fe1iscurc0r/PSDR/docs/README.md

# 文档索引

先读根目录的 `README.fork.md`（这个 fork 是什么、加了什么、不声称什么），再按需要往下查。
标 **fork-only** 的文档只在我们这棵树里，作者没有向上游提议过。

| 文件 | 是什么 | 建议读者 |
|---|---|---|
| `WO-psdr-takeover.md` | **施工总账**：A–K 章，逐条记录做了什么、命令与输出、结论与未完成项（3.5k 行且在长；**按章/§号查，别按行号引用**——追加记录会让行号漂移） | 想知道"这件事到底怎么验的" |
| `PSDR-firmware-survey.md` | **固件只读审阅**（fork-only）：两棵树的项目代码只占约 1 万行，按模块给中文注释、缺陷清单（**现基线 `PSDR_F7` 上 P0 只剩一处**，另一处属 `PSDR_Rebuild` 血统；新增"现基线复测"表给出 P0/P1/P2 的新行号与两条更正）、架构判断与改进路线 | 要改固件的人，先读这个 |
| `PSDR-author-measurement-log.md` | **作者自述的装配与实测记录**（fork-only）：commit sha/日期/血统/原话逐条编目——2016 实测 2.5–175 MHz、-90 dBm@7MHz、-80~-85 dBm@146.4MHz、"2m 很弱可能要前放"、2.5 原型已装配、原理图 notes 区这条没挖的线索、以及库里那棵 **2019 CubeMX+FreeRTOS 重建**（`TestingMakeFile*/`，带 F746 的 Makefile） | 想知道"这板子到底跑到过什么程度"的人 |
| `PSDR-HMC1023-netlist.md` | **U287（HMC1023LP5E 可编程低通）引脚—网络—SPI 表**（fork-only）：SPI 四线接 PB12–15、校准时钟来自 Si5338、`VDDBG` 无供电是硬件缺口 | 做 #16（前放/低通）的人 |
| `PSDR-HMC1023-pinmap-check.md` | **U287 的 32 脚逐脚对手册**（v01.0113 Table 6 × 网表）：N/C 脚全部接地符合手册注；`CALCK` 已由 Si5338 CLK1A 经 `C283` 接入；**pin 28 `VDDBG` 只挂去耦、无供电**；pin 29 `VBG` 悬空符合"testing only"；**Q 通道输出经两只电容自环回输入**（双通道只用一半） | 要补 HMC1023 驱动或改供电的人 |
| `PSDR-hmc1023-driver-plan.md` | **F-5 在无板条件下的做法**：校准序列构建器 + 主机测试已过（26/60 MHz 两条路径）；发现 `Reg 05h` 15 位装不下 20–40 MHz 周期、必须写倍频后周期；还差 SPI 帧位序（须看 Figure 38）、Table 11 粗调码、板上验证；给了 A/B/C 三条路 | 想推进 HMC1023 驱动的人 |
| `PSDR-hmc1023-driver-feasibility.md` | **HMC1023 驱动"能不能补"的判定**：SPI 已通、供电除 `VDDBG` 外齐、`CALCK` 已由 Si5338 CLK1A 接进；三个缺口（VDDBG 无供电 / CLK1 不由固件配 / 固件零引用）+ rev-B 代价 + 不改固件的台架实验路径 | 想复活低通滤波的人 |
| `PSDR-assembly-sourcing.md` | **贴装与选材**：391 件按封装分 290 手贴 / 25 热风 / 18 必须机贴 / 58 机械件；`U304` 与 `U16/U24/U30` 买不到 ⇒ 全贴完不可能，最小可验板只能验电源与 MCU | 要下单/备料的人 |
| `PSDR-vna-path.md` | **VNA 通路拓扑**（只读，fork-only）：`U314` 的 INPA/INPB 经 `C322`/`C309` 分别接 `RF_REF`/`RF_ANT`，桥路由 `U24` 切、`REF`/`DUT` 是 1 mm 焊盘，`VMAG`/`VPHS` 进 MCU；**硬件完整、`vna_reflected/vna_through` 两个 case 是空的** | 想搞 VNA 或 #20 的人 |
| `PSDR-signalpath-pinmap.md` | **`signalPath()` 引脚状态表**（只读）：12 根控制线的"固件符号→GPIO→MCU 脚→网名→板上落点"全链，7 个枚举态的实际电平；三条观察（态 1 落进发射分支、态 3 加电仍旁路、态 4/5/6 不写任何脚） | 要动射频路径或做 rev-B 的人 |
| `PSDR-scope-and-cost.md` | **最初需求、成本结构与降本边界**（fork-only）：README 原文需求、BOM 构成（$276.78）、**VNA 判为保留项**、保留版地板 ≈$225–235、GPS 三条降本路线、LC 带通组"先验证再谈上游"与免改版的验证路径、CMOS/继电器按节点的结论、"为什么是短波而不是 UV" | 决定改版范围/预算的人 |
| `PSDR-alternates-proposal.md` | **替代件与局部改版提案**（fork-only）：U304 实测封装/偏置拓扑、国产无源件候选表（36 行/184 件）、两颗停产 IC 的三条路线（**路线 C 已按 Ron 更正**：通用 CMOS 不能顶替天线侧 GaAs）、局部改版范围 | 打算换料/改板的人 |
| `PSDR-open-data-gaps.md` | **资料缺口 + PCB 改版/移植问题**（fork-only）：要查的数据手册、2.6→2.6.1 的**三处**电阻改动**加 2.6.1 表内自相矛盾**（§2.1，"只差 R164"那句已作废）、断供器件封装不可替换 | 打算改板或换料的人 |
| `PSDR-chronicle.md` | **编年史**（fork-only）：**第〇纪**我们从 2026-08-19 起的手（不是 10-30 的工单）、上游 2014→2025 原史 + **2014–2017 十条帖子逐条捞出的原话**（众筹支持者、热成像指到 `U241`=Si5338、"deaf as a brick −70 dBm / 差 50 dB" 的真实出处）、接手七天按天编年、对外件全表带评论 id 与字节数、**我们自己撤过的 11 条断言**（旧说法→推翻证据→现口径）、#16 点名的外部项目与 UHSDR 调研现状 | 想知道"这件事从头是怎么走过来的" |
| `PSDR-switch-maps.md` | **开关映射分析（F-3/F-4 前置）**：三片 DPDT 的 RF 脚→远端（网表读得）、DPDT 真值表（镜像级）、滤波 mux 的 B1–B4 通道图与"编码顺序待实测"；列出 4 条 10 分钟级测量（M1–M4）与"为什么没把猜值写进固件" | 要动射频路径/继电器的人 |
| `PSDR-firmware-fixes-F1-F2.md` | **F-1/F-2 的实际改动**（fork-only，不上游）：Si5338 就绪等待改 2 s 有界；`signalPath()` 表化并修状态 1 的 fall-through；主机测试 7×12 全过、目标构建 0 error（text 113,916，较改前小 152 B）；含 blob 对照与回滚命令 | 要审这两处改动的固件人 |
| `PSDR-revB-edit-sheet.md` | **改板作业单（可直接照做）**：只改 `_pcb_spike_full`；A 段 `VDDBG` 把 `$$$15137` 并入 `LPF_5V` 并在 (34.29,-10.541)→(37.084,-13.843) 拉 0.2032 mm 线（含绕行/换层两种走法）；B 段 4 处 <0.127 mm 线距的 5 条线段逐条给出端点与改法；附改后四步验收 | 自己动手改板的人 |
| `PSDR-revB-local-plan.md` | **局部改动规划（rev-B lite）**：把"缺料以外"的缺陷逐条变成可执行的硬件/固件改动——H-1 `VDDBG` 拉铜（`C292`→`C291`，4.3 mm）、H-2 52 条线距按簇改到 ≥0.2 mm、H-3 板厚/工艺、H-4 丝印让位、H-5 `U30.6` 引出；F-1 I2C 超时、F-2 `signalPath` 表化+case1 break、F-3 滤波档位、F-4 VNA 两态、F-5 HMC1023 驱动（先与 Michael 协调）、F-6 CLK1/VCO；含验收总表与**"不算解决"清单**（换 L/C 值不计） | 真正要动手改板/改码的人 |
| `PSDR-revB-workorder.md` | **rev-B 局部改版工作单**（fork-only）：三道门（器件身份 / 数值口径 / 免改版子板 A/B）不过就不许开刀；影响圈实测（三区并集 124 件、**圈外 267 件必须逐件不变**、只有 U304 区是真局部，DPDT 与 HMC1023 二跳铺满全板）；波段↔控制线表（8 根线实测 + 固件从不切外接档）；改版后要重出的三件套与旧 `SHA256SUMS` 作废；`pending` 一律标注等哪个门、**不许填典型值** | 真要去改板的那天 |
| `PSDR-upstream-threads.md` | **上游 21 条 issue/PR 的原文存档**（引用底稿，不是我们的判断）：2026-11-04 用 REST 全量抓回的正文与 61 条评论，按 issue 照录（只压空白），编年史里每句英文原话都能在这份回查 | 要核对"某人到底说过什么" |
| `PSDR-si5338-lo-plan.md` | **正交 LO 与 Fvco÷8 约束的核算**（fork-only）：三路输出各自的落点（CLK0→触发器÷2、CLK1→HMC1023 CALCK、CLK2→MCU 测频）；固件 VCO=2.84 GHz ⇒ Fvco/8=355 MHz > CLK0 上限 350 ⇒ **"最多两路高于 Fvco/8"的限制从未触发**；附两个新发现（VCO 超 Rev1.6 上限、CLK1/2 不由固件设定） | 改时钟方案或做 rev-B 的人 |
| `PSDR-fab-spec.md` | **工艺与打样口径**（fork-only）：板框 99.9998×64.9986 mm、4 层铜、最小钻 0.356 mm；**板厚/基材/表面处理原始资料里没有**（fabnotes 是纯图形）；打样前要过的三条规则（52 条 clearance 最小 0.1174 mm、38 条孔间距、39 条板边器件）+ 沉金建议与"先拿原始 Gerber 做 DFM 预检"的路径 | 想下单打样的人 |
| `PSDR-documentation-archive.md` | **`Documentation/` 那 6 份作者材料的档案**（fork-only）：2014 半成品 VNA 说明页（作者自己的 TODO、"30mV/db 10mV/Degree" 说法，且**位号属 PSDR2 一代**：`U23`=AD8302、`U24-27`=DPDT）、2016 装配说明（图纸框还留着 `<INSERT COMPANY NAME HERE>`）、两份视频文稿（"open source""kits""我没把它设计成应急设备"原话）、2014 滤波系数表（512 点 == 固件 `FFT_BUFFER_SIZE 512`，表里是浮点系数而代码只填 1/0） | 想知道"作者留下过什么、我们此前漏了什么" |
| `PSDR-external-findings-2026-11-03.md` | **外部执行方回传资料核实**（fork-only）：6 份答案的验收过程（49/55 行对账、错位实锤、4 个 sha256 复算一致）、8 条被推翻/修正的说法（SXB 是 5–2500 MHz、U279/280 是 D 触发器不是 ÷2、实购 CB3Q 非 CBTLV、ST 勘误 §2.2.1 ADC 触发丢失…）、HMC1023/AD8302/Si5338/总线开关的手册级补口、"信息不足"大头其实是我们包缺 `Value`、以及按谁能推动分四组的待办队列 | 要用这批外部结论之前，先读它的证据分级 |
| `SOP-eda-import-2.6.1.md` | **EDA 导入 SOP**：7 步，含"直接导入只得 10/12，不是回归"与两处必须人工的步骤 | 下次往嘉立创EDA导板的人 |
| `SOP-kicad-to-eprj3.md` | **KiCad→eprj3 原生转换 SOP**（fork-only）：转换器两个 bug（圆弧板框、铺铜丢网络）的离线修法、文件夹工程与 `.epcb2` 两条导入路径、加载判活监视器与现场读数、交付件哈希与排障速查；上游 bug 已报 `easyeda/kicad-to-easyeda-eprj3#2` | 走免费打样原生通道、卡在转换/加载的人 |
| `PSDR-defect-register.md` | **缺陷登记册**（fork-only）：除缺料外的 22 条已知问题，按 P0/功能/电气/制造/流程分组，每条给证据、卡在谁、现在能做什么；含 `VDDBG` 飞线与"一量判死"的四点 | 想知道"还差什么才能开机/打样" |
| `PSDR-bringup-checklist.md` | **上电前检查表**（M3）：42 个测点带坐标与网络、射频只写观测方法、无实物逐条 SKIP | 板子到手那天 |
| `psdr-build-notes.md` | 构建笔记（F4 线的工具链与坑） | 要复现编译的人 |
| `PSDR-TAKEOVER-WORKORDER-2026-10-30.md`<br>`PSDR-TAKEOVER-PROMPT-2026-10-30.md`<br>`PSDR-TAKEOVER-EVALUATION-2026-10-30.md` | **上游给的工单/提示词与当时的评估**（历史输入，不是我们的产出；评估里个别结论已被后续实测更正，正文有标注） | 想知道起点是什么 |
| `psdr-handoff/` | 交接材料里的脚本（`anchor_check.py`、`Makefile.linux`、`PATCH-NOTES.md`），F4 锚点自证用 | 核对 F4 构建 |
| `../evidence/` | **不可重跑的现场读数**（EDA 12/12 与 DRC 513 的构成等）与其 README | 想核对"当时到底读到什么" |

## 相关但不在 `docs/`

- `dist/kicad/SHA256SUMS` + `tools/reproduce_kicad.py`：一条命令重建参考板、DRC 与制造包并自检。
- **`dist/kicad/` 里哪块板才算参考板**（2026-11-04 标注，别拿错文件）：
  **参考板 = `PSDR_2.6.1_pcb_spike_full.kicad_pcb`**（1.8 MB，2026-11-01，铺铜/板框/丝印齐全，
  名字里的 `spike` 是早期"探针"阶段的遗留）；**DRC 权威报告 = `drc_PSDR_2.6.1_pcb_spike_full.txt`**
  （**795 条**，已在总账 §C-16 逐类定性：没有一条是转换几何错误）。
  同目录的 `PSDR_2.6.1.kicad_pcb`（721 KB，10-31）、`PSDR_2.6.1_spike_TX-Q_DRIVER_P.kicad_pcb`
  与 **`PSDR_2.6.1-drc.json`（10-30，364 条，其 `source` 字段自己写着 `PSDR_2.6.1.kicad_pcb`）**
  都是被取代的早期产物，**不要引用它们的数字**；要引用 DRC 一律引那份 `.txt` 与 §C-16。
- `dist/reference/`：**F7 构建的锚点参考 hex**（两份基线各一，带 sha256/blob/出处）与复算命令；
  放这里是因为 `Source_F7/.gitignore` 的 `/Debug` 会把它们挡在版本控制外（2026-11-03 改基时差点丢）。
- `Hardware/BOMs/PSDR_2.6.1/PSDR2.6_BOM_flat.csv` / `PSDR2.6.1_BOM_flat.csv` /
  `BOM_refdes_crosscheck.csv`：**派生件，不是源**。`.xls` 仍然是 BOM 的权威版本；两份扁平 CSV
  由 office-excel 展平（文件头写源 BIFF 版本哈希），交叉表由
  `python tools/bom_refdes_crosscheck.py` 重算。注意展平用的是**带 PR #18 修正后**的 .xls，
  要看上游未修版得从 `45acd0f5` 取。
- `dist/fab/PSDR_2.6.1_placement.csv`：SMT 贴装表（391 件），与 BOM 和 KiCad 锚点双向对账过。
- `tools/`：解析器、KiCad 生成器、Gerber 对拍、层覆盖率、固件统计（`fw_stats.py` / `fw_funcindex.py`）。
- `delegation/` + `tools/make_delegation_pack.py`：**派给外部执行方的自包含输入包**
  （36 只 IC 的引脚/网络上下文、23 个封装的原始 `*PARTDECAL*` 块、件数普查、带 DigiKey 号的 BOM 行），
  含答案 schema 与"无出处不作答"的硬规则；重跑一条命令，位号错配由 `EXPECT` 守卫挡住。
  `delegation/answers/` 是**对方交回的原件收档**（6 份，只加了 PROVENANCE 头，正文一字未改）：
  属外部断言，未逐条复核的数字不得直接进对外文本；`MANIFEST.csv` 只覆盖输入包。
  同目录还有下一轮的**可粘贴提示词**：`PROMPT-recheck-taskC.md`（TASK_C 剩余 32 行，带附件哈希与
  "CONTESTED 两值都算"的硬规则）、`PROMPT-uhsdr-frontend.md`（UHSDR/OVI40 前端，
  只收 文件+commit+行号 级出处，并禁止替 PSDR 下结论）、`PROMPT-full-history.md`（只查站外的全史普查）、
  `PROMPT-chronicle-site.md`（**把编年史做成静态网页**：附件清单带 sha256、内容硬规则、
  "诚实清单"必须存在、禁放替代件/降本内容、交付要附自检脚本并按事实级报告）。
