fe1iscurc0r/PSDR/docs/PSDR-fab-spec.md

# 这块板到底是什么工艺、能不能拿去打样（2026-11-04）

问题来自"10×10 cm 以内可以免费打板"这件事。先给能读到的，再给**读不到但打样必须自己定**的，
最后给"免费档能不能过"的判断。所有数字都标口径。

## 1. 读得到的（源：CAM 包 + 我们的复现对账）

| 项 | 值 | 出处 |
|---|---|---|
| 板框 | **99.9998 × 64.9986 mm**（≈100 × 65 mm；右侧 y≈16–26 mm 处有内凹缺口，退到 x=88.3 mm） | `kicad_gerber_compare` 输出，总账 §C-13/§C-14 |
| 铜层 | **4 层**：`GTL`(L1) / `L2.p.G1`(L2) / `L3.G2`(L3) / `GBL`(L4) | `Hardware/Gerbers/PSDR261 Main Board/` 15 文件包 |
| 其它层 | 2 阻焊（GTS/GBS）+ 2 丝印（GTO/GBO）+ 2 锡膏（GTP/GBP）+ 1 钻孔 + fabnotes | 同上 |
| 钻孔 | 10 把钻头，**最小 0.014" = 0.356 mm**（过孔），最大 0.126" = 3.2 mm（安装孔） | `0 - drillfile.TXT`（MOIN）逐档读出 |
| 过孔尺寸 | 0.8128 / 0.3556 mm（盘/孔） | 总账 §C-13 的 `*ROUTE*` 抽样 |
| 焊盘 | 1,194 个（Top 595 / Bottom 599）、461 孔 | 总账 §C-13 |
| 源设计规则 | 通用 **8 mil**、铺铜 12 mil、铜到板框 20 mil；EDA 工程侧另记 6/4/10 mil | `docs/PSDR-open-data-gaps.md` §2.3、§C-22 |

⇒ **尺寸落在 10×10 cm 以内，层数是 4 层** —— 这两条满足"常见 4 层免费/低价档"的门槛条件。

## 2. 叠层：`PSDR.asc` 里有！（2026-11-04 补）

`Hardware/PSDR.asc` 的 `LAYER DATA` 段带完整叠层参数，逐层读出来是：

| 层 | 名称 | 介质厚度 | 铜厚 | 介电常数 |
|---|---|---|---|---|
| L1 | Top | 0.2540 mm（10 mil） | 0.0343 mm（≈1 oz） | **4.3** |
| L2 | Power | 0.2540 mm | 0.0343 mm | 4.3 |
| L3 | Ground | 0.2540 mm | 0.0343 mm | 4.3 |
| L4 | Bottom | — | 0.0343 mm | —（面层，掩膜 εr 记 3.3） |

* **基材：FR4（εr≈4.3）**——这是**读得**，不是猜；
* 铜厚：每层 0.0343 mm ⇒ **1 oz**；
* 介质：三张 **10 mil（0.254 mm）**；
* **成品板厚算得 = 3×0.254 + 4×0.0343 = 0.899 mm（≈0.9 mm）**，不含阻焊。
  ⚠️ 这个 0.9 mm 是**按源叠层算的**，而 PADS 的叠层参数不一定等于厂里的最终压合（外层的 prepreg 与阻焊另算），
  所以下单体重要么按 0.9 mm 写、要么问作者当时下的什么——**别再写"1.6 mm"**，那是常见值不是这块板的。

## 3. 表面处理：仍然读不到（OSP vs 沉金）

`fabnotes.GBR` 是纯图形，`.asc` 无 finish 字段。**建议沉金（ENIG）**，理由是本板的具体工艺需求：

* U121（LQFP100，0.5 mm pitch）、U287（32 端子 5×5 mm，底部散热盘）、底面大量 0402；
* **双面回流**：OSP 在第一次回流后膜厚会消耗，二次回流与保存期都要额外评估；沉金无此问题；
* 沉金平整度对 QFN 散热盘与细间距更友好，代价是贵一点。

## 4. 读不到的其余项（必须自己定或问作者）

* **板厚**：PADS ASCII 与 CAM 包都没有 stackup 字段；**没有依据**。
  （常见 1.6 mm，但本板有 3.2 mm 安装孔、6 处 USB 屏蔽片开口和机身铝壳配合，
  壳体文件不在仓里 ⇒ 板厚要跟结构件一起定。）
* **基材**：同上，无依据。按年代与成本几乎必然是 **FR4**，但这是推断，不是读得。
* **表面处理**：`fabnotes.GBR` 是纯 Gerber 图形（PADS 9.5 生成），**没有任何工艺文字**；
  `.asc` 也没有 finish 字段 ⇒ **沉金 / 喷锡 / OSP 都没有原始依据**。
* **铜厚、阻抗控制、过孔盖油**：同样无依据。

**若让我给建议（标注为"建议"，不是规格）**：0.5 mm pitch 的 LQFP100（U121）与 32 端子
`VARIABLE_FILTER_HMC1023`、底面大量 0402 + 底部锡膏 ⇒ **沉金（ENIG）** 最稳；
喷锡在 0.5 mm pitch 上共面性风险更高；OSP 便宜但保存期与多次回流后共面性要自己评估。

## 5. 免费档能不能过：尺寸够，但**这份参考板按常见标准档会卡在规则上**

795 条 DRC 里已经逐类定性过（§C-16），其中会影响下单的是这三类：

| 类别 | 条数 | 关键数字 | 对打样的影响 |
|---|---|---|---|
| `clearance`（线—焊盘） | 52 | 实测 **0.1174–0.1986 mm**（4.6–7.8 mil），全部小于源规则 0.2032 mm | 常见四层标准档多在 **5 mil / 0.127 mm** 一档；**最小 0.1174 mm 低于它**，要么走高级工艺（付费），要么改线 |
| `hole_clearance` | 38 | 最小 0.2098 mm；14 条 0.0001 mm 是 J170×9 / J153×5 的 1.2 mm NPTH 与信号焊盘**相切** | 相切孔属于"源设计本身如此"，厂方 DFM 会提示 |
| `copper_edge_clearance` | 39 | 全是板边连接器：`PADDLE_*` 舌口 16 + `ANT/VNA-IN` 5 + `EARPHONE` 7 + `VNA-OUT` 5 + USB 2 + `SPEAKER` | 下单需选"板边器件/外形铣/半孔"类工艺，**不在最简免费档里** |

另有 4 个 Morse 桨焊盘是"多层铜 + 无钻孔"（源设计如此），6 处 USB 屏蔽片开口——
这些都不是标准免费档的默认工艺。

**结论（可执行）**：
1. **先拿 2016 的原始 Gerber 包去厂方做 DFM 预检**（`Hardware/Gerbers/PSDR261 Main Board/`，
   不要先传我们重建的 KiCad 版）——原始包才是当年真下过单的那份；
2. 预检如果只报 0.1174 mm 那几条，再决定：接受"高级工艺"付费打样，或者**改线**（把 B.Cu 上那几段
   GND 走线挪开 ≥5 mil）——**改线属于 rev-B 范畴，要单独批准**，不是"导个文件"；
3. 若要做 SMT 贴装还要再注意：我们重建的 KiCad 板**没有建锡膏层**（§C-20），
   贴装要么用母片锡膏，要么从新设计导出后与母片对账；
4. 板厚/材质/表面处理三项**在问作者或跟结构件一起定之前，不要下单**——
   仓里没有依据，谁填都是猜。

## 6. 打样配额纪律（2026-11-04 定）

* 委托方是**中国在校大学生**，嘉立创学生账号**每月两次**免费打样（≤10×10 cm；表面处理可选 **OSP 或沉金**，喷锡券已停）。
  这块板 100×65 mm、4 层，**尺寸与层数都在额度内**。
* **但配额不是用来试错的**：这块板现在还有"VNA 路径没实现、两只关键件买不到、11 个值没实测"三座山，
  打出来的 5 片板大概率**只能当焊接练习**。⇒ **在下面这张清单清零前，不打样。**
* 打样前的"清零清单"（全部是**不需要板子**就能做的）：
  1. 值口径：11 个冲突位号按 §2.1b/§2.1c 的多数票写文档（已完成），实测项进检查表；
  2. 时钟：Si5338 的 VCO 2.84 GHz 超规格与 CLK1/CLK2 未配置两条，先与作者/手册对齐（见 `PSDR-si5338-lo-plan.md`）；
  3. 制造：DFM 预检用**原始 Gerber 包**跑，把 52 条 clearance 与 39 条板边项先过一遍；
  4. 料：U304、MASWSS0129 的可得性有结论（目前：原厂无档、渠道断）——没有结论就不投板；
  5. 板厚：0.9 mm（算得）与厂档位对齐，或问作者原单。
* 真要打，第一片板的用途应当写死：**验证电源轨与控制电平**（检查表 A/B 两表），不是验证射频。

## 7. 过孔、丝印与铺铜：为什么"看起来这么多"

### 7.1 过孔数（钻带实测，2026-11-04）

| 项 | 数 | 说明 |
|---|---|---|
| 过孔（0.356 mm 钻 / 0.813 mm 盘） | **419** | 钻带 `T1` 实测 |
| 元件孔与安装孔 | 46 | 0.85/0.9/0.94/0.95/1.2/2.03/3.0/3.2 mm 各档 |
| **钻带总孔数** | **465** | 旧文档写 461（J170 第 4 孔补上之前的数），引用时用 **465** |

按网络分（从复现板 KiCad 的 via 列表统计）：**GND 124**（≈30%）、`+3V3_CPU` 23、`+3V3` 21、
`HALF_VCC` 13、`LPF_5V` 4……**电源/地类合计约 185**，其余 ~234 在信号网（射频与数字）。
密度：板面积 100×65 = 6,500 mm² ⇒ **平均每 15.5 mm² 一个过孔**。

**为什么这么多**（都是这一类 4 层射频板的正常做法，不是画坏了）：
1. **地平面缝合**：4 层板有完整地平面，顶层/底层铺铜要靠过孔与内层地"缝"在一起，否则射频回流没有通路；
2. **级间屏蔽栅栏**：RF 级（混频、滤波、放大）之间用一排地过孔做隔离，防止级间串扰；
3. **扇出**：LQFP100（0.5 mm pitch）与 QFN 的引脚必须打孔换层；
4. **铺铜热焊盘**：PADS 的 `THERMAL` 过孔（`.asc` 的 VIA 记录里带 `THERMAL` 标记）用于散热与接地。

### 7.2 丝印把过孔/走线盖住了

这不是我们转坏的：DRC 里 `silk_over_copper` **199 条**、`silk_overlap` **199 条**、`silk_edge_clearance` **55 条**
全部来自**源设计**（PADS 丝印与源 GTO/GBO 双向对账 100%，§C-16）。表现就是位号（如 `R293`）压在焊盘/过孔上。
两点结论：
* 生产时**厂方会自动裁掉压焊盘的丝印**，不影响焊接；但**看板时**请把丝印层关掉或只看 Pad 层；
* 真要"看得清"，那是**改丝印**（rev-B 里可以把位号挪开），不是导出设置问题。

### 7.3 铺铜"感觉很稀"

源设计铺铜规则是 **12 mil（0.3048 mm）** 净间距 + 大量岛分割（12 个 POUR，7 个独立 HATOUT），
所以看起来比"整片铺满"稀。**注意**：在 EDA 里重新铺会按 EDA 自己的规则（默认 0.6 mm 一档）算，
结果与源**不一样**——这也是 §C-22 记的"源 12 mil vs EDA 10 mil"那条。
如果在 EDA 里手动重铺过并保存了，那份工程就已经偏离"源优先级"口径；
**参考口径仍以 `tools/reproduce_kicad.py` 生成的 12/12 为准**，重铺过的工程请另存，别覆盖原导入件。
