fe1iscurc0r/PSDR/docs/PSDR-alternates-proposal.md

# 替代件与局部改版提案（fork-only，不是选型决定）

日期：2026-11-02。**本文是提案，不是设计结论**：具体型号、频段余量、隔离度指标都是射频决定，
必须由有仪器的人拍板。本文没有改动任何设计文件或源码，只把"能不能换、换了要动哪里"摆清楚。

数据来源：`Hardware/PSDR.asc`（`468dc41`）的网表/封装（391 件 / 278 网 / 1132 脚）、
`PSDR2.6.1_BOM.xls`、以及公开网页资料（每个结论都标了依据强度）。

## 1. U304（RF 放大器）的封装与引脚参数

**实测（来自我们自己的板子数据，不是猜）**：

| 项 | 值 |
|---|---|
| 封装形式 | 3 焊盘、单面贴装（本板在 **B.Cu 背面**） |
| 每个焊盘 | **1.6 mm × 0.7 mm** |
| 焊盘间距 | **1.57 mm**（相邻焊盘中心） |
| 器件原点 | 板坐标 (10.160, −45.974) mm；旋转 0° |
| 网表引脚 | 1 = `RFIN`（网 `RF_AMP_IN`）、2 = `GND`、3 = `RFOUT`（网 `RF_AMP_OUT`） |
| 测试点 | TP `BIAS` 直接挂在 `RF_AMP_IN` 节点上 |

**偏置拓扑（这一条决定能不能直接换料）**：

```
RFOUT ──L19(220µH)── +5V_AMP          ← 输出侧供电（与 SBB5089Z 的"脚3=RFOUT/VCC"一致）
RFIN  ──L11(220µH)── R6(180Ω) ── +5V_AMP   ← 输入侧还有一路经 180Ω 的直流馈入
        （同网络里还有 R14=68Ω、R268=100Ω、R12=10Ω 等偏置/限流件）
```

⚠️ **未决的关键问题**：主流 SOT-89 增益块（SBB 家族、以及下面列的国产 FW2106）通常**只从输出脚供电**，
输入脚是纯 RF 输入。本板却给输入脚也馈了直流（L11+R6）。这要么说明原件的输入脚内部就是偏置节点，
要么说明这一路是为别的型号准备的。**换料前必须用原件/新件手册把这一条核清楚**——
如果新件不允许输入脚外加直流，就必须同时改偏置网络（局部改版的一部分）。

## 2. 放大器候选（全部标"待核"）

| 候选 | 关键参数（公开资料） | 与我们的约束 |
|---|---|---|
| Qorvo **SBB2089Z** | 50–850 MHz、增益 20 dB、NF 2.7 dB、SOT-89、5 V | **最低 50 MHz**——PSDR 工作在 HF，低频下限是硬门槛，需核原件在该频段的增益 |
| Qorvo **SBB5089Z** | 50 MHz–6 GHz、20 dB、NF 4.2 dB、SOT-89 | **已宣布停产**（最后购买期 2025-12-21），Qorvo 给的后续型号是 **QPA9126** |
| 国产 **通量科技 FW2106** | 50 MHz–6 GHz、21.5 dB@100 MHz、SOT-89、**与 SBB5089 pin-to-pin** | 国产化里最接近的一个；同样受"低频下限 50 MHz"与"输入侧直流"两条约束 |
| Qorvo **QPA9126** | Qorvo 对 SBB5089 的官方后续 | 封装/引脚需核 |

**结论**：有候选，但**没有一个能凭公开资料直接判"可换"**。关键未知按优先级：
①新件在 0.5–30 MHz 的增益/噪声；②输入脚能否承受本板的直流馈入；③SOT-89 焊盘（1.57 mm 间距）与新件丝印是否吻合。

### 2.1 2026-11-03 补充：**方向错了**——这三只候选全是 50 MHz 起步

查到 BOM 实订的 `SXB-2089Z`（同族 SBB2089Z）手册级带宽是 **50–850 MHz**，
也就是说**这台 HF 机器唯一的射频增益件在 HF 本来就没有增益**；上表三只候选（SBB2089Z /
SBB5089Z / FW2106）**同样是 50 MHz 起步**，换它们等于把问题复制一遍。
如果目标真是"HF 前放"，选型方向要改成 **DC-starting（0 MHz 起）的 5 V、3 脚 SOT-89 增益块**：

| 候选（待核） | 手册级带宽 | 供电 | 与本板约束 |
|---|---|---|---|
| Mini-Circuits **GAL-3+ / GAL-4+ / GAL-5+** | **0–4 GHz**（族表"0MHz Min"） | **+5 V**，3 脚 SOT-89 | 电压与脚数都对得上 `+5V_AMP`；仍要核输入侧直流馈入与焊盘 |
| Hittite/ADI **HMC475ST89** | **DC–4.5 GHz**，P1dB +22 dBm | **+8～+12 V** | 电压与本板 `+5V_AMP` 不符 ⇒ 要连偏置一起改（局部改版） |
| Hittite/ADI **HMC482ST89**（封装名的原主） | **DC–5 GHz**，20 dB | **+6～+12 V** | 同上：名字是化石，电气按 5 V 件重设计过 |

⇒ 这一条把"替代件提案"从"找停产件的 pin-to-pin"升级成"**这台机器需要一个频段正确的增益件**"，
也是上游 #16（Enable Pre-Amp in Firmware）里我们唯一不需要仪器就能说的新信息。
固件侧的配套事实（三个已实现分支都把 `AMP_SWITCH_A` 写成 bypass、`:905` 注释与写值矛盾、
`transmit_with_amp_no_filter` 的调用行被注释掉）见 `docs/PSDR-scope-and-cost.md` §8.2。

## 3. 非射频无源件的国产化（36 个 BOM 行 / 184 件）

筛选口径：只取**两端、且不接任何射频相关网络**的无源件（射频网络判定见 `docs/WO-psdr-takeover.md` §G-4）。
同一"封装 + 值"合并成一行。国产候选只给**厂牌与系列**，具体料号必须按精度/温漂/耐压逐项选定。

| 类型 | 值 | 件数 | 国产候选（系列级，需核参数） |
|---|---|---|---|
| CAP_0603 | 100N | 41 | 风华高科 0603 X7R、宇阳、三环 |
| RES_0603 | 1K | 21 | 厚声 RC0603 系列、风华 0603 厚膜 |
| RES_0603 | 100k | 19 | 同上 |
| CAP_0805 | 10u | 12 | 风华/宇阳 0805 X5R（注意耐压与直流偏压特性） |
| RES_0603 | 10K | 12 | 厚声/风华 |
| 1210 X5R 22µF 10V | 220u（标称 22µF/颗） | 7 | 风华/宇阳 1210 X5R 25V 档（**容量-电压特性必须核**） |
| RES_0603 | 0R | 6 | 厚声/风华 0Ω 跳线 |
| CAP_0603 | 10N | 5 | 风华/宇阳/三环 |
| CAP_0603 | 1N | 5 | 同上（注意 C0G 与 X7R 的选择） |
| CAP_0603 | 1U | 5 | 同上（0603 1µF 需 X5R/X7R 高耐压档） |
| CAP_0603 | 2U2 | 5 | 同上 |
| CAP_0603 | 6U8 | 5 | 同上（0603 大容量，需核偏压衰减） |
| CAP_0603 | 22U | 4 | 同上（0603 22µF 属高容，国产可选但必须核直流偏压） |
| CAP_0603 | 4U7 | 4 | 同上 |
| CAP_0603 | 100p | 3 | 风华/宇阳（C0G 优先） |
| CAP_0603 | 470N | 3 | 同上 |
| RES_0603 | 255R | 3 | 厚声/风华 1% |
| CAP_0603 | 8P | 2 | 同上（C0G） |
| 0805 10µH | 10u | 2 | 顺络 SWPA/MWSA 系列、麦捷 |
| RES_0603 | 12K1 / 22R1 / 24R9 | 各 2 | 厚声/风华 1% |
| 0603 其它值（2p2/33nF/3300pF/2U2H 电感/4.7µH 电感/100R/10R/180R/30K/402K/6.8K/68R/50R 等） | — | 各 1 | 按同类系列选 |

**三条硬约束**（比"国产/进口"重要得多）：
1. **封装逐字相同**——改了 footprint 就不再是"能按上游 CAM 下单"的那块板；
2. 电容要核**介质类型与耐压**（X5R/X7R/C0G 的高容值项尤其要看直流偏压后的实际容量）；
3. 电阻要核**精度与温漂**（本表里 1% 与 0.1% 不能混用）。

## 4. 两颗停产 IC：现状与路线

### 4.1 `MASWSS0129`（U16/U24/U30，13 焊盘 DPDT）

- 公开资料：**GaAs 宽带 DPDT，DC–6 GHz**（同系列另有 `MASWSS0129SMB` 评估板型号）。
- 同族 `MASWSS0130TR`：**0.5–3 GHz、12-PQFN 3×3** ⇒ **频段与封装都不兼容**，不能直接换。
- 检索没有找到可核实的 pin-to-pin 替代（中英文检索都只返回同族或无关结果）。

三条路线：

| 路线 | 做法 | 代价 | 风险 |
|---|---|---|---|
| A. 原货 | 作者存量 / Rochester / 贸易商 | 无改板 | 长期不可持续；来路不明的件有假货风险 |
| B. 同族换型（局部改版） | 找 **DC–6 GHz 的 DPDT**（不同封装也行），改该区域封装与控制走线 | 改 3 处布局 + 改控制真值表 | 需重测插损/隔离/切换时间 |
| C. CMOS 模拟开关替代 | **必须是 RF 级低阻开关**（1–2 Ω 档）；通用逻辑 CMOS 不行 | 可能要加驱动/改电平 | 导通电阻、寄生电容、隔离度需重算；与射频设计强相关 |

> **2026-11-03 更正（针对上一版路线 C 的"板上已有 CMOS 证明 CMOS 可用"这句）**：
> 查了 BOM 与网表后这句话站不住。板上 I/Q 用的 `MAX4525CUB+`（U4/U18/U86）**V+ 接的是 +3V3**
> （`OctopartBOM.csv:70` + 网表 U4.10/U18.10=+3V3、U86.10=+3V3_CPU），手册级 Ron 在 +3 V 时是
> **500 Ω 量级**（+5 V 时 200 Ω）。串进 50 Ω 链路就是 ≈15.6 dB 插损，而且摆幅被轨压钳住——
> **它能用在 I/Q 那些高阻电压节点，不能顶替天线侧的 GaAs**。
> `74CBTLV3253`（U211/U298）是 5 Ω 级，只用在滤波选择这种"本来就带损耗"的位置。
> 作者的分工（I/Q=CMOS、天线侧=GaAs）是按阻抗选的，不是随手。
> 结论修订与逐维度对照见 `docs/PSDR-scope-and-cost.md` §7。

### 4.2 `U304`（见 §1/§2）

结论相同：有候选（SBB2089Z / SBB5089Z→QPA9126 / 国产 FW2106），但**都得先解决低频下限与输入侧直流两条**。

## 4.3 先说清楚：这颗 GaAs DPDT 是**远超所需**，不是"短波必需"

用板上自己的器件参数对照，整条链的上限根本不是 6 GHz：

| 环节 | 器件 | 公开频率范围 |
|---|---|---|
| 混频器 | **ADE-2ASK**（L41/L81） | **1–1000 MHz**（Level 7，LO +7 dBm，变频损耗 5.4 dB 典型，L‑R 隔离 45 dB 典型） |
| 放大器 | SBB/SXB-2089 级 | 约 50 MHz–6 GHz（同样远超短波） |
| 开关 | **MASWSS0129** | **DC–6 GHz** |

⇒ **链路的真实带宽由混频器决定（≈1 GHz）**，而短波只需要 0.1–30 MHz、加 6 m 也才 54 MHz。
6 GHz 的开关在这里买不到"必要性"，所以没有 pin-to-pin 替代并不构成死路——
只需要一个**在 HF 段够用**的开关（CMOS 或继电器），而不是 6 GHz 的 GaAs。

## 4.4 IC-705 式"分波段前端"：值得做，但要算清代价

现状：本板**没有任何射频带通滤波器组**。唯一的"滤波"是基带低通 HMC1023（在混频之后），
射频入口只经过开关就进混频器。这正是短波机常见问题的来源：强台/AM 广播串扰、互调、
动态范围差。IC-705 那类机器的做法是**按波段切换的前端带通滤波器组**（外加 VHF/UHF 独立通路）。

在本板上落地（属于"局部改版"的一部分，正好和 U16 区域一起动）：

| 项 | 做法 | 代价 |
|---|---|---|
| 滤波器组 | 6 段 LC 带通，例如 0.1–1.8 / 1.8–4 / 4–8 / 8–15 / 15–30 / 30–60 MHz | 6 组 LC + 布局面积（约 25 × 15 mm） |
| 切换 | 信号继电器（插损最低）或 CMOS 多路开关（体积小、成本低） | 继电器要驱动与空间；CMOS 要核隔离度 |
| 控制 | 波段译码（3–4 根控制线） | **固件冻结** ⇒ 只能先出"波段↔控制线"表，不改代码 |
| 对 I/Q 的影响 | 带通改善阻塞与互调；镜像抑制仍取决于 I/Q 幅度/相位匹配（AD8302 已在测） | 需要实测确认真实收益 |

**不建议**在这块板上做"直接采样"（IC-705 的 HF 直采路线）：STM32F746 的片内 ADC 是
12 位、约 2.4 MSPS 量级，采样 30 MHz 射频远远不够；要走直采就得换 MCU/外置高速 ADC，
那是整机重做，不是局部改版。

⇒ 结论：**分波段前端是"局部改版里最值得加的一项"**，它同时改善动态范围与抗阻塞，
而且和"换掉那颗 GaAs 开关"是同一块区域、同一批控制线，工程量可以合并。

## 4.5 直采（direct sampling）为什么不做：成本决策（2026-11-02，用户拍板）

结论：**这块板继续走"混频 + 基带"架构，不做射频直接采样。** 理由是成本，不是技术偏好：

| 项 | 现状/直采需求 | 量级（估算，非报价） |
|---|---|---|
| 现在的 MCU | STM32F746，片内 12 位 ADC（约 2.4 MSPS 级） | 开发板百元级 |
| 直采需要 | 覆盖 0–30 MHz 至少要 >60 MSPS 的 ADC（Nyquist），外加抗混叠滤波与高速数据通路（FPGA 或带并行捕获的 MCU） | 单 ADC + 数据通路就是几百到上千元 |

而且**现有架构对目标用途是够的**：2.4 MSPS 的 I/Q 采样，瞬时带宽上限约 1.2 MHz，
而 SSB/CW 只要 2–3 kHz、瀑布图常用 192 kHz 档——也就是说瓶颈不在采样率，
而在**前端选择性（没有射频带通）与 I/Q 匹配**。

按"每花一块钱能换多少 dB"排序，本板的改进优先级是：

1. **分波段带通滤波器组**（§4.4）：几十元的 LC + 切换，直接改善阻塞/互调/广播串扰；
2. **I/Q 幅度相位匹配**（AD8302 已经在测 MAGNITUDE/PHASE，可以用固件校正——但固件冻结，先出方案）；
3. **前放与偏置修正**（§1/§2）：把"灵敏度差 50 dB"那条先解决；
4. 直采：性能上限最高，但成本跳到另一个量级，**本板不做**。

⇒ 这条作为后续改版的**架构约束**记下来：任何"换 MCU/加 ADC"的提议都要先过这道成本门槛。

## 5. 局部改版的范围建议（"唯一解法"落到图纸上）

只动这两块区域，**不碰其余布局**（其余部分的制造数据已与上游 CAM 对账过）：

1. **U304 周边**（约 10 × 8 mm）：换封装库（若焊盘间距不同）、按新件手册决定是否保留 L11+R6 输入侧偏置、
   必要时改 C13/C305 的隔直位置；`TP BIAS` 保留以免丢失测试点。
2. **U16/U24/U30 区域**（三处，各约 8 × 8 mm）：换开关封装、按新件真值表改 6 根控制线极性，
   并在 `signalPath()` 的引脚表里同步（**固件目前冻结 → 先出表，不改代码**）。
3. 改完必须重出三件套：**Gerber / 贴装坐标 / BOM**，并用 `tools/reproduce_kicad.py` 重新生成板/DRC/制造包与 `SHA256SUMS`、
   用 `tools/pads_asc_placement.py` 重出贴装表；本板现有的这些基线全部作废，需要新基线。

## 6. 我不能替你决定的

- 具体选哪个型号、频段留多少余量、隔离度/插损指标定多少——**射频设计决定**；
- 改版后的性能是否达标——**需要实物 + 仪器**，本机无法验证；
- 是否接受"改用 CMOS 开关"这种结构性变化——这已经从"换料"变成"改电路"，必须由你拍板。

本文到此为止，不写进上游任何 PR/issue（§G-5 口径不变）。
