fe1iscurc0r/PSDR/docs/PSDR-dossier-U304-gain.md

# Zone dossier：U304 增益级（rev-B 工单 §3/§7.4）

日期：2026-11-07。口径：填表不留空，拿不准写 `pending` 并标注等哪个门（G1/G2/G3 定义见
`docs/PSDR-revB-workorder.md` §1）。数据来源：`dist/revB/zone_U304_gain.csv`（重跑
`python tools/revB_zone_closure.py`）、`dist/netlist/PSDR_2.6.1_netlist.json`、
`docs/PSDR-external-findings-2026-11-03.md`、上游 issue #13/#16 纸面核查。

## 1. 模板六字段

| 字段 | 内容 | 状态/等哪个门 |
|---|---|---|
| 器件身份 | `SXB-2089Z`：两条独立来源（2.6.1 BOM 行内 DigiKey 超链接指向 RFMD SXB-2089Z；Jeff 2021-02-19 在 #13 给出 win-source 的 SXB-2089Z）。板上封装名却是 `MMIC-AMP_HMC482ST`（DC–5 GHz、要 +6…+12 V，与 +5V_AMP 供电不符）⇒ 封装名是残留还是实装 HMC482 未定 | **pending（等 G1）**：Qorvo 原件取不到（站点检索不到、出口 429），实装标记只能靠实物或作者记忆 |
| 封装能否替换 | **不能原样换**：3 焊盘 `RFIN/GND/RFOUT`，偏置从输入侧注入（`L11 220uH` → `RF_AMP_IN`，`R6` 把 `+5V_AMP`  tie 进同一节点）。任何替代件必须兼容"输入侧偏置注入 + 5 V"这两条，否则偏置网络要一起改 | 结论已定；替代件具体选型 **pending（等 G1 身份确认 + G3 增益/噪声数字）** |
| 现供电 | `+5V_AMP`（网表实测：`L19.1`、`R6.2` 挂 `+5V_AMP`；`R6` 板文件 100R / 2.6.1 BOM 180R 冲突未决）。轨压本身 **pending（等 G2 实测）** | 网表部分已读实；数值口径等 G2 |
| 隔直要求 | 需要：SXB-2089 镜像级资料写 "requires … external DC blocking capacitor"；板上 `C13`（输入侧）/`C305`（输出侧）已在位 | 镜像级证据，原件 **pending（等 G1）**；电容在位是网表实测 |
| 改动清单 | **pending（等 G1 + G3）**：身份未定、免改版 A/B 数字未出，不开列具体改动。已知的候选方向只有"换 DC 起始、5 V、SOT-89 兼容偏置的增益块"，属假设不是决定 | pending（G1+G3） |
| 参考实现 | —（无现成同板参考；外部断言级资料在 `delegation/answers/`，不能当设计值） | 已填 |

## 2. 区数据（实测，重跑可复现）

- 种子 `U304`；区内 9 件；一跳 6 件：`U304 BIAS C13 C305 L11 L19`；二跳 3 件（`R6 R14 U16`）。
- 一跳包围盒 x 7.9–16.0 mm、y 42.2–50.5 mm（约 8×8 mm，贴装表原点＝板框左下角）。
- **四区里唯一的真·局部**：rev-B 若"只做局部"，本区是范围定义 (a)。
- 被挡参考网：`GND`(261 脚)、`+5V_AMP`(6)。
- `U304` 在 Bottom 面，(10.160, 45.974) mm。

## 3. 硬约束

区外 262 件逐件不变（工单 §2 验收：坐标差=0、面别/角度差=0、位号集合差=空）。
本区任何改动若牵动 `U16`（二跳）的贴装/网络，须按 §2(b) 重新开范围，不算"只动 U304 区"。
