fe1iscurc0r/PSDR/docs/PSDR-HMC1023-netlist.md

# HMC1023LP5E（U287）引脚—网络—SPI 连接表

只读整理，未改任何源码或设计。数据来源：`Hardware/PSDR.asc`（`468dc41`）经
`tools/pads_asc_netlist.py` 提取的 2.6.1 网表（391 件 / 278 网 / 1132 脚）。
**引脚名是 PADS 封装里的端子名（设计者的意图标签），不是数据手册的官方定义**——
凡需手册确认的地方都标了「待手册」。

## 1. 一句话结论

`U287` 是底面 32 脚 + 散热焊盘（共 33 个端子）的可编程低通滤波器。
**SPI 四线全部接到 MCU（SPI2），校准时钟来自 Si5338，供电经一只 P-MOSFET 开关，
而这条供电开关的 GPIO（PE11 / `LPF_POWER`）在固件里没有任何一处被驱动**——
换句话说 issue #16 的滤波路径目前同时缺"上电"和"配置"两件事。

## 2. 电源、地与偏置

| 引脚 | 端子名 | 网络 | 同网主要元件 | 判读 |
|---|---|---|---|---|
| 2 | VDDQ1 | `LPF_5V` | C284/C290/C291/C295, Q208.3 | 模拟 5 V（被 Q208 开关） |
| 4 | VDDQ2 | `LPF_5V` | 同上 | 同上 |
| 16 | DVDD | `LPF_5V` | 同上 | 数字 5 V |
| 21 | VDDI1 | `LPF_5V` | 同上 | 输入级 5 V |
| 22 | VDDCAL | `LPF_5V` | 同上 | 校准 5 V |
| 23 | VDDI2 | `LPF_5V` | 同上 | 输入级 5 V |
| 28 | VDDBG | `$$$15137` | 仅 C292.1（另一端 GND） | **手册已确认：Bias 5 V 供电脚，要求本地去耦。板上没有供电** ⇒ 硬件缺口（见 §2.1） |
| 29 | VBG | *未连接* | — | **手册已确认：1.2 V 带隙输出，仅供测试** ⇒ 悬空正常 |
| 1/3/8/9/10/17/24/25/32 | NC1–NC8 | `GND` | 全板地 | 设计者把 NC 全部接地（手册允许与否待查） |
| 33 | GND | `GND` | 全板地 | 散热焊盘 |

### 2.1 手册确认后的一个硬结论

官方数据手册（`https://www.analog.com/media/en/technical-documentation/data-sheets/hmc1023.pdf`，
经本地 `pdftotext` 抽取核对）对三个存疑脚的定义是：

| 脚 | 手册定义 | 板上接法 | 判定 |
|---|---|---|---|
| 28 `VDDBG` | **Bias 5 V Supply，必须本地去耦** | 只接 C292 到 GND，**没有任何 5 V 供电** | **硬件缺口**：这颗 IC 拿不到偏置电源，即便固件配好也不会工作 |
| 29 `VBG` | 1.2 V 带隙输出，**仅供测试** | 悬空 | 正确 |
| 11 `CALCK` | 校准时钟输入，手册表格给 20 / 40 / 80 MHz 三档 | 经 C283 接 Si5338（U241.18） | 接法合理；但要求 Si5338 输出落在这个范围，且**校准需要 MCU 发起**（手册流程含"写 Reg 04h=0 初始化校准"） |

⇒ 这条把 #16 的"低通不工作"钉死成**三个独立原因**：`VDDBG` 无供电（改板）、
`LPF_POWER`(PE11) 无人驱动（固件）、寄存器零配置（固件）。
前一条**只能改设计图**——正好是"换料/改版"时躲不开的那类改动。

**供电链**：`+5V_BOOST` → **Q208**（`MOSFET_P_SOT23_IRLML6401`）→ `LPF_5V`；
Q208 栅极经 **R206** 接到 **`LPF_POWER` = U121.41（PE11）**，并有 **R207** 上拉到 `+5V_BOOST`。
⇒ 上拉意味着**默认关断**，必须由 MCU 把 PE11 拉低才给 LPF 上电。

**固件现状（grep 实证）**：`Source/` 与 `Source_F7/` 里都没有 `LPF_POWER` 或 `PE11` 的驱动代码；
固件里另有 `FIVE_VOLT_REGULATOR_ENABLE`，但它映射的是 **PE2 → 网络 `5V_REG_ENABLE`**（另一条电源），
名字和网名不同，**不能用网名 grep 反推固件**。

> 顺带纠正一个容易误判的对照关系（我差点写错）：固件符号名与网表网络名并不一致——
> `FIVE_VOLT_REGULATOR_ENABLE`↔`5V_REG_ENABLE`（PE2）、`PREAMP_POWER`↔`PREAMP_SHTDWN`（PD14）、
> `AMP_POWER`↔`AMP_POWER`（PE3）。核对引脚必须以 MCU 引脚号为锚，不以名字为锚。

## 3. SPI 连接（三线共享 + 两条片选）

| 信号 | U287 引脚 | 网络 | MCU 引脚 | 同总线其他器件 |
|---|---|---|---|---|
| SCK | 12 (`SCK`) | `FILTER/GAIN_POT_CLK` | U121.52 = **PB13（SPI2_SCK）** | U15.7 `SCLK`（`DIGITAL_POT_MAX5388` 数字电位器） |
| SDI | 14 (`SDI`) | `FILTER/GAIN_POT_MOSI` | U121.54 = **PB15（SPI2_MOSI）** | U15.6 `DIN` |
| SDO | 13 (`SDO`) | `FILTER_MISO` | U121.53 = **PB14（SPI2_MISO）** | 仅 U287 |
| SEN（片选） | 15 (`SEN`) | `FILTER_CS` | U121.51 = **PB12（SPI2_NSS）** | 仅 U287 |
| —（电位器片选） | — | `GAIN_POT_NSS` | U121.4 = **PE4** | U15.5 |

要点：
1. **时钟与数据线与增益电位器共用**，靠两条独立片选（`FILTER_CS` 与 `GAIN_POT_NSS`）区分——
   写滤波器时必须保证电位器片选为高（不选中），否则会同时改增益。
2. **U287 的 SDO 独占 MISO**，所以读回寄存器是可行的（固件目前没有任何读回）。
3. 全部走 **SPI2**；固件现有的 SPI 初始化在 `spi.c`（`spi_init`），但没有针对 U287 的片选/时序代码。

## 4. 射频与校准侧

| 引脚 | 端子名 | 网络 | 对端 | 判读 |
|---|---|---|---|---|
| 26 | IIP | `FILTER_IN_P` | U211.13(2B4)、U298.4(1B3) | 差动输入 P（来自前端开关阵列） |
| 27 | IIN | `FILTER_IN_N` | U211.3(1B4)、U298.12(2B3) | 差动输入 N |
| 6 | OQP | `FILTER_OUT_P` | U211.12(2B3)、U298.3(1B4) | 差动输出 P |
| 7 | OQN | `FILTER_OUT_N` | U211.4(1B3)、U298.13(2B4) | 差动输出 N |
| 18/19 | OIN/OIP | `$$$31740` / `$$$31750` | 经 C293 / C294 到 `$$$31745` / `$$$31748`（接 30/31 IQN/IQP） | **I 通道**输出隔直后跨接到 Q 通道输入（手册 Table 6；见 pinmap-check §2） |
| 30/31 | IQN/IQP | `$$$31745` / `$$$31748` | 同上 | **Q 通道**差分输入，无外部馈入，仅来自 I 输出的交流耦合 |
| 5 | CMQ | `$$$27752` | R296.1、R297.2 | 输出共模偏置网络 |
| 20 | CMI | `$$$27784` | R285.2、R286.1 | 输入共模偏置网络 |
| 11 | CALCK | `$$$15644` | 经 **C283** 接 **`FILTER_CAL` = U241.18（Si5338）** | **校准时钟来自 Si5338 输出**，依赖频率合成器已配置 |
| 29 | VBG | 悬空 | — | 见 §2，待手册 |

滤波路径在拓扑上是：**前端 → 74CBTLV3253 双 4:1（U211/U298）→ 直通 或 HMC1023 → 再回开关**，
选择由固件的 `FILTER_S0/S1` 决定（`Source_F7/src/hal.c:186/188`）。所以"滤波不工作"至少有四个独立原因：
开关档位、LPF 未上电、LPF 未配置、校准时钟缺失——每一层都能单独验证。

## 5. 要把这颗 IC 跑起来，缺什么（不含代码）

| # | 事项 | 现状 | 依据 |
|---|---|---|---|
| 1 | **HMC1023LP5E 数据手册** | 已取得官方 PDF 并本地抽文核对（引脚定义、CALCK 频率档、SPI 读写节拍、预编程/未编程订购差异）；**寄存器表内容仍需逐条整理** | §2.1 |
| 2 | LPF 供电控制 | 板上有（PE11→R206→Q208），**固件零驱动** | grep `LPF_POWER` 为空 |
| 3 | SPI 配置序列 | 硬件全通（PB12–15），**固件零代码** | grep `hmc1023/lpf` 仅命中菜单 TODO |
| 4 | 校准时钟 | 由 Si5338 提供（U241.18 → C283 → CALCK）；Si5338 本身配置状态未知 | §4 |
| 5 | 读回验证 | SDO 独占 MISO，可行；固件未实现 | §3 |

## 6. 复现

```bash
python tools/pads_asc_netlist.py Hardware/PSDR.asc --json /tmp/netlist.json
# 然后按 (refdes,pin) 查 nets；本文所有表都来自这一份 JSON，
# 引脚名取自 *PARTDECAL 的 TERMINAL 名，不是数据手册
```

## 7. 与 issue #16 的关系

#16 的核心是"前放/低通没调通"。本表把低通这一半拆成了四个可独立验证的条件（§4 末）。
其中 **"LPF 未上电"** 与 **"固件零配置"** 两条已经用仓库数据确证；
剩下两条（开关档位极性、Si5338 输出是否正确）需要实物与仪器，属 M3 范围。
