fe1iscurc0r/PSDR/docs/PSDR-revB-workorder.md

# rev-B 局部改版工作单（fork-only，不提交上游）

日期：2026-11-04。方向早已拍定：**"必须改版、但只做局部"**（见 `docs/WO-psdr-takeover.md` §K-6.1 的规格）。
本工作单只做一件事：把"改哪里、改到能验收、什么条件下才允许动刀"写成可执行的表。

**本工作单不含任何射频参数的承诺。** 全文没有一次实测（本机没有板子、没有仪器）；
所有数值分三类标注：**读得**（网表/贴装/表格逐格取出）、**算得**（公式推的）、**待测**（必须上板）。

---

## 0. 边界（违反即作废）

1. **不改固件源码**，注释也只写进 `docs/`。固件冻结 ⇒ 本工作单只**出表**（"模式→引脚状态"），
   不改 `Source*/`，也不以固件改动为前提排期。
2. **不修射频性能以图"更好"**：#6/#16 类问题在本仓一律只观测、只记录判据（`docs/PSDR-bringup-checklist.md`）。
3. **不替作者定值**：11 个"板文件 vs BOM"冲突位号（§7.3 那张表）在实测前**两个值都写**，不许挑一个。
4. **国产化/替代件方案只留 fork**，不进上游；本工作单里凡涉及替代件的地方一律写 `pending`。
5. 任何"典型值/常见做法"不能填进 `pending` 的位置（这是 §K-6.1 明写的硬规矩）。

---

## 1. 三道门（gate）：不满足就不要开 rev-B 的刀

| 门 | 判据 | 现在什么状态 | 不开门的后果 |
|---|---|---|---|
| **G1 器件身份** | U304 板上到底是 `SXB-2089Z` 还是别的；`U211/U298` 实购是 CBTLV 还是 CB3Q | **未过**：U304 有两条独立来源（BOM 行内 DigiKey 超链接 + Jeff 2021-02-19 在 #13 找到 win-source 的 SXB-2089Z），但**原件取不到**（Qorvo 站点检索不到、我方出口 429）；CB3Q/CBTLV 两条网表与 BOM 打架（`docs/PSDR-external-findings-2026-11-03.md` §1.3） | 封装/偏置/真值表全部悬空，改了也不知道对不对 |
| **G2 数值口径** | 11 个位号 + 两条轨（`+3V3_CPU` 2.898/3.012 V、`+5V_BOOST` 4.94 V）**量得** | **未过**：`docs/PSDR-bringup-checklist.md` 优先 annex 全是待测；轨压目前是**算得** | 任何"控制电平余量"的判断都是纸面 |
| **G3 免改版实验先跑** | 插在 `E_FILT_RF_P/N` + `E_FILT_IF_P/N` 上的 6 段 LC 子板，与 HMC1023 **在同一台机器上 A/B** 出数字 | **未过**（需要板子 + 仪器，`docs/PSDR-scope-and-cost.md` 那张最小测量集表） | 没证明"带通更好"就改版 = 花钱买未验证的假设 |

⇒ **本工作单的正确执行顺序是：G3 的子板可以完全不改主板地先做**（插槽已在 mux 档位里）；
真正的 rev-B 主板改版排在 G1+G2+G3 都过之后。**当前唯一可立即推进的是 §4 的表与 §3 的闭包数据。**

---

## 2. 影响圈：数据说"局部"在射频路径上基本不成立

`tools/revB_zone_closure.py`（本轮新增，重跑：`python tools/revB_zone_closure.py`）
按网络传播，**参考网不传播**（`GND` 261 脚、`+3V3` 58、`+3V3_CPU` 50、`HALF_VCC` 23 等一律挡掉并列在
`dist/revB/zones_summary.md`，排除是可查的不是假设）。结果：

| 区 | 种子 | 区内件数 | 一跳邻居（含种子） | 二跳 | 一跳包围盒（mm，贴装表原点＝板框左下角） |
|---|---|---|---|---|---|
| U304 增益级 | `U304` | 9 | **6**：`U304 BIAS C13 C305 L11 L19` | 3 | x 7.9–16.0, y 42.2–50.5（约 8×8 mm） |
| 三片 DPDT | `U16/U24/U30` | 102 | **13**：三片 + `C13 C20 C21 C26 C27 C303 C305 C306 C35 U121` | 89 | 铺满全板（x 0–96.2, y 2.5–61.0） |
| HMC1023 | `U287` | 99 | **14**：`U287 C283 C292 C293 C294 R285 R286 R296 R297 U121 U15 U211 U298` | 86 | 同上 |
| 天线口（2026-11-04 加） | `ANT/VNA-IN`、`REF`、`DUT`、`VNA-OUT` | 19 | **12**：四个端子 + `C303 C306 C309 C322 R28 R29 R308 R321` | 7 | x 4.2–16.0, y 25.1–55.0 |

（天线口那一行由 `python tools/revB_zone_closure.py --zone "antenna_ports:ANT/VNA-IN,REF,DUT,VNA-OUT"` 生成；
不加 `--zone` 时只跑内置三区。）

**读得**：**四区并集 129** 件，板上一共 **391** 件 ⇒ **影响圈外必须逐件不变的是 262 件**。
（K-17 当时只算三区是 124 / 267；加上天线口后 129 / 262，判据用**新的这对数**。）

**算得/结论（这条是本工作单最重要的一句）**：**只有 U304 区是真·局部（一跳 6 件、8×8 mm）**；
DPDT 与 HMC1023 二跳就铺满全板——因为射频路径每一跳都是下一级的输入，
"局部改 RF"在网表意义上不存在。⇒ rev-B 若要"只做局部"，**范围只能定义成**：

* (a) **U304 子图**（含 `BIAS`/`L11`/`L19`/`C13`/`C305`）——真局部；
* (b) **三片 DPDT 各自的 1 跳邻居**（共 13 件）——只在换封装/改掷位时动；
* (c) **HMC1023 的 1 跳邻居**（14 件，含 `U211/U298` 与 `U15`）——只在决定是否保留这颗时动；
* (d) **天线口子图**（12 件，含 `R28/R29/R308/R321` 与四个端子）——只在动 VNA/天线插座时动；
* 其余 **262 件 = 硬约束**：任何改动导致这 262 件的贴装/网络变化，就不叫 rev-B，叫重设计。

验收命令（**签名按各工具现有 argparse 写实**，可判定，不许用综合分代替）：

```bash
# 1) 重出影响圈（本轮新增，不需要 EDA）
python tools/revB_zone_closure.py

# 2) 改版后重出贴装表（输入是新版 .asc 或新版 KiCad 导出的等价坐标表）
python tools/pads_asc_placement.py <新板 ASCII> --out dist/fab/revB_placement.csv

# 3) 网络对拍：三赛区外的网络必须逐集合一致
python tools/kicad_netlist_compare.py --pads Hardware/PSDR.asc --kicad dist/kicad/<revB>.kicad_pcb

# 4) 几何对拍（需要 kicad-cli 先画出 Edge.Cuts 与钻孔）
python tools/kicad_roundtrip_check.py --edge-export <Edge_Cuts.gbr> --drill-export <drill> --tol-mm 0.01

# 5) 一条命令重建参考板 + DRC + 制造包，并自检
python tools/reproduce_kicad.py --check
```

第 2/4 步在 267 件"逐件不变"上的判据：**坐标差＝0、面别与角度差＝0、位号集合差＝空**；
任一不为零即说明改到了局部之外，本工作单 §2(a)(b)(c) 的范围定义失效，须停下重开范围。

---

## 3. 每区要产出什么（zone dossier 模板）

三个区各出一份，**填表不许留空**，拿不准写 `pending`：
（2026-11-07 已按此模板各出一份：`PSDR-dossier-U304-gain.md` / `PSDR-dossier-DPDT-switches.md` /
`PSDR-dossier-HMC1023-lpf.md`，pending 均标注等哪个门；下表保留为模板底稿。）

| 字段 | U304 增益级 | 三片 DPDT | U287 HMC1023 |
|---|---|---|---|
| 器件身份 | `SXB-2089Z`（两条独立来源，**G1 未过**） | `MASWSS0129TR`（原厂 PDF 取不到；真值表停在 `镜像` 级） | `HMC1023LP5E`（**原件已到手**，v01.0113） |
| 封装能否替换 | **不能**（3 焊盘 `RFIN/GND/RFOUT`，偏置从输入侧注入） | **不能**（13 焊盘；控制脚数与真值表必须一致，否则 `signalPath()` 全错） | 待评估（32 端子 + 散热盘，decal `T` 记 33、网表只有 32，pin 29 无网络） |
| 现供电 | `+5V_AMP` | `+3V3_CPU`（**算得** 2.898/3.012 V，高电平要求 ≥ +2.9 V ⇒ 余量约 0.1 V，**待测 G2**） | `LPF_5V`（13 脚网）与 `LPF_POWER`；**`VDDBG` 无供电是已记录的硬件缺口** |
| 隔直要求 | 需要（`requires … external DC blocking capacitor`，镜像级） | — | — |
| 改动清单 | 待定（G1/G3） | **`U30` pin 6 = 空掷位**（网表实测 `present? False`）⇒ 多一路可自由接的掷位 | 保留 or 换成 6 段 LC：G3 决定 |
| 参考实现 | — | 真值表与互补驱动：`docs/PSDR-open-data-gaps.md` #4 | **UHSDR 已实现**：`mchf-eclipse/hardware/uhsdr_hmc1023.c`，commit `c447c2e4`（2018-10-21，含手动细校准） |

---

## 4. 波段 ↔ 控制线表（固件冻结，这张表只描述硬件能到达的状态）

**读得**（`dist/netlist/PSDR_2.6.1_netlist.json`，脚号＝封装脚，括号内是器件类型）：

| 控制网 | MCU 脚 | 受控器件脚 | 网表里还挂着 |
|---|---|---|---|
| `AMP_SWITCH_A` | U121.22 | `U16.3` | — |
| `AMP_SWITCH_B` | U121.5 | `U16.7` | — |
| `IMP_BRIDGE_SWITCH_A` | U121.16 | `U24.3` | — |
| `IMP_BRIDGE_SWITCH_B` | U121.30 | `U24.7` | — |
| `TX_RF_SWITCH_A` | U121.36 | `U30.3` | — |
| `TX_RF_SWITCH_B` | U121.31 | `U30.7` | — |
| `FILTER_S0` | U121.40 | `U211.14`、`U298.14` | 两支 mux 同驱 |
| `FILTER_S1` | U121.55 | `U211.2`、`U298.2` | 两支 mux 同驱 |

固件侧现状（**只引用不修改**；行号在现基线 `PSDR_F7`，符号名↔MCU 脚以脚号为锚，见 §0.1 纪律）：
`FILTER_S0/S1` 三处写操作全是 `(1,0)`、作者注释 "Filter Muxes set to bypass"，
`case recieve_with_filter:` 是空的 ⇒ **软件永远不会切到外接滤波档**。
**逐 case 的完整引脚矩阵已单独成表**：`docs/PSDR-signalpath-pinmap.md`
（12 根控制线 + 7 个枚举态，含"态 1 落进发射分支""态 3 加电仍旁路""态 4/5/6 不写任何脚"三条只读观察）。
所以：

* 台架若要验证子板，只能**先实测确认哪一档导电**（CBTLV/CB3Q 真值表是 G1 的一部分），
  必要时用跳线/断开驱动，**不许拿信号顶 MCU 的推挽输出**；
* 这张表就是 rev-B 的"控制面预算"：**8 根线、6 段带通最多用 3 位选择**，
  若选 6 段分立带通，`FILTER_S0/S1` 两位不够 ⇒ 要么用 `U30` 的空掷位换路、要么接受只用 4 段。
  **具体几段、哪几个波段：`pending`（等 G3 的数字）。**

## 5. 真到改版那天，交付物与作废声明

1. **重出三件套**：Gerber（`tools/reproduce_kicad.py` 那条链）、贴装表（`tools/pads_asc_placement.py`）、
   BOM（`Hardware/BOMs/` 新目录，不动 2.6/2.6.1 的历史件）。
2. **旧 `dist/kicad/SHA256SUMS` 就地作废**：新版本单独目录 + 单独清单，
   并在 `docs/README.md` 写明"旧清单只描述 2.6.1 复现板，不覆盖 rev-B"。
3. **制造口径三条必须重新对账，不能沿用本板数值**（`docs/PSDR-open-data-gaps.md` §2.3）：
   锡膏层（CAM 母片是 gerbv 2.6A 二次导出、母片内 0 个 G36/G37 区域，我们的 KiCad 不建模锡膏）、
   丝印字体（CAM→我方 97.7%/97.4%，残差全是字符级）、设计规则（源 8/12/20 mil vs EDA 工程 6/4/10 mil）。
4. **EDA 导入 SOP 重跑**：`docs/SOP-eda-import-2.6.1.md` 那 7 步在新板上会得 10/12 起步，
   那不是回归，别按旧板的 12/12 判失败。
5. 每步都要留**回读证据**：JSON/CSV 落 `evidence/` 或 `dist/`，命令与输出进总账新章。

## 6. 明确不排期

* 6 段带通的元件值：只有等 G3 的实测；可抄的实测表已在 `delegation/answers/`
  （(tr)uSDX 逐波段 C/L 匝数、QCX+ 逐波段 BOM、mcHF 7 阶 LC×4 继电器、Hermes-Lite 2 的 N2ADR 滤波板），
  但那些是**外部断言级**，不能当我们的设计值。
* HMC1023 的去留：G3 之前不动它（它的原件已到，寄存器表已可读）。
* 任何"向上游提 rev-B 提案"：上游 issue 逐次批准，且本仓一律不附 PR。

## 7. 现在就能推进的（不需要板子、不需要上游、不需要新授权）

1. ~~§2 的闭包扩到天线口~~ —— **2026-11-04 已完成**：四区 129 / 圈外 262（`--zone antenna_ports:…`）。
2. ~~§4 补全部 case 的引脚状态~~ —— **已完成**：`docs/PSDR-signalpath-pinmap.md`（12 根线 × 7 个态）。
3. ~~`U287` 的 32 端子逐脚与原件表对齐~~ —— **2026-11-07 已完成**：`docs/PSDR-HMC1023-pinmap-check.md` 独立复核（网表 JSON × 手册 Table 6 逐脚一致），并更正 I/Q 通道归属笔误。
4. ~~把 §3 的三份 dossier 填到只剩 `pending`，`pending` 全部标注"等哪个门"~~ —— **2026-11-07 已完成**：`docs/PSDR-dossier-U304-gain.md`、`docs/PSDR-dossier-DPDT-switches.md`、`docs/PSDR-dossier-HMC1023-lpf.md`（每格已填，pending 均标 G1/G2/G3 或"等用户画线"）。
