fe1iscurc0r/PSDR/docs/PSDR-revB-local-plan.md

# 局部改动规划（rev-B lite）：解决"缺料以外"的全部问题（2026-11-04）

前提与口径（按用户 2026-11-04 的指示）：
* **范围**：只做局部改动，不动"缺料"（U304、U16/U24/U30 的替代）——那属于路线 B/重设计。
* **"不算解决"**：① 仅换 L/C/电阻值的凑数（除非标注为"最小必要"并单列）；② 只改文档不改实物；③ 把问题推给"以后再说"。
* 本文只出**改动清单与验收判据**；`Source_F7/` 的代码改动仍待用户明确解禁，本文不写码。
* 影响圈沿用 `docs/PSDR-revB-workorder.md` §2：四区并集 129 件，圈外 **262 件必须逐件不变**。

---

## 1. 硬件改动（都落在"铜/丝印/制造参数"上，不是换值）

### H-1 `VDDBG` 供电（对应缺陷 D-02，最高优先）

* 现状：`VDDBG`(U287.28) 只连 `C292.1`，没有电源（网表 `$$$15137`）。
* **rev-B 改法**：从 `LPF_5V` 最近的节点拉一段铜到 `C292.1`。
  实测坐标（贴装表，mm）：`C292` (34.29, 9.91)；`LPF_5V` 上最近的电容是 **`C291` (37.08, 13.21)，距离 4.3 mm**；
  其余 `C290` 5.4 mm、`C295` 6.4 mm。
* **台架等价做法**（不改板）：30 AWG 飞线 `C292.1` ↔ `C291` 的 `LPF_5V` 端；飞完量 pin 28 对地 ≈5 V。
* 验收：pin 28 = 4.9–5.1 V；HMC1023 的 `VDDBG` 电流正常（手册未给上限，量电压即可）。

### H-2 线距成簇修复（对应 D-14）

52 条 `clearance` 实测 **0.1174–0.1986 mm**（源规则 0.2032 mm）。按 `dist/revB/clearance_clusters.csv` 成簇处理：

| 簇 | 条数 | 处理 |
|---|---|---|
| U86 周围（MAX4525） | 6 | 挪 B.Cu 的 GND 走线，让出 ≥0.2 mm |
| U241 周围（Si5338） | 5 | 同上（GND 走线贴焊盘） |
| C118 / C119 / GPSR 周围 | 各 3 | 局部改线 |
| U253 / U287 / C256 / C257 / C179 / R117 / REF | 各 2 | 局部改线 |

* **目标值**：源规则 **≥0.2032 mm**（8 mil）；若只为过厂规，最低 **≥0.15 mm**（约 6 mil），但**建议按源规则改**，避免下次再被 DRC 抓。
* 验收：改后 `clearance` 违规 = 0（KiCad DRC 同为规则 0.2 mm 时）；圈外 262 件坐标/网络不变。

### H-3 板厚与叠层口径（对应 D-16）

* 源叠层算得 **0.899 mm**；下单按 **1.0 mm**（常见档）或向厂确认 0.9 mm。
* 叠层：4 层 / FR4 εr 4.3 / 1 oz / 介质 3×0.254 mm；表面处理**沉金**。
* 验收：下单页参数与 §6 的表格逐项一致；DFM 预检用**原始 Gerber 包**。

### H-4 丝印让位（对应 D-17）

把压在焊盘/过孔上的位号（199 条 `silk_over_copper` 的典型位置）挪开 ≥0.2 mm；**只动丝印层**，不动铜。
验收：丝印 DRC 的 `silk_over_copper` 从 199 降到 ≤ 个位数（允许保留连接器处无法避免的少数）。

### H-5 `U30` pin 6 引出（可选，服务于滤波扩展）

`U30.6`（ANT2）无网络。rev-B 可把它引到一个测试点/焊盘，供将来外接滤波器切换用。
验收：新增一个网络与一个测试点；不影响其它网络。

---

## 2. 固件改动（规格级，代码待解禁；与 Michael 的 HMC1023 工作协调）

| ID | 改动 | 对应缺陷 | 判据 | 依赖 |
|---|---|---|---|---|
| F-1 | Si5338 就绪等待改为**有界重试 + 屏幕报错后继续** | D-01 | 拔掉 Si5338 时 5 s 内进入主循环并显示错误 | 无 |
| F-2 | `signalPath()` **表化**（12 根线 × 7 态一张表），并给 `recieve_with_filter` 加**独立 body + break** | D-04/D-05/D-07/D-08 | 主机测试断言 7 态 × 12 线矩阵；态 1 不再落进发射分支 | F-3 的档位定义 |
| F-3 | `FILTER_S0/S1` 档位映射（需 CB3Q 真值表 + `E_FILT` 子板定义） | D-05 | 每个档位对应到确定的 mux 通道；跳线选档可用 | H-2/子板；CB3Q 手册 |
| F-4 | VNA 两态：`IMP_BRIDGE`/`TX_RF` 组合 + `VMAG/VPHS` 采样 | D-06 | 进入 VNA 态后继电器到预期组合；ADC 能读到随负载变化的电压 | 硬件链已完整 |
| F-5 | HMC1023 驱动（寄存器表、截止码、`04h` 校准、`05h` 读回） | D-03 | 扫频响应随档位变化；校准完成可读 | **H-1 + CALCK（F-6）**；**先问 Michael** |
| F-6 | Si5338：`CLK1` 配置（若 NVM 未配）+ `vcoFreq` 常量核对 | D-09/D-10 | 量 `FILTER_CAL` 有 20–80 MHz；CLK0 与请求频率误差 <0.1% | 需先读 NVM/实测 |

> **不撞车原则**：Michael 在 #19 已说他在 `PSDR_F7` 上做 HMC1023 bring-up。F-5 动手前先在 #19 问一句，
> 优先做 F-1/F-2/F-3/F-4（这些他没说在做）。

---

## 3. 顺序与依赖

```
H-1 (VDDBG) ──┐
F-6 (CLK1) ───┼─> F-5 (HMC1023 驱动)
H-2 (线距) ───┘
F-1 (I2C 超时) ─> F-2 (signalPath 表) ─> F-3 (滤波档位) ─> F-4 (VNA)
H-3/H-4/H-5 ── 与上面并行（制造/丝印层面，不影响逻辑）
```

**先做**：F-1、F-2 的主机测试（无板），H-1 飞线方案（有板即做）。
**后做**：F-5（等 Michael 回话 + H-1）。
**制造**：H-2/H-3/H-4 在投板前一起做完。

## 4. 验收总表（每项都必须可判）

| 项 | 判据 | 手段 |
|---|---|---|
| H-1 | pin 28 = 4.9–5.1 V | 万用表 |
| H-2 | `clearance` 0 条（≥0.2 mm） | KiCad DRC |
| H-3 | 下单参数与 §1 H-3 一致 | 下单页截图 + 订单号 |
| H-4 | `silk_over_copper` ≤ 个位数 | KiCad DRC |
| F-1 | 无 Si5338 时 5 s 内进主循环 | 台架/逻辑分析 |
| F-2 | 7×12 矩阵与表一致 | 主机测试（`tools/`，不碰固件树） |
| F-3 | 跳线选档可复现 | 台架 |
| F-4 | VNA 态继电器组合正确 | 万用表量控制脚 |
| F-5 | 扫频曲线随档位变化 | VNA/信号源 |
| F-6 | `FILTER_CAL` 有 20–80 MHz | 示波器 |

## 5. 工作量（估算，非承诺）

| 项 | 估时 | 说明 |
|---|---|---|
| H-1 | 0.5 人日（改铜）/ 10 分钟（飞线） | |
| H-2 | 1–2 人日 | 改 52 条，按簇处理 |
| H-3/H-4 | 0.5 人日 | 制造参数 + 丝印 |
| F-1 | 0.5 人日 | 小改 |
| F-2 | 1–2 人日 | 表化 + 主机测试 |
| F-3/F-4 | 2–4 人日 | 依赖真值表与硬件 |
| F-5 | 3–5 人日 | 手册寄存器 + 校准 + 台架 |

## 6. "不算解决"的清单（按你的口径，单列不计入）

* **换 R113 得到 3.3 V**（D-11）：只是换值，按你的口径不算"解决"；但它可能是唯一手段——若实测轨 <2.9 V，
  这是必须做的"最小必要换值"，我会单独标注，不混进本表。
* **11 个值冲突**（D-12）：多数票已定，最终仍以实测为准；换值本身不算解决。
* **CB3Q/CBTLV**（D-13）：若实物是 CB3Q，网表改名即可（不改硬件），算文档级修正，不算"改动"。
* **缺料替代**（U304/DPDT）：明确不在本规划内。

## 7. 首次打样前的板级改动清单与难度（2026-11-04 实测坐标）

### 7.1 `VDDBG` 拉铜：难度**低**

* 两端都在**底层（B.Cu）**：`C292` (34.29, 9.91) 与最近的 `LPF_5V` 节点 `C291` (37.08, 13.21)，**直线 4.3 mm**。
* 这条走廊里**没有任何底层元件**（1.2 mm 范围内只有两个端点电容）。
* 但有 **3 段既有 B.Cu 走线**在 0.167–0.177 mm 处靠近、另有 1 段 F.Cu 在 0.037 mm 处
  ⇒ 直连会碰间距，**绕一下或加 2 个过孔换层**即可。
* 估计：**布局 30–60 分钟 + DRC/Gerber 重出**；不动任何器件位置。

### 7.2 线距：要改的其实只有 **4 处**（不是 52 处）

52 条 `clearance` 的实测分布：

| 阈值 | 条数 |
|---|---|
| **< 0.127 mm（5 mil）** | **4** |
| < 0.150 mm（6 mil） | 16 |
| < 0.180 mm | 42 |
| < 0.200 mm（源规则） | 52 |

最紧的 4 条（都在 0.117–0.125 mm）：`U253` 旁 2 条（0.1174 / 0.1272 边缘）、
`U314` 的 `R28`/`REF` 侧 2 条（各 0.1231）、`U260`/`C259` 1 条（0.1247）。
⇒ **只改这 4 条就能过 5 mil 档**；把 16 条改到 ≥0.15 mm 是更稳的版本。
（改法：挪对应 B.Cu 的 GND 走线，全部在局部，不动器件。）

### 7.3 其余"要改板"的其实不用改

| 项 | 结论 |
|---|---|
| 板厚 0.9→1.0 mm | **下单参数**，不改版图 |
| 丝印压焊盘 199 条 | 只影响可读性，厂方会裁；想改是"挪文字"，可选 |
| `U30.6` 空掷位引出 | 可选，与首次打样无关 |
| VNA / 滤波 mux / HMC1023 / Si5338 | **全是固件或飞线**，不需要改板 |
| 缺料件（U304/DPDT） | 本次打样**不贴**，不影响板子能不能做出来 |

### 7.4 首次打样的最小改动集（建议）

1. `VDDBG` 拉一段铜（4.3 mm，2 个过孔）；
2. 4 条 <0.127 mm 的线距改到 ≥0.15 mm（顺手把 16 条都改了更好）；
3. 下单选 **4 层 / FR4 / 1 oz / 1.0 mm / 沉金**；
4. 其余保持原样，Gerber 从原始包或改后重出，做一次 DFM 预检。

这 4 条改完，板子就"能下单、能焊、能测轨"，不需要等缺料件。
