fe1iscurc0r/PSDR/docs/PSDR-defect-register.md

# PSDR 缺陷登记册（除"元器件缺失"之外的全部已知问题）

日期：2026-11-04。**只登记有出处的**：每条给 现象 / 证据 / 卡在谁身上 / 现在能做什么。
"元器件缺失"（U304、U16/U24/U30）与"资料缺失"（SPS 原厂 PDF）不在本表重复。

## A. 会挡住"开机可用"的（P0 级）

| ID | 缺陷 | 证据 | 卡在谁 | 现在能做的 |
|---|---|---|---|---|
| **D-01** | 固件在 `main.c:1031-1032` **无超时**等待 Si5338 的 I2C 就绪：`while(result != HAL_OK) HAL_I2C_IsDeviceReady(...)`。Si5338 不应答（没焊/坏/NVM 未配）就**卡在显示初始化之前** | 现基线 `Source_F7/src/main.c` 只读；上游 #19 已报 | 固件冻结（本仓不改码） | 文档化 + 上电检查表里"先确认 Si5338 有应答"；真要修要上游点头 |
| **D-02** | **`VDDBG`(U287.28) 无供电**：只挂去耦 `C292`，没有电源馈入 | 网表 `$$$15137` = `U287.28`+`C292.1`；手册要求 5 V | 硬件（rev-B 或飞线） | **可立即做**：飞线 `LPF_5V`（U287.22 同网）→ `C292` 热端；见 §"可立即执行的修法" |
| **D-03** | HMC1023 **无驱动**，且 `CALCK` 的来源 Si5338 `CLK1A` **不由固件配置**（全树只写 `MULTISYNTH0`） | `grep -rn HMC1023 Source*` = 0；`i2c.c` 只有 MULTISYNTH0 | 固件冻结 + NVM 未知 | 只读分析已完成（`PSDR-hmc1023-driver-feasibility.md`）；台架实验可绕过 |
| **D-04** | `recieve_with_filter`（枚举 1）是**空 case**，落进 `transmit_no_amp_no_filter`：会把 `TRX_SWITCH=1`（"set to TX"）、`DAC_MUX=1`（RF） | `main.c:855` 与 `:858-889` | 固件冻结 | 文档化（`PSDR-signalpath-pinmap.md`）；rev-B 若要"带滤波接收"必须连固件一起改，属上游级改动 |
| **D-05** | `FILTER_S0/S1` 三处写点全是 `(1,0)` ⇒ 外接滤波档**永远选不到** | `main.c:851-852/886-887/919-920` | 同上 | 台架只能硬件跳线选档 |

## B. 功能缺失（不是 bug，但"不能用"）

| ID | 缺陷 | 证据 | 现在能做的 |
|---|---|---|---|
| **D-06** | **VNA 固件空**：`vna_reflected`/`vna_through` 两个 case 什么都不写 | `main.c:926-931`；硬件链完整（`PSDR-vna-path.md`） | 文档化；#20 已问上游 |
| **D-07** | 态 4/5/6 全空 + `default:` 被注释 ⇒ 进入这些态时控制脚保持上一次状态 | `main.c:923-935` | 同上 |
| **D-08** | `transmit_with_amp` 加电（`AMP_POWER=0`、`5V_REG=1`）但 `AMP_SWITCH_A/B` 仍写旁路值，注释却写 "set to on" | `main.c:900-902` | #16 的代码级证据；不改码 |

## C. 电气/时钟（可能"能开机但不对"）

| ID | 缺陷 | 证据 | 需要怎么判 |
|---|---|---|---|
| **D-09** | 固件 `vcoFreq = 2.84 GHz` **超出 Si5338 Rev1.6 的 2.2–2.8 GHz 上限**；若芯片实际 VCO 更低，所有输出按比例偏低（2.8 GHz 时约 −1.4%） | `i2c.c:727`；手册 Rev1.6 | M3：量 CLK0 或用已知频率比对 |
| **D-10** | `CLK1`/`CLK2` **不由固件设定** ⇒ HMC1023 的 `CALCK` 与 `F_SYNTH_CAL` 取决于 **NVM 默认配置** | `i2c.c` 只写 MULTISYNTH0；网表 `FILTER_CAL`/`F_SYNTH_CAL` | M3：量 `FILTER_CAL` 有无时钟 |
| **D-11** | `+3V3_CPU` 轨按分压算得 **2.898 V（R113=383K）或 3.012 V（R113=402K）**，不是 3.3 V；而三片 DPDT 控制高电平要求 **≥+2.9 V** ⇒ 余量可能只有 ~0.1 V 甚至为负 | `PSDR-bringup-checklist.md` B 表；AP3417C 手册 600 mV 反馈 | M3：量轨 + 量 R113 阻值 |
| **D-12** | **11 个位号的值三方冲突**（板文件 vs BOM vs 原理图）；10 个多数票在 BOM，R164 只在 BOM 说 240K | `BOM_refdes_crosscheck.csv` 与 `value_threeway_*.csv` | M3：逐个量（0603 可测） |
| **D-13** | 板文件写 `74CBTLV3253`，BOM 实购 **SN74CB3Q3253DBQR**（系列不同，Ron/电平不同） | BOM 行 vs 网表 type | M3：看丝印/料号，或量 Ron |

## D. 制造/机械（不影响功能，影响能不能下单）

| ID | 缺陷 | 证据 | 现在能做的 |
|---|---|---|---|
| **D-14** | 52 条 `clearance` 实测 0.1174–0.1986 mm，**小于源规则 0.2032 mm**；最集中在 U86/U241 周围 | `dist/revB/clearance_clusters.csv` | rev-B 成簇改线；或按高级工艺打样 |
| **D-15** | 39 条板边器件（PADDLE 舌口、SMA、EARPHONE、USB…）+ 4 个 Morse 桨"多层铜无钻孔" | `drc_*.txt` §C-16 | 下单时选板边/铣槽工艺；KiCad 侧无法表达"无钻孔焊盘" |
| **D-16** | 板厚按源叠层算得 **0.899 mm**，不是常见档位；PADS 叠层不等于厂里最终压合 | `PSDR.asc` `LAYER DATA` | 下单选 1.0 mm 或问作者；写进订单备注 |
| **D-17** | 丝印压焊盘/过孔：`silk_over_copper` 199 + `silk_overlap` 199 + `silk_edge_clearance` 55，**全部来自源设计** | §C-16 | 生产厂自动裁；看板关丝印层 |
| **D-18** | `U30` pin 6（ANT2）**空掷位**——不是缺陷，是可用资源；`U16/U24` 的同脚都有网 | 网表 | rev-B 可用 |

## E. 资料/流程（已解决或可控）

| ID | 问题 | 状态 |
|---|---|---|
| D-19 | `Documentation/` 6 份作者材料从未被读过 | **已解决**（`PSDR-documentation-archive.md`） |
| D-20 | 原理图 PDF 的位号属 **PSDR2 一代**（`U23`=AD8302、`U24-27`=DPDT），与 2.6.1 不同 | 已记（跨版本位号会漂） |
| D-21 | 上游 PR #18 待审、#19/#20 待回 | 外部 |
| D-22 | 网页交付物三份未进仓 | 等对方交回 |

---

## 可立即执行的修法（不需要板子、不需要改设计文件）

### 1. `VDDBG` 飞线（D-02）

* 目标：给 `U287.28` 供 **5 V**（与 `LPF_5V` 同电位）。
* 落点（网表实测）：`LPF_5V` 在 `U287.22`/`U287.16`/`U287.2`/`U287.4`/`U287.21`/`U287.23` 都有；
  最方便的是 **`U287.22`（VDDCAL）到 `U287.28`（VDDBG）**——两脚相邻（22 与 28 不同边，实际仍要飞线），
  或从 **`C292` 的热端**接 `LPF_5V`（`C292` 另一端是 GND）。
* 线径/长度：5 V 偏置电流小，普通细线即可；飞线后**用万用表确认 pin 28 对 GND 是 5 V 而不是 0 V**。
* 这条飞线**不改任何设计文件**，只在台架上做；rev-B 才把它变成铜。

### 2. 上电先量的四件（已写进检查表）

1. `+3V3_CPU` 是 **2.898 还是 3.012 V**（对应 R113 实测值，D-11/D-12）；
2. `+5V_BOOST` 是否 ≈ **4.94 V**（ADP1613 分压）；
3. `VDDBG` 脚（飞线后）是否 **≈5 V**（D-02）；
4. `FILTER_CAL`（`C283` 靠 Si5338 那一侧）**有没有 20–80 MHz 时钟**（D-10）。

### 3. 板厚/工艺（D-16）

下单时：**4 层 / FR4 / 1 oz / 板厚 1.0 mm（或按 0.9 mm 询问）/ 沉金**；
DFM 预检用**原始 Gerber 包**（`Hardware/Gerbers/PSDR261 Main Board/`），不要先传重建的 KiCad 版。
