fe1iscurc0r/PSDR/docs/PSDR-open-data-gaps.md

# 资料缺口与 PCB 改版/移植问题清单（fork 本地记录，不提交上游）

日期：2026-11-02。本文只记"还需要查什么"和"改板/移植会踩什么"，不包含任何源码或设计改动。
上游 PR #17/#18 只涉及原理图与 BOM 位号，**本文件不进上游**。

## 1. 必须查的资料（按"卡住了什么功能"排序）

| # | 对象 | 板上的证据 | 为什么必须查 |
|---|---|---|---|
| 1 | **HMC1023LP5E**（可编程低通滤波器） | `U287`，封装 `VARIABLE_FILTER_HMC1023`，**32 端子 + 散热盘（decal `T` 记录共 33 个；pin 29 = 手册 VBG，标注 "testing only"，悬空**不算缺陷**，与"VBG 悬空"互证）**；BOM 第 82 行 `1127-1662-ND` | **2026-11-03 资料侧结案**（v01.0113 全寄存器映射到手，见 findings §2.1）：`02h[9:6]` 粗调 9 档 = 5/7/10/14/20/28/40/50/72 MHz、`03h` 细调 12 档、`04h` 写任意位启动校准、`05h` 时钟周期以 **ps** 计、校准后 3 dB 带宽精度 ±2.5%；CALCK 要求 doubler 关 40–80 MHz / 开 20–40 MHz 且占空比 50%±10%。⇒ **未知项只剩三个，且都不在资料里**：① `VDDBG` 无供电（硬件缺口，改板才能解）；② `LPF_POWER`(PE11) 固件无人驱动；③ 校准/参考时钟频点要固件配合。**开源参考实现已找到：UHSDR 的 HMC1023 驱动（commit `c447c2e4`，ovi40h7）** |
| 2 | **Si5338**（四路时钟合成） | 驱动与寄存器写在现基线 `Source_F7/src/i2c.c`（825 行，`setFreq()` 在 `:729`，×2 与 5–350 MHz 硬限在 `:762-763`）；I2C Timing 常量在现基线的 `main.c:1018`（`0x40912732`，作者自注"Not sure how this is calculated, taken from EVAL example"）。**2026-11-03 更正两处**：本行原来写旧镜像的 `si5338.c`(695) + `frequency_control.c:41`——那两只文件是 `PSDR_Rebuild` 才拆出来的，`PSDR_F7` 里不存在（§survey §1 差异表）；常量本身**没消失**，只是位置在 `main.c:1018`，而且行号也标错了一位（Rebuild 里是 `:40` 不是 `:41`，实测） | 频率合成的正确性完全依赖这张表；另外 I2C 初始化无超时（§survey P0-2，现基线 `main.c:1031-1032`，就在同一个函数里 `:1018` 之后 13 行），需要手册确认"器件就绪"的判据与超时时间 |
| 3 | **SXB-2089Z vs HMC482ST** | `U304`，封装名 `MMIC-AMP_HMC482ST`，实际买的是 RFMD `SXB-2089Z`（BOM 行内超链接证据，见 §G-3）；板上 3 个焊盘：`RFIN/GND/RFOUT`，偏置从输入侧注入（`RF_AMP_IN = BIAS.1 + C13.2 + L11.1 + U304.1`，**C13 现值 100n**） | **2026-11-03 更正：我们此前把两颗件看成一颗。** 50–850 MHz 是 **SBB2089Z**（可级联 5 V 增益块）的规格；板上实购 **SXB2089Z 是 5–2500 MHz 中功率放大**（DS110610，测试条件 `Vs=8V / RBIAS=20Ω / VDEVICE=5.2V / 120-135-150 mA`，SOT-89），官方 EOL PCN 19-0122（2019-07-18）、LTB 2020-01-29、推荐替代 TQP7M9101。⚠️ 该证据目前只到 `镜像` 级（Qorvo 产品页已 404，原厂 PDF 未取得；见 findings §5），**在拿到 PDF 前不进 #16 对外更正**。两条已经能定的：① 输入脚**必须**外接隔直（SXB/SBB 同文，板上 C13=100n 正是它）；② **偏置电阻取值是 #16 的候选变量**——手册用 `RBIAS=20Ω`，而板上 R6 是 `板文件 100R / 2.6.1 BOM 180R`（冲突位号之一）。封装名对应的 HMC482ST89 = DC–5 GHz 但要 **+6～+12 V**，本板供 `+5V_AMP` ⇒ 若真按封装名买件则电气不成立。再叠加固件"三个已实现分支都把 `AMP_SWITCH_A` 写成 bypass"——**#16 的差额不是"偏置没加"这么简单**，详见 `docs/PSDR-scope-and-cost.md` §8.2 与 findings §1.1 |
| 4 | **MASWSS0129**（DPDT） | `U16/U24/U30`，13 焊盘；控制脚 `V1/V2`，G1/G2 与 5 个脚接地；固件注释写"I think!"、"always reverse of above" | 真值表已由镜像文本给出：**只有 `VC1/VC2 = 10/01` 两态导通，必须互补驱动**（`1 = +2.9…+5 V`、压差 ≥2.7 V），"11/00 全断"——这解释了固件为什么成对写反相脚，也意味着**若 3.3 V 轨实际只有 2.90-3.01 V（见 findings §7.2），高电平余量只剩约 0.1 V**。⚠️ 原件已确认撤档（`cdn.macom.com` 同路径的 MASWSS0143/0202 仍 200，唯 0129 是 404）⇒ 这条仍是 `镜像` 级，M3 上量开关脚电压即可判死。另：`U30` 的 pin 6（ANT2）**在板文件里没有任何网络**（U16/U24 的 pin 6 都有）⇒ 改版可用的一路空余掷位 |
| 5 | **AD8302**（增益/相位检波） | `U314`；`C307/C320` 是它的两个脚到地的旁路（DNP，见 §G-1） | **2026-11-03 基本结案**（原厂 Rev. B 我方已复算 sha256）：式 8a/9 与 ±30 dB / 10 mV/° 成立，**绝对最大输入 `−3 dBV ≈ +10 dBm`** 是 VNA 注入功率的硬上限；`R310-R313 = 0R` ⇒ 斜率与中心点**未做任何修正**；`C307/C320 = OPEN` 且 BOM 注明 "DNP by design" ⇒ **MFLT/PFLT 没有外接电容**，手册"建议 ≥1 pF"不满足、滤波时间只由内部 1.5 pF 定（≈5 ns）。仍缺的是**误差随频率的量化值**（手册只给 TPC 7–9 曲线，无单一 ±x dB 行）⇒ 归 M3 实测 |
| 6 | ~~74CBTLV3253~~ → **实购 SN74CB3Q3253** | `U211/U298`，各 16 脚；固件 `FILTER_S0/S1`（PE10）与 `FILTER_S1`（PD8）控制 | **前提更正**：netlist 的 `part_type` 是 CBTLV3253，**2.6.1 BOM 实购 `SN74CB3Q3253DBQR`（CB3Q 三供电系列）**，两份手册都取了（CB3Q `96d6c387…`、CBTLV `d6fb46fe…`，我方复算一致）。真值表/ Ron / Cio(OFF) 两族不同 ⇒ 控制线表与延迟预算必须按 **CB3Q** 走；已知的 CBTLV 侧数字：Ron 5/7 Ω @3 V、`Cio(OFF)` A 口 20.5 pF / B 口 5.5 pF、**手册不给隔离度随频率的规格** ⇒ HF 下的隔离只能实测（分波段前端要用的就是这个数） |
| 7 | **STM32F746 勘误手册** | 作者在 2019 年的提交里长期与"DMA 显示花屏"、I2C 卡死搏斗；`i2c.c` 里专门有 `clearStuckBusyFlag` | 判断哪些问题已被勘误/新版 HAL 解决，避免把硬件缺陷当软件 bug 修 |
| 8 | **2.6 版的原理图/装配图** | 仓库只有 `PSDR_2.6.1_Schematic_2016-07-31.pdf`（2.6.1）；2.6 的 `PSDR26` Gerber 在库，但没有对应的可读原理图 | 做版本对比或给工厂出装配图时需要；目前只能从 2.6.1 反推 |
| 9 | ~~SY100EP52V 的最低输入频率~~ **已结案：这是个假问题** | `U279/U280`（2 只，`CLKA/CLKB` 由 Si5338 CLK0 经 C265/C267 交流耦合进来，输出 `LO1P/LO1N/LO2P/LO2N`，供电 `+3V3_FLIP_FLOP`）；固件把调谐频率 ×2 后硬性限定 5–350 MHz（现基线 `Source_F7/src/i2c.c:762-763`） | **2026-11-03 结案，两处前提都错**：① 没有"SY100EP52"这只 ÷2 器件——`SY10EP52V`（netlist 名）与 BOM 实购 `MC10EP52DTG` **都是"Differential Data and Clock D Flip-Flop"**，÷2 是 EP32V；② 我方自取 onsemi 原厂 PDF（409,316 B，sha256 `c5e8a5cf…`）`pdftotext` 核对：AC 表只有 `Maximum Frequency = 4 GHz Typical`，**没有任何最低输入频率行**——ECL DFF 是 DC 耦合锁存器件，"fmin"这个问法不成立。⇒ 2.5 MHz 地板的准确表述仍是"固件不许 2.5 MHz 以下"，而"硬件被代码挡住"这句依然**不能写**，只是理由变了：分频器不是瓶颈，但也没有手册背书它能到 DC。⚠️ 连带：我们架构图里"2× EP52 交叉耦合成正交 ÷2"是**按接线推断**，官方手册无此应用电路（见 findings §1.2） |
| 10 | **WBC2-1TL 巴伦的低频下限** | `L39/L82`（2 只，`BALUN_1-2_WBC2-1TL`，1:2 阻抗比，接在混频器 L41/L81 与滤波选择器 U211/U298 之间） | **本轮查到族级答案**：这是 **Coilcraft WBC 系列**SMT 迷你宽带变压器（不是 Mini-Circuits），族表里 WBC1-1L 明确 **0.400–600 MHz**，同族隔离 300 Vrms、1/4 W、250 mA ⇒ **1.8 MHz 在范围内**，中波 0.5–1.7 MHz 处于下限附近。**WBC2-1TL 逐档（1:2 是否同带宽）仍需按手册那一行核对** |

## 2. PCB 改版 / 移植问题（全部有数字）

### 2.1 2.6 → 2.6.1 实际改了什么

逐行比对两份 BOM（2026-11-03 展平成 `Hardware/BOMs/PSDR_2.6.1/PSDR2.6_BOM_flat.csv` 与
`PSDR2.6.1_BOM_flat.csv` 后实测：**2.6 有 89 个件号行、2.6.1 有 86 个**；原文写的 86/88 是
没展平、把表头与空行算进去数的）：

- **电阻值差异至少三处，不是"只有一处"**（2026-11-03 用 `tools/bom_refdes_crosscheck.py` 逐位号展开后实测）：
  `R164` 270K→240K（`541-270KHCT-ND`→`1276-4870-1-ND`）、**`R6` 100R→180R**（→`RHM180DCT-ND`）、
  **`R14` 100R→68R**；后两条本轮才看到，之前写"实质差异只有一处 R164"是**只比了合并格写法没展开位号**造成的漏看。
- 其余差异是位号写法：2.6 用合并格 `R6,14,268` / `R97,-99`，2.6.1 拆成 `R6`/`R14`/`R268` 与 `R97-99`
  （这正是 PR #18 修正的那两处）。
- **而且未修的 2.6.1 表自己就矛盾**（不是版本 delta 那么简单。行号口径：下面"项 N"= `item_no.` 列的 N，
  实测 `item_no. 41` 落在这张表的电子表格第 45 行；只在这几行对过，别当全表公式用）：
  项 41（表格第 45 行）仍是 `R6,14,268`（Qty **1**、`P100GCT-ND`、100R），
  而项 42/43（第 46/47 行）又单列 `R14`=`68R`(`RHM68DCT-ND`)、`R6`=`180R`(`RHM180DCT-ND`) ⇒ **同一份表里 R6 既是 100R 又是 180R、
  R14 既是 100R 又是 68R**。PR #18 把该行改成只列 `R268`，消除的是这个文件内矛盾，不只是位号写法。
- **拆分是作者本意，证据在 qty 列**（2026-11-04 把两份**未修**文件逐格重读）：2.6 的同一行（同样第 45 行 / 项 41）
  Qty = **3**、`K45` = `100R`，且 2.6 里**没有**单列的 R6/R14 ⇒ 2.6.1 已把 Qty 从 3 改成 1（只有把 R6/R14 挪出去才讲得通），
  却漏了从位号文本里删掉它们——**一次只做了一半的编辑**，比"版本 delta"准确。
- **一条机械依据**（同上，2026-11-04）：按"列出的位号数量 == `qty_per_unit`"遍历，两份未修文件各有 **43 行** `ref_des` 含逗号；
  违约的只有——2.6：第 5 行与第 54 行；2.6.1：第 5 行、第 45 行、第 56 行。第 5 行是 `-,+,CLK,IO,NRST`，
  那是排针的网络名不是位号，不算组；剩下的 **正好就是 PR #18 改的那两处**（`R6,14,268` 与 `R97,-99`，
  后者 Qty 3 只点名 R97/R99，而 R97/R98/R99 三只都在网表里 ⇒ R98 无归属）。
- 取证方式：office-excel 导入 `45acd0f5` 的原始 .xls 后逐格读（2.6.1 BIFF `020f17df…` / 39,424 B；2.6 BIFF `076a7098…` / 41,472 B）。

⇒ **版本迁移的风险仍很低，但"改一个电阻即可"这句作废**——按 BOM 生产是 3 个电阻值的事，
而"以哪份数据为准"是必须先定的口径（M3 可直接量，见 `docs/PSDR-bringup-checklist.md`）。
真正拉开差距的是**可机读资料**：2.6.1 有 `Hardware/PSDR.asc`（唯一可机读的完整设计源）
与完整 CAM 包，2.6 只有 Gerber 与二进制 PADS 文件（`.pcb/.sch` 不可机读）。

### 2.2 改板时绕不开的封装问题

- 全板 **1,194 个焊盘**（Top 595 / Bottom 599）、**461 个钻孔**；按层统计 Top 574 / Bottom 575 个 SMD 焊盘、45 个通孔焊盘。
- **两颗断供器件的封装不可替换**：
  - `U304` 3 焊盘（RFIN/GND/RFOUT），替代运放若引脚拓扑不同（例如需要单独的 Vd 去耦脚）就必须改板；
  - `U16/U24/U30` 13 焊盘 DPDT，替代件的控制脚数量与真值表必须一致，否则 `signalPath()` 全错。
  ⇒ 这两处**属于重新设计，不是换料**（与 §G-2 的结论一致）。
- 其余无源件换封装同样不可接受：改了 footprint 就不再是"能按上游 `468dc41` 的 CAM 下单"的那块板。

### 2.3 制造侧已知的不对称

| 项 | 现状 | 改板时要做什么 |
|---|---|---|
| 锡膏层 | CAM 包里两层是 **gerbv 2.6A 二次导出**，母片里 **0 个 G36/G37 区域**；我们的 KiCad 板不建模锡膏（默认能生成每面 574 个实心开口，是母片孔数的约 3 倍） | 钢网只能用 CAM 母片；若重新出板，需从新设计导出锡膏层并与母片对账 |
| 丝印 | CAM→我们 97.7%/97.4%，残差全是字符级（最大 1.05×1.18 mm），来自笔画字体 vs 描边字 | 改版若换字体，这个差异会放大；建议沿用同一字体族 |
| 设计规则 | 源：通用 8 mil、铺铜 12 mil、铜到板框 20 mil；EDA 工程：信号 6、线对线 4、铺铜 10 mil | 送厂前必须统一，否则厂检口径与设计口径不同（见 §C-22） |
| EDA 导入 | KiCad→EDA 与 `.epro2` 再导入无 typed 接口（`unsupported`），只能人工两步 | 见 `docs/SOP-eda-import-2.6.1.md`；改版后这套 SOP 要重跑一遍 |

### 2.4 固件移植到新板的问题

- 两棵树的引脚定义都散落在 `main.c`/`hal.c`（`signalPath()` 里 10 个引脚写死），**换板就要改业务代码**；
  建议改版时先把"模式→引脚状态"抽成表（§survey 2.7）。
- 引脚与网表的对应关系已经整理成表（§survey 2.7），可以直接拿去做新板的 pinmux 核对。
- `HMC1023`（U287）在固件里没有任何驱动——新板若保留这颗，必须先把 SPI 配置补上，否则滤波路径永远是空的。

## 3. 结论

1. **资料侧的大头已经清掉**（2026-11-03，见 `docs/PSDR-external-findings-2026-11-03.md`）：
   HMC1023 寄存器表、AD8302 公式与 +10 dBm 绝对上限、Si5338 Rev 1.6 的版本差与 MultiSynth 约束、
   CB3Q/CBTLV 真值表与 Ron、EP52 无 fmin 规格、STM32 勘误 ES0290 §2.2.1（ADC 触发丢失）都已到手或已结案。
   **还缺的只有四只件的原厂 PDF，其中 MASWSS0129 一条可硬、SXB 一条只能弱**：
   MASWSS0129（同路径两件兄弟件 `MASWSS0143`/`MASWSS0202` 均 200，本件 404——2026-11-04 我方出口用 curl
   带浏览器 UA 各连测两次复现，先前的浏览器会话也是 404；但这只证明"原厂已不托管这份文档"，
   生命周期状态本身没有官方页面可证）、
   SXB-2089Z（Qorvo 站点检索不到该件；**我方出口直连拿到的是 429 限流，不是 404**（同日连测两次皆 429），
   加上新旧两条路径都断、本机够不到 Wayback ⇒ 5-2500 MHz 与 PCN 19-0122 停在 `镜像` 级，
   未写进任何对外结论）、SPU0410HR5H-PB（Knowles 官方库搜无结果）、W3062A（Pulse→YAGEO 迁移断链）。
   2026-11-03 我方另自取到 **FAN4174 现行合册 Rev 4**（旧单只路径已被撤；首页给 3.7 MHz 带宽 @5 V）
   与 **RXM-GPS 的 TE 原件**（DDEController 只认浏览器会话）⇒ GPS 与基带运放两条已可升到原件级。
2. **PCB 改版本身不难，但"2.6→2.6.1 只差 R164"这句已作废**：至少 R6、R14 也是同批改动（§2.1），
   另有 **11 个位号板文件与 BOM 直接冲突**（findings §7.3），必须先用 M3 实测定口径。
   真正的硬约束仍是**两颗断供器件的封装不可替换**；任何替代方案都按"重新设计"评估。
3. 制造侧三个口径（锡膏母片、丝印字体、设计规则）在改版时必须重新对账，不能沿用本板的数值。

### 2.1b 第三来源：2016-07-25 的原理图 PDF（2026-11-04 补，11 个冲突位号里有 10 个被它判了）

`Hardware/PSDR Schematic.pdf`（10 页，PDF 创建 **2016-07-25**，PADS 打印）**有文本层**，用 `pypdf` 能逐字读。
把 11 个"板文件 vs BOM"冲突位号逐个查出来对照：

| 位号 | `PSDR.asc`（布局） | 2.6.1 BOM | **原理图 PDF** | 谁跟谁一致 |
|---|---|---|---|---|
| R6 | 100R | 180R | **180R** | 原理图 = BOM |
| R14 | 100R | 68R | **68R** | 原理图 = BOM |
| R68 / R69 / R75 / R76 | 1k0 | 0R | **0R** | 原理图 = BOM |
| R72 / R79 | 1k0 | DNS | **DNS** | 原理图 = BOM |
| R113 | 383K | 402K | **402K** | 原理图 = BOM |
| R268 | 1k0 | 100R | **100R** | 原理图 = BOM |
| **R164** | **270K** | 240K | **270K** | **原理图 = 布局（BOM 是孤票）** |

⇒ **10 个位号是"原理图 + BOM 两票对布局一票"——布局文件（`.asc` 的 `PART Value`）是少数派**；
只有 **R164** 反过来：布局 + 原理图都是 270K，只有 BOM 写 240K。
而时间序是：**原理图 07-25 → BOM 07-31（2.6.1 下单前改的）**，所以 R164 的 240K 是"最后改的"，
两份设计文件都没跟着改——它仍然只能靠实测定（`+5V_BOOST` 那边若有分压，量一下就知道）。

**口径不变**：这三票都不是测量。`docs/PSDR-bringup-checklist.md` 的实测项一条不减；
但**引用时优先引用多数票**，R164 要两个值都写并注明"BOM 最新、两份设计文件未跟上"。

### 2.1c 全量三方扫描：**除那 11 个，没有新的值冲突**（2026-11-04）

上面 §2.1b 只看了 11 个怀疑位号。这轮把**全部 339 行**都过了一遍（原理图 PDF 文本层 × `.asc` × 2.6.1 BOM），
产物落 `Hardware/BOMs/PSDR_2.6.1/value_threeway_sch_asc_bom.csv`（每行带 `status`）：

| status | 行数 | 含义 |
|---|---|---|
| `agree` | 253 | 三票一致（`1k0`/`1K`、`10u0`/`10u` 这类记法差异已归一，不算冲突） |
| `no-sch-value` | 58 | 机械/连接器之类本来就没有值 |
| `sch-is-part-type` | 11 | 原理图那一行显示的是**型号**（如 U241→`SI5338`），不是值 |
| **`layout-alone`** | **10** | BOM + 原理图一致、**布局文件是少数派**：R6/R14/R68/R69/R72/R75/R76/R79/R113/R268 |
| **`bom-alone`** | **1** | **只有 R164**：布局 270K + 原理图 270K，只有 BOM 写 240K |
| `conflict` | 5 | **全是解析假象**：D44 取到了脚号"1"，U241/U253/U260/U314 取到的是型号 |
| `all-differ` | 1 | L34：`asc` 空、BOM `10u`、原理图显示型号——就是已知的"只在 BOM 里"那一行 |

⇒ **全板值冲突就是那 11 个，一个不多**。这条把"板子上的信息"收口了：
以后引用任何阻容值，先看这份 CSV 的 `status`；`layout-alone` 的 10 个按多数票写 BOM 值、
`bom-alone` 的 R164 两值都写。**但这仍然不是测量**——实测定值的清单不变。

### 补记（2026-11-04）：HMC1023 逐脚对手册完成

详见 `docs/PSDR-HMC1023-pinmap-check.md`。三条结论：① **pin 28 VDDBG 是唯一真正的供电缺口**——板上只挂了去耦电容 `C292`，没有任何电源馈入（手册要求 5 V 供电）；② **Q 通道被自环**：`OIN/OIP` 经 `C293`/`C294` 直接回到 `IQN/IQP`，双通道器件板上只用了一半；③ **pin 29（VBG）悬空是符合手册的**（testing only），此前把它当异常的口径已改。
