fe1iscurc0r/PSDR/delegation/PROMPT-recheck-taskC.md

# 重委派提示词 · TASK_C 剩余 32 行（2026-11-04 版，值已随包给出）

用法：把下面"提示词正文"整段贴给执行方，并**附上本仓的 `delegation/TASK_C_ic_context_all.md`**
（95,082 B，sha256 `082109173e5ff76510ddfde673f60b49439e4cbcdf98775be5cb8f16327112f0`）。
这份包与上一轮执行方拿到的**不是同一份**：上一轮的 59 个散文件已作废（重做后改成合并文件，
`delegation/MANIFEST.csv` 重哈希过），不要拿旧文件重答。

写这份提示词的原因（我方侧，不必贴给执行方）：上一轮有 32 行判"信息不足"，
根因经复核是**我们的包没给元件值**（`Hardware/PSDR.asc` 的 `PART … { Value … }` 一直在），
不是执行方偷懒。现在值已在每行以 `=VALUE` 形式给出，冲突值标 `=VALUE CONTESTED`，
未连接的脚也补进了 IC 表。剩下的确实是纯体力：按手册公式逐行算。

---

## 提示词正文（从这里开始贴）

你在替一个开源 HF SDR 项目（PortableSDR / PSDR 2.6.1）做**器件级参数核对**。
你没有仓库，所有需要的板上数据都在附件 `TASK_C_ic_context_all.md` 里。

### 输入文件是什么

* 附件是**一块真实 PCB 的网表**，从 PADS Layout ASCII 源文件 `Hardware/PSDR.asc` 机读导出，
  不是画出来的原理图。每个 section 一只器件，表头四列：
  `pin | pin name | net | other pins on the same net (refdes(part_type).pin)`。
* 坐标/单位这类信息这轮用不到；`$$$…` 开头的 net 名是 PADS 里的**未命名导线**，
  表示一个电气节点，本身没有含义，不要试图解读。
* 邻居写法如 `C13(CAP_2603=100n).1`：**括号里是这只件的类型与该位的值**。
  值有两种标注：`=VALUE` 是板文件与 BOM 一致；
  `=VALUE CONTESTED: BOM 0R, board file 1k0` 表示**两个来源不一致**，
  这种情况下**两个值都要算一遍**并把结果并排给出，不许挑一个当准。
* 有的 pin 在表里根本没有行 ⇒ 那只件的该脚在板上**未连接**（不是数据缺失），照此判断即可。

### 要答哪些行（只答这些，其余不碰）

上一轮判定"信息不足"的 32 行，按器件分组列出。每组只回答该组列出的问题：

1. **U314 AD8302**（6 行）：VMAG(13) 传递函数、VMAG 斜率修正、VPHS(9) 传递函数、
   OFSA(3)/OFSB(5) 偏置补偿、MFLT(14)/PFLT(8) 输出滤波、VPOS(4) 供电。
2. **U114 AP3417C**（2 行 + 1 行共网）：FB(5) 输出电压设定、VIN(4) 输入电容、
   以及 U314/U114 共用的 `V_SUPPLY` 轨。
3. **U189 SSM2167**（3 行）：CMPRS_RTIO(8) RCOMP、GATE_THRS(7) RGATE、OUTPUT(9) 输出隔直。
4. **U199 TPA0253**（3 行）：RIN(5)/LIN(9) 增益设定、VDD(3) 供电、输出功率 vs 供电与负载。
5. **U16/U24/U30 MASWSS0129TR**（2 行）：V1(3)/V2(7) 控制电平；**U30 的 ANT2(6) RF 口**
   （上一轮我们的表缺了这一行，这一版已补，请重答）。
6. **U37 SN74LVC1G3157**（2 行）：A–B 通路 rON、S(6) 控制极性（Function Table 需要原页核对）。
7. **U253 AD8131**（1 行）：+DIN(8)/−DIN(1) 端接电阻取值。
8. **U304 HMC482ST89 / SXB-2089Z**（1 行）：经 RFOUT/BIAS 注入的**偏置电压**是多少（用板上值算）。
9. **U287 HMC1023LP5E**（1 行）：CALCK(11) 校准时钟频率与占空比要求，结合板上时钟源实际值。
10. **U185 RXM-GPS-RM-T**（1 行）：VCC(12) 供电电压（经 Q126 MOSFET 开关，用板上值定）。
11. **U58/U131/U216/U47 FAN4174**（1 行）：电源/输出摆幅/滤波接法
    （注意：现行文档是 **FAN4174/FAN4274 合册 Rev 4**，旧的单只 PDF 路径已消失）。
12. **U255/U272 MCP6N11**、**U161 MCP73871**、**U15 MAX5388**、**U4/U18 MAX4525CUB+**、
    **U32 SPU0410HR5H-PB**、**U211/U298 SN74CBTLV3253**、**U279/U280 SY10EP52V**、
    **L41/L81 ADE-2ASK**：各 1 行，见附件对应 section 里写明的"Question (only this one)"。

### 硬性出处规则（违反即视为未答）

1. 每个结论必须带：**手册文件名 + 修订号 + 页码或表号 + 一句英文原文摘录**。
   没有这四样就写 `信息不足` 并说明缺什么，**不要用"典型值/常识/通常"补**。
2. **只接受厂商原始 PDF 或厂商官网页面**。不要引用论坛帖、第三方商城参数表、AI 汇编。
3. 计算过程要写出来：公式（带原文出处）→ 代入的板上值（注明来自附件哪一行）→ 结果与单位。
   只给结果不给代入过程的行，我们只能退回重算。
4. 遇到 `=VALUE CONTESTED` 的元件：**两个值各算一遍**，并写清结果差多少、
   这个差别会不会改变"能/不能工作"的结论。不要替我们选值。
5. 涉及电压轨（`V_SUPPLY`、`+3V3_CPU`、`+5V_BOOST` 等）时，如果附件里能由分压电阻算出轨压，
   就写"算得 X V（由 R_a/R_b 与反馈电压 Y 推得）"；**算不出来就写"板上无依据"**，
   不要引用外部项目（mcHF/UHSDR 等）的电压当本板事实。
6. 不猜测器件型号。附件 section 标题写的是板上封装名，可能与真实采购件不同
   （已知 U304 名为 `HMC482ST89`、BOM 买的是 `SXB-2089Z`）；
   标题下有 `Premise check` 行，**如果你判断器件对不上，停下并报告矛盾，不要接着算**。

### 输出格式

一张 Markdown 表，列固定为：

`器件 | 引脚/话题 | 手册公式或判据（含页/表 + 英文原文摘录） | 板上代入值（含来源行） | 结果 | 判定 | 出处强度`

* `判定` 取值：`一致` / `不一致（差 X）` / `信息不足（缺 Y）` / `前提矛盾，未答`。
* `出处强度` 取值：`原厂PDF` / `官网页面` / `镜像文本` / `无`。
* 表后再加一节"本轮新拿到的手册直链清单"（文件名 + URL + 你看到的修订号），
  以及一节"你认为我们必须上板才能定的项"，每项写要量什么、判据是什么。
* 报告用中文或英文都行，**但英文原文摘录必须保持原样不译**。

### 如果你没法上传附件

附件 95 KB，可以分段贴。按 section 标题（`## U314 — …` 这种 `---` 分隔的块）切，
每段贴 5–8 只器件，保留每段开头的口径说明行。不要只贴问题不贴网络表——
没有 pin/net 数据你就算不出轨压。

## （贴到这里结束）

---

## 我方验收方式（写给未来的我们，不给执行方）

答案回来后按 `docs/PSDR-external-findings-2026-11-03.md` §0 的验收法办：
先机器对行（行数、器件名、`Premise check` 有没有被忽略），再抽 3–5 行
用我们自己下的原厂 PDF 复算（sha256 对得上才把强度从 `镜像` 升 `原厂PDF`），
落档进 `docs/`。凡"信息不足"的行必须在文档里写明是**我们缺数据**还是**外部拿不到手册**。
