fe1iscurc0r/PSDR/docs/PSDR-external-findings-2026-11-03.md

# 外部执行方回传资料核实（2026-11-03）

派出去的两批机械活回来了：委派输入包（`delegation/`）的答案，以及竞品调研。
本文只做四件事：**来源与验收 → 推翻/修正了什么 → 补上了什么 → 还缺什么**。
证据分四级：`原厂PDF(自核)` > `原厂PDF(对方sha256，我方复算一致)` > `原厂PDF(对方单方)` > `镜像/〔线索〕`。
凡外部断言，未升级到此表第二级以上，**不进任何对外文本**。

## 0. 来源与验收

KB《落日parad的知识库》→ `psdr` 文件夹，回传 6 份（其余 59 份是我们自己上传的输入件）：

| 文件 | 字节 | 内容 | 验收结果 |
|---|---|---|---|
| `PortableSDR261_器件资料核实报告.md` | 28,929 | 12 组器件的手册原文核实 + 5 处前提矛盾 | 关键 3 条已由我方复算（见 §1.2/§1.3/§2.1） |
| `PortableSDR261_任务C_公式核对表.md` | 20,096 | 55 行"手册公式 × 板上值 → 判定" | **49/55 行与本地上下文逐位号对账通过**，6 行为工具正则误报（把公式里的 R1/R2、封装码 NR6028、`10U0` 当位号）或跨件合计行 |
| `PortableSDR261_任务E_官方数据手册直链.md` | 8,156 | 20 份官方 PDF 直链 + 双下载 sha256；7 份未闭环 | **我方独立复算 3 份：AD8302 / SY10EP52V / SN74CB3Q3253 三个 sha256 逐字节相同** |
| `bom_rows_PSDR261.csv` | 8,169 | 86 行 BOM，补 vendor/mpn/octopart_url | 未复算（下节 §3 排产） |
| `开源SDR竞品调研_13项目对比表.md` | 11,067 | 13 个开源/商用 HF SDR 对比 | 可用，含 4 个名字查无实据的如实报告 |
| `开源SDR硬件调研_PSDR261对照.md` | 13,578 | 架构/芯片/性能/原理图直链 | 可用，直接喂 rev-B |

### 0.1 上传错位实锤（他们替我们抓出来的）

KB 里那 59 份输入件的**文件名与正文整体错位 4 位**（按位号字典序）。我方直接复现：

```
KB 的 U114.md 正文位号 = L39      本地 U114.md = U114
KB 的 U121.md 正文位号 = L41      本地 U121.md = U121
KB 的 U37.md  正文位号 = U30      本地 U37.md  = U37
KB 的 U85.md  正文位号 = U24      本地 U85.md  = U85
```

他们没被带错：`<file>` 列一律取**正文头位号**，并在文末写明"消费方如按文件名取数会整表错位"。
所以答案可按位号直接消费，**但缺了 U58 / U85 / U86 三只的板上侧**（那三份当时真没传到位），
`parts_census.csv` 的真身也缺（同名件正文是 U47 上下文）。
⇒ 这正是 `3a98072` 把包改成"3 个合并文件 + MANIFEST"要消灭的失败模式；本轮验证了它确实会失败。

## 1. 推翻或修正了我们的哪些说法

| # | 我们文档里的说法 | 新证据 | 出处与级别 | 要动的文档 |
|---|---|---|---|---|
| 1.1 | "SXB-2089 是 50–850 MHz"（`alternates §2.1`、`gaps #3`） | **错配**：50–850 MHz 是 **SBB2089Z**；板上实购 **SXB2089Z = 5–2500 MHz 中功率放大**，SOT-89，测试条件 `Vs=8V, RBIAS=20Ω, VDEVICE=5.2V, ID=120/135/150 mA` | DS110610 首页标题与电气表〔对方引；Qorvo 产品页已 404，PDF 未取得 ⇒ `镜像`级〕 | `PSDR-alternates-proposal.md §2.1`、`PSDR-open-data-gaps.md #3`、记忆里的"三只候选全 50 MHz 起步" |
| 1.1b | "停产本身不能由仓库数据证明" | 现在有了 **PCN 19-0122，EOL 2019-07-18，LTB 2020-01-29，官方替代 TQP7M9101** | 同上（Qorvo 页缓存文本，`镜像`级，待原厂） | `README.fork.md` 的"不声称 obsolete"表述**可升级但先不升**，等 PDF |
| 1.1c | "换料前必须核输入脚是否允许直流" | **不允许**：`1 RF IN … requires the use of an external DC blocking capacitor`（SXB 与 SBB 两份手册同文）；板上 C13=100N 正是这只隔直电容（值见 §3） | 同上 | `PSDR-scope-and-cost.md §8.2`、rev-B 工作单 |
| 1.2 | "2× SY10EP52V 交叉耦合成正交 ÷2" | **器件身份错**：SY10EP52V 与 BOM 实购的 **MC10EP52DTG 都是"Differential Data and Clock D Flip-Flop"**，不是 ÷2；÷2 是 EP32V。**AC 表只有 `Maximum Frequency = 4 GHz Typical`，无任何最低输入频率行** | `原厂PDF(自核)`——我方自取 onsemi MC10EP52 数据手册（409,316 B，sha256 `c5e8a5cf…`），pdftotext 抽出正文确认 | `PSDR-firmware-survey.md §2.0` 架构图、`gaps #9`（这条**可结案**：问题本身是假问题） |
| 1.2b | 同上（推论层） | ÷2 只能靠 `Q̄→D` 的通用接法成立，**官方手册没有 quadrature/÷2 应用电路**（EP52V 手册仅 7 页、无应用章节）⇒ "正交由分频器保证"这句话要降级为"由接线推断，未获手册背书" | 同上 | survey §2.0、HMC1023 文档、对外措辞 |
| 1.3 | "滤波选择用 74CBTLV3253" | netlist 的 `part_type` 是 CBTLV3253，**BOM 实购是 SN74CB3Q3253DBQR（CB3Q 三供电系列）**——真值表/Ron/Cio 与 CBTLV 不同；两份手册都取了 | `原厂PDF(对方sha256，我方复算一致)`（CB3Q 1,380,608 B / `96d6c387…`；CBTLV 2,660,016 B / `d6fb46fe…` 我方复算相同） | `PSDR-HMC1023-netlist.md`、rev-B 控制线表、贴装/BOM 口径 |
| 1.4 | "三片 DPDT 开关控制脚由 MCU 直驱"（对） | 补上判据：MASWSS0129 是 **DPDT**，控制脚 **VC1/VC2**（原件脚名；板上网表记作 `V1/V2`），真值表只有 `10/01` 两态导通 ⇒ **必须互补驱动**；`1 = +2.9…+5 V`、压差 ≥2.7 V ⇒ 3.3 V GPIO 够用（余量按**计算值**收紧：AP3417C 原厂 600 mV + 板上分压 ⇒ 算得 2.90/3.01 V，尚未电测，见 §8.2 第 3 条） | Rev V6 原文〔macom 官网已不托管这份 PDF ⇒ `镜像`级，不作对外证据〕 | survey P1-4（极性注释）、#16 观测项、rev-B 控制表 |
| 1.5 | gaps #10 "WBC2-1TL 0.2–500 MHz" | 带宽/插损对；但 **"DC imbalance" 是引脚直流不平衡电流 8.5 mA**，不是幅度/相位不平衡度——术语要改，否则会被读成巴伦不平衡指标 | `原厂PDF(对方)`（Coilcraft 424-1） | `gaps #10` |
| 1.6 | scope §5 的 GPS 降本路线 | **RXM-GPS-RM-T 不是 u-blox**，是 Linx（现 TE）RM 系列，核心 MediaTek MT3337E；跟踪灵敏度 −161 dBm、冷启 −143 dBm、1PPS ±11 ns、跟踪 12 mA/待机 135 µA；**W3062A 是 Pulse 无源陶瓷贴片天线（RHCP 0 dBic / 线极化峰值 2.5 dBi）**，不是有源模块自带天线 | Linx Data Guide 2016-10-06〔当时记 `镜像`；同日稍后我方从 TE 的 DDEController 取到真 PDF（`43d49463…`，27 页，Revised 10/6/2016）⇒ 已升 `原件`，见 §8.1；**同一行的 W3062A 那半条不跟着升**——它至今取不到原件，仍是对方给的经销商级〕 | `PSDR-scope-and-cost.md §5`、M3 的"GPS 四指标比较"实测项 |
| 1.7 | survey P1-3 只写了"ISR 里跑 FFT" | ST 勘误 ES0290 Rev 7 **§2.2.1 "Missed ADC triggers from TIM1/TIM8, TIM2/TIM5/TIM4/TIM6/TRGO"**（Status A，有 workaround：EXTEN/JEXTEN=0x11 双边沿触发，或使能 DAC 时钟）。我们的采样链正是 TIM4 + ADC/DMA ⇒ 这是一条**必须评估的既有硬件缺陷**，不是代码问题 | `原厂PDF(对方)`（ES0290 Rev 7，2019-07-18） | survey 缺陷清单新增一条 P1；bringup 检查表加一条测点 |
| 1.8 | survey 里写过"I2C2 BSY 勘误" | **BSY 条目属 SPI 从机**，不属 I2C；旧版 DocID027162 Rev 3 把它编在 I2C 小节下（历史编排错误）——引用时别再说"I2C2 BSY" | `原厂PDF(对方)` | survey/相关对外措辞 |

## 2. 补上的缺口

### 2.1 HMC1023LP5E（U287）——#16 的低通半边基本可以结案为"资料够了，缺的是硬件与代码"

* 寄存器：`00h` Chip_ID/软复位、`01h` Enable（cal_enable / filter_I/Q_enable / force_cal_code / doubler_enable / LSB_Zinput_select）、`02h` Settings（opamp_bias、drvr_bias、gain_10dB、bypass_filter、coarse_bandwidth_code[3:0]）、`03h` fine_bandwidth_code、`04h` 写任意位即启动校准、`05h` Clk Period（**皮秒**计数，"1/40 MHz clock = 25000ps"）、`06h` Measure Adjust。
* 截止档（`02h[9:6]`）：`0000=5 MHz, 0001=7, 0010=10, 0011=14, 0100=20, 0101=28, 0110=40, 0111=50, 1000=72`；`03h` 再给 12 档细调（须 `force_cal_code=1`）；整机 3 dB 截止 **5–72 MHz 可编程，校准后 ±2.5%**。
* CALCK（pin 11）：doubler 关 `40<f<80 MHz`，doubler 开 `20<f<40 MHz`，**占空比 50%±10%**；特性栏写"20–80 MHz 任意参考时钟"。板上 CALCK 经 C283 接 Si5338——**C283 现值 100n（`.asc` 解出，见 §3）**，时钟频点仍须固件/实测确认。
* `VDDBG(28) = Bias 5V Supply，必须本地去耦`（板上只有 C292=100n 到地、无供电 ⇒ 我们的"硬件缺口"结论保持）；`VBG(29) = 1.2V 带隙输出，仅供测试`（悬空正确，**且网表实测 U287 缺 pin 29 的行，与"未接"一致**——这是我方独立复算的交叉验证）。

### 2.2 AD8302（U314，VNA 的核心）

* 式 8a `VMAG = RF·ISLP·log(VINA/VINB) + VCP`（30 mV/dB，中心 900 mV，0–1.8 V ↔ −30…+30 dB）；式 9 `VPHS = −RF·IΦ(|ΔΦ| − 90°) + VCP`（10 mV/°，1.8 V↔0°）；式 11/12 仅控制器模式适用。
* 斜率修正 `NEW SLOPE = 30 mV/dB × (1 + R1/(R2‖20 kΩ))` —— 板上 **R313=R312=0R**（见 §3）⇒ 系数为 1，**默认 30 mV/dB、±30 dB 未修正**。
* 输入：`AC 耦合 −60…0 dBm`，绝对最大 `INPA/INPB −3 dBV ≈ +10 dBm` ⇒ **VNA 满注入功率的硬上限有手册依据了**（此前"校准面/动态范围"只能挂硬件待测）。

### 2.3 Si5338（U241）——版本差会把我们带偏

* 输出能力按档：A/D/G/K/N ≤710 MHz，B/E/H/L/P ≤350 MHz，C/F/J/M/Q ≤200 MHz；**"Si5338DN" 作为完整订货号未证实**。
* **版本差异关键**：旧版手册写"any frequency between 5 to 350 MHz"，**Rev 1.6 改成 0.16 MHz 起**（LVPECL/LVDS 0.16–710、HCSL 0.16–250、CMOS 0.16–200、SSTL 0.16–350）。我们引用的"5–350 MHz"是**旧版口径**。
* MultiSynth 硬约束：`5 … Fvco/8 MHz`，VCO 2.2–2.8 GHz；**同一 VCO 下只能有 Fvco/4 与 Fvco/6 两个高于 Fvco/8 的频率**，R0–R3 支持 1/2/4/8/16/32 且 R≠1 时该路相位对齐失效。
  ⇒ **待核（进 §4 队列）**：我们要"LO = 2×RX 且 I/Q 正交"，若两路正交频率都落在 >Fvco/8 区，是否撞上"只有两个频率"的限制？这决定固件与改版时钟方案，不能靠猜。
* I2C：`tSU:DAT 250/150 ns`、`tHD:DAT 100/100 ns`、总线超时 25/35 ms；**"I2C 总线电压 <2.5 V 必须写 reg 27[7]=1"** —— 我们 `+3V3_CPU` 供电，此条不触发，但值得写进固件注释需求（不改码，只进文档）。
* 官方寄存器生成路径是 ClockBuilder Pro；手册**没有**"常见 PCLK 推荐值表"。

### 2.4 总线开关（U211/U298）

* CBTLV3253 真值表：`OE=L` 时 `S1:S0 = LL/LH/HL/HH → B1/B2/B3/B4`，`OE=H` 全断。
* Ron：VCC=3 V、VI=0、II=64 mA ⇒ 5/7 Ω typ/max；VI=2.4 V、II=15 mA ⇒ 10/15 Ω。**Cio(OFF)：A 口 20.5 pF、B 口 5.5 pF**。
* **手册不给隔离度/串扰随频率的规格**（"isolation" 只指断电隔离）⇒ 想做 HF 带通切换的"隔离度"必须实测，不能引手册。

## 3. 还"信息不足"的，根因在我们这个包

他们的表里大量判定落在"值未知/信息不足"，直接原因是 **`RES_0603`/`CAP_0603` 这类通用名不带值，而我们的包没把值带上**。
但值其实就在 `Hardware/PSDR.asc` 的 `PART <refdes> { Value … }` 块里——**是我们生成器没取**。
本地实测：274 个 PART 块、266 个有非空 Value；他们标"值未知"的 56 个位号里 **53 个可直接解出**。

| 关键位号（本地 `.asc` 解出） | 值 | 立刻能判的事 |
|---|---|---|
| R310 / R311 / R312 / R313 | **0R** | AD8302 斜率/相位修正电阻是跳线 ⇒ 默认 30 mV/dB、10 mV/°，量程 ±30 dB / 0–180° 未改 |
| C307 / C320 | **OPEN**（不装） | MFLT/PFLT **没有外接电容** ⇒ 手册"至少 1 pF"未满足，T 只由内部 1.5 pF 定 ⇒ 新的疑点，进 bringup 检查表 |
| R190 / R187 | 15K / 5K | SSM2167 压缩比 = 2:1（Table 4）、门限 = −55 dBV（Table 5，且 ">5 kΩ 不推荐"正好压线） |
| R112 / R113 | 100K / 383K | AP3417C 输出分压可算（须先定上/下臂归属，从上下文 FB 网络判） |
| R204 / R194 | 12K1 / 12K1 | TPA0253 增益 = 125 kΩ/RI（BTL）≈ 10.3 V/V，可核 |
| C13 / C283 / C292 / C186 / C33 | 100N / 100n / 100n / 2p2 / 100N | 隔直与校准时钟耦合、GPS 天线匹配电容都有值了 |
| L11 / L19 / L109 / L84 | 220µH（由封装名 `SRN4018-221M`）/ 2.2µH / 4.7µH | 增益块偏置馈电与两路 DC-DC 电感核对齐 |
| R6 | **100R** | ⚠️ 与我们文档里写的"R6 180Ω"不一致 ⇒ 待复核（见 §4-3） |
| R164 | **270K** | ⚠️ 与"BOM 记 2.6→2.6.1 把 R164 从 270K 改 240K"这条对不上 ⇒ 板文件与 BOM 谁为准，待核 |

另有三项**必须我方补数据再让他们跑**：`U58(FAN4174)`/`U85(ADP1613)`/`U86(MAX4525)` 的上下文（他们有手册、我们缺板上值；ADP1613 的 `VOUT = 1.235×(1+R1/R2)` 与电感 4.7–22 µH 已到手，只差板上分压）、`parts_census.csv` 真身、以及**未连接脚要显式写出来**：网表实测 **U30 只有 12 个脚有网络，pin 6（ANT2）完全悬空**（U16/U24 的 pin 6 都接在 `$$$15380`/`$$$16065`）——这条对我们反而是好消息：**改版时 U30 有一路空余掷位**，不用加开关就能多接一组带通。

## 4. 待办队列（按谁能推动分开）

**A. 我方立刻能算/能改（不需要外部）**
1. `tools/make_delegation_pack.py`：把 `PART` 块的 `Value`/`Comment` 注入每个 IC 的上下文表；给每只器件补"**未连接脚**"显式行；补 `parts_census` 与 U58/U85/U86 的合并段。
2. 用他们给的手册公式 + 上面的值，**我方自己重算判定列**（AD8302 / SSM2167 / TPA0253 / AP3417C / ADP1613 / MASWSS 控制电平），产出 `任务C v2`。
3. 复核两处 `Value` 与 BOM 的矛盾：**R6**（`.asc` 100R vs 我们文档 180Ω）、**R164**（`.asc` 270K vs BOM 240K）；读 `.xls` 要用能吃 BIFF 的方法，别再拿 strings 猜。
4. survey 缺陷清单加一条：ES0290 §2.2.1 ADC 触发丢失（TIM4 在列）；`gaps #9` 结案（D 触发器、无 fmin 规格行）。

**B. 需要别的出口取件（对方 7 项里，我方已补 2 项）**
- 我方已自取并复算一致：`MC10EP52`（onsemi，新件，409,316 B / `c5e8a5cf…`）、`SN74CB3Q3253`、`AD8302`、`SY10EP52V`、`SN74CBTLV3253`。
- 仍缺：`MASWSS0129`（原厂 CDN 上本件 404、同路径兄弟件 200，curl 与浏览器两种客户端一致）、`SXB-2089Z`（Qorvo 站点检索不到；**我方出口直连得 429 限流，不是 404**，见 §7.3-3）、`FAN4174`（onsemi 我方也被挡：`-L` 只回 HTML）、`ADE-2ASK`（Mini-Circuits 我方 403，**对方已取到 REV. H**，可请他们把 PDF 传回来）、`RXM-GPS-RM-T`（TE 只给查看器 HTML）、`SPU0410HR5H-PB`（Knowles 404）、`W3062A`（Pulse→YAGEO 断链）。
- 1.1 / 1.4 / 1.6 三条结论**在拿到原厂 PDF 前保持在 `镜像` 级**，不进 #16/#19 的对外文本。

**C. 需要你点头才做的对外动作**
1. **#16 更正**：我们已公开说过 U304 的带宽口径；若按 1.1 改（SXB 5–2500 MHz 而非 50–850），是一次自我更正——**建议等 B 组原厂 PDF 到位再动**，现在动等于用镜像改公开记录。
2. **UHSDR 已实现 HMC1023 驱动**（`df8oe/UHSDR` commit `c447c2e4`，ovi40h7 分支，含手动细校准）：#16 的"固件里零引用 HMC1023"因此有了**可引用的开源参考实现**。放进 #16/#19 是"给线索、不代做"，符合只征求意见的形态 ⇒ 需要你点头。
3. PR #17/#18 不因此轮内容改动（BOM 数值矛盾若坐实，属新单元格变更，需单独走一次批准）。

**D. 进 rev-B 工作单的输入（本轮新增）**
* 分波段前端有了**可抄的实测元件表**：(tr)uSDX `Main+RF Boards with Notes v1.0n`（逐波段 C/L 匝数表）、uSDX Sandwich 组装手册（Class-E 扼流圈 50 µH≈12T FT37-43）、WB2CBA LPF 分立值、QCX+ 手册逐波段 BOM、mcHF 的 7 阶 LC BPF × 4 继电器重叠波段 + 锁存继电器（**继电器误切风险他们已写出：震动会误切**）、Hermes-Lite 2 的 N2ADR 滤波板（KiCad+Gerber 公开、630 V NP0 1206 建议）。
* 性能基线：mcHF −126 dBm/300Hz、TRX SDR Eagle −132 dBm、TX-500 −136 dBm（BDR 129 dB）、uSDX 5.8–9.4 W / 76–93% 效率实测。
* **U30 pin 6 空余掷位**（§3）+ **CBTLV/CB3Q 实购不一致**（§1.3）两条直接改控制线表。

## 5. 两份答案之间的矛盾点（不放过）

1. `任务E` 说 MASWSS0129 / SXB-2089Z 官方 PDF **未找到**，而 `核实报告` §1/§6 把它们当"手册原文"引用并注明本地留存 `datasheets/` ⇒ 要么留存件是镜像（则降级），要么 E 的检索漏了。**必须让他们指明实际取到的是哪个 URL**，否则 1.1/1.4 不能升级。
2. 同理 SY10EP52V：E 已取到 Micrel 原厂 PDF（sha256 我方可复算✓），报告 §12 却把它列为"仅 HTML 镜像"——这条以 E 为准（我方已复算），报告 §12 的局限性陈述偏保守。
3. 答案 schema：他们用的是 **7 工作列 + 末列 `<file>:<row>`**；`3a98072` 的包规范写的是 **前导 anchor + 7 列**。两者语义等价但列序不同 ⇒ 校验脚本要**两种都接受**（按列名而非位置），并把这一条写进 README，别再让下一批执行方猜。

## 6. 落库与回滚

* 本文与 `docs/WO-psdr-takeover.md` §K-8 是本轮唯一新增/改动的仓库文件；`delegation/`、`tools/`、`Source*/`、`dist/` 均未改。
* 下载的原文与答案副本在仓外：`C:\Users\ASUS\AppData\Local\Temp\psdr_answers\`（6 份答案）、`psdr_kb_copies\`（错位复现样本）、`mc10ep52.pdf/txt`、`ad8302.pdf`、`sy10ep52v.pdf`、`cbtlv3253.pdf`、`cb3q3253.pdf`；工作脚本在 `D:\my git\_psdr_answers_local\`（`partvals.cjs` 值解码、`check_taskC.cjs` 对账）。要长期留档的只有本文与 PDF 的 sha256。
* 回滚：删本文 + 撤销 §K-8 那段即可；未改任何既有文档。

## 7. "信息不足"的消解（2026-11-03 同日第二轮，我方自算）

上一节把根因指出来了：**包里没有值**。这一节把它解决掉，并把因此落"信息不足"的行重算。

### 7.1 做法与账目

三方对账工具 `tools/bom_refdes_crosscheck.py`：`Hardware/PSDR.asc` 的 `PART <位号> { Value }` 块
× 两份 BOM 的分组位号行（展开 `C3,10,13,238-240`、`R97,-99` 这类写法）× EIA 记数归一
（`1K0`=`1k`、`12K1`=12.1 k、`2P2`=2.2 p），输出 `Hardware/BOMs/PSDR_2.6.1/BOM_refdes_crosscheck.csv`。

```
$ python tools/bom_refdes_crosscheck.py
designators joined : 339
asc == 2.6.1 BOM   : 255
asc != 2.6.1 BOM   : 11
value only in asc  : 0   only in BOM: 1   neither: 72
```

两份 BOM 的 `.xls` 用 office-excel 导入器展平成 CSV 入库（`PSDR2.6_BOM_flat.csv` /
`PSDR2.6.1_BOM_flat.csv`，文件头写了源 BIFF 版本 `2357da76…` / `1c032a2c…` 以便复算），
以后不必再依赖二进制 .xls。⚠️ 展平用的是**已修正版**的 2.6.1 表（`next` 里带 PR #18 的单元格改动，
源 BIFF `1c032a2c…`）；上游未修版（`45acd0f5`，39,424 B，BIFF `020f17df…`）另存仓外，
§7.3-1 的"表内重复行自相矛盾"就是从那份未修版读出来的。重跑对账时请认准前者、复核结论时看后者。

包本身改了三点（`tools/make_delegation_pack.py`，已重生成 `delegation/`）：

1. 每个邻位带值：`C13(CAP_0603=100n).1`，TASK_C 里 **336 处**；
2. 值冲突显式标出：`R68(RES_0603=VALUE CONTESTED: BOM 0R, board file 1k0).1`，**56 处**，
   并写明"两个都报、不许挑一个"；
3. 未连接的脚单独成行：`| 6 | - | *no net in the board file (pad exists, nothing connected)* |`，
   共 **26 行**——这正是他们报"表缺一行"的那类问题，根因在包不在板。

### 7.2 重算出来的判定（公式来自对方引的手册原文；值来自板文件/BOM）

| 位号 | 原判定 | 现在 | 依据 |
|---|---|---|---|
| U114 AP3417C | 信息不足（R112/R113 值未编码） | **输出被设为 ≈3.0 V，不是 3.3 V**：上臂 R113（`+3V3_CPU`→FB）、下臂 R112=100K（FB→GND），`VOUT=0.6×(1+R_top/R_bot)` ⇒ 板文件 383K 得 **2.898 V**，BOM 402K 得 **3.012 V**；手册 Table 1 给 3.3 V 用的是 450K/100K | 网络实测 `R113.1=+3V3_CPU`、`R112.2=GND`；VFB=0.6 V 已升为原件级：Diodes DS36516 Rev 3-3 我方自取，sha256 与对方一致，首页原文 "Feedback Voltage: 600mV"、3.3 V 档 450K/100K |
| ↳ 连带 | GPIO 3.3 V 驱动 MASWSS 的余量 | 若该轨实际是 3.0 V，则开关控制脚 `1 = +2.9…+5 V` 的**余量只有约 0.1 V**，不是 0.4 V | 上一条 + 对方引 MASWSS0129 注 7/8 |
| U85 ADP1613 | 信息不足（缺 U85 上下文） | **VOUT = 4.94 V**：上臂 R90=30K（`+5V_BOOST`→FB）、下臂 R92=10K（FB→GND），`1.235×(1+30/10)`；电感 L84=4.7 µH ∈ 手册 4.7–22 µH；`FREQ` 脚接 GND ⇒ 650 kHz；`SS`=C91=33n | 网络实测 + 对方引 ADP1612/1613 Rev. A 式 1 |
| U314 AD8302 | 信息不足（R312/R313 值未编码） | **斜率未做任何修正**：R310/R311/R312/R313 全 = 0R ⇒ `(1 + R1/(R2‖20k))` 系数为 1 ⇒ 30 mV/dB、±30 dB、中心 900 mV、相位 10 mV/°；R319=0R ⇒ VPOS 直送 +3V3 | 板文件 `PART R3xx Value 0R`；公式为对方引 AD8302 Rev. B 式 8a/9 与 p.18 |
| U314 MFLT/PFLT | 信息不足（C320/C307 值未知） | **两脚没有任何外接电容**：C320/C307 的板文件值 OPEN、2.6.1 BOM 也写 OPEN 且备注 "DNP by design - the footprints are still on the board" ⇒ 手册"建议外接 ≥1 pF"未被满足，滤波时间只由内部 1.5 pF 决定（`T(ns)=3.3×CAVE` ⇒ ≈5 ns） | 三方一致（.asc=BOM）；公式为对方引 AD8302 式 7 后 |
| U189 SSM2167 | 信息不足（R190/R187 值未编码） | **压缩比 2:1**（R190=15K，正是手册 Table 4 的 2:1 档）、**门限 −55 dBV**（R187=5K，Table 5 的 −55 dBV 档，且手册写 ">5 kΩ 不推荐"——刚好压线） | 板文件值 + 对方引 SSM2167 Rev. G Table 4/5 |
| U199 TPA0253 | 信息不足（增益算不出、负载未知） | RI 两侧都 = **12K1** ⇒ 增益 SE **5.17 V/V**、BTL **10.33 V/V**（手册原文 `62.5 kΩ/RI`、`125 kΩ/RI`）；模式不是固定的：**ST/MN 经 R144=100K 接到 `\EARPHONE_INSERTED`**（与耳机插座检测脚、U121.58 同网）⇒ 插耳机切 SE 立体声、拔出 BTL 单声，是设计里的运行时切换 | 板文件值 + 网络实测；公式与我们**自取的 TI 原厂 PDF**（SLOS280D，sha256 `668fed94…` 与对方一致，`pdftotext` 抽原文核对 pin7 描述与增益句） |
| U30 MASWSS0129 | 信息不足（pin 6 未出现在表） | 包补上事实行：**pin 6（ANT2）在板文件里没有任何网络**（U16/U24 的 pin 6 分别在 `$$$15380`/`$$$16065`）⇒ 这只开关有一掷位空着，改版可直接用 | `dist/netlist` 实测 + decal 端子表 1..13 |
| U287 HMC1023 | 一致（VBG 悬空） | 交叉验证通过：**U287 唯一无网络的端子就是 pin 29**（其余 32 个端子含散热盘都有网络） | decal `T` 记录 33 端子 − 网表 32 脚 |
| U287 CALCK / VDDBG | 信息不足（时钟频率未知） | 耦合电容有值了：C283=100n（`FILTER_CAL`↔Si5338 侧）、C292=100n（VDDBG→GND，**只有去耦、没有供电**）；**校准频率仍判"信息不足"，但原因换成"固件里没有写，且我们不改固件"** | 板文件值 + 网络实测 |
| U304 偏置 | 信息不足（偏置电压未给出） | 馈电网络补齐：L11/L19 = 220 µH（`SRN4018-221M`）、R6 = **板文件 100R / 2.6.1 BOM 180R（冲突）**；SXB/SBB 手册测试条件是 `RBIAS=20Ω`——**这颗件的偏置电阻取值本身是 #16 的候选变量** | 板文件 vs 2.6.1 BOM 冲突表 |

### 7.3 剩下真正做不了的，以及为什么

1. **11 处板文件与 BOM 冲突**（`R6, R14, R113, R164, R68, R69, R72, R75, R76, R79, R268`）。
   ⚠️ **R6/R14 的真相比"版本改动"更硬，本条第一版写轻了，现按未修改的上游原件改正**：
   把 `45acd0f5` 那份**上游原始 2.6.1 BOM**展平后实测——项 41（`item_no. 41`，电子表格第 45 行）仍是
   `R6,14,268`（Qty **1**、`P100GCT-ND`、100R），而项 42/43（第 46/47 行）又单列
   `R14`=`68R`(`RHM68DCT-ND`)、`R6`=`180R`(`RHM180DCT-ND`)。
   ⇒ **同一份 2.6.1 BOM 内部就把 R6 同时写成 100R 和 180R、R14 同时写成 100R 和 68R**：
   2.6.1 改过值，却把旧的合并行留在了表里。PR #18 把该行改成只列 `R268`，消的是这个**自相矛盾**，
   不只是"位号写法统一"。版本 delta 另外仍然成立：2.6 那份只有 `R6,14,268`=100R（Qty 3）一行、无单列 R6/R14
   ⇒ 2.6→2.6.1 实际改了三处（`R164` 270K→240K、`R6` 100R→180R、`R14` 100R→68R），而板文件三处都停在 2.6 值。
   **2026-11-04 再补一层机械检查**（两份未修文件各 43 行 `ref_des` 含逗号）：按"列出的位号数 == `qty_per_unit`"这条
   表自订约定，违约的只有 2.6 的第 5/54 行与 2.6.1 的第 5/45/56 行，其中第 5 行是排针的网络名（`-,+,CLK,IO,NRST`）不算组
   ⇒ **剩下的正是 PR #18 改的那两处**，这是 #18 的独立机械依据（先前只有人工比对）；
   已随 #16 的自我更正评论对外给出（`#issuecomment-6623233867`）。
   余下：`R113` 两份 BOM 都 402K、板文件 383K；`R68/69/75/76` BOM 0R、板文件 1k0
   （**同一合并行里的 R310-313/R319 板文件也是 0R** ⇒ 不是分组笔误）；`R72/R79` BOM DNS、板文件 1k0（不装则值无意义）。
   ⇒ 谁能定：**只有作者或实测**（都是 0603，可电测），已按可测项写进 §7.4；在此之前引用它们必须两个值都写。
2. **"2.6→2.6.1 实质差异只有 R164"这句作废**，作废理由分两层：delta 有三处；
   而 2.6.1 表内还有**重复行自相矛盾**（见上一条）。这条已回写 `PSDR-open-data-gaps.md` §2.1。
3. **还缺原件的手册**：MASWSS0129（**原厂 CDN 已不托管这份文档**：`cdn.macom.com/datasheets/MASWSS0143.pdf`、
   `MASWSS0202.pdf` 我连测两次都 200，同路径的 `MASWSS0129.pdf` 两次都 404 ⇒ 只写"文档取不到"，
   **不写成官方停产断言**）、SXB-2089Z、SPU0410HR5H-PB、W3062A。
   ⚠️ **SXB-2089Z 这条我先前写成"Qorvo 撤档"，证据其实没这么强**：今日我方直连
   `https://www.qorvo.com/products/p/SXB-2089Z` 得到的是 **429（限流）不是 404**（2026-11-04 各连测两次皆 429），
   "产品页 404 / 站内搜索 0 结果"来自另一条抓取路径的浏览器会话 ⇒ 准确说法是
   **"Qorvo 站点检索不到该件、我方出口被限流，DS110610 目前只有镜像文本"**。
   已解决：FAN4174（改取现行合册 FAN4174/FAN4274 **Rev 4**，旧单只路径确已消失）、RXM-GPS-RM-T（TE 原件到手）、
   ADE-2ASK（REV. H，1–1000 MHz 与 LO +7 dBm 见首页）。
4. **需要另一次委派**的：把 §7.2 之外仍判"信息不足"的行按新包重问一遍（值现在给了，
   公式他们已抄过，剩下是纯体力）。

### 7.4 变成 M3 实测量（一次性清掉 §7.3-1）

`docs/PSDR-bringup-checklist.md` 应补一节"板文件与 BOM 冲突的 11 个电阻"，每条写：
位号、两个候选值、封装 0603、判定方法（电阻档直接量，或在板上无供电时量）、
以及**结论落哪**（若等于 BOM ⇒ 板文件过期，一切按 BOM；若等于板文件 ⇒ BOM 过期，PR #18 的口径要重议）。
其中 **U114 的输出轨**（预期 2.90 V 或 3.01 V，不是 3.3 V）与 **U85 的 +5V_BOOST**（预期 4.94 V）
是同一批测点里最值钱的两条：前者决定三只射频开关的控制电平余量，后者决定增益块能不能到手册条件。

## 8. 原件补齐结果与对外动作（同日 22:35 之后）

### 8.1 原厂 PDF：我方独立复算累计 7 份

| 器件 | 结果 | sha256 与对方一致？ | 由此确立的事实 |
|---|---|---|---|
| AD8302 Rev. B | 取到 | **是**（`cd52c37a…`） | 式 8a/9、±30 dB、绝对最大 `+10 dBm` |
| SY10EP52V Rev F | 取到 | **是**（`3096ce68…`） | D 触发器，AC 表无 fmin |
| SN74CBTLV3253 SCDS039K | 取到 | **是**（`d6fb46fe…`） | 真值表、Ron、Cio(OFF) |
| SN74CB3Q3253 SCDS145D | 取到 | **是**（`96d6c387…`） | 实购件的替代证据（板上到底是哪只需 BOM/M3 定） |
| TPA0253 SLOS280D | 取到 | **是**（`668fed94…`） | `ST/MN` 拉低=BTL、拉高=SE；增益 `62.5k/RI`、`125k/RI` |
| AP3417C DS36516 Rev 3-3 | 取到 | **是**（`bdd08bbc…`） | `Feedback Voltage: 600mV`；3.3 V 档是 450K/100K ⇒ 板上算得 2.90/3.01 V |
| ADE-2ASK REV. H | 取到 | **是**（`44a6c860…`） | 首页 "Level 7 (LO +7 dBm) **1 to 1000 MHz**" ⇒ 混频器上限 1 GHz，6 GHz 开关无意义的判断有原件了 |
| FAN4174 | 取到（**换文档**） | n/a | 旧 `fan4174-d.pdf` 路径已消失（真浏览器也 302→HTML）；现行是合册 **FAN4174/FAN4274 Rev 4**（`9c61c664…`），首页"3.7 MHz of bandwidth at 5 V" ⇒ 基带运放的带宽上限从此有据 |
| RXM-GPS-RM-T | 取到 | n/a | TE DDEController 只对浏览器会话给真 PDF（`43d49463…`，27 页，Revised 10/6/2016）⇒ GPS 那条"不是 u-blox"可升到原件级 |
| SXB-2089Z | **取不到** | — | Qorvo 站点检索不到该件 + **我方出口直连得 429 限流（2026-11-04 连测两次皆 429，不是 404）**、`rfmd.com` 旧路径 302 回首页、PCN 门户不可达、**Wayback 本机出口不可达** ⇒ §1.1 的 5–2500 MHz / PCN 19-0122 停在 `镜像` 级 |
| MASWSS0129 | 取不到 | — | 不是网络问题：同模式的 `cdn.macom.com/datasheets/MASWSS0143.pdf`、`MASWSS0202.pdf` 都 200，只有 0129 是 404。**2026-11-04 复测**（curl 带浏览器 UA，同一出口，各连测两次）⇒ 0143/0202 = 200、0129 = 404 复现。措辞边界：这只证明"原厂 CDN 已不托管这份文档"，**不等于**官方宣布该件停产 |
| SPU0410HR5H-PB / W3062A | 取不到 | — | Knowles 官方器件库搜"无结果"（站方 Incapsula）；Pulse→YAGEO 迁移断链，YAGEO 站无可达文档库 |

### 8.2 已执行的对外动作（用户 2026-11-03 批准"C 你更正一下、建议放进开源参考"；2026-11-04 批准 #18 回帖）

* **issue #16 追加一条更正评论**（`…/issues/16#issuecomment-6606601865`，15 条评论、经 REST 复算确认**只发出去一次**，
  MCP 那次 `-32602` 是响应外壳假错误）。内容三件事：
  1. **撤回我们自己上一轮的 "50-850 MHz" 归因**——那是 SBB2089Z 的数，板上买的是 SXB-2089Z，两个不同产品；
     同时**不把 5–2500 MHz 当成新结论**，因为 Qorvo 已撤档、我方拿不到原件，只标"镜像文本，待核"；
  2. 更正 "R6 (180R)"：180R 来自 2.6.1 BOM，板文件写 100R；并给出 11 个冲突位号与 R6/R14/R164 三处版本改动；
  3. **`+3V3_CPU` 可能只有 2.90/3.01 V**（AP3417C 原厂 600 mV + 板上分压），而开关控制高电平要 ≥ +2.9 V ⇒
     余量约 0.1 V，建议在任何一台整机上先量轨与开关脚——这条可能正好解释"开发板能用、量产板不行"。
  4. **开源参考按到文件级给出**：`mchf-eclipse/hardware/uhsdr_hmc1023.c`，commit `c447c2e4`
     （"Finalized the finalized HMC1023 driver :-)"，2018-10-21，作者 db4ple）——我用 GitHub API 自己核过；
     线程里 DM2NT 2021 年只给过整棵 `hardware/` 目录的链接，没到文件与 commit。
* **PR #18 追加一条回帖**（用户 2026-11-04 批准；`…/pull/18#issuecomment-6622367887`，2,823 字符，HTTP 201，
  前后计数 1→2 且本方账号名下只有 1 条 ⇒ 只发出去一次）。回答的是 Jeff 的问题
  "Are alternatives also suggested as part of this PR? Or is it only calling out what needs to be fixed?"：
  **这条 PR 是修，不是建议，且刻意不给替代件**；同时把 §K-11 自查出的两条口径写进去了
  （2.6.1 表内 R6/R14 各有两个值 ⇒ PR 消的是文件内部矛盾；"obsolete"不是随附数据能证明的）。
  全文要点与逐格清单在 `Hardware/BOMs/PSDR_2.6.1/BOM_changes_PR18.md`——**该文件只在 PR #18 的分支上**
  （`upstream-pr/bom-2.6.1-refdes-fix`，head `cb6dda0`，工作树 `D:/my git/PSDR-build-artifacts/bom_pr`），**`next` 里没有**。
* **#16 追加一条自我更正**（用户 2026-11-04 批准；`…/issues/16#issuecomment-6623233867`，2,353 字符，HTTP 201，
  前后计数 15→16、本方新增 1 条 ⇒ 只发出去一次）。补的是先前那条第 2 点的口径偏低：
  它写 "R6 100R to 180R and R14 100R to 68R change in the same direction"，把**表内矛盾**只说成了版本 delta。
  这次发出前把两份**未修改**的 .xls 又按单元格重读了一遍（2.6：41,472 B，BIFF `076a7098…`；2.6.1：39,424 B，`020f17df…`），
  新拿到三条硬事实：
  1. 2.6 的 `R6,14,268` 在表格第 45 行（`item_no. 41`），`qty_per_unit` = **3**、K45 = `100R`，
     2.6 里 R6/R14 **没有**自己的行；2.6.1 同一行 `qty_per_unit` 已改成 **1**，另加第 46 行 `R14`=68R、
     第 47 行 `R6`=180R ⇒ 这是**一次只做了一半的编辑**（数字改了、位号文本没删），比"版本 delta"准确；
  2. 按"位号数量 == qty_per_unit"这条文件自订约定机械遍历：**两份文件各有 43 行 `ref_des` 含逗号**，
     2.6.1 只有 3 行违约——第 5 行（`-,+,CLK,IO,NRST`，那是网络名不是位号，不算组）、第 45 行、第 56 行 `R97,-99`（Qty 3 只点 R97/R99）；
     2.6 只有 2 行违约——第 5 行与第 54 行（同为 `R97,-99`）。**两处非第 5 行的违约正好就是 PR #18 改的那两处**，
     这条约定检查因此是 #18 的独立机械依据（先前只有人工比对）；
  3. ⇒ 顺带把行号口径钉死：以后写 `R6,14,268` 一律写"表格第 45 行 / `item_no. 41`"，别只写"第 41 行"。
  #18 那条回帖已经把完整口径说对了，这条只补 #16 的历史记录，没有改口任何已发出的数字。
* 未做：没附新 PR、没改固件、没在 #19/#20 追加内容、没动上游任何分支、没新开 issue。
