fe1iscurc0r/PSDR/delegation/TASK_C_ic_context_all.md

# TASK C - external parts vs the datasheet formulas

One section per designator. Answer only the question in that section.
Identify your answer by the section heading, not by any file name.

---

## L39 — `BALUN_1-2_WBC2-1TL`

Question (only this one): Coilcraft WBC2-1TL (1:2): bandwidth, loss, imbalance, ratings

Premise check: this section assumes the part is **WBC2-1TL**; if the type in the heading does not match, stop and report the contradiction.

| pin | pin name | net | other pins on the same net (refdes(part_type).pin) |
|---|---|---|---|
| 1 | - | `FILTER_RF_N` | C36(CAP_0603=100n).1 |
| 2 | - | `HALF_VCC` | 1/2VCC(PAD_1MM).1 C301(CSM-X5R-47U-20P-6V3-0805=47u).1 C302(CAP_0603=100N).1 R130(RES_0603=100K).2 R140(RES_0603=100K).2 R221(RES_0603=100K).2 R222(RES_0603=100K).2 R232(RES_0603=100K).2 R234(RES_0603=100K).2 R254(RES_0603=1K).2 R266(RES_0603=1K).2 R299(RES_0603=10K).1 R300(RES_0603=10K).2 R52(RES_0603=100K).2 ...(共 22 脚) |
| 3 | - | `FILTER_RF_P` | C40(CAP_0603=100n).1 |
| 4 | - | `GND` | -(0.1"_1PIN).1 ANT/VNA-IN(SMA_BOARD_EDGE).2 ANT/VNA-IN(SMA_BOARD_EDGE).3 ANT/VNA-IN(SMA_BOARD_EDGE).4 ANT/VNA-IN(SMA_BOARD_EDGE).5 C10(CAP_0603=100N).2 C103(CAP_0805=10u).2 C104(CAP_0805=10u).2 C106(CAP_0805=10u).2 C107(CAP_0805=10u).2 C108(CAP_0805=10u).2 C110(CAP_0603=1U).2 C111(CAP_0603=100N).2 C115(CAP_0603=4U7).2 ...(共 260 脚) |
| 6 | - | `$$$16013` | C35(CAP_0603=100N).1 |
| 5 | - | *no net in the board file (pad exists, nothing connected)* | - |

Nets named `$$$...` are unnamed wires in PADS: one electrical node, no meaning.
Neighbours shown as `C13(CAP_0603=100n).1` carry the board-file value;
`=VALUE CONTESTED: BOM 0R, board file 1k0` means the two sources disagree.

---

## L41 — `MIXER_DIODE-RING_ADE-2ASK`

Question (only this one): ADE-2ASK diode-ring mixer: RF/LO/IF ranges, LO drive, isolation, conversion loss

Premise check: this section assumes the part is **ADE-2ASK**; if the type in the heading does not match, stop and report the contradiction.

| pin | pin name | net | other pins on the same net (refdes(part_type).pin) |
|---|---|---|---|
| 1 | - | `MIXER_LO2N` | C71(CAP_0603=100n).2 R72(RES_0603=VALUE CONTESTED: BOM DNS, board file 1k0).1 |
| 2 | - | `$$$9458` | U4(DPDT_ANALOG_MAX4525).2 |
| 3 | - | `$$$8723` | L82(BALUN_1-2_WBC2-1TL).1 |
| 4 | - | `GND` | -(0.1"_1PIN).1 ANT/VNA-IN(SMA_BOARD_EDGE).2 ANT/VNA-IN(SMA_BOARD_EDGE).3 ANT/VNA-IN(SMA_BOARD_EDGE).4 ANT/VNA-IN(SMA_BOARD_EDGE).5 C10(CAP_0603=100N).2 C103(CAP_0805=10u).2 C104(CAP_0805=10u).2 C106(CAP_0805=10u).2 C107(CAP_0805=10u).2 C108(CAP_0805=10u).2 C110(CAP_0603=1U).2 C111(CAP_0603=100N).2 C115(CAP_0603=4U7).2 ...(共 260 脚) |
| 5 | - | `$$$9448` | U4(DPDT_ANALOG_MAX4525).9 |
| 6 | - | `MIXER_LO2P` | C73(CAP_0603=100n).2 R72(RES_0603=VALUE CONTESTED: BOM DNS, board file 1k0).2 |

Nets named `$$$...` are unnamed wires in PADS: one electrical node, no meaning.
Neighbours shown as `C13(CAP_0603=100n).1` carry the board-file value;
`=VALUE CONTESTED: BOM 0R, board file 1k0` means the two sources disagree.

---

## L81 — `MIXER_DIODE-RING_ADE-2ASK`

Question (only this one): ADE-2ASK diode-ring mixer: RF/LO/IF ranges, LO drive, isolation, conversion loss

Premise check: this section assumes the part is **ADE-2ASK**; if the type in the heading does not match, stop and report the contradiction.

| pin | pin name | net | other pins on the same net (refdes(part_type).pin) |
|---|---|---|---|
| 1 | - | `MIXER_LO1N` | C78(CAP_0603=100n).2 R79(RES_0603=VALUE CONTESTED: BOM DNS, board file 1k0).1 |
| 2 | - | `$$$9489` | U18(DPDT_ANALOG_MAX4525).2 |
| 3 | - | `GND` | -(0.1"_1PIN).1 ANT/VNA-IN(SMA_BOARD_EDGE).2 ANT/VNA-IN(SMA_BOARD_EDGE).3 ANT/VNA-IN(SMA_BOARD_EDGE).4 ANT/VNA-IN(SMA_BOARD_EDGE).5 C10(CAP_0603=100N).2 C103(CAP_0805=10u).2 C104(CAP_0805=10u).2 C106(CAP_0805=10u).2 C107(CAP_0805=10u).2 C108(CAP_0805=10u).2 C110(CAP_0603=1U).2 C111(CAP_0603=100N).2 C115(CAP_0603=4U7).2 ...(共 260 脚) |
| 4 | - | `$$$8785` | L82(BALUN_1-2_WBC2-1TL).3 |
| 5 | - | `$$$9485` | U18(DPDT_ANALOG_MAX4525).9 |
| 6 | - | `MIXER_LO1P` | C80(CAP_0603=100n).2 R79(RES_0603=VALUE CONTESTED: BOM DNS, board file 1k0).2 |

Nets named `$$$...` are unnamed wires in PADS: one electrical node, no meaning.
Neighbours shown as `C13(CAP_0603=100n).1` carry the board-file value;
`=VALUE CONTESTED: BOM 0R, board file 1k0` means the two sources disagree.

---

## L82 — `BALUN_1-2_WBC2-1TL`

Question (only this one): Coilcraft WBC2-1TL (1:2): bandwidth, loss, imbalance, ratings

Premise check: this section assumes the part is **WBC2-1TL**; if the type in the heading does not match, stop and report the contradiction.

| pin | pin name | net | other pins on the same net (refdes(part_type).pin) |
|---|---|---|---|
| 1 | - | `$$$8723` | L41(MIXER_DIODE-RING_ADE-2ASK).3 |
| 2 | - | `GND` | -(0.1"_1PIN).1 ANT/VNA-IN(SMA_BOARD_EDGE).2 ANT/VNA-IN(SMA_BOARD_EDGE).3 ANT/VNA-IN(SMA_BOARD_EDGE).4 ANT/VNA-IN(SMA_BOARD_EDGE).5 C10(CAP_0603=100N).2 C103(CAP_0805=10u).2 C104(CAP_0805=10u).2 C106(CAP_0805=10u).2 C107(CAP_0805=10u).2 C108(CAP_0805=10u).2 C110(CAP_0603=1U).2 C111(CAP_0603=100N).2 C115(CAP_0603=4U7).2 ...(共 260 脚) |
| 3 | - | `$$$8785` | L81(MIXER_DIODE-RING_ADE-2ASK).4 |
| 4 | - | `FILTER_IF_P` | C210(CAP_0603=100n).1 |
| 6 | - | `FILTER_IF_N` | C209(CAP_0603=100n).1 |
| 5 | - | *no net in the board file (pad exists, nothing connected)* | - |

Nets named `$$$...` are unnamed wires in PADS: one electrical node, no meaning.
Neighbours shown as `C13(CAP_0603=100n).1` carry the board-file value;
`=VALUE CONTESTED: BOM 0R, board file 1k0` means the two sources disagree.

---

## U114 — `BUCK_REGULATOR_AP3417C`

Question (only this one): AP3417C buck regulator: feedback divider equation, inductor/frequency limits

Premise check: this section assumes the part is **AP3417C**; if the type in the heading does not match, stop and report the contradiction.

| pin | pin name | net | other pins on the same net (refdes(part_type).pin) |
|---|---|---|---|
| 1 | EN | `V_SUPPLY` | C115(CAP_0603=4U7).1 C160(CAP_0603=4u7).1 C163(CSM-X5R-22U-20P-10V-1210=220u).2 C83(CSM-X5R-10U0-10P-10V-0805=10u0).1 L84(IND_4.7UH_SMT_CDRH4D28CNP-4R7PC).1 U114(BUCK_REGULATOR_AP3417C).4 U161(BAT-MANAGE_MCP73871).1 U161(BAT-MANAGE_MCP73871).20 U85(BOOST_REG_ADP1613).6 VSPLY(PAD_1MM).1 |
| 2 | GND | `GND` | -(0.1"_1PIN).1 ANT/VNA-IN(SMA_BOARD_EDGE).2 ANT/VNA-IN(SMA_BOARD_EDGE).3 ANT/VNA-IN(SMA_BOARD_EDGE).4 ANT/VNA-IN(SMA_BOARD_EDGE).5 C10(CAP_0603=100N).2 C103(CAP_0805=10u).2 C104(CAP_0805=10u).2 C106(CAP_0805=10u).2 C107(CAP_0805=10u).2 C108(CAP_0805=10u).2 C110(CAP_0603=1U).2 C111(CAP_0603=100N).2 C115(CAP_0603=4U7).2 ...(共 260 脚) |
| 3 | LX | `$$$24779` | L109(2U2H_INDUCTOR_NR6028T2R2N).2 |
| 4 | VIN | `V_SUPPLY` | C115(CAP_0603=4U7).1 C160(CAP_0603=4u7).1 C163(CSM-X5R-22U-20P-10V-1210=220u).2 C83(CSM-X5R-10U0-10P-10V-0805=10u0).1 L84(IND_4.7UH_SMT_CDRH4D28CNP-4R7PC).1 U114(BUCK_REGULATOR_AP3417C).1 U161(BAT-MANAGE_MCP73871).1 U161(BAT-MANAGE_MCP73871).20 U85(BOOST_REG_ADP1613).6 VSPLY(PAD_1MM).1 |
| 5 | FB | `$$$24763` | R112(RES_0603=100K).1 R113(RES_0603=VALUE CONTESTED: BOM 402K, board file 383K).2 |

Nets named `$$$...` are unnamed wires in PADS: one electrical node, no meaning.
Neighbours shown as `C13(CAP_0603=100n).1` carry the board-file value;
`=VALUE CONTESTED: BOM 0R, board file 1k0` means the two sources disagree.

---

## U121 — `STM32F746_LQFP100`

Question (only this one): STM32F746VGT6: errata items for SPI+DMA, I2C2 BSY, ADC+DMA, TIM

Premise check: this section assumes the part is **STM32F746**; if the type in the heading does not match, stop and report the contradiction.

| pin | pin name | net | other pins on the same net (refdes(part_type).pin) |
|---|---|---|---|
| 1 | PE2_S4-SCK_* | `5V_REG_ENABLE` | U85(BOOST_REG_ADP1613).3 |
| 2 | PE3_* | `AMP_POWER` | R2(RES_0603=1k0).1 |
| 3 | PE4_S4-NSS_L-B0_* | `DAC_MUX` | U86(DPDT_ANALOG_MAX4525).6 |
| 4 | PE5_T9-1_S4-MISO_LG0_* | `GAIN_POT_NSS` | U15(DIGITAL_POT_MAX5388).5 |
| 5 | PE6_T9-2_S4-MOSI_L-G1_* | `AMP_SWITCH_B` | U16(RF_DPDT_MASWSS0129TR).7 |
| 6 | VBAT | `VBAT_BKP` | C173(CAP_0603=1U).1 U172(3V3_LDO_MCP1802).5 U185(GPS_MODULE_RXM-GPS-RM-T).11 |
| 7 | PC13_* | `LCD_LED` | R177(RES_0603=1k0).1 |
| 8 | OSC32-IN_P14_* | `$$$23765` | C180(CAP_0603=8P).2 Y183(CRYSTAL_SMT_32.768).2 |
| 9 | OSC32-OUT_PC15_* | `$$$23764` | C181(CAP_0603=8P).2 Y183(CRYSTAL_SMT_32.768).1 |
| 10 | VSS1 | `GND` | -(0.1"_1PIN).1 ANT/VNA-IN(SMA_BOARD_EDGE).2 ANT/VNA-IN(SMA_BOARD_EDGE).3 ANT/VNA-IN(SMA_BOARD_EDGE).4 ANT/VNA-IN(SMA_BOARD_EDGE).5 C10(CAP_0603=100N).2 C103(CAP_0805=10u).2 C104(CAP_0805=10u).2 C106(CAP_0805=10u).2 C107(CAP_0805=10u).2 C108(CAP_0805=10u).2 C110(CAP_0603=1U).2 C111(CAP_0603=100N).2 C115(CAP_0603=4U7).2 ...(共 260 脚) |
| 11 | VDD1 | `+3V3_CPU` | +(0.1"_1PIN).1 3V3D(PAD_1MM).1 BOOT(BUTTON_B3U-1000P-B).2 C10(CAP_0603=100N).1 C106(CAP_0805=10u).1 C107(CAP_0805=10u).1 C108(CAP_0805=10u).1 C118(CAP_0603=100N).1 C119(CAP_0603=100N).1 C120(CAP_0603=4U7).1 C123(CAP_0603=100N).1 C156(CAP_0805=10u).1 C157(CAP_0603=100N).1 C238(CAP_0603=100n).1 ...(共 49 脚) |
| 12 | OSC-IN_PH0_* | `$$$23763` | C184(CAP_0603=6P).2 Y182(CRYSTAL3225).3 |
| 13 | OSC-OUT_PH1_* | `$$$23762` | C179(CAP_0603=6P).2 Y182(CRYSTAL3225).1 |
| 14 | NRST | `NRST` | C193(CAP_0603=100N).1 NRST(0.1"_1PIN).1 RST(BUTTON_B3U-1000P-B).1 |
| 15 | PC0_A123-10_* | `LIPO_V` | R174(RES_0603=100K).1 R175(RES_0603=100K).2 |
| 16 | PC1_A123-11_* | `IMP_BRIDGE_SWITCH_A` | U24(RF_DPDT_MASWSS0129TR).3 |
| 17 | PC2_S2-MISO_A123-12_* | `INAMP_ENABLE` | U255(MCP6N11).8 U272(MCP6N11).8 |
| 18 | PC3_S2-MOSI_A123-13_* | `TRX_SWITCH` | U18(DPDT_ANALOG_MAX4525).6 U4(DPDT_ANALOG_MAX4525).6 |
| 19 | VSSA | `GND` | -(0.1"_1PIN).1 ANT/VNA-IN(SMA_BOARD_EDGE).2 ANT/VNA-IN(SMA_BOARD_EDGE).3 ANT/VNA-IN(SMA_BOARD_EDGE).4 ANT/VNA-IN(SMA_BOARD_EDGE).5 C10(CAP_0603=100N).2 C103(CAP_0805=10u).2 C104(CAP_0805=10u).2 C106(CAP_0805=10u).2 C107(CAP_0805=10u).2 C108(CAP_0805=10u).2 C110(CAP_0603=1U).2 C111(CAP_0603=100N).2 C115(CAP_0603=4U7).2 ...(共 260 脚) |
| 20 | VREF+ | `$$$23767` | R117(RES_0603=0R0).2 |
| 21 | VDDA | `+3V3` | 3V3A(PAD_1MM).1 C103(CAP_0805=10u).1 C104(CAP_0805=10u).1 C110(CAP_0603=1U).1 C111(CAP_0603=100N).1 C135(CAP_0603=10N).1 C137(CAP_0603=6U8).1 C17(CAP_0603=100n).1 C191(CSM-X5R-10U0-10P-25V-0805=10u0).1 C212(CAP_0603=100n).1 C213(CAP_0603=1u0).1 C214(CAP_0603=6U8).1 C215(CAP_0603=10N).1 C225(CAP_0603=6U8).1 ...(共 57 脚) |
| 22 | PA0_WKUP_T2-1_T5-1_U4-TX_A123-0_* | `AMP_SWITCH_A` | U16(RF_DPDT_MASWSS0129TR).3 |
| 23 | PA1_T2-2_T5-2_U4-RX_A123-1_* | `BOOT1` | R116(RES_0603=10K).1 |
| 24 | PA2_T2-3_T5-3_T9-1_U2-TX_A123-2_* | `RX-Q_FILTERED` | C59(CAP_0603=100N).2 R63(RES_0603=100K).1 RXQ(PAD_1MM).1 |
| 25 | PA3_T2-4_T5-4_T9-2_U2-RX_L-B5_A123-3_* | `RX-I_FILTERED` | C48(CAP_0603=100N).2 R52(RES_0603=100K).1 RXI(PAD_1MM).1 |
| 26 | VSS2 | `GND` | -(0.1"_1PIN).1 ANT/VNA-IN(SMA_BOARD_EDGE).2 ANT/VNA-IN(SMA_BOARD_EDGE).3 ANT/VNA-IN(SMA_BOARD_EDGE).4 ANT/VNA-IN(SMA_BOARD_EDGE).5 C10(CAP_0603=100N).2 C103(CAP_0805=10u).2 C104(CAP_0805=10u).2 C106(CAP_0805=10u).2 C107(CAP_0805=10u).2 C108(CAP_0805=10u).2 C110(CAP_0603=1U).2 C111(CAP_0603=100N).2 C115(CAP_0603=4U7).2 ...(共 260 脚) |
| 27 | VDD3 | `+3V3_CPU` | +(0.1"_1PIN).1 3V3D(PAD_1MM).1 BOOT(BUTTON_B3U-1000P-B).2 C10(CAP_0603=100N).1 C106(CAP_0805=10u).1 C107(CAP_0805=10u).1 C108(CAP_0805=10u).1 C118(CAP_0603=100N).1 C119(CAP_0603=100N).1 C120(CAP_0603=4U7).1 C123(CAP_0603=100N).1 C156(CAP_0805=10u).1 C157(CAP_0603=100N).1 C238(CAP_0603=100n).1 ...(共 49 脚) |
| 28 | PA4_S1-NSS_S3-NSS_L-VSYNC_A12-4_D1_* | `DAC1` | U86(DPDT_ANALOG_MAX4525).2 |
| 29 | PA5_T2-1_S1-SCK_A12-5_D2_* | `DAC2` | U86(DPDT_ANALOG_MAX4525).9 |
| 30 | PA6_T3-1_S1-MISO_T13-1_L-G2_A12-6_* | `IMP_BRIDGE_SWITCH_B` | U24(RF_DPDT_MASWSS0129TR).7 |
| 31 | PA7_T3-2_S1-MOSI_A12-7_* | `TX_RF_SWITCH_B` | U30(RF_DPDT_MASWSS0129TR).7 |
| 32 | PC4_A12-14_* | `HALF_VCC` | 1/2VCC(PAD_1MM).1 C301(CSM-X5R-47U-20P-6V3-0805=47u).1 C302(CAP_0603=100N).1 L39(BALUN_1-2_WBC2-1TL).2 R130(RES_0603=100K).2 R140(RES_0603=100K).2 R221(RES_0603=100K).2 R222(RES_0603=100K).2 R232(RES_0603=100K).2 R234(RES_0603=100K).2 R254(RES_0603=1K).2 R266(RES_0603=1K).2 R299(RES_0603=10K).1 R300(RES_0603=10K).2 ...(共 22 脚) |
| 33 | PC5_A12-15_* | `PHASE` | PHSE(PAD_1MM).1 R310(RES_0603=0R).2 |
| 34 | PB0_T3-3_L-R3_A12-8_* | `MAGNITUDE` | MAG(PAD_1MM).1 R312(RES_0603=0R).2 |
| 35 | PB1_T3-4_L-R6_A12-9_* | `MIC_FILTER_OUT` | C129(CAP_0603=100N).2 MIC(PAD_1MM).1 R130(RES_0603=100K).1 |
| 36 | PB2_BOOT1_* | `TX_RF_SWITCH_A` | U30(RF_DPDT_MASWSS0129TR).3 |
| 37 | PE7_U7-RX_* | `GPS_PPS` | 1PPS(PAD_1MM).1 R202(RES_0603=1K).2 |
| 38 | PE8_U7-TX_* | `FLIP-FLOP_POWER` | R244(RES_0603=1K0).2 |
| 39 | PE9_T1-1_* | `F_SYNTH_CAL` | U241(SI5338).14 |
| 40 | PE10_* | `FILTER_S0` | U211(74CBTLV3253).14 U298(74CBTLV3253).14 |
| 41 | PE11_S4-NSS_L-G3_* | `LPF_POWER` | R206(RES_0603=1k0).2 |
| 42 | PE12_S4-SCK_L-B4_* | `LED_WHITE` | R97(RES_0603=255R).2 |
| 43 | PE13_T1-3_S4-MISO_LCD-DE_* | `LED_2` | R98(RES_0603=255R).2 |
| 44 | PE14_T1-4_S4-MOSI_LCD-CLK_* | `AUDIO_AMP_\SHDN` | U199(AUDIO_AMP_TPA0253DGQR).2 |
| 45 | PE15_L-R7_* | `LED_3` | R99(RES_0603=255R).2 |
| 46 | PB10_T2-3_I2-SCL_S2-SCK_U3-TX_L-G4_* | `I2C_SCL` | SCL(PAD_1MM).1 U241(SI5338).12 |
| 47 | PB11_T2-4_I2-SDA_U3-RX_L-G5_* | `I2C_SDA` | SDA(PAD_1MM).1 U241(SI5338).19 |
| 48 | VCAP1 | `$$$23766` | C95(CAP_0603=2U2).1 |
| 49 | VSS3 | `GND` | -(0.1"_1PIN).1 ANT/VNA-IN(SMA_BOARD_EDGE).2 ANT/VNA-IN(SMA_BOARD_EDGE).3 ANT/VNA-IN(SMA_BOARD_EDGE).4 ANT/VNA-IN(SMA_BOARD_EDGE).5 C10(CAP_0603=100N).2 C103(CAP_0805=10u).2 C104(CAP_0805=10u).2 C106(CAP_0805=10u).2 C107(CAP_0805=10u).2 C108(CAP_0805=10u).2 C110(CAP_0603=1U).2 C111(CAP_0603=100N).2 C115(CAP_0603=4U7).2 ...(共 260 脚) |
| 50 | VDD4 | `+3V3_CPU` | +(0.1"_1PIN).1 3V3D(PAD_1MM).1 BOOT(BUTTON_B3U-1000P-B).2 C10(CAP_0603=100N).1 C106(CAP_0805=10u).1 C107(CAP_0805=10u).1 C108(CAP_0805=10u).1 C118(CAP_0603=100N).1 C119(CAP_0603=100N).1 C120(CAP_0603=4U7).1 C123(CAP_0603=100N).1 C156(CAP_0805=10u).1 C157(CAP_0603=100N).1 C238(CAP_0603=100n).1 ...(共 49 脚) |
| 51 | PB12_I2-SMBA_S2-NSS_* | `FILTER_CS` | U287(VARIABLE_FILTER_HMC1023).15 |
| 52 | PB13_S2-SCK_* | `FILTER/GAIN_POT_CLK` | U15(DIGITAL_POT_MAX5388).7 U287(VARIABLE_FILTER_HMC1023).12 |
| 53 | PB14_S2-MISO_T12-1_* | `FILTER_MISO` | U287(VARIABLE_FILTER_HMC1023).13 |
| 54 | PB15_S2-MOSI_T12-2_* | `FILTER/GAIN_POT_MOSI` | U15(DIGITAL_POT_MAX5388).6 U287(VARIABLE_FILTER_HMC1023).14 |
| 55 | PD8_U3-TX_* | `FILTER_S1` | U211(74CBTLV3253).2 U298(74CBTLV3253).2 |
| 56 | PD9_U3-RX_* | `EXT_MIC_OUT` | EARPHONE(3.5MM_PHONO_4P_3SW_SJ-42617-SMT).4 U37(SPDT_ANALOG_SWITCH_SN74LVC1G3157).3 |
| 57 | PD10_L-B3_* | `MIC_SELECT` | U37(SPDT_ANALOG_SWITCH_SN74LVC1G3157).6 |
| 58 | PD11_* | `\EARPHONE_INSERTED` | EAR(PAD_1MM).1 EARPHONE(3.5MM_PHONO_4P_3SW_SJ-42617-SMT).11 R144(RES_0603=100K).1 R145(RES_0603=100K).2 |
| 59 | PD12_T4-1_* | `SIDETONE` | R198(RES_0603=12K1).1 |
| 60 | PD13_T4-2_* | `SD_CARD_DETECT` | MICROSD(MICROSD_DM3CS-SF).12 |
| 61 | PD14_T4-3_* | `PREAMP_SHTDWN` | U189(MIC_PREAMP_SSM2167).3 |
| 62 | PD15_T4-4_* | `GPS_RESET` | GPSR(PAD_1MM).1 U185(GPS_MODULE_RXM-GPS-RM-T).8 |
| 63 | PC6_T3-1_T8-1_U6-TX_L-HSYNC_* | `RX_TO_GPS` | GPSRX(PAD_1MM).1 R200(RES_0603=1K).2 |
| 64 | PC7_T3-2_T8-2_U6-RX_L-G6_* | `TX_FROM_GPS` | GPSTX(PAD_1MM).1 R201(RES_0603=1K).2 |
| 65 | PC8_T3-3_T8-3_* | `SDIO_DAT0` | MICROSD(MICROSD_DM3CS-SF).7 |
| 66 | PC9_T3-4_T8-4_I3-SDA_* | `SDIO_DAT1` | MICROSD(MICROSD_DM3CS-SF).8 |
| 67 | PA8_T1-1_I3-SCL_L-R6_* | `GPS_POWER` | R122(RES_0603=1k0).2 |
| 68 | PA9_T1-2_I3-SMBA_U1-TX_* | `USB_VBUS` | R169(RES_0603=0R0).2 |
| 69 | PA10_T1-3_U1-RX_* | `USB_ID` | USB(MICROUSB_H12192CT-ND).4 |
| 70 | PA11_T1-4_L-R4_* | `USB_D-` | R324(RES_0603=22R1).2 |
| 71 | PA12_L-R5_* | `USB_D+` | R325(RES_0603=22R1).2 |
| 72 | PA13_JTMS_SWDIO_* | `JTMS/SWDIO` | IO(0.1"_1PIN).1 |
| 73 | VCAP2 | `$$$23761` | C125(CAP_0603=2U2).1 |
| 74 | VSS4 | `GND` | -(0.1"_1PIN).1 ANT/VNA-IN(SMA_BOARD_EDGE).2 ANT/VNA-IN(SMA_BOARD_EDGE).3 ANT/VNA-IN(SMA_BOARD_EDGE).4 ANT/VNA-IN(SMA_BOARD_EDGE).5 C10(CAP_0603=100N).2 C103(CAP_0805=10u).2 C104(CAP_0805=10u).2 C106(CAP_0805=10u).2 C107(CAP_0805=10u).2 C108(CAP_0805=10u).2 C110(CAP_0603=1U).2 C111(CAP_0603=100N).2 C115(CAP_0603=4U7).2 ...(共 260 脚) |
| 75 | VDD5 | `+3V3_CPU` | +(0.1"_1PIN).1 3V3D(PAD_1MM).1 BOOT(BUTTON_B3U-1000P-B).2 C10(CAP_0603=100N).1 C106(CAP_0805=10u).1 C107(CAP_0805=10u).1 C108(CAP_0805=10u).1 C118(CAP_0603=100N).1 C119(CAP_0603=100N).1 C120(CAP_0603=4U7).1 C123(CAP_0603=100N).1 C156(CAP_0805=10u).1 C157(CAP_0603=100N).1 C238(CAP_0603=100n).1 ...(共 49 脚) |
| 76 | PA14_JTCK_SWCLK_* | `JTCK/SWCLK` | CLK(0.1"_1PIN).1 |
| 77 | PA15_JDI_T2-1_S1-NSS_S3-NSS_* | `LCD_CS` | J170(SPI_LCD_BOTTOM_ENTRY).3 |
| 78 | PC10_S3-SCK_U3-TX_U4-TX_L-R2_* | `SDIO_DAT2` | MICROSD(MICROSD_DM3CS-SF).1 |
| 79 | PC11_S3-MISO_U3-RX_U4-RX_* | `SDIO_DAT3` | MICROSD(MICROSD_DM3CS-SF).2 |
| 80 | PC12_S3-MOSI_U5-TX_* | `SDIO_CLK` | MICROSD(MICROSD_DM3CS-SF).5 |
| 81 | PD0_* | `POWER_GOOD` | U161(BAT-MANAGE_MCP73871).6 |
| 82 | PD1_* | `CHARGE_STATUS2` | U161(BAT-MANAGE_MCP73871).7 |
| 83 | PD2_U5-RX_* | `SDIO_CMD` | MICROSD(MICROSD_DM3CS-SF).3 |
| 84 | PD3_S2-SCK_LG7_* | `PADDLE_THUMB_NO` | CW1(MORSE_PADDLE_CONTACTS).2 |
| 85 | PD4_* | `LOW_BAT` | U161(BAT-MANAGE_MCP73871).8 |
| 86 | PD5_U2-TX_* | `PADDLE_THUMB_NC` | CW1(MORSE_PADDLE_CONTACTS).1 |
| 87 | PD6_S3-MOSI_U2-RX_L-B2_* | `PADDLE_INDEX_NC` | CW2(MORSE_PADDLE_CONTACTS).1 |
| 88 | PD7_* | `PADDLE_INDEX_NO` | CW2(MORSE_PADDLE_CONTACTS).2 |
| 89 | PB3_JTDO_TRACESWO_T2-2_S1-SCK_S3-SCK_* | `LCD_SCK` | J170(SPI_LCD_BOTTOM_ENTRY).7 |
| 90 | PB4_NJTRST_T3-1_S1-MISO_S3-MISO_* | `LCD_MISO` | J170(SPI_LCD_BOTTOM_ENTRY).9 |
| 91 | PB5_T3-2_I1-SMBA_S1-MOSI_S3-MOSI_* | `LCD_MOSI` | J170(SPI_LCD_BOTTOM_ENTRY).6 |
| 92 | PB6_T4-1_I1-SCL_U1-TX_* | `LCD_RESET` | J170(SPI_LCD_BOTTOM_ENTRY).4 |
| 93 | PB7_T4-2_I1-SDA_U1-RX_* | `LCD_DC/RS` | J170(SPI_LCD_BOTTOM_ENTRY).5 |
| 94 | BOOT0 | `BOOT0` | R127(RES_0603=10K).1 |
| 95 | PB8_T4-3_T10-1_I1-SCL_L-B6_* | `CHARGE_SOURCE` | U161(BAT-MANAGE_MCP73871).3 |
| 96 | PB9_T4-4_T11-1_I1-SDA_S2-NSS_L-B7_* | `ENC_SW` | J153(0.1"_6P_HEADER_DUAL_ENTRY_1241152-6).3 |
| 97 | PE0_U8-RX_* | `ENC_B` | J153(0.1"_6P_HEADER_DUAL_ENTRY_1241152-6).1 |
| 98 | PE1_U8-TX_* | `ENC_A` | J153(0.1"_6P_HEADER_DUAL_ENTRY_1241152-6).2 |
| 99 | VSS5 | `GND` | -(0.1"_1PIN).1 ANT/VNA-IN(SMA_BOARD_EDGE).2 ANT/VNA-IN(SMA_BOARD_EDGE).3 ANT/VNA-IN(SMA_BOARD_EDGE).4 ANT/VNA-IN(SMA_BOARD_EDGE).5 C10(CAP_0603=100N).2 C103(CAP_0805=10u).2 C104(CAP_0805=10u).2 C106(CAP_0805=10u).2 C107(CAP_0805=10u).2 C108(CAP_0805=10u).2 C110(CAP_0603=1U).2 C111(CAP_0603=100N).2 C115(CAP_0603=4U7).2 ...(共 260 脚) |
| 100 | VDD6 | `+3V3_CPU` | +(0.1"_1PIN).1 3V3D(PAD_1MM).1 BOOT(BUTTON_B3U-1000P-B).2 C10(CAP_0603=100N).1 C106(CAP_0805=10u).1 C107(CAP_0805=10u).1 C108(CAP_0805=10u).1 C118(CAP_0603=100N).1 C119(CAP_0603=100N).1 C120(CAP_0603=4U7).1 C123(CAP_0603=100N).1 C156(CAP_0805=10u).1 C157(CAP_0603=100N).1 C238(CAP_0603=100n).1 ...(共 49 脚) |

Nets named `$$$...` are unnamed wires in PADS: one electrical node, no meaning.
Neighbours shown as `C13(CAP_0603=100n).1` carry the board-file value;
`=VALUE CONTESTED: BOM 0R, board file 1k0` means the two sources disagree.

---

## U131 — `OP_AMP_FAN4174`

Question (only this one): FAN4174: supply range, output swing, used as filter/gain stage

Premise check: this section assumes the part is **FAN4174**; if the type in the heading does not match, stop and report the contradiction.

| pin | pin name | net | other pins on the same net (refdes(part_type).pin) |
|---|---|---|---|
| 1 | OUT | `$$$5711` | C129(CAP_0603=100N).1 C134(CAP_0603=1N).1 U131(OP_AMP_FAN4174).4 |
| 2 | -V | `GND` | -(0.1"_1PIN).1 ANT/VNA-IN(SMA_BOARD_EDGE).2 ANT/VNA-IN(SMA_BOARD_EDGE).3 ANT/VNA-IN(SMA_BOARD_EDGE).4 ANT/VNA-IN(SMA_BOARD_EDGE).5 C10(CAP_0603=100N).2 C103(CAP_0805=10u).2 C104(CAP_0805=10u).2 C106(CAP_0805=10u).2 C107(CAP_0805=10u).2 C108(CAP_0805=10u).2 C110(CAP_0603=1U).2 C111(CAP_0603=100N).2 C115(CAP_0603=4U7).2 ...(共 260 脚) |
| 3 | +IN | `$$$5502` | C132(CAP_0603=1N).1 R133(RES_0603=10K).2 |
| 4 | -IN | `$$$5711` | C129(CAP_0603=100N).1 C134(CAP_0603=1N).1 U131(OP_AMP_FAN4174).1 |
| 5 | +V | `+3V3` | 3V3A(PAD_1MM).1 C103(CAP_0805=10u).1 C104(CAP_0805=10u).1 C110(CAP_0603=1U).1 C111(CAP_0603=100N).1 C135(CAP_0603=10N).1 C137(CAP_0603=6U8).1 C17(CAP_0603=100n).1 C191(CSM-X5R-10U0-10P-25V-0805=10u0).1 C212(CAP_0603=100n).1 C213(CAP_0603=1u0).1 C214(CAP_0603=6U8).1 C215(CAP_0603=10N).1 C225(CAP_0603=6U8).1 ...(共 57 脚) |

Nets named `$$$...` are unnamed wires in PADS: one electrical node, no meaning.
Neighbours shown as `C13(CAP_0603=100n).1` carry the board-file value;
`=VALUE CONTESTED: BOM 0R, board file 1k0` means the two sources disagree.

---

## U15 — `DIGITAL_POT_MAX5388`

Question (only this one): MAX5388: gain-set connections LA/LB and the SPI address/opcode table

Premise check: this section assumes the part is **MAX5388**; if the type in the heading does not match, stop and report the contradiction.

| pin | pin name | net | other pins on the same net (refdes(part_type).pin) |
|---|---|---|---|
| 1 | GND | `GND` | -(0.1"_1PIN).1 ANT/VNA-IN(SMA_BOARD_EDGE).2 ANT/VNA-IN(SMA_BOARD_EDGE).3 ANT/VNA-IN(SMA_BOARD_EDGE).4 ANT/VNA-IN(SMA_BOARD_EDGE).5 C10(CAP_0603=100N).2 C103(CAP_0805=10u).2 C104(CAP_0805=10u).2 C106(CAP_0805=10u).2 C107(CAP_0805=10u).2 C108(CAP_0805=10u).2 C110(CAP_0603=1U).2 C111(CAP_0603=100N).2 C115(CAP_0603=4U7).2 ...(共 260 脚) |
| 2 | LB | `RX-Q_UFILTERED/OP_GAIN_B_L` | C60(CAP_0603=100N).1 U255(MCP6N11).6 |
| 4 | WB | `OP_GAIN_B_WP` | R254(RES_0603=1K).1 U255(MCP6N11).1 |
| 5 | \CS | `GAIN_POT_NSS` | U121(STM32F746_LQFP100).4 |
| 6 | DIN | `FILTER/GAIN_POT_MOSI` | U121(STM32F746_LQFP100).54 U287(VARIABLE_FILTER_HMC1023).14 |
| 7 | SCLK | `FILTER/GAIN_POT_CLK` | U121(STM32F746_LQFP100).52 U287(VARIABLE_FILTER_HMC1023).12 |
| 8 | VDD | `+3V3_CPU` | +(0.1"_1PIN).1 3V3D(PAD_1MM).1 BOOT(BUTTON_B3U-1000P-B).2 C10(CAP_0603=100N).1 C106(CAP_0805=10u).1 C107(CAP_0805=10u).1 C108(CAP_0805=10u).1 C118(CAP_0603=100N).1 C119(CAP_0603=100N).1 C120(CAP_0603=4U7).1 C123(CAP_0603=100N).1 C156(CAP_0805=10u).1 C157(CAP_0603=100N).1 C238(CAP_0603=100n).1 ...(共 49 脚) |
| 9 | WA | `OP_GAIN_A_WP` | R266(RES_0603=1K).1 U272(MCP6N11).1 |
| 10 | LA | `RX-I_UNFILTERED/OP_GAIN_A_L` | C49(CAP_0603=100N).1 U272(MCP6N11).6 |
| 3 | - | *no net in the board file (pad exists, nothing connected)* | - |

Nets named `$$$...` are unnamed wires in PADS: one electrical node, no meaning.
Neighbours shown as `C13(CAP_0603=100n).1` carry the board-file value;
`=VALUE CONTESTED: BOM 0R, board file 1k0` means the two sources disagree.

---

## U16 — `RF_DPDT_MASWSS0129TR`

Question (only this one): MASWSS0129TR: control truth table (V1/V2), IL/isolation/switching, lifecycle

Premise check: this section assumes the part is **MASWSS0129**; if the type in the heading does not match, stop and report the contradiction.

| pin | pin name | net | other pins on the same net (refdes(part_type).pin) |
|---|---|---|---|
| 1 | - | `GND` | -(0.1"_1PIN).1 ANT/VNA-IN(SMA_BOARD_EDGE).2 ANT/VNA-IN(SMA_BOARD_EDGE).3 ANT/VNA-IN(SMA_BOARD_EDGE).4 ANT/VNA-IN(SMA_BOARD_EDGE).5 C10(CAP_0603=100N).2 C103(CAP_0805=10u).2 C104(CAP_0805=10u).2 C106(CAP_0805=10u).2 C107(CAP_0805=10u).2 C108(CAP_0805=10u).2 C110(CAP_0603=1U).2 C111(CAP_0603=100N).2 C115(CAP_0603=4U7).2 ...(共 260 脚) |
| 2 | - | `GND` | -(0.1"_1PIN).1 ANT/VNA-IN(SMA_BOARD_EDGE).2 ANT/VNA-IN(SMA_BOARD_EDGE).3 ANT/VNA-IN(SMA_BOARD_EDGE).4 ANT/VNA-IN(SMA_BOARD_EDGE).5 C10(CAP_0603=100N).2 C103(CAP_0805=10u).2 C104(CAP_0805=10u).2 C106(CAP_0805=10u).2 C107(CAP_0805=10u).2 C108(CAP_0805=10u).2 C110(CAP_0603=1U).2 C111(CAP_0603=100N).2 C115(CAP_0603=4U7).2 ...(共 260 脚) |
| 3 | V1 | `AMP_SWITCH_A` | U121(STM32F746_LQFP100).22 |
| 4 | - | `$$$15378` | C305(CAP_0603=100N).1 |
| 5 | G1 | `GND` | -(0.1"_1PIN).1 ANT/VNA-IN(SMA_BOARD_EDGE).2 ANT/VNA-IN(SMA_BOARD_EDGE).3 ANT/VNA-IN(SMA_BOARD_EDGE).4 ANT/VNA-IN(SMA_BOARD_EDGE).5 C10(CAP_0603=100N).2 C103(CAP_0805=10u).2 C104(CAP_0805=10u).2 C106(CAP_0805=10u).2 C107(CAP_0805=10u).2 C108(CAP_0805=10u).2 C110(CAP_0603=1U).2 C111(CAP_0603=100N).2 C115(CAP_0603=4U7).2 ...(共 260 脚) |
| 6 | - | `$$$15380` | C21(CAP_0603=100N).1 |
| 7 | V2 | `AMP_SWITCH_B` | U121(STM32F746_LQFP100).5 |
| 8 | - | `GND` | -(0.1"_1PIN).1 ANT/VNA-IN(SMA_BOARD_EDGE).2 ANT/VNA-IN(SMA_BOARD_EDGE).3 ANT/VNA-IN(SMA_BOARD_EDGE).4 ANT/VNA-IN(SMA_BOARD_EDGE).5 C10(CAP_0603=100N).2 C103(CAP_0805=10u).2 C104(CAP_0805=10u).2 C106(CAP_0805=10u).2 C107(CAP_0805=10u).2 C108(CAP_0805=10u).2 C110(CAP_0603=1U).2 C111(CAP_0603=100N).2 C115(CAP_0603=4U7).2 ...(共 260 脚) |
| 9 | - | `GND` | -(0.1"_1PIN).1 ANT/VNA-IN(SMA_BOARD_EDGE).2 ANT/VNA-IN(SMA_BOARD_EDGE).3 ANT/VNA-IN(SMA_BOARD_EDGE).4 ANT/VNA-IN(SMA_BOARD_EDGE).5 C10(CAP_0603=100N).2 C103(CAP_0805=10u).2 C104(CAP_0805=10u).2 C106(CAP_0805=10u).2 C107(CAP_0805=10u).2 C108(CAP_0805=10u).2 C110(CAP_0603=1U).2 C111(CAP_0603=100N).2 C115(CAP_0603=4U7).2 ...(共 260 脚) |
| 10 | - | `$$$15375` | C303(CAP_0603=100N).2 |
| 11 | G2 | `GND` | -(0.1"_1PIN).1 ANT/VNA-IN(SMA_BOARD_EDGE).2 ANT/VNA-IN(SMA_BOARD_EDGE).3 ANT/VNA-IN(SMA_BOARD_EDGE).4 ANT/VNA-IN(SMA_BOARD_EDGE).5 C10(CAP_0603=100N).2 C103(CAP_0805=10u).2 C104(CAP_0805=10u).2 C106(CAP_0805=10u).2 C107(CAP_0805=10u).2 C108(CAP_0805=10u).2 C110(CAP_0603=1U).2 C111(CAP_0603=100N).2 C115(CAP_0603=4U7).2 ...(共 260 脚) |
| 12 | - | `$$$15374` | C13(CAP_0603=100N).1 |
| 13 | - | `GND` | -(0.1"_1PIN).1 ANT/VNA-IN(SMA_BOARD_EDGE).2 ANT/VNA-IN(SMA_BOARD_EDGE).3 ANT/VNA-IN(SMA_BOARD_EDGE).4 ANT/VNA-IN(SMA_BOARD_EDGE).5 C10(CAP_0603=100N).2 C103(CAP_0805=10u).2 C104(CAP_0805=10u).2 C106(CAP_0805=10u).2 C107(CAP_0805=10u).2 C108(CAP_0805=10u).2 C110(CAP_0603=1U).2 C111(CAP_0603=100N).2 C115(CAP_0603=4U7).2 ...(共 260 脚) |

Nets named `$$$...` are unnamed wires in PADS: one electrical node, no meaning.
Neighbours shown as `C13(CAP_0603=100n).1` carry the board-file value;
`=VALUE CONTESTED: BOM 0R, board file 1k0` means the two sources disagree.

---

## U161 — `BAT-MANAGE_MCP73871`

Question (only this one): MCP73871: charge current set, input/Power-Path limits, NTC requirements

Premise check: this section assumes the part is **MCP73871**; if the type in the heading does not match, stop and report the contradiction.

| pin | pin name | net | other pins on the same net (refdes(part_type).pin) |
|---|---|---|---|
| 1 | OUT1 | `V_SUPPLY` | C115(CAP_0603=4U7).1 C160(CAP_0603=4u7).1 C163(CSM-X5R-22U-20P-10V-1210=220u).2 C83(CSM-X5R-10U0-10P-10V-0805=10u0).1 L84(IND_4.7UH_SMT_CDRH4D28CNP-4R7PC).1 U114(BUCK_REGULATOR_AP3417C).1 U114(BUCK_REGULATOR_AP3417C).4 U161(BAT-MANAGE_MCP73871).20 U85(BOOST_REG_ADP1613).6 VSPLY(PAD_1MM).1 |
| 2 | VPCC | `$$$16399` | R164(RES_0603=VALUE CONTESTED: BOM 240K, board file 270K).1 R165(RES_0603=100K).2 |
| 3 | SEL | `CHARGE_SOURCE` | U121(STM32F746_LQFP100).95 |
| 4 | PROG2 | `+3V3_CPU` | +(0.1"_1PIN).1 3V3D(PAD_1MM).1 BOOT(BUTTON_B3U-1000P-B).2 C10(CAP_0603=100N).1 C106(CAP_0805=10u).1 C107(CAP_0805=10u).1 C108(CAP_0805=10u).1 C118(CAP_0603=100N).1 C119(CAP_0603=100N).1 C120(CAP_0603=4U7).1 C123(CAP_0603=100N).1 C156(CAP_0805=10u).1 C157(CAP_0603=100N).1 C238(CAP_0603=100n).1 ...(共 49 脚) |
| 5 | THERM | `$$$18814` | R168(RES_0603=10K NTC).2 |
| 6 | \PG | `POWER_GOOD` | U121(STM32F746_LQFP100).81 |
| 7 | STAT2 | `CHARGE_STATUS2` | U121(STM32F746_LQFP100).82 |
| 8 | STAT1/\LBO | `LOW_BAT` | U121(STM32F746_LQFP100).85 |
| 9 | \TE | `GND` | -(0.1"_1PIN).1 ANT/VNA-IN(SMA_BOARD_EDGE).2 ANT/VNA-IN(SMA_BOARD_EDGE).3 ANT/VNA-IN(SMA_BOARD_EDGE).4 ANT/VNA-IN(SMA_BOARD_EDGE).5 C10(CAP_0603=100N).2 C103(CAP_0805=10u).2 C104(CAP_0805=10u).2 C106(CAP_0805=10u).2 C107(CAP_0805=10u).2 C108(CAP_0805=10u).2 C110(CAP_0603=1U).2 C111(CAP_0603=100N).2 C115(CAP_0603=4U7).2 ...(共 260 脚) |
| 10 | VSS1 | `GND` | -(0.1"_1PIN).1 ANT/VNA-IN(SMA_BOARD_EDGE).2 ANT/VNA-IN(SMA_BOARD_EDGE).3 ANT/VNA-IN(SMA_BOARD_EDGE).4 ANT/VNA-IN(SMA_BOARD_EDGE).5 C10(CAP_0603=100N).2 C103(CAP_0805=10u).2 C104(CAP_0805=10u).2 C106(CAP_0805=10u).2 C107(CAP_0805=10u).2 C108(CAP_0805=10u).2 C110(CAP_0603=1U).2 C111(CAP_0603=100N).2 C115(CAP_0603=4U7).2 ...(共 260 脚) |
| 11 | VSS2 | `GND` | -(0.1"_1PIN).1 ANT/VNA-IN(SMA_BOARD_EDGE).2 ANT/VNA-IN(SMA_BOARD_EDGE).3 ANT/VNA-IN(SMA_BOARD_EDGE).4 ANT/VNA-IN(SMA_BOARD_EDGE).5 C10(CAP_0603=100N).2 C103(CAP_0805=10u).2 C104(CAP_0805=10u).2 C106(CAP_0805=10u).2 C107(CAP_0805=10u).2 C108(CAP_0805=10u).2 C110(CAP_0603=1U).2 C111(CAP_0603=100N).2 C115(CAP_0603=4U7).2 ...(共 260 脚) |
| 12 | PROG3 | `$$$19436` | R167(RES_0603=1K).2 |
| 13 | PROG1 | `$$$19175` | R162(RES_0603=1K).2 |
| 14 | VBAT1 | `LIPO` | C158(CSM-X5R-22U-20P-10V-1210=220u).1 C159(CAP_0603=4u7).1 C171(CAP_0603=1U).1 J153(0.1"_6P_HEADER_DUAL_ENTRY_1241152-6).4 LIPO(PAD_1MM).1 R174(RES_0603=100K).2 U161(BAT-MANAGE_MCP73871).15 U161(BAT-MANAGE_MCP73871).16 U172(3V3_LDO_MCP1802).1 U172(3V3_LDO_MCP1802).3 |
| 15 | VBAT2 | `LIPO` | C158(CSM-X5R-22U-20P-10V-1210=220u).1 C159(CAP_0603=4u7).1 C171(CAP_0603=1U).1 J153(0.1"_6P_HEADER_DUAL_ENTRY_1241152-6).4 LIPO(PAD_1MM).1 R174(RES_0603=100K).2 U161(BAT-MANAGE_MCP73871).14 U161(BAT-MANAGE_MCP73871).16 U172(3V3_LDO_MCP1802).1 U172(3V3_LDO_MCP1802).3 |
| 16 | BATSENSE | `LIPO` | C158(CSM-X5R-22U-20P-10V-1210=220u).1 C159(CAP_0603=4u7).1 C171(CAP_0603=1U).1 J153(0.1"_6P_HEADER_DUAL_ENTRY_1241152-6).4 LIPO(PAD_1MM).1 R174(RES_0603=100K).2 U161(BAT-MANAGE_MCP73871).14 U161(BAT-MANAGE_MCP73871).15 U172(3V3_LDO_MCP1802).1 U172(3V3_LDO_MCP1802).3 |
| 17 | CE | `+3V3_CPU` | +(0.1"_1PIN).1 3V3D(PAD_1MM).1 BOOT(BUTTON_B3U-1000P-B).2 C10(CAP_0603=100N).1 C106(CAP_0805=10u).1 C107(CAP_0805=10u).1 C108(CAP_0805=10u).1 C118(CAP_0603=100N).1 C119(CAP_0603=100N).1 C120(CAP_0603=4U7).1 C123(CAP_0603=100N).1 C156(CAP_0805=10u).1 C157(CAP_0603=100N).1 C238(CAP_0603=100n).1 ...(共 49 脚) |
| 18 | IN1 | `+5V` | C154(CSM-X5R-22U-20P-10V-1210=220u).1 C155(CSM-X5R-10U0-10P-25V-0805=10u0).2 C326(CSM-X5R-22U-20P-10V-1210=220u).2 L34(ISM-0805-10U=10u).1 R164(RES_0603=VALUE CONTESTED: BOM 240K, board file 270K).2 R169(RES_0603=0R0).1 U161(BAT-MANAGE_MCP73871).19 VUSB(PAD_1MM).1 |
| 19 | IN2 | `+5V` | C154(CSM-X5R-22U-20P-10V-1210=220u).1 C155(CSM-X5R-10U0-10P-25V-0805=10u0).2 C326(CSM-X5R-22U-20P-10V-1210=220u).2 L34(ISM-0805-10U=10u).1 R164(RES_0603=VALUE CONTESTED: BOM 240K, board file 270K).2 R169(RES_0603=0R0).1 U161(BAT-MANAGE_MCP73871).18 VUSB(PAD_1MM).1 |
| 20 | OUT2 | `V_SUPPLY` | C115(CAP_0603=4U7).1 C160(CAP_0603=4u7).1 C163(CSM-X5R-22U-20P-10V-1210=220u).2 C83(CSM-X5R-10U0-10P-10V-0805=10u0).1 L84(IND_4.7UH_SMT_CDRH4D28CNP-4R7PC).1 U114(BUCK_REGULATOR_AP3417C).1 U114(BUCK_REGULATOR_AP3417C).4 U161(BAT-MANAGE_MCP73871).1 U85(BOOST_REG_ADP1613).6 VSPLY(PAD_1MM).1 |
| 21 | - | `GND` | -(0.1"_1PIN).1 ANT/VNA-IN(SMA_BOARD_EDGE).2 ANT/VNA-IN(SMA_BOARD_EDGE).3 ANT/VNA-IN(SMA_BOARD_EDGE).4 ANT/VNA-IN(SMA_BOARD_EDGE).5 C10(CAP_0603=100N).2 C103(CAP_0805=10u).2 C104(CAP_0805=10u).2 C106(CAP_0805=10u).2 C107(CAP_0805=10u).2 C108(CAP_0805=10u).2 C110(CAP_0603=1U).2 C111(CAP_0603=100N).2 C115(CAP_0603=4U7).2 ...(共 260 脚) |

Nets named `$$$...` are unnamed wires in PADS: one electrical node, no meaning.
Neighbours shown as `C13(CAP_0603=100n).1` carry the board-file value;
`=VALUE CONTESTED: BOM 0R, board file 1k0` means the two sources disagree.

---

## U18 — `DPDT_ANALOG_MAX4525`

Question (only this one): MAX4525CUB+: supply range, Ron vs supply, off-capacitance, signal swing limits

Premise check: this section assumes the part is **MAX4525**; if the type in the heading does not match, stop and report the contradiction.

| pin | pin name | net | other pins on the same net (refdes(part_type).pin) |
|---|---|---|---|
| 1 | NOA | `TX-I_DRIVER_P` | C262(CAP_0603=22U).1 |
| 2 | COMA | `$$$9489` | L81(MIXER_DIODE-RING_ADE-2ASK).2 |
| 3 | NCA | `RX-I_INAMP_P` | U272(MCP6N11).3 |
| 4 | INH | `GND` | -(0.1"_1PIN).1 ANT/VNA-IN(SMA_BOARD_EDGE).2 ANT/VNA-IN(SMA_BOARD_EDGE).3 ANT/VNA-IN(SMA_BOARD_EDGE).4 ANT/VNA-IN(SMA_BOARD_EDGE).5 C10(CAP_0603=100N).2 C103(CAP_0805=10u).2 C104(CAP_0805=10u).2 C106(CAP_0805=10u).2 C107(CAP_0805=10u).2 C108(CAP_0805=10u).2 C110(CAP_0603=1U).2 C111(CAP_0603=100N).2 C115(CAP_0603=4U7).2 ...(共 260 脚) |
| 5 | GND | `GND` | -(0.1"_1PIN).1 ANT/VNA-IN(SMA_BOARD_EDGE).2 ANT/VNA-IN(SMA_BOARD_EDGE).3 ANT/VNA-IN(SMA_BOARD_EDGE).4 ANT/VNA-IN(SMA_BOARD_EDGE).5 C10(CAP_0603=100N).2 C103(CAP_0805=10u).2 C104(CAP_0805=10u).2 C106(CAP_0805=10u).2 C107(CAP_0805=10u).2 C108(CAP_0805=10u).2 C110(CAP_0603=1U).2 C111(CAP_0603=100N).2 C115(CAP_0603=4U7).2 ...(共 260 脚) |
| 6 | ADD | `TRX_SWITCH` | U121(STM32F746_LQFP100).18 U4(DPDT_ANALOG_MAX4525).6 |
| 7 | NCB | `RX-I_INAMP_N` | U272(MCP6N11).2 |
| 8 | NOB | `TX-I_DRIVER_N` | C263(CAP_0603=22U).1 |
| 9 | COMB | `$$$9485` | L81(MIXER_DIODE-RING_ADE-2ASK).5 |
| 10 | V+ | `+3V3` | 3V3A(PAD_1MM).1 C103(CAP_0805=10u).1 C104(CAP_0805=10u).1 C110(CAP_0603=1U).1 C111(CAP_0603=100N).1 C135(CAP_0603=10N).1 C137(CAP_0603=6U8).1 C17(CAP_0603=100n).1 C191(CSM-X5R-10U0-10P-25V-0805=10u0).1 C212(CAP_0603=100n).1 C213(CAP_0603=1u0).1 C214(CAP_0603=6U8).1 C215(CAP_0603=10N).1 C225(CAP_0603=6U8).1 ...(共 57 脚) |

Nets named `$$$...` are unnamed wires in PADS: one electrical node, no meaning.
Neighbours shown as `C13(CAP_0603=100n).1` carry the board-file value;
`=VALUE CONTESTED: BOM 0R, board file 1k0` means the two sources disagree.

---

## U185 — `GPS_MODULE_RXM-GPS-RM-T`

Question (only this one): RXM-GPS-RM-T: internal antenna? external active-antenna wiring, sensitivity/TTFF

Premise check: this section assumes the part is **RXM-GPS**; if the type in the heading does not match, stop and report the contradiction.

| pin | pin name | net | other pins on the same net (refdes(part_type).pin) |
|---|---|---|---|
| 3 | 1PPS | `$$$21746` | R202(RES_0603=1K).1 |
| 4 | TX | `$$$21776` | R201(RES_0603=1K).1 |
| 5 | RX | `$$$21752` | R200(RES_0603=1K).1 |
| 8 | \RESET | `GPS_RESET` | GPSR(PAD_1MM).1 U121(STM32F746_LQFP100).62 |
| 11 | VBACKUP | `VBAT_BKP` | C173(CAP_0603=1U).1 U121(STM32F746_LQFP100).6 U172(3V3_LDO_MCP1802).5 |
| 12 | VCC | `$$$22983` | Q126(MOSFET_P_SOT23_IRLML6401).3 |
| 18 | GND_1 | `GND` | -(0.1"_1PIN).1 ANT/VNA-IN(SMA_BOARD_EDGE).2 ANT/VNA-IN(SMA_BOARD_EDGE).3 ANT/VNA-IN(SMA_BOARD_EDGE).4 ANT/VNA-IN(SMA_BOARD_EDGE).5 C10(CAP_0603=100N).2 C103(CAP_0805=10u).2 C104(CAP_0805=10u).2 C106(CAP_0805=10u).2 C107(CAP_0805=10u).2 C108(CAP_0805=10u).2 C110(CAP_0603=1U).2 C111(CAP_0603=100N).2 C115(CAP_0603=4U7).2 ...(共 260 脚) |
| 19 | RFIN | `$$$28367` | C186(CAP_0603=2p2).1 GPS_ANTENNA(GPS_ANTENNA-W3062A).1 |
| 20 | GND_2 | `GND` | -(0.1"_1PIN).1 ANT/VNA-IN(SMA_BOARD_EDGE).2 ANT/VNA-IN(SMA_BOARD_EDGE).3 ANT/VNA-IN(SMA_BOARD_EDGE).4 ANT/VNA-IN(SMA_BOARD_EDGE).5 C10(CAP_0603=100N).2 C103(CAP_0805=10u).2 C104(CAP_0805=10u).2 C106(CAP_0805=10u).2 C107(CAP_0805=10u).2 C108(CAP_0805=10u).2 C110(CAP_0603=1U).2 C111(CAP_0603=100N).2 C115(CAP_0603=4U7).2 ...(共 260 脚) |
| 21 | GND_3 | `GND` | -(0.1"_1PIN).1 ANT/VNA-IN(SMA_BOARD_EDGE).2 ANT/VNA-IN(SMA_BOARD_EDGE).3 ANT/VNA-IN(SMA_BOARD_EDGE).4 ANT/VNA-IN(SMA_BOARD_EDGE).5 C10(CAP_0603=100N).2 C103(CAP_0805=10u).2 C104(CAP_0805=10u).2 C106(CAP_0805=10u).2 C107(CAP_0805=10u).2 C108(CAP_0805=10u).2 C110(CAP_0603=1U).2 C111(CAP_0603=100N).2 C115(CAP_0603=4U7).2 ...(共 260 脚) |
| 22 | GND | `GND` | -(0.1"_1PIN).1 ANT/VNA-IN(SMA_BOARD_EDGE).2 ANT/VNA-IN(SMA_BOARD_EDGE).3 ANT/VNA-IN(SMA_BOARD_EDGE).4 ANT/VNA-IN(SMA_BOARD_EDGE).5 C10(CAP_0603=100N).2 C103(CAP_0805=10u).2 C104(CAP_0805=10u).2 C106(CAP_0805=10u).2 C107(CAP_0805=10u).2 C108(CAP_0805=10u).2 C110(CAP_0603=1U).2 C111(CAP_0603=100N).2 C115(CAP_0603=4U7).2 ...(共 260 脚) |
| 1 | - | *no net in the board file (pad exists, nothing connected)* | - |
| 2 | - | *no net in the board file (pad exists, nothing connected)* | - |
| 6 | - | *no net in the board file (pad exists, nothing connected)* | - |
| 7 | - | *no net in the board file (pad exists, nothing connected)* | - |
| 9 | - | *no net in the board file (pad exists, nothing connected)* | - |
| 10 | - | *no net in the board file (pad exists, nothing connected)* | - |
| 13 | - | *no net in the board file (pad exists, nothing connected)* | - |
| 14 | - | *no net in the board file (pad exists, nothing connected)* | - |
| 15 | - | *no net in the board file (pad exists, nothing connected)* | - |
| 16 | - | *no net in the board file (pad exists, nothing connected)* | - |
| 17 | - | *no net in the board file (pad exists, nothing connected)* | - |

Nets named `$$$...` are unnamed wires in PADS: one electrical node, no meaning.
Neighbours shown as `C13(CAP_0603=100n).1` carry the board-file value;
`=VALUE CONTESTED: BOM 0R, board file 1k0` means the two sources disagree.

---

## U189 — `MIC_PREAMP_SSM2167`

Question (only this one): SSM2167 mic preamp: gain set, supply range, output coupling

Premise check: this section assumes the part is **SSM2167**; if the type in the heading does not match, stop and report the contradiction.

| pin | pin name | net | other pins on the same net (refdes(part_type).pin) |
|---|---|---|---|
| 1 | GND | `GND` | -(0.1"_1PIN).1 ANT/VNA-IN(SMA_BOARD_EDGE).2 ANT/VNA-IN(SMA_BOARD_EDGE).3 ANT/VNA-IN(SMA_BOARD_EDGE).4 ANT/VNA-IN(SMA_BOARD_EDGE).5 C10(CAP_0603=100N).2 C103(CAP_0805=10u).2 C104(CAP_0805=10u).2 C106(CAP_0805=10u).2 C107(CAP_0805=10u).2 C108(CAP_0805=10u).2 C110(CAP_0603=1U).2 C111(CAP_0603=100N).2 C115(CAP_0603=4U7).2 ...(共 260 脚) |
| 2 | VCAIN | `$$$1740` | C192(CSM-X5R-10U0-10P-25V-0805=10u0).1 |
| 3 | \SHTDN | `PREAMP_SHTDWN` | U121(STM32F746_LQFP100).61 |
| 4 | BUFOUT | `$$$1734` | C192(CSM-X5R-10U0-10P-25V-0805=10u0).2 |
| 5 | INPUT | `MIC_OUT` | U37(SPDT_ANALOG_SWITCH_SN74LVC1G3157).4 |
| 6 | AVG_CAP | `$$$1679` | C188(CSM-X5R-10U0-10P-25V-0805=10u0).1 |
| 7 | GATE_THRS | `$$$3258` | R187(RES_0603=5K).1 |
| 8 | CMPRS_RTIO | `$$$3254` | R190(RES_0603=15K).1 |
| 9 | OUTPUT | `MIC_AMP_OUT` | C139(CAP_0603=100N).1 |
| 10 | VDD | `+3V3` | 3V3A(PAD_1MM).1 C103(CAP_0805=10u).1 C104(CAP_0805=10u).1 C110(CAP_0603=1U).1 C111(CAP_0603=100N).1 C135(CAP_0603=10N).1 C137(CAP_0603=6U8).1 C17(CAP_0603=100n).1 C191(CSM-X5R-10U0-10P-25V-0805=10u0).1 C212(CAP_0603=100n).1 C213(CAP_0603=1u0).1 C214(CAP_0603=6U8).1 C215(CAP_0603=10N).1 C225(CAP_0603=6U8).1 ...(共 57 脚) |

Nets named `$$$...` are unnamed wires in PADS: one electrical node, no meaning.
Neighbours shown as `C13(CAP_0603=100n).1` carry the board-file value;
`=VALUE CONTESTED: BOM 0R, board file 1k0` means the two sources disagree.

---

## U199 — `AUDIO_AMP_TPA0253DGQR`

Question (only this one): TPA0253: gain-set pins, output power with the given supply and load

Premise check: this section assumes the part is **TPA0253**; if the type in the heading does not match, stop and report the contradiction.

| pin | pin name | net | other pins on the same net (refdes(part_type).pin) |
|---|---|---|---|
| 1 | FILT_CAP | `$$$8887` | C148(CAP_0603=1U).1 |
| 2 | \SHUTDOWN | `AUDIO_AMP_\SHDN` | U121(STM32F746_LQFP100).44 |
| 3 | VDD | `$$$14035` | C142(CSM-X5R-22U-20P-10V-1210=220u).2 C143(CSM-X5R-22U-20P-10V-1210=220u).2 C147(CSM-X5R-10U0-10P-25V-0805=10u0).2 C149(CAP_0603=1U).1 L141(ISM-0805-10U=10u).2 |
| 4 | BYPASS | `$$$10468` | C205(CAP_0603=470N).1 |
| 5 | RIN | `$$$9661` | R204(RES_0603=12K1).2 |
| 6 | RO/MO+ | `$$$10136` | C152(CSM-X5R-22U-20P-10V-1210=220u).1 SPEAKER(SPEAKER_SMT_WATERPROOF_2403-260-00107).1 |
| 7 | ST/\MN | `$$$10265` | R144(RES_0603=100K).2 |
| 8 | GND | `GND` | -(0.1"_1PIN).1 ANT/VNA-IN(SMA_BOARD_EDGE).2 ANT/VNA-IN(SMA_BOARD_EDGE).3 ANT/VNA-IN(SMA_BOARD_EDGE).4 ANT/VNA-IN(SMA_BOARD_EDGE).5 C10(CAP_0603=100N).2 C103(CAP_0805=10u).2 C104(CAP_0805=10u).2 C106(CAP_0805=10u).2 C107(CAP_0805=10u).2 C108(CAP_0805=10u).2 C110(CAP_0603=1U).2 C111(CAP_0603=100N).2 C115(CAP_0603=4U7).2 ...(共 260 脚) |
| 9 | LIN | `$$$9652` | R194(RES_0603=12K1).2 |
| 10 | LO/MO- | `$$$11822` | C151(CSM-X5R-22U-20P-10V-1210=220u).1 |
| 11 | - | `GND` | -(0.1"_1PIN).1 ANT/VNA-IN(SMA_BOARD_EDGE).2 ANT/VNA-IN(SMA_BOARD_EDGE).3 ANT/VNA-IN(SMA_BOARD_EDGE).4 ANT/VNA-IN(SMA_BOARD_EDGE).5 C10(CAP_0603=100N).2 C103(CAP_0805=10u).2 C104(CAP_0805=10u).2 C106(CAP_0805=10u).2 C107(CAP_0805=10u).2 C108(CAP_0805=10u).2 C110(CAP_0603=1U).2 C111(CAP_0603=100N).2 C115(CAP_0603=4U7).2 ...(共 260 脚) |

Nets named `$$$...` are unnamed wires in PADS: one electrical node, no meaning.
Neighbours shown as `C13(CAP_0603=100n).1` carry the board-file value;
`=VALUE CONTESTED: BOM 0R, board file 1k0` means the two sources disagree.

---

## U211 — `74CBTLV3253`

Question (only this one): SN74CBTLV3253: S0/S1 function table, Ron, off-capacitance, isolation

Premise check: this section assumes the part is **CBTLV3253**; if the type in the heading does not match, stop and report the contradiction.

| pin | pin name | net | other pins on the same net (refdes(part_type).pin) |
|---|---|---|---|
| 1 | 1\OE | `GND` | -(0.1"_1PIN).1 ANT/VNA-IN(SMA_BOARD_EDGE).2 ANT/VNA-IN(SMA_BOARD_EDGE).3 ANT/VNA-IN(SMA_BOARD_EDGE).4 ANT/VNA-IN(SMA_BOARD_EDGE).5 C10(CAP_0603=100N).2 C103(CAP_0805=10u).2 C104(CAP_0805=10u).2 C106(CAP_0805=10u).2 C107(CAP_0805=10u).2 C108(CAP_0805=10u).2 C110(CAP_0603=1U).2 C111(CAP_0603=100N).2 C115(CAP_0603=4U7).2 ...(共 260 脚) |
| 2 | S1 | `FILTER_S1` | U121(STM32F746_LQFP100).55 U298(74CBTLV3253).2 |
| 3 | 1B4 | `FILTER_IN_N` | U287(VARIABLE_FILTER_HMC1023).27 U298(74CBTLV3253).12 |
| 4 | 1B3 | `FILTER_OUT_N` | U287(VARIABLE_FILTER_HMC1023).7 U298(74CBTLV3253).13 |
| 5 | 1B2 | `$$$32286` | U298(74CBTLV3253).11 |
| 6 | 1B1 | `$$$5480` | E_FILT_IF_N(0.1"_1PIN).1 |
| 7 | 1A | `$$$16416` | C209(CAP_0603=100n).2 |
| 8 | GND | `GND` | -(0.1"_1PIN).1 ANT/VNA-IN(SMA_BOARD_EDGE).2 ANT/VNA-IN(SMA_BOARD_EDGE).3 ANT/VNA-IN(SMA_BOARD_EDGE).4 ANT/VNA-IN(SMA_BOARD_EDGE).5 C10(CAP_0603=100N).2 C103(CAP_0805=10u).2 C104(CAP_0805=10u).2 C106(CAP_0805=10u).2 C107(CAP_0805=10u).2 C108(CAP_0805=10u).2 C110(CAP_0603=1U).2 C111(CAP_0603=100N).2 C115(CAP_0603=4U7).2 ...(共 260 脚) |
| 9 | 2A | `$$$16411` | C210(CAP_0603=100n).2 |
| 10 | 2B1 | `$$$5477` | E_FILT_IF_P(0.1"_1PIN).1 |
| 11 | 2B2 | `$$$32279` | U298(74CBTLV3253).5 |
| 12 | 2B3 | `FILTER_OUT_P` | U287(VARIABLE_FILTER_HMC1023).6 U298(74CBTLV3253).3 |
| 13 | 2B4 | `FILTER_IN_P` | U287(VARIABLE_FILTER_HMC1023).26 U298(74CBTLV3253).4 |
| 14 | S0 | `FILTER_S0` | U121(STM32F746_LQFP100).40 U298(74CBTLV3253).14 |
| 15 | 2\OE | `GND` | -(0.1"_1PIN).1 ANT/VNA-IN(SMA_BOARD_EDGE).2 ANT/VNA-IN(SMA_BOARD_EDGE).3 ANT/VNA-IN(SMA_BOARD_EDGE).4 ANT/VNA-IN(SMA_BOARD_EDGE).5 C10(CAP_0603=100N).2 C103(CAP_0805=10u).2 C104(CAP_0805=10u).2 C106(CAP_0805=10u).2 C107(CAP_0805=10u).2 C108(CAP_0805=10u).2 C110(CAP_0603=1U).2 C111(CAP_0603=100N).2 C115(CAP_0603=4U7).2 ...(共 260 脚) |
| 16 | VCC | `+3V3` | 3V3A(PAD_1MM).1 C103(CAP_0805=10u).1 C104(CAP_0805=10u).1 C110(CAP_0603=1U).1 C111(CAP_0603=100N).1 C135(CAP_0603=10N).1 C137(CAP_0603=6U8).1 C17(CAP_0603=100n).1 C191(CSM-X5R-10U0-10P-25V-0805=10u0).1 C212(CAP_0603=100n).1 C213(CAP_0603=1u0).1 C214(CAP_0603=6U8).1 C215(CAP_0603=10N).1 C225(CAP_0603=6U8).1 ...(共 57 脚) |

Nets named `$$$...` are unnamed wires in PADS: one electrical node, no meaning.
Neighbours shown as `C13(CAP_0603=100n).1` carry the board-file value;
`=VALUE CONTESTED: BOM 0R, board file 1k0` means the two sources disagree.

---

## U216 — `OP_AMP_FAN4174`

Question (only this one): FAN4174: supply range, output swing, used as filter/gain stage

Premise check: this section assumes the part is **FAN4174**; if the type in the heading does not match, stop and report the contradiction.

| pin | pin name | net | other pins on the same net (refdes(part_type).pin) |
|---|---|---|---|
| 1 | OUT | `$$$28433` | C217(CAP_0603=100N).1 C223(CAP_0603=1N).2 U216(OP_AMP_FAN4174).4 |
| 2 | -V | `GND` | -(0.1"_1PIN).1 ANT/VNA-IN(SMA_BOARD_EDGE).2 ANT/VNA-IN(SMA_BOARD_EDGE).3 ANT/VNA-IN(SMA_BOARD_EDGE).4 ANT/VNA-IN(SMA_BOARD_EDGE).5 C10(CAP_0603=100N).2 C103(CAP_0805=10u).2 C104(CAP_0805=10u).2 C106(CAP_0805=10u).2 C107(CAP_0805=10u).2 C108(CAP_0805=10u).2 C110(CAP_0603=1U).2 C111(CAP_0603=100N).2 C115(CAP_0603=4U7).2 ...(共 260 脚) |
| 3 | +IN | `$$$28435` | C220(CAP_0603=1N).1 R224(RES_0603=10K).2 |
| 4 | -IN | `$$$28433` | C217(CAP_0603=100N).1 C223(CAP_0603=1N).2 U216(OP_AMP_FAN4174).1 |
| 5 | +V | `+3V3` | 3V3A(PAD_1MM).1 C103(CAP_0805=10u).1 C104(CAP_0805=10u).1 C110(CAP_0603=1U).1 C111(CAP_0603=100N).1 C135(CAP_0603=10N).1 C137(CAP_0603=6U8).1 C17(CAP_0603=100n).1 C191(CSM-X5R-10U0-10P-25V-0805=10u0).1 C212(CAP_0603=100n).1 C213(CAP_0603=1u0).1 C214(CAP_0603=6U8).1 C215(CAP_0603=10N).1 C225(CAP_0603=6U8).1 ...(共 57 脚) |

Nets named `$$$...` are unnamed wires in PADS: one electrical node, no meaning.
Neighbours shown as `C13(CAP_0603=100n).1` carry the board-file value;
`=VALUE CONTESTED: BOM 0R, board file 1k0` means the two sources disagree.

---

## U24 — `RF_DPDT_MASWSS0129TR`

Question (only this one): MASWSS0129TR: control truth table (V1/V2), IL/isolation/switching, lifecycle

Premise check: this section assumes the part is **MASWSS0129**; if the type in the heading does not match, stop and report the contradiction.

| pin | pin name | net | other pins on the same net (refdes(part_type).pin) |
|---|---|---|---|
| 1 | - | `GND` | -(0.1"_1PIN).1 ANT/VNA-IN(SMA_BOARD_EDGE).2 ANT/VNA-IN(SMA_BOARD_EDGE).3 ANT/VNA-IN(SMA_BOARD_EDGE).4 ANT/VNA-IN(SMA_BOARD_EDGE).5 C10(CAP_0603=100N).2 C103(CAP_0805=10u).2 C104(CAP_0805=10u).2 C106(CAP_0805=10u).2 C107(CAP_0805=10u).2 C108(CAP_0805=10u).2 C110(CAP_0603=1U).2 C111(CAP_0603=100N).2 C115(CAP_0603=4U7).2 ...(共 260 脚) |
| 2 | - | `GND` | -(0.1"_1PIN).1 ANT/VNA-IN(SMA_BOARD_EDGE).2 ANT/VNA-IN(SMA_BOARD_EDGE).3 ANT/VNA-IN(SMA_BOARD_EDGE).4 ANT/VNA-IN(SMA_BOARD_EDGE).5 C10(CAP_0603=100N).2 C103(CAP_0805=10u).2 C104(CAP_0805=10u).2 C106(CAP_0805=10u).2 C107(CAP_0805=10u).2 C108(CAP_0805=10u).2 C110(CAP_0603=1U).2 C111(CAP_0603=100N).2 C115(CAP_0603=4U7).2 ...(共 260 脚) |
| 3 | V1 | `IMP_BRIDGE_SWITCH_A` | U121(STM32F746_LQFP100).16 |
| 4 | - | `$$$16064` | C26(CAP_0603=100N).1 |
| 5 | G1 | `GND` | -(0.1"_1PIN).1 ANT/VNA-IN(SMA_BOARD_EDGE).2 ANT/VNA-IN(SMA_BOARD_EDGE).3 ANT/VNA-IN(SMA_BOARD_EDGE).4 ANT/VNA-IN(SMA_BOARD_EDGE).5 C10(CAP_0603=100N).2 C103(CAP_0805=10u).2 C104(CAP_0805=10u).2 C106(CAP_0805=10u).2 C107(CAP_0805=10u).2 C108(CAP_0805=10u).2 C110(CAP_0603=1U).2 C111(CAP_0603=100N).2 C115(CAP_0603=4U7).2 ...(共 260 脚) |
| 6 | - | `$$$16065` | C27(CAP_0603=100N).1 |
| 7 | V2 | `IMP_BRIDGE_SWITCH_B` | U121(STM32F746_LQFP100).30 |
| 8 | - | `GND` | -(0.1"_1PIN).1 ANT/VNA-IN(SMA_BOARD_EDGE).2 ANT/VNA-IN(SMA_BOARD_EDGE).3 ANT/VNA-IN(SMA_BOARD_EDGE).4 ANT/VNA-IN(SMA_BOARD_EDGE).5 C10(CAP_0603=100N).2 C103(CAP_0805=10u).2 C104(CAP_0805=10u).2 C106(CAP_0805=10u).2 C107(CAP_0805=10u).2 C108(CAP_0805=10u).2 C110(CAP_0603=1U).2 C111(CAP_0603=100N).2 C115(CAP_0603=4U7).2 ...(共 260 脚) |
| 9 | - | `GND` | -(0.1"_1PIN).1 ANT/VNA-IN(SMA_BOARD_EDGE).2 ANT/VNA-IN(SMA_BOARD_EDGE).3 ANT/VNA-IN(SMA_BOARD_EDGE).4 ANT/VNA-IN(SMA_BOARD_EDGE).5 C10(CAP_0603=100N).2 C103(CAP_0805=10u).2 C104(CAP_0805=10u).2 C106(CAP_0805=10u).2 C107(CAP_0805=10u).2 C108(CAP_0805=10u).2 C110(CAP_0603=1U).2 C111(CAP_0603=100N).2 C115(CAP_0603=4U7).2 ...(共 260 脚) |
| 10 | - | `$$$16059` | C21(CAP_0603=100N).2 |
| 11 | G2 | `GND` | -(0.1"_1PIN).1 ANT/VNA-IN(SMA_BOARD_EDGE).2 ANT/VNA-IN(SMA_BOARD_EDGE).3 ANT/VNA-IN(SMA_BOARD_EDGE).4 ANT/VNA-IN(SMA_BOARD_EDGE).5 C10(CAP_0603=100N).2 C103(CAP_0805=10u).2 C104(CAP_0805=10u).2 C106(CAP_0805=10u).2 C107(CAP_0805=10u).2 C108(CAP_0805=10u).2 C110(CAP_0603=1U).2 C111(CAP_0603=100N).2 C115(CAP_0603=4U7).2 ...(共 260 脚) |
| 12 | - | `$$$16062` | C20(CAP_0603=100N).1 |
| 13 | - | `GND` | -(0.1"_1PIN).1 ANT/VNA-IN(SMA_BOARD_EDGE).2 ANT/VNA-IN(SMA_BOARD_EDGE).3 ANT/VNA-IN(SMA_BOARD_EDGE).4 ANT/VNA-IN(SMA_BOARD_EDGE).5 C10(CAP_0603=100N).2 C103(CAP_0805=10u).2 C104(CAP_0805=10u).2 C106(CAP_0805=10u).2 C107(CAP_0805=10u).2 C108(CAP_0805=10u).2 C110(CAP_0603=1U).2 C111(CAP_0603=100N).2 C115(CAP_0603=4U7).2 ...(共 260 脚) |

Nets named `$$$...` are unnamed wires in PADS: one electrical node, no meaning.
Neighbours shown as `C13(CAP_0603=100n).1` carry the board-file value;
`=VALUE CONTESTED: BOM 0R, board file 1k0` means the two sources disagree.

---

## U241 — `SI5338`

Question (only this one): Si5338DN: output frequency ranges, VCO/divider limits, I2C timing register

Premise check: this section assumes the part is **SI5338**; if the type in the heading does not match, stop and report the contradiction.

| pin | pin name | net | other pins on the same net (refdes(part_type).pin) |
|---|---|---|---|
| 1 | IN1/XTAL | `$$$5395` | Y237(CRYSTAL3225).3 |
| 2 | IN2/XTAL | `$$$5393` | Y237(CRYSTAL3225).1 |
| 4 | IN4/FDEC | `GND` | -(0.1"_1PIN).1 ANT/VNA-IN(SMA_BOARD_EDGE).2 ANT/VNA-IN(SMA_BOARD_EDGE).3 ANT/VNA-IN(SMA_BOARD_EDGE).4 ANT/VNA-IN(SMA_BOARD_EDGE).5 C10(CAP_0603=100N).2 C103(CAP_0805=10u).2 C104(CAP_0805=10u).2 C106(CAP_0805=10u).2 C107(CAP_0805=10u).2 C108(CAP_0805=10u).2 C110(CAP_0603=1U).2 C111(CAP_0603=100N).2 C115(CAP_0603=4U7).2 ...(共 260 脚) |
| 6 | IN6 | `GND` | -(0.1"_1PIN).1 ANT/VNA-IN(SMA_BOARD_EDGE).2 ANT/VNA-IN(SMA_BOARD_EDGE).3 ANT/VNA-IN(SMA_BOARD_EDGE).4 ANT/VNA-IN(SMA_BOARD_EDGE).5 C10(CAP_0603=100N).2 C103(CAP_0805=10u).2 C104(CAP_0805=10u).2 C106(CAP_0805=10u).2 C107(CAP_0805=10u).2 C108(CAP_0805=10u).2 C110(CAP_0603=1U).2 C111(CAP_0603=100N).2 C115(CAP_0603=4U7).2 ...(共 260 脚) |
| 7 | VDD1 | `+3V3_CPU` | +(0.1"_1PIN).1 3V3D(PAD_1MM).1 BOOT(BUTTON_B3U-1000P-B).2 C10(CAP_0603=100N).1 C106(CAP_0805=10u).1 C107(CAP_0805=10u).1 C108(CAP_0805=10u).1 C118(CAP_0603=100N).1 C119(CAP_0603=100N).1 C120(CAP_0603=4U7).1 C123(CAP_0603=100N).1 C156(CAP_0805=10u).1 C157(CAP_0603=100N).1 C238(CAP_0603=100n).1 ...(共 49 脚) |
| 11 | VDDO3 | `+3V3_CPU` | +(0.1"_1PIN).1 3V3D(PAD_1MM).1 BOOT(BUTTON_B3U-1000P-B).2 C10(CAP_0603=100N).1 C106(CAP_0805=10u).1 C107(CAP_0805=10u).1 C108(CAP_0805=10u).1 C118(CAP_0603=100N).1 C119(CAP_0603=100N).1 C120(CAP_0603=4U7).1 C123(CAP_0603=100N).1 C156(CAP_0805=10u).1 C157(CAP_0603=100N).1 C238(CAP_0603=100n).1 ...(共 49 脚) |
| 12 | SCL | `I2C_SCL` | SCL(PAD_1MM).1 U121(STM32F746_LQFP100).46 |
| 14 | CLK2A | `F_SYNTH_CAL` | U121(STM32F746_LQFP100).39 |
| 15 | VDDO2 | `+3V3_CPU` | +(0.1"_1PIN).1 3V3D(PAD_1MM).1 BOOT(BUTTON_B3U-1000P-B).2 C10(CAP_0603=100N).1 C106(CAP_0805=10u).1 C107(CAP_0805=10u).1 C108(CAP_0805=10u).1 C118(CAP_0603=100N).1 C119(CAP_0603=100N).1 C120(CAP_0603=4U7).1 C123(CAP_0603=100N).1 C156(CAP_0805=10u).1 C157(CAP_0603=100N).1 C238(CAP_0603=100n).1 ...(共 49 脚) |
| 16 | VDDO1 | `+3V3_CPU` | +(0.1"_1PIN).1 3V3D(PAD_1MM).1 BOOT(BUTTON_B3U-1000P-B).2 C10(CAP_0603=100N).1 C106(CAP_0805=10u).1 C107(CAP_0805=10u).1 C108(CAP_0805=10u).1 C118(CAP_0603=100N).1 C119(CAP_0603=100N).1 C120(CAP_0603=4U7).1 C123(CAP_0603=100N).1 C156(CAP_0805=10u).1 C157(CAP_0603=100N).1 C238(CAP_0603=100n).1 ...(共 49 脚) |
| 18 | CLK1A | `FILTER_CAL` | C283(CAP_0603=100n).2 |
| 19 | SDA | `I2C_SDA` | SDA(PAD_1MM).1 U121(STM32F746_LQFP100).47 |
| 20 | VDDO0 | `+3V3_CPU` | +(0.1"_1PIN).1 3V3D(PAD_1MM).1 BOOT(BUTTON_B3U-1000P-B).2 C10(CAP_0603=100N).1 C106(CAP_0805=10u).1 C107(CAP_0805=10u).1 C108(CAP_0805=10u).1 C118(CAP_0603=100N).1 C119(CAP_0603=100N).1 C120(CAP_0603=4U7).1 C123(CAP_0603=100N).1 C156(CAP_0805=10u).1 C157(CAP_0603=100N).1 C238(CAP_0603=100n).1 ...(共 49 脚) |
| 21 | CLK0B | `$$$5513` | C267(CAP_0603=100n).1 |
| 22 | CLK0A | `$$$5510` | C265(CAP_0603=100n).1 |
| 23 | RSVD_GND | `GND` | -(0.1"_1PIN).1 ANT/VNA-IN(SMA_BOARD_EDGE).2 ANT/VNA-IN(SMA_BOARD_EDGE).3 ANT/VNA-IN(SMA_BOARD_EDGE).4 ANT/VNA-IN(SMA_BOARD_EDGE).5 C10(CAP_0603=100N).2 C103(CAP_0805=10u).2 C104(CAP_0805=10u).2 C106(CAP_0805=10u).2 C107(CAP_0805=10u).2 C108(CAP_0805=10u).2 C110(CAP_0603=1U).2 C111(CAP_0603=100N).2 C115(CAP_0603=4U7).2 ...(共 260 脚) |
| 24 | VDD2 | `+3V3_CPU` | +(0.1"_1PIN).1 3V3D(PAD_1MM).1 BOOT(BUTTON_B3U-1000P-B).2 C10(CAP_0603=100N).1 C106(CAP_0805=10u).1 C107(CAP_0805=10u).1 C108(CAP_0805=10u).1 C118(CAP_0603=100N).1 C119(CAP_0603=100N).1 C120(CAP_0603=4U7).1 C123(CAP_0603=100N).1 C156(CAP_0805=10u).1 C157(CAP_0603=100N).1 C238(CAP_0603=100n).1 ...(共 49 脚) |
| 25 | - | `GND` | -(0.1"_1PIN).1 ANT/VNA-IN(SMA_BOARD_EDGE).2 ANT/VNA-IN(SMA_BOARD_EDGE).3 ANT/VNA-IN(SMA_BOARD_EDGE).4 ANT/VNA-IN(SMA_BOARD_EDGE).5 C10(CAP_0603=100N).2 C103(CAP_0805=10u).2 C104(CAP_0805=10u).2 C106(CAP_0805=10u).2 C107(CAP_0805=10u).2 C108(CAP_0805=10u).2 C110(CAP_0603=1U).2 C111(CAP_0603=100N).2 C115(CAP_0603=4U7).2 ...(共 260 脚) |
| 3 | - | *no net in the board file (pad exists, nothing connected)* | - |
| 5 | - | *no net in the board file (pad exists, nothing connected)* | - |
| 8 | - | *no net in the board file (pad exists, nothing connected)* | - |
| 9 | - | *no net in the board file (pad exists, nothing connected)* | - |
| 10 | - | *no net in the board file (pad exists, nothing connected)* | - |
| 13 | - | *no net in the board file (pad exists, nothing connected)* | - |
| 17 | - | *no net in the board file (pad exists, nothing connected)* | - |

Nets named `$$$...` are unnamed wires in PADS: one electrical node, no meaning.
Neighbours shown as `C13(CAP_0603=100n).1` carry the board-file value;
`=VALUE CONTESTED: BOM 0R, board file 1k0` means the two sources disagree.

---

## U253 — `AD8131`

Question (only this one): AD8131: differential output, VOS/OS pin, gain and termination formulas

Premise check: this section assumes the part is **AD8131**; if the type in the heading does not match, stop and report the contradiction.

| pin | pin name | net | other pins on the same net (refdes(part_type).pin) |
|---|---|---|---|
| 1 | -DIN | `$$$11912` | R249(RES_0603=24R9).1 |
| 2 | VOCM | `HALF_VCC` | 1/2VCC(PAD_1MM).1 C301(CSM-X5R-47U-20P-6V3-0805=47u).1 C302(CAP_0603=100N).1 L39(BALUN_1-2_WBC2-1TL).2 R130(RES_0603=100K).2 R140(RES_0603=100K).2 R221(RES_0603=100K).2 R222(RES_0603=100K).2 R232(RES_0603=100K).2 R234(RES_0603=100K).2 R254(RES_0603=1K).2 R266(RES_0603=1K).2 R299(RES_0603=10K).1 R300(RES_0603=10K).2 ...(共 22 脚) |
| 3 | V+ | `+3V3` | 3V3A(PAD_1MM).1 C103(CAP_0805=10u).1 C104(CAP_0805=10u).1 C110(CAP_0603=1U).1 C111(CAP_0603=100N).1 C135(CAP_0603=10N).1 C137(CAP_0603=6U8).1 C17(CAP_0603=100n).1 C191(CSM-X5R-10U0-10P-25V-0805=10u0).1 C212(CAP_0603=100n).1 C213(CAP_0603=1u0).1 C214(CAP_0603=6U8).1 C215(CAP_0603=10N).1 C225(CAP_0603=6U8).1 ...(共 57 脚) |
| 4 | +OUT | `$$$15926` | C252(CAP_0603=22U).2 |
| 5 | -OUT | `$$$15997` | C251(CAP_0603=22U).2 |
| 6 | V- | `GND` | -(0.1"_1PIN).1 ANT/VNA-IN(SMA_BOARD_EDGE).2 ANT/VNA-IN(SMA_BOARD_EDGE).3 ANT/VNA-IN(SMA_BOARD_EDGE).4 ANT/VNA-IN(SMA_BOARD_EDGE).5 C10(CAP_0603=100N).2 C103(CAP_0805=10u).2 C104(CAP_0805=10u).2 C106(CAP_0805=10u).2 C107(CAP_0805=10u).2 C108(CAP_0805=10u).2 C110(CAP_0603=1U).2 C111(CAP_0603=100N).2 C115(CAP_0603=4U7).2 ...(共 260 脚) |
| 8 | +DIN | `TX-Q_FILTERED` | C217(CAP_0603=100N).2 R221(RES_0603=100K).1 R250(RES_0603=1K).2 TXQ(PAD_1MM).1 |
| 7 | - | *no net in the board file (pad exists, nothing connected)* | - |

Nets named `$$$...` are unnamed wires in PADS: one electrical node, no meaning.
Neighbours shown as `C13(CAP_0603=100n).1` carry the board-file value;
`=VALUE CONTESTED: BOM 0R, board file 1k0` means the two sources disagree.

---

## U255 — `MCP6N11`

Question (only this one): MCP6N11: instrumentation-amp gain set by external resistors (formula + range)

Premise check: this section assumes the part is **MCP6N11**; if the type in the heading does not match, stop and report the contradiction.

| pin | pin name | net | other pins on the same net (refdes(part_type).pin) |
|---|---|---|---|
| 1 | VFG | `OP_GAIN_B_WP` | R254(RES_0603=1K).1 U15(DIGITAL_POT_MAX5388).4 |
| 2 | VIM | `RX-Q_INAMP_N` | U4(DPDT_ANALOG_MAX4525).7 |
| 3 | VIP | `RX-Q_INAMP_P` | U4(DPDT_ANALOG_MAX4525).3 |
| 4 | VSS | `GND` | -(0.1"_1PIN).1 ANT/VNA-IN(SMA_BOARD_EDGE).2 ANT/VNA-IN(SMA_BOARD_EDGE).3 ANT/VNA-IN(SMA_BOARD_EDGE).4 ANT/VNA-IN(SMA_BOARD_EDGE).5 C10(CAP_0603=100N).2 C103(CAP_0805=10u).2 C104(CAP_0805=10u).2 C106(CAP_0805=10u).2 C107(CAP_0805=10u).2 C108(CAP_0805=10u).2 C110(CAP_0603=1U).2 C111(CAP_0603=100N).2 C115(CAP_0603=4U7).2 ...(共 260 脚) |
| 5 | VREF | `HALF_VCC` | 1/2VCC(PAD_1MM).1 C301(CSM-X5R-47U-20P-6V3-0805=47u).1 C302(CAP_0603=100N).1 L39(BALUN_1-2_WBC2-1TL).2 R130(RES_0603=100K).2 R140(RES_0603=100K).2 R221(RES_0603=100K).2 R222(RES_0603=100K).2 R232(RES_0603=100K).2 R234(RES_0603=100K).2 R254(RES_0603=1K).2 R266(RES_0603=1K).2 R299(RES_0603=10K).1 R300(RES_0603=10K).2 ...(共 22 脚) |
| 6 | VOUT | `RX-Q_UFILTERED/OP_GAIN_B_L` | C60(CAP_0603=100N).1 U15(DIGITAL_POT_MAX5388).2 |
| 7 | VDD | `+3V3` | 3V3A(PAD_1MM).1 C103(CAP_0805=10u).1 C104(CAP_0805=10u).1 C110(CAP_0603=1U).1 C111(CAP_0603=100N).1 C135(CAP_0603=10N).1 C137(CAP_0603=6U8).1 C17(CAP_0603=100n).1 C191(CSM-X5R-10U0-10P-25V-0805=10u0).1 C212(CAP_0603=100n).1 C213(CAP_0603=1u0).1 C214(CAP_0603=6U8).1 C215(CAP_0603=10N).1 C225(CAP_0603=6U8).1 ...(共 57 脚) |
| 8 | EN/\CAL | `INAMP_ENABLE` | U121(STM32F746_LQFP100).17 U272(MCP6N11).8 |

Nets named `$$$...` are unnamed wires in PADS: one electrical node, no meaning.
Neighbours shown as `C13(CAP_0603=100n).1` carry the board-file value;
`=VALUE CONTESTED: BOM 0R, board file 1k0` means the two sources disagree.

---

## U260 — `AD8131`

Question (only this one): AD8131: differential output, VOS/OS pin, gain and termination formulas

Premise check: this section assumes the part is **AD8131**; if the type in the heading does not match, stop and report the contradiction.

| pin | pin name | net | other pins on the same net (refdes(part_type).pin) |
|---|---|---|---|
| 1 | -DIN | `$$$11915` | R261(RES_0603=24R9).1 |
| 2 | VOCM | `HALF_VCC` | 1/2VCC(PAD_1MM).1 C301(CSM-X5R-47U-20P-6V3-0805=47u).1 C302(CAP_0603=100N).1 L39(BALUN_1-2_WBC2-1TL).2 R130(RES_0603=100K).2 R140(RES_0603=100K).2 R221(RES_0603=100K).2 R222(RES_0603=100K).2 R232(RES_0603=100K).2 R234(RES_0603=100K).2 R254(RES_0603=1K).2 R266(RES_0603=1K).2 R299(RES_0603=10K).1 R300(RES_0603=10K).2 ...(共 22 脚) |
| 3 | V+ | `+3V3` | 3V3A(PAD_1MM).1 C103(CAP_0805=10u).1 C104(CAP_0805=10u).1 C110(CAP_0603=1U).1 C111(CAP_0603=100N).1 C135(CAP_0603=10N).1 C137(CAP_0603=6U8).1 C17(CAP_0603=100n).1 C191(CSM-X5R-10U0-10P-25V-0805=10u0).1 C212(CAP_0603=100n).1 C213(CAP_0603=1u0).1 C214(CAP_0603=6U8).1 C215(CAP_0603=10N).1 C225(CAP_0603=6U8).1 ...(共 57 脚) |
| 4 | +OUT | `$$$15845` | C262(CAP_0603=22U).2 |
| 5 | -OUT | `$$$15873` | C263(CAP_0603=22U).2 |
| 6 | V- | `GND` | -(0.1"_1PIN).1 ANT/VNA-IN(SMA_BOARD_EDGE).2 ANT/VNA-IN(SMA_BOARD_EDGE).3 ANT/VNA-IN(SMA_BOARD_EDGE).4 ANT/VNA-IN(SMA_BOARD_EDGE).5 C10(CAP_0603=100N).2 C103(CAP_0805=10u).2 C104(CAP_0805=10u).2 C106(CAP_0805=10u).2 C107(CAP_0805=10u).2 C108(CAP_0805=10u).2 C110(CAP_0603=1U).2 C111(CAP_0603=100N).2 C115(CAP_0603=4U7).2 ...(共 260 脚) |
| 8 | +DIN | `TX-I_FILTERED` | C228(CAP_0603=100N).2 R232(RES_0603=100K).1 R264(RES_0603=1K).2 TXI(PAD_1MM).1 |
| 7 | - | *no net in the board file (pad exists, nothing connected)* | - |

Nets named `$$$...` are unnamed wires in PADS: one electrical node, no meaning.
Neighbours shown as `C13(CAP_0603=100n).1` carry the board-file value;
`=VALUE CONTESTED: BOM 0R, board file 1k0` means the two sources disagree.

---

## U272 — `MCP6N11`

Question (only this one): MCP6N11: instrumentation-amp gain set by external resistors (formula + range)

Premise check: this section assumes the part is **MCP6N11**; if the type in the heading does not match, stop and report the contradiction.

| pin | pin name | net | other pins on the same net (refdes(part_type).pin) |
|---|---|---|---|
| 1 | VFG | `OP_GAIN_A_WP` | R266(RES_0603=1K).1 U15(DIGITAL_POT_MAX5388).9 |
| 2 | VIM | `RX-I_INAMP_N` | U18(DPDT_ANALOG_MAX4525).7 |
| 3 | VIP | `RX-I_INAMP_P` | U18(DPDT_ANALOG_MAX4525).3 |
| 4 | VSS | `GND` | -(0.1"_1PIN).1 ANT/VNA-IN(SMA_BOARD_EDGE).2 ANT/VNA-IN(SMA_BOARD_EDGE).3 ANT/VNA-IN(SMA_BOARD_EDGE).4 ANT/VNA-IN(SMA_BOARD_EDGE).5 C10(CAP_0603=100N).2 C103(CAP_0805=10u).2 C104(CAP_0805=10u).2 C106(CAP_0805=10u).2 C107(CAP_0805=10u).2 C108(CAP_0805=10u).2 C110(CAP_0603=1U).2 C111(CAP_0603=100N).2 C115(CAP_0603=4U7).2 ...(共 260 脚) |
| 5 | VREF | `HALF_VCC` | 1/2VCC(PAD_1MM).1 C301(CSM-X5R-47U-20P-6V3-0805=47u).1 C302(CAP_0603=100N).1 L39(BALUN_1-2_WBC2-1TL).2 R130(RES_0603=100K).2 R140(RES_0603=100K).2 R221(RES_0603=100K).2 R222(RES_0603=100K).2 R232(RES_0603=100K).2 R234(RES_0603=100K).2 R254(RES_0603=1K).2 R266(RES_0603=1K).2 R299(RES_0603=10K).1 R300(RES_0603=10K).2 ...(共 22 脚) |
| 6 | VOUT | `RX-I_UNFILTERED/OP_GAIN_A_L` | C49(CAP_0603=100N).1 U15(DIGITAL_POT_MAX5388).10 |
| 7 | VDD | `+3V3` | 3V3A(PAD_1MM).1 C103(CAP_0805=10u).1 C104(CAP_0805=10u).1 C110(CAP_0603=1U).1 C111(CAP_0603=100N).1 C135(CAP_0603=10N).1 C137(CAP_0603=6U8).1 C17(CAP_0603=100n).1 C191(CSM-X5R-10U0-10P-25V-0805=10u0).1 C212(CAP_0603=100n).1 C213(CAP_0603=1u0).1 C214(CAP_0603=6U8).1 C215(CAP_0603=10N).1 C225(CAP_0603=6U8).1 ...(共 57 脚) |
| 8 | EN/\CAL | `INAMP_ENABLE` | U121(STM32F746_LQFP100).17 U255(MCP6N11).8 |

Nets named `$$$...` are unnamed wires in PADS: one electrical node, no meaning.
Neighbours shown as `C13(CAP_0603=100n).1` carry the board-file value;
`=VALUE CONTESTED: BOM 0R, board file 1k0` means the two sources disagree.

---

## U279 — `SY10EP52V`

Question (only this one): SY100EP52: AC table incl. any minimum input frequency; quadrature /2 use

Premise check: this section assumes the part is **SY10EP52**; if the type in the heading does not match, stop and report the contradiction.

| pin | pin name | net | other pins on the same net (refdes(part_type).pin) |
|---|---|---|---|
| 1 | D | `$$$5937` | LO2N(PAD_1MM).1 R67(RES_0603=1k0).2 R68(RES_0603=VALUE CONTESTED: BOM 0R, board file 1k0).2 U280(SY10EP52V).6 |
| 2 | \D | `$$$5936` | LO2P(PAD_1MM).1 R69(RES_0603=VALUE CONTESTED: BOM 0R, board file 1k0).2 R70(RES_0603=1k0).2 U280(SY10EP52V).7 |
| 3 | CLK | `$$$31408` | C265(CAP_0603=100n).2 CLKA(PAD_1MM).1 R268(RES_0603=VALUE CONTESTED: BOM 100R, board file 1k0).2 R271(RES_0603=1k0).1 R274(RES_0603=1k0).2 U280(SY10EP52V).4 |
| 4 | \CLK | `$$$31407` | C267(CAP_0603=100n).2 CLKB(PAD_1MM).1 R268(RES_0603=VALUE CONTESTED: BOM 100R, board file 1k0).1 R270(RES_0603=1k0).1 R273(RES_0603=1k0).2 U280(SY10EP52V).3 |
| 5 | VEE | `GND` | -(0.1"_1PIN).1 ANT/VNA-IN(SMA_BOARD_EDGE).2 ANT/VNA-IN(SMA_BOARD_EDGE).3 ANT/VNA-IN(SMA_BOARD_EDGE).4 ANT/VNA-IN(SMA_BOARD_EDGE).5 C10(CAP_0603=100N).2 C103(CAP_0805=10u).2 C104(CAP_0805=10u).2 C106(CAP_0805=10u).2 C107(CAP_0805=10u).2 C108(CAP_0805=10u).2 C110(CAP_0603=1U).2 C111(CAP_0603=100N).2 C115(CAP_0603=4U7).2 ...(共 260 脚) |
| 6 | \Q | `$$$5934` | LO1N(PAD_1MM).1 R74(RES_0603=1k0).2 R75(RES_0603=VALUE CONTESTED: BOM 0R, board file 1k0).2 U280(SY10EP52V).2 |
| 7 | Q | `$$$5939` | LO1P(PAD_1MM).1 R76(RES_0603=VALUE CONTESTED: BOM 0R, board file 1k0).2 R77(RES_0603=1k0).2 U280(SY10EP52V).1 |
| 8 | VCC | `+3V3_FLIP_FLOP` | C277(CAP_0603=100n).1 C278(CAP_0603=100p).1 C281(CAP_0603=100p).1 C282(CAP_0603=100n).1 Q246(MOSFET_P_SOT23_IRLML6401).3 U280(SY10EP52V).8 |

Nets named `$$$...` are unnamed wires in PADS: one electrical node, no meaning.
Neighbours shown as `C13(CAP_0603=100n).1` carry the board-file value;
`=VALUE CONTESTED: BOM 0R, board file 1k0` means the two sources disagree.

---

## U280 — `SY10EP52V`

Question (only this one): SY100EP52: AC table incl. any minimum input frequency; quadrature /2 use

Premise check: this section assumes the part is **SY10EP52**; if the type in the heading does not match, stop and report the contradiction.

| pin | pin name | net | other pins on the same net (refdes(part_type).pin) |
|---|---|---|---|
| 1 | D | `$$$5939` | LO1P(PAD_1MM).1 R76(RES_0603=VALUE CONTESTED: BOM 0R, board file 1k0).2 R77(RES_0603=1k0).2 U279(SY10EP52V).7 |
| 2 | \D | `$$$5934` | LO1N(PAD_1MM).1 R74(RES_0603=1k0).2 R75(RES_0603=VALUE CONTESTED: BOM 0R, board file 1k0).2 U279(SY10EP52V).6 |
| 3 | CLK | `$$$31407` | C267(CAP_0603=100n).2 CLKB(PAD_1MM).1 R268(RES_0603=VALUE CONTESTED: BOM 100R, board file 1k0).1 R270(RES_0603=1k0).1 R273(RES_0603=1k0).2 U279(SY10EP52V).4 |
| 4 | \CLK | `$$$31408` | C265(CAP_0603=100n).2 CLKA(PAD_1MM).1 R268(RES_0603=VALUE CONTESTED: BOM 100R, board file 1k0).2 R271(RES_0603=1k0).1 R274(RES_0603=1k0).2 U279(SY10EP52V).3 |
| 5 | VEE | `GND` | -(0.1"_1PIN).1 ANT/VNA-IN(SMA_BOARD_EDGE).2 ANT/VNA-IN(SMA_BOARD_EDGE).3 ANT/VNA-IN(SMA_BOARD_EDGE).4 ANT/VNA-IN(SMA_BOARD_EDGE).5 C10(CAP_0603=100N).2 C103(CAP_0805=10u).2 C104(CAP_0805=10u).2 C106(CAP_0805=10u).2 C107(CAP_0805=10u).2 C108(CAP_0805=10u).2 C110(CAP_0603=1U).2 C111(CAP_0603=100N).2 C115(CAP_0603=4U7).2 ...(共 260 脚) |
| 6 | \Q | `$$$5937` | LO2N(PAD_1MM).1 R67(RES_0603=1k0).2 R68(RES_0603=VALUE CONTESTED: BOM 0R, board file 1k0).2 U279(SY10EP52V).1 |
| 7 | Q | `$$$5936` | LO2P(PAD_1MM).1 R69(RES_0603=VALUE CONTESTED: BOM 0R, board file 1k0).2 R70(RES_0603=1k0).2 U279(SY10EP52V).2 |
| 8 | VCC | `+3V3_FLIP_FLOP` | C277(CAP_0603=100n).1 C278(CAP_0603=100p).1 C281(CAP_0603=100p).1 C282(CAP_0603=100n).1 Q246(MOSFET_P_SOT23_IRLML6401).3 U279(SY10EP52V).8 |

Nets named `$$$...` are unnamed wires in PADS: one electrical node, no meaning.
Neighbours shown as `C13(CAP_0603=100n).1` carry the board-file value;
`=VALUE CONTESTED: BOM 0R, board file 1k0` means the two sources disagree.

---

## U287 — `VARIABLE_FILTER_HMC1023`

Question (only this one): HMC1023LP5E: digital interface, register map, cutoff options, CALCK, VDDBG/VBG

Premise check: this section assumes the part is **HMC1023**; if the type in the heading does not match, stop and report the contradiction.

| pin | pin name | net | other pins on the same net (refdes(part_type).pin) |
|---|---|---|---|
| 1 | NC1 | `GND` | -(0.1"_1PIN).1 ANT/VNA-IN(SMA_BOARD_EDGE).2 ANT/VNA-IN(SMA_BOARD_EDGE).3 ANT/VNA-IN(SMA_BOARD_EDGE).4 ANT/VNA-IN(SMA_BOARD_EDGE).5 C10(CAP_0603=100N).2 C103(CAP_0805=10u).2 C104(CAP_0805=10u).2 C106(CAP_0805=10u).2 C107(CAP_0805=10u).2 C108(CAP_0805=10u).2 C110(CAP_0603=1U).2 C111(CAP_0603=100N).2 C115(CAP_0603=4U7).2 ...(共 260 脚) |
| 2 | VDDQ1 | `LPF_5V` | C284(CAP_0603=100n).1 C290(CAP_0603=100n).1 C291(CAP_0603=100n).1 C295(CAP_0603=100n).1 Q208(MOSFET_P_SOT23_IRLML6401).3 R286(RES_0603=100k).2 R296(RES_0603=100k).2 U287(VARIABLE_FILTER_HMC1023).16 U287(VARIABLE_FILTER_HMC1023).21 U287(VARIABLE_FILTER_HMC1023).22 U287(VARIABLE_FILTER_HMC1023).23 U287(VARIABLE_FILTER_HMC1023).4 |
| 3 | NC2 | `GND` | -(0.1"_1PIN).1 ANT/VNA-IN(SMA_BOARD_EDGE).2 ANT/VNA-IN(SMA_BOARD_EDGE).3 ANT/VNA-IN(SMA_BOARD_EDGE).4 ANT/VNA-IN(SMA_BOARD_EDGE).5 C10(CAP_0603=100N).2 C103(CAP_0805=10u).2 C104(CAP_0805=10u).2 C106(CAP_0805=10u).2 C107(CAP_0805=10u).2 C108(CAP_0805=10u).2 C110(CAP_0603=1U).2 C111(CAP_0603=100N).2 C115(CAP_0603=4U7).2 ...(共 260 脚) |
| 4 | VDDQ2 | `LPF_5V` | C284(CAP_0603=100n).1 C290(CAP_0603=100n).1 C291(CAP_0603=100n).1 C295(CAP_0603=100n).1 Q208(MOSFET_P_SOT23_IRLML6401).3 R286(RES_0603=100k).2 R296(RES_0603=100k).2 U287(VARIABLE_FILTER_HMC1023).16 U287(VARIABLE_FILTER_HMC1023).2 U287(VARIABLE_FILTER_HMC1023).21 U287(VARIABLE_FILTER_HMC1023).22 U287(VARIABLE_FILTER_HMC1023).23 |
| 5 | CMQ | `$$$27752` | R296(RES_0603=100k).1 R297(RES_0603=100k).2 |
| 6 | OQP | `FILTER_OUT_P` | U211(74CBTLV3253).12 U298(74CBTLV3253).3 |
| 7 | OQN | `FILTER_OUT_N` | U211(74CBTLV3253).4 U298(74CBTLV3253).13 |
| 8 | NC3 | `GND` | -(0.1"_1PIN).1 ANT/VNA-IN(SMA_BOARD_EDGE).2 ANT/VNA-IN(SMA_BOARD_EDGE).3 ANT/VNA-IN(SMA_BOARD_EDGE).4 ANT/VNA-IN(SMA_BOARD_EDGE).5 C10(CAP_0603=100N).2 C103(CAP_0805=10u).2 C104(CAP_0805=10u).2 C106(CAP_0805=10u).2 C107(CAP_0805=10u).2 C108(CAP_0805=10u).2 C110(CAP_0603=1U).2 C111(CAP_0603=100N).2 C115(CAP_0603=4U7).2 ...(共 260 脚) |
| 9 | NC4 | `GND` | -(0.1"_1PIN).1 ANT/VNA-IN(SMA_BOARD_EDGE).2 ANT/VNA-IN(SMA_BOARD_EDGE).3 ANT/VNA-IN(SMA_BOARD_EDGE).4 ANT/VNA-IN(SMA_BOARD_EDGE).5 C10(CAP_0603=100N).2 C103(CAP_0805=10u).2 C104(CAP_0805=10u).2 C106(CAP_0805=10u).2 C107(CAP_0805=10u).2 C108(CAP_0805=10u).2 C110(CAP_0603=1U).2 C111(CAP_0603=100N).2 C115(CAP_0603=4U7).2 ...(共 260 脚) |
| 10 | NC5 | `GND` | -(0.1"_1PIN).1 ANT/VNA-IN(SMA_BOARD_EDGE).2 ANT/VNA-IN(SMA_BOARD_EDGE).3 ANT/VNA-IN(SMA_BOARD_EDGE).4 ANT/VNA-IN(SMA_BOARD_EDGE).5 C10(CAP_0603=100N).2 C103(CAP_0805=10u).2 C104(CAP_0805=10u).2 C106(CAP_0805=10u).2 C107(CAP_0805=10u).2 C108(CAP_0805=10u).2 C110(CAP_0603=1U).2 C111(CAP_0603=100N).2 C115(CAP_0603=4U7).2 ...(共 260 脚) |
| 11 | CALCK | `$$$15644` | C283(CAP_0603=100n).1 |
| 12 | SCK | `FILTER/GAIN_POT_CLK` | U121(STM32F746_LQFP100).52 U15(DIGITAL_POT_MAX5388).7 |
| 13 | SDO | `FILTER_MISO` | U121(STM32F746_LQFP100).53 |
| 14 | SDI | `FILTER/GAIN_POT_MOSI` | U121(STM32F746_LQFP100).54 U15(DIGITAL_POT_MAX5388).6 |
| 15 | SEN | `FILTER_CS` | U121(STM32F746_LQFP100).51 |
| 16 | DVDD | `LPF_5V` | C284(CAP_0603=100n).1 C290(CAP_0603=100n).1 C291(CAP_0603=100n).1 C295(CAP_0603=100n).1 Q208(MOSFET_P_SOT23_IRLML6401).3 R286(RES_0603=100k).2 R296(RES_0603=100k).2 U287(VARIABLE_FILTER_HMC1023).2 U287(VARIABLE_FILTER_HMC1023).21 U287(VARIABLE_FILTER_HMC1023).22 U287(VARIABLE_FILTER_HMC1023).23 U287(VARIABLE_FILTER_HMC1023).4 |
| 17 | NC6 | `GND` | -(0.1"_1PIN).1 ANT/VNA-IN(SMA_BOARD_EDGE).2 ANT/VNA-IN(SMA_BOARD_EDGE).3 ANT/VNA-IN(SMA_BOARD_EDGE).4 ANT/VNA-IN(SMA_BOARD_EDGE).5 C10(CAP_0603=100N).2 C103(CAP_0805=10u).2 C104(CAP_0805=10u).2 C106(CAP_0805=10u).2 C107(CAP_0805=10u).2 C108(CAP_0805=10u).2 C110(CAP_0603=1U).2 C111(CAP_0603=100N).2 C115(CAP_0603=4U7).2 ...(共 260 脚) |
| 18 | OIN | `$$$31740` | C293(CAP_0603=100n).2 |
| 19 | OIP | `$$$31750` | C294(CAP_0603=100n).1 |
| 20 | CMI | `$$$27784` | R285(RES_0603=100k).2 R286(RES_0603=100k).1 |
| 21 | VDDI1 | `LPF_5V` | C284(CAP_0603=100n).1 C290(CAP_0603=100n).1 C291(CAP_0603=100n).1 C295(CAP_0603=100n).1 Q208(MOSFET_P_SOT23_IRLML6401).3 R286(RES_0603=100k).2 R296(RES_0603=100k).2 U287(VARIABLE_FILTER_HMC1023).16 U287(VARIABLE_FILTER_HMC1023).2 U287(VARIABLE_FILTER_HMC1023).22 U287(VARIABLE_FILTER_HMC1023).23 U287(VARIABLE_FILTER_HMC1023).4 |
| 22 | VDDCAL | `LPF_5V` | C284(CAP_0603=100n).1 C290(CAP_0603=100n).1 C291(CAP_0603=100n).1 C295(CAP_0603=100n).1 Q208(MOSFET_P_SOT23_IRLML6401).3 R286(RES_0603=100k).2 R296(RES_0603=100k).2 U287(VARIABLE_FILTER_HMC1023).16 U287(VARIABLE_FILTER_HMC1023).2 U287(VARIABLE_FILTER_HMC1023).21 U287(VARIABLE_FILTER_HMC1023).23 U287(VARIABLE_FILTER_HMC1023).4 |
| 23 | VDDI2 | `LPF_5V` | C284(CAP_0603=100n).1 C290(CAP_0603=100n).1 C291(CAP_0603=100n).1 C295(CAP_0603=100n).1 Q208(MOSFET_P_SOT23_IRLML6401).3 R286(RES_0603=100k).2 R296(RES_0603=100k).2 U287(VARIABLE_FILTER_HMC1023).16 U287(VARIABLE_FILTER_HMC1023).2 U287(VARIABLE_FILTER_HMC1023).21 U287(VARIABLE_FILTER_HMC1023).22 U287(VARIABLE_FILTER_HMC1023).4 |
| 24 | NC7 | `GND` | -(0.1"_1PIN).1 ANT/VNA-IN(SMA_BOARD_EDGE).2 ANT/VNA-IN(SMA_BOARD_EDGE).3 ANT/VNA-IN(SMA_BOARD_EDGE).4 ANT/VNA-IN(SMA_BOARD_EDGE).5 C10(CAP_0603=100N).2 C103(CAP_0805=10u).2 C104(CAP_0805=10u).2 C106(CAP_0805=10u).2 C107(CAP_0805=10u).2 C108(CAP_0805=10u).2 C110(CAP_0603=1U).2 C111(CAP_0603=100N).2 C115(CAP_0603=4U7).2 ...(共 260 脚) |
| 25 | NC8 | `GND` | -(0.1"_1PIN).1 ANT/VNA-IN(SMA_BOARD_EDGE).2 ANT/VNA-IN(SMA_BOARD_EDGE).3 ANT/VNA-IN(SMA_BOARD_EDGE).4 ANT/VNA-IN(SMA_BOARD_EDGE).5 C10(CAP_0603=100N).2 C103(CAP_0805=10u).2 C104(CAP_0805=10u).2 C106(CAP_0805=10u).2 C107(CAP_0805=10u).2 C108(CAP_0805=10u).2 C110(CAP_0603=1U).2 C111(CAP_0603=100N).2 C115(CAP_0603=4U7).2 ...(共 260 脚) |
| 26 | IIP | `FILTER_IN_P` | U211(74CBTLV3253).13 U298(74CBTLV3253).4 |
| 27 | IIN | `FILTER_IN_N` | U211(74CBTLV3253).3 U298(74CBTLV3253).12 |
| 28 | VDDBG | `$$$15137` | C292(CAP_0603=100n).1 |
| 30 | IQN | `$$$31745` | C293(CAP_0603=100n).1 |
| 31 | IQP | `$$$31748` | C294(CAP_0603=100n).2 |
| 32 | NC9 | `GND` | -(0.1"_1PIN).1 ANT/VNA-IN(SMA_BOARD_EDGE).2 ANT/VNA-IN(SMA_BOARD_EDGE).3 ANT/VNA-IN(SMA_BOARD_EDGE).4 ANT/VNA-IN(SMA_BOARD_EDGE).5 C10(CAP_0603=100N).2 C103(CAP_0805=10u).2 C104(CAP_0805=10u).2 C106(CAP_0805=10u).2 C107(CAP_0805=10u).2 C108(CAP_0805=10u).2 C110(CAP_0603=1U).2 C111(CAP_0603=100N).2 C115(CAP_0603=4U7).2 ...(共 260 脚) |
| 33 | GND | `GND` | -(0.1"_1PIN).1 ANT/VNA-IN(SMA_BOARD_EDGE).2 ANT/VNA-IN(SMA_BOARD_EDGE).3 ANT/VNA-IN(SMA_BOARD_EDGE).4 ANT/VNA-IN(SMA_BOARD_EDGE).5 C10(CAP_0603=100N).2 C103(CAP_0805=10u).2 C104(CAP_0805=10u).2 C106(CAP_0805=10u).2 C107(CAP_0805=10u).2 C108(CAP_0805=10u).2 C110(CAP_0603=1U).2 C111(CAP_0603=100N).2 C115(CAP_0603=4U7).2 ...(共 260 脚) |
| 29 | - | *no net in the board file (pad exists, nothing connected)* | - |

Nets named `$$$...` are unnamed wires in PADS: one electrical node, no meaning.
Neighbours shown as `C13(CAP_0603=100n).1` carry the board-file value;
`=VALUE CONTESTED: BOM 0R, board file 1k0` means the two sources disagree.

---

## U298 — `74CBTLV3253`

Question (only this one): SN74CBTLV3253: S0/S1 function table, Ron, off-capacitance, isolation

Premise check: this section assumes the part is **CBTLV3253**; if the type in the heading does not match, stop and report the contradiction.

| pin | pin name | net | other pins on the same net (refdes(part_type).pin) |
|---|---|---|---|
| 1 | 1\OE | `GND` | -(0.1"_1PIN).1 ANT/VNA-IN(SMA_BOARD_EDGE).2 ANT/VNA-IN(SMA_BOARD_EDGE).3 ANT/VNA-IN(SMA_BOARD_EDGE).4 ANT/VNA-IN(SMA_BOARD_EDGE).5 C10(CAP_0603=100N).2 C103(CAP_0805=10u).2 C104(CAP_0805=10u).2 C106(CAP_0805=10u).2 C107(CAP_0805=10u).2 C108(CAP_0805=10u).2 C110(CAP_0603=1U).2 C111(CAP_0603=100N).2 C115(CAP_0603=4U7).2 ...(共 260 脚) |
| 2 | S1 | `FILTER_S1` | U121(STM32F746_LQFP100).55 U211(74CBTLV3253).2 |
| 3 | 1B4 | `FILTER_OUT_P` | U211(74CBTLV3253).12 U287(VARIABLE_FILTER_HMC1023).6 |
| 4 | 1B3 | `FILTER_IN_P` | U211(74CBTLV3253).13 U287(VARIABLE_FILTER_HMC1023).26 |
| 5 | 1B2 | `$$$32279` | U211(74CBTLV3253).11 |
| 6 | 1B1 | `$$$5486` | E_FILT_RF_P(0.1"_1PIN).1 |
| 7 | 1A | `$$$16344` | C40(CAP_0603=100n).2 |
| 8 | GND | `GND` | -(0.1"_1PIN).1 ANT/VNA-IN(SMA_BOARD_EDGE).2 ANT/VNA-IN(SMA_BOARD_EDGE).3 ANT/VNA-IN(SMA_BOARD_EDGE).4 ANT/VNA-IN(SMA_BOARD_EDGE).5 C10(CAP_0603=100N).2 C103(CAP_0805=10u).2 C104(CAP_0805=10u).2 C106(CAP_0805=10u).2 C107(CAP_0805=10u).2 C108(CAP_0805=10u).2 C110(CAP_0603=1U).2 C111(CAP_0603=100N).2 C115(CAP_0603=4U7).2 ...(共 260 脚) |
| 9 | 2A | `$$$16346` | C36(CAP_0603=100n).2 |
| 10 | 2B1 | `$$$5490` | E_FILT_RF_N(0.1"_1PIN).1 |
| 11 | 2B2 | `$$$32286` | U211(74CBTLV3253).5 |
| 12 | 2B3 | `FILTER_IN_N` | U211(74CBTLV3253).3 U287(VARIABLE_FILTER_HMC1023).27 |
| 13 | 2B4 | `FILTER_OUT_N` | U211(74CBTLV3253).4 U287(VARIABLE_FILTER_HMC1023).7 |
| 14 | S0 | `FILTER_S0` | U121(STM32F746_LQFP100).40 U211(74CBTLV3253).14 |
| 15 | 2\OE | `GND` | -(0.1"_1PIN).1 ANT/VNA-IN(SMA_BOARD_EDGE).2 ANT/VNA-IN(SMA_BOARD_EDGE).3 ANT/VNA-IN(SMA_BOARD_EDGE).4 ANT/VNA-IN(SMA_BOARD_EDGE).5 C10(CAP_0603=100N).2 C103(CAP_0805=10u).2 C104(CAP_0805=10u).2 C106(CAP_0805=10u).2 C107(CAP_0805=10u).2 C108(CAP_0805=10u).2 C110(CAP_0603=1U).2 C111(CAP_0603=100N).2 C115(CAP_0603=4U7).2 ...(共 260 脚) |
| 16 | VCC | `+3V3` | 3V3A(PAD_1MM).1 C103(CAP_0805=10u).1 C104(CAP_0805=10u).1 C110(CAP_0603=1U).1 C111(CAP_0603=100N).1 C135(CAP_0603=10N).1 C137(CAP_0603=6U8).1 C17(CAP_0603=100n).1 C191(CSM-X5R-10U0-10P-25V-0805=10u0).1 C212(CAP_0603=100n).1 C213(CAP_0603=1u0).1 C214(CAP_0603=6U8).1 C215(CAP_0603=10N).1 C225(CAP_0603=6U8).1 ...(共 57 脚) |

Nets named `$$$...` are unnamed wires in PADS: one electrical node, no meaning.
Neighbours shown as `C13(CAP_0603=100n).1` carry the board-file value;
`=VALUE CONTESTED: BOM 0R, board file 1k0` means the two sources disagree.

---

## U30 — `RF_DPDT_MASWSS0129TR`

Question (only this one): MASWSS0129TR: control truth table (V1/V2), IL/isolation/switching, lifecycle

Premise check: this section assumes the part is **MASWSS0129**; if the type in the heading does not match, stop and report the contradiction.

| pin | pin name | net | other pins on the same net (refdes(part_type).pin) |
|---|---|---|---|
| 1 | - | `GND` | -(0.1"_1PIN).1 ANT/VNA-IN(SMA_BOARD_EDGE).2 ANT/VNA-IN(SMA_BOARD_EDGE).3 ANT/VNA-IN(SMA_BOARD_EDGE).4 ANT/VNA-IN(SMA_BOARD_EDGE).5 C10(CAP_0603=100N).2 C103(CAP_0805=10u).2 C104(CAP_0805=10u).2 C106(CAP_0805=10u).2 C107(CAP_0805=10u).2 C108(CAP_0805=10u).2 C110(CAP_0603=1U).2 C111(CAP_0603=100N).2 C115(CAP_0603=4U7).2 ...(共 260 脚) |
| 2 | - | `GND` | -(0.1"_1PIN).1 ANT/VNA-IN(SMA_BOARD_EDGE).2 ANT/VNA-IN(SMA_BOARD_EDGE).3 ANT/VNA-IN(SMA_BOARD_EDGE).4 ANT/VNA-IN(SMA_BOARD_EDGE).5 C10(CAP_0603=100N).2 C103(CAP_0805=10u).2 C104(CAP_0805=10u).2 C106(CAP_0805=10u).2 C107(CAP_0805=10u).2 C108(CAP_0805=10u).2 C110(CAP_0603=1U).2 C111(CAP_0603=100N).2 C115(CAP_0603=4U7).2 ...(共 260 脚) |
| 3 | V1 | `TX_RF_SWITCH_A` | U121(STM32F746_LQFP100).36 |
| 4 | - | `$$$16999` | C35(CAP_0603=100N).2 |
| 5 | G1 | `GND` | -(0.1"_1PIN).1 ANT/VNA-IN(SMA_BOARD_EDGE).2 ANT/VNA-IN(SMA_BOARD_EDGE).3 ANT/VNA-IN(SMA_BOARD_EDGE).4 ANT/VNA-IN(SMA_BOARD_EDGE).5 C10(CAP_0603=100N).2 C103(CAP_0805=10u).2 C104(CAP_0805=10u).2 C106(CAP_0805=10u).2 C107(CAP_0805=10u).2 C108(CAP_0805=10u).2 C110(CAP_0603=1U).2 C111(CAP_0603=100N).2 C115(CAP_0603=4U7).2 ...(共 260 脚) |
| 7 | V2 | `TX_RF_SWITCH_B` | U121(STM32F746_LQFP100).31 |
| 8 | - | `GND` | -(0.1"_1PIN).1 ANT/VNA-IN(SMA_BOARD_EDGE).2 ANT/VNA-IN(SMA_BOARD_EDGE).3 ANT/VNA-IN(SMA_BOARD_EDGE).4 ANT/VNA-IN(SMA_BOARD_EDGE).5 C10(CAP_0603=100N).2 C103(CAP_0805=10u).2 C104(CAP_0805=10u).2 C106(CAP_0805=10u).2 C107(CAP_0805=10u).2 C108(CAP_0805=10u).2 C110(CAP_0603=1U).2 C111(CAP_0603=100N).2 C115(CAP_0603=4U7).2 ...(共 260 脚) |
| 9 | - | `GND` | -(0.1"_1PIN).1 ANT/VNA-IN(SMA_BOARD_EDGE).2 ANT/VNA-IN(SMA_BOARD_EDGE).3 ANT/VNA-IN(SMA_BOARD_EDGE).4 ANT/VNA-IN(SMA_BOARD_EDGE).5 C10(CAP_0603=100N).2 C103(CAP_0805=10u).2 C104(CAP_0805=10u).2 C106(CAP_0805=10u).2 C107(CAP_0805=10u).2 C108(CAP_0805=10u).2 C110(CAP_0603=1U).2 C111(CAP_0603=100N).2 C115(CAP_0603=4U7).2 ...(共 260 脚) |
| 10 | - | `$$$17006` | C27(CAP_0603=100N).2 |
| 11 | G2 | `GND` | -(0.1"_1PIN).1 ANT/VNA-IN(SMA_BOARD_EDGE).2 ANT/VNA-IN(SMA_BOARD_EDGE).3 ANT/VNA-IN(SMA_BOARD_EDGE).4 ANT/VNA-IN(SMA_BOARD_EDGE).5 C10(CAP_0603=100N).2 C103(CAP_0805=10u).2 C104(CAP_0805=10u).2 C106(CAP_0805=10u).2 C107(CAP_0805=10u).2 C108(CAP_0805=10u).2 C110(CAP_0603=1U).2 C111(CAP_0603=100N).2 C115(CAP_0603=4U7).2 ...(共 260 脚) |
| 12 | - | `$$$17003` | C306(CAP_0603=100N).2 |
| 13 | - | `GND` | -(0.1"_1PIN).1 ANT/VNA-IN(SMA_BOARD_EDGE).2 ANT/VNA-IN(SMA_BOARD_EDGE).3 ANT/VNA-IN(SMA_BOARD_EDGE).4 ANT/VNA-IN(SMA_BOARD_EDGE).5 C10(CAP_0603=100N).2 C103(CAP_0805=10u).2 C104(CAP_0805=10u).2 C106(CAP_0805=10u).2 C107(CAP_0805=10u).2 C108(CAP_0805=10u).2 C110(CAP_0603=1U).2 C111(CAP_0603=100N).2 C115(CAP_0603=4U7).2 ...(共 260 脚) |
| 6 | - | *no net in the board file (pad exists, nothing connected)* | - |

Nets named `$$$...` are unnamed wires in PADS: one electrical node, no meaning.
Neighbours shown as `C13(CAP_0603=100n).1` carry the board-file value;
`=VALUE CONTESTED: BOM 0R, board file 1k0` means the two sources disagree.

---

## U304 — `MMIC-AMP_HMC482ST`

Question (only this one): SXB-2089Z (vs SBB-2089 / HMC482ST89): bandwidth, supply, input-side DC

Premise check: this section assumes the part is **HMC482ST**; if the type in the heading does not match, stop and report the contradiction.

| pin | pin name | net | other pins on the same net (refdes(part_type).pin) |
|---|---|---|---|
| 1 | RFIN | `RF_AMP_IN` | BIAS(PAD_1MM).1 C13(CAP_0603=100N).2 L11(IND_SMT_220UH_SRN4018-221M).1 |
| 2 | GND | `GND` | -(0.1"_1PIN).1 ANT/VNA-IN(SMA_BOARD_EDGE).2 ANT/VNA-IN(SMA_BOARD_EDGE).3 ANT/VNA-IN(SMA_BOARD_EDGE).4 ANT/VNA-IN(SMA_BOARD_EDGE).5 C10(CAP_0603=100N).2 C103(CAP_0805=10u).2 C104(CAP_0805=10u).2 C106(CAP_0805=10u).2 C107(CAP_0805=10u).2 C108(CAP_0805=10u).2 C110(CAP_0603=1U).2 C111(CAP_0603=100N).2 C115(CAP_0603=4U7).2 ...(共 260 脚) |
| 3 | RFOUT | `RF_AMP_OUT` | C305(CAP_0603=100N).2 L19(IND_SMT_220UH_SRN4018-221M).1 |

Nets named `$$$...` are unnamed wires in PADS: one electrical node, no meaning.
Neighbours shown as `C13(CAP_0603=100n).1` carry the board-file value;
`=VALUE CONTESTED: BOM 0R, board file 1k0` means the two sources disagree.

---

## U314 — `AD8302`

Question (only this one): AD8302: VMAG/VPHS transfer functions and the PSET/MSET resistor formulas

Premise check: this section assumes the part is **AD8302**; if the type in the heading does not match, stop and report the contradiction.

| pin | pin name | net | other pins on the same net (refdes(part_type).pin) |
|---|---|---|---|
| 1 | COMM1 | `GND` | -(0.1"_1PIN).1 ANT/VNA-IN(SMA_BOARD_EDGE).2 ANT/VNA-IN(SMA_BOARD_EDGE).3 ANT/VNA-IN(SMA_BOARD_EDGE).4 ANT/VNA-IN(SMA_BOARD_EDGE).5 C10(CAP_0603=100N).2 C103(CAP_0805=10u).2 C104(CAP_0805=10u).2 C106(CAP_0805=10u).2 C107(CAP_0805=10u).2 C108(CAP_0805=10u).2 C110(CAP_0603=1U).2 C111(CAP_0603=100N).2 C115(CAP_0603=4U7).2 ...(共 260 脚) |
| 2 | INPA | `$$$1603` | C322(CAP_0603=1N).2 |
| 3 | OFSA | `$$$1694` | C318(CAP_0603=1N).2 |
| 4 | VPOS | `$$$1054` | C316(CAP_0603=100P).2 R319(RES_0603=0R).1 |
| 5 | OFSB | `$$$1701` | C315(CAP_0603=1N).2 |
| 6 | INPB | `$$$1611` | C309(CAP_0603=1N).2 |
| 7 | COMM2 | `GND` | -(0.1"_1PIN).1 ANT/VNA-IN(SMA_BOARD_EDGE).2 ANT/VNA-IN(SMA_BOARD_EDGE).3 ANT/VNA-IN(SMA_BOARD_EDGE).4 ANT/VNA-IN(SMA_BOARD_EDGE).5 C10(CAP_0603=100N).2 C103(CAP_0805=10u).2 C104(CAP_0805=10u).2 C106(CAP_0805=10u).2 C107(CAP_0805=10u).2 C108(CAP_0805=10u).2 C110(CAP_0603=1U).2 C111(CAP_0603=100N).2 C115(CAP_0603=4U7).2 ...(共 260 脚) |
| 8 | PFLT | `$$$2472` | C307(CAP_0603=OPEN).1 |
| 9 | VPHS | `$$$2881` | R310(RES_0603=0R).1 R311(RES_0603=0R).2 |
| 10 | PSET | `$$$2878` | R311(RES_0603=0R).1 |
| 12 | MSET | `$$$2891` | R313(RES_0603=0R).1 |
| 13 | VMAG | `$$$596` | R312(RES_0603=0R).1 R313(RES_0603=0R).2 |
| 14 | MFLT | `$$$2458` | C320(CAP_0603=OPEN).2 |
| 11 | - | *no net in the board file (pad exists, nothing connected)* | - |

Nets named `$$$...` are unnamed wires in PADS: one electrical node, no meaning.
Neighbours shown as `C13(CAP_0603=100n).1` carry the board-file value;
`=VALUE CONTESTED: BOM 0R, board file 1k0` means the two sources disagree.

---

## U32 — `MICROPHONE_MEMS_SPU0410HR5H-PB`

Question (only this one): SPU0410HR5H-PB MEMS mic: supply, sensitivity, pinout vs the preamp hook-up

Premise check: this section assumes the part is **SPU0410**; if the type in the heading does not match, stop and report the contradiction.

| pin | pin name | net | other pins on the same net (refdes(part_type).pin) |
|---|---|---|---|
| 1 | - | `+3V3` | 3V3A(PAD_1MM).1 C103(CAP_0805=10u).1 C104(CAP_0805=10u).1 C110(CAP_0603=1U).1 C111(CAP_0603=100N).1 C135(CAP_0603=10N).1 C137(CAP_0603=6U8).1 C17(CAP_0603=100n).1 C191(CSM-X5R-10U0-10P-25V-0805=10u0).1 C212(CAP_0603=100n).1 C213(CAP_0603=1u0).1 C214(CAP_0603=6U8).1 C215(CAP_0603=10N).1 C225(CAP_0603=6U8).1 ...(共 57 脚) |
| 2 | - | `GND` | -(0.1"_1PIN).1 ANT/VNA-IN(SMA_BOARD_EDGE).2 ANT/VNA-IN(SMA_BOARD_EDGE).3 ANT/VNA-IN(SMA_BOARD_EDGE).4 ANT/VNA-IN(SMA_BOARD_EDGE).5 C10(CAP_0603=100N).2 C103(CAP_0805=10u).2 C104(CAP_0805=10u).2 C106(CAP_0805=10u).2 C107(CAP_0805=10u).2 C108(CAP_0805=10u).2 C110(CAP_0603=1U).2 C111(CAP_0603=100N).2 C115(CAP_0603=4U7).2 ...(共 260 脚) |
| 3 | - | `GND` | -(0.1"_1PIN).1 ANT/VNA-IN(SMA_BOARD_EDGE).2 ANT/VNA-IN(SMA_BOARD_EDGE).3 ANT/VNA-IN(SMA_BOARD_EDGE).4 ANT/VNA-IN(SMA_BOARD_EDGE).5 C10(CAP_0603=100N).2 C103(CAP_0805=10u).2 C104(CAP_0805=10u).2 C106(CAP_0805=10u).2 C107(CAP_0805=10u).2 C108(CAP_0805=10u).2 C110(CAP_0603=1U).2 C111(CAP_0603=100N).2 C115(CAP_0603=4U7).2 ...(共 260 脚) |
| 4 | - | `$$$13766` | C33(CAP_0603=100N).1 |

Nets named `$$$...` are unnamed wires in PADS: one electrical node, no meaning.
Neighbours shown as `C13(CAP_0603=100n).1` carry the board-file value;
`=VALUE CONTESTED: BOM 0R, board file 1k0` means the two sources disagree.

---

## U37 — `SPDT_ANALOG_SWITCH_SN74LVC1G3157`

Question (only this one): SN74LVC1G3157: Ron, signal range vs supply, control polarity

Premise check: this section assumes the part is **SN74LVC1G3157**; if the type in the heading does not match, stop and report the contradiction.

| pin | pin name | net | other pins on the same net (refdes(part_type).pin) |
|---|---|---|---|
| 1 | B2 | `BUILT-IN_MIC_OUT` | C33(CAP_0603=100N).2 |
| 2 | GND | `GND` | -(0.1"_1PIN).1 ANT/VNA-IN(SMA_BOARD_EDGE).2 ANT/VNA-IN(SMA_BOARD_EDGE).3 ANT/VNA-IN(SMA_BOARD_EDGE).4 ANT/VNA-IN(SMA_BOARD_EDGE).5 C10(CAP_0603=100N).2 C103(CAP_0805=10u).2 C104(CAP_0805=10u).2 C106(CAP_0805=10u).2 C107(CAP_0805=10u).2 C108(CAP_0805=10u).2 C110(CAP_0603=1U).2 C111(CAP_0603=100N).2 C115(CAP_0603=4U7).2 ...(共 260 脚) |
| 3 | B1 | `EXT_MIC_OUT` | EARPHONE(3.5MM_PHONO_4P_3SW_SJ-42617-SMT).4 U121(STM32F746_LQFP100).56 |
| 4 | A | `MIC_OUT` | U189(MIC_PREAMP_SSM2167).5 |
| 5 | VCC | `+3V3` | 3V3A(PAD_1MM).1 C103(CAP_0805=10u).1 C104(CAP_0805=10u).1 C110(CAP_0603=1U).1 C111(CAP_0603=100N).1 C135(CAP_0603=10N).1 C137(CAP_0603=6U8).1 C17(CAP_0603=100n).1 C191(CSM-X5R-10U0-10P-25V-0805=10u0).1 C212(CAP_0603=100n).1 C213(CAP_0603=1u0).1 C214(CAP_0603=6U8).1 C215(CAP_0603=10N).1 C225(CAP_0603=6U8).1 ...(共 57 脚) |
| 6 | S | `MIC_SELECT` | U121(STM32F746_LQFP100).57 |

Nets named `$$$...` are unnamed wires in PADS: one electrical node, no meaning.
Neighbours shown as `C13(CAP_0603=100n).1` carry the board-file value;
`=VALUE CONTESTED: BOM 0R, board file 1k0` means the two sources disagree.

---

## U4 — `DPDT_ANALOG_MAX4525`

Question (only this one): MAX4525CUB+: supply range, Ron vs supply, off-capacitance, signal swing limits

Premise check: this section assumes the part is **MAX4525**; if the type in the heading does not match, stop and report the contradiction.

| pin | pin name | net | other pins on the same net (refdes(part_type).pin) |
|---|---|---|---|
| 1 | NOA | `TX-Q_DRIVER_P` | C252(CAP_0603=22U).1 |
| 2 | COMA | `$$$9458` | L41(MIXER_DIODE-RING_ADE-2ASK).2 |
| 3 | NCA | `RX-Q_INAMP_P` | U255(MCP6N11).3 |
| 4 | INH | `GND` | -(0.1"_1PIN).1 ANT/VNA-IN(SMA_BOARD_EDGE).2 ANT/VNA-IN(SMA_BOARD_EDGE).3 ANT/VNA-IN(SMA_BOARD_EDGE).4 ANT/VNA-IN(SMA_BOARD_EDGE).5 C10(CAP_0603=100N).2 C103(CAP_0805=10u).2 C104(CAP_0805=10u).2 C106(CAP_0805=10u).2 C107(CAP_0805=10u).2 C108(CAP_0805=10u).2 C110(CAP_0603=1U).2 C111(CAP_0603=100N).2 C115(CAP_0603=4U7).2 ...(共 260 脚) |
| 5 | GND | `GND` | -(0.1"_1PIN).1 ANT/VNA-IN(SMA_BOARD_EDGE).2 ANT/VNA-IN(SMA_BOARD_EDGE).3 ANT/VNA-IN(SMA_BOARD_EDGE).4 ANT/VNA-IN(SMA_BOARD_EDGE).5 C10(CAP_0603=100N).2 C103(CAP_0805=10u).2 C104(CAP_0805=10u).2 C106(CAP_0805=10u).2 C107(CAP_0805=10u).2 C108(CAP_0805=10u).2 C110(CAP_0603=1U).2 C111(CAP_0603=100N).2 C115(CAP_0603=4U7).2 ...(共 260 脚) |
| 6 | ADD | `TRX_SWITCH` | U121(STM32F746_LQFP100).18 U18(DPDT_ANALOG_MAX4525).6 |
| 7 | NCB | `RX-Q_INAMP_N` | U255(MCP6N11).2 |
| 8 | NOB | `TX-Q_DRIVER_N` | C251(CAP_0603=22U).1 |
| 9 | COMB | `$$$9448` | L41(MIXER_DIODE-RING_ADE-2ASK).5 |
| 10 | V+ | `+3V3` | 3V3A(PAD_1MM).1 C103(CAP_0805=10u).1 C104(CAP_0805=10u).1 C110(CAP_0603=1U).1 C111(CAP_0603=100N).1 C135(CAP_0603=10N).1 C137(CAP_0603=6U8).1 C17(CAP_0603=100n).1 C191(CSM-X5R-10U0-10P-25V-0805=10u0).1 C212(CAP_0603=100n).1 C213(CAP_0603=1u0).1 C214(CAP_0603=6U8).1 C215(CAP_0603=10N).1 C225(CAP_0603=6U8).1 ...(共 57 脚) |

Nets named `$$$...` are unnamed wires in PADS: one electrical node, no meaning.
Neighbours shown as `C13(CAP_0603=100n).1` carry the board-file value;
`=VALUE CONTESTED: BOM 0R, board file 1k0` means the two sources disagree.

---

## U47 — `OP_AMP_FAN4174`

Question (only this one): FAN4174: supply range, output swing, used as filter/gain stage

Premise check: this section assumes the part is **FAN4174**; if the type in the heading does not match, stop and report the contradiction.

| pin | pin name | net | other pins on the same net (refdes(part_type).pin) |
|---|---|---|---|
| 1 | OUT | `$$$28421` | C48(CAP_0603=100N).1 C54(CAP_0603=1N).2 U47(OP_AMP_FAN4174).4 |
| 2 | -V | `GND` | -(0.1"_1PIN).1 ANT/VNA-IN(SMA_BOARD_EDGE).2 ANT/VNA-IN(SMA_BOARD_EDGE).3 ANT/VNA-IN(SMA_BOARD_EDGE).4 ANT/VNA-IN(SMA_BOARD_EDGE).5 C10(CAP_0603=100N).2 C103(CAP_0805=10u).2 C104(CAP_0805=10u).2 C106(CAP_0805=10u).2 C107(CAP_0805=10u).2 C108(CAP_0805=10u).2 C110(CAP_0603=1U).2 C111(CAP_0603=100N).2 C115(CAP_0603=4U7).2 ...(共 260 脚) |
| 3 | +IN | `$$$28423` | C51(CAP_0603=1N).1 R55(RES_0603=10K).2 |
| 4 | -IN | `$$$28421` | C48(CAP_0603=100N).1 C54(CAP_0603=1N).2 U47(OP_AMP_FAN4174).1 |
| 5 | +V | `+3V3` | 3V3A(PAD_1MM).1 C103(CAP_0805=10u).1 C104(CAP_0805=10u).1 C110(CAP_0603=1U).1 C111(CAP_0603=100N).1 C135(CAP_0603=10N).1 C137(CAP_0603=6U8).1 C17(CAP_0603=100n).1 C191(CSM-X5R-10U0-10P-25V-0805=10u0).1 C212(CAP_0603=100n).1 C213(CAP_0603=1u0).1 C214(CAP_0603=6U8).1 C215(CAP_0603=10N).1 C225(CAP_0603=6U8).1 ...(共 57 脚) |

Nets named `$$$...` are unnamed wires in PADS: one electrical node, no meaning.
Neighbours shown as `C13(CAP_0603=100n).1` carry the board-file value;
`=VALUE CONTESTED: BOM 0R, board file 1k0` means the two sources disagree.

---

## U58 — `OP_AMP_FAN4174`

Question (only this one): FAN4174: supply range, output swing, used as filter/gain stage

Premise check: this section assumes the part is **FAN4174**; if the type in the heading does not match, stop and report the contradiction.

| pin | pin name | net | other pins on the same net (refdes(part_type).pin) |
|---|---|---|---|
| 1 | OUT | `$$$28425` | C59(CAP_0603=100N).1 C65(CAP_0603=1N).2 U58(OP_AMP_FAN4174).4 |
| 2 | -V | `GND` | -(0.1"_1PIN).1 ANT/VNA-IN(SMA_BOARD_EDGE).2 ANT/VNA-IN(SMA_BOARD_EDGE).3 ANT/VNA-IN(SMA_BOARD_EDGE).4 ANT/VNA-IN(SMA_BOARD_EDGE).5 C10(CAP_0603=100N).2 C103(CAP_0805=10u).2 C104(CAP_0805=10u).2 C106(CAP_0805=10u).2 C107(CAP_0805=10u).2 C108(CAP_0805=10u).2 C110(CAP_0603=1U).2 C111(CAP_0603=100N).2 C115(CAP_0603=4U7).2 ...(共 260 脚) |
| 3 | +IN | `$$$28427` | C62(CAP_0603=1N).1 R66(RES_0603=10K).2 |
| 4 | -IN | `$$$28425` | C59(CAP_0603=100N).1 C65(CAP_0603=1N).2 U58(OP_AMP_FAN4174).1 |
| 5 | +V | `+3V3` | 3V3A(PAD_1MM).1 C103(CAP_0805=10u).1 C104(CAP_0805=10u).1 C110(CAP_0603=1U).1 C111(CAP_0603=100N).1 C135(CAP_0603=10N).1 C137(CAP_0603=6U8).1 C17(CAP_0603=100n).1 C191(CSM-X5R-10U0-10P-25V-0805=10u0).1 C212(CAP_0603=100n).1 C213(CAP_0603=1u0).1 C214(CAP_0603=6U8).1 C215(CAP_0603=10N).1 C225(CAP_0603=6U8).1 ...(共 57 脚) |

Nets named `$$$...` are unnamed wires in PADS: one electrical node, no meaning.
Neighbours shown as `C13(CAP_0603=100n).1` carry the board-file value;
`=VALUE CONTESTED: BOM 0R, board file 1k0` means the two sources disagree.

---

## U85 — `BOOST_REG_ADP1613`

Question (only this one): ADP1613: feedback-divider equation, switching frequency, inductor limits

Premise check: this section assumes the part is **ADP1613**; if the type in the heading does not match, stop and report the contradiction.

| pin | pin name | net | other pins on the same net (refdes(part_type).pin) |
|---|---|---|---|
| 1 | COMP | `$$$14690` | R94(RES_0603=6.8K).2 |
| 2 | FB | `$$$14589` | R90(RES_0603=30K).1 R92(RES_0603=10K).2 |
| 3 | EN | `5V_REG_ENABLE` | U121(STM32F746_LQFP100).1 |
| 4 | GND | `GND` | -(0.1"_1PIN).1 ANT/VNA-IN(SMA_BOARD_EDGE).2 ANT/VNA-IN(SMA_BOARD_EDGE).3 ANT/VNA-IN(SMA_BOARD_EDGE).4 ANT/VNA-IN(SMA_BOARD_EDGE).5 C10(CAP_0603=100N).2 C103(CAP_0805=10u).2 C104(CAP_0805=10u).2 C106(CAP_0805=10u).2 C107(CAP_0805=10u).2 C108(CAP_0805=10u).2 C110(CAP_0603=1U).2 C111(CAP_0603=100N).2 C115(CAP_0603=4U7).2 ...(共 260 脚) |
| 5 | SW | `BOOST_LOOP` | D44(DIODE-SMA).2 L84(IND_4.7UH_SMT_CDRH4D28CNP-4R7PC).2 |
| 6 | VIN | `V_SUPPLY` | C115(CAP_0603=4U7).1 C160(CAP_0603=4u7).1 C163(CSM-X5R-22U-20P-10V-1210=220u).2 C83(CSM-X5R-10U0-10P-10V-0805=10u0).1 L84(IND_4.7UH_SMT_CDRH4D28CNP-4R7PC).1 U114(BUCK_REGULATOR_AP3417C).1 U114(BUCK_REGULATOR_AP3417C).4 U161(BAT-MANAGE_MCP73871).1 U161(BAT-MANAGE_MCP73871).20 VSPLY(PAD_1MM).1 |
| 7 | FREQ | `GND` | -(0.1"_1PIN).1 ANT/VNA-IN(SMA_BOARD_EDGE).2 ANT/VNA-IN(SMA_BOARD_EDGE).3 ANT/VNA-IN(SMA_BOARD_EDGE).4 ANT/VNA-IN(SMA_BOARD_EDGE).5 C10(CAP_0603=100N).2 C103(CAP_0805=10u).2 C104(CAP_0805=10u).2 C106(CAP_0805=10u).2 C107(CAP_0805=10u).2 C108(CAP_0805=10u).2 C110(CAP_0603=1U).2 C111(CAP_0603=100N).2 C115(CAP_0603=4U7).2 ...(共 260 脚) |
| 8 | SS | `$$$14676` | C91(CAP_0603=33nF).1 |

Nets named `$$$...` are unnamed wires in PADS: one electrical node, no meaning.
Neighbours shown as `C13(CAP_0603=100n).1` carry the board-file value;
`=VALUE CONTESTED: BOM 0R, board file 1k0` means the two sources disagree.

---

## U86 — `DPDT_ANALOG_MAX4525`

Question (only this one): MAX4525CUB+: supply range, Ron vs supply, off-capacitance, signal swing limits

Premise check: this section assumes the part is **MAX4525**; if the type in the heading does not match, stop and report the contradiction.

| pin | pin name | net | other pins on the same net (refdes(part_type).pin) |
|---|---|---|---|
| 1 | NOA | `DAC1_TO_RF` | C229(CAP_0603=100N).1 |
| 2 | COMA | `DAC1` | U121(STM32F746_LQFP100).28 |
| 3 | NCA | `DAC1_TO_SPEAKER` | C195(CAP_0603=470N).1 DAC1(PAD_1MM).1 R196(RES_0603=12K1).2 |
| 4 | INH | `GND` | -(0.1"_1PIN).1 ANT/VNA-IN(SMA_BOARD_EDGE).2 ANT/VNA-IN(SMA_BOARD_EDGE).3 ANT/VNA-IN(SMA_BOARD_EDGE).4 ANT/VNA-IN(SMA_BOARD_EDGE).5 C10(CAP_0603=100N).2 C103(CAP_0805=10u).2 C104(CAP_0805=10u).2 C106(CAP_0805=10u).2 C107(CAP_0805=10u).2 C108(CAP_0805=10u).2 C110(CAP_0603=1U).2 C111(CAP_0603=100N).2 C115(CAP_0603=4U7).2 ...(共 260 脚) |
| 5 | GND | `GND` | -(0.1"_1PIN).1 ANT/VNA-IN(SMA_BOARD_EDGE).2 ANT/VNA-IN(SMA_BOARD_EDGE).3 ANT/VNA-IN(SMA_BOARD_EDGE).4 ANT/VNA-IN(SMA_BOARD_EDGE).5 C10(CAP_0603=100N).2 C103(CAP_0805=10u).2 C104(CAP_0805=10u).2 C106(CAP_0805=10u).2 C107(CAP_0805=10u).2 C108(CAP_0805=10u).2 C110(CAP_0603=1U).2 C111(CAP_0603=100N).2 C115(CAP_0603=4U7).2 ...(共 260 脚) |
| 6 | ADD | `DAC_MUX` | U121(STM32F746_LQFP100).3 |
| 7 | NCB | `DAC2_TO_SPEAKER` | C203(CAP_0603=470N).1 DAC2(PAD_1MM).1 |
| 8 | NOB | `DAC2_TO_RF` | C218(CAP_0603=100N).1 |
| 9 | COMB | `DAC2` | U121(STM32F746_LQFP100).29 |
| 10 | V+ | `+3V3_CPU` | +(0.1"_1PIN).1 3V3D(PAD_1MM).1 BOOT(BUTTON_B3U-1000P-B).2 C10(CAP_0603=100N).1 C106(CAP_0805=10u).1 C107(CAP_0805=10u).1 C108(CAP_0805=10u).1 C118(CAP_0603=100N).1 C119(CAP_0603=100N).1 C120(CAP_0603=4U7).1 C123(CAP_0603=100N).1 C156(CAP_0805=10u).1 C157(CAP_0603=100N).1 C238(CAP_0603=100n).1 ...(共 49 脚) |

Nets named `$$$...` are unnamed wires in PADS: one electrical node, no meaning.
Neighbours shown as `C13(CAP_0603=100n).1` carry the board-file value;
`=VALUE CONTESTED: BOM 0R, board file 1k0` means the two sources disagree.

TOTALS: sections=36 (expected 36) values_available=339
