fe1iscurc0r/PSDR/delegation/answers/ANS_开源SDR硬件调研_PSDR261对照.md

<!-- PROVENANCE / 取证口径（本 fork 添加，非原文一部分）
来源：外部执行方（另一账号）2026-11-03 交回的调研答案，经 IMA 知识库 psdr 文件夹取回。
状态：**外部断言**。已逐条核对的部分见 docs/PSDR-external-findings-2026-11-03.md
      （原厂 PDF sha256 对得上才升级）；未核对的性能/年份数字不得直接进对外文本。
-->

原始文件：ANS_开源SDR硬件调研_PSDR261对照.md（13578 字节，sha256 `cb3357ca6c7fee3ed6502438fe91b5b03b0ec4f84097d43a01ccf321eaa11a47`）

# 开源 HF/QRP SDR 硬件层调研 —— 对照 PortableSDR 2.6.1

- 调研日期：2026-11-03（全部数值/年份引自当日抓取的页面，标注来源；未证实处写"未找到"）
- 对照基线：PortableSDR 2.6.1 BOM（`bom_rows_PSDR261.csv`）+ 器件核实报告（`PortableSDR261_器件资料核实报告.md`）
- 注意：uSDX 原理图图片（https://github.com/threeme3/usdx/blob/master/usdx.png ）因网络 TLS 限制未取到原件，其内容按 README+OSHwLab+HF5L 文本复原，标注〔文本复原〕

---

## 1. 核心架构与芯片选型对比

| 项目 | 收发架构 | 混频/采样开关 | 时钟/LO | MCU/处理器 | ADC/CODEC | 滤波器 | PA |
|---|---|---|---|---|---|---|---|
| **uSDX** | 直接变频 QSD（Tayloe）+ Class-E | 74HC4053〔文本复原，OSHwLab〕+ 74ACT00×3 并联驱动 PA（HF5L） | Si5351A（I2C 800 kbit/s 相位调制，25MHz TCXO） | ATmega328P（部分 20MHz 超频） | MCU 内置 10bit ADC（音频/键控复用） | 分立 LPF：C0G 电容 + T37-2 磁环，按波段 | 3×BS170 标称；实测 IRF540N（80/40m）或 3×2N7000（20m） |
| **QCX/QCX+** | 直接变频 QSD + Class-E（纯 CW） | **FST3253**（预焊 SOIC）+ 74ACT00N（QRP Labs 手册 1.03） | Si5351A（27MHz 晶体，模块含 LM317L+2×BS170 电平移位） | ATmega328 DIP | 无 codec（MCU 内 ADC 做 CW 解码） | 7 元件 LPF：按波段 C0G（如 80m：39p/22p/180p/470p/1200p）+ T37-2；LM4562×6 有源滤波 | 6×BS170 + 1×MPS751；74ACT00 驱动 |
| **mcHF 0.6.3** | 直接变频 QSD + 线性 PA（48kHz I/Q） | **SN74CBT3253C**（LO=4×f） | Si570（10MHz–1.4GHz I2C XO） | STM32F407（168MHz M4） | **WM8731** 16bit/48k（ADC SNR 90dB） | 7 阶 LC BPF×4 继电器重叠波段 + 运放有源基带 LPF | 2×**RD16HHF1**（5W 标/10W 峰），数字偏置，锁存继电器切 LPF |
| **mcHF 新版 0.9** | 同上演进 | 未找到（Altium 工程内） | 未找到 | **STM32H747BIT6**（M7 480MHz + M4 DSP） | 未找到 | 未找到 | 25W（README） |
| **SoftRock Ensemble RXTX** | QSD/QSE + PC 声卡 | 74HC4053 类模拟 MUX（Tayloe） | Si570（÷4 得正交）或晶体（Lite） | ATtiny85（V-USB 控制） | PC 声卡 16bit | 分立 LPF（按波段） | ~1W FET 驱动级 |
| **Peaberry V2** | QSD/QSE + USB codec | Tayloe U6(RX)/U8(TX) | Si570（4×LO） | Cypress PSoC（peaberry.cydsn） | **PCM3060** 64× 过采样 ΔΣ（模拟 USB 声卡） | 分立（T1–T5 磁件按波段） | 1W |
| **Hermes-Lite 2** | **直接采样**（AD9866 MxFE，全双工） | AD9866 内部 | **Si510** 73.728MHz（$5） | **Intel MAX 10 FPGA**（25K LE，144-EQFP）+ 以太网 | AD9866 内置 12bit（$27–33） | **N2ADR 滤波板**：6×TX LPF（160–10m）+ 3MHz RX HPF + SWR 桥，I2C 7bit 继电器 | 5W 推挽 MOSFET + 40mW(+17dBm) 辅输出 |
| **OpenHPSDR Hermes/ANAN** | 直接采样（DDC） | — | 122.88MHz 采样时钟 | Cyclone 系 FPGA + PC（Thetis/PowerSDR） | **LTC2208 16bit @122.88MSPS**（eham ANAN-10） | 外部 LPF/天线口 | ANAN-10 10W+（PA/SWR 板） |
| **KiwiSDR 2** | 直接采样（仅 RX，网络共享） | — | 外部 ADC 时钟输入（2 版新增，可接 GPSDO） | **Artix-7 A35** FPGA + BeagleBone Green | **LTC 14bit @65MSPS**（设计评审；BOM 估 $24；〔注意〕具体型号官方 PDF 未点名） | 30MHz LPF/前端 + 保护电路（2 版：气体放电管+TVS+balun） | 无 TX |
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
