fe1iscurc0r/PSDR/docs/PSDR-assembly-sourcing.md

# 贴装与选材：哪些必须机贴、哪些能手贴、哪些买不到（2026-11-04）

产物：`Hardware/BOMs/PSDR_2.6.1/assembly_class.csv`（391 行，逐件带 `cls` 与 `package_note`）。
分类**只按封装**，不按价格；`reflow` = 需要回流/热风且手贴风险高，`air` = 热风/拖焊可做，
`hand` = 电烙铁可做，`mechanical` = 测试点/安装孔/排针之类不算件。

## 1. 数量

| 类 | 件数 | 说明 |
|---|---|---|
| `hand` | **290** | 绝大多数是 0603/0805/1206/1210 阻容与电感、LED、SMA、按键 |
| `mechanical` | 58 | 33 个 `PAD_1MM` 测试点 + 6 个基准点 + 安装孔 + 排针 |
| `air` | 25 | MSOP/SOIC/SOT23/uMAX 类（U15/U85/U114/U189/U253/U260/U279/U280/U304 等） |
| `reflow` | **18** | 见下 |

## 2. 必须机贴（或熟练热风）的 18 个

| 位号 | 器件 | 封装/备注 |
|---|---|---|
| `U121` | STM32F746 | LQFP-100，0.5 mm pitch |
| `U287` | HMC1023 | QFN-32 5×5 + 散热盘 |
| `U241` | Si5338 | QFN-24 4×4 |
| `U161` | MCP73871 | QFN-20 4×4 |
| `U199` | TPA0253 | QFN-24 (DGQ) |
| `U314` | AD8302 | LFCSP-14 4×4 |
| `U185` | RXM-GPS-RM-T | LCC 模块 |
| `U32` | SPU0410HR5H | MEMS 麦克风（LGA） |
| `GPS_ANTENNA` | W3062A | 陶瓷贴片天线 |
| `U16`/`U24`/`U30` | MASWSS0129 | 封装未见原厂手册（**买不到**，见 §3） |
| `MICROSD` / `USB` / `J170` | microSD / microUSB / 连接器 | 插座类 |
| `Y182`/`Y183`/`Y237` | 3225 晶振 | 两枚 26 MHz + 32.768 kHz |

## 3. 买不到 / 无原厂资料（决定"能不能全贴"的硬约束）

| 位号 | 器件 | 状态 |
|---|---|---|
| `U304` | **SXB-2089Z**（封装名是化石 `HMC482ST`） | **买不到**：原厂页检索不到 + 我方出口 429；三条独立来源指向 SXB，但无原厂 PDF |
| `U16`/`U24`/`U30` | **MASWSS0129TR** | **买不到**：原厂 CDN 本件 404（兄弟件 200），2021 年 Jeff 已在 win-source/Richardson 找到过渠道，现况未核 |
| `U32` | SPU0410HR5H-PB | 可买（DigiKey `423-1138-1-ND`），但**无原厂手册** |
| `GPS_ANTENNA` | W3062A | 可买（`553-2579-1-ND`），但**无原厂手册**（Pulse→YAGEO 断链） |

⇒ **"全部贴完"在当前料况下不可能**：两只射频件缺货。可行的最小板是"除了 U304/U16/U24/U30 之外的都贴"，
射频链留空——这块板只能验电源、时钟、MCU 与外设，不能验射频。**这正是"先别打样"的理由之一。**

## 4. 三种打法与代价

| 方案 | 做法 | 代价 | 适用 |
|---|---|---|---|
| A 混合 | 嘉立创经济型 SMT 只贴 §2 的 18 件，其余手贴 | 一次贴片费 + 自购料；0603 手贴量大（290 件）但可行 | 推荐：先验电源/MCU |
| B 全手贴 | 全部热风+烙铁 | 0.5 mm LQFP/QFN 需要练习；废板风险高 | 不推荐给第一次 |
| C 只打板不贴 | 只做裸板 + 自己贴少量关键件 | 最便宜，但 5 片里能救活几片看手艺 | 只想验证 DFM/焊接时 |

## 5. 与"配额"的关系

见 `docs/PSDR-fab-spec.md` §6：学生每月两次免费板、≤10×10 cm、OSP/沉金。**在 U304/MASWSS 的料况与
11 个值/两条轨没实测之前，打样只会得到"焊着玩"的 5 片板**——这张表就是"为什么先不打"的依据。

## 6. 成本（2026-11-04 按 2016 BOM 单价重算，**含数量**）

口径：`Hardware/BOMs/PSDR_2.6.1/PSDR2.6.1_BOM_flat.csv` 的 `qty × cost_x1`，单位美元，**2016 年 DigiKey 价**；
PCB 打样免费（学生每月两次）不计。

| 方案 | 保留 | 成本（2016 价） |
|---|---|---|
| 全板 | 全部 391 件（含 U304/三片 DPDT/HMC1023/AD8302/GPS） | **$272.54**（与 `PSDR-scope-and-cost.md` 的 $276.78 同口径，差额来自舍入） |
| **最小可验板** | 去掉 U304、U16/U24/U30、U287、U314、U185(GPS)、L41/L81、L39/L82、U253/U260、U279/U280 | **$149.32** |
| 同上 + GPS | 再加 U185 | **$169.70** |

被去掉的 9 行里，钱主要在：**HMC1023 $30.32、AD8302 $24.86、GPS $20.38**——三颗占了去掉部分的六成。
**注意**：2016 价目今已失效，单源件（HMC1023/Si5338）现在只会更贵；**SMT 费用无法在这里给准数**，
要按嘉立创下单页的"工程费 + 点数 + 种类"实际报价；手贴则只有料钱 + 运费。

### 6.1 $149 花在哪（拆给看不懂总额的人）

最小可验板 $149.32 里，**前四行就占 $64（43%）**：

| 行 | 2016 价 | 说明 |
|---|---|---|
| 11 颗 22 µF/1210（C42/43/142/143/…） | **$18.15** | 单颗约 $1.65，2016 单件价；同规格 LCSC 常见价低一个量级 |
| STM32F746（U121） | **$16.75** | 单源涨价重灾区 |
| Si5338（U241） | **$14.79** | 单源 |
| **两只板边 SMA**（ANT/VNA-IN、VNA-OUT） | **$14.30** | 单只 $7.15 ——**最典型的"DigiKey 单件价"**，JLC/LCSC 同类通常几块钱人民币 |

其余是长尾：三颗 MAX4525 $6.87、0603/0805 阻容各 $4–7、喇叭 $3.13、SSM2167 $2.77……
⇒ **$149 是"全部按 2016 DigiKey 单件价买、不换渠道"的数**；换 LCSC/JLC 常用料（尤其 SMA 与 22 µF）、
并只在 1–2 片上贴，实际料钱会明显低于这个数。**我不给替换后的具体金额**——那要按当天实时价重算。

只到"电源 + MCU + 时钟 + USB + 阻容"的**更裸一档**，同一价目口径是 **$103.14**。

### 6.2 不是"一次买 $149"：分档采购（2026-11-04）

诚实拆开：**$149 是"按 2016 DigiKey 单件价买齐一块收音机"的数**，不是最低门槛。按"什么时候真的需要"分档：

| 档 | 买什么 | 2016 价（qty 加权） | 能验什么 |
|---|---|---|---|
| **P 电源**（最小物理第一步） | `U114`(AP3417C $0.41) `U161`(MCP73871 $1.79) `U85`(ADP1613 $2.07) `U172`(MCP1802 $0.53) + 5 颗 MOSFET + L84/L105/L109/L141 + USB + 22 µF/10 µF + 阻容 | **约 $20** | 两条轨（`+3V3_CPU` 2.898/3.012 V、`+5V_BOOST` 4.94 V）与焊接 |
| **M MCU+时钟** | `U121`($16.75) + `U241`($14.79) + 晶振($1.26) + BOOT/RST 按键 + 编程排针（+ P 档全部） | **约 $55–60** | 固件能不能跑过 `main()`（`Si5338` 是开机阻塞点） |
| **A 音频/SD** | TPA0253/SSM2167/喇叭/microSD | +$10–15 | 音频与存储 |
| **R 射频**（买不到/未定） | HMC1023 $30.32、AD8302 $24.86、GPS $20.38、SMA $14.30、混频管、巴伦、DPDT | 约 $100+ | 等 G1/G3 有结论再说 |

**省钱杠杆（按效果排序）**：
1. **通用件换渠道**：22 µF/1210（$18.15）与 SMA（$14.30）是两条最冤枉的 DigiKey 单件价，LCSC/嘉立创同类通常低一个量级；
2. **阻容买套件**：234 个 0603/0805 阻容按套件买，比逐条 BOM 便宜；
3. **只买 1 套料**：免费给的是 5 片**板**，不是 5 套料；
4. **P 档先做**：$20 就能验证"板子焊得动、轨压对不对"，不碰 STM32/Si5338 这两颗贵的；
5. **射频档先不买**：等 U304 / DPDT 的替代方案定了再花那 $100。

对照：全板（含射频/音频/GPS/SMA）2016 价 **$272.54**；最小可验板 **$149.32**；"先买 P 档"**约 $20**。
