fe1iscurc0r/PSDR/docs/PSDR-scope-and-cost.md

# PSDR 的最初需求、成本结构与"该砍什么"（fork-only）

日期：2026-11-02，2026-11-03 按用户决定修订（VNA 不砍、GPS 降本、LC 带通组先验证再谈上游、
要一个 CMOS/继电器的合并结论、回答"为什么是短波"）。本文只做梳理与建议，不改设计、不改固件。

## 1. 最初的需求（作者自己在 `README.md` 里写的，不是我们猜的）

> PortableSDR —— 一台**独立（standalone）的 HF 软件定义收发信机**，面向火腿、徒步/背包客与 DIY 爱好者，
> 开源、QRP、自包含。

作者列出的功能与硬件（原文要点）：

| 类别 | 需求 |
|---|---|
| 频段 | **0–35 MHz** |
| 显示 | 瀑布图 |
| 模式 | 收 AM / USB / LSB / CW；发 USB / LSB |
| 滤波 | 可变带通滤波器 |
| 核心 | ARM 处理器、彩屏、正交采样检波与激励、数字可控仪表放大器 |
| 频率 | 双 DDS 合成器（注：实际板用 **Si5338**，README 的"双 DDS"是更早版本的说法） |
| 人机 | 摩斯键（机身右下"Giblet"）、编码器、内置麦克风与扬声器 |
| 测量 | **AD8302 增益/相位 + 阻抗桥**（VNA / 天线分析） |
| 接口 | 双 SMA、耳机麦克风、USB、microSD、**原始 I/Q 焊盘** |
| 其他 | **GPS**、内置 LiPo 与充电、高效开关电源 |
| 动机 | "市面上没有我想要的组合：好的电台闭源、更大、更贵；开源的又没有这个便携度" |

一句话：**这是一台"背包客用的、能测天线的、自带电池和屏幕的 HF QRP SDR"**，不是通用仪器。

## 2. 钱花在哪（BOM 单价合计 **$276.78**，87 行有价格）

| 项 | 成本 | 占比 | 说明 |
|---|---|---|---|
| HMC1023（U287）可编程低通 | **$30.32** | 11.0% | 单颗最贵；而且 `VDDBG` 在本板没供电（见 HMC1023 文档） |
| AD8302（U314）增益/相位 | **$24.86** | 9.0% | VNA 的核心（S 表用的不是它，是采样 RMS） |
| GPS 模块（U185 = RXM-GPS-RM-T） | $20.38 | 7.4% | **降本目标**，见 §5 |
| 1210 22µF ×11 | $18.15 | 6.6% | 电源去耦，数量与封装都可再谈（暂缓） |
| STM32F746（U121） | $16.75 | 6.1% | 核心，保留 |
| Si5338（U241） | $14.79 | 5.3% | 频率合成，保留 |
| 双 SMA（ANT/VNA-IN、VNA-OUT） | $14.30 | 5.2% | **两只都留**（VNA 是两个端口，不是选件） |
| 双混频器 ADE-2ASK | $11.10 | 4.0% | 核心 |
| 双 AD8131 | $9.66 | 3.5% | I/Q 到 ADC 的差分驱动，核心 |
| 双 SY10EP52V | $8.98 | 3.2% | LO 正交/分频，核心 |
| 双巴伦 WBC2-1TL | $6.90 | 2.5% | 混频器配套 |
| **3× MAX4525（CMOS DPDT，U4/U18/U86）** | $6.87 | 2.5% | I/Q 收发切换 + DAC 切换；**但它不是 50 Ω 射频开关**（§4.2） |
| 68× 0603 电容 | $6.80 | 2.5% | 基础 |
| U304 放大器（BOM 实订 SXB-2089Z，封装名 HMC482ST） | $6.13 | 2.2% | 核心（已停产，见替代提案） |
| 3× MASWSS0129（GaAs DPDT，U16/U24/U30） | $4.89 | 1.8% | **已停产**；便宜，问题是断供不是价格 |

## 3. 修订：VNA 是卖点，不是冗余（用户 2026-11-03 否决砍单）

上一版把 VNA 列为"可省 ≈$33（12%）"，**这条作废**。理由（都落在板子和原文上）：

- 需求表里 VNA 与"能测天线"是作者动机的组成部分；背包客用 HF 的真正痛点就是
  **带一根线天线出去，必须当场知道它谐振在哪、阻抗多少**——不然就得拖着一堆
  天线调谐器/假负载/台式仪器。这是这台机器区别于"又一个 SDR 前端"的地方。
- 网表证据：VNA 不是外挂，是**主链路本身**。`ANT/VNA-IN → C303 → U16（放大器旁路）
  → C21 → U24（阻抗桥插入/旁路）→ C27 → U30（射频口切换）→ C306 → RF_REF → VNA-OUT`，
  `RF_REF`/`RF_ANT` 两只 1 mm 焊盘就是桥的 REF/DUT 臂，AD8302 的 INPA/INPB 直接跨接
  （`C322`→INPA、`C309`→INPB）。**砍 VNA = 拆掉三级开关和两只 SMA，等于重做 RF 主链**，
  省下的 $33 会以改版代价还回去。
- 保留之后要写清它的**真实边界**（避免当成台式仪器用）：链路上限由混频器
  （ADE-2ASK，1–1000 MHz）决定，不是 6 GHz；桥是**非平衡比率式**（R22/R23/R29 +
  两只 1 mm 焊盘），测的是回波/阻抗幅度与相位，不是校准过的全四参数 S 参数；
  校准面/参考平面、动态范围、扫描步进都需要实测才能定（`docs/PSDR-bringup-checklist.md`
  里已给它留了测试点）。HMC1023 的 `VDDBG` 供电缺口**不在 VNA 路径上**，两者不互相挡住。

## 4. 剩下的冗余与降本（VNA 保留版）

### 4.1 可动项与其代价

| 项 | 现值 | 怎么动 | 净省（量级，不是报价） | 风险/前置 |
|---|---|---|---|---|
| GPS | $20.38 | 换 ¥20 级国产 GNSS 模块，或基础版不装、只留焊盘 | **≈ $17**（或 $20，选装路线） | 封装不同 ⇒ 局部改版；首冻时间/灵敏度要对照，不能凭"能定位"就算等价（§5） |
| HMC1023 可变低通 | $30.32 | **用 LC 带通组替代**（替代提案 §4.4 的分波段前端） | **≈ $18–20**（六组 LC + 切换本身约 $10–12） | **性能收益未验证**，先按 §6 的台架流程量出来再说；且这条线不上游 |
| 1210 22µF ×11 | $18.15 | 减到 6–8 颗 / 改 0805 | ≈ $6–8 | 用户已定"电容再说"，本轮不动 |
| 3× MASWSS0129（断供件） | $4.89 | 换 RF 级低阻 CMOS（≈ +$2）或信号继电器（≈ −$3） | −3 ～ +2 | **换件是为了能买到，不是为了省钱**；见 §7 |

**明确保留、不要动的**：VNA 全链（AD8302 + 桥 + 两只 SMA + U24/U30）、混频器、LO（Si5338 +
分频/正交）、I/Q 驱动（AD8131）、巴伦、MCU、屏、电池与充电、摩斯键、固件内的 DSP 链路。

### 4.2 降本后的目标区间

```
        $276.78   BOM 合计
 −16.90  GPS → ¥20 级模块（20.38 → 约 3.5）
 −19.32  HMC1023 → LC 带通组（拆 30.32，补六组 LC + 切换约 10–12）
  −7.00  1210 22µF 减量（用户说这轮不谈，仅列出）
  +2.00  天线侧开关 → RF 级低阻 CMOS（4.89 → 约 6.9）
  −3.50  天线侧开关 → 信号继电器（4.89 → 约 1.4，另加线圈驱动件）
        ─────────
        ≈ $236（CMOS 路线）／ ≈ $230（继电器路线）
        GPS 若改"不装、只留焊盘"，两条各再省 $3.5 ⇒ ≈ $232／$227
```

**VNA 保留后，成本地板就在 $225–235 一带（−15% 左右）。**上一版的"$190–200"是砍 VNA 换来的，
现在不再成立——这句话写死在这里，避免下次又拿旧数字讨论。

### 4.3 关于"可扩展性"（用户的决定，未变）

- **不做**"靠升级换频段"的内置架构：设计难度高、无仪器时不可证伪。
- **唯一值得留的扩展**：**外置变频器（transverter）IF 口** —— 板上的原始 I/Q 焊盘
  （RXI/TXI/RXQ/TXQ，1 mm 焊盘）已经在那里了，加一根 PTT 线即可（< $2）。
- 想直接提升性能时：**换板子比改这板便宜**。

## 5. GPS：怎么变便宜（fork-only，不上游）

现装 `U185 = RXM-GPS-RM-T`（u-blox），$20.38，是整台机器里**性价比最差的"非通信"件**。三条路线：

| 路线 | 做法 | 代价 | 备注 |
|---|---|---|---|
| A. 换国产 GNSS 模块 | ATGM336H / AT6558 系（¥15–25 级） | 封装/天线焊盘不同 ⇒ **该区域局部改版** | **只在本树提案，不报上游**（口径见 §G-4/G-5） |
| B. 基础版不装 | 保留焊盘与 `GPS_ANTENNA`，出厂不贴 | 零改板，直接 −$20.4 | 需要固件把"无 GPS"当正常状态（现在 `GPS` 相关代码有 `GPSTX`/`TX_FROM_GPS` 网络，行为要实测才知道） |
| C. 同厂降级 | NEO 系列模块（约 $10–13） | 也是换封装 | 这条可以上游谈（不涉及国产化），但省得比 A 少 |

不管走哪条，验收不能只看"能定位"：**首冻时间（冷/温/热）、−1 dB 灵敏度、锁定后的 PPS/时间戳精度、
以及在 LiPo 低电压下的冷启动电流**四项与现装件对照，才有资格说"等价替代"。这四项都要仪器，
在拿到硬件之前，本节只是提案。

## 6. LC 带通组：**先验证，再谈上游**（用户条件）

用户的话是"如果你验证过性能能够更好、动态范围更高的话，可以向上游 issues"。据实回答：

**没有验证过。** 这里没有硬件、没有仪器，任何"更好"的说法目前都是纸面推理。所以：
**不向上游提这条**，除非（a）按下面的流程量出数字，或（b）用户另行批准一个明确降级为
"设计意见 + 待验证问题清单"的 issue（开上游 issue 本身仍需逐次批准）。

值得先说清的一件事（这条是**板子给的**，不是推测）：**验证不需要改版**。
网表里已经有外接滤波器插槽，而且已经在 mux 的档位里：

```
U211 / U298 = 74CBTLV3253（VCC=+3V3，1OE/2OE 接地，S0/S1 = FILTER_S0/FILTER_S1）
  E_FILT_RF_P/N、E_FILT_IF_P/N  ← 封装 `0.1"_1PIN`，四个直插焊盘
  FILTER_IN_P/N、FILTER_OUT_P/N ← 进出 U287（HMC1023）
  控制线：FILTER_S0 = U121.40(PE10)，FILTER_S1 = U121.55(PD8)
```

也就是说：**做一块插在 E_FILT 插槽上的 6 段 LC 带通小板，就能和 HMC1023 在同一台机器上 A/B**，
不用动主板的射频设计。这就是"可证伪"的那条路。

但要如实标注两个缺口：

1. **固件从不切到外接档**。`Source_F7/src/main.c` 里 `FILTER_S0/S1` 只出现三处写操作
   （856/857、891/892、924/925 行），三处都是 `(S0,S1) = (1,0)`，作者注释 `//Filter Muxes set to bypass`；
   `case recieve_with_filter:` 是**空的**。固件冻结 ⇒ 我们不改代码。台架做法只能是
   先实测确认哪一档导电（CBTLV3253 的真值表是数据缺口），必要时用跳线/断开驱动，
   而不是拿信号去顶 MCU 的推挽输出。
2. **`74CBTLV3253` 是 Ron ≈ 5 Ω 级的逻辑开关**，不是 50 Ω 射频开关（同 §7）。
   插槽这条路本来就是"辅助/实验"性质，插损和隔离要以实测为准。

若要形成"性能更好"的证据，最小测量集（都需要仪器，缺一不可）：

| 量 | 怎么量 | 判据 |
|---|---|---|
| 各段通带插损、截止形状 | 信号发生器 + 功率计/频谱仪扫频，或直接用本机 VNA（桥+AD8302） | 通带 ≤ 1.5 dB、带外 ≥ 40 dB 起步 |
| 阻塞/互调 | 两音测试，读接收链路 IMD3；与 HMC1023 同一位置对照 | 谁的 IMD3/阻塞门限更高 |
| 镜像与 I/Q 不平衡 | 单音测镜像抑制 dB | 与滤波无关的那部分不要算进滤波收益 |
| 切换毛刺与建立 | 示波器看切换瞬间、静噪 | 继电器路线要看 ms 级空白 |
| 整机噪声地板/动态范围 | 50 Ω 端接与真天线两种状态下读数 | 这才是"动态范围更高"的正面证据 |

## 7. CMOS 还是继电器：合并结论

### 7.1 板上现状（网表 + BOM + 数据手册，逐条可查）

| 位号 | BOM 实订 | 供电 | 用在哪 | 手册级 Ron |
|---|---|---|---|---|
| U4 / U18 | **MAX4525CUB+** ×2（`OctopartBOM.csv:70`） | **V+ = +3V3** | I/Q 收发切换（`RX-I/Q_INAMP` ↔ `TX-I/Q_DRIVER`，`TRX_SWITCH` 控制） | **+3 V 时 500 Ω 级**（+5 V 时 200 Ω；单电源 +2～+12 V，轨到轨信号） |
| U86 | MAX4525CUB+ | V+ = +3V3_CPU | DAC 输出切扬声器/射频（`DAC_MUX`） | 同上 |
| U211 / U298 | 74CBTLV3253 | VCC = +3V3 | 滤波路径选择（HMC1023 / 外接插槽 / 旁路） | 5 Ω 级 |
| U16 / U24 / U30 | MASWSS0129TR（GaAs，停产） | — | **天线侧三级**：放大器旁路 / 阻抗桥插入 / 射频口切换 | 手册待核（GaAs 典型 <1 Ω） |
| 全板 | **无一颗信号继电器** | — | 391 件里只有 5 只 IRLML6401 P-MOSFET，且都用于**电源域开关**，不用于信号 | — |

⇒ **这里要更正我自己上一版的说法。** 我之前在替代提案 §4.1 路线 C 写"板上已有 CMOS，
证明 CMOS 可用"。这话**只对 I/Q 那些高阻电压节点成立**：MAX4525 手册只给两档 Ron
（+5 V 时 200 Ω、+3 V 时 500 Ω），本板 V+ 接 +3V3 ⇒ 落在**几百 Ω 量级**；
串进 50 Ω 线按 `20·log10(1+R/2Z0)` 就是 **≈15.6 dB 插损**（R=500 Ω 时），
而且信号摆幅被电源轨钳住 —— **它根本不能顶替天线侧的 GaAs**。
作者把 I/Q 用 CMOS、天线侧用 GaAs，是按阻抗分工的，不是随手选的。
（同一处更正已写进 `docs/PSDR-alternates-proposal.md` §4.1。）

### 7.2 各维度对照（HF 0.1–60 MHz，50 Ω 节点）

| 维度 | 信号继电器 | RF 级低阻 CMOS（1–2 Ω 档） | GaAs DPDT（现装） | 通用 CMOS（MAX4525 这类） |
|---|---|---|---|---|
| 插损 | 最低（接触电阻 mΩ 级，≈0.01 dB） | ≈0.1 dB 级 | ≈0.5–1 dB | **不可用**（Ron 决定，几十 Ω～几百 Ω） |
| HF 隔离 | 60–90 dB（真断开） | 30–40 dB（受关断电容限，随频率恶化） | 40–50 dB | 差 |
| 线性/功率 | 数瓦无障碍，无非线性 | 摆幅受轨压与 Ron 非线性，mW～百 mW 级 | 好（+20 dBm 级） | 只适合小信号高阻 |
| 速度 | ms 级（吸合+释放） | ns 级 | ns 级 | ns 级 |
| 控制 | 要线圈驱动（三极管/续流/上拉，线圈功耗） | MCU 直驱 | 需 5 V/负偏置类控制 | MCU 直驱 |
| 面积/高度 | 最大（TQ2 类 12×8×8 mm，壳内高度要核） | 最小（QFN 3×3） | 小 | 小 |
| 寿命/断电行为 | 机械 10⁶–10⁷ 次；可选磁保持（断电零功耗、可定义安全态） | 无寿命问题；断电不导通 | 无寿命问题 | 无 |
| 价格量级 | ¥2–4/只 | $0.5–1 | $1.6（**停产，断供是主风险**） | $2.3 |

### 7.3 结论（按节点分开拍，不给"一个通用答案"）

1. **波段选择（LC 带通组的 6 档）→ 继电器。** 换波段是低频、人工发起的事件，ms 级完全不痛；
   换来的是插损最低、HF 隔离最高、无 Ron·Coff 极点、不会被大信号压坏、也不怕 ESD。
   这正是 QCX / KX3 一类 HF 机的通行做法。真正要处理的是**壳内高度与线圈功耗**
   （两条都是可核对项：结构件在 `Hardware/Enclosure/`，本轮未解析）。
2. **收发切换（T/R）→ 看你要什么。** 要 CW 全插（QSK）和 VNA 快速扫频 ⇒ 必须 µs 级 ⇒
   **RF 级低阻 CMOS**（1 Ω 档，不是通用逻辑开关）或保留 GaAs；只要能半插（20–30 ms）⇒
   **继电器更干净**，还能把断电态定义在"接天线"，并对 LiPo 友好（磁保持）。
3. **I/Q 小信号节点（U4/U18/U86）→ 不动。** 现在的 500 Ω 级 CMOS 在这些高阻电压节点上是成立的，
   换低阻件会改变驱动电平与匹配，反而要重调 TX 增益——没有证据支持这个改动。
4. **天线侧三只 GaAs 的替代件**（断供驱动）：首选**继电器**（若接受 T/R 半插），
   次选**RF 级低阻 CMOS**；两者都要重新核插损/隔离/切换时序，都要改板，都不上游合并（口径同 §G-4）。

一句话合并版：**能慢的地方用继电器（波段、桥的插入），不能慢的地方才用 RF 级 CMOS；
通用逻辑 CMOS 只能待在 I/Q 那些高阻节点上。**

## 8. 短波段到底有没有人？为什么不干脆做 UV（用户的原始疑问）

先纠正一个用词：短波上的是**火腿（ham）**，不是黑客。他们不但存在，而且是这台机器的目标用户本体。

**HF 为什么值得背包客背：**
- 3.5–30 MHz 这段是**国际传播**：一根线 + 5 W 就能跨洲（CW/SSB/FT8），不依赖任何基础设施。
  离网、爬山、远征激活（POTA/SOTA/WWFF）、应急通信（Winlink 一类）都发生在这一段。
  1.8 MHz（160 m）名义上也属于 HF，但它不属于**便携**，见 §8.1。
- HF 难的是**接收机的动态范围**（广播台、业余台、强台就在带边），所以"能看瀑布图 + 能自己选带通"
  正好打在这个痛点上——这也解释了为什么"可变带通"和"VNA 测天线"会同时进需求表：
  在野外你得先知道天线谐振在哪，再决定听哪个频段。
- 6 m（50 MHz，偶发 E 传播）也在设计余量里：替代提案 §4.4 那张表就留了 30–60 MHz 一档。

**UV 为什么不适合当这台机器的本体：**
- UV 靠中继/视距，独立于电离层，本地通信和 APRS 更实用——**但那里已经有一台 $20 的对讲机**，
  开源 SDR 在这个价位打不赢，而且**固件只有 AM/USB/LSB/CW，没有 FM**（固件冻结，我们不写）。
- UV 发射要真的 PA（几瓦 @144/430 MHz 是一条独立链路），现板只有一只 SXB-2089Z 级增益块；
  天线侧开关、滤波、谐波抑制都得重做，那就不是"改板"而是"换板"。
- 讽刺的是：**接收端其实已经摸到 VHF**。现基线 `Source_F7/src/i2c.c:762-763`（旧镜像里是
  `si5338.c:638-641`，那只文件在 `PSDR_F7` 不存在）把调谐频率 ×2 送进
  Si5338（`//because the flipflops will devide it back down by 2`），并硬性限定在 5–350 MHz：

  ```c
  frequency *= 2;              // LO = 2 × RX
  if(frequency <   5000000) return;
  if(frequency > 350000000) return;
  ```

  ⇒ **固件实际允许 2.5–175 MHz**。**更正（2026-11-03 复核）**：这两个 `return` 在正常操作下
  **不可达**——UI 侧先把 VFO 夹住了（`Source_F7/src/main.c:1730-1731`，`PSDR_F7` 树是 :1766-1767）：
  作者本人的注释写着 `//Currently, the code can only corectly drive down to 5MHz/2 = 2.5MHz` 与
  `... up to 350MHz/2 = 175MHz`。所以 `setFreq()` 里那对 guard 只是第二道保险，
  **不是"静默失败让用户无从得知"**（我们早先的说法说过头了）。
  两个后果仍然成立：
  ① README 承诺的 0–35 MHz 里，**160 m（1.8–2.0 MHz）与 0.1–2.5 MHz 一段本来就调不到**；
  ② **2 m 段（144–148 MHz）已在允许范围内**（能不能真收还得看前端选择性与混频器上限 1 GHz），
  而 70 cm（430 MHz）需要 >175 MHz ⇒ 现在一定调不到。这条对"要不要做 UV"很有用：
  UV 的障碍不在 LO，而在**前端滤波、PA 和 FM 模式**。

### 8.1 那 160 m 调不到，到底损失了什么（用户 2026-11-03 判断，本文采纳）

**发射端几乎不损失。** 1.8 MHz 处 λ≈167 m：半波偶极要 **83 m**、λ/4 垂地 **42 m**；
背包里那 20 m 线只有 0.12λ，5 m 鞭按 `Rr≈40(h/λ)²` 估算不到 1 Ω（效率个位数百分比），
再叠上白天被 D 层吸收、只有夜间才是低信号 SSB/CW 的玩法，还有大气噪声与中波谐波。
**"便携 + 160 m 发射"这个组合本来就不成立**——同用户那台日版 IC-705 的取舍逻辑：
机器按主力频段配，160 m 是基地台带真天线系统干的事。真正适合背包的是
40 m 的 21 m 偶极、20 m 的 11 m，以及 15/10 m 那几根可以直接裁短的线。

**真正丢掉的是 0.1–2.5 MHz 的接收。** 接收不需要效率，一根长线就够，而那段正好是
中波广播 DX（0.5–1.7 MHz）、135 kHz WSPR、NDB/海上信标——**这是 SWL 价值，不是 QRP 价值**。

**措辞边界（别把这条说过头）**：只能写"**固件不允许 2.5 MHz 以下**"，**不能**写
"硬件本来能做到、只是被代码挡了"。`SY100EP52V` 二分频的**最低**输入频率、
巴伦 `WBC2-1TL` 的低频下限都还没查完（GaAs/SiGe 分频件普遍有最低频率约束），
硬件地板很可能本来就在几 MHz 量级 ⇒ 列入待核数据缺口（`docs/PSDR-open-data-gaps.md`）。

⇒ 所以对上游，这条的正确形态**不是**"请支持 160 m"，也不是"越界没报错"（VFO 已经夹住了），而是
"**README 写 0–35 MHz，而代码自己的注释写 2.5–175 MHz（`main.c:1730-1731`），哪个算数**"——
一个规格与实现不一致的问题。（是否真发这条 issue 见 `docs/WO-psdr-takeover.md` §I-3/§I-4：
本轮结论把它削弱成"只问文档口径"，我倾向**先不发**。）
- 所以答案不是"HF 还是 UV 二选一"，而是：**本体保持 HF（那才是这台机器有差异化的地方），
  VHF/UHF 走 §4.3 那条外置变频器 + 原始 I/Q 焊盘的路**，用一块小板换一个频段，
  而不是把主板做成全频段可编程前端。

### 8.2 各频段的**真实**极限（本轮查到的，全部标依据强度）

用户让"查一下具体极限"。逐件结论：

| 链路位置 | 件 | 手册级可用频段 | 依据强度 | 对 HF 的意义 |
|---|---|---|---|---|
| 射频增益 U304 | BOM 实订 `SXB-2089Z`（同族 **SBB2089Z**） | **50–850 MHz**（SIRENZA 手册标题即"50–850 MHz"；Qorvo 参数页 min 50 / max 850 MHz） | 厂商参数页/手册标题 | **HF 全段（0.1–35 MHz）没有增益** |
| 同上（封装名） | `MMIC-AMP_HMC482ST` → HMC482ST89 | **DC–5 GHz**，但要求 **单电源 +6～+12 V** | 厂商转载页 | 名字是化石：本板供电是 `+5V_AMP`，电气上按 5 V 件（SBB 族）设计 |
| 混频 L41/L81 | `MIXER_DIODE-RING_ADE-2ASK` | 1–1000 MHz（本文早先已记录） | 手册级 | 1.8 MHz RX + 3.6 MHz LO 在限内；0.5–1.7 MHz（中波）**LO 出界** |
| 巴伦 L39/L82 | Coilcraft `WBC2-1TL`（1:2，WBC 系列） | 族表 **0.4–600 MHz**（WBC1-1L 明确 0.400–600；WBC2-1TL 逐档待核） | 手册族表 | 1.8 MHz 没问题；中波在下限附近 |
| 正交分频 U279/U280 | `SY10EP52V` | **最低输入频率未查到** | 缺口 | 固件那个 5 MHz 地板很可能就是它的保护带，不是笔误 |
| 频率合成 U241 | `SI5338` | CLK0 输出下限约 0.16 MHz（待核） | 待核 | 不是限制项 |
| VNA 检波 U314 | `AD8302` | 0.1–500 MHz（待核） | 待核 | VNA 在 HF 可用；上限由混频器 1 GHz 说话 |

**U304 这条要连带看固件才完整**（`Source_F7/src/main.c`，全部代码级核实）：

```
enum signalPaths (:811-820)  7 个状态
  0 recieve_no_filter            有实现
  1 recieve_with_filter          空桩
  2 transmit_no_amp_no_filter    有实现
  3 transmit_with_amp_no_filter  有实现，但见下
  4 tramsmit_with_amp_with_filter 空桩（枚举本身拼错 tramsmit）
  5 vna_reflected                空桩
  6 vna_through                  空桩
default: 分支被注释掉（:937-940）⇒ 非法值静默什么都不做
唯一两个调用点：:1103 TX 用 no_amp；:1104 的 with_amp 那行是注释掉的  RX 用 :1115 no_filter
三个已实现分支里 AMP_SWITCH_A 一律写 0（bypass），包括 :905 注释写 "Amp relay set to on" 的那一支
F4 树没有 signalPath()，但 :958 `=1 //Route through amp`、:967 `=0 //Bypass amp` ⇒ F7 那处是笔误级矛盾
```

⇒ **两条独立结论**：
1. **射频端没有任何一级增益**（基带那一级另说）——唯一候选件是 50–850 MHz 的增益块，而代码也从没把
   它接进路径。这不是"配置没写全"，是**器件选型与频段不符 + 开关状态从没置成插入**两件事叠加。
   必须写清以免说过头：**混频之后是有增益的**（`U255/U272` 两只 `MCP6N11` 仪表放大器做 RX I/Q
   基带放大，增益由 `U15 = MAX5388` 数字电位器设定，网 `RX-I_UNFILTERED/OP_GAIN_A_L`、
   `RX-Q_UFILTERED/OP_GAIN_B_L` 直接证这条链），所以"整机完全没放大"是错的；
   准确说法是"**天线侧没有 RF 前放**"——影响的是噪声系数与镜像抑制，不是能不能出声。
   #16 的标题就叫"Enable Pre-Amp in Firmware"（作者本人 2021-12-07 也说"值得挂个外置前放试试"、
   "PSDR 几乎完全没有放大设计"）——**光在固件里打开它，HF 也不会有 RF 增益**。
2. **VNA 的两条路径（`vna_reflected`/`vna_through`）在固件里是空的**。VNA 既然定为保留项（§3），
   那"要让它能用"缺的就是这两段继电器状态与扫描流程，不是硬件。

顺带记一条与 §3 保留 VNA 相关的现场信息：#16 楼里 2025-10-30 已有 DM2NT 问 maintainer
"MASWSS0129 在欧洲已买不到"，作者回"缺哪些件可以告诉我，我这里还有不少存货"——
**断供件的短期来源可能就在作者手里**，这条比我们自己找 pin-to-pin 更省事（只是问，不承诺采购）。

## 9. 与"其他开源 HF SSB"的关系（待用户给文件）

用户提到群里有别的开源 HF SSB 方案文件，会另行提供。收到后再逐个核对（许可、成本、模式、
是否自带屏/自带 VNA/自带电池）。在此之前，只记录一条判据供对照：**纯 HF SSB 收发板这一类
开源方案普遍比 PSDR 的 BOM 便宜，但它们通常是"接电脑/接手机"的前端或套件，
没有"自带屏 + 瀑布 + 天线 VNA + 电池"这个组合**——而这组合正是 §1 里作者写的动机，
也是 §3 决定 VNA 不能砍的原因。若某个开源件已把这套做全，那就要重新讨论"我们改这板图什么"。

## 10. 不做的清单（写死，避免下次又讨论一遍）

- 射频直接采样（成本跳档；见替代提案 §4.5）；
- 引入 RTOS / 更换 MCU 平台（`docs/PSDR-firmware-survey.md` 架构判断）；
- 内置多波段"可升级"前端（本文 §4.3）；
- 让固件承担可编程滤波器组的复杂调度（固件冻结；只出"波段↔控制线"表）；
- **砍 VNA**（用户 2026-11-03 否决，理由见 §3）；
- 把国产化/替代件写进上游 issue、PR 或评论（口径 `docs/WO-psdr-takeover.md` §G-4/§G-5）。
