fe1iscurc0r/PSDR/Hardware/BOMs/PSDR_2.6.1/value_threeway_sch_asc_bom.csv

refdes | asc | bom_2_6_1 | schematic | status
C10 | 100N | 100N | 100N | agree
C103 | 10u | 10u | 10u | agree
C104 | 10u | 10u | 10u | agree
C106 | 10u | 10u | 10u | agree
C107 | 10u | 10u | 10u | agree
C108 | 10u | 10u | 10u | agree
C110 | 1U | 1U | 1U | agree
C111 | 100N | 100N | 100N | agree
C115 | 4U7 | 4U7 | 4U7 | agree
C118 | 100N | 100N | 100N | agree
C119 | 100N | 100N | 100N | agree
C120 | 4U7 | 4U7 | 4U7 | agree
C123 | 100N | 100N | 100N | agree
C125 | 2U2 | 2U2 | 2U2 | agree
C129 | 100N | 100N | 100N | agree
C13 | 100N | 100N | 100N | agree
C132 | 1N | 1N | 1N | agree
C134 | 1N | 1N | 1N | agree
C135 | 10N | 10N | 10N | agree
C137 | 6U8 | 6U8 | 6U8 | agree
C139 | 100N | 100N | 100N | agree
C142 | 220u | 220u | 220u | agree
C143 | 220u | 220u | 220u | agree
C147 | 10u0 | 10u | 10u0 | agree
C148 | 1U | 1U | 1U | agree
C149 | 1U | 1U | 1U | agree
C151 | 220u | 220u | 220u | agree
C152 | 220u | 220u | 220u | agree
C154 | 220u | 220u | 220u | agree
C155 | 10u0 | 10u | 10u0 | agree
C156 | 10u | 10u | 10u | agree
C157 | 100N | 100N | 100N | agree
C158 | 220u | 220u | 220u | agree
C159 | 4u7 | 4U7 | 4u7 | agree
C160 | 4u7 | 4U7 | 4u7 | agree
C163 | 220u | 220u | 220u | agree
C17 | 100n | 100N | 100n | agree
C171 | 1U | 1U | 1U | agree
C173 | 1U | 1U | 1U | agree
C179 | 6P | 6P | 6P | agree
C180 | 8P | 8P | 8P | agree
C181 | 8P | 8P | 8P | agree
C184 | 6P | 6P | 6P | agree
C186 | 2p2 | 2p2 | 2p2 | agree
C188 | 10u0 | 10u | 10u0 | agree
C191 | 10u0 | 10u | 10u0 | agree
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
L82 |  |  |  | no-sch-value
L84 |  |  |  | no-sch-value
MICROSD |  |  |  | no-sch-value
NRST |  |  |  | no-sch-value
Q126 |  |  |  | no-sch-value
Q178 |  |  |  | no-sch-value
Q208 |  |  |  | no-sch-value
Q246 |  |  |  | no-sch-value
Q5 |  |  |  | no-sch-value
RST |  |  |  | no-sch-value
SPEAKER |  |  |  | no-sch-value
U114 |  |  |  | no-sch-value
U121 |  |  |  | no-sch-value
U131 |  |  |  | no-sch-value
U15 |  |  |  | no-sch-value
U16 |  |  |  | no-sch-value
U161 |  |  |  | no-sch-value
U172 |  |  |  | no-sch-value
U18 |  |  |  | no-sch-value
U185 |  |  |  | no-sch-value
U189 |  |  |  | no-sch-value
U199 |  |  |  | no-sch-value
U216 |  |  |  | no-sch-value
U227 |  |  |  | no-sch-value
U24 |  |  |  | no-sch-value
U287 |  |  |  | no-sch-value
U30 |  |  |  | no-sch-value
U304 |  |  |  | no-sch-value
U32 |  |  |  | no-sch-value
U37 |  |  |  | no-sch-value
U4 |  |  |  | no-sch-value
U47 |  |  |  | no-sch-value
U58 |  |  |  | no-sch-value
U85 |  |  |  | no-sch-value
U86 |  |  |  | no-sch-value
USB |  |  |  | no-sch-value
VNA-OUT |  |  |  | no-sch-value
Y183 |  |  |  | no-sch-value
D102 |  |  | LCD_MOSI | sch-is-part-type
L105 | 10u | 10u | ISM-0805-10U | sch-is-part-type
L141 | 10u | 10u | ISM-0805-10U | sch-is-part-type
U211 |  |  | 74CBTLV3253 | sch-is-part-type
U255 |  |  | MCP6N11 | sch-is-part-type
U272 |  |  | MCP6N11 | sch-is-part-type
U279 |  |  | SY10EP52V | sch-is-part-type
U280 |  |  | SY10EP52V | sch-is-part-type
U298 |  |  | 74CBTLV3253 | sch-is-part-type
Y182 |  |  | CRYSTAL3225 | sch-is-part-type
Y237 |  |  | CRYSTAL3225 | sch-is-part-type
R164 | 270K | 240K | 270K | bom-alone
R113 | 383K | 402K | 402K | layout-alone
R14 | 100R | 68R | 68R | layout-alone
R268 | 1k0 | 100R | 100R | layout-alone
R6 | 100R | 180R | 180R | layout-alone
R68 | 1k0 | 0R | 0R | layout-alone
R69 | 1k0 | 0R | 0R | layout-alone
R72 | 1k0 | DNS | DNS | layout-alone
R75 | 1k0 | 0R | 0R | layout-alone
R76 | 1k0 | 0R | 0R | layout-alone
R79 | 1k0 | DNS | DNS | layout-alone
D44 |  |  | 1 | conflict
U241 |  |  | SI5338 | conflict
U253 |  |  | AD8131 | conflict
U260 |  |  | AD8131 | conflict
U314 |  |  | AD8302 | conflict
L34 |  | 10u | ISM-0805-10U | all-differ
