fe1iscurc0r/PSDR/Hardware/BOMs/PSDR_2.6.1/BOM_refdes_crosscheck.csv

refdes | bom_2_6 | bom_2_6_1 | asc_value | asc_comment | flags
+ |  |  |  |  | no-value-either
- |  |  |  |  | no-value-either
ANT/VNA-IN |  |  |  |  | no-value-either
BOOT |  |  |  |  | no-value-either
Battery connector |  |  |  |  | no-value-either
C10 | 100N | 100N | 100N
C103 | 10u | 10u | 10u
C104 | 10u | 10u | 10u
C106 | 10u | 10u | 10u
C107 | 10u | 10u | 10u
C108 | 10u | 10u | 10u
C110 | 1U | 1U | 1U
C111 | 100N | 100N | 100N
C115 | 4U7 | 4U7 | 4U7
C118 | 100N | 100N | 100N
C119 | 100N | 100N | 100N
C120 | 4U7 | 4U7 | 4U7
C123 | 100N | 100N | 100N
C125 | 2U2 | 2U2 | 2U2
C129 | 100N | 100N | 100N
C13 | 100N | 100N | 100N
C132 | 1N | 1N | 1N
C134 | 1N | 1N | 1N
C135 | 10N | 10N | 10N
C137 | 6U8 | 6U8 | 6U8
C139 | 100N | 100N | 100N
C142 | 220u | 220u | 220u
C143 | 220u | 220u | 220u
C147 | 10u | 10u | 10u0
C148 | 1U | 1U | 1U
C149 | 1U | 1U | 1U
C151 | 220u | 220u | 220u
C152 | 220u | 220u | 220u
C154 | 220u | 220u | 220u
C155 | 10u | 10u | 10u0
C156 | 10u | 10u | 10u
C157 | 100N | 100N | 100N
C158 | 220u | 220u | 220u
C159 | 4U7 | 4U7 | 4u7
C160 | 4U7 | 4U7 | 4u7
C163 | 220u | 220u | 220u
C17 | 100N | 100N | 100n | 1nF
C171 | 1U | 1U | 1U
C173 | 1U | 1U | 1U
C179 | 6P | 6P | 6P
C180 | 8P | 8P | 8P
C181 | 8P | 8P | 8P
C184 | 6P | 6P | 6P
C186 | 2p2 | 2p2 | 2p2
C188 | 10u | 10u | 10u0
C191 | 10u | 10u | 10u0
C192 | 10u | 10u | 10u0
C193 | 100N | 100N | 100N
C195 | 470N | 470N | 470N
C197 | 470N | 470N | 470N
C20 | 100N | 100N | 100N
C203 | 470N | 470N | 470N
C205 | 470N | 470N | 470N
C209 | 100N | 100N | 100n | 1nF
C21 | 100N | 100N | 100N
C210 | 100N | 100N | 100n | 1nF
C212 | 100N | 100N | 100n | 1nF
C213 | 1U | 1U | 1u0 | 1nF
C214 | 6U8 | 6U8 | 6U8
C215 | 10N | 10N | 10N
C217 | 100N | 100N | 100N
C218 | 100N | 100N | 100N
C220 | 1N | 1N | 1N
C223 | 1N | 1N | 1N
C225 | 6U8 | 6U8 | 6U8
C226 | 10N | 10N | 10N
C228 | 100N | 100N | 100N
C229 | 100N | 100N | 100N
C231 | 1N | 1N | 1N
C235 | 1N | 1N | 1N
C238 | 100N | 100N | 100n | 1nF
C239 | 100N | 100N | 100n | 1nF
C240 | 100N | 100N | 100n | 1nF
C242 | 100N | 100N | 100n | 1nF
C243 | 100N | 100N | 100n | 1nF
C247 | 10u | 10u | 10u0
C248 | 100N | 100N | 100N
C251 | 22U | 22U | 22U
C252 | 22U | 22U | 22U
C256 | 100N | 100N | 100N
C257 | 2U2 | 2U2 | 2U2
C258 | 10u | 10u | 10u0
C259 | 100N | 100N | 100N
C26 | 100N | 100N | 100N
C262 | 22U | 22U | 22U
C263 | 22U | 22U | 22U
C265 | 100N | 100N | 100n | 1nF
C267 | 100N | 100N | 100n | 1nF
C269 | 100N | 100N | 100n | 1nF
C27 | 100N | 100N | 100N
C275 | 100N | 100N | 100N
C276 | 2U2 | 2U2 | 2U2
C277 | 100N | 100N | 100n | 1nF
C278 | 100p | 100p | 100p | 1nF
C281 | 100p | 100p | 100p | 1nF
C282 | 100N | 100N | 100n | 1nF
C283 | 100N | 100N | 100n | 1nF
C284 | 100N | 100N | 100n | 1nF
C288 | 1U | 1U | 1u0 | 1nF
C289 | 100N | 100N | 100n | 1nF
C290 | 100N | 100N | 100n | 1nF
C291 | 100N | 100N | 100n | 1nF
C292 | 100N | 100N | 100n | 1nF
C293 | 100N | 100N | 100n | 1nF
C294 | 100N | 100N | 100n | 1nF
C295 | 100N | 100N | 100n | 1nF
C3 | 100N | 100N | 100n | 1nF
C301 | 47u | 47u | 47u
C302 | 100N | 100N | 100N
C303 | 100N | 100N | 100N
C305 | 100N | 100N | 100N
C306 | 100N | 100N | 100N
C307 | OPEN | OPEN | OPEN
C309 | 1N | 1N | 1N
C31 | 100N | 100N | 100N
C315 | 1N | 1N | 1N
C316 | 100p | 100p | 100P
C317 | 100N | 100N | 100N
C318 | 1N | 1N | 1N
C320 | OPEN | OPEN | OPEN
C322 | 1N | 1N | 1N
C323 | 220u | 220u | 220u
C326 | 220u | 220u | 220u
C33 | 100N | 100N | 100N
C35 | 100N | 100N | 100N
C36 | 100N | 100N | 100n | 1nF
C38 | 100N | 100N | 100N
C40 | 100N | 100N | 100n | 1nF
C42 | 220u | 220u | 220u
C43 | 220u | 220u | 220u
C45 | 6U8 | 6U8 | 6U8
C46 | 10N | 10N | 10N
C48 | 100N | 100N | 100N
C49 | 100N | 100N | 100N
C51 | 1N | 1N | 1N
C54 | 1N | 1N | 1N
C56 | 6U8 | 6U8 | 6U8
C57 | 10N | 10N | 10N
C59 | 100N | 100N | 100N
C60 | 100N | 100N | 100N
C62 | 1N | 1N | 1N
C65 | 1N | 1N | 1N
C7 | 2U2 | 2U2 | 2U2
C71 | 100N | 100N | 100n | 1nF
C73 | 100N | 100N | 100n | 1nF
C78 | 100N | 100N | 100n | 1nF
C8 | 1N | 1N | 1N
C80 | 100N | 100N | 100n | 1nF
C83 | 10u | 10u | 10u0
C87 | 100N | 100N | 100N
C88 | 100N | 100N | 100N
C89 | 10u | 10u | 10u
C9 | 100p | 100p | 100P
C91 | 33nF | 33nF | 33nF
C93 | 3300pF | 3300pF | 3300pF
C95 | 2U2 | 2U2 | 2U2
C96 | 100N | 100N | 100N
CLK |  |  |  |  | no-value-either
D100 |  |  |  | LED1 | no-value-either
D101 |  |  |  |  | no-value-either
D102 |  |  |  |  | no-value-either
D44 |  |  |  |  | no-value-either
EARPHONE |  |  |  |  | no-value-either
Encoder |  |  |  |  | no-value-either
GPS_ANTENNA |  |  |  |  | no-value-either
IO |  |  |  |  | no-value-either
J153 |  |  |  |  | no-value-either
J170 |  |  |  |  | no-value-either
L105 | 10u | 10u | 10u
L109 |  |  |  |  | no-value-either
L11 |  |  |  |  | no-value-either
L141 | 10u | 10u | 10u
L19 |  |  |  |  | no-value-either
L34 | 10u | 10u |  |  | no-asc-value
L39 |  |  |  |  | no-value-either
L41 |  |  |  |  | no-value-either
L81 |  |  |  |  | no-value-either
L82 |  |  |  |  | no-value-either
L84 |  |  |  |  | no-value-either
MICROSD |  |  |  |  | no-value-either
NRST |  |  |  |  | no-value-either
Q126 |  |  |  |  | no-value-either
Q178 |  |  |  |  | no-value-either
Q208 |  |  |  |  | no-value-either
Q246 |  |  |  |  | no-value-either
Q5 |  |  |  |  | no-value-either
R1 | 100k | 100k | 100k | 1M
R112 | 100k | 100k | 100K | 1M
R113 | 402K | 402K | 383K | 1M | ASC!=BOM2.6.1
R116 | 10K | 10K | 10K | 1M
R117 | 0R | 0R | 0R0 | 1M
R12 | 10R 1/4W | 10R 1/4W | 10R 1/4W | 1M
R122 | 1K | 1K | 1k0 | 1M
R124 | 100k | 100k | 100k | 1M
R127 | 10K | 10K | 10K | 1M
R128 | 1K | 1K | 1K | 1M
R130 | 100k | 100k | 100K | 1M
R133 | 10K | 10K | 10K | 1M
R136 | 10K | 10K | 10K | 1M
R14 | 100R | 68R | 100R |  | ASC!=BOM2.6.1|2.6->2.6.1-changed
R140 | 100k | 100k | 100K | 1M
R144 | 100k | 100k | 100K | 1M
R145 | 100k | 100k | 100K | 1M
R146 | 1K | 1K | 1K | 1M
R150 | 1K | 1K | 1K | 1M
R162 | 1K | 1K | 1K | 1M
R164 | 270K | 240K | 270K | 1M | ASC!=BOM2.6.1|2.6->2.6.1-changed
R165 | 100k | 100k | 100K | 1M
R167 | 1K | 1K | 1K | 1M
R168 | 10K NTC | 10K NTC | 10K NTC | 1M
R169 | 0R | 0R | 0R0 | 1M
R174 | 100k | 100k | 100K | 1M
R175 | 100k | 100k | 100K | 1M
R176 | 100k | 100k | 100k | 1M
R177 | 1K | 1K | 1k0 | 1M
R187 | 5K | 5K | 5K | 1M
R190 | 15K | 15K | 15K | 1M
R194 | 12K1 | 12K1 | 12K1 | 1M
R196 | 12K1 | 12K1 | 12K1 | 1M
R198 | 12K1 | 12K1 | 12K1 | 1M
R2 | 1K | 1K | 1k0 | 1M
R200 | 1K | 1K | 1K | 1M
R201 | 1K | 1K | 1K | 1M
R202 | 1K | 1K | 1K | 1M
R204 | 12K1 | 12K1 | 12K1 | 1M
R206 | 1K | 1K | 1k0 | 1M
R207 | 100k | 100k | 100k | 1M
R219 | 10K | 10K | 10K | 1M
R22 | 50R | 50R | 50R
R221 | 100k | 100k | 100K | 1M
R222 | 100k | 100k | 100K | 1M
R224 | 10K | 10K | 10K | 1M
R23 | 50R | 50R | 50R
R230 | 10K | 10K | 10K | 1M
R232 | 100k | 100k | 100K | 1M
R234 | 100k | 100k | 100K | 1M
R236 | 10K | 10K | 10K | 1M
R244 | 1K | 1K | 1K0 | 1M
R245 | 100k | 100k | 100k | 1M
R249 | 24R9 | 24R9 | 24R9 | 1M
R25 | 50R | 50R | 50R
R250 | 1K | 1K | 1K | 1M
R254 | 1K | 1K | 1K | 1M
R261 | 24R9 | 24R9 | 24R9 | 1M
R264 | 1K | 1K | 1K | 1M
R266 | 1K | 1K | 1K | 1M
R268 | 100R | 100R | 1k0 | 1M | ASC!=BOM2.6.1
R270 | 1K | 1K | 1k0 | 1M
R271 | 1K | 1K | 1k0 | 1M
R273 | 1K | 1K | 1k0 | 1M
R274 | 1K | 1K | 1k0 | 1M
R28 | 1K | 1K | 1K | 1M
R285 | 100k | 100k | 100k | 1M
R286 | 100k | 100k | 100k | 1M
R29 | 1K | 1K | 1K | 1M
R296 | 100k | 100k | 100k | 1M
R297 | 100k | 100k | 100k | 1M
R299 | 10K | 10K | 10K | 1M
R300 | 10K | 10K | 10K | 1M
R308 | 50R | 50R | 50R | 1M
R310 | 0R | 0R | 0R | 1M
R311 | 0R | 0R | 0R | 1M
R312 | 0R | 0R | 0R | 1M
R313 | 0R | 0R | 0R | 1M
R319 | 0R | 0R | 0R | 1M
R321 | 50R | 50R | 50R | 1M
R324 | 22R1 | 22R1 | 22R1 | 1M
R325 | 22R1 | 22R1 | 22R1 | 1M
R50 | 10K | 10K | 10K | 1M
R52 | 100k | 100k | 100K | 1M
R53 | 100k | 100k | 100K | 1M
R55 | 10K | 10K | 10K | 1M
R6 | 100R | 180R | 100R |  | ASC!=BOM2.6.1|2.6->2.6.1-changed
R61 | 10K | 10K | 10K | 1M
R63 | 100k | 100k | 100K | 1M
R64 | 100k | 100k | 100K | 1M
R66 | 10K | 10K | 10K | 1M
R67 | 1K | 1K | 1k0 | 1M
R68 | 0R | 0R | 1k0 | 1M | ASC!=BOM2.6.1
R69 | 0R | 0R | 1k0 | 1M | ASC!=BOM2.6.1
R70 | 1K | 1K | 1k0 | 1M
R72 | DNS | DNS | 1k0 | 1M | ASC!=BOM2.6.1
R74 | 1K | 1K | 1k0 | 1M
R75 | 0R | 0R | 1k0 | 1M | ASC!=BOM2.6.1
R76 | 0R | 0R | 1k0 | 1M | ASC!=BOM2.6.1
R77 | 1K | 1K | 1k0 | 1M
R79 | DNS | DNS | 1k0 | 1M | ASC!=BOM2.6.1
R90 | 30K | 30K | 30K
R92 | 10K | 10K | 10K
R94 | 6.8K | 6.8K | 6.8K
R97 | 255R | 255R | 255R | 1M
R98 | 255R | 255R | 255R | 1M
R99 | 255R | 255R | 255R | 1M
RST |  |  |  |  | no-value-either
SPEAKER |  |  |  |  | no-value-either
U114 |  |  |  |  | no-value-either
U121 |  |  |  |  | no-value-either
U131 |  |  |  |  | no-value-either
U15 |  |  |  |  | no-value-either
U16 |  |  |  |  | no-value-either
U161 |  |  |  |  | no-value-either
U172 |  |  |  |  | no-value-either
U18 |  |  |  |  | no-value-either
U185 |  |  |  |  | no-value-either
U189 |  |  |  |  | no-value-either
U199 |  |  |  |  | no-value-either
U211 |  |  |  |  | no-value-either
U216 |  |  |  |  | no-value-either
U227 |  |  |  |  | no-value-either
U24 |  |  |  |  | no-value-either
U241 |  |  |  |  | no-value-either
U253 |  |  |  |  | no-value-either
U255 |  |  |  |  | no-value-either
U260 |  |  |  |  | no-value-either
U272 |  |  |  |  | no-value-either
U279 |  |  |  |  | no-value-either
U280 |  |  |  |  | no-value-either
U287 |  |  |  |  | no-value-either
U298 |  |  |  |  | no-value-either
U30 |  |  |  |  | no-value-either
U304 |  |  |  |  | no-value-either
U314 |  |  |  |  | no-value-either
U32 |  |  |  |  | no-value-either
U37 |  |  |  |  | no-value-either
U4 |  |  |  |  | no-value-either
U47 |  |  |  |  | no-value-either
U58 |  |  |  |  | no-value-either
U85 |  |  |  |  | no-value-either
U86 |  |  |  |  | no-value-either
USB |  |  |  |  | no-value-either
VNA-OUT |  |  |  |  | no-value-either
Y182 |  |  |  | 26MHz | no-value-either
Y183 |  |  |  |  | no-value-either
Y237 |  |  |  | 26MHz | no-value-either
