fe1iscurc0r/PSDR/Hardware/BOMs/PSDR_2.6.1/PSDR2.6.1_BOM_flat.csv

# flattened from PSDR2.6.1_BOM.xls (BIFF version 1c032a2c7de25b2b80a692c5f857d970640147a2e02419634ef4f1a59fddfb19)
item_no. | ref_des | qty_per_unit | type | vendor | vendor_part_# | mfg | mfg_part_# | value |  | cost_x1 | cost_x10 | cost_x100 | run_tot_x1
1 | -,+,CLK,IO,NRST | 2 | 0.1"_1PIN * 5 for programming header, and encoder board | Digikey | WM50018-05-ND |  |  |  | Only One will be populated per board (give the second one to me) | 0.51 | 0.482 | 0.3693 | 1.02
2 | ANT/VNA-IN,VNA-OUT | 2 | SMA_BOARD_EDGE | Digikey | J629-ND |  |  |  |  | 7.15 | 6.37 | 4.68 | 14.3
3 | BOOT,RST | 2 | BUTTON_B3U-1000P-B | Digikey | SW1143CT-ND |  |  |  |  | 1.25 | 1.201 | 0.9064 | 2.5
4 | C3,10,13,17,20,21,26,27,31,33,35,36,38,40,48,49,59,60,71,73,78,80,87,88,96,111,118,119,123,129,139,157,193,209,210,212,217,218,228,229,238-240,242,243,248,256,259,265,267,269,275,277,282-284,289-295,302,303,305,306,317 | 68 | CAP_0603 | Digikey | 490-1532-1-ND |  |  | 100N |  | 0.1 | 0.019000000000000003 | 0.0086 | 6.800000000000001
5 | C9,278,281,316 | 4 | CAP_0603 | Digikey | 1276-1008-1-ND |  |  | 100p |  | 0.1 | 0.025 | 0.0116 | 0.4
6 | C46,57,135,215,226 | 5 | CAP_0603 | Digikey | 490-1512-1-ND |  |  | 10N |  | 0.1 | 0.019000000000000003 | 0.0085 | 0.5
7 | C83,89,103,104,106-108,147,155,156,188,191,192,247,258 | 15 | CAP_0805 | Digikey | 1276-1113-1-ND |  |  | 10u |  | 0.27 | 0.183 | 0.0932 | 4.050000000000001
8 | C8,51,54,62,65,132,134,220,223,231,235,309,315,318,322 | 15 | CAP_0603 | Digikey | 490-1494-1-ND |  |  | 1N |  | 0.1 | 0.02 | 0.0091 | 1.5
9 | C110,148,149,171,173,213,288 | 7 | CAP_0603 | Digikey | 1276-1946-1-ND |  |  | 1U |  | 0.1 | 0.041 | 0.0187 | 0.7000000000000001
10 | C42,43,142,143,151,152,154,158,163,323,326 | 11 | CSM-X5R-22U-20P-10V-1210 | Digikey | 1276-3375-1-ND |  |  | 220u | Do I really want to use these? They cost a lot! | 1.65 | 1.351 | 0.9558 | 18.15
11 | C251,252,262,263 | 4 | CAP_0603 | Digikey | 1276-1193-1-ND |  |  | 22U | REALLY?!!, if I can get 22U in an 0603 why am I bothering with 0805s for 10u? | 0.25 | 0.205 | 0.1024 | 1
12 | C186 | 0 | CAP_0603 | Digikey | 1276-1084-1-ND |  |  | 2p2 |  | 0.1 | 0.037000000000000005 | 0.017 | 0
13 | C7,95,125,257,276 | 5 | CAP_0603 | Digikey | 1276-1134-1-ND |  |  | 2U2 |  | 0.17 | 0.115 | 0.0546 | 0.8500000000000001
14 | C93 | 1 | CAP_0603 | Digikey | 1276-2030-1-ND |  |  | 3300pF |  | 0.1 | 0.036000000000000004 | 0.0165 | 0.1
15 | C91 | 1 | CAP_0603 | Digikey | 490-12541-1-ND |  |  | 33nF |  | 0.1 | 0.07100000000000001 | 0.0325 | 0.1
16 | C195,197,203,205 | 4 | CAP_0603 | Digikey | 1276-1062-1-ND |  |  | 470N |  | 0.1 | 0.066 | 0.030300000000000004 | 0.4
17 | C301 | 1 | CSM-X5R-47U-20P-6V3-0805 | Digikey | 1276-2420-1-ND |  |  | 47u |  | 0.77 | 0.7370000000000001 | 0.35750000000000004 | 0.77
18 | C115,120,159,160 | 4 | CAP_0603 | Digikey | 490-3297-1-ND |  |  | 4U7 |  | 0.11 | 0.078 | 0.035800000000000005 | 0.44000000000000006
19 | C179,184 | 2 | CAP_0603 | Digikey | 1276-2133-1-ND |  |  | 6P |  | 0.1 | 0.042 | 0.0193 | 0.2
20 | C45,56,137,214,225 | 5 | CAP_0603 | Digikey | 445-14209-1-ND |  |  | 6U8 |  | 0.48 | 0.42 | 0.21 | 2.4000000000000004
21 | C180,181 | 2 | CAP_0603 | Digikey | 1276-2140-1-ND |  |  | 8P |  | 0.1 | 0.042 | 0.0193 | 0.2
22 | C307,320 | 2 | CAP_0603 | Digikey | NA |  |  | OPEN | DNP by design - the footprints are still on the board, they were never deleted. Both are shunts: C307 = U314.8 to GND, C320 = GND to U314.14. Neither sits in series with anything, so no 0 ohm jumper is needed. |  |  |  | 0
23 | D100 | 1 | LED_0603 WHITE | Digikey | 475-2831-1-ND |  |  |  |  | 0.35 | 0.256 | 0.167 | 0.35
24 | D101 | 1 | LED_0603 RED | Digikey | 475-2512-1-ND |  |  |  |  | 0.27 | 0.198 | 0.1044 | 0.27
25 | D102 | 1 | LED_0603 ORANGE | Digikey | 511-1577-1-ND |  |  |  |  | 0.34 | 0.264 | 0.14400000000000002 | 0.34
26 | D44 | 1 | DIODE-SMA | Digikey | MBRA340T3GOSCT-ND |  |  |  |  | 0.46 | 0.394 | 0.29390000000000005 | 0.46
27 | EARPHONE | 1 | 3.5MM_PHONO_4P_3SW_SJ-42617-SMT | Digikey | CP-43617SJCT-ND |  |  |  | Buy but do not populate | 1.86 | 1.443 | 1.1011 | 1.86
28 | GPS_ANTENNA | 1 | GPS_ANTENNA-W3062A | Digikey | 553-2579-1-ND | Pulse Electronics Corporation | W3062A |  |  | 1.7000000000000002 | 1.499 | 1.1844 | 1.7000000000000002
29 | J153 | 1 | 0.1"_6P_HEADER_DUAL_ENTRY_1241152-6 | Digikey | A107015CT-ND |  |  |  |  | 2.43 | 2.19 | 1.87 | 2.43
30 | J170 | 1 | SPI_LCD_BOTTOM_ENTRY | Digikey | A107013CT-ND |  |  |  |  | 2.42 | 2.26 | 1.96 | 2.42
31 | L34,105,141 | 3 | ISM-0805-10U | Digikey | 445-173012-1-ND |  |  | 10u |  | 0.33 | 0.29300000000000004 | 0.2113 | 0.99
32 | L109 | 1 | 2U2H_INDUCTOR_NR6028T2R2N | Digikey | 587-2098-1-ND |  |  |  |  | 0.35 | 0.311 | 0.22430000000000003 | 0.35
33 | L39,82 | 2 | BALUN_1-2_WBC2-1TL | Coilcraft | WBC2-1TLB |  |  |  |  | 3.45 | 3.45 | 3.45 | 6.9
34 | L84 | 1 | IND_4.7UH_SMT_CDRH4D28CNP-4R7PC | Digikey | 308-2043-1-ND | Sumida America Components Inc. | CDRH4D28CNP-4R7PC |  |  | 0.8700000000000001 | 0.763 | 0.6582 | 0.8700000000000001
35 | L11,19 | 2 | IND_SMT_220UH_SRN4018-221M | Digikey | SRN4018-221MCT-ND | Bourns Inc. | SRN4018-221M |  |  | 0.36000000000000004 | 0.32 | 0.24 | 0.7200000000000001
36 | L41,81 | 2 | MIXER_DIODE-RING_ADE-2ASK | Mini-Circuits | ADE-2ASK |  |  |  |  | 5.55 | 5.55 | 4.15 | 11.1
37 | MICROSD | 1 | MICROSD_DM3CS-SF | Digikey | HR1972CT-ND |  |  |  |  | 1.66 | 1.509 | 1.2936 | 1.66
38 | Q5,126,178,208,246 | 5 | MOSFET_P_SOT23_IRLML6401 | Digikey | IRLML6401PBFCT-ND |  |  |  |  | 0.36000000000000004 | 0.29500000000000004 | 0.2013 | 1.8000000000000005
39 | R68,69,75,76,117,169,310-313,319 | 11 | RES_0603 | Digikey | 541-0.0GCT-ND |  |  | 0R |  | 0.1 | 0.022 | 0.0091 | 1.1
40 | R1,52,53,63,64,112,124,130,140,144,145,165,174-176,207,221,222,232,234,245,285,286,296,297 | 25 | RES_0603 | Digikey | P100KGCT-ND |  |  | 100k |  | 0.1 | 0.1 | 0.0071 | 2.5
41 | R268 | 1 | RES_0603 | Digikey | P100GCT-ND |  |  | 100R |  | 0.1 | 0.1 | 0.0071 | 0.1
42 | R14 | 1 | RES_0603 | Digikey | RHM68DCT-ND |  |  | 68R |  | 0.1 | 0.079 | 0.030300000000000004 | 0.1
43 | R6 | 1 | RES_0603 | Digikey | RHM180DCT-ND |  |  | 180R |  | 0.1 | 0.079 | 0.030300000000000004 | 0.1
44 | R50,55,61,66,92,116,127,133,136,219,224,230,236,299,300 | 15 | RES_0603 | Digikey | MCT0603-10.0K-CFCT-ND |  |  | 10K |  | 0.17 | 0.14500000000000002 | 0.0568 | 2.5500000000000003
45 | R168 | 1 | RES_0603 | Digikey | 490-2436-1-ND |  |  | 10K NTC |  | 0.2 | 0.169 | 0.1067 | 0.2
46 | R12 | 1 | RES_0603 | Digikey | RHM10DCT-ND |  |  | 10R 1/4W |  | 0.1 | 0.079 | 0.030300000000000004 | 0.1
47 | R194,196,198,204 | 4 | RES_0603 | Digikey | 1276-4751-1-ND |  |  | 12K1 |  | 0.1 | 0.014 | 0.0057 | 0.4
48 | R190 | 1 | RES_0603 | Digikey | MCT0603-15.0K-CFCT-ND |  |  | 15K |  | 0.17 | 0.14500000000000002 | 0.0568 | 0.17
49 | R2,28,29,67,70,74,77,122,128,146,150,162,167,177,200-202,206,244,250,254,264,266,270,271,273,274 | 27 | RES_0603 | Digikey | MCT0603-1.00K-CFCT-ND |  |  | 1K |  | 0.17 | 0.14500000000000002 | 0.0568 | 4.590000000000001
50 | R324,325 | 2 | RES_0603 | Digikey | 1276-3497-1-ND |  |  | 22R1 |  | 0.1 | 0.014 | 0.0057 | 0.2
51 | R249,261, | 2 | RES_0603 | Digikey | 1276-3499-1-ND |  |  | 24R9 |  | 0.1 | 0.014 | 0.0057 | 0.2
52 | R97-99 | 3 | RES_0603 | Digikey | P255HCT-ND |  |  | 255R |  | 0.1 | 0.1 | 0.008400000000000001 | 0.30000000000000004
53 | R164 | 1 | RES_0603 | Digikey | 1276-4870-1-ND |  |  | 240K |  | 0.1 | 0.03 | 0.0123 | 0.1
54 | R90 | 1 | RES_0603 | Digikey | 541-30.0KHCT-ND |  |  | 30K |  | 0.1 | 0.03 | 0.0123 | 0.1
55 | R113 | 1 | RES_0603 | Digikey | 311-402KHRCT-ND |  |  | 402K |  | 0.1 | 0.014 | 0.0057 | 0.1
56 | R308,321 | 2 | RES_0603 | Digikey | 1276-3505-1-ND |  |  | 50R |  | 0.1 | 0.014 | 0.0057 | 0.2
57 | R22,23,25 | 3 | RSM-6K98-1PCT-250MW-1206 | Digikey | 1276-5659-1-ND |  |  | 50R |  | 0.1 | 0.033 | 0.0136 | 0.30000000000000004
58 | R187 | 1 | RES_0603 | Digikey | 541-4.99KHCT-ND |  |  | 5K |  | 0.1 | 0.03 | 0.0123 | 0.1
59 | R94 | 1 | RES_0603 | Digikey | P6.81KHCT-ND |  |  | 6.8K |  | 0.1 | 0.1 | 0.008400000000000001 | 0.1
60 | R72,79 | 2 | RES_0603 | Digikey | NA |  |  | DNS | DNP by design - footprints still on the board. Bridging resistors across the mixer LO pairs: R79 = MIXER_LO1N/MIXER_LO1P (L81.1/L81.6), R72 = MIXER_LO2N/MIXER_LO2P (L41.1/L41.6). Do NOT fit 0 ohm: both nets already reach the LO winding. |  |  |  | 0
61 | SPEAKER | 0 | SPEAKER_SMT_WATERPROOF_2403-260-00107 | Digikey | AS01508AO-3-R |  |  |  |  | 3.75 | 3 | 2.475 | 0
62 | SPEAKER | 1 | SPEAKER_SMT_WATERPROOF_2403-260-00107 | Digikey | 668-1513-ND |  |  |  | Buy but do not populate | 3.13 | 2.5 | 2.0625 | 3.13
63 | U172 | 1 | 3V3_LDO_MCP1802 | Digikey | MCP1802T-3302I/OTCT-ND |  |  |  |  | 0.53 | 0.53 | 0.4 | 0.53
64 | U211,298 | 2 | 74CBTLV3253 | Digikey | 296-17283-1-ND |  |  |  | Name mismatch is okay, The Digikey part # is the correct part | 1.05 | 0.936 | 0.7300000000000001 | 2.1
65 | U253,260 | 2 | AD8131 | Digikey | AD8131ARMZ-ND |  |  |  |  | 4.83 | 4.83 | 3.5553 | 9.66
66 | U314 | 1 | AD8302 | Digikey | AD8302ARUZ-ND |  |  |  |  | 24.86 | 22.926 | 19.5772 | 24.86
67 | U199 | 1 | AUDIO_AMP_TPA0253DGQR | Digikey | 296-7006-1-ND |  |  |  |  | 1.7400000000000002 | 1.562 | 1.2527 | 1.7400000000000002
68 | U161 | 1 | BAT-MANAGE_MCP73871 | Digikey | MCP73871-2AAI/ML-ND |  |  |  |  | 1.79 | 1.79 | 1.35 | 1.79
69 | U85 | 1 | BOOST_REG_ADP1613 | Digikey | ADP1613ARMZ-R7CT-ND | Analog Devices Inc. | ADP1613ARMZ-R7 |  |  | 2.07 | 1.863 | 1.4947 | 2.07
70 | U114 | 1 | BUCK_REGULATOR_AP3417C | Digikey | AP3417CKTR-G1DICT-ND |  |  |  |  | 0.41 | 0.34800000000000003 | 0.2601 | 0.41
71 | U15 | 1 | DIGITAL_POT_MAX5388 | Digikey | MAX5388NAUB+-ND |  |  |  |  | 1.11 | 1.055 | 1.0456 | 1.11
72 | U4,18,86 | 3 | DPDT_ANALOG_MAX4525 | Digikey | MAX4525CUB+-ND |  |  |  |  | 2.29 | 2.176 | 2.0018 | 6.87
73 | U185 | 1 | GPS_MODULE_RXM-GPS-RM-T | Digikey | RXM-GPS-RM-TCT-ND |  |  |  |  | 20.38 | 20.38 | 15.262 | 20.38
74 | U255,272 | 2 | MCP6N11 | Digikey | MCP6N11-010E/SN-ND |  |  |  |  | 1.35 | 1.35 | 1.02 | 2.7
75 | U189 | 1 | MIC_PREAMP_SSM2167 | Digikey | SSM2167-1RMZ-R7CT-ND |  |  |  |  | 2.77 | 2.484 | 2.0381 | 2.77
76 | U32 | 1 | MICROPHONE_MEMS_SPU0410HR5H-PB | Digikey | 423-1138-1-ND |  |  |  |  | 0.8600000000000001 | 0.7390000000000001 | 0.462 | 0.8600000000000001
77 | U304 | 1 | MMIC-AMP_HMC482ST | Digikey | 599-1068-1-ND | RF Micro Devices (RFMD) | SXB-2089Z |  | Name mismatch is okay, The Digikey part # is the correct part | 6.13 | 5.495 | 4.4943 | 6.13
78 | U47,58,131,216,227 | 5 | OP_AMP_FAN4174 | Digikey | FAN4174IS5XCT-ND |  |  |  |  | 0.5 | 0.4260000000000001 | 0.3179 | 2.5
79 | U16,24,30 | 3 | RF_DPDT_MASWSS0129TR | Digikey | 1465-1374-1-ND |  | MASWSS0129TR |  |  | 1.63 | 1.469 | 1.1832 | 4.89
80 | U241 | 1 | SI5338 | Digikey | 336-2552-ND |  |  |  |  | 14.79 | 14.79 | 13.6902 | 14.79
81 | U37 | 1 | SPDT_ANALOG_SWITCH_SN74LVC1G3157 | Digikey | 296-14909-1-ND |  |  |  |  | 0.36000000000000004 | 0.29000000000000004 | 0.198 | 0.36000000000000004
82 | U121 | 1 | STM32F746_LQFP100 | Digikey | 497-15819-ND |  |  |  |  | 16.75 | 15.39 | 12.9976 | 16.75
83 | U279,280 | 2 | SY10EP52V | Digikey | 576-2520-ND | Microchip Technology | SY10EP52VKG |  |  | 4.49 | 4.49 | 3.4 | 8.98
84 | U287 | 1 | VARIABLE_FILTER_HMC1023 | Digikey | 1127-1662-ND |  |  |  |  | 30.32 | 27.964 | 23.8792 | 30.32
85 | USB | 1 | MICROUSB_H12192CT-ND | Digikey | H12192CT-ND |  |  |  |  | 1.37 | 1.206 | 1.0406 | 1.37
86 | Y182,237 | 2 | CRYSTAL3225 | Digikey | SER3627CT-ND |  |  |  |  | 0.63 | 0.526 | 0.42 | 1.26
