fe1iscurc0r/PSDR/dist/fab/PSDR_2.6.1_placement.csv

Designator | Footprint | MidX_mm | MidY_mm | Rotation | Side | Class | PadsOnNet | MirrorFlag | PadX_mil | PadY_mil
+ | 0.1"_1PIN | 58.166 | 3.048 | 0.0 | Top | SINGLE_PAD | 1 | N | 87249000 | 4572000
- | 0.1"_1PIN | 63.246 | 3.048 | 0.0 | Top | SINGLE_PAD | 1 | N | 94869000 | 4572000
ANT/VNA-IN | SMA_BOARD_EDGE | 4.200 | 55.000 | 180.0 | Bottom | PURCHASED | 5 | M | 6300000 | 82500000
BIAS | PAD_1MM | 12.192 | 49.784 | 0.0 | Top | SINGLE_PAD | 1 | N | 18288000 | 74676000
BOOT | BUTTON_B3U-1000P-B | 44.958 | 6.096 | 180.0 | Top | PURCHASED | 2 | N | 67437000 | 9144000
CLK | 0.1"_1PIN | 60.706 | 3.048 | 0.0 | Top | SINGLE_PAD | 1 | N | 91059000 | 4572000
CLKA | PAD_1MM | 30.607 | 28.829 | 0.0 | Top | SINGLE_PAD | 1 | N | 45910500 | 43243500
CLKB | PAD_1MM | 32.385 | 28.575 | 0.0 | Top | SINGLE_PAD | 1 | N | 48577500 | 42862500
DUT | PAD_1MM | 11.176 | 27.940 | 0.0 | Top | SINGLE_PAD | 1 | N | 16764000 | 41910000
EAR | PAD_1MM | 61.214 | 13.462 | 0.0 | Top | SINGLE_PAD | 1 | N | 91821000 | 20193000
EARPHONE | 3.5MM_PHONO_4P_3SW_SJ-42617-SMT | 0.000 | 7.000 | 180.0 | Bottom | PURCHASED | 6 | M | 0 | 10500000
E_FILT_IF_N | 0.1"_1PIN | 48.006 | 19.050 | 90.0 | Bottom | SINGLE_PAD | 1 | M | 72009000 | 28575000
E_FILT_IF_P | 0.1"_1PIN | 48.006 | 8.890 | 270.0 | Bottom | SINGLE_PAD | 1 | M | 72009000 | 13335000
E_FILT_RF_N | 0.1"_1PIN | 18.796 | 19.050 | 90.0 | Bottom | SINGLE_PAD | 1 | M | 28194000 | 28575000
E_FILT_RF_P | 0.1"_1PIN | 18.796 | 8.890 | 90.0 | Bottom | SINGLE_PAD | 1 | M | 28194000 | 13335000
GND | PAD_1MM | 84.557 | 11.963 | 0.0 | Top | SINGLE_PAD | 1 | N | 126834900 | 17945100
GPSR | PAD_1MM | 64.516 | 29.591 | 0.0 | Top | SINGLE_PAD | 1 | N | 96774000 | 44386500
GPSRX | PAD_1MM | 51.892 | 20.955 | 0.0 | Top | SINGLE_PAD | 1 | N | 77838300 | 31432500
GPSTX | PAD_1MM | 52.959 | 17.882 | 0.0 | Top | SINGLE_PAD | 1 | N | 79438500 | 26822400
GPS_ANTENNA | GPS_ANTENNA-W3062A | 83.312 | 20.066 | 90.0 | Top | PURCHASED | 2 | N | 124968000 | 30099000
IO | 0.1"_1PIN | 65.786 | 3.048 | 0.0 | Top | SINGLE_PAD | 1 | N | 98679000 | 4572000
LIPO | PAD_1MM | 77.470 | 49.784 | 0.0 | Top | SINGLE_PAD | 1 | N | 116205000 | 74676000
MAG | PAD_1MM | 20.574 | 28.067 | 0.0 | Top | SINGLE_PAD | 1 | N | 30861000 | 42100500
MIC | PAD_1MM | 63.068 | 26.162 | 0.0 | Top | SINGLE_PAD | 1 | N | 94602300 | 39243000
MICROSD | MICROSD_DM3CS-SF | 93.726 | 25.146 | 180.0 | Top | PURCHASED | 13 | N | 140589000 | 37719000
NRST | 0.1"_1PIN | 68.326 | 3.048 | 0.0 | Top | SINGLE_PAD | 1 | N | 102489000 | 4572000
PHSE | PAD_1MM | 20.574 | 30.607 | 0.0 | Top | SINGLE_PAD | 1 | N | 30861000 | 45910500
REF | PAD_1MM | 8.509 | 27.432 | 0.0 | Top | SINGLE_PAD | 1 | N | 12763500 | 41148000
RST | BUTTON_B3U-1000P-B | 44.958 | 2.540 | 180.0 | Top | PURCHASED | 2 | N | 67437000 | 3810000
RXI | PAD_1MM | 39.878 | 43.180 | 0.0 | Top | SINGLE_PAD | 1 | N | 59817000 | 64770000
RXQ | PAD_1MM | 38.354 | 53.721 | 0.0 | Top | SINGLE_PAD | 1 | N | 57531000 | 80581500
SCL | PAD_1MM | 46.965 | 38.405 | 0.0 | Top | SINGLE_PAD | 1 | N | 70446900 | 57607200
SDA | PAD_1MM | 48.971 | 42.570 | 0.0 | Top | SINGLE_PAD | 1 | N | 73456800 | 63855600
SPEAKER | SPEAKER_SMT_WATERPROOF_2403-260-00107 | 71.882 | 10.922 | 0.0 | Top | PURCHASED | 2 | N | 107823000 | 16383000
TXI | PAD_1MM | 30.302 | 49.708 | 0.0 | Top | SINGLE_PAD | 1 | N | 45453300 | 74561700
TXQ | PAD_1MM | 26.543 | 58.344 | 0.0 | Top | SINGLE_PAD | 1 | N | 39814500 | 87515700
USB | MICROUSB_H12192CT-ND | 0.700 | 19.000 | 90.0 | Bottom | PURCHASED | 9 | M | 1050000 | 28500000
VNA-OUT | SMA_BOARD_EDGE | 4.200 | 36.500 | 180.0 | Bottom | PURCHASED | 5 | M | 6300000 | 54750000
VSPLY | PAD_1MM | 51.562 | 54.610 | 0.0 | Top | SINGLE_PAD | 1 | N | 77343000 | 81915000
VUSB | PAD_1MM | 7.366 | 15.748 | 0.0 | Top | SINGLE_PAD | 1 | N | 11049000 | 23622000
1PPS | PAD_1MM | 52.578 | 29.972 | 0.0 | Top | SINGLE_PAD | 1 | N | 78867000 | 44958000
CW1 | MORSE_PADDLE_CONTACTS | 91.341 | 17.755 | 315.0 | Top | MOUNTING_HARDWARE | 2 | N | 137011791 | 26633043
DAC1 | PAD_1MM | 47.371 | 22.987 | 0.0 | Top | SINGLE_PAD | 1 | N | 71056500 | 34480500
F1 | FIDUCIAL_1MM | 70.612 | 1.524 | 0.0 | Top | FIDUCIAL | 0 | N | 105918000 | 2286000
LO1N | PAD_1MM | 37.592 | 17.145 | 0.0 | Top | SINGLE_PAD | 1 | N | 56388000 | 25717500
LO1P | PAD_1MM | 38.989 | 16.002 | 0.0 | Top | SINGLE_PAD | 1 | N | 58483500 | 24003000
M1 | MH3M_PLATED | 75.500 | 62.000 | 0.0 | Top | MOUNTING_HARDWARE | 1 | N | 113250000 | 93000000
R1 | RES_0603 | 9.144 | 58.420 | 270.0 | Top | PURCHASED | 2 | N | 13716000 | 87630000
X1 | MH_80M | 62.230 | 10.922 | 0.0 | Top | MOUNTING_HARDWARE | 0 | N | 93345000 | 16383000
CW2 | MORSE_PADDLE_CONTACTS | 96.245 | 22.659 | 135.0 | Top | MOUNTING_HARDWARE | 2 | N | 144366996 | 33988248
DAC2 | PAD_1MM | 46.609 | 32.385 | 0.0 | Top | SINGLE_PAD | 1 | N | 69913500 | 48577500
F2 | FIDUCIAL_1MM | 80.010 | 63.500 | 0.0 | Top | FIDUCIAL | 0 | N | 120015000 | 95250000
LO2N | PAD_1MM | 24.384 | 17.018 | 0.0 | Top | SINGLE_PAD | 1 | N | 36576000 | 25527000
LO2P | PAD_1MM | 25.654 | 16.002 | 0.0 | Top | SINGLE_PAD | 1 | N | 38481000 | 24003000
M2 | MH3M_PLATED | 3.000 | 45.750 | 0.0 | Top | MOUNTING_HARDWARE | 1 | N | 4500000 | 68625000
R2 | RES_0603 | 10.668 | 58.420 | 270.0 | Top | PURCHASED | 2 | N | 16002000 | 87630000
X2 | MH_80M | 81.534 | 10.922 | 0.0 | Top | MOUNTING_HARDWARE | 0 | N | 122301000 | 16383000
C3 | CAP_0603 | 22.606 | 61.722 | 180.0 | Top | PURCHASED | 2 | N | 33909000 | 92583000
F3 | FIDUCIAL_1MM | 2.032 | 11.938 | 0.0 | Top | FIDUCIAL | 0 | N | 3048000 | 17907000
M3 | MH3M_PLATED | 52.000 | 3.000 | 0.0 | Top | MOUNTING_HARDWARE | 1 | N | 78000000 | 4500000
F4 | FIDUCIAL_1MM | 97.282 | 38.862 | 0.0 | Bottom | FIDUCIAL | 0 | M | 145923000 | 58293000
M4 | MH3M | 3.086 | 61.914 | 0.0 | Top | MOUNTING_HARDWARE | 0 | N | 4628685 | 92871315
U4 | DPDT_ANALOG_MAX4525 | 21.844 | 59.436 | 0.0 | Top | PURCHASED | 10 | N | 32766000 | 89154000
5VBST | PAD_1MM | 40.767 | 54.991 | 0.0 | Top | SINGLE_PAD | 1 | N | 61150500 | 82486500
F5 | FIDUCIAL_1MM | 6.401 | 63.297 | 0.0 | Bottom | FIDUCIAL | 0 | M | 9601200 | 94945200
M5 | MH3M | 97.000 | 35.500 | 0.0 | Top | MOUNTING_HARDWARE | 0 | N | 145500000 | 53250000
Q5 | MOSFET_P_SOT23_IRLML6401 | 8.636 | 55.118 | 90.0 | Top | PURCHASED | 3 | N | 12954000 | 82677000
F6 | FIDUCIAL_1MM | 14.427 | 5.080 | 0.0 | Bottom | FIDUCIAL | 0 | M | 21640800 | 7620000
M6 | MH3M | 73.918 | 2.659 | 0.0 | Top | MOUNTING_HARDWARE | 0 | N | 110876250 | 3988485
R6 | RES_0603 | 7.874 | 46.482 | 270.0 | Top | PURCHASED | 2 | N | 11811000 | 69723000
C7 | CAP_0603 | 9.398 | 46.482 | 270.0 | Top | PURCHASED | 2 | N | 14097000 | 69723000
M7 | MH3M | 16.000 | 2.500 | 0.0 | Top | MOUNTING_HARDWARE | 0 | N | 24000000 | 3750000
C8 | CAP_0603 | 10.922 | 46.482 | 270.0 | Top | PURCHASED | 2 | N | 16383000 | 69723000
C9 | CAP_0603 | 12.446 | 46.482 | 270.0 | Top | PURCHASED | 2 | N | 18669000 | 69723000
C10 | CAP_0603 | 25.654 | 52.324 | 180.0 | Top | PURCHASED | 2 | N | 38481000 | 78486000
L11 | IND_SMT_220UH_SRN4018-221M | 9.398 | 50.546 | 270.0 | Top | PURCHASED | 2 | N | 14097000 | 75819000
1/2VCC | PAD_1MM | 14.605 | 59.690 | 0.0 | Top | SINGLE_PAD | 1 | N | 21907500 | 89535000
R12 | RES_0603 | 6.350 | 49.784 | 90.0 | Top | PURCHASED | 2 | N | 9525000 | 74676000
C13 | CAP_0603 | 13.208 | 50.546 | 135.0 | Top | PURCHASED | 2 | N | 19812000 | 75819000
R14 | RES_0603 | 12.954 | 48.514 | 180.0 | Top | PURCHASED | 2 | N | 19431000 | 72771000
U15 | DIGITAL_POT_MAX5388 | 22.860 | 49.784 | 0.0 | Top | PURCHASED | 9 | N | 34290000 | 74676000
U16 | RF_DPDT_MASWSS0129TR | 16.002 | 44.958 | 0.0 | Top | PURCHASED | 13 | N | 24003000 | 67437000
C17 | CAP_0603 | 22.606 | 46.482 | 180.0 | Top | PURCHASED | 2 | N | 33909000 | 69723000
U18 | DPDT_ANALOG_MAX4525 | 22.606 | 44.196 | 0.0 | Top | PURCHASED | 10 | N | 33909000 | 66294000
L19 | IND_SMT_220UH_SRN4018-221M | 9.398 | 42.418 | 90.0 | Top | PURCHASED | 2 | N | 14097000 | 63627000
C20 | CAP_0603 | 13.462 | 40.386 | 180.0 | Top | PURCHASED | 2 | N | 20193000 | 60579000
C21 | CAP_0603 | 16.510 | 40.894 | 270.0 | Top | PURCHASED | 2 | N | 24765000 | 61341000
R22 | RSM-6K98-1PCT-250MW-1206 | 8.128 | 36.830 | 90.0 | Top | PURCHASED | 2 | N | 12192000 | 55245000
R23 | RSM-6K98-1PCT-250MW-1206 | 10.922 | 36.830 | 90.0 | Top | PURCHASED | 2 | N | 16383000 | 55245000
U24 | RF_DPDT_MASWSS0129TR | 16.002 | 36.830 | 0.0 | Top | PURCHASED | 13 | N | 24003000 | 55245000
R25 | RSM-6K98-1PCT-250MW-1206 | 9.398 | 32.766 | 180.0 | Top | PURCHASED | 2 | N | 14097000 | 49149000
C26 | CAP_0603 | 13.462 | 33.274 | 180.0 | Top | PURCHASED | 2 | N | 20193000 | 49911000
C27 | CAP_0603 | 16.510 | 32.766 | 270.0 | Top | PURCHASED | 2 | N | 24765000 | 49149000
R28 | RES_0603 | 7.366 | 30.480 | 0.0 | Top | PURCHASED | 2 | N | 11049000 | 45720000
R29 | RES_0603 | 10.668 | 30.480 | 0.0 | Top | PURCHASED | 2 | N | 16002000 | 45720000
U30 | RF_DPDT_MASWSS0129TR | 16.002 | 28.702 | 0.0 | Top | PURCHASED | 12 | N | 24003000 | 43053000
C31 | CAP_0603 | 7.366 | 24.638 | 0.0 | Top | PURCHASED | 2 | N | 11049000 | 36957000
U32 | MICROPHONE_MEMS_SPU0410HR5H-PB | 7.366 | 21.844 | 90.0 | Top | PURCHASED | 4 | N | 11049000 | 32766000
3V3A | PAD_1MM | 53.594 | 59.944 | 0.0 | Top | SINGLE_PAD | 1 | N | 80391000 | 89916000
3V3D | PAD_1MM | 60.960 | 52.451 | 0.0 | Top | SINGLE_PAD | 1 | N | 91440000 | 78676500
C33 | CAP_0603 | 6.350 | 17.526 | 270.0 | Top | PURCHASED | 2 | N | 9525000 | 26289000
L34 | ISM-0805-10U | 8.636 | 17.780 | 90.0 | Top | PURCHASED | 2 | N | 12954000 | 26670000
C35 | CAP_0603 | 10.668 | 18.288 | 90.0 | Top | PURCHASED | 2 | N | 16002000 | 27432000
C36 | CAP_0603 | 17.526 | 16.764 | 90.0 | Top | PURCHASED | 2 | N | 26289000 | 25146000
U37 | SPDT_ANALOG_SWITCH_SN74LVC1G3157 | 7.366 | 13.716 | 270.0 | Top | PURCHASED | 6 | N | 11049000 | 20574000
C38 | CAP_0603 | 10.160 | 14.478 | 270.0 | Top | PURCHASED | 2 | N | 15240000 | 21717000
L39 | BALUN_1-2_WBC2-1TL | 14.224 | 14.478 | 270.0 | Top | PURCHASED | 5 | N | 21336000 | 21717000
C40 | CAP_0603 | 17.526 | 13.462 | 90.0 | Top | PURCHASED | 2 | N | 26289000 | 20193000
L41 | MIXER_DIODE-RING_ADE-2ASK | 24.130 | 5.080 | 270.0 | Top | PURCHASED | 6 | N | 36195000 | 7620000
C42 | CSM-X5R-22U-20P-10V-1210 | 34.798 | 61.722 | 270.0 | Top | PURCHASED | 2 | N | 52197000 | 92583000
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
C155 | CSM-X5R-10U0-10P-25V-0805 | 90.424 | 37.592 | 270.0 | Bottom | PURCHASED | 2 | M | 135636000 | 56388000
C156 | CAP_0805 | 88.392 | 38.354 | 90.0 | Bottom | PURCHASED | 2 | M | 132588000 | 57531000
C157 | CAP_0603 | 86.614 | 38.354 | 90.0 | Bottom | PURCHASED | 2 | M | 129921000 | 57531000
C158 | CSM-X5R-22U-20P-10V-1210 | 83.312 | 39.116 | 180.0 | Bottom | PURCHASED | 2 | M | 124968000 | 58674000
C159 | CAP_0603 | 82.550 | 36.576 | 180.0 | Bottom | PURCHASED | 2 | M | 123825000 | 54864000
C160 | CAP_0603 | 92.456 | 33.782 | 0.0 | Bottom | PURCHASED | 2 | M | 138684000 | 50673000
U161 | BAT-MANAGE_MCP73871 | 86.360 | 32.004 | 0.0 | Bottom | PURCHASED | 21 | M | 129540000 | 48006000
R162 | RES_0603 | 81.788 | 32.766 | 270.0 | Bottom | PURCHASED | 2 | M | 122682000 | 49149000
C163 | CSM-X5R-22U-20P-10V-1210 | 94.742 | 31.496 | 0.0 | Bottom | PURCHASED | 2 | M | 142113000 | 47244000
R164 | RES_0603 | 93.980 | 28.956 | 180.0 | Bottom | PURCHASED | 2 | M | 140970000 | 43434000
R165 | RES_0603 | 91.186 | 28.956 | 180.0 | Bottom | PURCHASED | 2 | M | 136779000 | 43434000
R167 | RES_0603 | 81.788 | 29.972 | 90.0 | Bottom | PURCHASED | 2 | M | 122682000 | 44958000
R168 | RES_0603 | 98.552 | 26.416 | 270.0 | Bottom | PURCHASED | 2 | M | 147828000 | 39624000
R169 | RES_0603 | 86.868 | 25.654 | 0.0 | Bottom | PURCHASED | 2 | M | 130302000 | 38481000
J170 | SPI_LCD_BOTTOM_ENTRY | 77.000 | 38.000 | 90.0 | Bottom | PURCHASED | 9 | M | 115500000 | 57000000
C171 | CAP_0603 | 70.358 | 60.960 | 270.0 | Bottom | PURCHASED | 2 | M | 105537000 | 91440000
U172 | 3V3_LDO_MCP1802 | 67.564 | 60.960 | 180.0 | Bottom | PURCHASED | 4 | M | 101346000 | 91440000
C173 | CAP_0603 | 64.770 | 60.960 | 90.0 | Bottom | PURCHASED | 2 | M | 97155000 | 91440000
R174 | RES_0603 | 71.120 | 58.420 | 180.0 | Bottom | PURCHASED | 2 | M | 106680000 | 87630000
R175 | RES_0603 | 71.120 | 56.642 | 0.0 | Bottom | PURCHASED | 2 | M | 106680000 | 84963000
R176 | RES_0603 | 71.628 | 53.594 | 180.0 | Bottom | PURCHASED | 2 | M | 107442000 | 80391000
R177 | RES_0603 | 69.342 | 51.816 | 90.0 | Bottom | PURCHASED | 2 | M | 104013000 | 77724000
Q178 | MOSFET_P_SOT23_IRLML6401 | 71.882 | 50.546 | 180.0 | Bottom | PURCHASED | 3 | M | 107823000 | 75819000
C179 | CAP_0603 | 59.182 | 45.720 | 180.0 | Bottom | PURCHASED | 2 | M | 88773000 | 68580000
C180 | CAP_0603 | 65.532 | 43.688 | 0.0 | Bottom | PURCHASED | 2 | M | 98298000 | 65532000
C181 | CAP_0603 | 62.484 | 43.688 | 180.0 | Bottom | PURCHASED | 2 | M | 93726000 | 65532000
Y182 | CRYSTAL3225 | 59.182 | 42.926 | 270.0 | Bottom | PURCHASED | 4 | M | 88773000 | 64389000
Y183 | CRYSTAL_SMT_32.768 | 64.008 | 41.656 | 180.0 | Bottom | PURCHASED | 2 | M | 96012000 | 62484000
C184 | CAP_0603 | 59.182 | 40.132 | 0.0 | Bottom | PURCHASED | 2 | M | 88773000 | 60198000
U185 | GPS_MODULE_RXM-GPS-RM-T | 64.262 | 21.082 | 0.0 | Bottom | PURCHASED | 11 | M | 96393000 | 31623000
C186 | CAP_0603 | 78.740 | 16.764 | 90.0 | Bottom | PURCHASED | 2 | M | 118110000 | 25146000
R187 | RES_0603 | 78.994 | 12.700 | 90.0 | Bottom | PURCHASED | 2 | M | 118491000 | 19050000
C188 | CSM-X5R-10U0-10P-25V-0805 | 76.200 | 13.716 | 0.0 | Bottom | PURCHASED | 2 | M | 114300000 | 20574000
U189 | MIC_PREAMP_SSM2167 | 74.676 | 10.668 | 180.0 | Bottom | PURCHASED | 10 | M | 112014000 | 16002000
R190 | RES_0603 | 78.994 | 9.144 | 270.0 | Bottom | PURCHASED | 2 | M | 118491000 | 13716000
C191 | CSM-X5R-10U0-10P-25V-0805 | 76.200 | 7.620 | 0.0 | Bottom | PURCHASED | 2 | M | 114300000 | 11430000
C192 | CSM-X5R-10U0-10P-25V-0805 | 69.596 | 10.668 | 90.0 | Bottom | PURCHASED | 2 | M | 104394000 | 16002000
C193 | CAP_0603 | 69.342 | 6.096 | 180.0 | Bottom | PURCHASED | 2 | M | 104013000 | 9144000
R194 | RES_0603 | 66.040 | 12.192 | 0.0 | Bottom | PURCHASED | 2 | M | 99060000 | 18288000
C195 | CAP_0603 | 66.040 | 10.668 | 180.0 | Bottom | PURCHASED | 2 | M | 99060000 | 16002000
R196 | RES_0603 | 66.040 | 9.144 | 0.0 | Bottom | PURCHASED | 2 | M | 99060000 | 13716000
C197 | CAP_0603 | 66.040 | 7.620 | 0.0 | Bottom | PURCHASED | 2 | M | 99060000 | 11430000
R198 | RES_0603 | 66.040 | 6.096 | 0.0 | Bottom | PURCHASED | 2 | M | 99060000 | 9144000
U199 | AUDIO_AMP_TPA0253DGQR | 56.642 | 11.176 | 90.0 | Bottom | PURCHASED | 11 | M | 84963000 | 16764000
R200 | RES_0603 | 54.102 | 20.066 | 0.0 | Bottom | PURCHASED | 2 | M | 81153000 | 30099000
R201 | RES_0603 | 54.102 | 18.542 | 0.0 | Bottom | PURCHASED | 2 | M | 81153000 | 27813000
R202 | RES_0603 | 54.102 | 17.018 | 0.0 | Bottom | PURCHASED | 2 | M | 81153000 | 25527000
C203 | CAP_0603 | 53.594 | 15.494 | 180.0 | Bottom | PURCHASED | 2 | M | 80391000 | 23241000
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
U314 | AD8302 | 11.176 | 28.702 | 180.0 | Bottom | PURCHASED | 13 | M | 16764000 | 43053000
C315 | CAP_0603 | 6.604 | 30.226 | 270.0 | Bottom | PURCHASED | 2 | M | 9906000 | 45339000
C316 | CAP_0603 | 5.080 | 29.464 | 270.0 | Bottom | PURCHASED | 2 | M | 7620000 | 44196000
C317 | CAP_0603 | 3.556 | 29.464 | 270.0 | Bottom | PURCHASED | 2 | M | 5334000 | 44196000
C318 | CAP_0603 | 6.604 | 27.178 | 90.0 | Bottom | PURCHASED | 2 | M | 9906000 | 40767000
R319 | RES_0603 | 4.318 | 27.178 | 0.0 | Bottom | PURCHASED | 2 | M | 6477000 | 40767000
C320 | CAP_0603 | 16.764 | 25.146 | 0.0 | Bottom | PURCHASED | 2 | M | 25146000 | 37719000
R321 | RES_0603 | 12.954 | 25.146 | 0.0 | Bottom | PURCHASED | 2 | M | 19431000 | 37719000
C322 | CAP_0603 | 9.906 | 25.146 | 0.0 | Bottom | PURCHASED | 2 | M | 14859000 | 37719000
C323 | CSM-X5R-22U-20P-10V-1210 | 7.620 | 22.098 | 270.0 | Bottom | PURCHASED | 2 | M | 11430000 | 33147000
R324 | RES_0603 | 7.620 | 19.050 | 180.0 | Bottom | PURCHASED | 2 | M | 11430000 | 28575000
R325 | RES_0603 | 7.620 | 17.526 | 180.0 | Bottom | PURCHASED | 2 | M | 11430000 | 26289000
C326 | CSM-X5R-22U-20P-10V-1210 | 8.382 | 14.732 | 180.0 | Bottom | PURCHASED | 2 | M | 12573000 | 22098000
