fe1iscurc0r/PSDR/Hardware/Enclosure/FaceCoverFixture/FaceCoverFixture.SLDASM

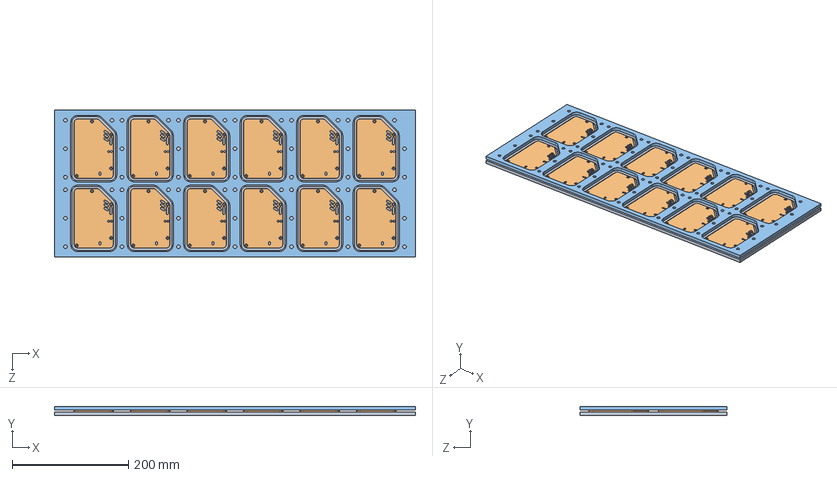
[picture p6: CAD file, 2026-11-01]
Hardware/Enclosure/FaceCoverFixture/FaceCoverFixture.SLDASM
622.3 x 15.7 x 254.0 mm
BottomFixture
Face Cover4 x 12
TopFixture
