fe1iscurc0r/PSDR/Hardware/Enclosure/PSDR Parts.SLDASM

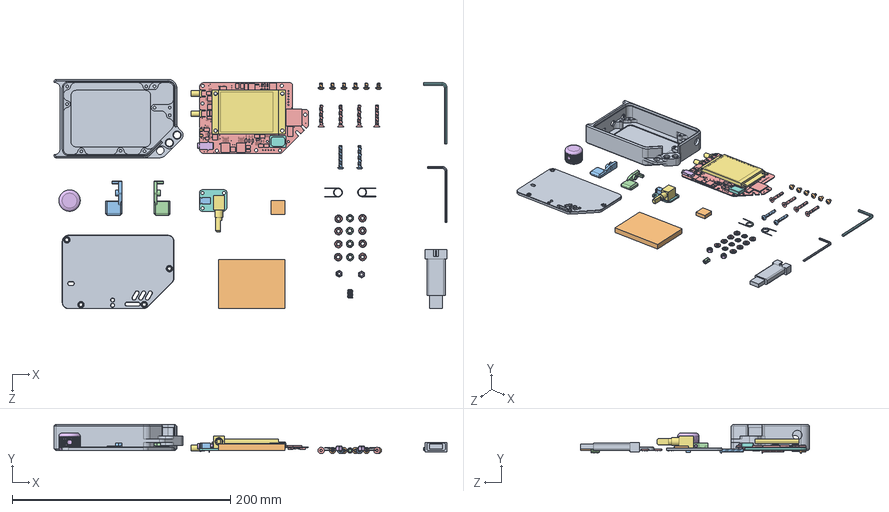
[picture p7: CAD file, 2026-11-01]
Hardware/Enclosure/PSDR Parts.SLDASM
359.9 x 27.0 x 210.1 mm
BottomHalf2
92095A471_18-8 SS BUTTON-HEAD SOCKET CAP SCREW x 6
92095A185_18-8 SS BUTTON-HEAD SOCKET CAP SCREW x 2
92029A208_TYPE 316 STAINLESS STEEL CUP POINT SET SCREW
93395A213_TYPE 316 SS FLAT-HEAD SOCKET CAP SCREW x 4
94205A220_TYPE 316 STAINLESS STEEL NYLON-INSERT LOCKNUT x 2
2.2in_LCD_Module
2.5mm_Allen_Wrench
2mm_Allen_Wrench
604561 Battery
Battery Connector
Bearing_Inside x 4
Bearing_Outside x 8
Earphone_Jack
Encoder
EncoderBoard
Face Cover4
Foam_Square
paddle
paddle_Mirrored
PSDR26PCB
Slotted_Knob2
SMA_Connector x 2
Speaker
ST-Link
USB_Connector
LeeSpring-LTML060L08S
LeeSpring-LTMR060L08S
