fe1iscurc0r/PSDR/Hardware/Enclosure/PSDR2.SLDASM

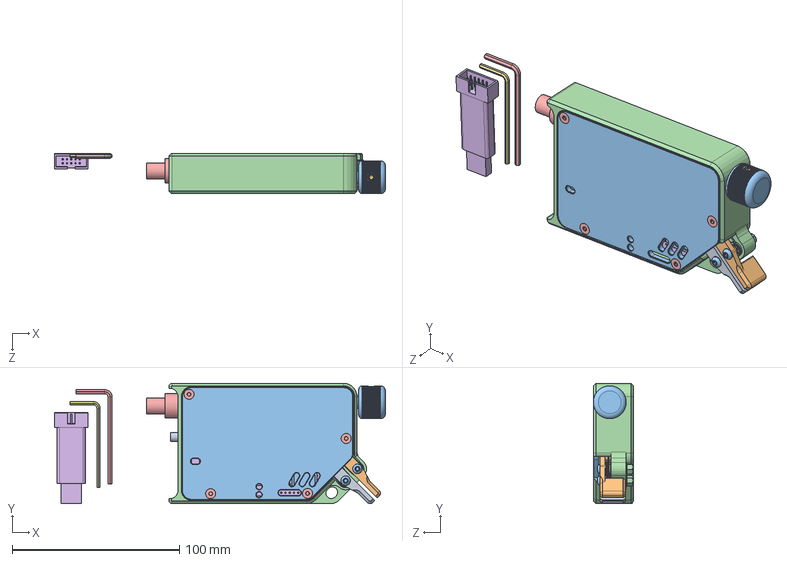
[picture p8: CAD file, 2026-11-01]
Hardware/Enclosure/PSDR2.SLDASM
197.8 x 72.0 x 24.1 mm
92095A471_18-8 SS BUTTON-HEAD SOCKET CAP SCREW x 6
92029A208_TYPE 316 STAINLESS STEEL CUP POINT SET SCREW
92095A185_18-8 SS BUTTON-HEAD SOCKET CAP SCREW x 2
94205A220_TYPE 316 STAINLESS STEEL NYLON-INSERT LOCKNUT x 2
93395A213_TYPE 316 SS FLAT-HEAD SOCKET CAP SCREW x 4
PSDR26PCB
2.2in_LCD_Module
Earphone_Jack
SMA_Connector x 2
USB_Connector
Speaker
BottomHalf2
EncoderBoard
Battery Connector
Encoder
paddle
paddle_Mirrored
Slotted_Knob2
604561 Battery
Bearing_Inside x 4
Bearing_Outside x 8
Foam_Square
Face Cover4
LeeSpring-LTML060L08S
LeeSpring-LTMR060L08S
Battery Wires
