fe1iscurc0r/PSDR/Hardware/Enclosure/FaceCoverFixture/BottomFixture.SLDPRT

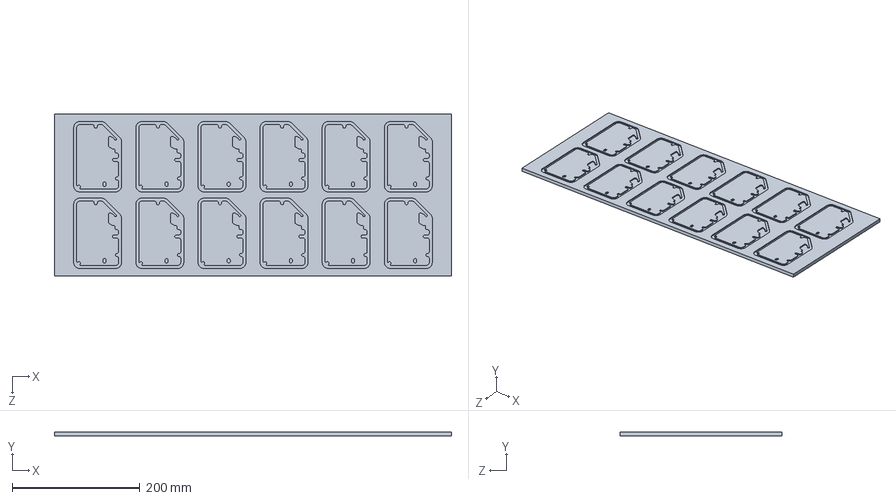
[picture p9: CAD file, 2026-11-01]
Hardware/Enclosure/FaceCoverFixture/BottomFixture.SLDPRT
622.3 x 6.35 x 254.0 mm
