fe1iscurc0r/PSDR/Hardware/Enclosure/LeeSpring-LTML060L08S.SLDPRT

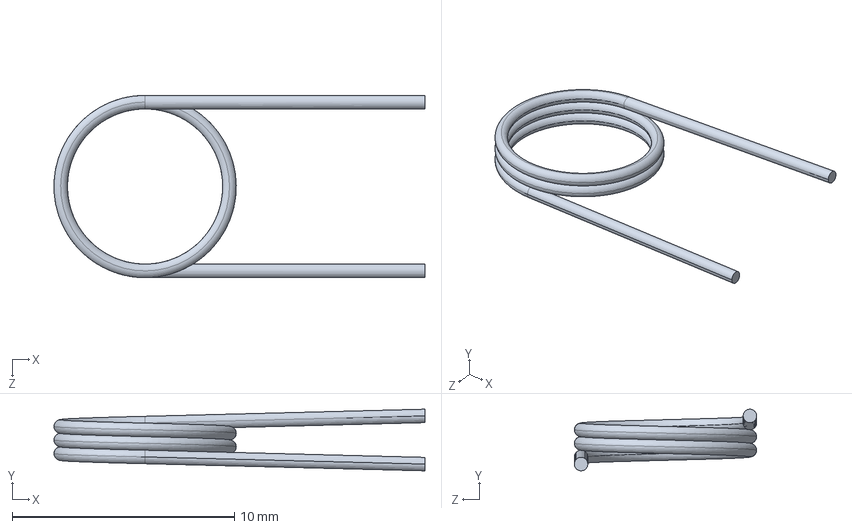
[picture p10: CAD file, 2026-11-01]
Hardware/Enclosure/LeeSpring-LTML060L08S.SLDPRT
16.7 x 2.77 x 8.20 mm
