fe1iscurc0r/PSDR/Hardware/Enclosure/2.5mm_Allen_Wrench.SLDPRT

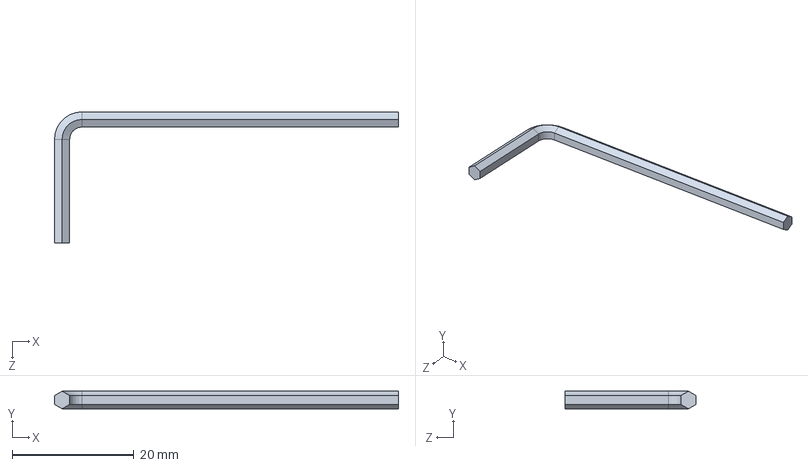
[picture p11: CAD file, 2026-11-01]
Hardware/Enclosure/2.5mm_Allen_Wrench.SLDPRT
56.5 x 2.89 x 21.5 mm
