fe1iscurc0r/PSDR/Hardware/Enclosure/FaceCoverFixture/TopFixture.SLDPRT

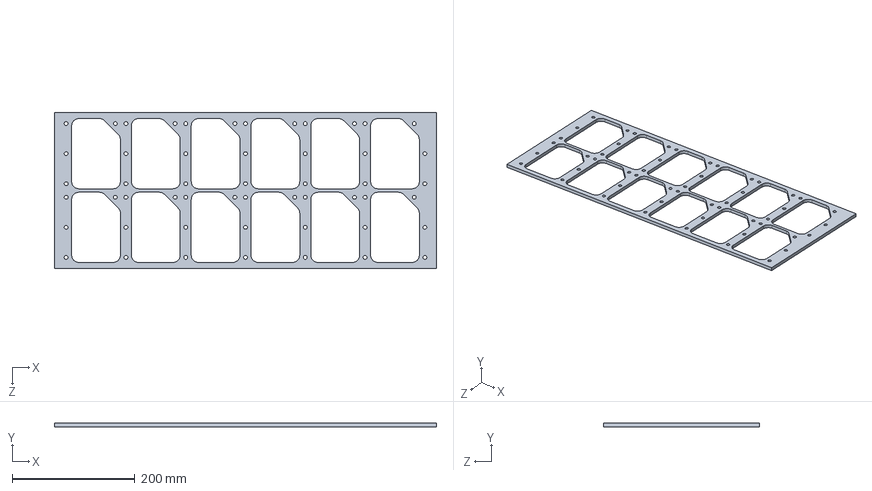
[picture p12: CAD file, 2026-11-01]
Hardware/Enclosure/FaceCoverFixture/TopFixture.SLDPRT
622.3 x 6.35 x 254.0 mm
