fe1iscurc0r/PSDR/Hardware/Enclosure/Earphone_Jack.SLDPRT

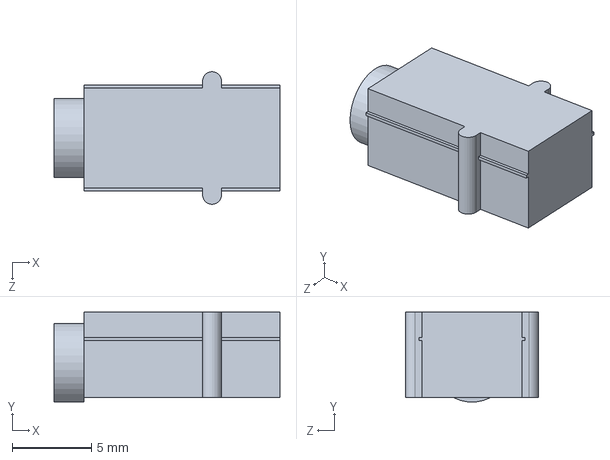
[picture p13: CAD file, 2026-11-01]
Hardware/Enclosure/Earphone_Jack.SLDPRT
14.3 x 5.69 x 8.40 mm
