fe1iscurc0r/PSDR/Hardware/Enclosure/Bearing_Inside.SLDPRT

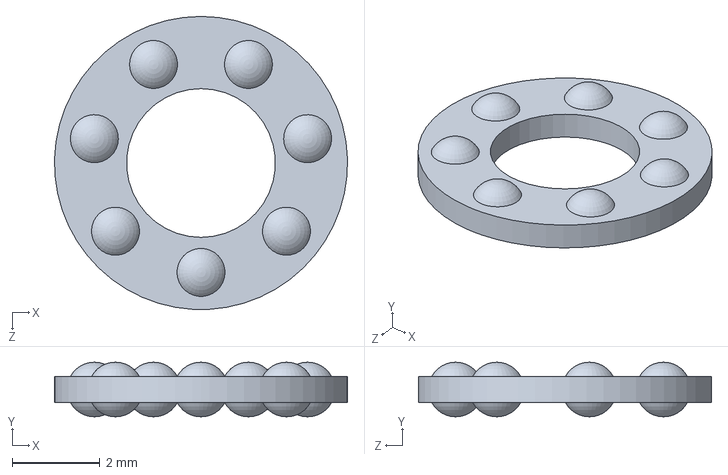
[picture p14: CAD file, 2026-11-01]
Hardware/Enclosure/Bearing_Inside.SLDPRT
6.70 x 1.25 x 6.70 mm
