fe1iscurc0r/PSDR/Hardware/Enclosure/Face Cover4.SLDPRT

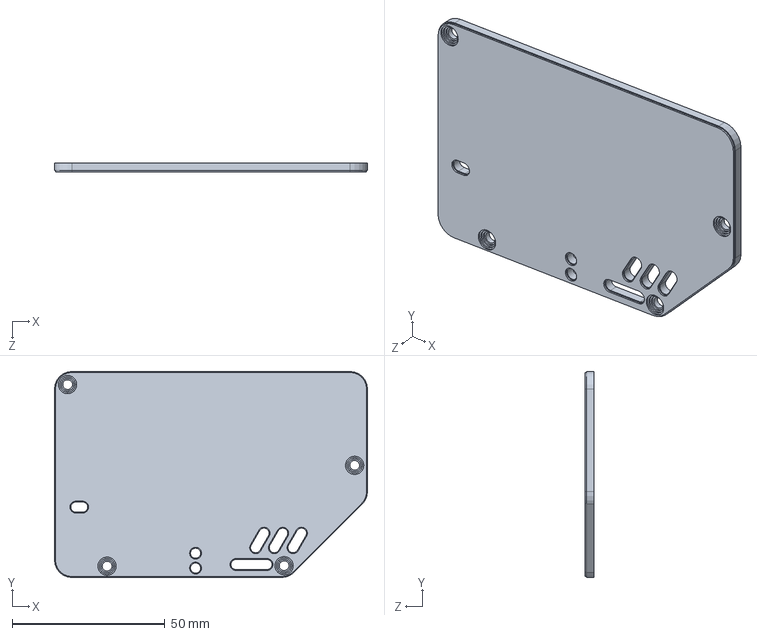
[picture p15: CAD file, 2026-11-01]
Hardware/Enclosure/Face Cover4.SLDPRT
102.4 x 67.4 x 3.00 mm
