fe1iscurc0r/PSDR/Hardware/Enclosure/PSDR26PCB.SLDPRT

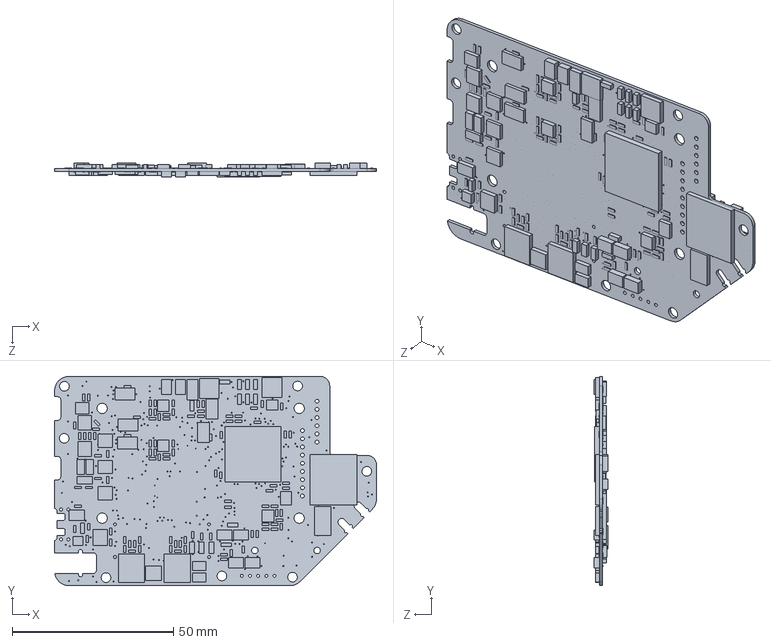
[picture p16: CAD file, 2026-11-01]
Hardware/Enclosure/PSDR26PCB.SLDPRT
100.0 x 65.0 x 4.33 mm
