fe1iscurc0r/PSDR/Hardware/Enclosure/2mm_Allen_Wrench.SLDPRT

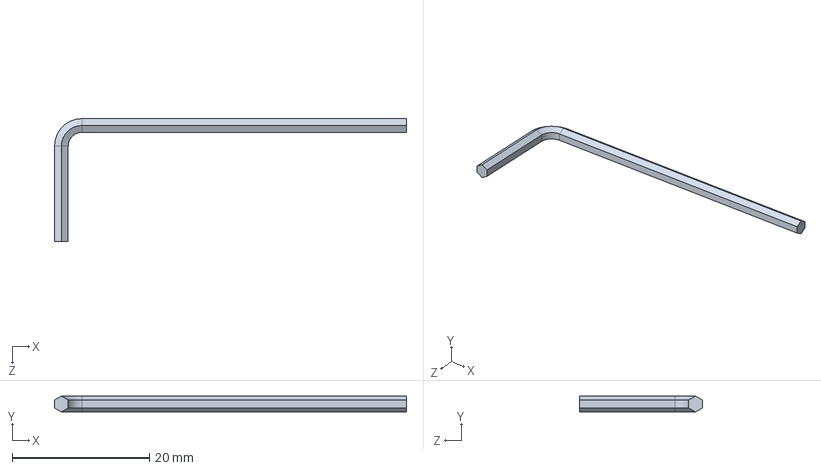
[picture p17: CAD file, 2026-11-01]
Hardware/Enclosure/2mm_Allen_Wrench.SLDPRT
51.2 x 2.31 x 17.9 mm
