fe1iscurc0r/PSDR/Hardware/Enclosure/Foam_Square.SLDPRT

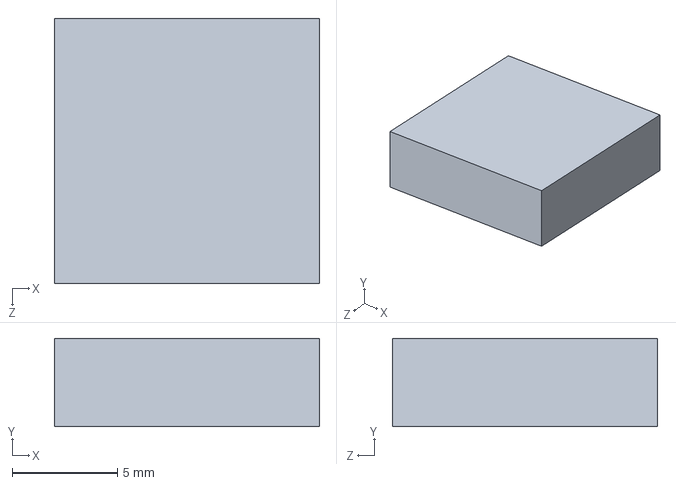
[picture p18: CAD file, 2026-11-01]
Hardware/Enclosure/Foam_Square.SLDPRT
12.6 x 4.20 x 12.6 mm
