fe1iscurc0r/PSDR/Hardware/Enclosure/EncoderBoard.SLDPRT

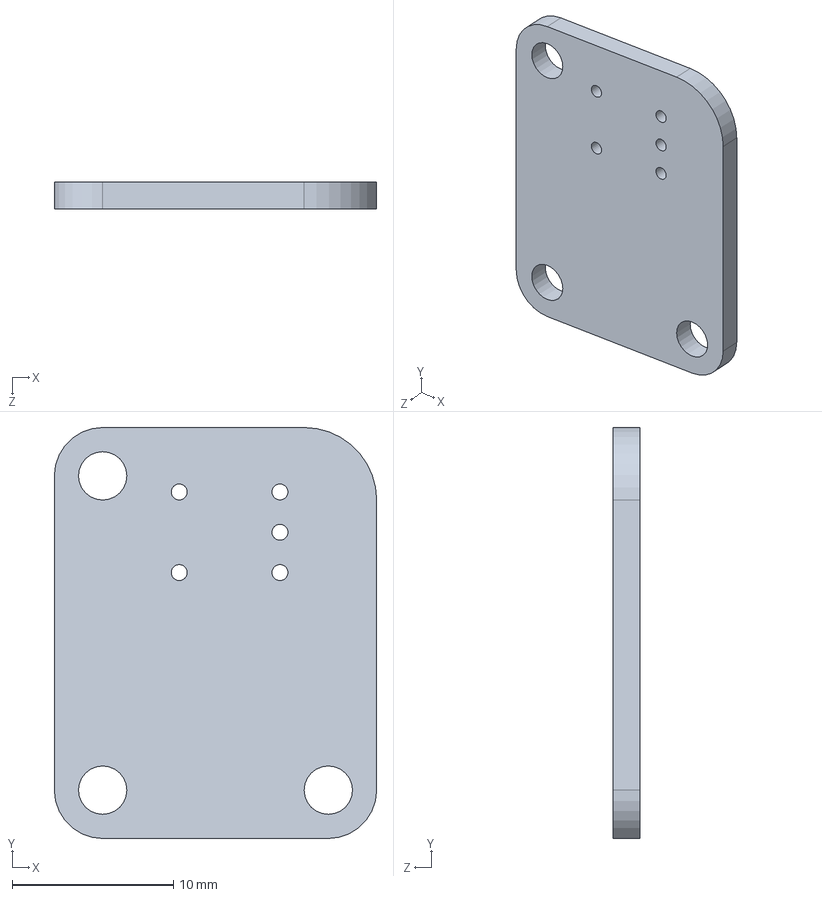
[picture p19: CAD file, 2026-11-01]
Hardware/Enclosure/EncoderBoard.SLDPRT
20.0 x 25.5 x 1.68 mm
