fe1iscurc0r/PSDR/Hardware/Enclosure/BottomHalf2.sldprt

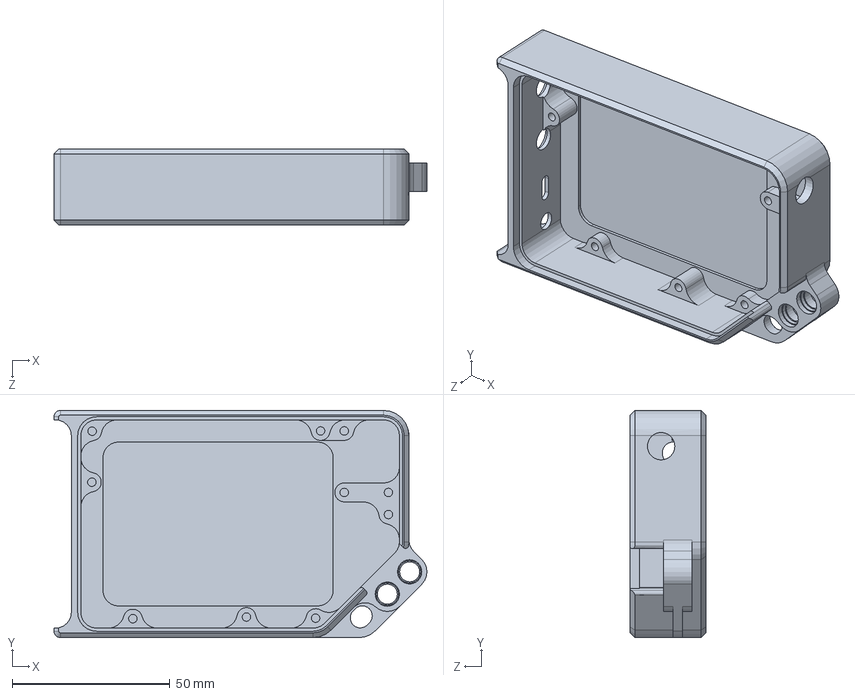
[picture p20: CAD file, 2026-11-01]
Hardware/Enclosure/BottomHalf2.sldprt
118.2 x 72.0 x 24.0 mm
