fe1iscurc0r/PSDR/Hardware/Enclosure/ST-Link.SLDPRT

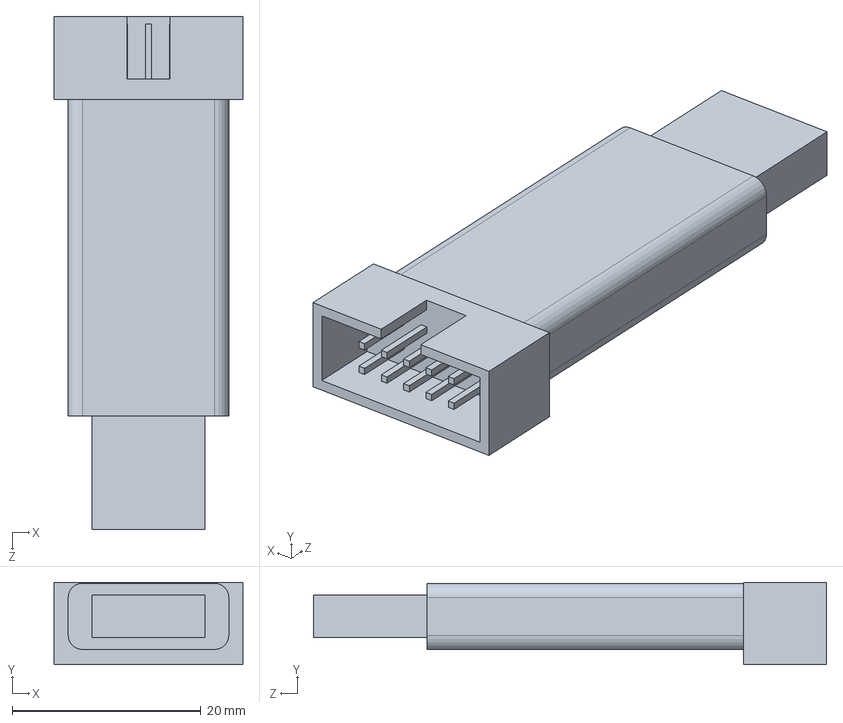
[picture p21: CAD file, 2026-11-01]
Hardware/Enclosure/ST-Link.SLDPRT
20.0 x 8.70 x 54.3 mm
