fe1iscurc0r/PSDR/Hardware/Enclosure/USB_Connector.SLDPRT

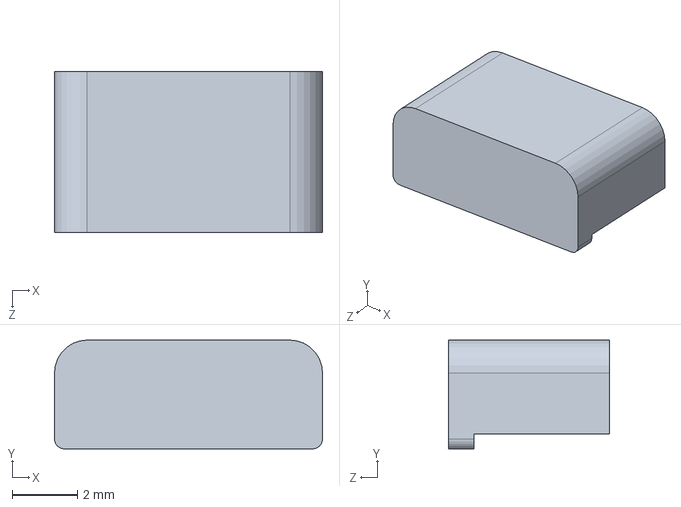
[picture p22: CAD file, 2026-11-01]
Hardware/Enclosure/USB_Connector.SLDPRT
8.20 x 3.33 x 4.93 mm
