fe1iscurc0r/PSDR/Hardware/Enclosure/Bearing_Outside.SLDPRT

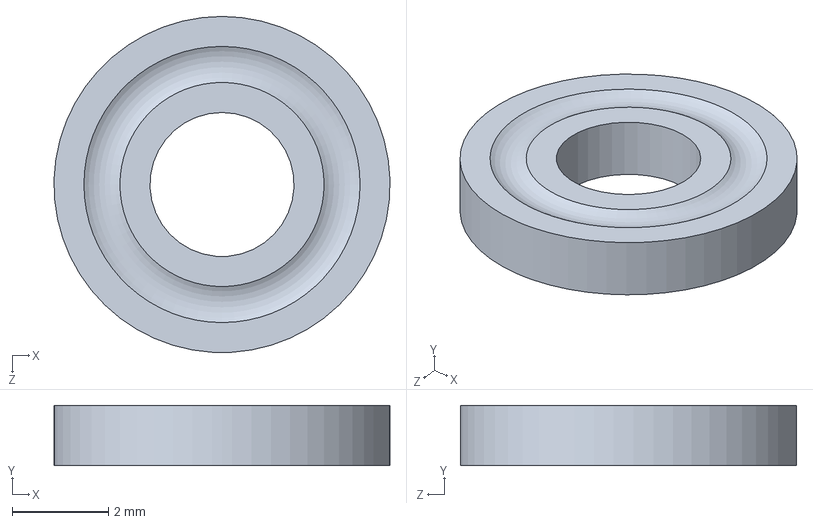
[picture p23: CAD file, 2026-11-01]
Hardware/Enclosure/Bearing_Outside.SLDPRT
7.00 x 1.25 x 7.00 mm
