fe1iscurc0r/PSDR/(list of files, cad)

Other CAD files:
Hardware/Enclosure/Battery Wires.sldprt
Hardware/Enclosure/LeeSpring-LTMR060L08S.SLDPRT
Hardware/Enclosure/604561 Battery.SLDPRT
Hardware/Enclosure/92029A208_TYPE 316 STAINLESS STEEL CUP POINT SET SCREW.SLDPRT
Hardware/Enclosure/92095A185_18-8 SS BUTTON-HEAD SOCKET CAP SCREW.SLDPRT
Hardware/Enclosure/92095A471_18-8 SS BUTTON-HEAD SOCKET CAP SCREW.SLDPRT
Hardware/Enclosure/93395A213_TYPE 316 SS FLAT-HEAD SOCKET CAP SCREW.SLDPRT
Hardware/Enclosure/94205A220_TYPE 316 STAINLESS STEEL NYLON-INSERT LOCKNUT.SLDPRT
Hardware/Enclosure/Archive/7x3x3 Bearing.SLDPRT
Hardware/Enclosure/Archive/92029A208.SLDPRT
Hardware/Enclosure/Archive/92095A183.SLDPRT
Hardware/Enclosure/Archive/93395A198.SLDPRT
Hardware/Enclosure/Archive/93395A210.SLDPRT
Hardware/Enclosure/Archive/93657A708.SLDPRT
Hardware/Enclosure/Archive/94500A222.SLDPRT
Hardware/Enclosure/Archive/95610A530.SLDPRT
Hardware/Enclosure/Archive/Balun.SLDPRT
Hardware/Enclosure/Archive/Battery.SLDPRT
Hardware/Enclosure/Archive/Bottom_Cover.SLDPRT
Hardware/Enclosure/Archive/Bottom_Enclosure.SLDPRT
Hardware/Enclosure/Archive/EncoderBoard-offset.DXF
Hardware/Enclosure/Archive/EncoderBoard.DXF
Hardware/Enclosure/Archive/Face Cover.SLDPRT
Hardware/Enclosure/Archive/Face Cover3.SLDPRT
Hardware/Enclosure/Archive/GPS_Antenna_18x18x4.SLDPRT
Hardware/Enclosure/Archive/Knob.SLDPRT
Hardware/Enclosure/Archive/Knob2.SLDPRT
Hardware/Enclosure/Archive/Knurled_Knob.SLDPRT
Hardware/Enclosure/Archive/LCD_Standoff.SLDPRT
Hardware/Enclosure/Archive/LeeSpring-LTL015B08S.SLDPRT
Hardware/Enclosure/Archive/LeeSpring-LTR028E01S.SLDPRT
Hardware/Enclosure/Archive/Main_Enclosure.SLDPRT
Hardware/Enclosure/Archive/MicroUSBMale.SLDPRT
Hardware/Enclosure/Archive/Other Spring Thing.SLDPRT
Hardware/Enclosure/Archive/PSDR2.SLDDRW
Hardware/Enclosure/Archive/PSDR2_MainBoard-Backside Housing Keepouts.DXF
Hardware/Enclosure/Archive/PSDR2_MainBoard.DXF
Hardware/Enclosure/Archive/PSDR2_MainBoard.SLDPRT
Hardware/Enclosure/Archive/PSDR2_Parts List.SLDDRW
Hardware/Enclosure/Archive/Slotted_Knob1.SLDPRT
Hardware/Enclosure/Archive/Spring Thing.SLDPRT
Hardware/Enclosure/Archive/TopHalf2.sldprt
Hardware/Enclosure/Archive/Top_Cover.SLDPRT
Hardware/Enclosure/Archive/paddle_Middored.SLDPRT
Hardware/Enclosure/PSDR Parts.SLDDRW
