fe1iscurc0r/PSDR/docs/PSDR-bringup-checklist.md

# PSDR 2.6.1 上电前检查表（M3 准备，2026-11-02）

这份表**只做两件事**：把"板子到手后按什么顺序通电、测哪里、判据是什么"先钉死；
把不需要实物就能确定的东西（测点位置、网络归属、控制脚）从设计数据里算出来。

它**不包含任何固件改动，也不包含射频前端的修改**（边界：#16/#6 的 preamp 与低通
不归本项目动；#8/#9 的固件源码冻结）。每条都留"实测值"和"结论/SKIP 原因"两栏，
跑不了就写 SKIP，不许写"应该没问题"。

数据全部来自 `Hardware/PSDR.asc`（`468dc41` 的 PADS Layout ASCII），
经 `tools/pads_asc_netlist.py`（391 件 / 278 网 / 1132 脚）与
`tools/pads_asc_placement.py`（391 个贴装项，含 42 个单焊盘点位）。

## 0. 上电前（不通电，肉眼 + 万用表）

| # | 检查 | 位置 | 判据 | 实测 | 结论 |
|---|---|---|---|---|---|
| 0.1 | 电源对地不短路 | TP `VSPLY`(`V_SUPPLY`) ↔ TP `GND`(GND) | 电阻 > 1 kΩ（未焊元件时） | | |
| 0.2 | 3V3 轨不短路 | TP `+`(=`+3V3_CPU`)、`3V3A`(=`+3V3`)、`3V3D`(=`+3V3_CPU`) ↔ TP `-`(GND) | 同上 | | |
| 0.3 | USB 5V 不短路 | TP `VUSB`(=`+5V`) ↔ TP `-` | 同上 | | |
| 0.4 | 电池口极性 | `LIPO`(=net `LIPO`) TP 与电池座 | 与 BOM 电池件一致 | | |

## 1. 供电与电流（先不带射频）

| # | 项 | 怎么测 | 判据 | 实测 | 结论 |
|---|---|---|---|---|---|
| 1.1 | `+5V` 输入 | TP `VUSB` vs `GND` | 4.7~5.3 V | | |
| 1.2 | `V_SUPPLY` | TP `VSPLY` | 与电池/输入一致，掉电不上跳 | | |
| 1.3 | `+3V3` / `+3V3_CPU` | TP `3V3A` / `3V3D` / `+` | 3.30 V ±5%，纹波不占用 ADC 参考 | | |
| 1.4 | `HALF_VCC` | TP `1/2VCC` | ≈ 模拟半电源，随 `+3V3` 不漂 | | |
| 1.5 | `+5V_BOOST` / `BOOST_LOOP` | TP `5VBST` | 升压建立，无振荡啸叫 | | |
| 1.6 | 待机电流 | 电源串表 | 记录 mA，与 §C-15 无对照——**基线由本表首次建立** | | |

## 2. 数字与调试链路（不涉射频）

| # | 项 | 位置 | 判据 | 实测 | 结论 |
|---|---|---|---|---|---|
| 2.1 | SWD 连接 | TP `NRST`/`IO`(JTMS/SWDIO)/`CLK`(JTCK/SWCLK)/`-`/`+` | 能被 ST-Link/J-Link 识别 STM32F746 | | |
| 2.2 | I²C | TP `SCL`(I2C_SCL)/`SDA`(I2C_SDA) | 上拉存在、总线空闲为高，扫描到预期地址 | | |
| 2.3 | GPS 串口 | TP `GPSRX`(RX_TO_GPS)/`GPSTX`(TX_FROM_GPS)/`1PPS`(GPS_PPS)/`GPSR`(GPS_RESET) | NMEA 有输出，1PPS 每秒一次 | | |
| 2.4 | 扬声器 DAC | TP `DAC1`(DAC1_TO_SPEAKER)/`DAC2`(DAC2_TO_SPEAKER) | 静音时无直流偏移 | | |
| 2.5 | 耳插检测 | TP `EAR`(net `/EARPHONE_INSERTED`) | 插入/拔出电平翻转 | | |
| 2.6 | MIC 链路 | TP `MIC`(MIC_FILTER_OUT) | 无信号时静默 | | |

## 3. 显示与编码器冒烟（不涉射频）

| # | 项 | 判据 | 实测 | 结论 |
|---|---|---|---|---|
| 3.1 | 显示屏上电初始化 | 无花屏、无 §D 记过的 DMA 撕裂 | | |
| 3.2 | 编码器旋转 | A/B 计数方向与 UI 响应一致（TP `CLKA`/`CLKB` 可挂逻辑分析仪） | | |
| 3.3 | 桨叶/按键 | `CW1`/`CW2` 触点与 `PADDLE_*` 网络状态一致 | | |

## 4. 射频相关的**观测**（不改逻辑，只记录）

这几条是给 #16/#6 留证据用的。判据写"记录什么"，不写"应该修什么"。

| # | 观测点 | 网络（来自设计数据） | 记录内容 | 实测 | 结论 |
|---|---|---|---|---|---|
| 4.1 | 前置放大器三只 RF 开关的控制脚 | U16：`AMP_SWITCH_A`=**PA0**(U121.22) + `AMP_SWITCH_B`=**PE6**(U121.5)；U24：`IMP_BRIDGE_SWITCH_A`=**PC1**(U121.16) + `_B`=**PA6**(U121.30)；U30：`TX_RF_SWITCH_A`=**PB2**(U121.36) + `_B`=**PA7**(U121.31) | 开机/接收/发射/待机四种状态下六根脚的实际电平与持续时间 | | |
| 4.2 | preamp 偏置是否加上 | TP `BIAS`(net `RF_AMP_IN`)、`DUT`(`RF_ANT`)、`REF`(`RF_REF`) | U304（RFMD SXB-2089Z）输入端直流路径与静态电流 | | |
| 4.3 | S 表读数与实测对照（#6） | TP `MAG`(MAGNITUDE)/`PHSE`(PHASE)、AD8302 U314 周边 `3V3A` | 同一天线输入下 UI 读数 vs 信号源实际 dBm，记录传递曲线 | | |
| 4.4 | 混频 LO 对（#6 相关） | TP `LO1N/LO1P/LO2N/LO2P`（源里对应 L81/L41 绕组，`R79/R72` 是跨接电阻且**不装**） | 差分幅度与偏置，确认没被短路 | | |
| 4.5 | 滤波切换探针 | TP `E_FILT_IF_N/P`、`E_FILT_RF_N/P`（底面 4 点） | 滤波器插损扫描 | | |

**#9 相关的现成事实**（本表可直接验证，不需要改代码）：U121 的 **PA0 既是 STM32 的
standby 唤醒脚，又是 `AMP_SWITCH_A`——也就是前置放大器 RF 开关 U16 的 V1 控制脚**。
作者说 `EnterSTANDBYMode()` 只能等 PA0 的上升沿；那么待机时 PA0 的驱动状态会同时
决定 U16 停在哪个触点。4.1 在"待机"态记录 PA0 电平，就是在验证这个假设。

## 5. 无实物时的处置

本表每一条在硬件到位前都填 `SKIP：无 2.6.1 实物`。不允许因为"设计数据看起来对"
就把某条记成通过——设计数据能证明的只有位置和网络，电气行为必须由实测得出。

## 附：先量这 13 项，再谈其他（2026-11-03 由 BOM×板文件对账产生）

`python tools/bom_refdes_crosscheck.py` 把 `Hardware/PSDR.asc` 的 `Value` 与两份 BOM 逐位号对撞，
结果是 **339 个位号里 255 个一致、11 个冲突、外加 2 条轨的电压被电阻设成了非标称值**。
这 13 项不需要射频仪器，电阻档/电压档就能定，且**每一项都会改变后续判断**，
所以排在原清单的 42 个测点之前。坐标从 `dist/fab/PSDR_2.6.1_placement.csv` 取（同一原点）。

### A. 板文件与 BOM 冲突的 11 个电阻（量出来等于哪边，口径就归哪边）

| 位号 | 2.6 BOM | 2.6.1 BOM | 板文件 `.asc` | 为什么值得量 |
|---|---|---|---|---|
| R6 | 100R | **180R** | 100R | 与 L11 一起给 U304 输入侧馈电；SXB2089Z 手册的测试条件是 `RBIAS=20Ω` ⇒ 这颗的取值是 #16 的候选变量 |
| R14 | 100R | **68R** | 100R | 同组改动，判"板文件是否过期"的第二证 |
| R164 | 270K | **240K** | 270K | MCP73871 充电电流设定；2.6→2.6.1 唯一我们已知道的变化 |
| R113 | 402K | 402K | **383K** | AP3417C 上臂 ⇒ 直接决定 CPU 轨是 3.012 V 还是 2.898 V（见 B-1） |
| R68 / R69 / R75 / R76 | 0R | 0R | **1k0** | 同组同为 0R 的 R310-313/R319 板文件也是 0R ⇒ 这四个不是分组笔误，是真不一致 |
| R268 | 100R | 100R | **1k0** | 与 R6/R14 同一 BOM 组被拆开的那只 |
| R72 / R79 | DNS | DNS | **1k0** | #14 讨论过的两只；BOM 说不装而板文件带值 ⇒ 若实际焊了，混频器 LO 对被 1k 桥住 |

**判读规则**：量得值 = BOM ⇒ 板文件过期，一切以 BOM 为准、`PR #18` 的口径不变；
量得值 = 板文件 ⇒ BOM 过期，`PR #18` 与 BOM 对账结论要重开；两者都不是 ⇒ 板上是第三只手焊件，以实物为准并回写本文件。

### B. 两条被电阻设定的轨（电压档，开机即量）

| 项 | 预期 | 判据 |
|---|---|---|
| `+3V3_CPU`（AP3417C U114 输出） | **2.898 V**（若 R113=383K）或 **3.012 V**（若 R113=402K），**不是 3.3 V** | 与 A 表 R113 联判。连带结论：三只 MASWSS0129 的控制高电平要求 `≥ +2.9 V` ⇒ 若轨是 3.0 V，**余量只有 0.1 V**。这一条直接决定 #16 里"开关档位是否真的切换了"能不能靠 GPIO 断言 |
| `+5V_BOOST`（ADP1613 U85 输出） | **4.94 V**（`1.235×(1+30K/10K)`，R90 上臂 / R92 下臂；`FREQ` 接 GND ⇒ 650 kHz；L84=4.7 µH 在手册 4.7–22 µH 下界） | 若明显偏低先看 `SS` 脚 C91=33n 与 D44；这条也是 SXB2089Z 偏置链的上游 |

## 附：四个"一量就能判死"的点（2026-11-04，来自缺陷登记册 D-02/D-10/D-11/D-12）

| # | 量哪 | 判据 | 对应缺陷 |
|---|---|---|---|
| 1 | `+3V3_CPU`（U114 输出） | 2.898 V ⇒ R113=383K（板文件）；3.012 V ⇒ 402K（BOM/原理图）；都不是 ⇒ 第三种情况 | D-11/D-12 |
| 2 | `+5V_BOOST`（U85 输出） | ≈4.94 V 才对（`1.235×(1+30K/10K)`） | — |
| 3 | `U287.28`（VDDBG） | **≈5 V**（需先按 §D-02 飞线）⇒ 偏置有电；0 V ⇒ 未供 | D-02 |
| 4 | `C283` 靠 Si5338 一侧（`FILTER_CAL`） | 有 **20–80 MHz** 时钟 ⇒ CALCK 可用；无 ⇒ D-10 的 NVM 未配 | D-10 |

**判定规则**：这四条里 3 或 4 不成立时，**不要**先怀疑 HMC1023 本身——先按 §D-02/D-10 处理。
