fe1iscurc0r/PSDR/delegation/PROMPT-full-history.md

# 委派提示词 · 把 PortableSDR 的**全部历史**扒出来（2026-11-04）

用途：交给一个**没有本仓库上下文**的人/账号执行。他要做的是"外部考古"——
我们在仓内和 GitHub 上能拉的自己都拉过了（下面"已有"那节列出边界），
他去扒我们扒不到的：Hackaday、众筹页、论坛、视频、其他 fork、作者自己的其它站点。

⚠️ 两条硬边界，必须写在最前面转达给他：
1. **只读**。不许在任何仓库/论坛/issue 下发帖、评论、开 issue、发 PR——他不替我们对外表态。
2. **不许改动我们的仓库文件**。交付物只有他写的一份报告（外加原始 JSON/HTML 存档路径）。

---

## 提示词正文（从这里开始贴）

你受托为一台开源短波收发信机 **PortableSDR（PSDR）** 做**完整历史普查**。
它是一个 2014 年开始、作者单人推进、约 100 台量产、后来停摆又于 2026 年被第三方接手的项目。
你的产出是一份**可核对的年表与人物/版本谱系**，不是评论文章。

### 已知的锚点（不要重复劳动，只做延伸与核对）

- GitHub 主仓：`https://github.com/MichaelRColton/PSDR`
  - 共 21 条 issue/PR、61 条评论，**已全部抓取过**（2026-11-04 用 REST `GET /repos/{owner}/{repo}/issues/N`
    与 `/issues/N/comments?per_page=100` 全量拉回，JSON 存档在委托方本地）。
    你**不要**重做这件事；除非你发现某条 issue 的事件流（`/issues/N/events`）与下面时间不符，才补抓。
  - 关键内部事实：`468dc41`(2016-07-31 "PSDR 2.6.1 PCB complete")、`1890b25`(2016-04-18 2.5 原型)、
    `ab2c8fd`(2018-07-31, F7 线)、`2a0a65c`(2016-11-17 装配说明进仓)、`46c832e`(2014-10-15 滤波系数表)、
    `37c3da4`(2021-01-18 Jeff 补文档)、`bec5351`(2017-01-19 空白 BOM)、上游最后合并 = #15 (2021-03-05)。
- 仓内 `Documentation/` 六份材料**已由委托方读完**：`PSDR2 Guide.pdf`(2014-09-28 创建，半成品 VNA 说明页，
  内含作者自己的 "Whre is it controlled in code?"、"THEN WHAT HAPPENS?" 等 TODO)、
  `Assembly Instructions.pdf`(2016-11-08 创建，PSDR2 机械装配)、两份宣传视频脚本文稿、
  `Stepping through filter coeficient population.xlsx`(512 点，与固件 `FFT_BUFFER_SIZE 512` 同数组)、
  `BOM with space for parts.xlsx`。⇒ **不要**再去解这些文件；你的任务是找**仓外**的东西。
- 线程里已经点名、需要延伸的站外线索（逐条给出，见下"要查什么"）。

### 要查什么（按优先级）

**P0 · Hackaday 与产品自我叙述**
1. `https://hackaday.io/project/1538-portablesdr`（#2 关帖时作者亲自指过去，说"文档在更新日志里"）：
   **把所有 update/log 逐条列出**（日期 + 标题 + 摘要 + URL），注意作者可能在 Hackaday 上写了
   GitHub 里没有的实测数字、失败原因、照片说明。
   同时抓 comments/related posts，以及该项目是否参加过 **Hackaday Prize** 及结果。
2. Hackaday 本站的新闻报道（`hackaday.com/?s=portablesdr` 或 `PortableSDR`），列日期与标题，
   摘录里若有任何**性能数字、产量、销售方式**的表述，逐条标注。

**P0 · 众筹/销售史（我们内部只知道"有 backer lists""我 paid extra 升级 non-soldering kit"）**
3. 找 PSDR1/PSDR2 的**众筹页**（Kickstarter/Indiegogo/Tindie/GroupGets 之类）、筹款额、支持档位、
   发货情况、跳票/退款记录；以及是否曾在任何商店/经销商有售（含 2017 年 #5 里"还能买到吗"的后续答复线索）。
4. 作者是否在任何渠道说过**总共做了多少块板/卖了多少台**（#16 里他只说 "about 100 units"，
   找有没有更早或更细的数字来源）。

**P1 · 社区足迹（人物与后续版本可能藏在这里）**
5. 业余无线电论坛与邮件列表：QRZ forums、QRP-Labs list、r/amateur_radio、r/RTLSDR、Groups.io/Facebook 群组
   （**只列可公开访问的页面**；登录墙内的只写"存在但需登录"，不要试图绕过）。
   检索式请一并写出，例：`"PortableSDR" site:groups.io`、`PSDR "Michael Colton" QRZ`、`"portablesdr" review`。
6. 用户实测与改装贴：**灵敏度、S 表、前放、2m 段、VNA 使用**这四类凡出现具体数字，
   单独成表（数字 + 谁的 + 日期 + URL + 原文一句），并注明它是**经验值还是测量**。
7. Paul Warren(@pwarren) 提到的**自建 Discourse 实例**：是否还活着、URL、是否留有 2017 年的讨论。
8. @sanamon(Jonas)、@fstkmaro、@johnlaur、@DM2NT、@petermccracken、**KA7OEI**（作者说住得不远、
   愿意看 PSDR 但"haven't really made it happen"）：各自是否有公开写过的 PSDR 相关内容
   （KA7OEI 自己的博客 `KA7OEI.com` 值得一查）。**只查公开页面，不联系个人。**

**P1 · 视频**
9. 仓里有两份作者写的视频文稿 ⇒ 找**成品视频是否发布过**（YouTube/Vimeo/其余），
   给出标题、发布日期、URL、简介与评论里任何硬件事实。若查不到任何成品视频，明确写"未找到"。

**P2 · 谱系与衍生**
10. GitHub 上该仓的 **fork 树**：谁 fork 过、哪些 fork 有自己的提交（尤其 `johnlaur` 曾说
    "I will create a new PR after merging PSDR2 stuff" 却从未出现——**去他账号/其它仓找 PSDR2 相关的坑**）、
    有没有别人做过 KiCad/改版/BOM 重建（与我们 2026 年做的事是否重复）。
11. 主仓分支谱系在 GitHub 上是可见的（`PSDR_Rebuild`/`PSDR_F7`/`PSDR_F7_DMA` 等），
    你只需核对**分支最后一次提交时间与作者**，不要重复我们的分析。
12. 作者 Michael Colton 的其它公开站点（个人主页/LinkedIn/GitHub 其它仓）里是否还有 PSDR 相关叙述、
    2022–2026 是否有过任何更新意向声明。
13. **断供件时间线**：MASWSS0129（MACOM）与 SXB-2089Z（RFMD→Qorvo）的 PCN/停产公告日期、
    以及 2021 年 #13 里出现的 Richardson RFPD、win-source 两个渠道页现在的状态（活/死/404），
    每条都要 URL + 抓取日期。

**P2 · 项目之前**
14. 有没有 PSDR **项目之前**的版本痕迹（PSDR1 更早的演示、作者自制的更早 SDR、2013 年的时间点），
    任何能确定"最早一次公开提及 PortableSDR 的日期与场所"的证据都算。

### 方法与出处规则（硬性）

1. **每条事实**必须：`日期 | 断言一句话 | 原文摘录（保持原语言）| URL | 我是什么时候抓的`。
   没有原文摘录的一律降级为"传闻"。
2. **三级强度**，每条自标：`原件`（页面/PDF/commit 直接读到）/ `二手`（他人转述、聚合站）/ `推测`。
   `推测`不许写成事实。
3. 抓取失败要写**具体状态码与客户端**（curl 还是浏览器、403/429/404/需登录），
   **不许**把"被限流/要登录"写成"该网页不存在/项目已撤"。
4. 不要用我们的结论去"印证"外部页面；也不要引用委托方仓库里的任何推断
   （我们自己的东西我们清楚，你的价值在于我们够不到的地方）。
5. **只读**：不发帖、不评论、不申请账号、不联系任何个人（含邮件/私信），不绕过登录墙。
6. 检索要留痕：每个 P 项把你用过的**检索式**原样列出来，方便复查覆盖度。
7. 长度控制：正文 ≤ 3,000 字，其余用表；**时间线一条一行**；每条给 URL。

### 交付格式

```
# PortableSDR 历史普查（你的版本号 + 日期）
## 1. 外部时间线（与 GitHub 时间线合并后按日期排）
## 2. 众筹与销售（档位/金额/发货/渠道现状）
## 3. 社区足迹（谁在什么时候说了什么，带数字的单列一张表）
## 4. 视频与多媒体
## 5. fork 与衍生谱系
## 6. 断供件与厂商时间线
## 7. 人物表（作者、贡献者、维护者、重要用户：各自在本项目里做过什么）
## 8. 未找到清单（搜过什么、怎么搜的、结果码）
## 9. 与委托方已知事实冲突的地方（重点！我们最想知道自己哪里说错了）
```

第 9 节如果为空，要明说"未发现冲突"，不要留空。

## （贴到这里结束）

---

## 给委托方（我们）的落地说明，不给他

- 他交回后按 `docs/PSDR-external-findings-2026-11-03.md` §0 的验收法处理：
  先核 URL 是否可达（我们自己的出口复测一遍，注意 429 与 404 的区别），再抽关键数字回原文核对，
  然后**只进 `docs/PSDR-chronicle.md` 的第一纪补**，并同步 `docs/PSDR-documentation-archive.md` 的线索段。
- 我们要特别警惕他带回的"众筹/销售"信息：那会改变"约 100 台"的口径与断供件的可得性判断。
- 若他带回任何与 `#9` 那条 `-70 dBm / 50 dB missing` 相冲突的实测，必须先修对外文本再更新内部文档
  （那条我们已经公开引用过，见 #16 的三条评论）。
