fe1iscurc0r/PSDR/Hardware/PSDR Schematic.pdf

# TODO:

## Rename pins and stuff

## Add light sensor for backlight, you know?

## Change over to new LCD

## Add temperature sensor near freq reference

## Add ability to turn off subsystems (like RF)

## Look into magnetic encoder

## antenna tuner?

# DONE:

## Clean up schematic (to resemble block diagram)

# Later?:

## multitap inductor?

# NOTES:

## Analog dies at about 2.3v Digital also dies at about 2.4v, but the display becomes very dark at 2.7~

Looks like life is pretty good at 2.9v.

## Add test points to relevent locations

## Power cuttoff circuit

## do I like using half-vcc, or just putting voltage dividers all over the place?

## detect charger type (usb type) and adjust charge current appropriately? low pass filter on the audio out?

Actually, the speaker does kinda work, if the earphone interted line is pulled high by the MCU (it leaks noise into the system though.)

So I think the interted pin isn't working as expected. Need to fix that.... don't we?

# PARTS TO FIND and include:

# LAYOUT TODO:

## 5v Regulator? Maybe a 5v linear reg too

Attenuate TX driver outputs to maximize resolution going into the filter, or I could just turn off the filter gain...

If charging with a v6 solar panel, both the boost and buck regulators will be subjected to voltages over spec!!

## +3V3 is the main analog rail +3V3_CPU is the main digital rail

## (As it's currently designed, these run around 2.9v

## +5V is the power in through the USB connector +5V_BOOST is the output of the 5V boost converter

## upgrade to better GPS module!!

## Change C93 and 94 to 0603

Maybe I should use one crystal for the MCU and have it output to the Si5338 so they are locked together.

## Looks like I need a new speaker. (Make it something that can be soldered!)

Add pin one mark to U1 (it really doesn't have one? Oh it's clipped by C1) Also soldermask dam on this part is no good

## Silkscreen between pads of 0603s didn't turn out. Options?

## Soldermask oversized? Did I do that or the board house?

## copper keepouts around some of the ICs

Lots of parts don't show up as the same type when they are, not sure why.

The earphone connector doesn't line up exactly! :0 May need to do by hand with a jig for now.

## revert mic footprint back to recomended?

## Change bom to reflect new transformers and mixers

Looks like the charge voltage divider is still not going to work. Doesn't seem to charge until 5.5v

GPS Doesn't run down to 2.8 like some of the other stuff.
so we probably need to kick the buck reg up a little. It was at about 2.9, now its just over 3. Should work.

Might want to double check the performance of the GPS antenna....

## More output capacitance on 5V Reg

## Change to Diode ring mixer and new transformers

## try neal's flip flop circuit

## Add some filtering to USB power line

## Add more capacitance around charge controller

Attempt to better length match the I/Q lines - That was a lot of work! I wonder if it was actually helpful

## Change to F7!

# Special Thanks!

## Gerald Youngblood, AC5OG / K5SDR For the SDR for the Masses articles that inspired this radio

David Brainerd, WB6DHW from whose UHFSDR the current PSDR takes its mixer design.

## Now I have a free pin again. What ever shall I do with it? -Stick an LED!

## Change BOM to use SN74CB3Q3253DBQR or similar

All analog pins, I2C, SPI, Clock lines, anything else important? PSU outputs. Anything else?

## reposition PSDR logos

## Keep away from LCD screws

## oooh, TVSs?

## The DSP Guide guy! THE BACKERS! The brave few who actually build their own examples of the PSDR Karalee Ryan, Joe

## More complete GPS antenna matching circuit

Better copper pour for RF amp and other high power parts.

## TVS?

## Even more test points?

## Pots for bias adjustment?

## Add UHFSDR style matching pad to LO input?

## Narrow paddle slots just a little

remove extra hole from encoder board connector.

## Use only one voltage divider for LPF circuit? (I just don't want to have to do the reference designators again!! :(

## U287 pin 1 mark!! AGAIN!!

## clean up silkscreens, move things around a little to avoid test points

## c251 is a little close

## remove GPS matching cap from BOM, I think

## figure out reasonable bias resistors for AMP

## Consider AD8343 to replace mixers. Looks interesting. Why didn't I find this earlier? maybe because it draws 50mA?

How about because it's lower cutoff is at 50MHz.... oh well

# GPS Interface

## Vbat is for backup battery, but since the 3v3 reg is always on

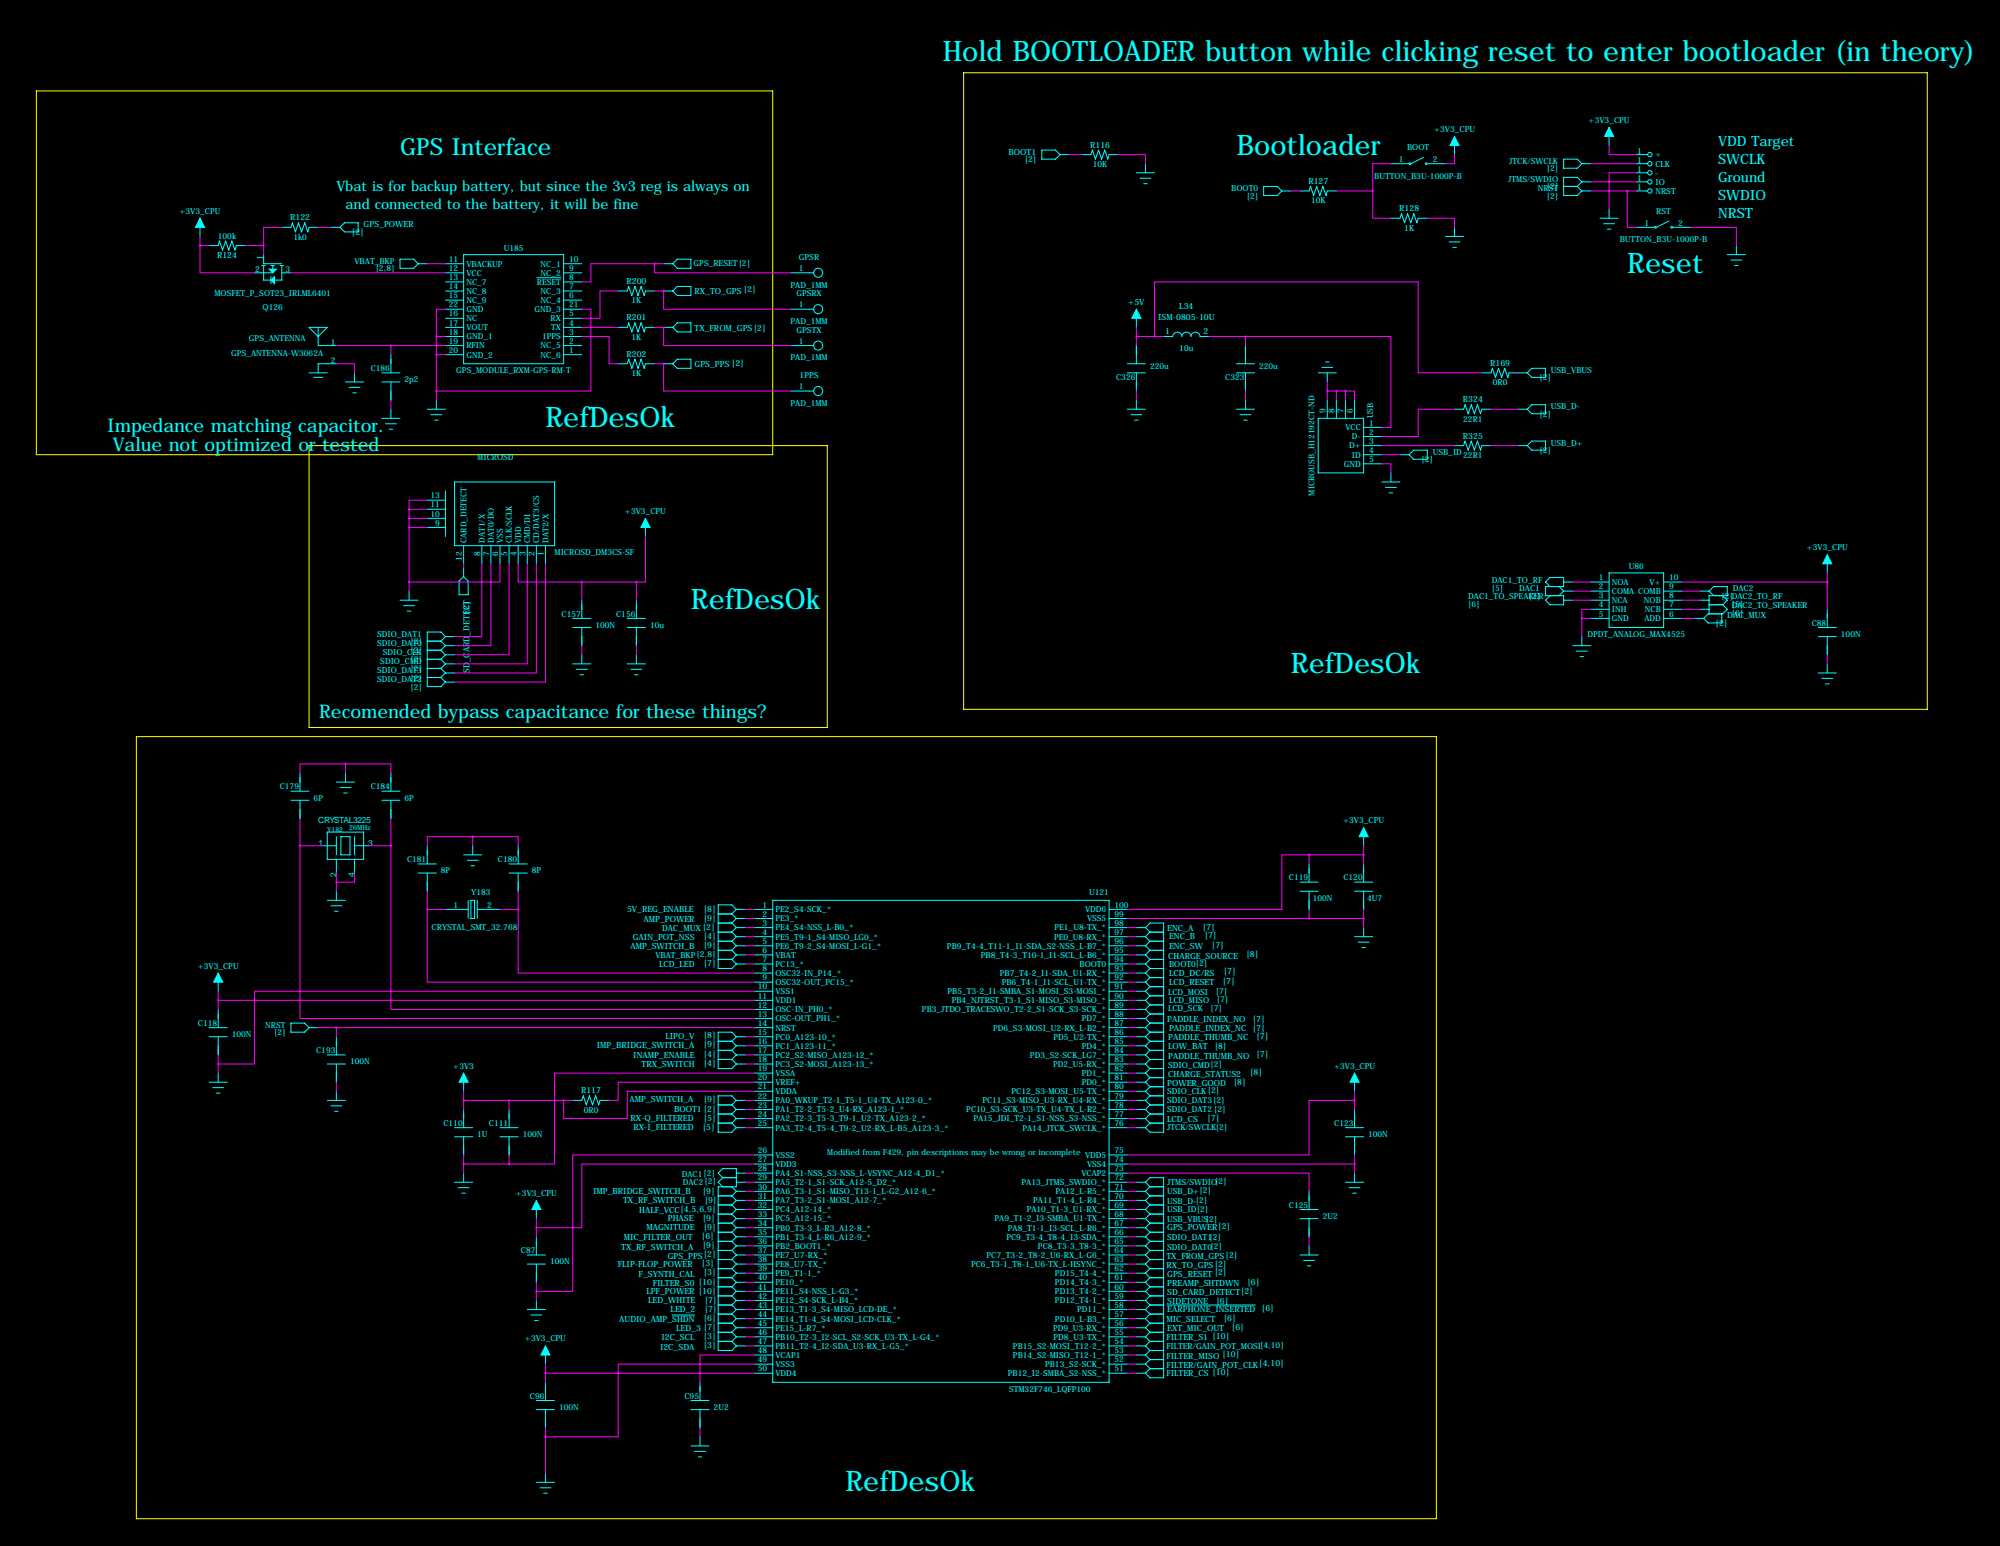
[picture p28: page 2]

Hold BOOTLOADER button while clicking reset to enter bootloader (in theory)

and connected to the battery, it will be fine

Impedance matching capacitor.
Value not optimized or tested

Recomended bypass capacitance for these things?

Modified from F429, pin descriptions may be wrong or incomplete

# Trying to reconcile values with UHF SDR2 LVDS

# Values TBD

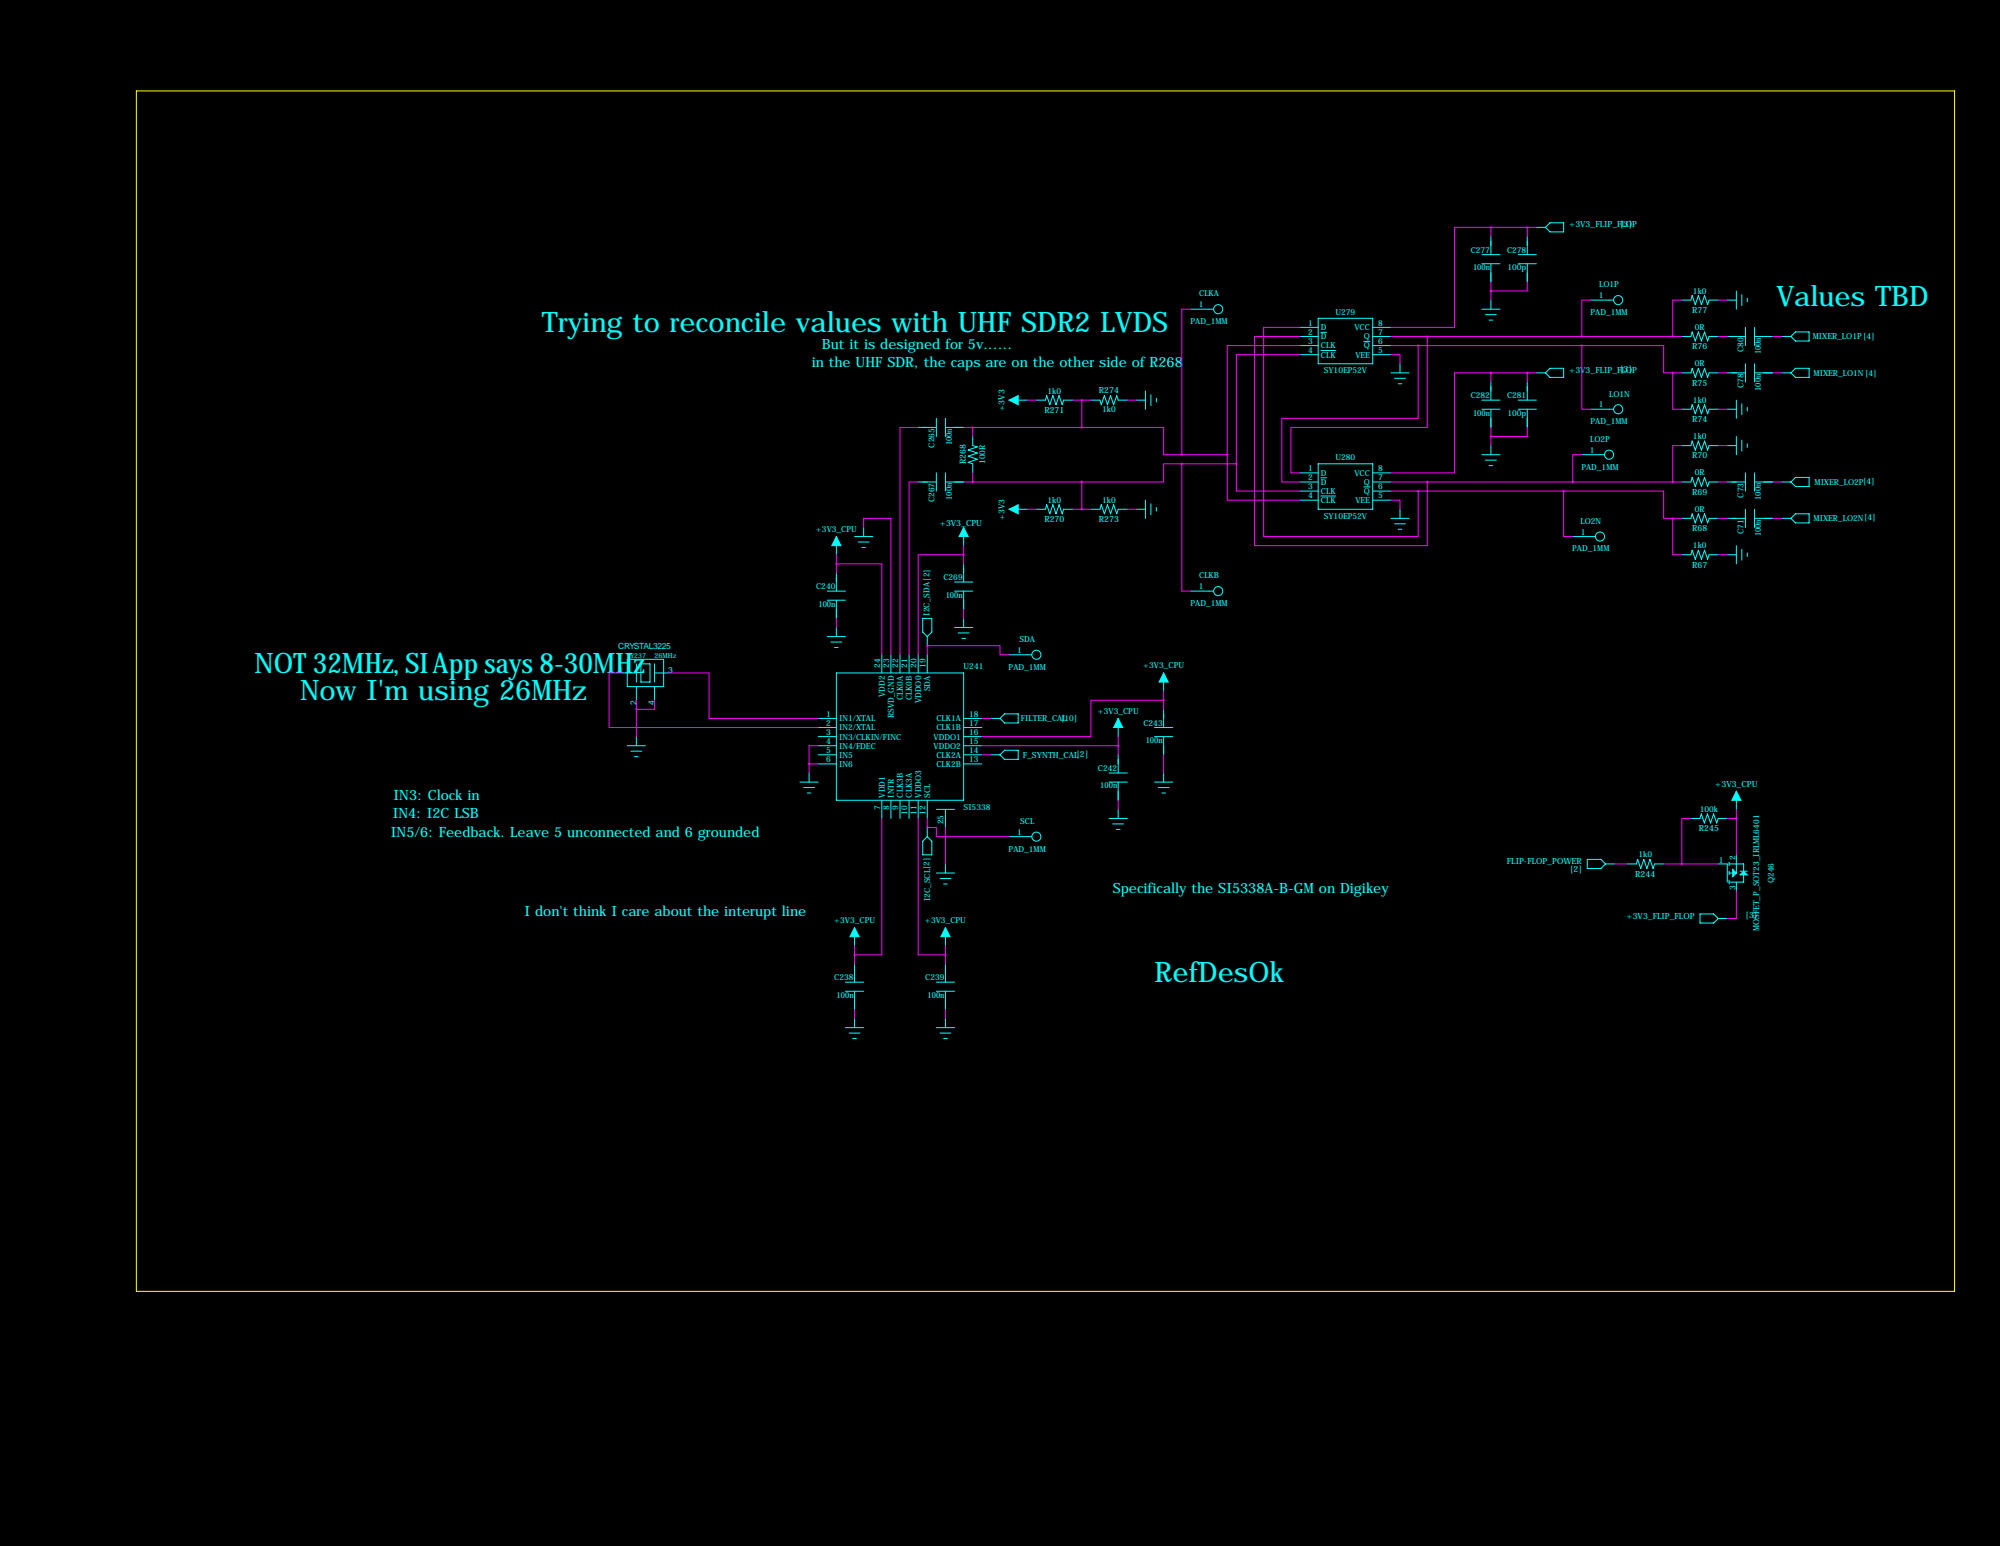
[picture p29: page 3]

But it is designed for 5v......
in the UHF SDR, the caps are on the other side of R268

NOT 32MHz, SI App says 8-30MHz
Now I'm using 26MHz

IN3: Clock in
IN4: I2C LSB
IN5/6: Feedback. Leave 5 unconnected and 6 grounded

Specifically the SI5338A-B-GM on Digikey

I don't think I care about the interupt line

These switches might not be nessesary, it might be okay to put the stuff after in parallel

# Do I want to bias these baluns? Is this design overkill?

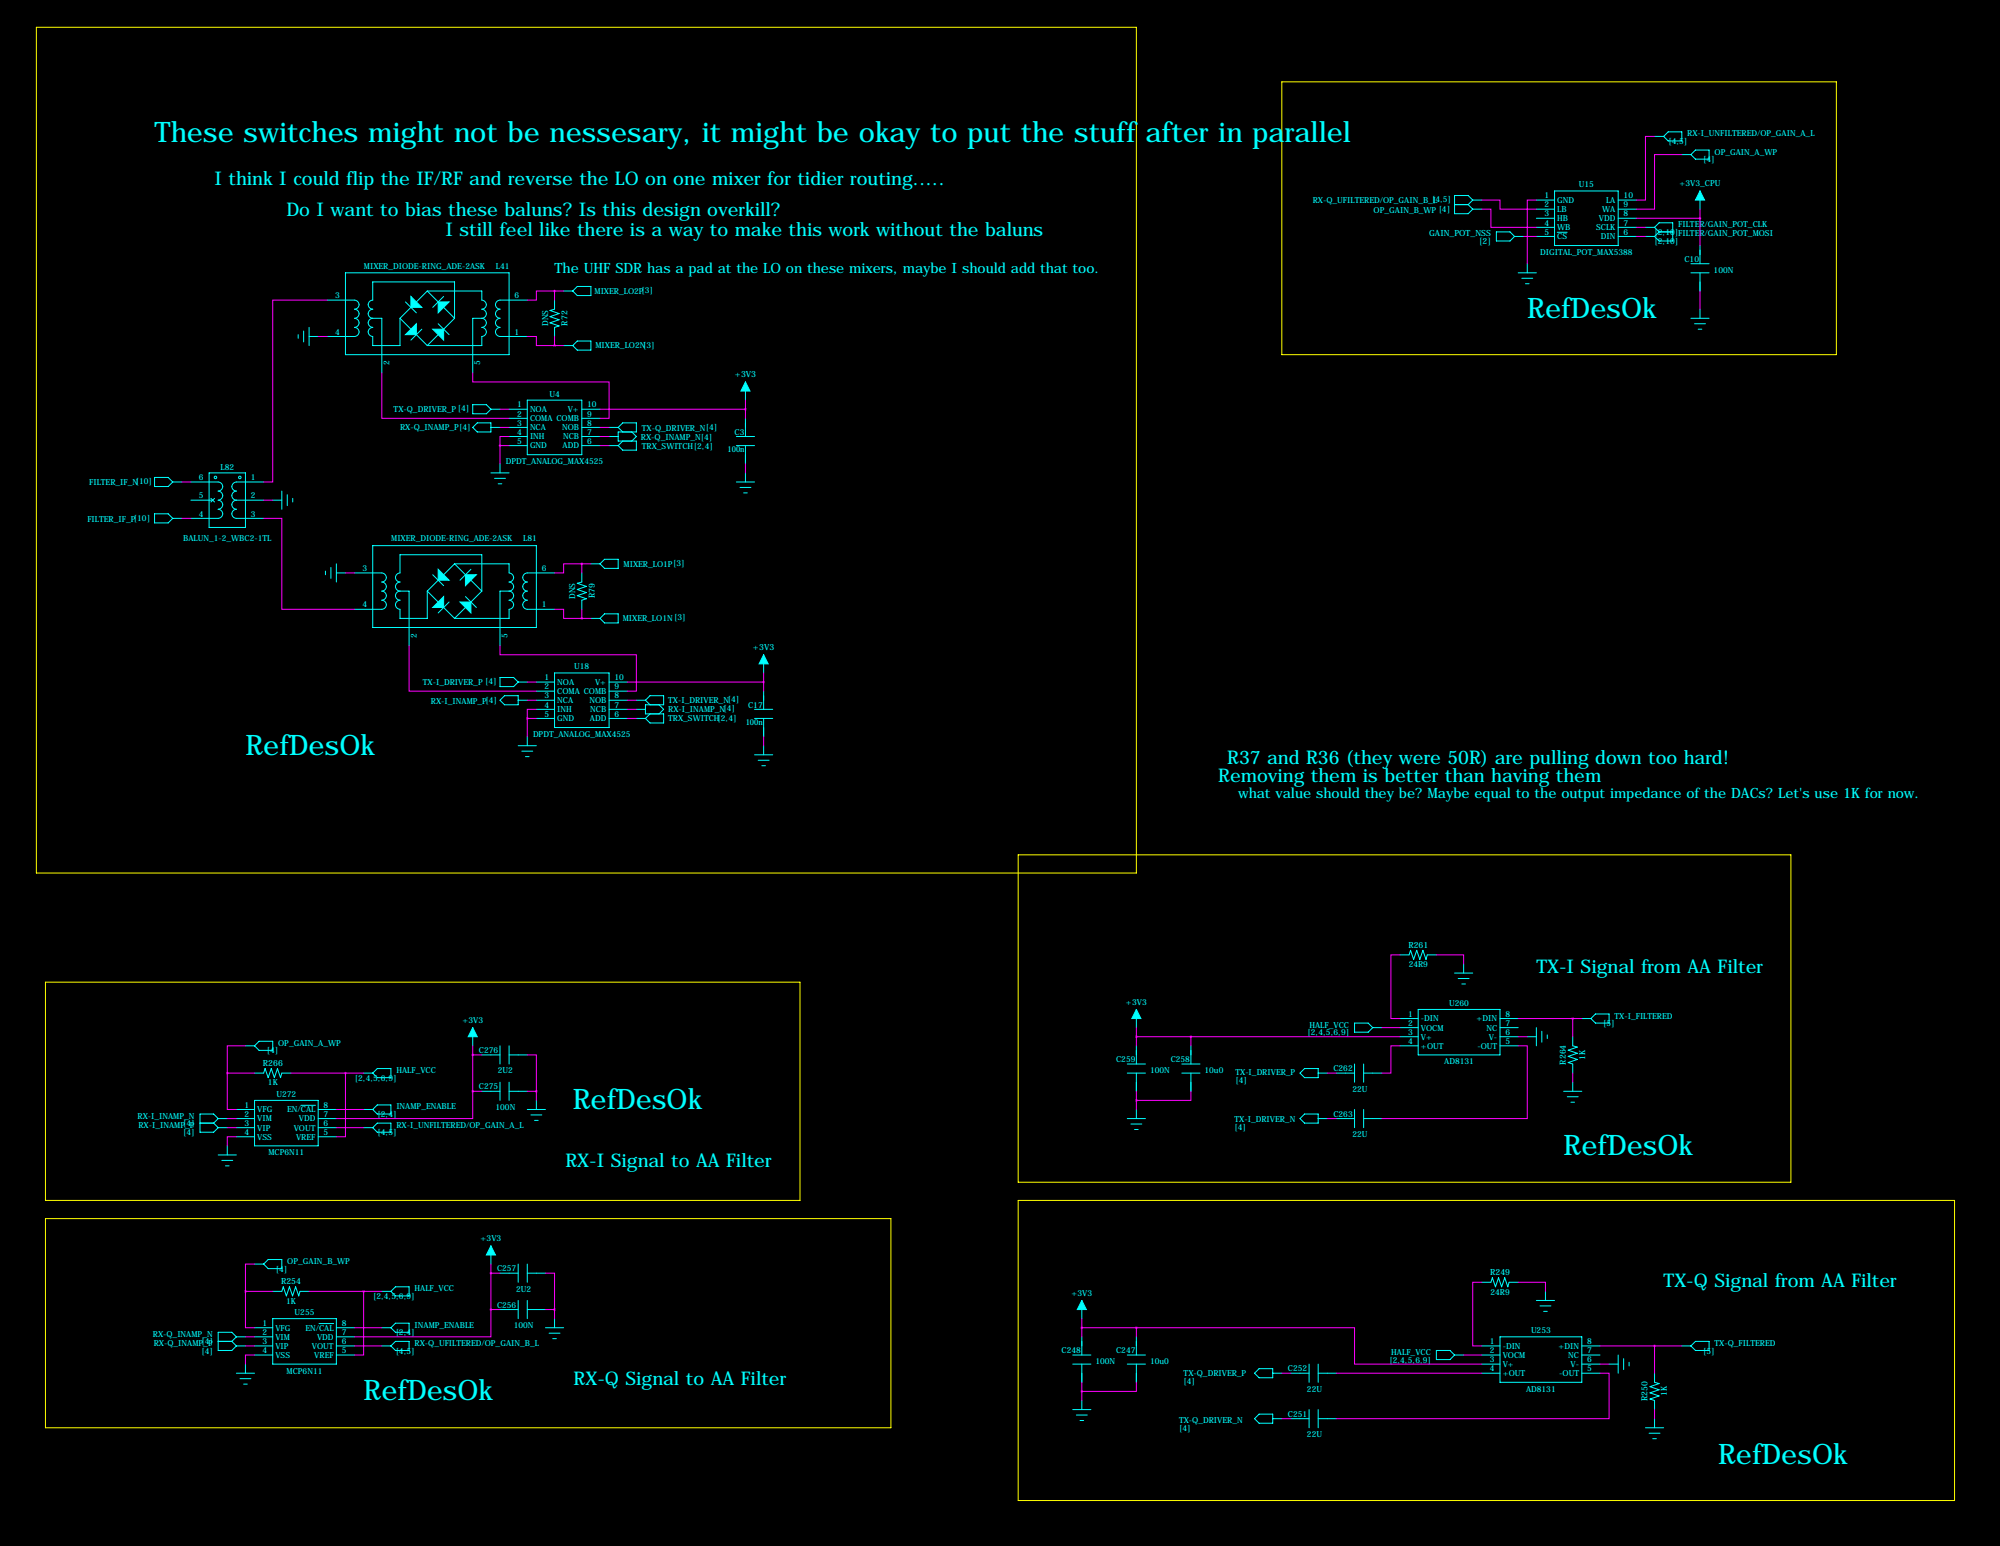
[picture p30: page 4]

I think I could flip the IF/RF and reverse the LO on one mixer for tidier routing.....

2 | 9 WA

I still feel like there is a way to make this work without the baluns

The UHF SDR has a pad at the LO on these mixers, maybe I should add that too.

R37 and R36 (they were 50R) are pulling down too hard!
Removing them is better than having them
what value should they be? Maybe equal to the output impedance of the DACs? Let's use 1K for now.

TX-I Signal from AA Filter

RX-I Signal to AA Filter

TX-Q Signal from AA Filter

RX-Q Signal to AA Filter

Antialiasing Filter | Antialiasing Filter
RX-I | RX-Q

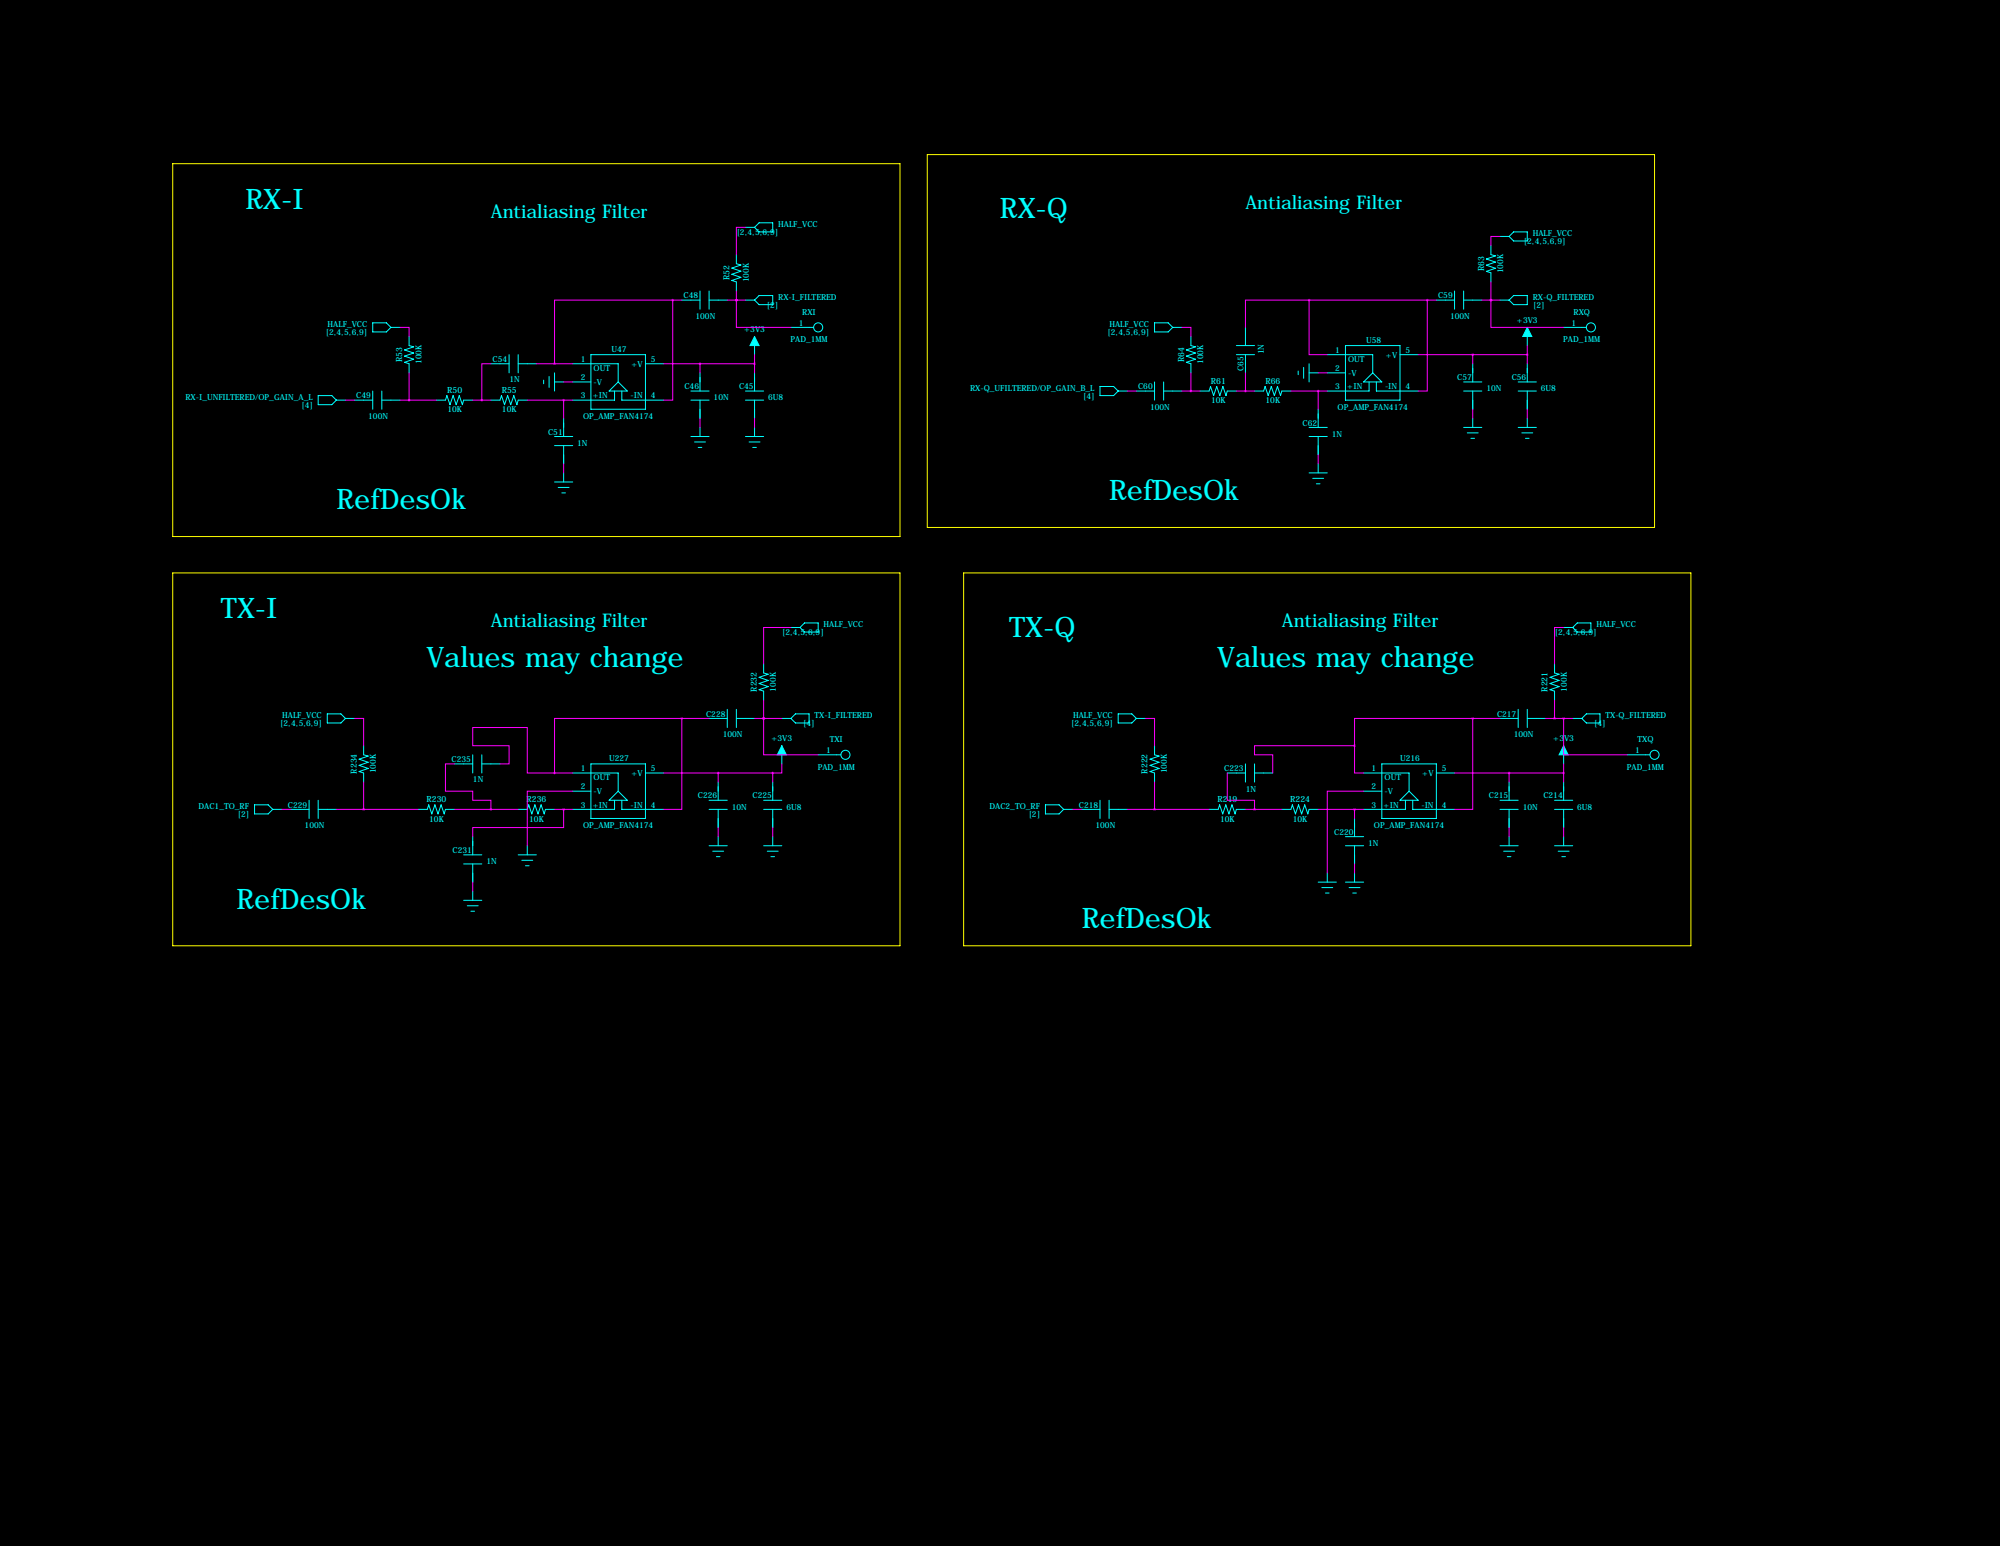
[picture p31: page 5]

Antialiasing Filter | Microphone Preamp

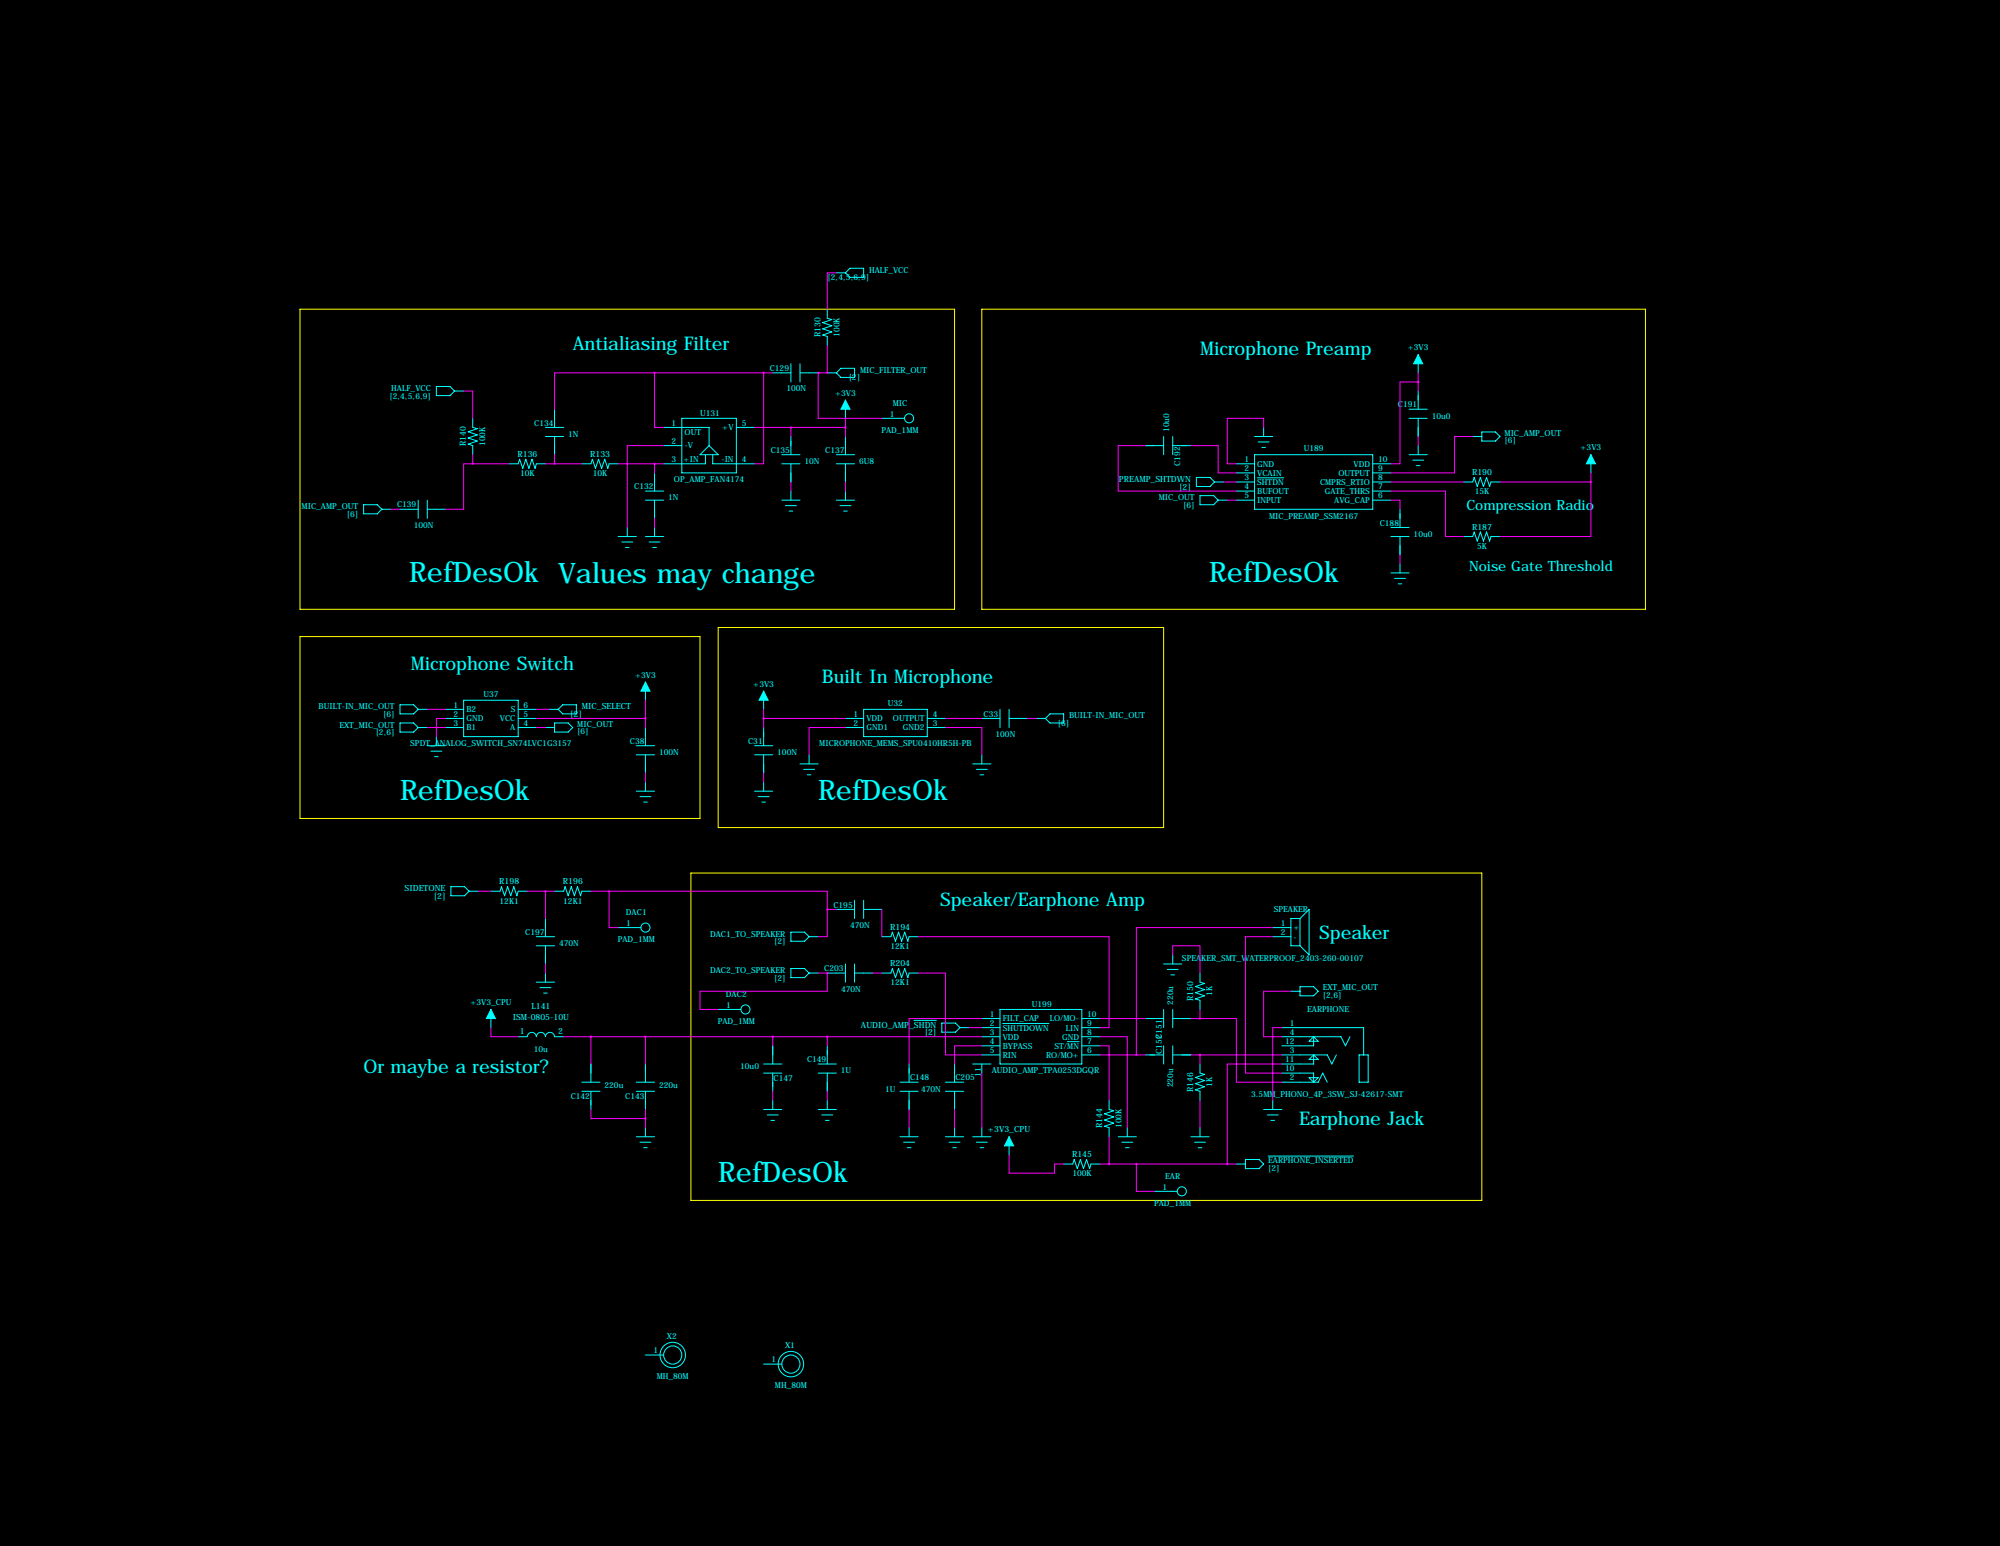
[picture p32: page 6]

Noise Gate Threshold Values may change

Built In Microphone Microphone Switch

11
10

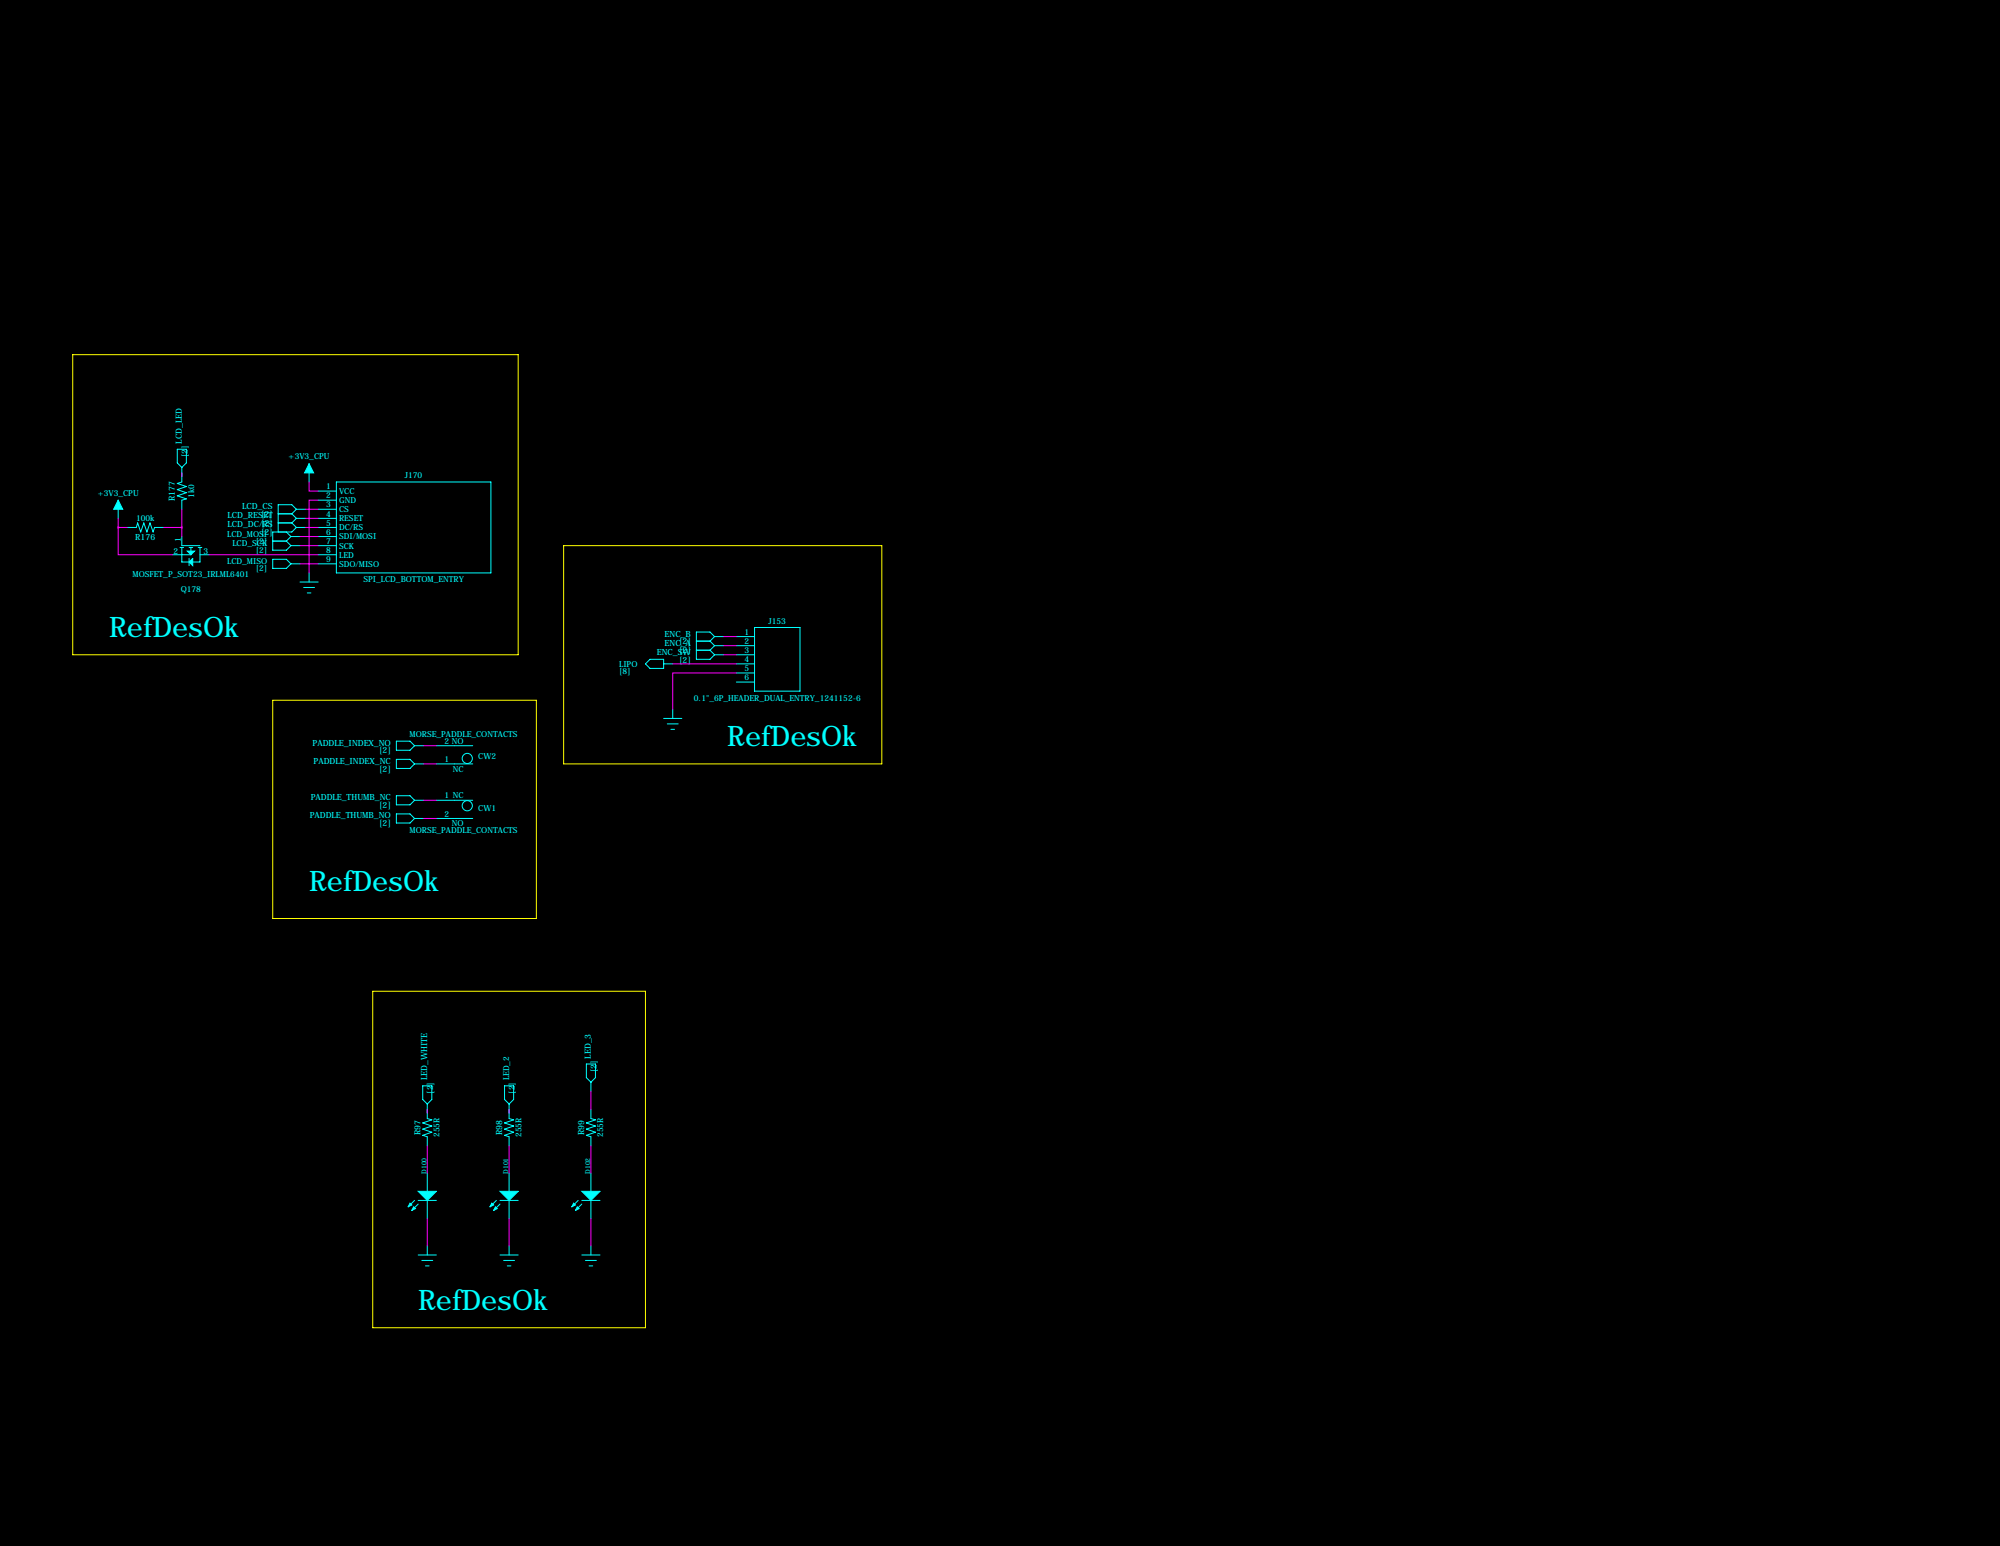
[picture p33: page 7]

# VBackup Supply

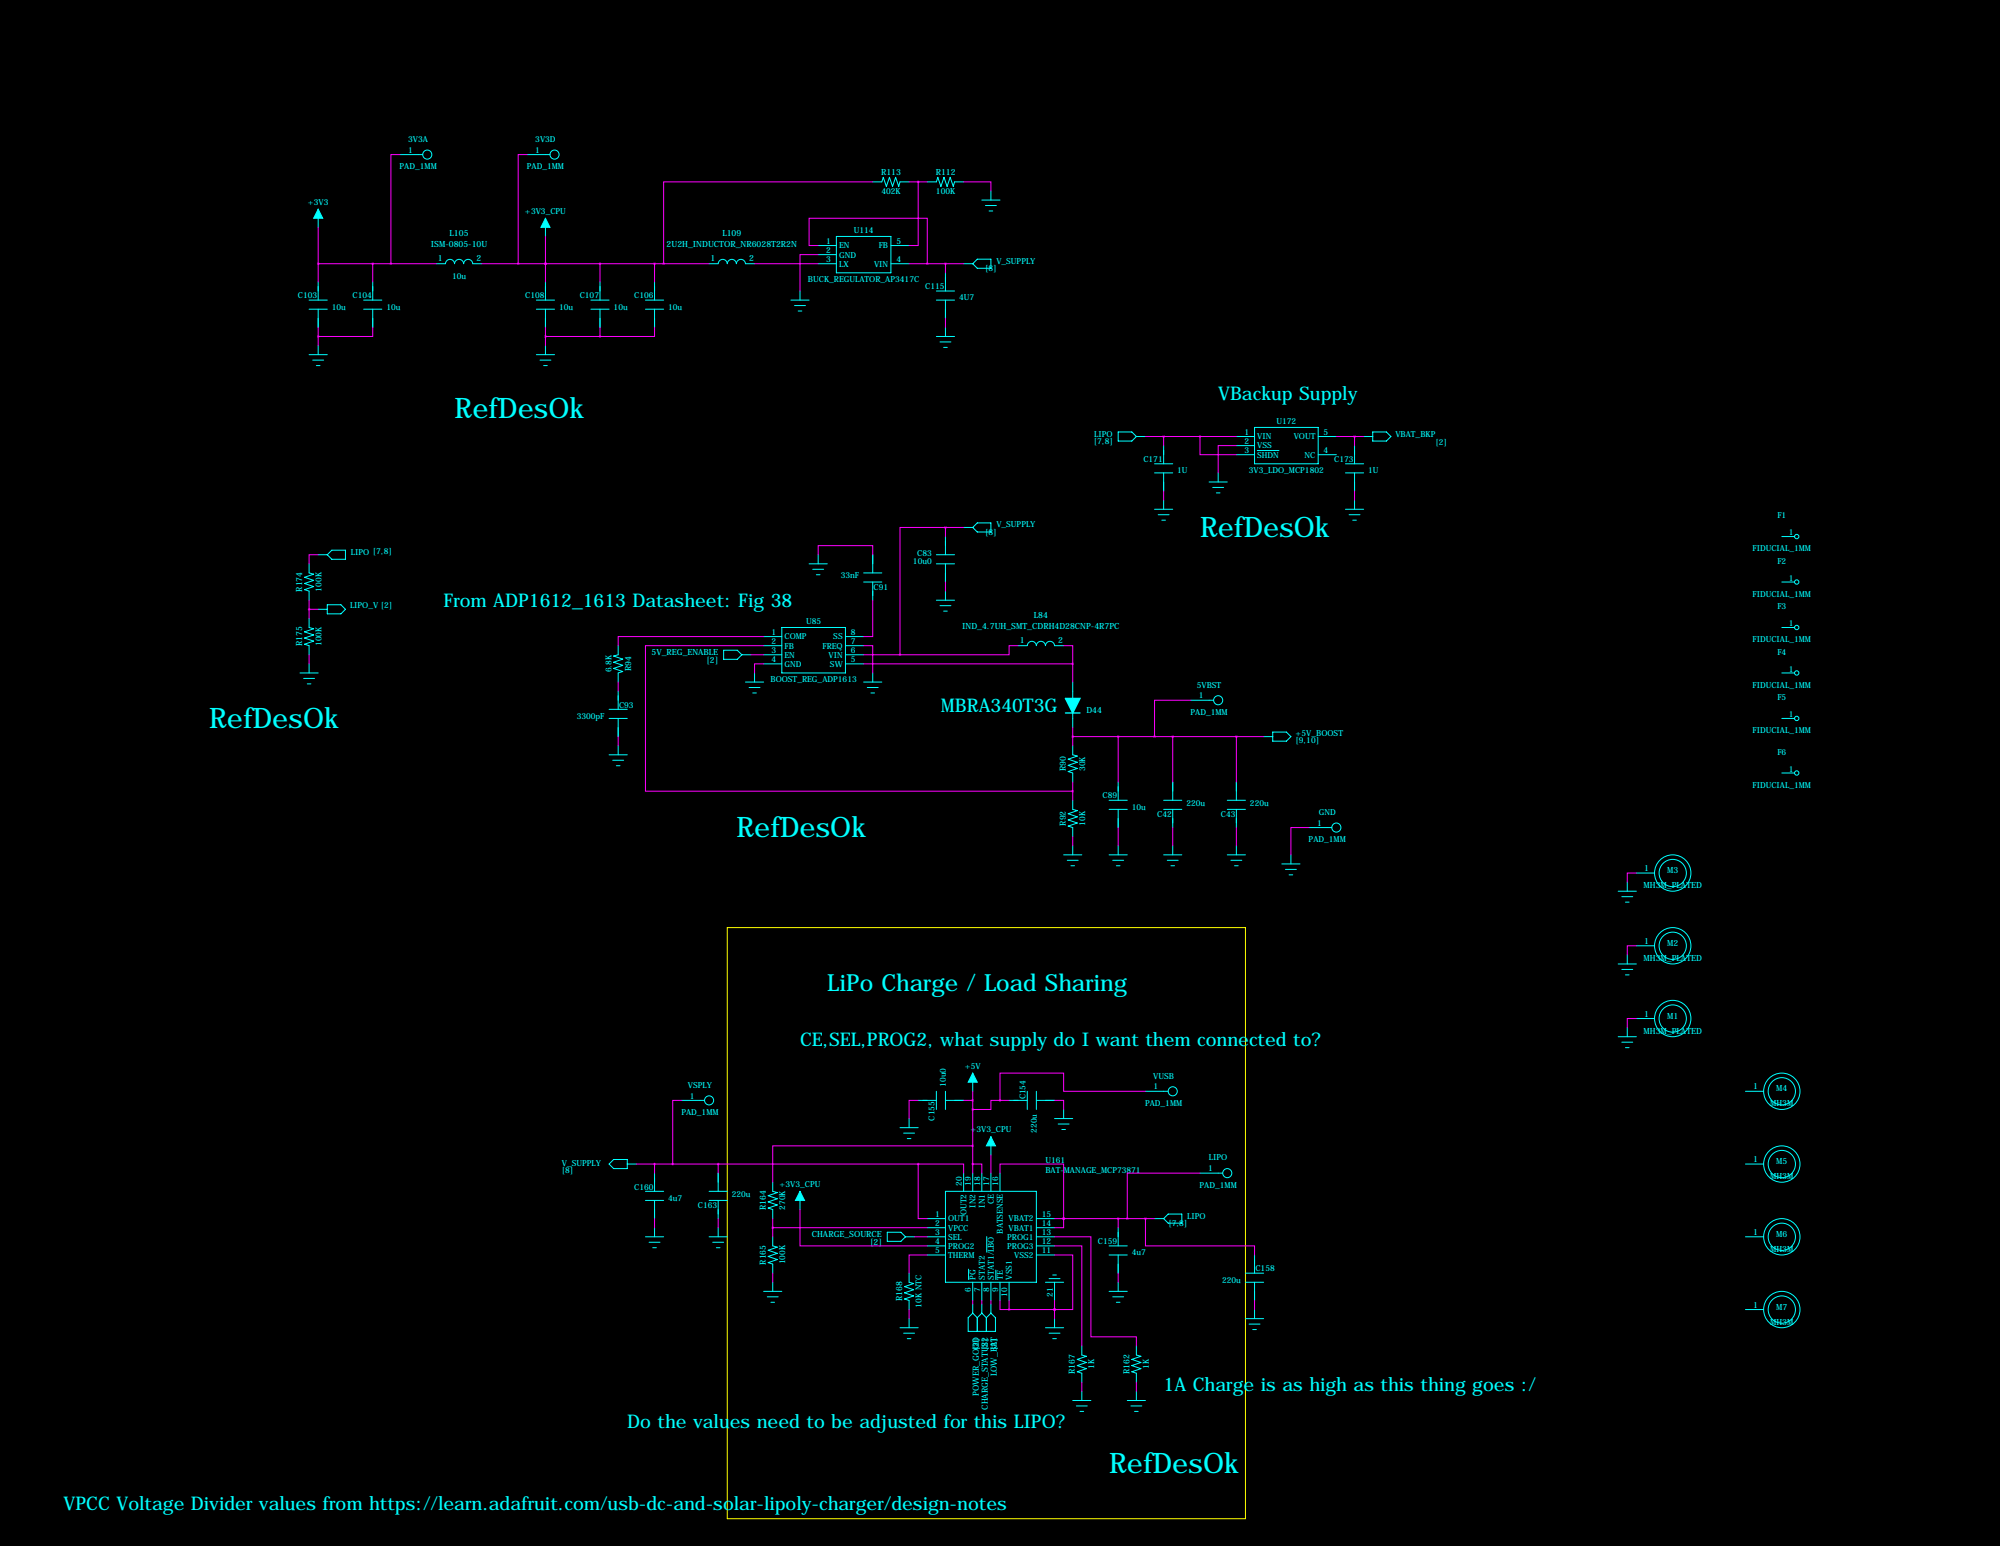
[picture p34: page 8]

LiPo Charge / Load Sharing

CE,SEL,PROG2, what supply do I want them connected to?

OUT1 2 | 15 VBAT2 14 VBAT1 13 PROG1 12 PROG3 11 VSS2

CHARGE_SOURCE [2] | VPCC 3

1A Charge is as high as this thing goes :/

Do the values need to be adjusted for this LIPO?

VPCC Voltage Divider values from https://learn.adafruit.com/usb-dc-and-solar-lipoly-charger/design-notes

# To TX power amp (warning! about 1W max for this swtich)

# 100N C35 100N

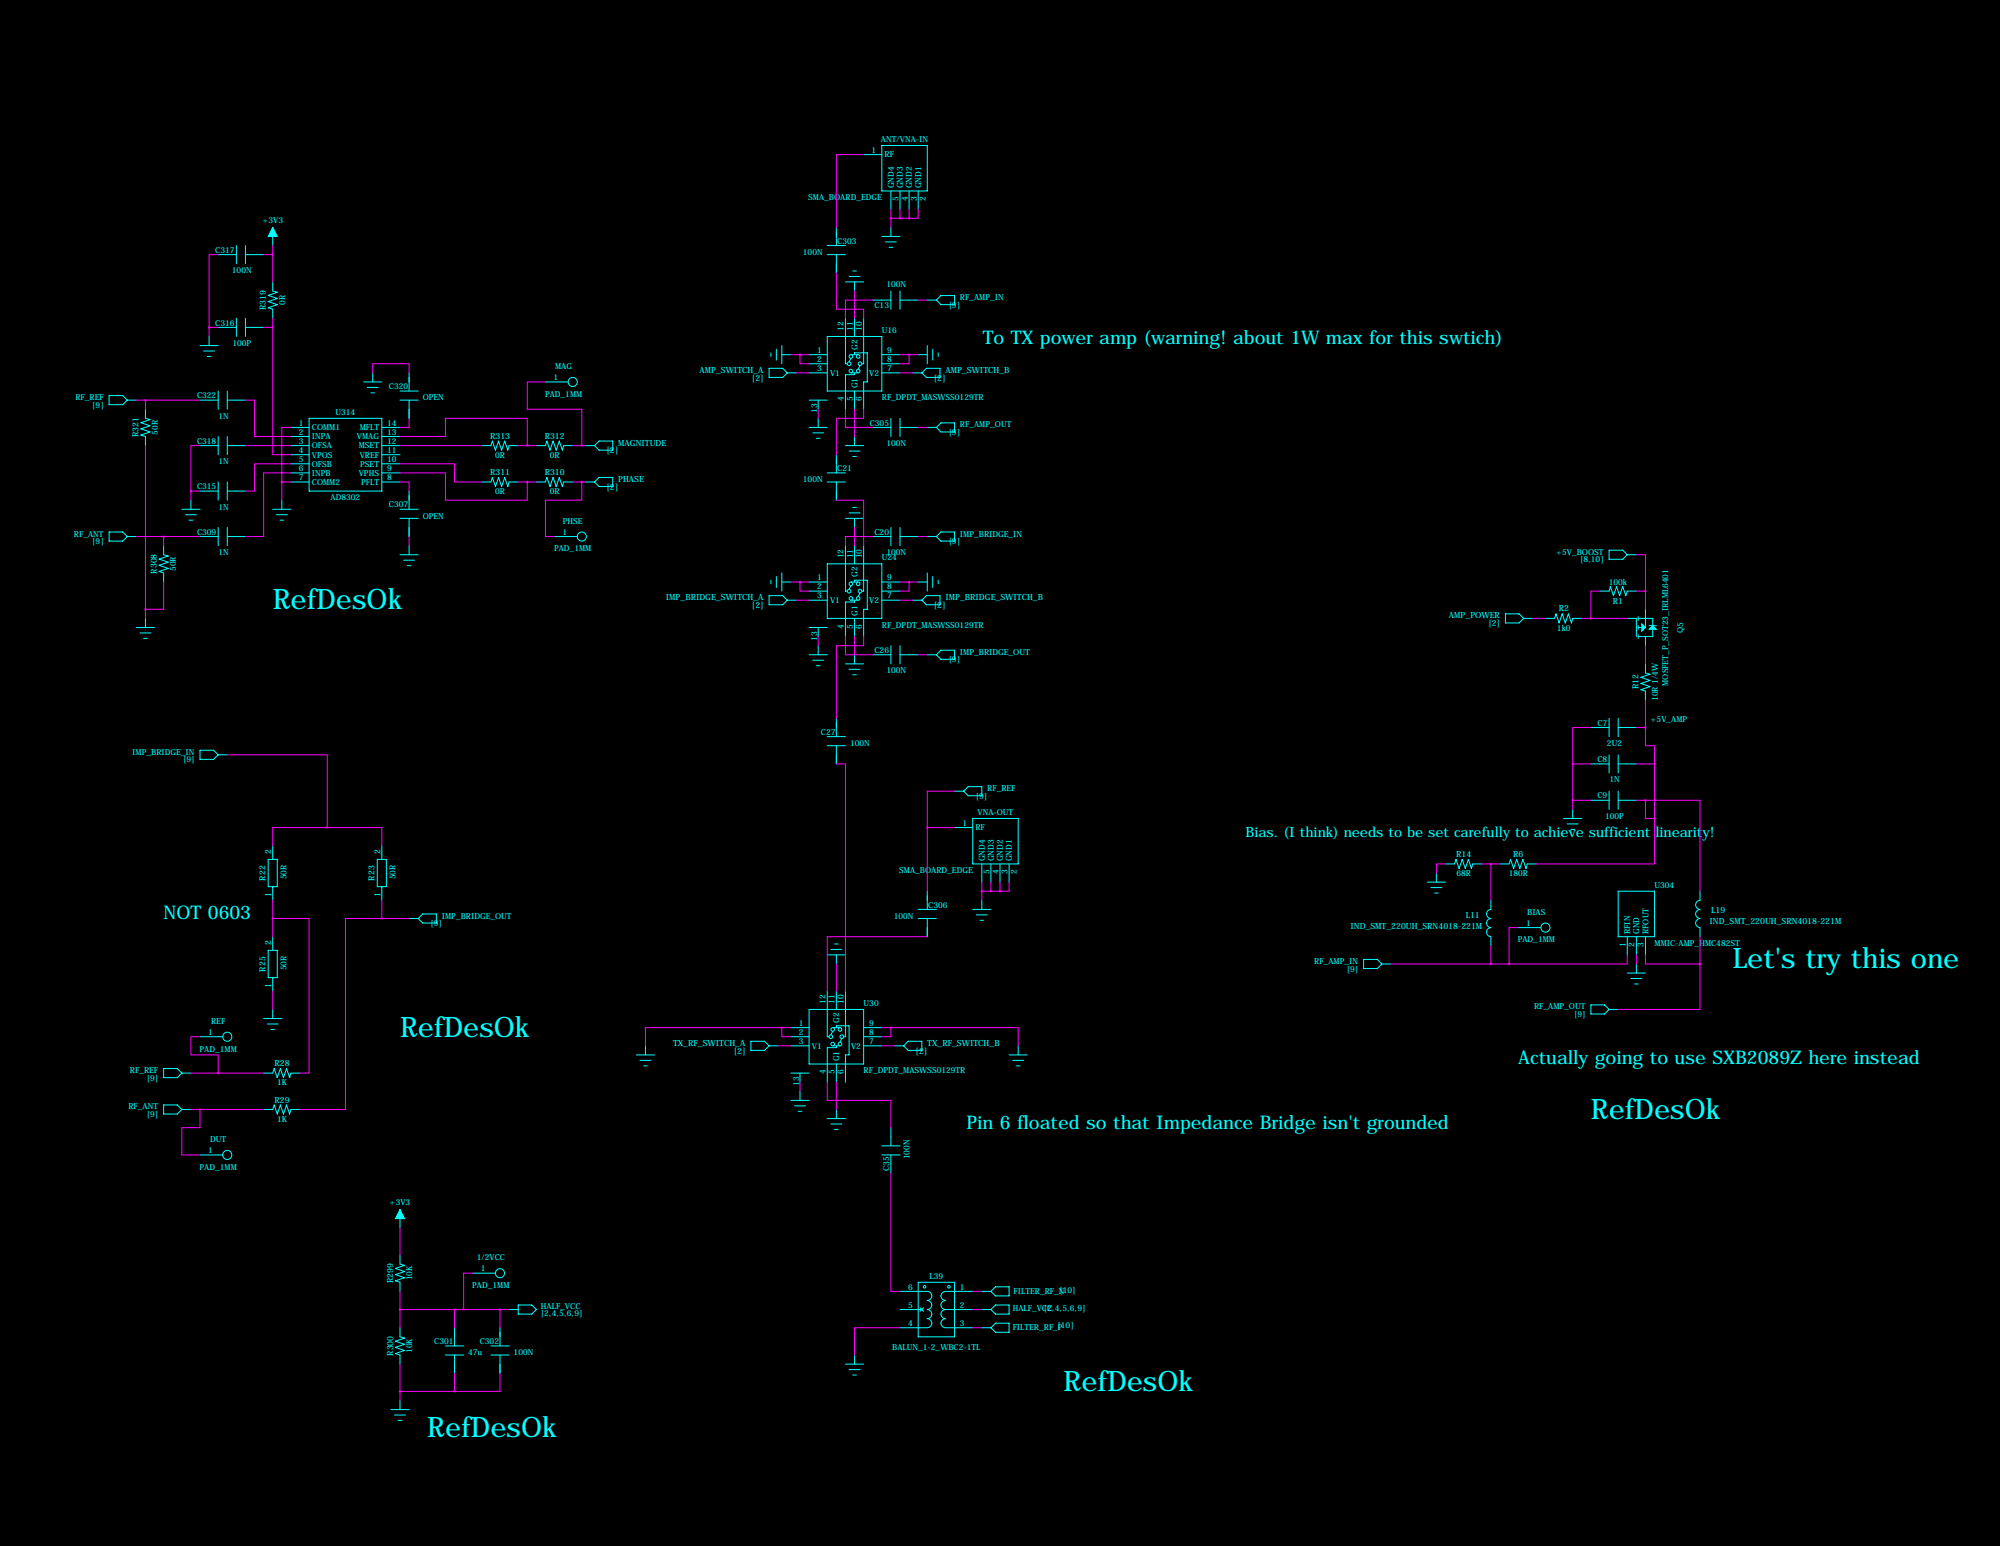
[picture p35: page 9]

INPA 3
OFSA 4

Actually going to use SXB2089Z here instead
RefDesOk

Pin 6 floated so that Impedance Bridge isn't grounded

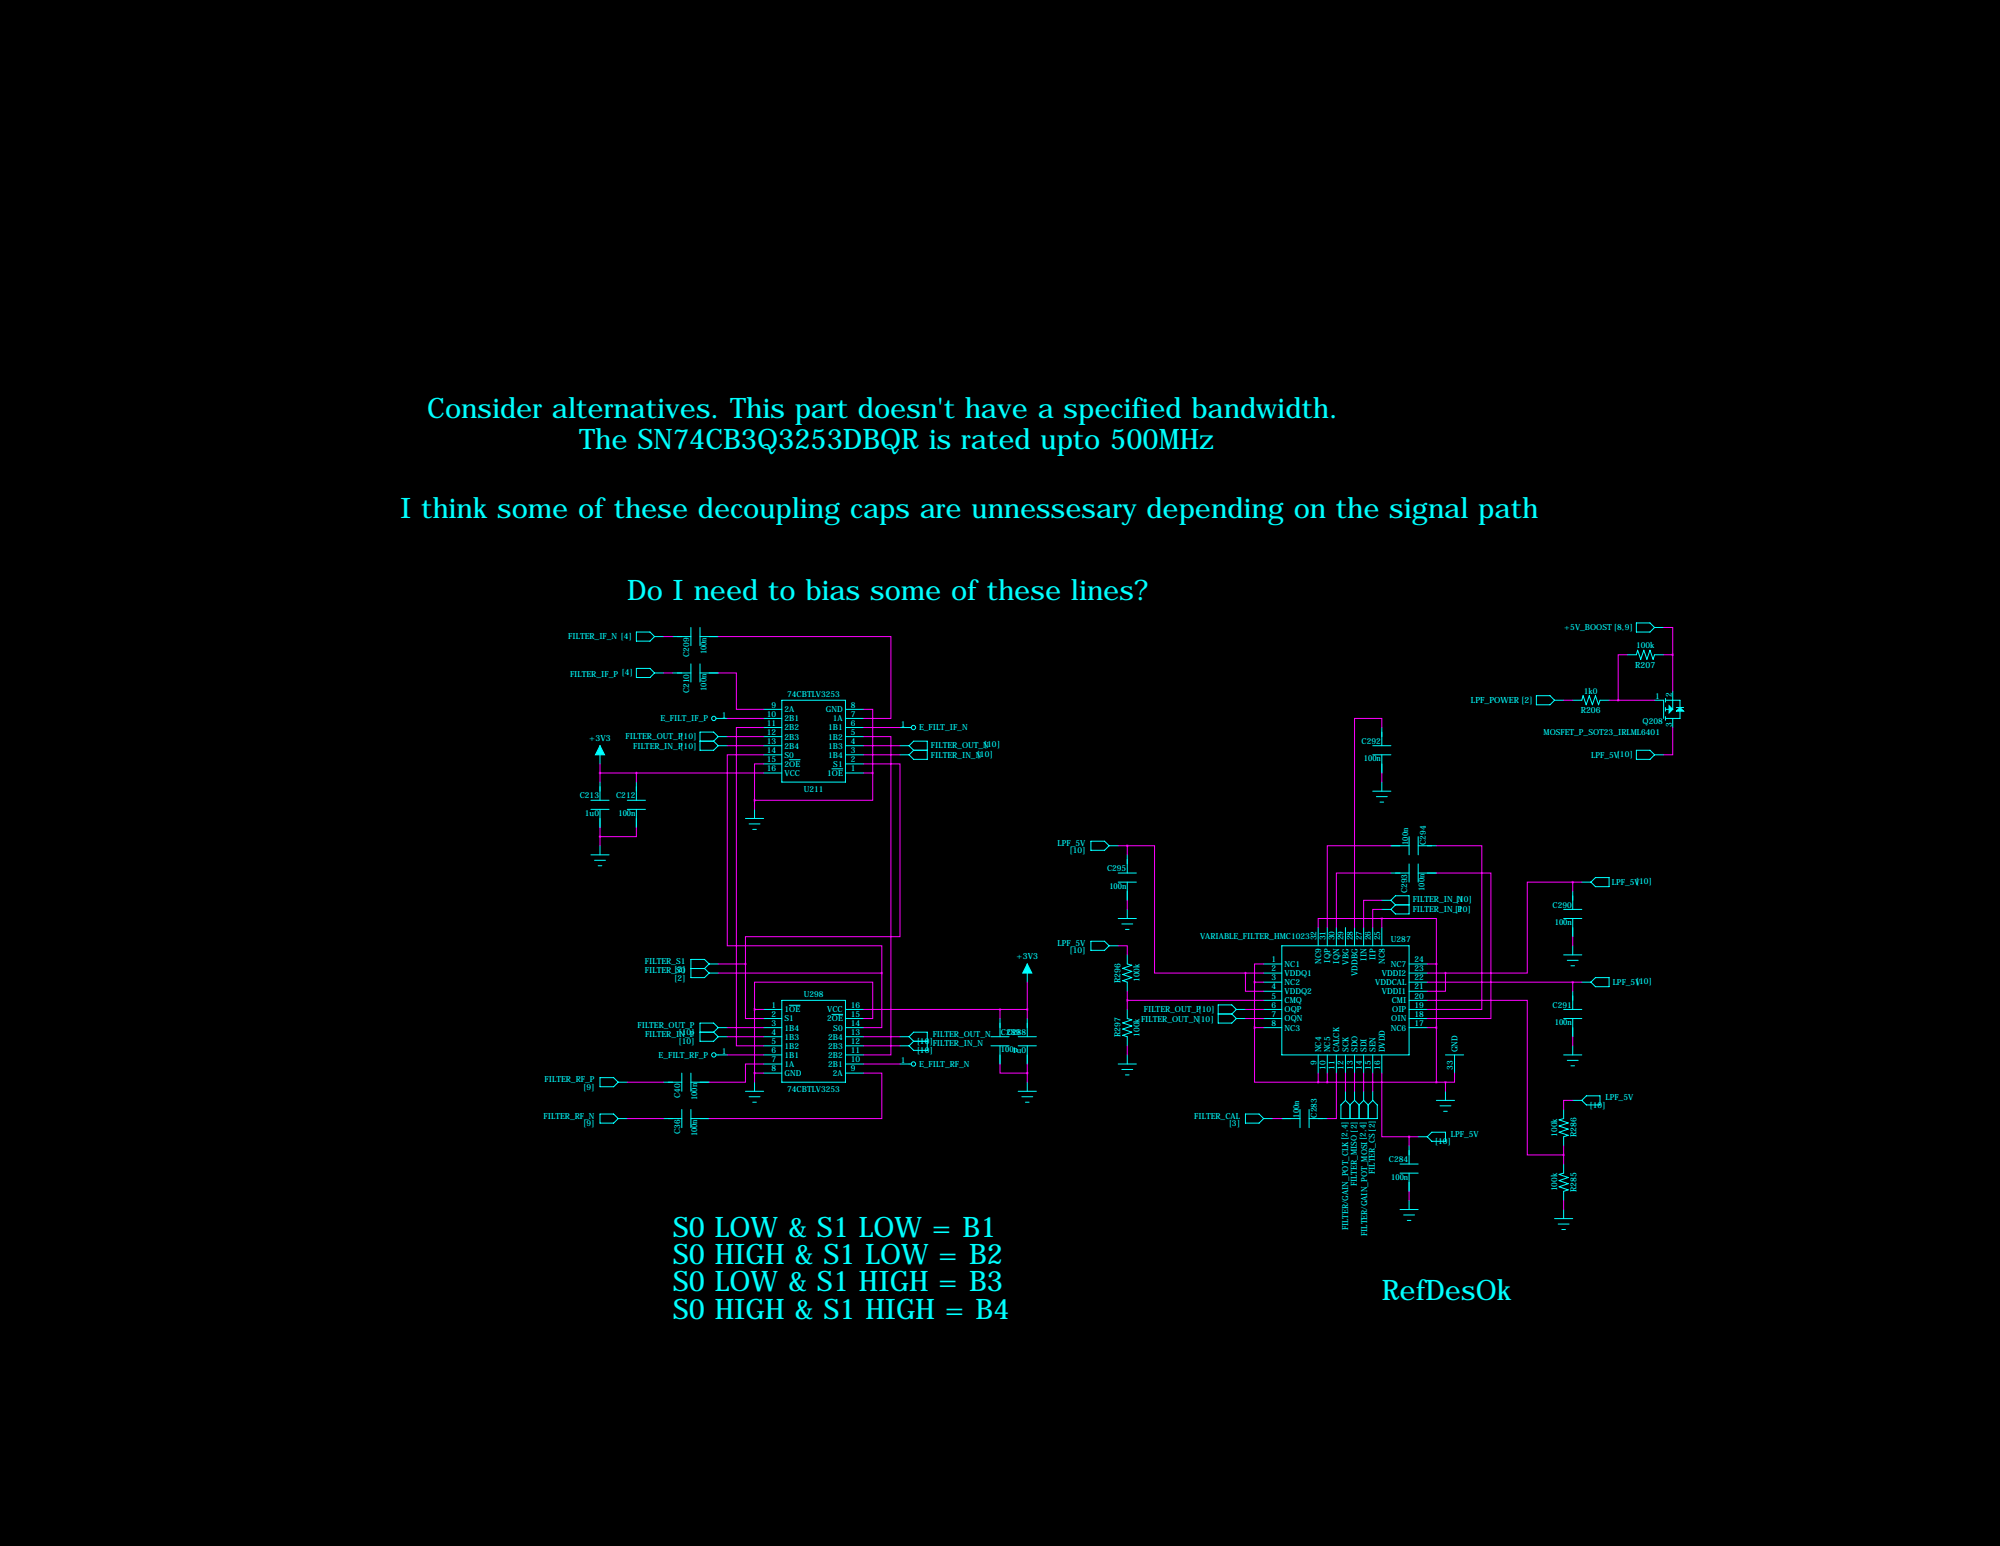
[picture p36: page 10]

Consider alternatives. This part doesn't have a specified bandwidth.

The SN74CB3Q3253DBQR is rated upto 500MHz

I think some of these decoupling caps are unnessesary depending on the signal path

Do I need to bias some of these lines?

2 | | 23
3 | | 22 21

1B4 4
1B3 5
