fe1iscurc0r/PSDR/(list of files, drawings)

Other design files:
Hardware/PSDR.pcb
Keychain/KeyChainDevBoard.pcb
Keychain/KeyChainDevBoard_Layout.pcb
