fe1iscurc0r/PSDR/dist/kicad/PSDR_2.6.1_revB.kicad_pcb

## KiCad design dist/kicad/PSDR_2.6.1_revB.kicad_pcb (2026-11-05)

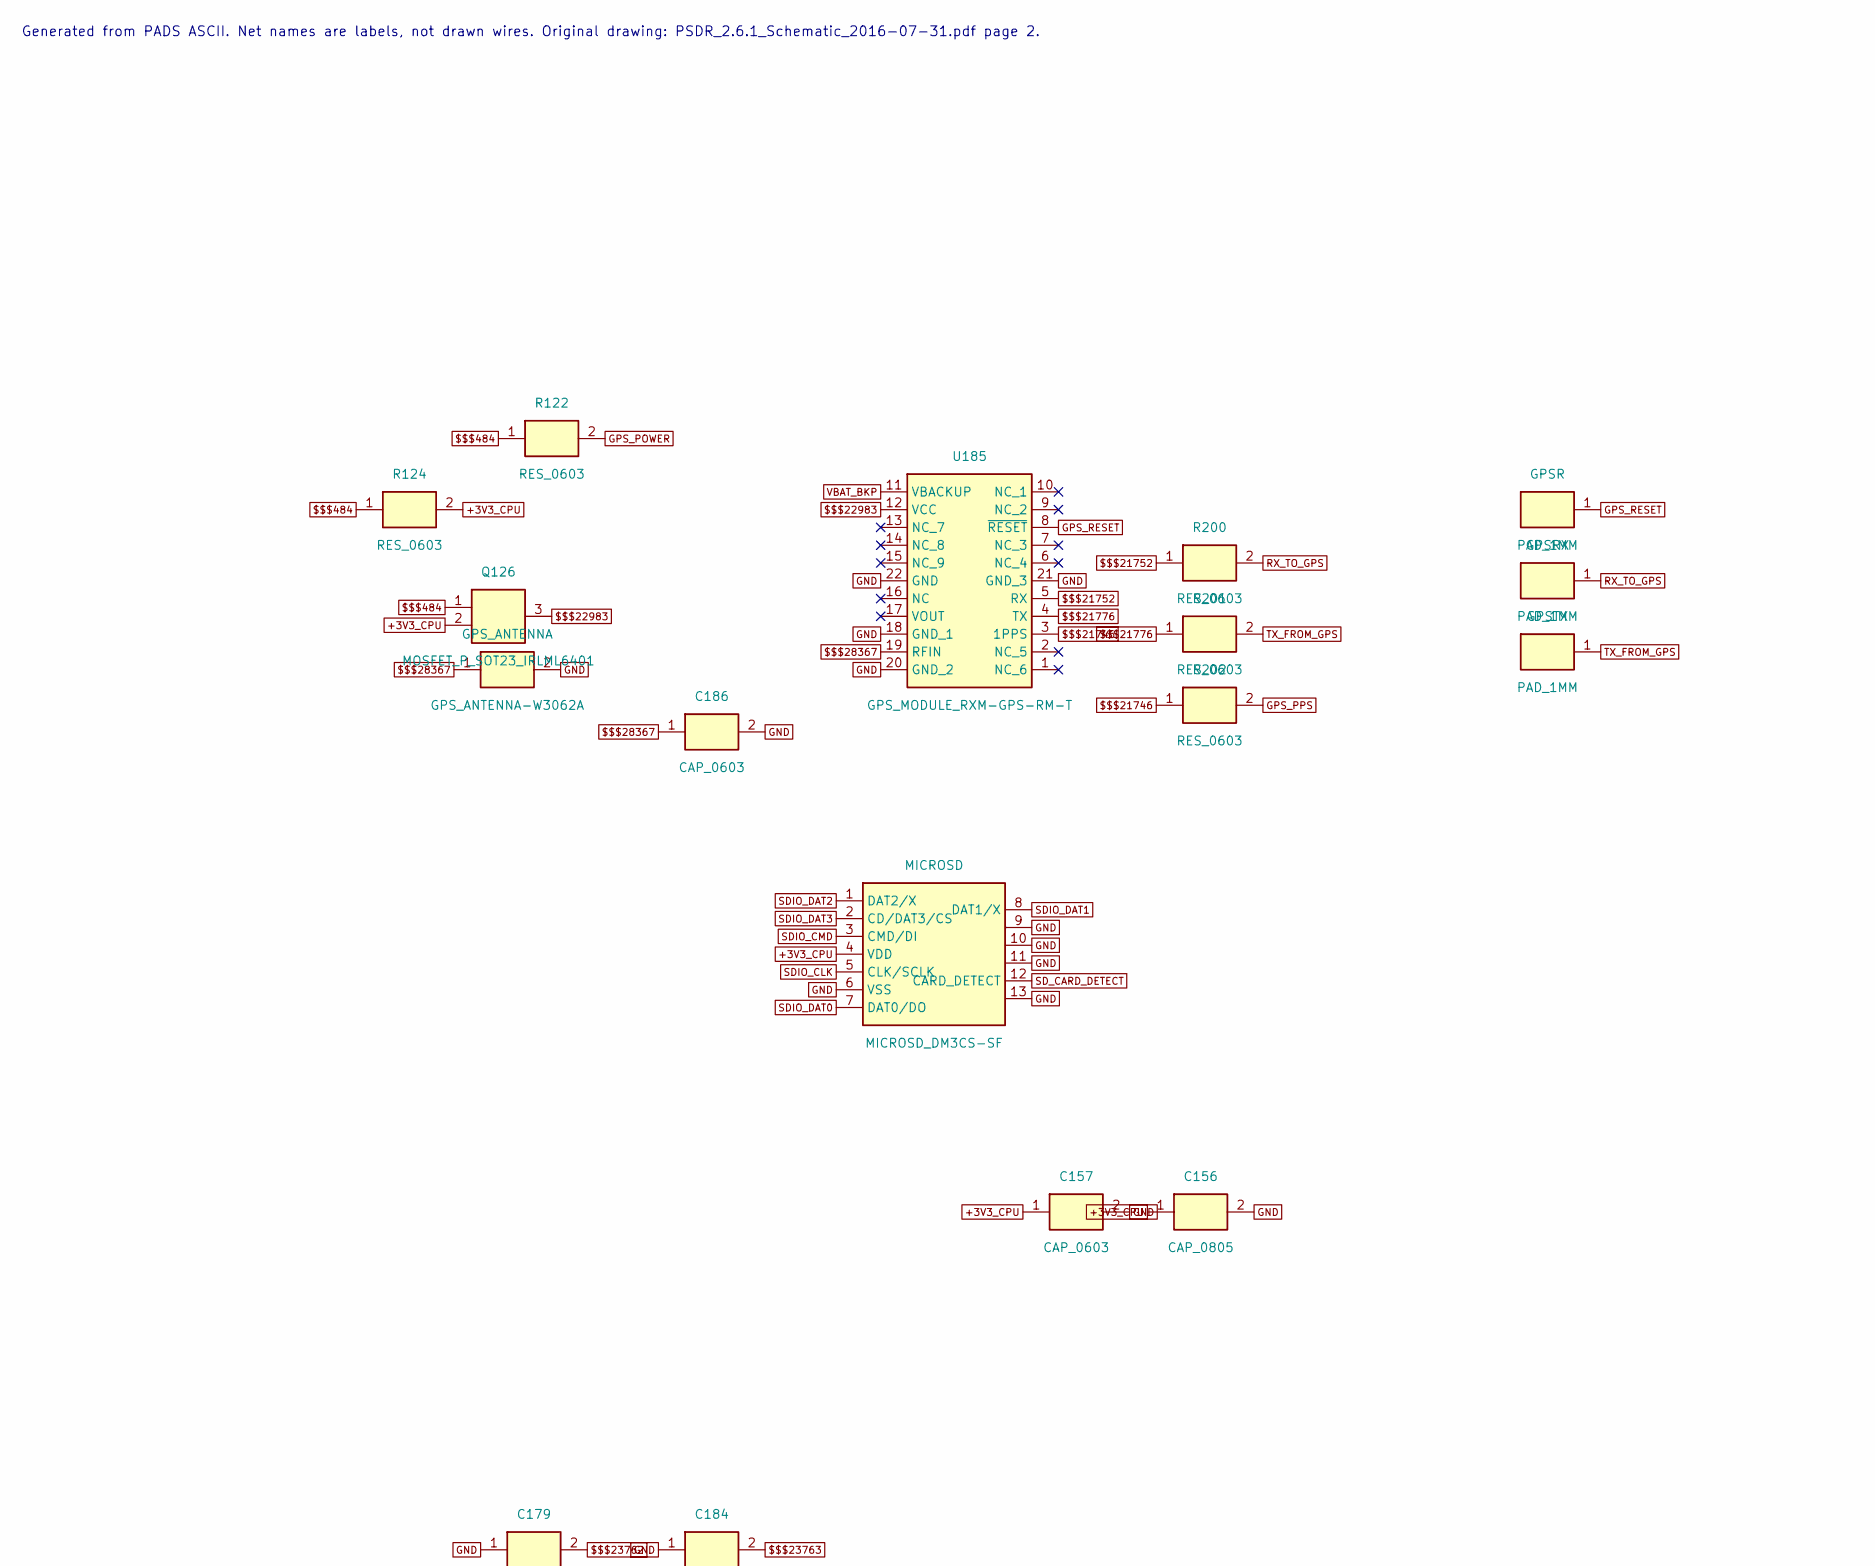
[picture p37: schematic PSDR_2.6.1-p02.kicad_sch, PSDR 2.6.1 - PDF page 2: MCU / GPS / USB, part in row 1, column 1]

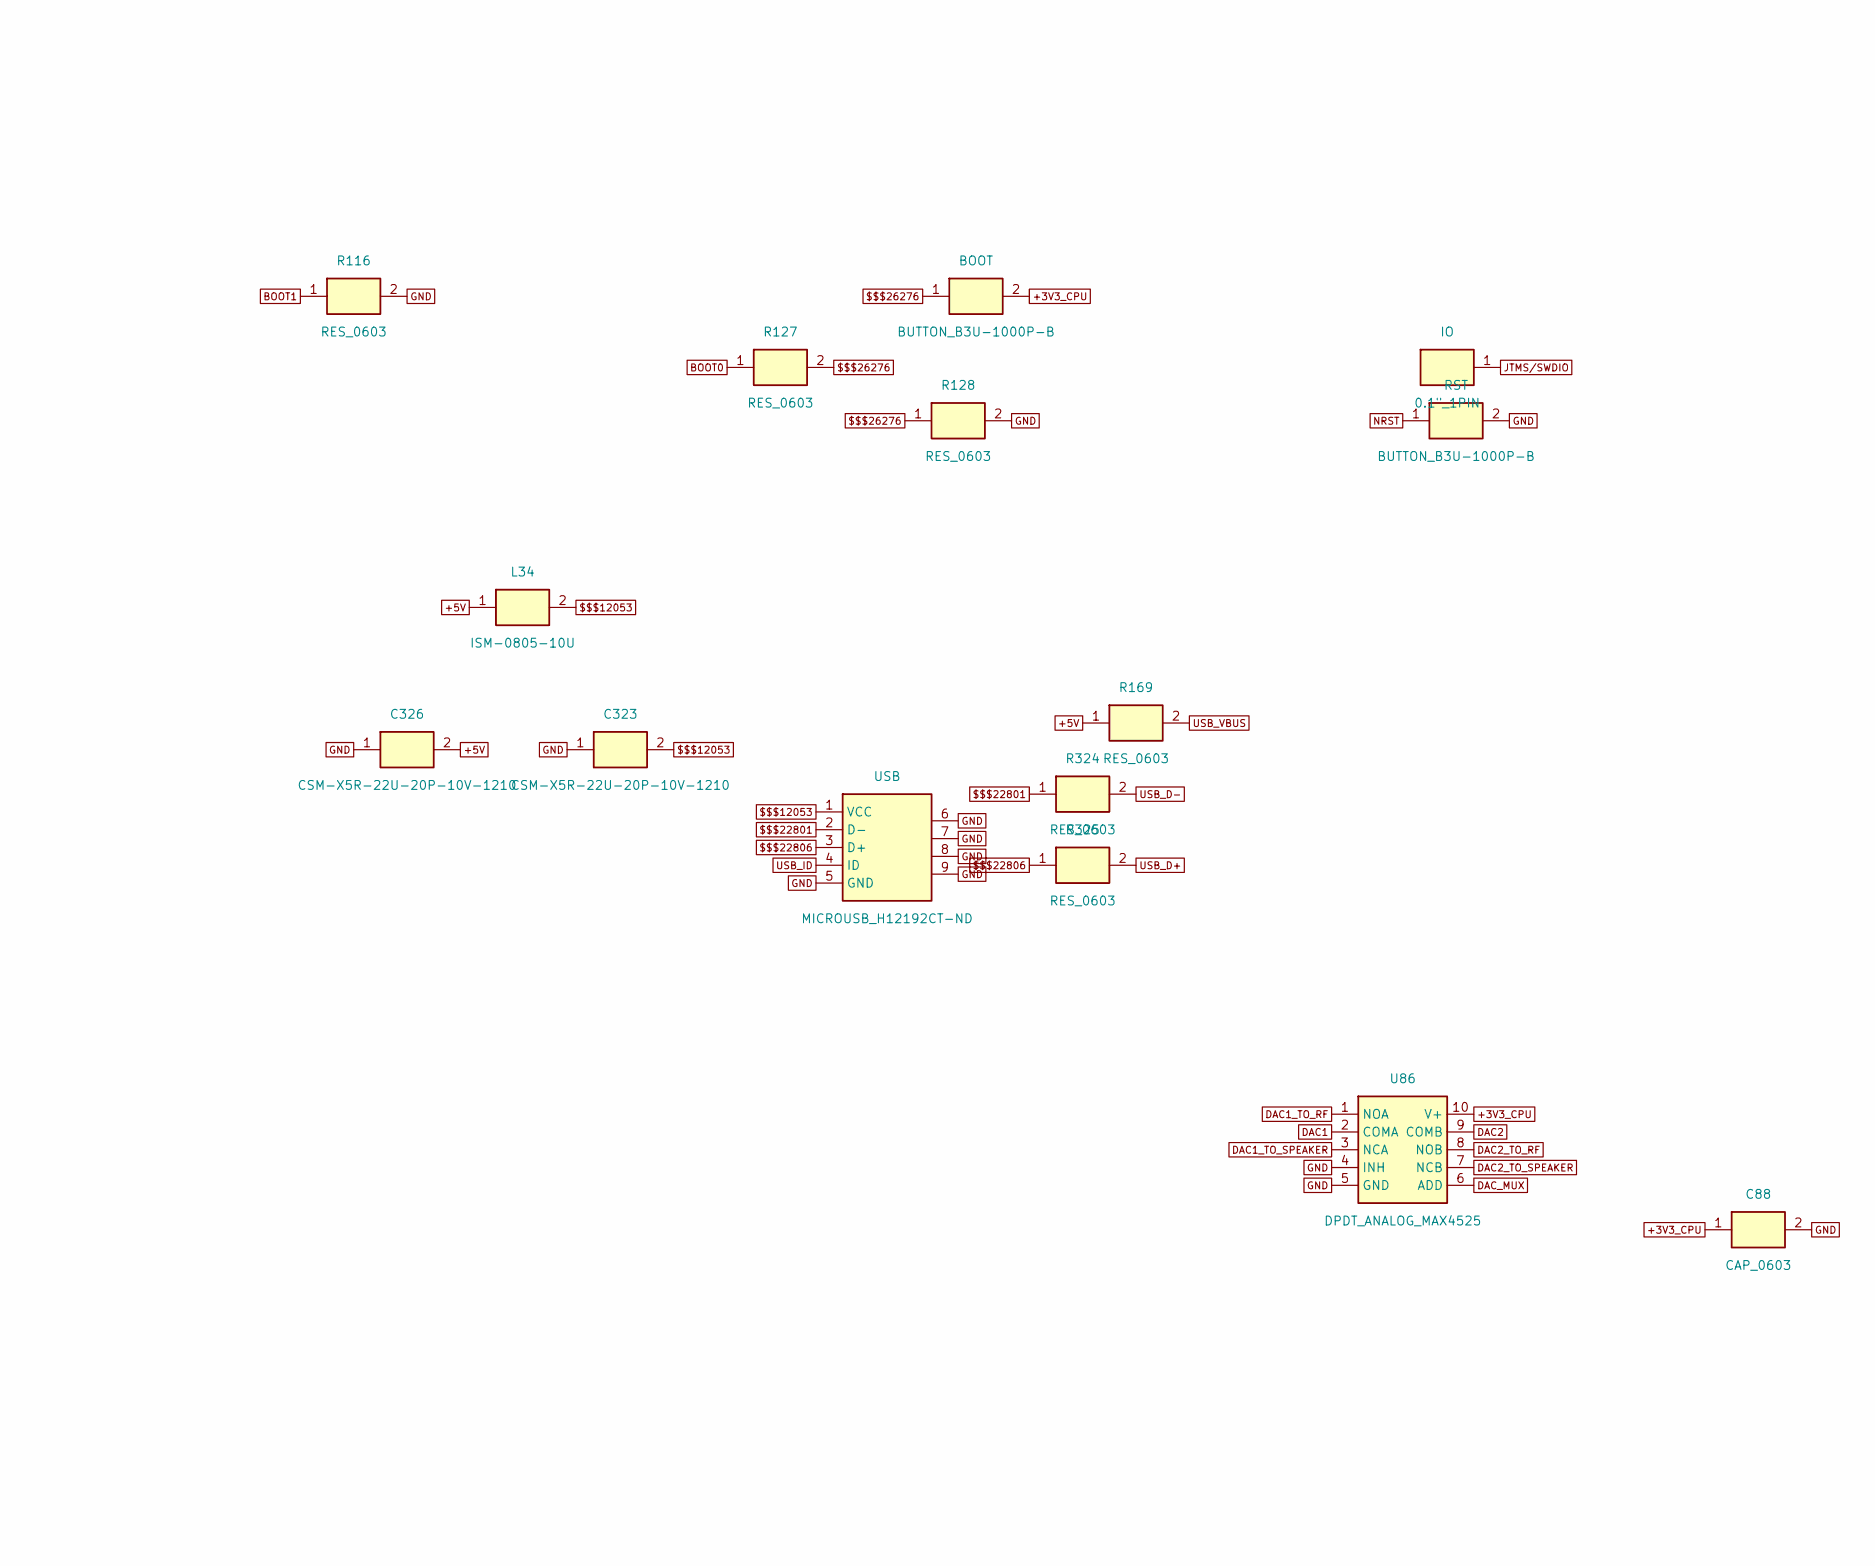
[picture p38: schematic PSDR_2.6.1-p02.kicad_sch, PSDR 2.6.1 - PDF page 2: MCU / GPS / USB, part in row 1, column 2]

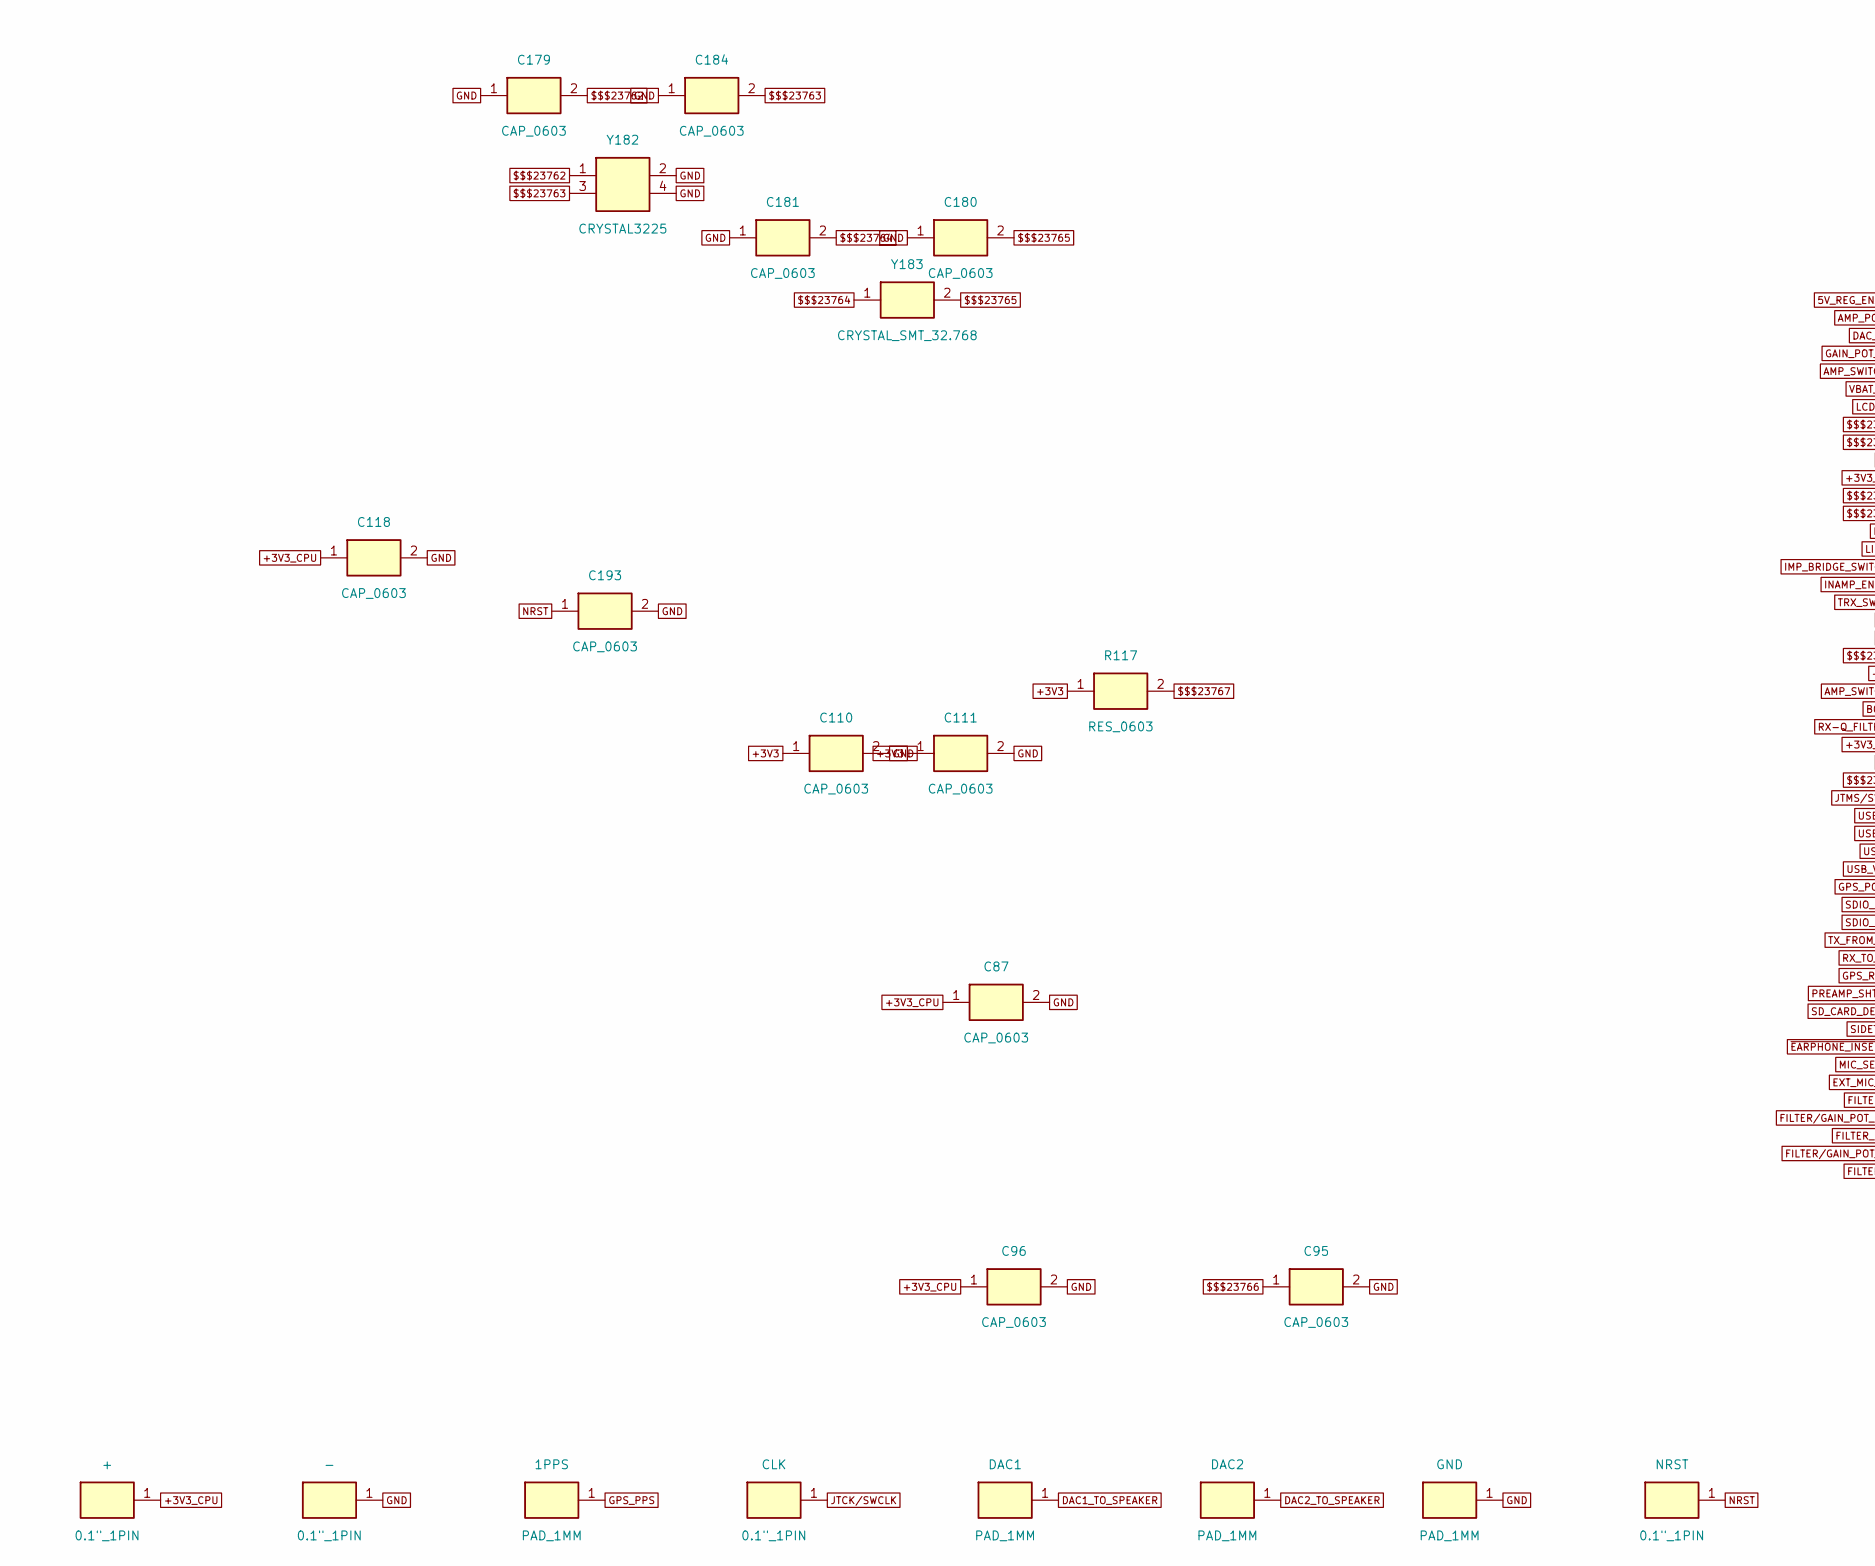
[picture p39: schematic PSDR_2.6.1-p02.kicad_sch, PSDR 2.6.1 - PDF page 2: MCU / GPS / USB, part in row 2, column 1]

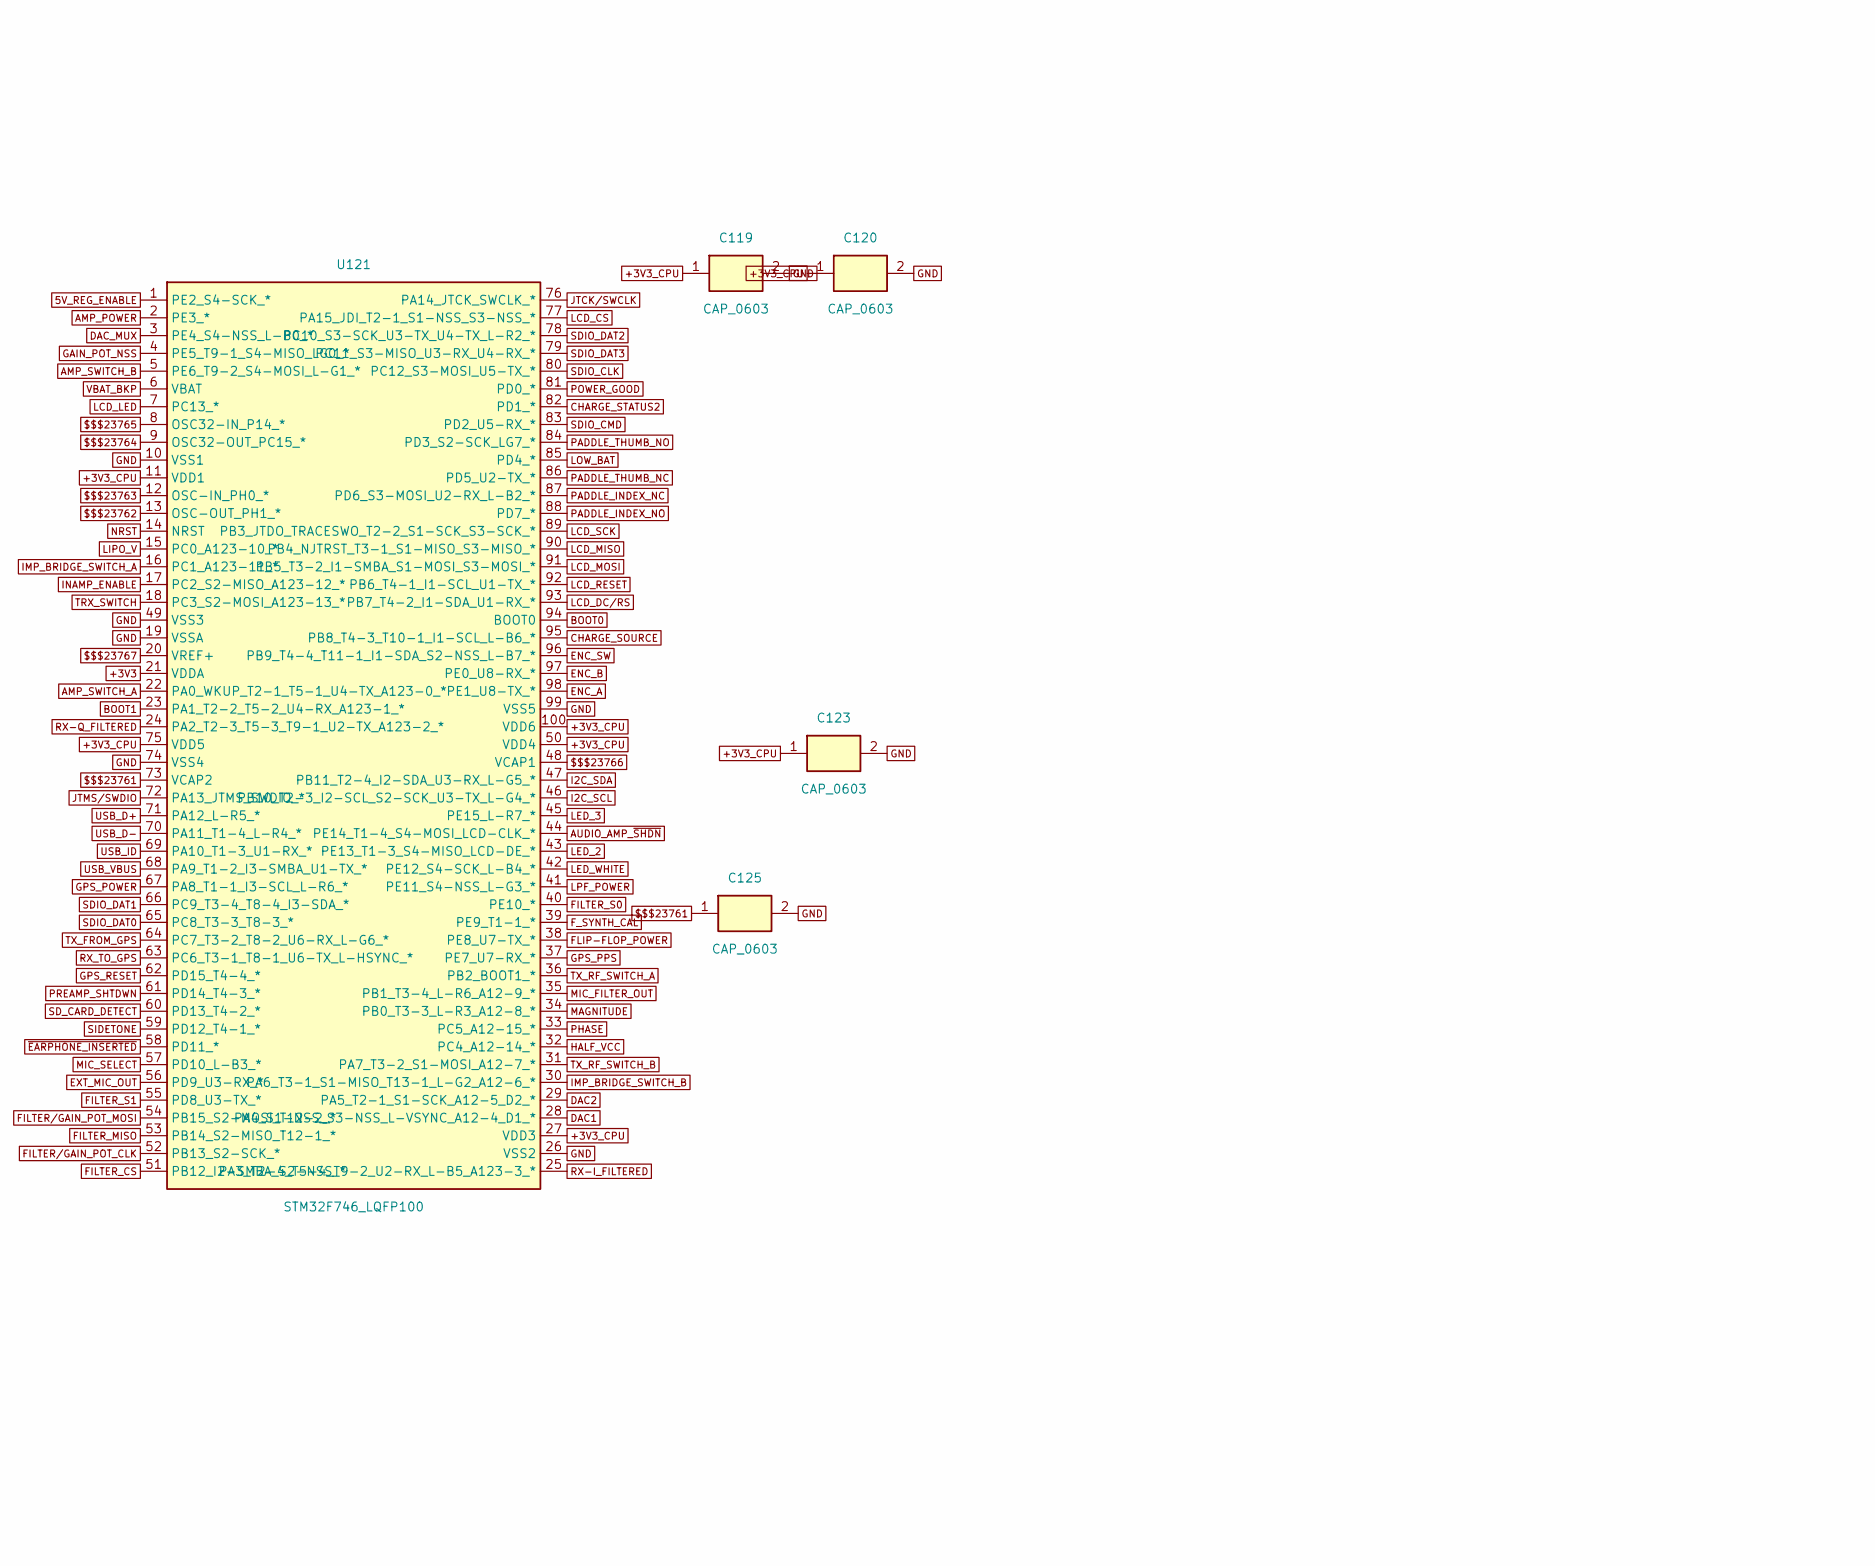
[picture p40: schematic PSDR_2.6.1-p02.kicad_sch, PSDR 2.6.1 - PDF page 2: MCU / GPS / USB, part in row 2, column 2]

Parts:
1PPS: PAD_1MM
+: 0.1"_1PIN; 0_1__1PIN
-: 0.1"_1PIN; 0_1__1PIN
BOOT: BUTTON_B3U-1000P-B
C87, C88, C95, C96, C110, C111, C118, C119, C120, C123, C125, C157, C179, C180, C181, C184, C186, C193: CAP_0603
C156: CAP_0805
C323, C326: CSM-X5R-22U-20P-10V-1210
CLK: 0.1"_1PIN; 0_1__1PIN
DAC1, DAC2: PAD_1MM
GND: PAD_1MM
GPSR: PAD_1MM
GPSRX: PAD_1MM
GPSTX: PAD_1MM
GPS_ANTENNA: GPS_ANTENNA-W3062A
IO: 0.1"_1PIN; 0_1__1PIN
L34: ISM-0805-10U
MICROSD: MICROSD_DM3CS-SF
NRST: 0.1"_1PIN; 0_1__1PIN
Q126: MOSFET_P_SOT23_IRLML6401
R116, R117, R122, R124, R127, R128, R169, R200, R201, R202, R324, R325: RES_0603
RST: BUTTON_B3U-1000P-B
U86: DPDT_ANALOG_MAX4525
U121: STM32F746_LQFP100
U185: GPS_MODULE_RXM-GPS-RM-T
USB: MICROUSB_H12192CT-ND
Y182: CRYSTAL3225
Y183: CRYSTAL_SMT_32.768; CRYSTAL_SMT_32_768

Connections:
5V_REG_ENABLE: U121.1 (PE2_S4-SCK_*); also elsewhere on the board
$$$484: Q126.1, R122.1, R124.1
$$$12053: C323.2, L34.2, USB.1 (VCC)
$$$21746: R202.1, U185.3 (1PPS)
$$$21752: R200.1, U185.5 (RX)
$$$21776: R201.1, U185.4 (TX)
$$$22801: R324.1, USB.2 (D-)
$$$22806: R325.1, USB.3 (D+)
$$$22983: Q126.3, U185.12 (VCC)
$$$23761: C125.1, U121.73 (VCAP2)
$$$23762: C179.2, U121.13 (OSC-OUT_PH1_*), Y182.1
$$$23763: C184.2, U121.12 (OSC-IN_PH0_*), Y182.3
$$$23764: C181.2, U121.9 (OSC32-OUT_PC15_*), Y183.1
$$$23765: C180.2, U121.8 (OSC32-IN_P14_*), Y183.2
$$$23766: C95.1, U121.48 (VCAP1)
$$$23767: R117.2, U121.20 (VREF+)
$$$26276: BOOT.1, R127.2, R128.1
$$$28367: C186.1, GPS_ANTENNA.1, U185.19 (RFIN)
+3V3: C110.1, C111.1, R117.1, U121.21 (VDDA); also elsewhere on the board
+3V3_CPU: +.1, BOOT.2, C87.1, C88.1, C96.1, C118.1, C119.1, C120.1, C123.1, C156.1, C157.1, MICROSD.4 (VDD), Q126.2, R124.2, U86.10 (V+), U121.11 (VDD1), U121.27 (VDD3), U121.50 (VDD4), U121.75 (VDD5), U121.100 (VDD6); also elsewhere on the board
+5V: C326.2, L34.1, R169.1; also elsewhere on the board
AMP_POWER: U121.2 (PE3_*); also elsewhere on the board
AMP_SWITCH_A: U121.22 (PA0_WKUP_T2-1_T5-1_U4-TX_A123-0_*); also elsewhere on the board
AMP_SWITCH_B: U121.5 (PE6_T9-2_S4-MOSI_L-G1_*); also elsewhere on the board
AUDIO_AMP_SHDN: U121.44 (PE14_T1-4_S4-MOSI_LCD-CLK_*); also elsewhere on the board
BOOT0: R127.1, U121.94 (BOOT0)
BOOT1: R116.1, U121.23 (PA1_T2-2_T5-2_U4-RX_A123-1_*)
CHARGE_SOURCE: U121.95 (PB8_T4-3_T10-1_I1-SCL_L-B6_*); also elsewhere on the board
CHARGE_STATUS2: U121.82 (PD1_*); also elsewhere on the board
DAC1: U86.2 (COMA), U121.28 (PA4_S1-NSS_S3-NSS_L-VSYNC_A12-4_D1_*)
DAC1_TO_RF: U86.1 (NOA); also elsewhere on the board
DAC1_TO_SPEAKER: DAC1.1, U86.3 (NCA); also elsewhere on the board
DAC2: U86.9 (COMB), U121.29 (PA5_T2-1_S1-SCK_A12-5_D2_*)
DAC2_TO_RF: U86.8 (NOB); also elsewhere on the board
DAC2_TO_SPEAKER: DAC2.1, U86.7 (NCB); also elsewhere on the board
DAC_MUX: U86.6 (ADD), U121.3 (PE4_S4-NSS_L-B0_*)
EARPHONE_INSERTED: U121.58 (PD11_*); also elsewhere on the board
ENC_A: U121.98 (PE1_U8-TX_*); also elsewhere on the board
ENC_B: U121.97 (PE0_U8-RX_*); also elsewhere on the board
ENC_SW: U121.96 (PB9_T4-4_T11-1_I1-SDA_S2-NSS_L-B7_*); also elsewhere on the board
EXT_MIC_OUT: U121.56 (PD9_U3-RX_*); also elsewhere on the board
FILTER/GAIN_POT_CLK: U121.52 (PB13_S2-SCK_*); also elsewhere on the board
FILTER/GAIN_POT_MOSI: U121.54 (PB15_S2-MOSI_T12-2_*); also elsewhere on the board
FILTER_CS: U121.51 (PB12_I2-SMBA_S2-NSS_*); also elsewhere on the board
FILTER_MISO: U121.53 (PB14_S2-MISO_T12-1_*); also elsewhere on the board
FILTER_S0: U121.40 (PE10_*); also elsewhere on the board
FILTER_S1: U121.55 (PD8_U3-TX_*); also elsewhere on the board
FLIP-FLOP_POWER: U121.38 (PE8_U7-TX_*); also elsewhere on the board
F_SYNTH_CAL: U121.39 (PE9_T1-1_*); also elsewhere on the board
GAIN_POT_NSS: U121.4 (PE5_T9-1_S4-MISO_LG0_*); also elsewhere on the board
GND: -.1, C87.2, C88.2, C95.2, C96.2, C110.2, C111.2, C118.2, C119.2, C120.2, C123.2, C125.2, C156.2, C157.2, C179.1, C180.1, C181.1, C184.1, C186.2, C193.2, C323.1, C326.1, GND.1, GPS_ANTENNA.2, MICROSD.6 (VSS), MICROSD.9, MICROSD.10, MICROSD.11, MICROSD.13, R116.2, R128.2, RST.2, U86.4 (INH), U86.5 (GND), U121.10 (VSS1), U121.19 (VSSA), U121.26 (VSS2), U121.49 (VSS3), U121.74 (VSS4), U121.99 (VSS5), U185.18 (GND_1), U185.20 (GND_2), U185.21 (GND_3), U185.22 (GND), USB.5 (GND), USB.6, USB.7, USB.8, USB.9, Y182.2, Y182.4; also elsewhere on the board
GPS_POWER: R122.2, U121.67 (PA8_T1-1_I3-SCL_L-R6_*)
GPS_PPS: 1PPS.1, R202.2, U121.37 (PE7_U7-RX_*)
GPS_RESET: GPSR.1, U121.62 (PD15_T4-4_*), U185.8 (~RESET)
HALF_VCC: U121.32 (PC4_A12-14_*); also elsewhere on the board
I2C_SCL: U121.46 (PB10_T2-3_I2-SCL_S2-SCK_U3-TX_L-G4_*); also elsewhere on the board
I2C_SDA: U121.47 (PB11_T2-4_I2-SDA_U3-RX_L-G5_*); also elsewhere on the board
IMP_BRIDGE_SWITCH_A: U121.16 (PC1_A123-11_*); also elsewhere on the board
IMP_BRIDGE_SWITCH_B: U121.30 (PA6_T3-1_S1-MISO_T13-1_L-G2_A12-6_*); also elsewhere on the board
INAMP_ENABLE: U121.17 (PC2_S2-MISO_A123-12_*); also elsewhere on the board
JTCK/SWCLK: CLK.1, U121.76 (PA14_JTCK_SWCLK_*)
JTMS/SWDIO: IO.1, U121.72 (PA13_JTMS_SWDIO_*)
LCD_CS: U121.77 (PA15_JDI_T2-1_S1-NSS_S3-NSS_*); also elsewhere on the board
LCD_DC/RS: U121.93 (PB7_T4-2_I1-SDA_U1-RX_*); also elsewhere on the board
LCD_LED: U121.7 (PC13_*); also elsewhere on the board
LCD_MISO: U121.90 (PB4_NJTRST_T3-1_S1-MISO_S3-MISO_*); also elsewhere on the board
LCD_MOSI: U121.91 (PB5_T3-2_I1-SMBA_S1-MOSI_S3-MOSI_*); also elsewhere on the board
LCD_RESET: U121.92 (PB6_T4-1_I1-SCL_U1-TX_*); also elsewhere on the board
LCD_SCK: U121.89 (PB3_JTDO_TRACESWO_T2-2_S1-SCK_S3-SCK_*); also elsewhere on the board
LED_2: U121.43 (PE13_T1-3_S4-MISO_LCD-DE_*); also elsewhere on the board
LED_3: U121.45 (PE15_L-R7_*); also elsewhere on the board
LED_WHITE: U121.42 (PE12_S4-SCK_L-B4_*); also elsewhere on the board
LIPO_V: U121.15 (PC0_A123-10_*); also elsewhere on the board
LOW_BAT: U121.85 (PD4_*); also elsewhere on the board
LPF_POWER: U121.41 (PE11_S4-NSS_L-G3_*); also elsewhere on the board
MAGNITUDE: U121.34 (PB0_T3-3_L-R3_A12-8_*); also elsewhere on the board
MIC_FILTER_OUT: U121.35 (PB1_T3-4_L-R6_A12-9_*); also elsewhere on the board
MIC_SELECT: U121.57 (PD10_L-B3_*); also elsewhere on the board
NRST: C193.1, NRST.1, RST.1, U121.14 (NRST)
PADDLE_INDEX_NC: U121.87 (PD6_S3-MOSI_U2-RX_L-B2_*); also elsewhere on the board
PADDLE_INDEX_NO: U121.88 (PD7_*); also elsewhere on the board
PADDLE_THUMB_NC: U121.86 (PD5_U2-TX_*); also elsewhere on the board
PADDLE_THUMB_NO: U121.84 (PD3_S2-SCK_LG7_*); also elsewhere on the board
PHASE: U121.33 (PC5_A12-15_*); also elsewhere on the board
POWER_GOOD: U121.81 (PD0_*); also elsewhere on the board
PREAMP_SHTDWN: U121.61 (PD14_T4-3_*); also elsewhere on the board
RX-I_FILTERED: U121.25 (PA3_T2-4_T5-4_T9-2_U2-RX_L-B5_A123-3_*); also elsewhere on the board
RX-Q_FILTERED: U121.24 (PA2_T2-3_T5-3_T9-1_U2-TX_A123-2_*); also elsewhere on the board
RX_TO_GPS: GPSRX.1, R200.2, U121.63 (PC6_T3-1_T8-1_U6-TX_L-HSYNC_*)
SDIO_CLK: MICROSD.5 (CLK/SCLK), U121.80 (PC12_S3-MOSI_U5-TX_*)
SDIO_CMD: MICROSD.3 (CMD/DI), U121.83 (PD2_U5-RX_*)
SDIO_DAT0: MICROSD.7 (DAT0/DO), U121.65 (PC8_T3-3_T8-3_*)
SDIO_DAT1: MICROSD.8 (DAT1/X), U121.66 (PC9_T3-4_T8-4_I3-SDA_*)
SDIO_DAT2: MICROSD.1 (DAT2/X), U121.78 (PC10_S3-SCK_U3-TX_U4-TX_L-R2_*)
SDIO_DAT3: MICROSD.2 (CD/DAT3/CS), U121.79 (PC11_S3-MISO_U3-RX_U4-RX_*)
SD_CARD_DETECT: MICROSD.12 (CARD_DETECT), U121.60 (PD13_T4-2_*)
SIDETONE: U121.59 (PD12_T4-1_*); also elsewhere on the board
TRX_SWITCH: U121.18 (PC3_S2-MOSI_A123-13_*); also elsewhere on the board
TX_FROM_GPS: GPSTX.1, R201.2, U121.64 (PC7_T3-2_T8-2_U6-RX_L-G6_*)
TX_RF_SWITCH_A: U121.36 (PB2_BOOT1_*); also elsewhere on the board
TX_RF_SWITCH_B: U121.31 (PA7_T3-2_S1-MOSI_A12-7_*); also elsewhere on the board
USB_D+: R325.2, U121.71 (PA12_L-R5_*)
USB_D-: R324.2, U121.70 (PA11_T1-4_L-R4_*)
USB_ID: U121.69 (PA10_T1-3_U1-RX_*), USB.4 (ID)
USB_VBUS: R169.2, U121.68 (PA9_T1-2_I3-SMBA_U1-TX_*)
VBAT_BKP: U121.6 (VBAT), U185.11 (VBACKUP); also elsewhere on the board

Notes on the sheet:
Generated from PADS ASCII. Net names are labels, not drawn wires. Original drawing: PSDR_2.6.1_Schematic_2016-07-31.pdf page 2.
