fe1iscurc0r/PSDR/dist/kicad/PSDR_2.6.1_revB.kicad_pcb

## KiCad design dist/kicad/PSDR_2.6.1_revB.kicad_pcb (continued)

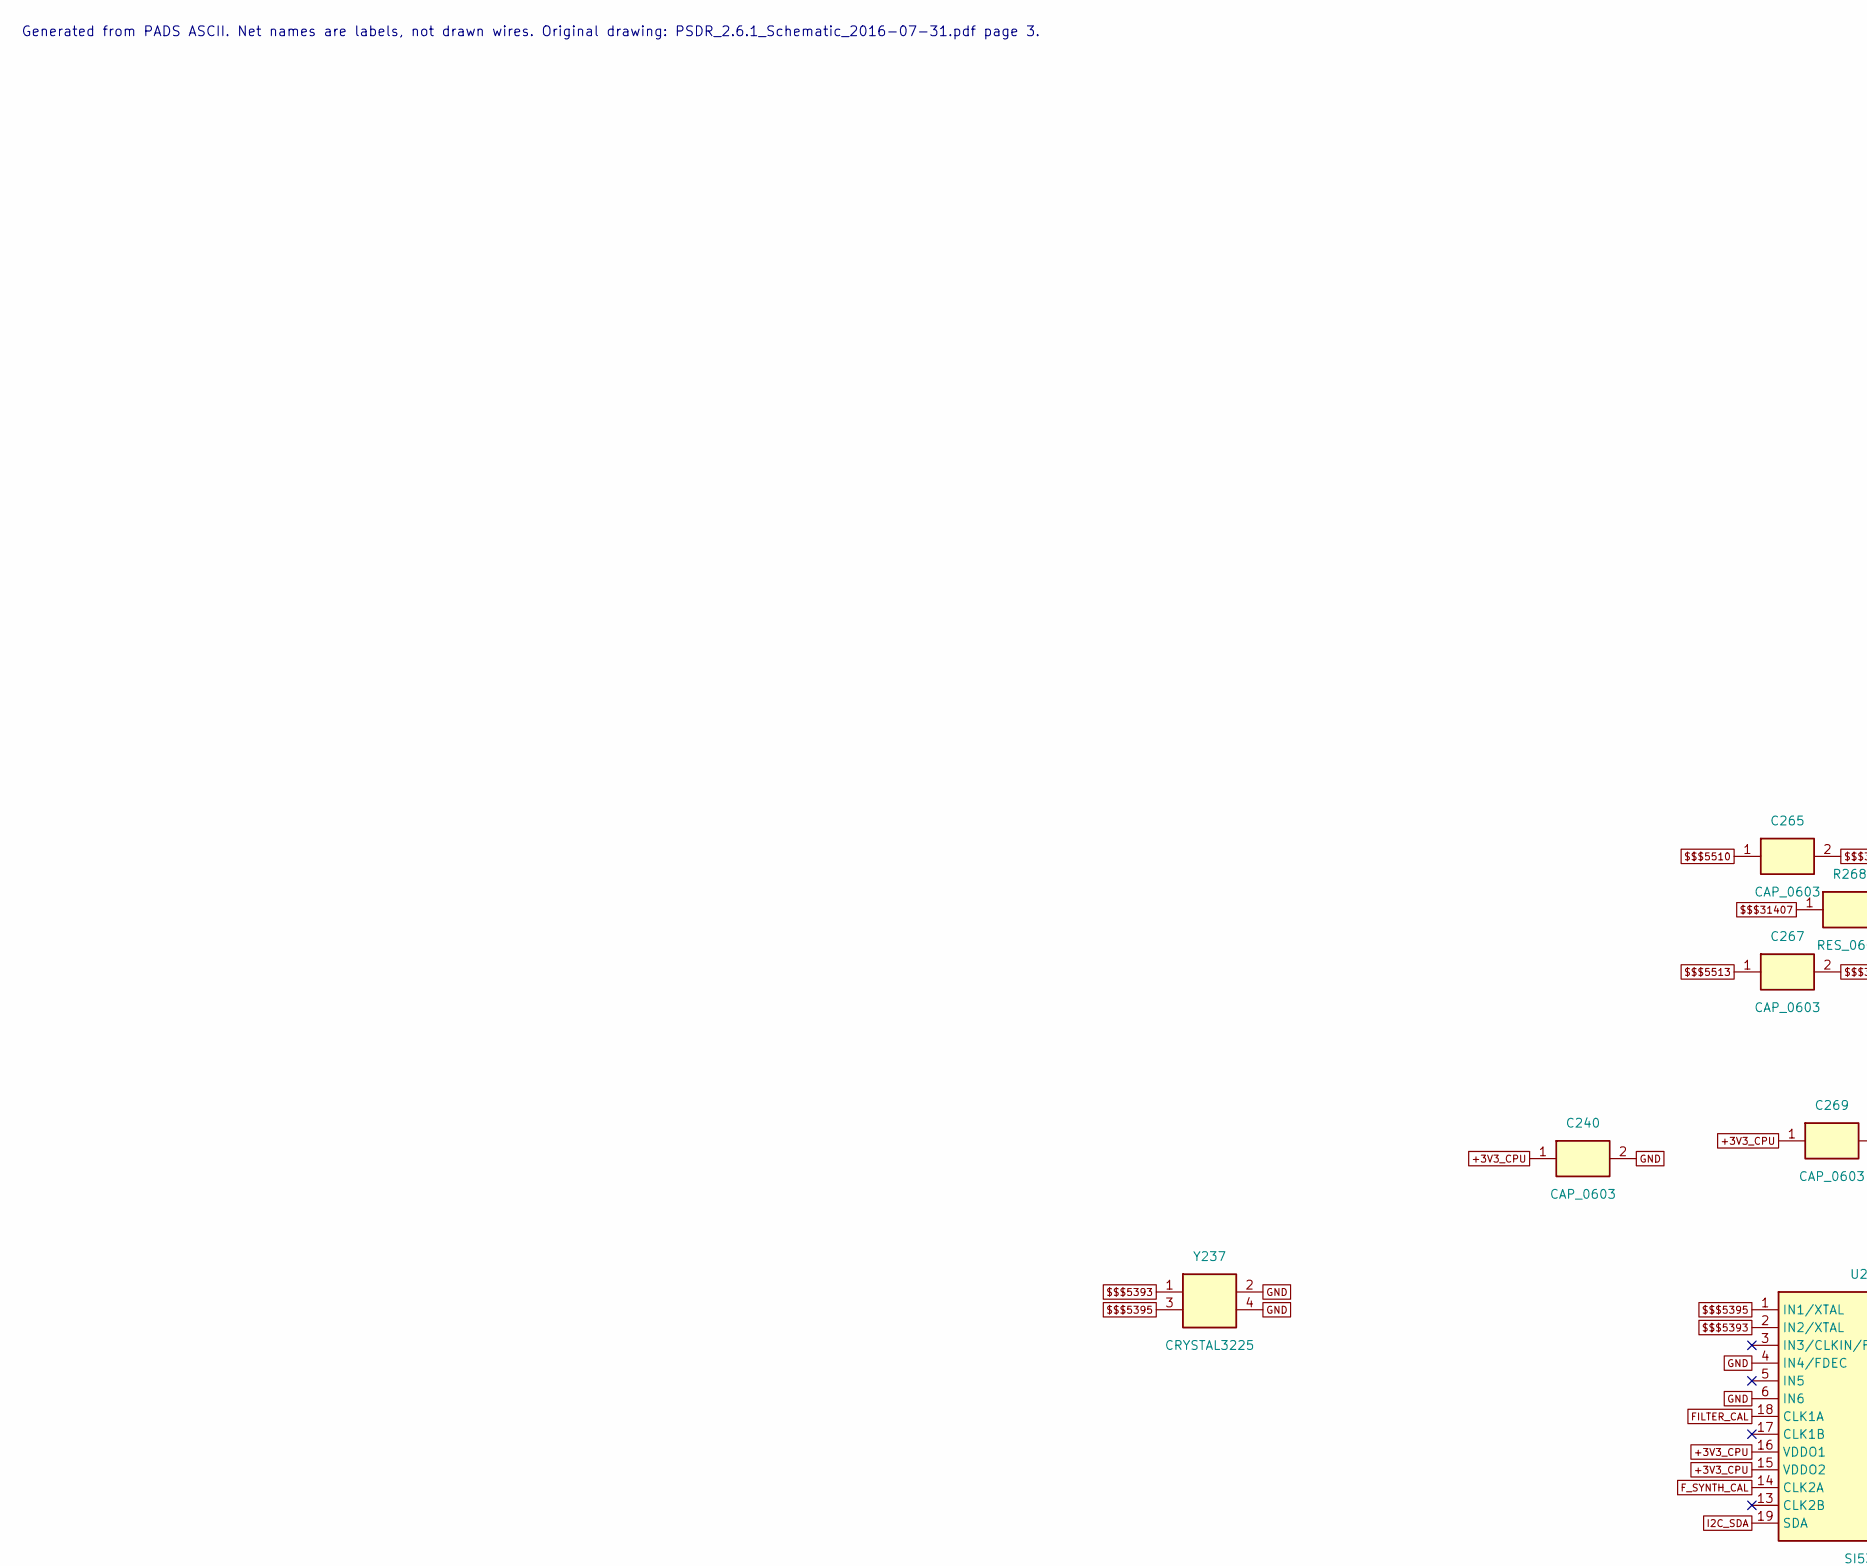
[picture p41: schematic PSDR_2.6.1-p03.kicad_sch, PSDR 2.6.1 - PDF page 3: Clock (Si5338), part in row 1, column 1]

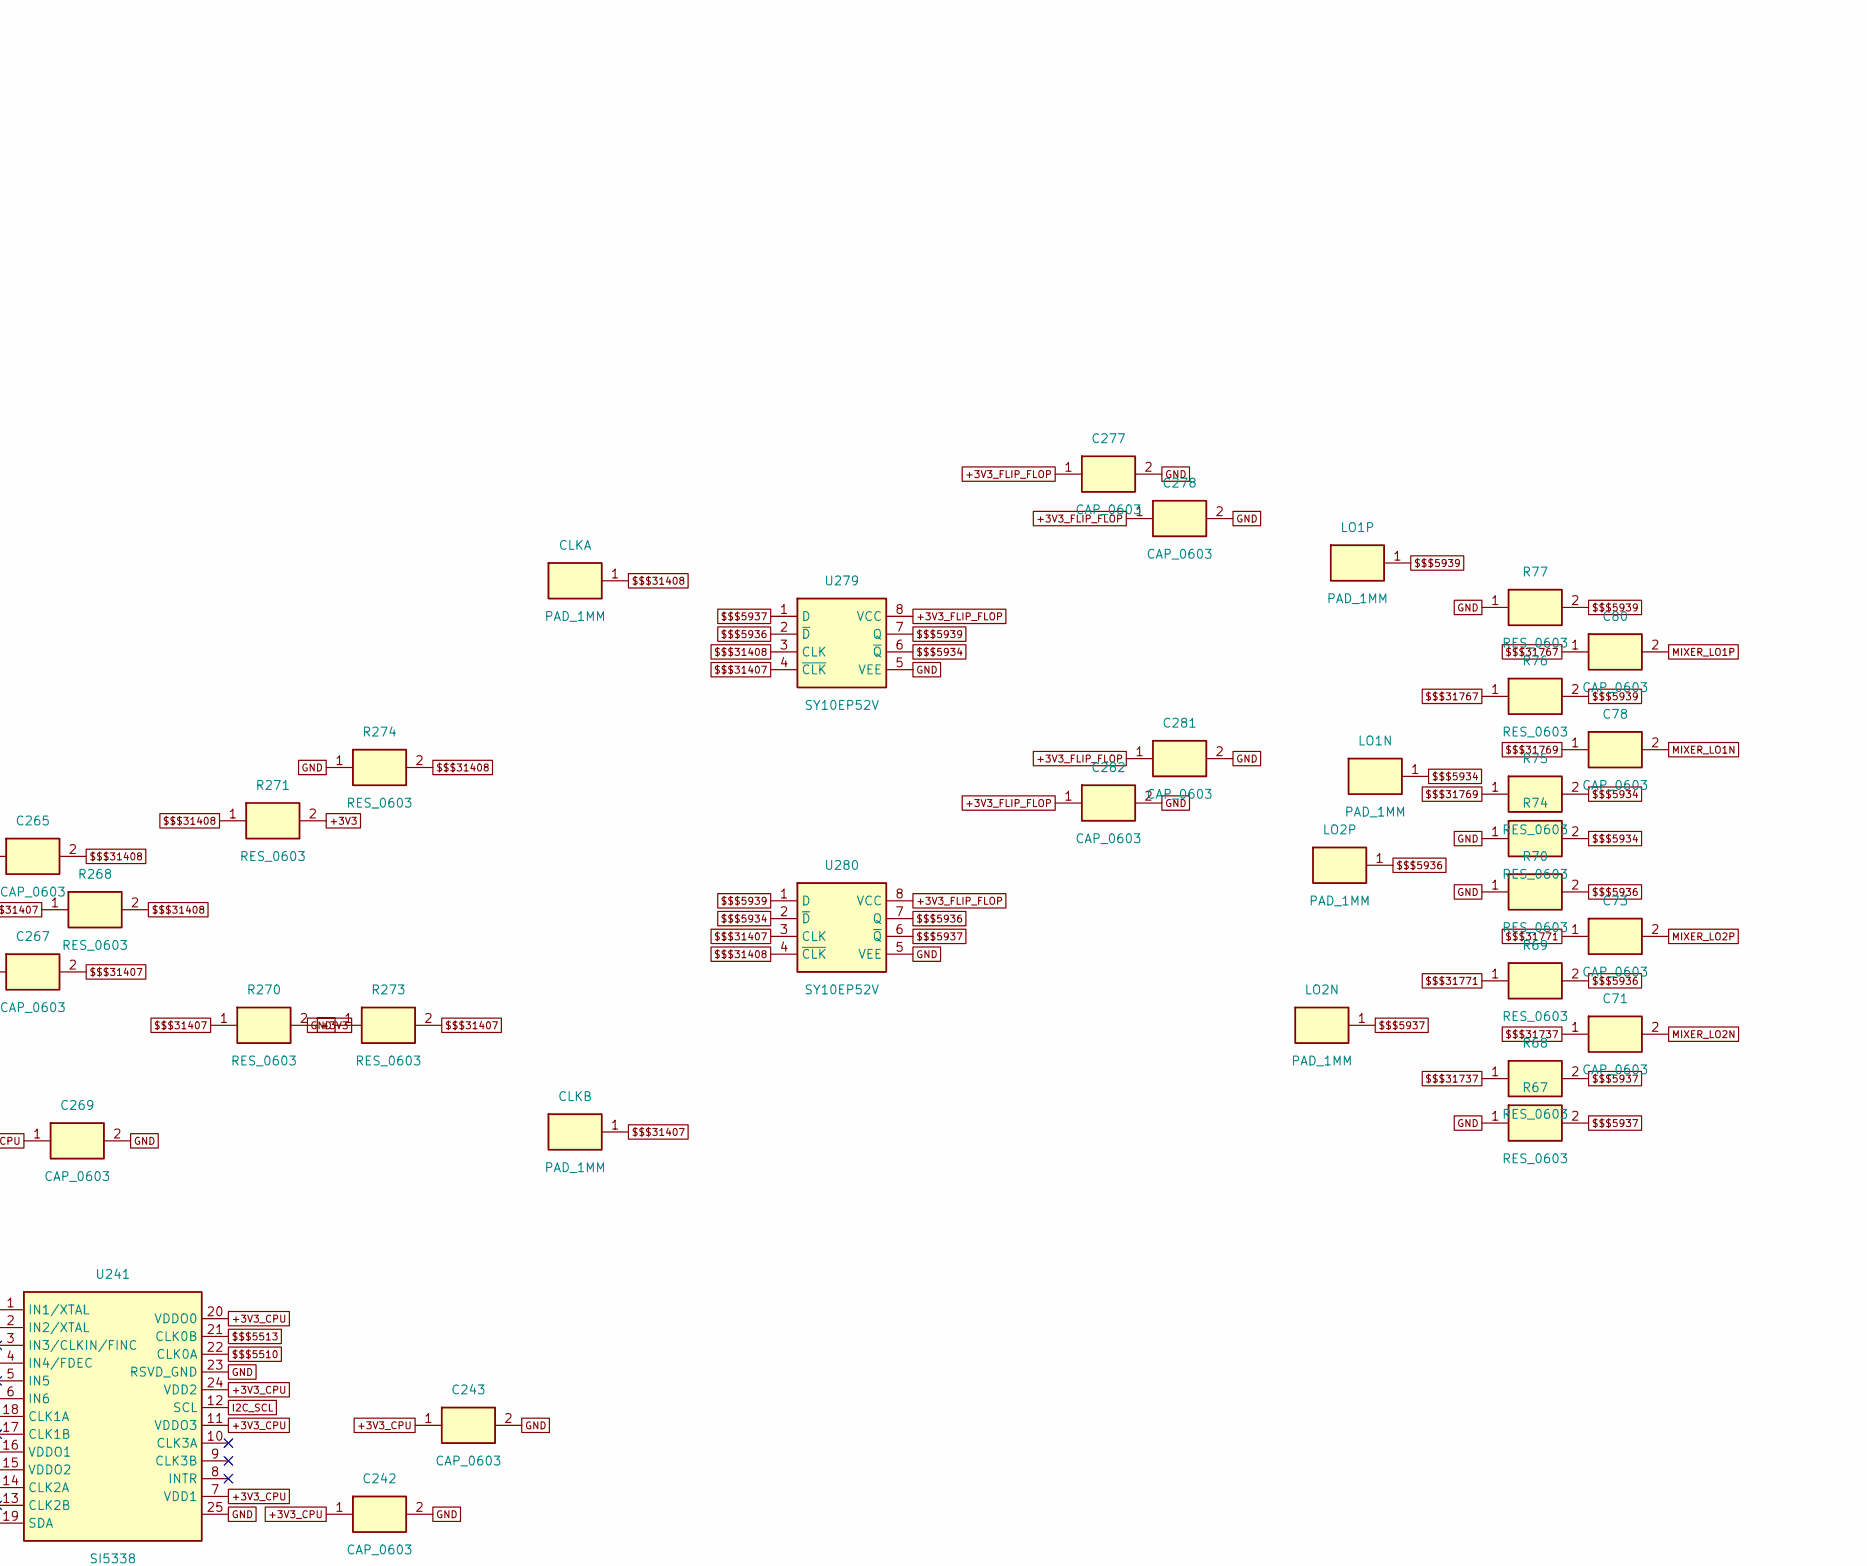
[picture p42: schematic PSDR_2.6.1-p03.kicad_sch, PSDR 2.6.1 - PDF page 3: Clock (Si5338), part in row 1, column 2]

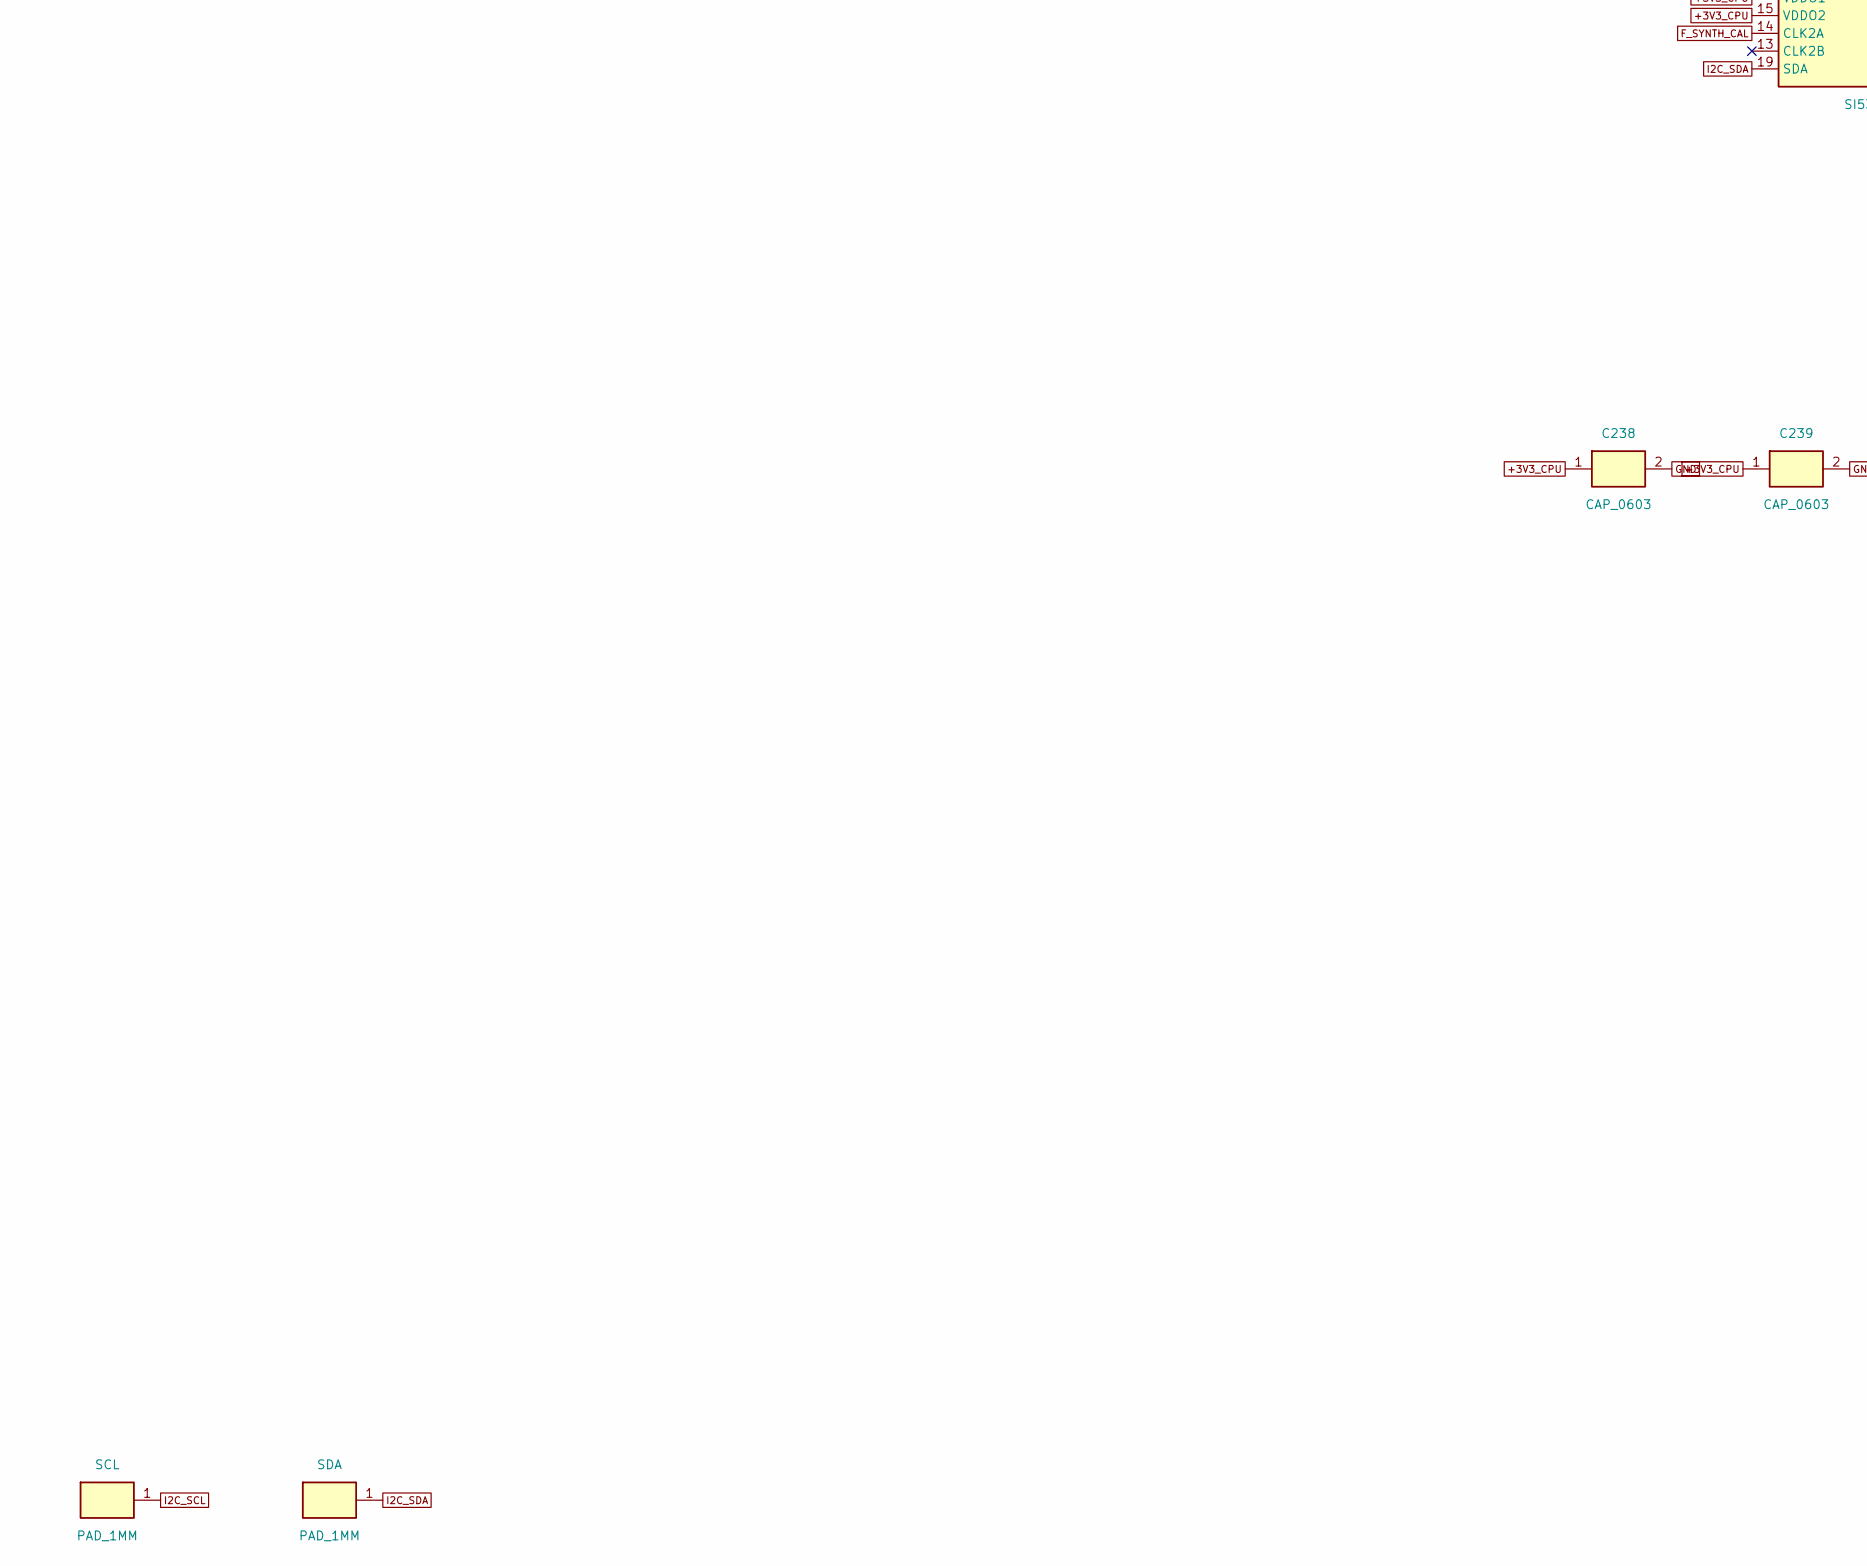
[picture p43: schematic PSDR_2.6.1-p03.kicad_sch, PSDR 2.6.1 - PDF page 3: Clock (Si5338), part in row 2, column 1]

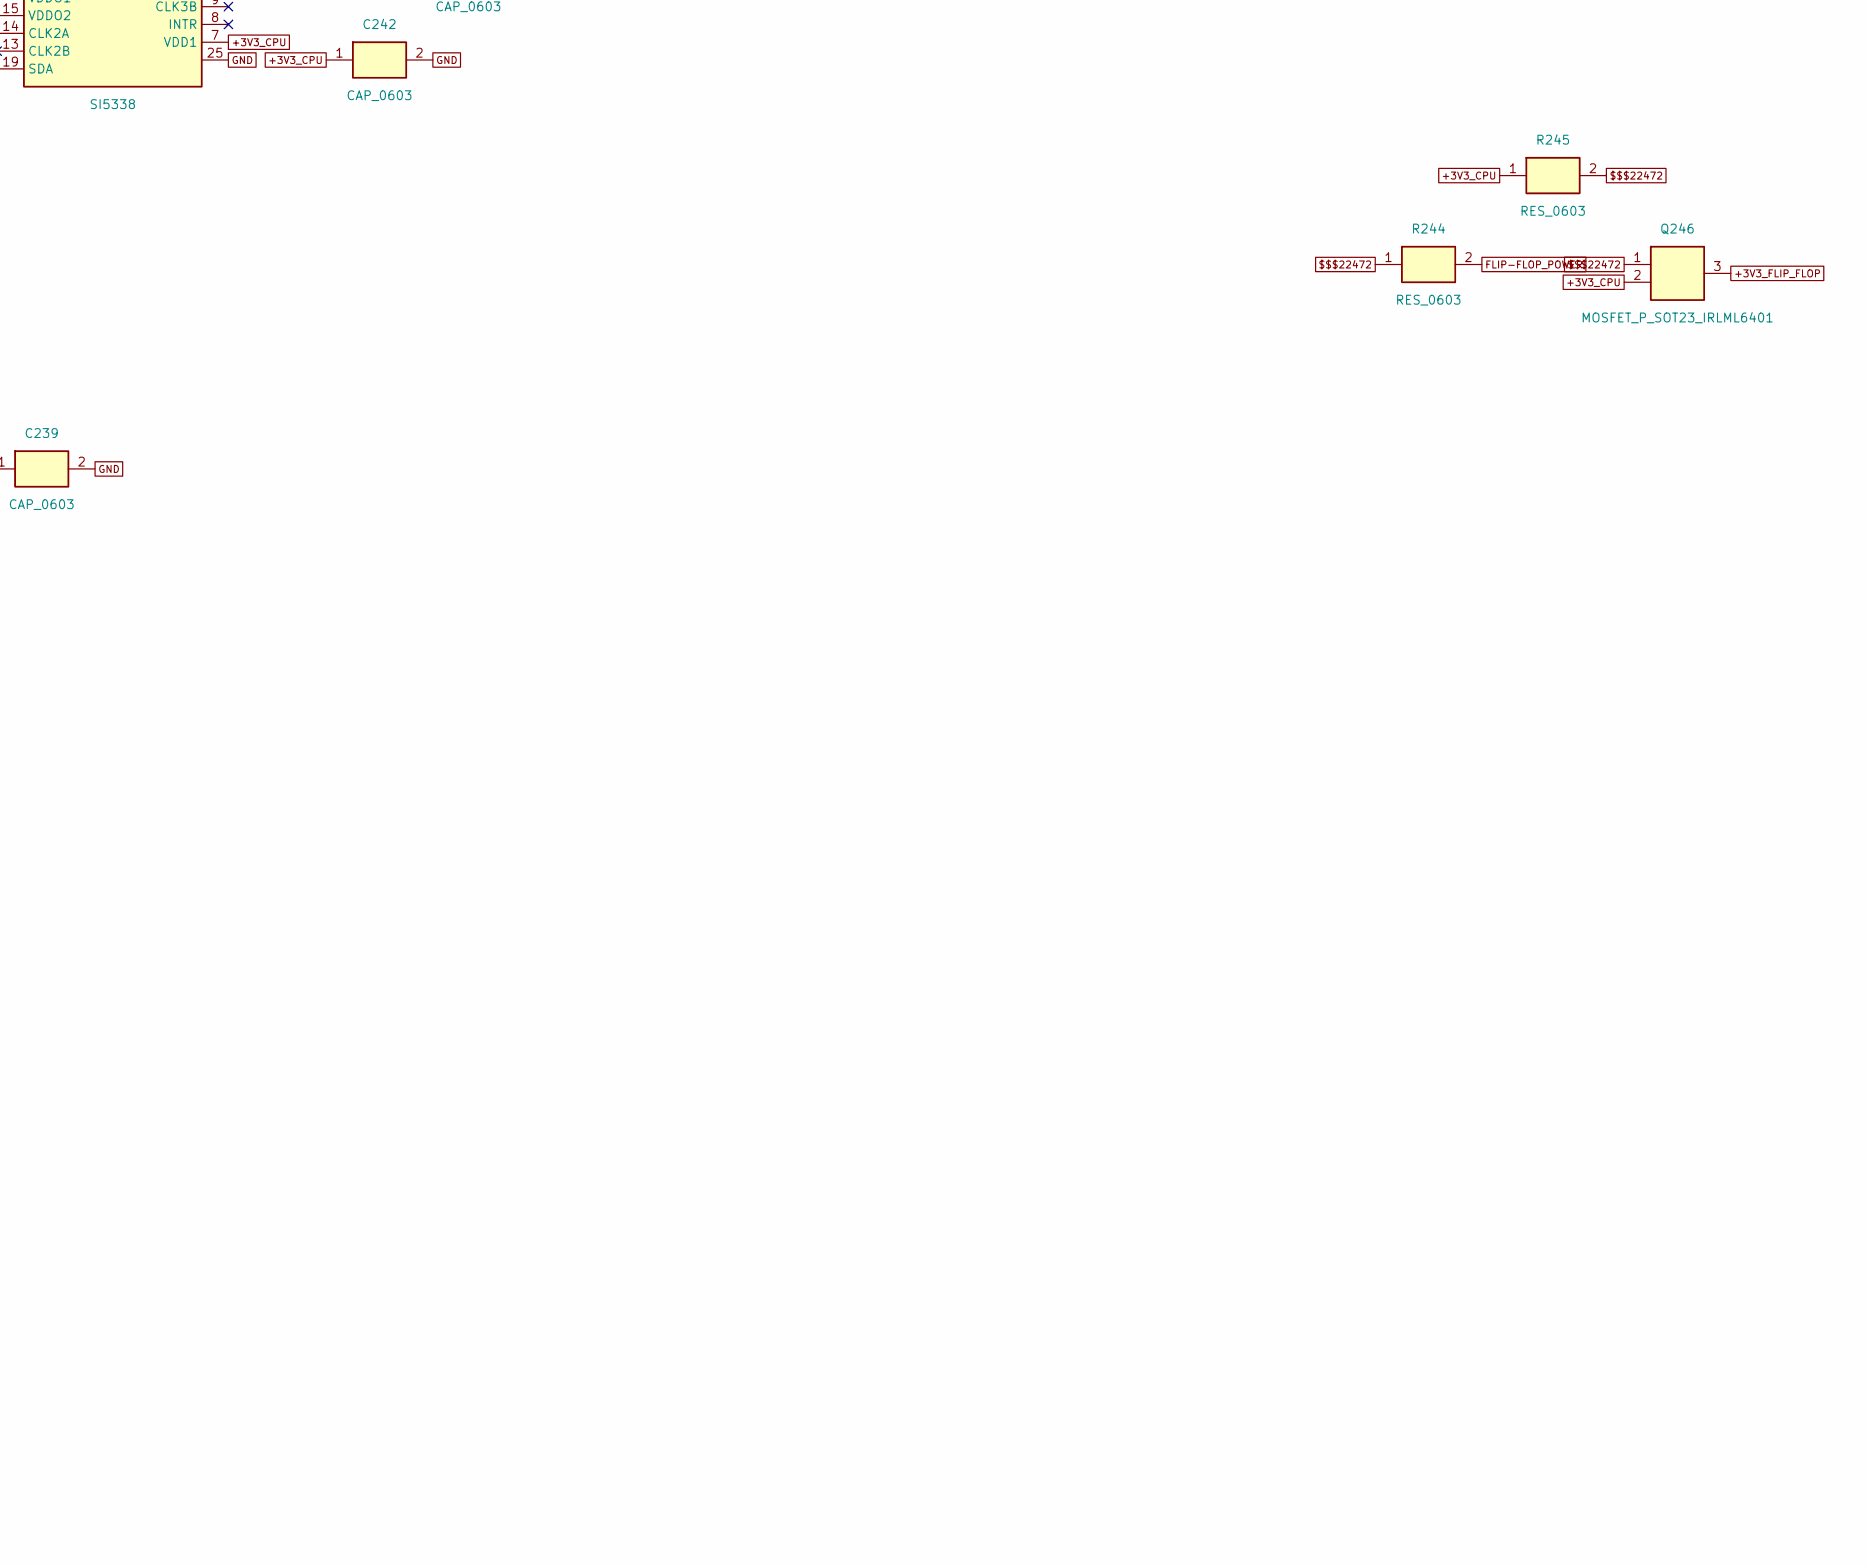
[picture p44: schematic PSDR_2.6.1-p03.kicad_sch, PSDR 2.6.1 - PDF page 3: Clock (Si5338), part in row 2, column 2]

Parts:
C71, C73, C78, C80, C238, C239, C240, C242, C243, C265, C267, C269, C277, C278, C281, C282: CAP_0603
CLKA: PAD_1MM
CLKB: PAD_1MM
LO1N, LO1P, LO2N, LO2P: PAD_1MM
Q246: MOSFET_P_SOT23_IRLML6401
R67, R68, R69, R70, R74, R75, R76, R77, R244, R245, R268, R270, R271, R273, R274: RES_0603
SCL: PAD_1MM
SDA: PAD_1MM
U241: SI5338
U279, U280: SY10EP52V
Y237: CRYSTAL3225

Connections:
$$$5393: U241.2 (IN2/XTAL), Y237.1
$$$5395: U241.1 (IN1/XTAL), Y237.3
$$$5510: C265.1, U241.22 (CLK0A)
$$$5513: C267.1, U241.21 (CLK0B)
$$$5934: LO1N.1, R74.2, R75.2, U279.6 (~Q), U280.2 (~D)
$$$5936: LO2P.1, R69.2, R70.2, U279.2 (~D), U280.7 (Q)
$$$5937: LO2N.1, R67.2, R68.2, U279.1 (D), U280.6 (~Q)
$$$5939: LO1P.1, R76.2, R77.2, U279.7 (Q), U280.1 (D)
$$$22472: Q246.1, R244.1, R245.2
$$$31407: C267.2, CLKB.1, R268.1, R270.1, R273.2, U279.4 (~CLK), U280.3 (CLK)
$$$31408: C265.2, CLKA.1, R268.2, R271.1, R274.2, U279.3 (CLK), U280.4 (~CLK)
$$$31737: C71.1, R68.1
$$$31767: C80.1, R76.1
$$$31769: C78.1, R75.1
$$$31771: C73.1, R69.1
+3V3: R270.2, R271.2; also elsewhere on the board
+3V3_CPU: C238.1, C239.1, C240.1, C242.1, C243.1, C269.1, Q246.2, R245.1, U241.7 (VDD1), U241.11 (VDDO3), U241.15 (VDDO2), U241.16 (VDDO1), U241.20 (VDDO0), U241.24 (VDD2); also elsewhere on the board
+3V3_FLIP_FLOP: C277.1, C278.1, C281.1, C282.1, Q246.3, U279.8 (VCC), U280.8 (VCC)
FILTER_CAL: U241.18 (CLK1A); also elsewhere on the board
FLIP-FLOP_POWER: R244.2; also elsewhere on the board
F_SYNTH_CAL: U241.14 (CLK2A); also elsewhere on the board
GND: C238.2, C239.2, C240.2, C242.2, C243.2, C269.2, C277.2, C278.2, C281.2, C282.2, R67.1, R70.1, R74.1, R77.1, R273.1, R274.1, U241.4 (IN4/FDEC), U241.6 (IN6), U241.23 (RSVD_GND), U241.25, U279.5 (VEE), U280.5 (VEE), Y237.2, Y237.4; also elsewhere on the board
I2C_SCL: SCL.1, U241.12 (SCL); also elsewhere on the board
I2C_SDA: SDA.1, U241.19 (SDA); also elsewhere on the board
MIXER_LO1N: C78.2; also elsewhere on the board
MIXER_LO1P: C80.2; also elsewhere on the board
MIXER_LO2N: C71.2; also elsewhere on the board
MIXER_LO2P: C73.2; also elsewhere on the board

Notes on the sheet:
Generated from PADS ASCII. Net names are labels, not drawn wires. Original drawing: PSDR_2.6.1_Schematic_2016-07-31.pdf page 3.
