fe1iscurc0r/PSDR/dist/kicad/PSDR_2.6.1_revB.kicad_pcb

## KiCad design dist/kicad/PSDR_2.6.1_revB.kicad_pcb (continued)

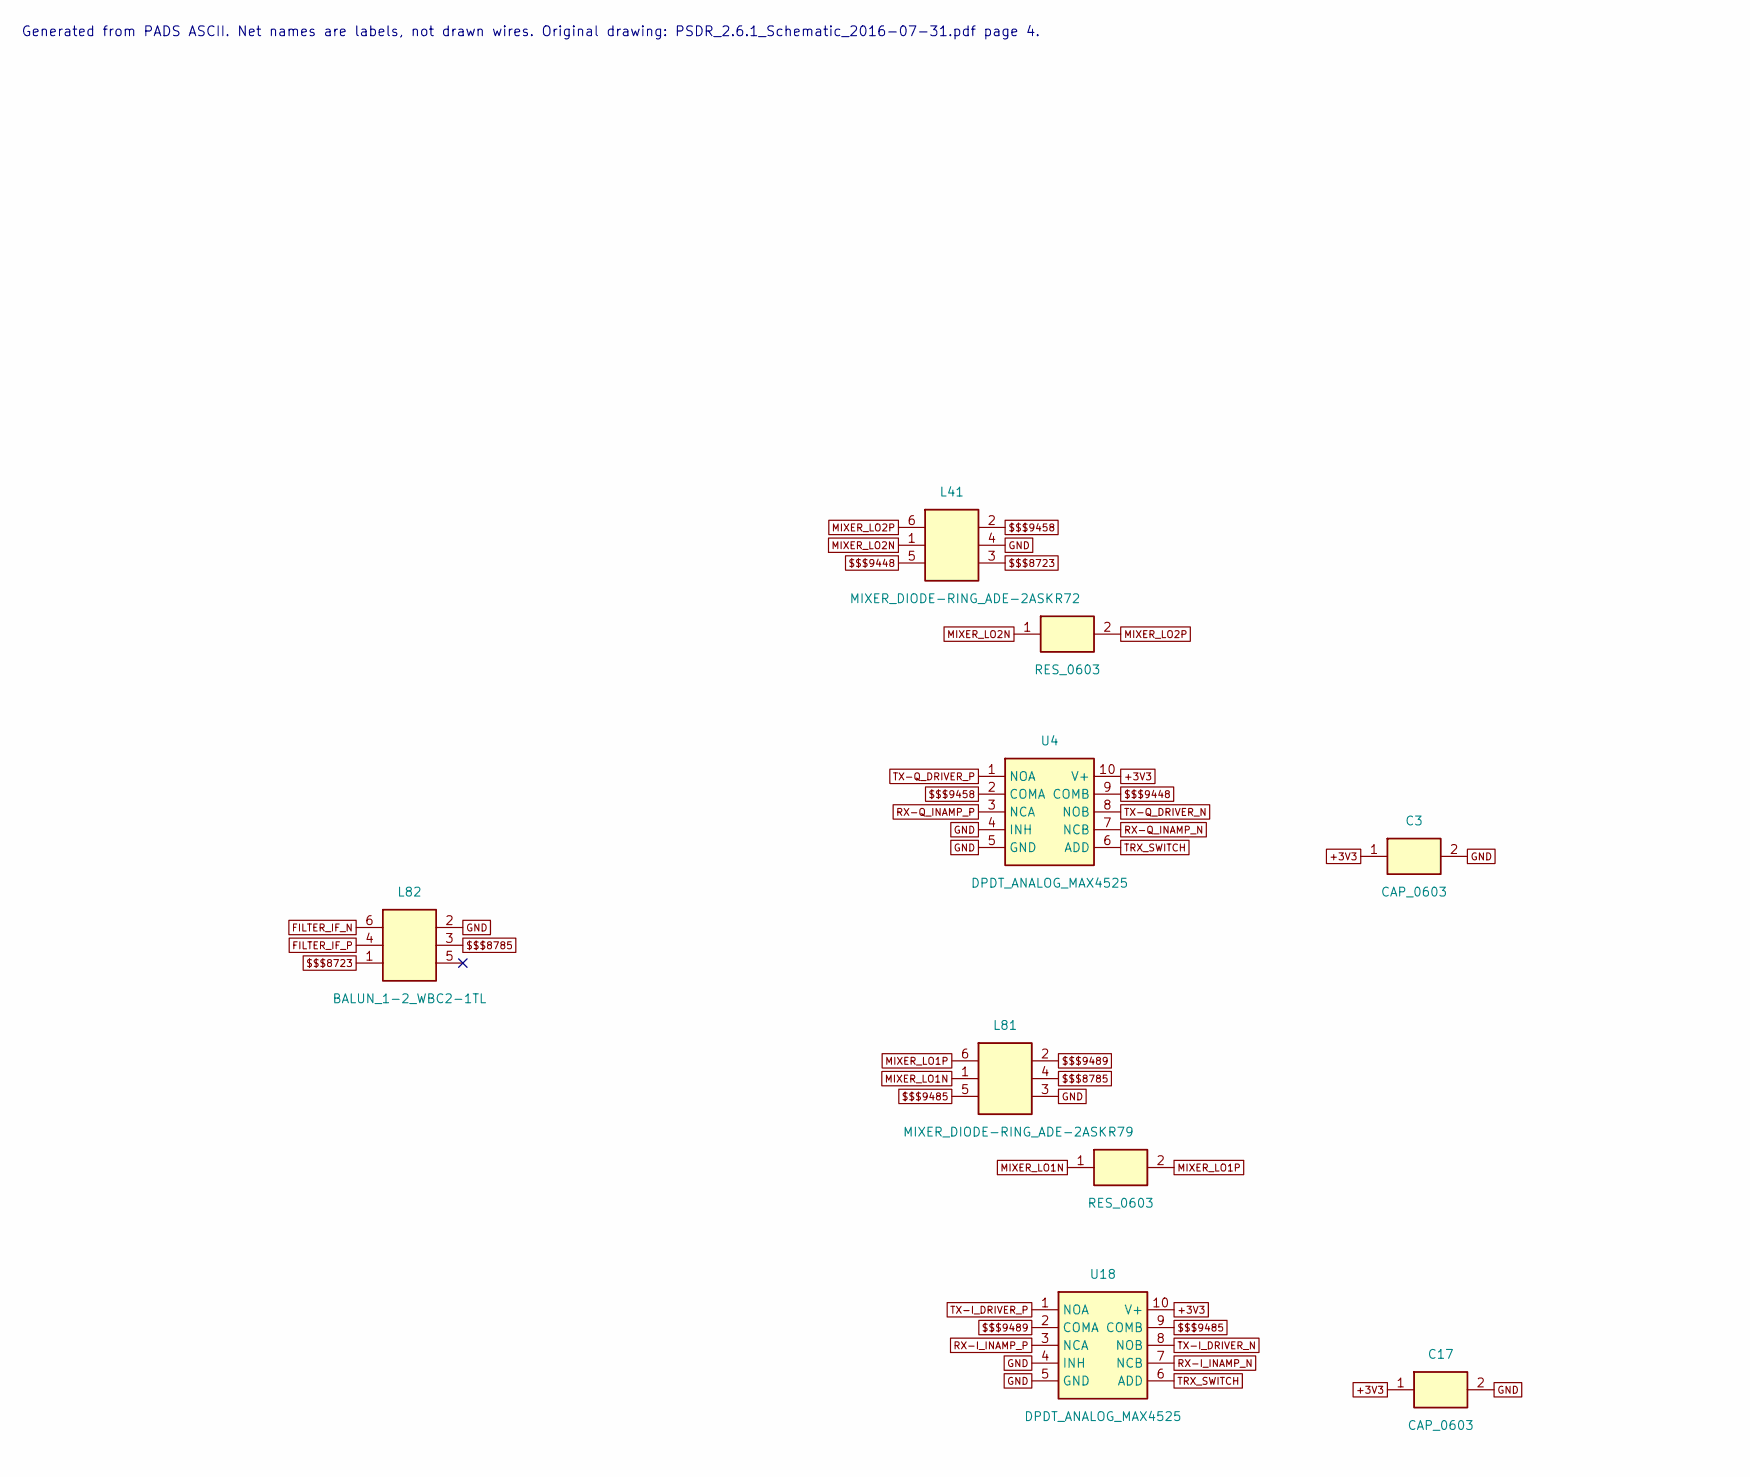
[picture p45: schematic PSDR_2.6.1-p04.kicad_sch, PSDR 2.6.1 - PDF page 4: Analog switches / drivers, part in row 1, column 1]

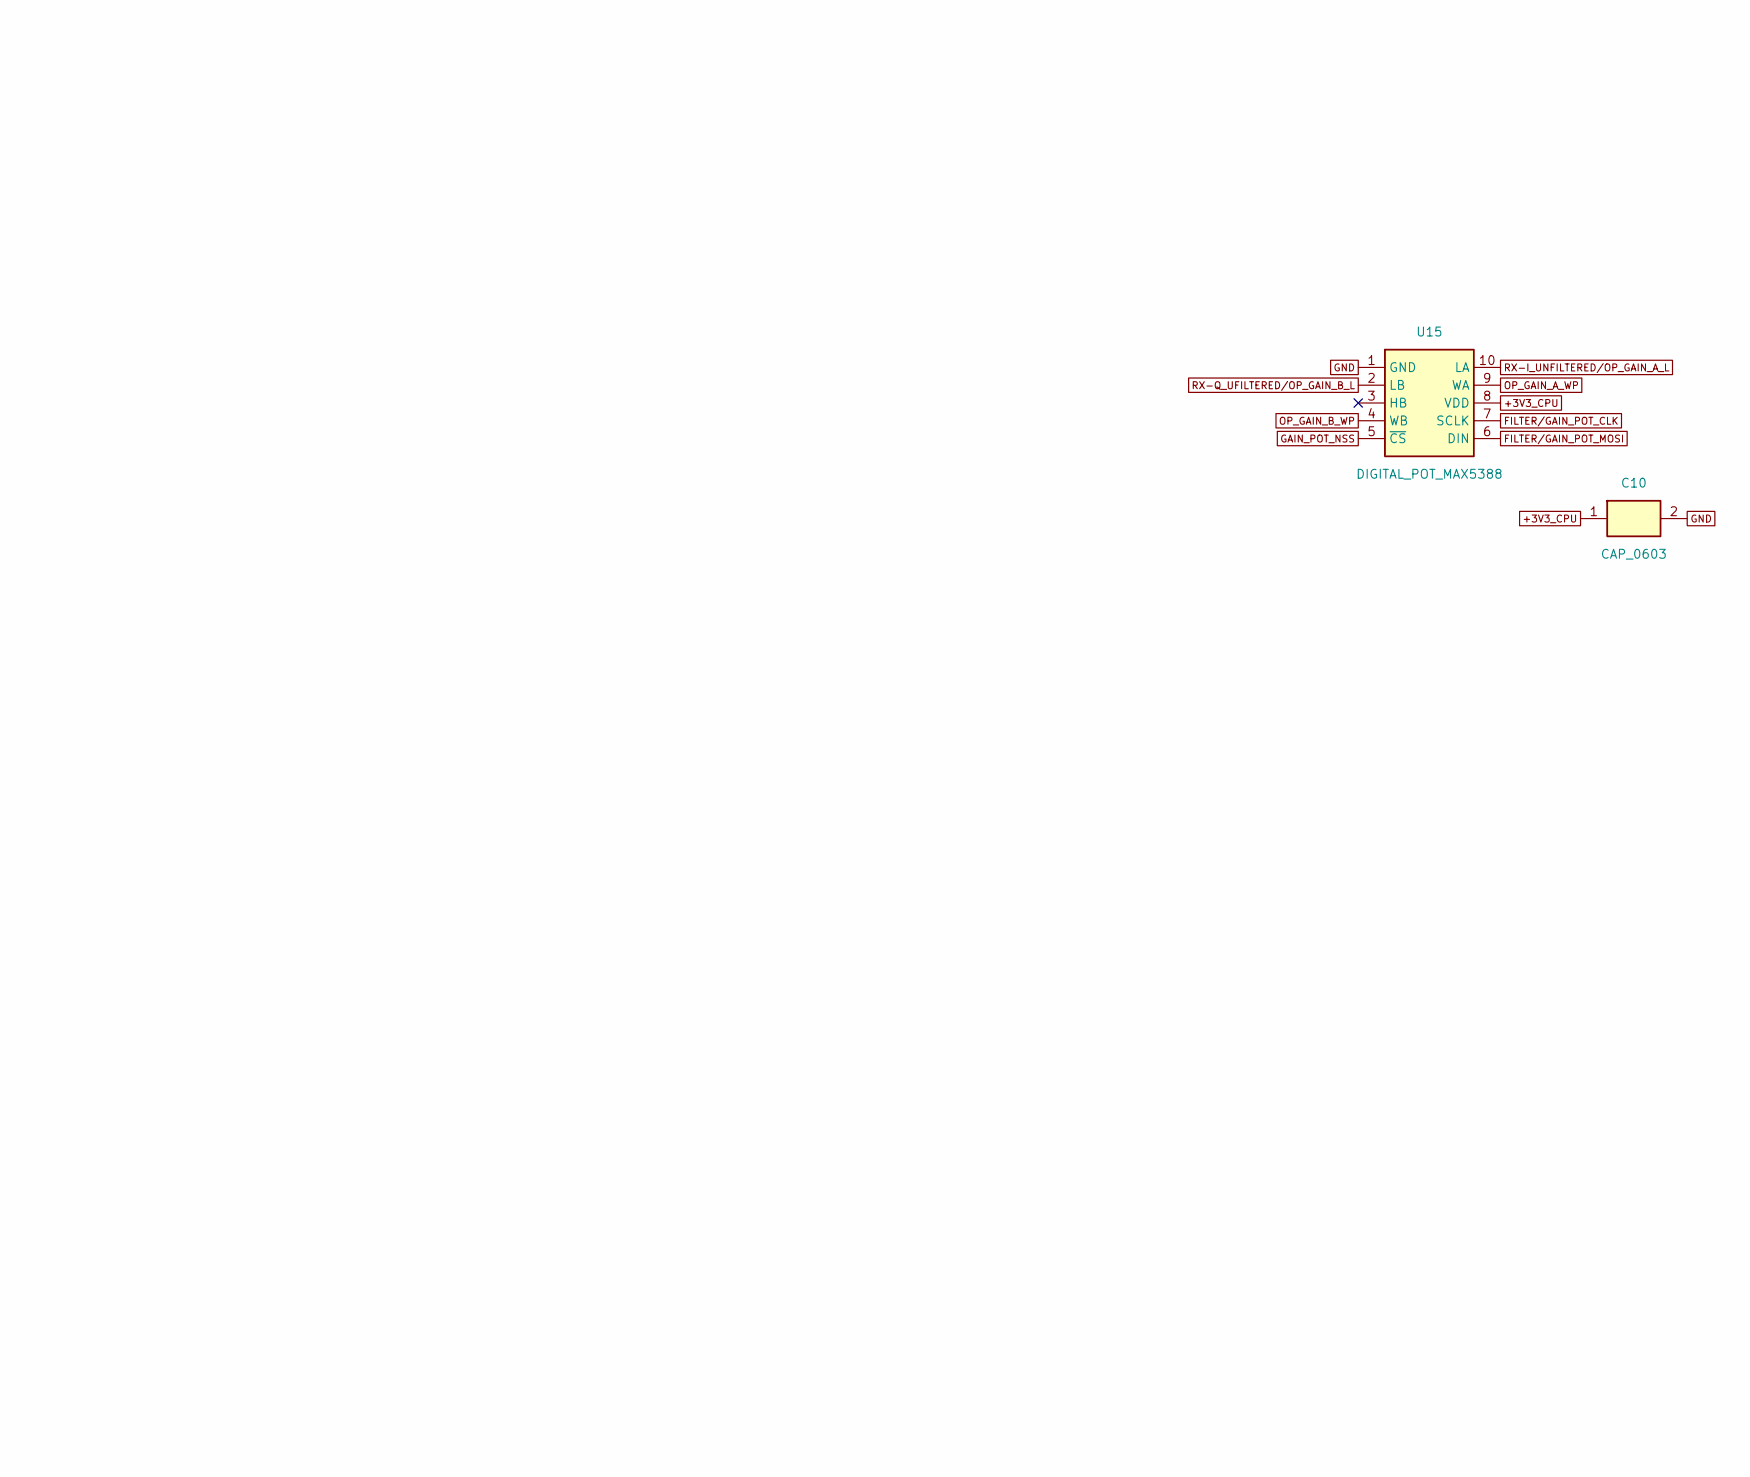
[picture p46: schematic PSDR_2.6.1-p04.kicad_sch, PSDR 2.6.1 - PDF page 4: Analog switches / drivers, part in row 1, column 2]

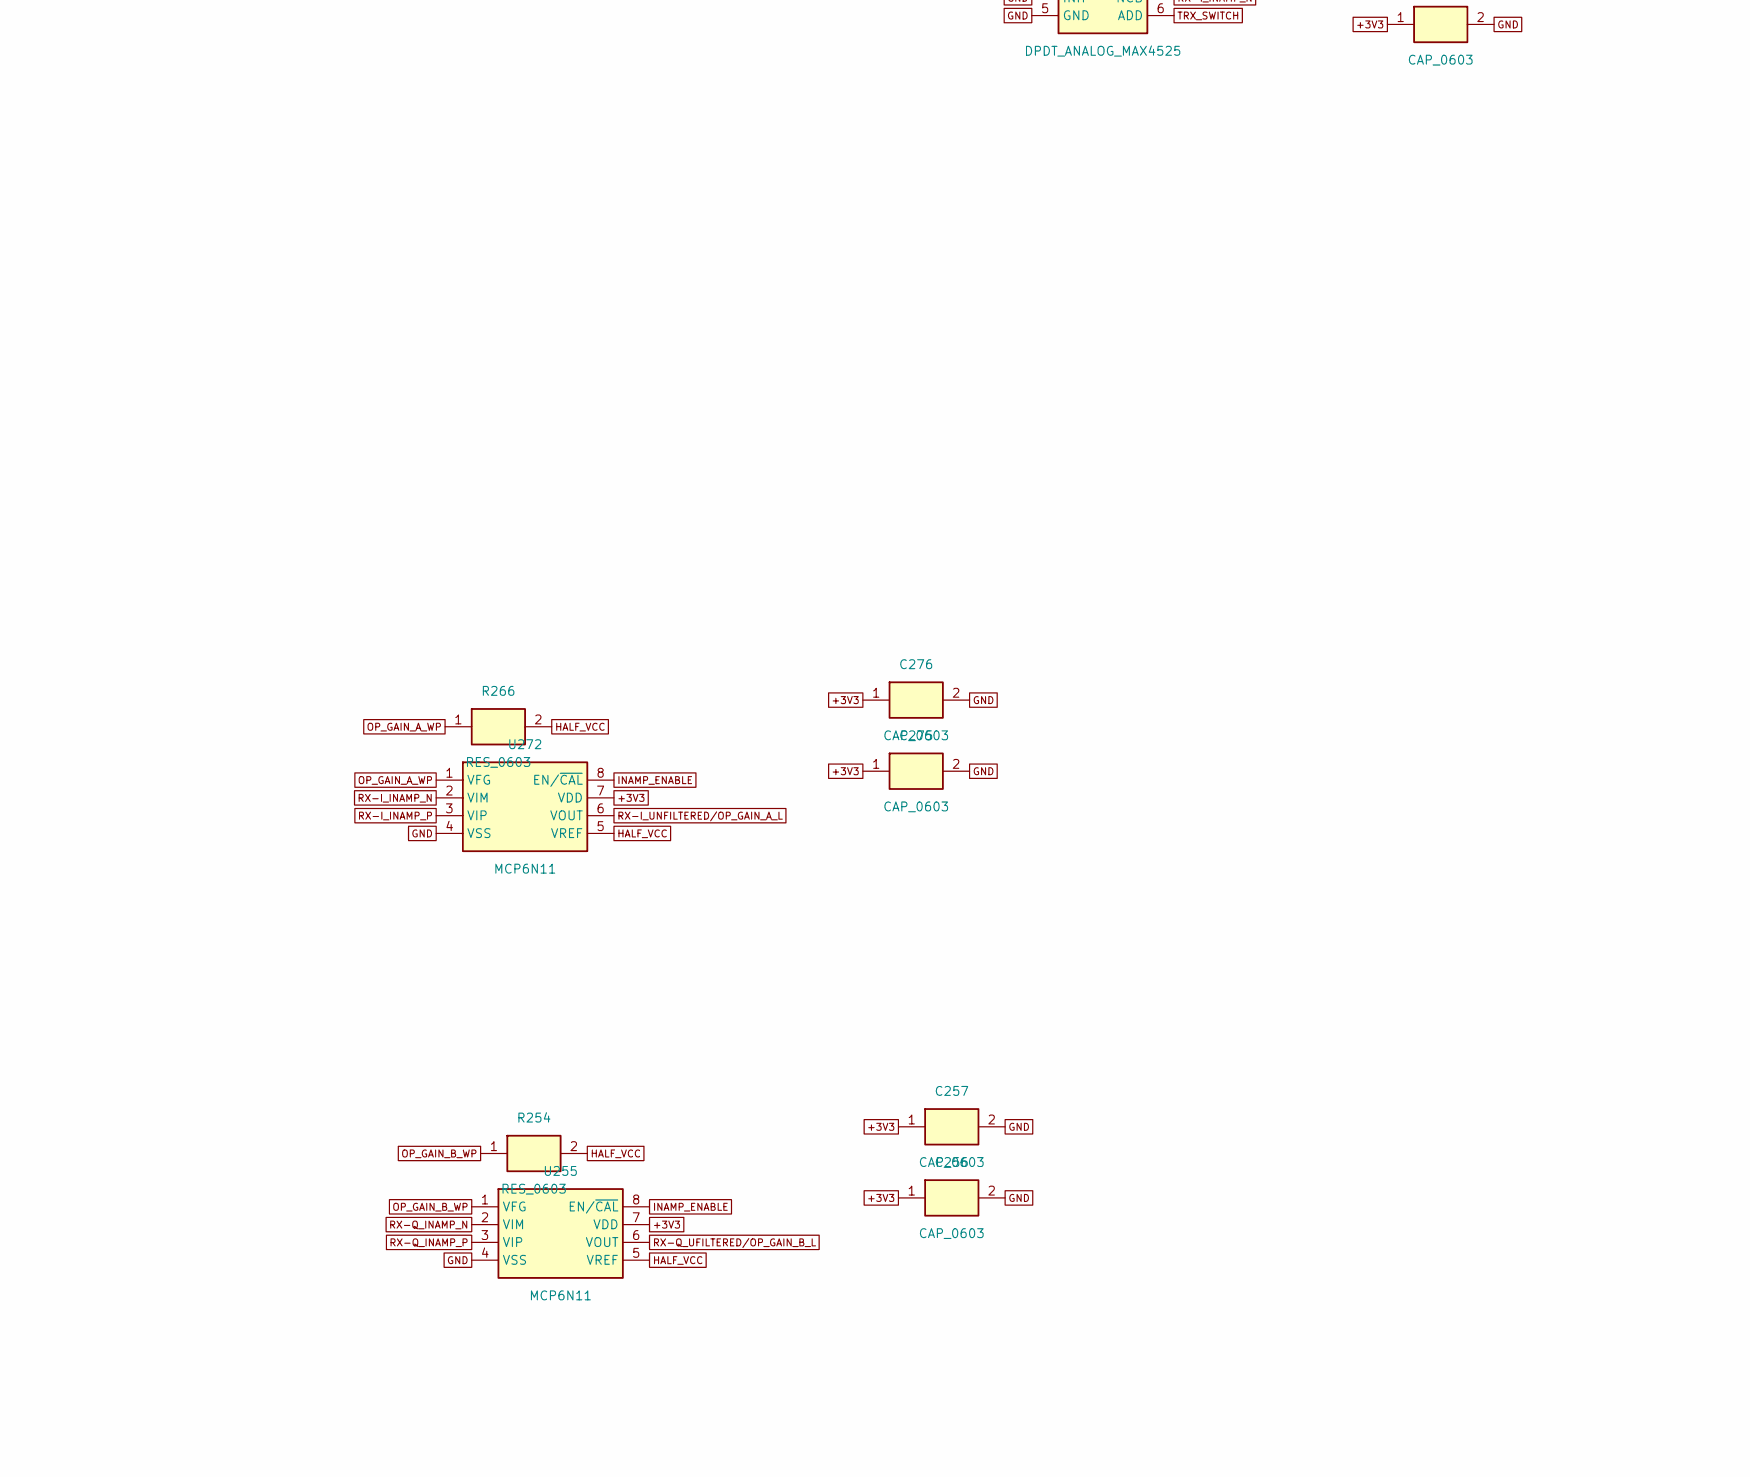
[picture p47: schematic PSDR_2.6.1-p04.kicad_sch, PSDR 2.6.1 - PDF page 4: Analog switches / drivers, part in row 2, column 1]

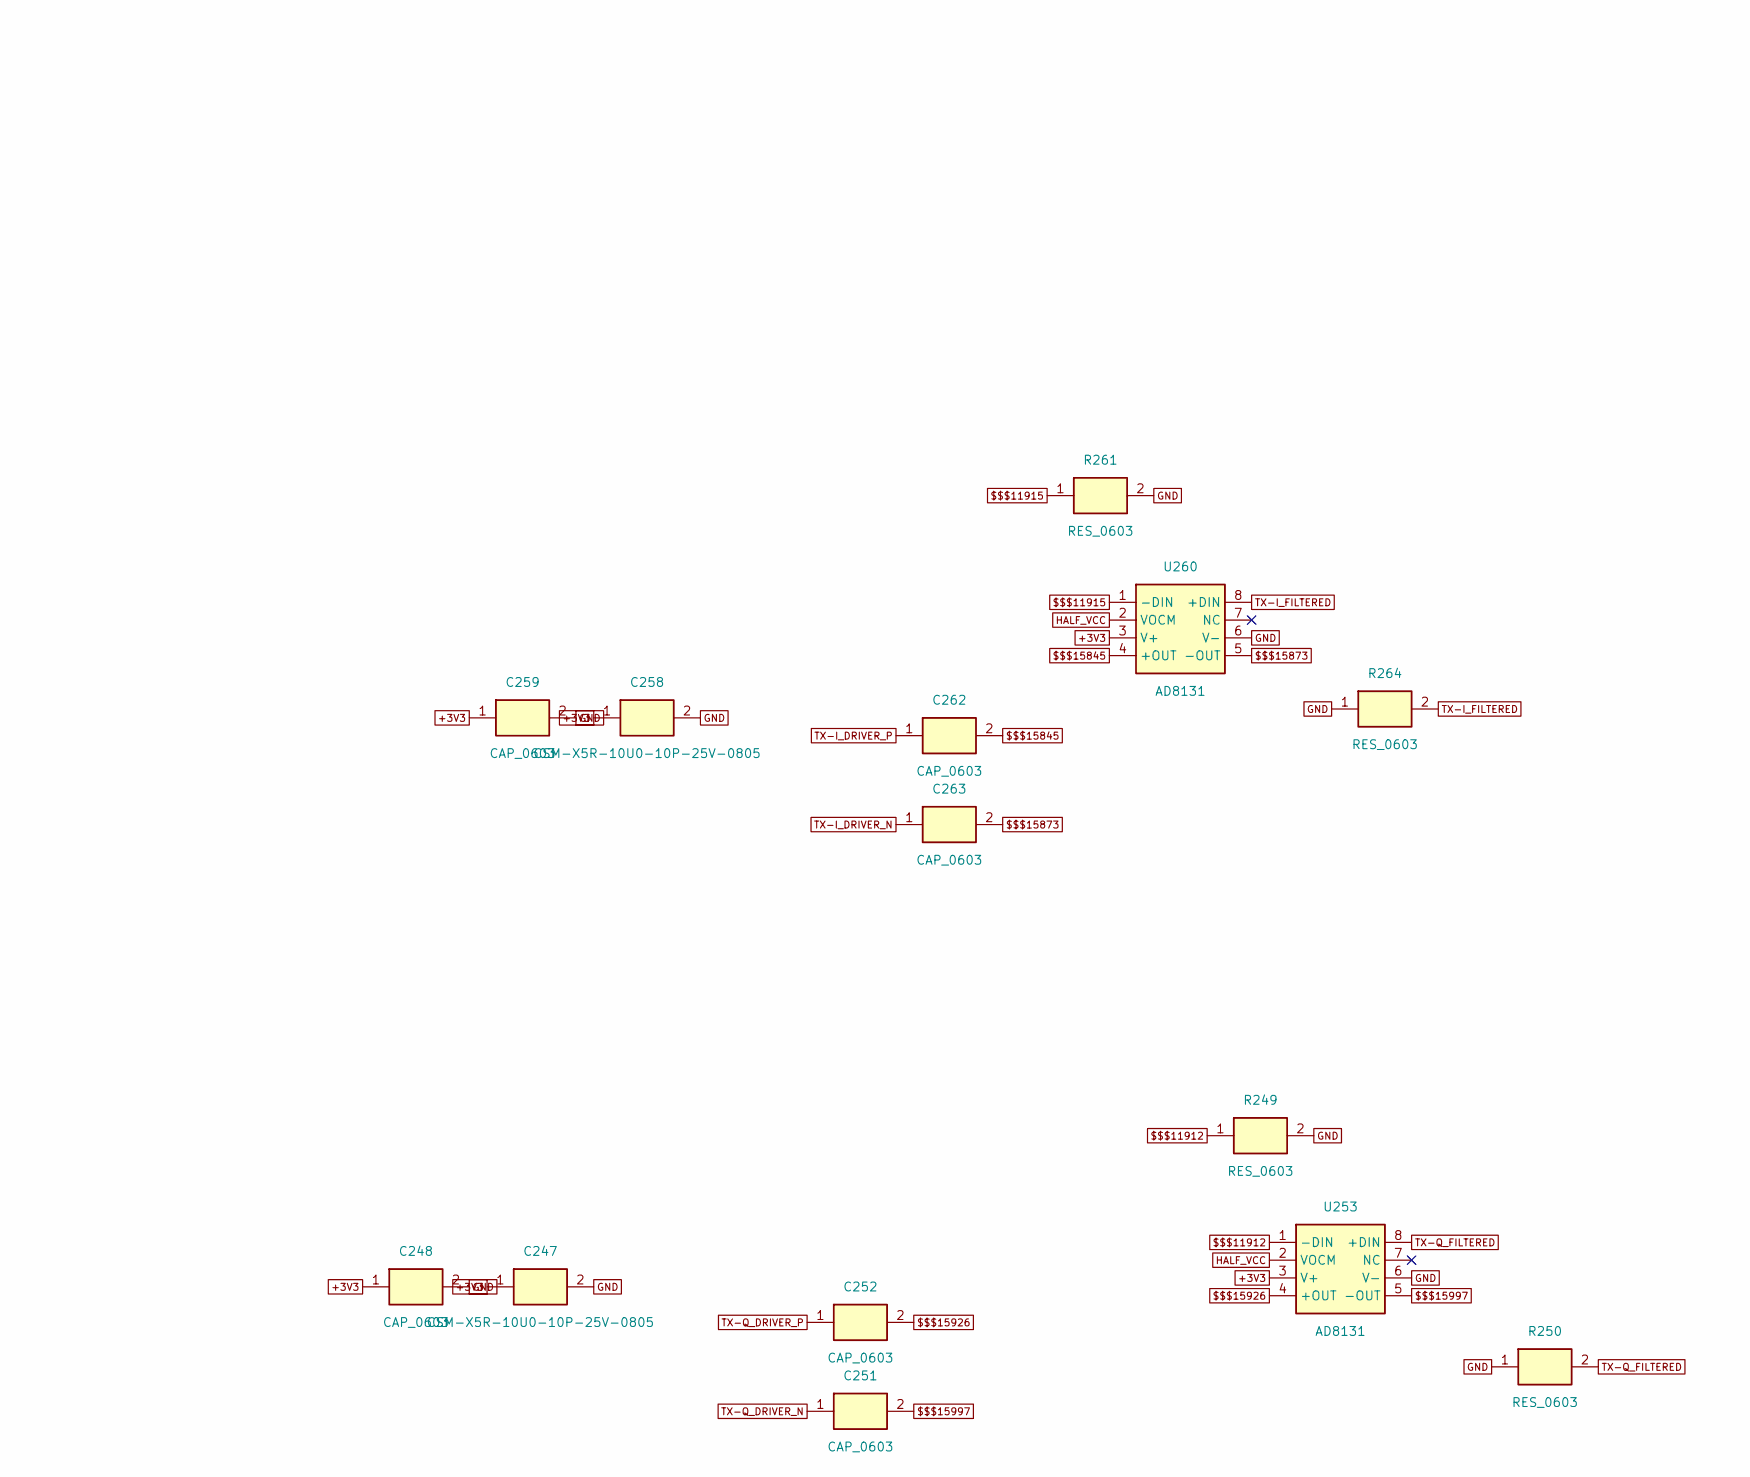
[picture p48: schematic PSDR_2.6.1-p04.kicad_sch, PSDR 2.6.1 - PDF page 4: Analog switches / drivers, part in row 2, column 2]

Parts:
C3, C10, C17, C248, C251, C252, C256, C257, C259, C262, C263, C275, C276: CAP_0603
C247, C258: CSM-X5R-10U0-10P-25V-0805
L41, L81: MIXER_DIODE-RING_ADE-2ASK
L82: BALUN_1-2_WBC2-1TL
R72, R79, R249, R250, R254, R261, R264, R266: RES_0603
U4, U18: DPDT_ANALOG_MAX4525
U15: DIGITAL_POT_MAX5388
U253, U260: AD8131
U255, U272: MCP6N11

Connections:
$$$8723: L41.3, L82.1
$$$8785: L81.4, L82.3
$$$9448: L41.5, U4.9 (COMB)
$$$9458: L41.2, U4.2 (COMA)
$$$9485: L81.5, U18.9 (COMB)
$$$9489: L81.2, U18.2 (COMA)
$$$11912: R249.1, U253.1 (-DIN)
$$$11915: R261.1, U260.1 (-DIN)
$$$15845: C262.2, U260.4 (+OUT)
$$$15873: C263.2, U260.5 (-OUT)
$$$15926: C252.2, U253.4 (+OUT)
$$$15997: C251.2, U253.5 (-OUT)
+3V3: C3.1, C17.1, C247.1, C248.1, C256.1, C257.1, C258.1, C259.1, C275.1, C276.1, U4.10 (V+), U18.10 (V+), U253.3 (V+), U255.7 (VDD), U260.3 (V+), U272.7 (VDD); also elsewhere on the board
+3V3_CPU: C10.1, U15.8 (VDD); also elsewhere on the board
FILTER/GAIN_POT_CLK: U15.7 (SCLK); also elsewhere on the board
FILTER/GAIN_POT_MOSI: U15.6 (DIN); also elsewhere on the board
FILTER_IF_N: L82.6; also elsewhere on the board
FILTER_IF_P: L82.4; also elsewhere on the board
GAIN_POT_NSS: U15.5 (~CS); also elsewhere on the board
GND: C3.2, C10.2, C17.2, C247.2, C248.2, C256.2, C257.2, C258.2, C259.2, C275.2, C276.2, L41.4, L81.3, L82.2, R249.2, R250.1, R261.2, R264.1, U4.4 (INH), U4.5 (GND), U15.1 (GND), U18.4 (INH), U18.5 (GND), U253.6 (V-), U255.4 (VSS), U260.6 (V-), U272.4 (VSS); also elsewhere on the board
HALF_VCC: R254.2, R266.2, U253.2 (VOCM), U255.5 (VREF), U260.2 (VOCM), U272.5 (VREF); also elsewhere on the board
INAMP_ENABLE: U255.8 (EN/~CAL), U272.8 (EN/~CAL); also elsewhere on the board
MIXER_LO1N: L81.1, R79.1; also elsewhere on the board
MIXER_LO1P: L81.6, R79.2; also elsewhere on the board
MIXER_LO2N: L41.1, R72.1; also elsewhere on the board
MIXER_LO2P: L41.6, R72.2; also elsewhere on the board
OP_GAIN_A_WP: R266.1, U15.9 (WA), U272.1 (VFG)
OP_GAIN_B_WP: R254.1, U15.4 (WB), U255.1 (VFG)
RX-I_INAMP_N: U18.7 (NCB), U272.2 (VIM)
RX-I_INAMP_P: U18.3 (NCA), U272.3 (VIP)
RX-I_UNFILTERED/OP_GAIN_A_L: U15.10 (LA), U272.6 (VOUT); also elsewhere on the board
RX-Q_INAMP_N: U4.7 (NCB), U255.2 (VIM)
RX-Q_INAMP_P: U4.3 (NCA), U255.3 (VIP)
RX-Q_UFILTERED/OP_GAIN_B_L: U15.2 (LB), U255.6 (VOUT); also elsewhere on the board
TRX_SWITCH: U4.6 (ADD), U18.6 (ADD); also elsewhere on the board
TX-I_DRIVER_N: C263.1, U18.8 (NOB)
TX-I_DRIVER_P: C262.1, U18.1 (NOA)
TX-I_FILTERED: R264.2, U260.8 (+DIN); also elsewhere on the board
TX-Q_DRIVER_N: C251.1, U4.8 (NOB)
TX-Q_DRIVER_P: C252.1, U4.1 (NOA)
TX-Q_FILTERED: R250.2, U253.8 (+DIN); also elsewhere on the board

Notes on the sheet:
Generated from PADS ASCII. Net names are labels, not drawn wires. Original drawing: PSDR_2.6.1_Schematic_2016-07-31.pdf page 4.

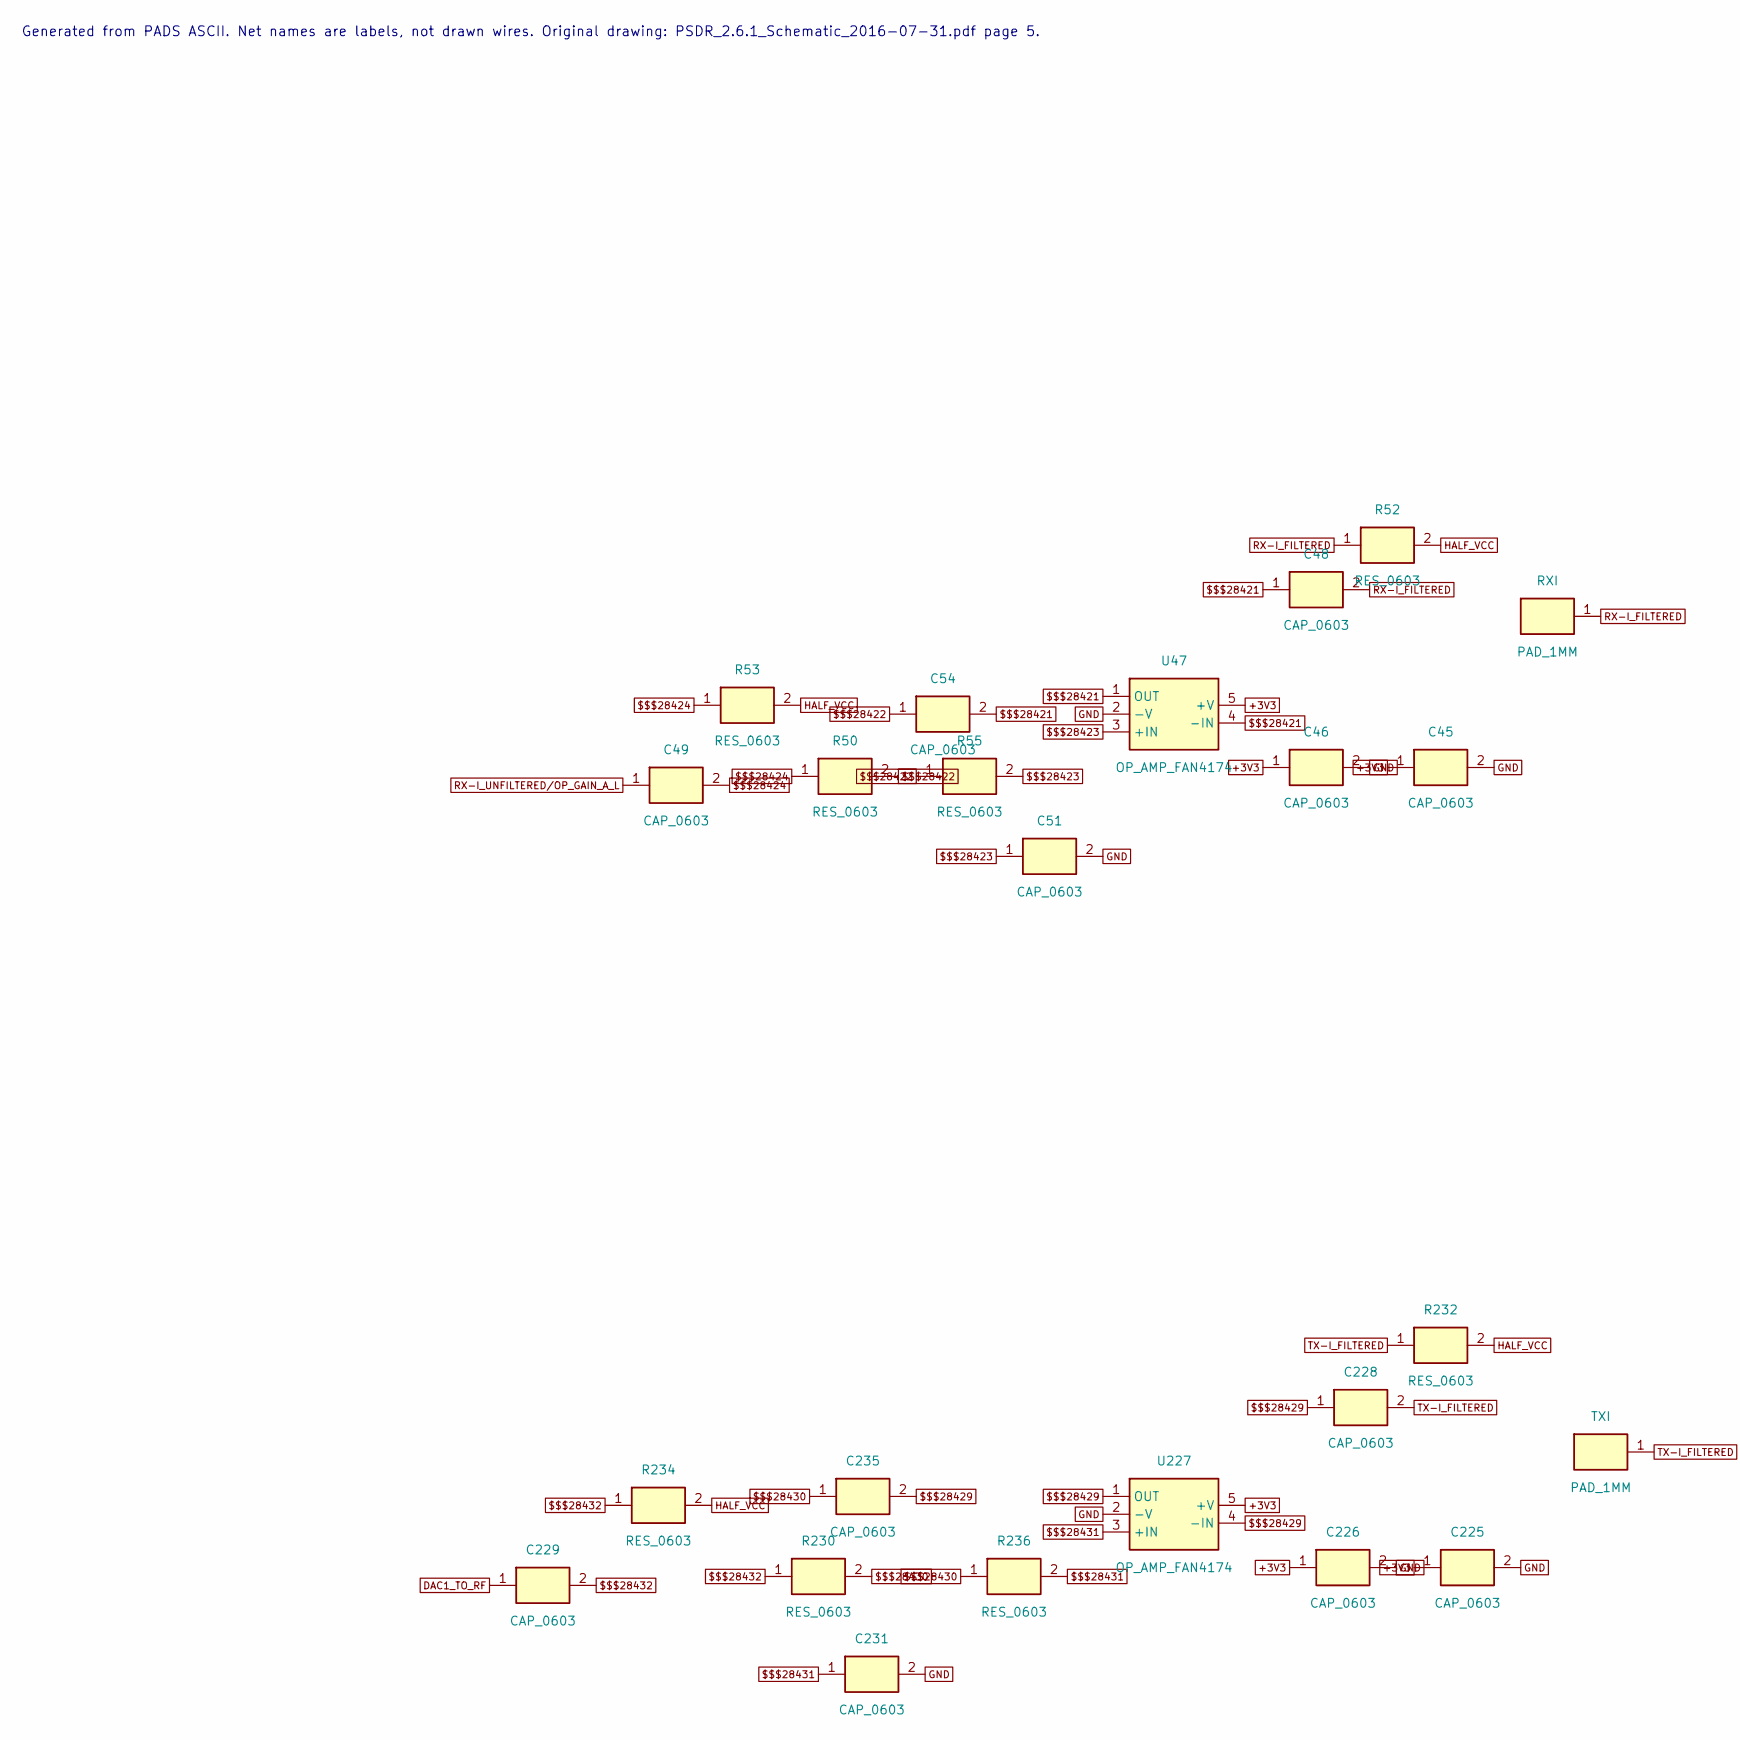
[picture p49: schematic PSDR_2.6.1-p05.kicad_sch, PSDR 2.6.1 - PDF page 5: RX/TX baseband, part in row 1, column 1]

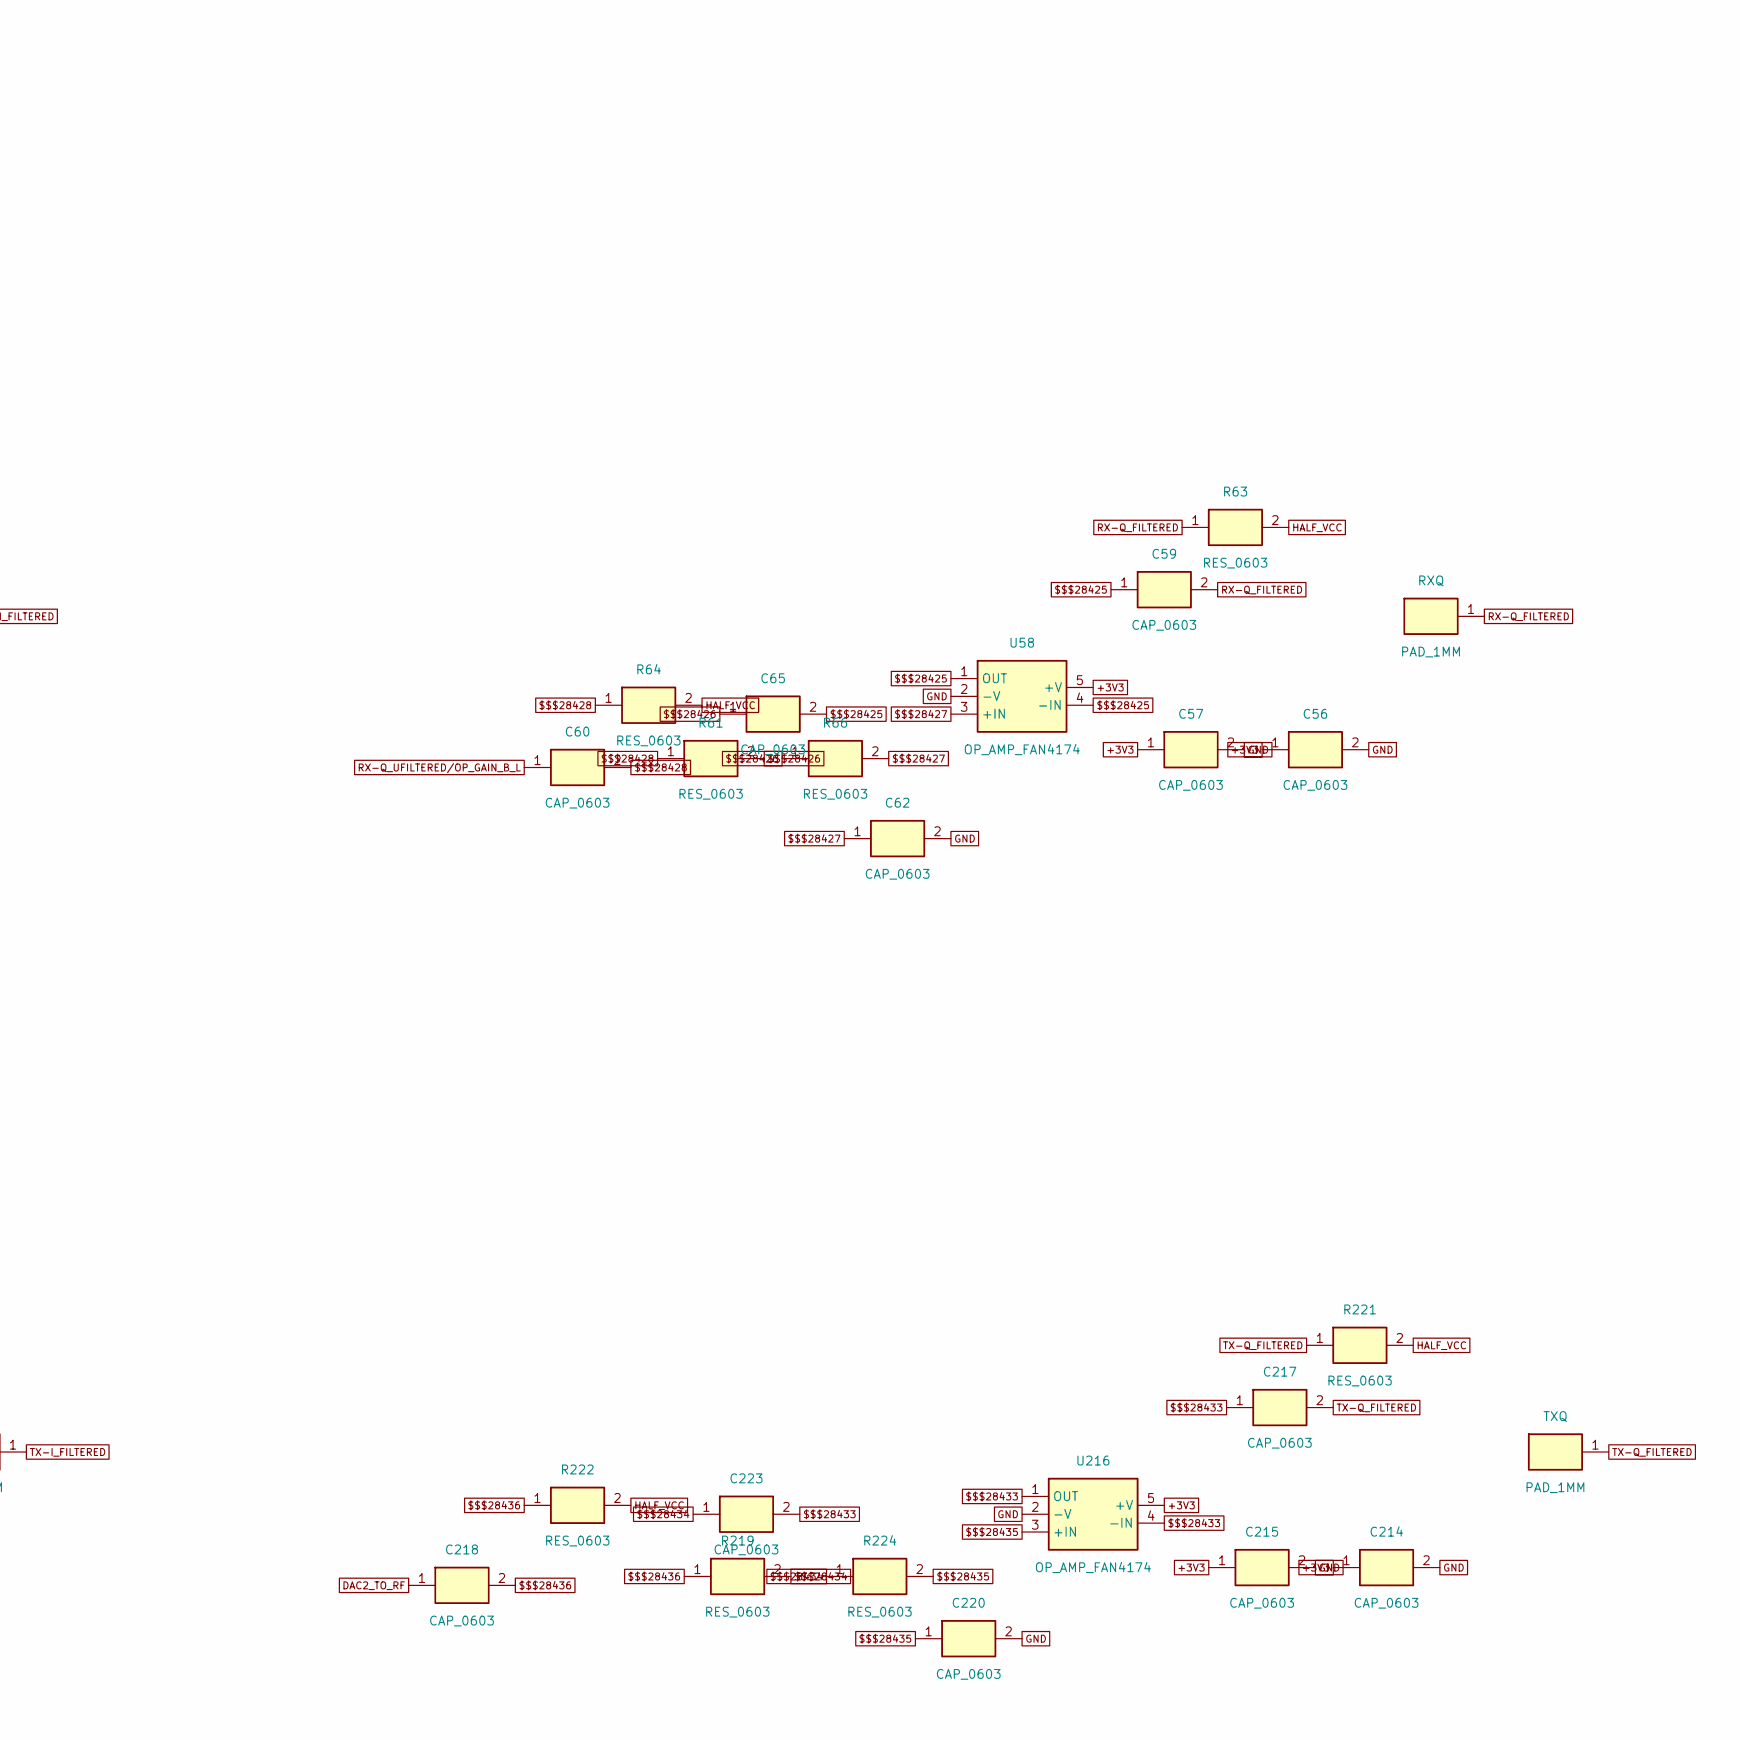
[picture p50: schematic PSDR_2.6.1-p05.kicad_sch, PSDR 2.6.1 - PDF page 5: RX/TX baseband, part in row 1, column 2]

Parts:
C45, C46, C48, C49, C51, C54, C56, C57, C59, C60, C62, C65, C214, C215, C217, C218, C220, C223, C225, C226, C228, C229, C231, C235: CAP_0603
R50, R52, R53, R55, R61, R63, R64, R66, R219, R221, R222, R224, R230, R232, R234, R236: RES_0603
RXI: PAD_1MM
RXQ: PAD_1MM
TXI: PAD_1MM
TXQ: PAD_1MM
U47, U58, U216, U227: OP_AMP_FAN4174

Connections:
$$$28421: C48.1, C54.2, U47.1 (OUT), U47.4 (-IN)
$$$28422: C54.1, R50.2, R55.1
$$$28423: C51.1, R55.2, U47.3 (+IN)
$$$28424: C49.2, R50.1, R53.1
$$$28425: C59.1, C65.2, U58.1 (OUT), U58.4 (-IN)
$$$28426: C65.1, R61.2, R66.1
$$$28427: C62.1, R66.2, U58.3 (+IN)
$$$28428: C60.2, R61.1, R64.1
$$$28429: C228.1, C235.2, U227.1 (OUT), U227.4 (-IN)
$$$28430: C235.1, R230.2, R236.1
$$$28431: C231.1, R236.2, U227.3 (+IN)
$$$28432: C229.2, R230.1, R234.1
$$$28433: C217.1, C223.2, U216.1 (OUT), U216.4 (-IN)
$$$28434: C223.1, R219.2, R224.1
$$$28435: C220.1, R224.2, U216.3 (+IN)
$$$28436: C218.2, R219.1, R222.1
+3V3: C45.1, C46.1, C56.1, C57.1, C214.1, C215.1, C225.1, C226.1, U47.5 (+V), U58.5 (+V), U216.5 (+V), U227.5 (+V); also elsewhere on the board
DAC1_TO_RF: C229.1; also elsewhere on the board
DAC2_TO_RF: C218.1; also elsewhere on the board
GND: C45.2, C46.2, C51.2, C56.2, C57.2, C62.2, C214.2, C215.2, C220.2, C225.2, C226.2, C231.2, U47.2 (-V), U58.2 (-V), U216.2 (-V), U227.2 (-V); also elsewhere on the board
HALF_VCC: R52.2, R53.2, R63.2, R64.2, R221.2, R222.2, R232.2, R234.2; also elsewhere on the board
RX-I_FILTERED: C48.2, R52.1, RXI.1; also elsewhere on the board
RX-I_UNFILTERED/OP_GAIN_A_L: C49.1; also elsewhere on the board
RX-Q_FILTERED: C59.2, R63.1, RXQ.1; also elsewhere on the board
RX-Q_UFILTERED/OP_GAIN_B_L: C60.1; also elsewhere on the board
TX-I_FILTERED: C228.2, R232.1, TXI.1; also elsewhere on the board
TX-Q_FILTERED: C217.2, R221.1, TXQ.1; also elsewhere on the board

Notes on the sheet:
Generated from PADS ASCII. Net names are labels, not drawn wires. Original drawing: PSDR_2.6.1_Schematic_2016-07-31.pdf page 5.
