fe1iscurc0r/PSDR/dist/kicad/PSDR_2.6.1_revB.kicad_pcb

## KiCad design dist/kicad/PSDR_2.6.1_revB.kicad_pcb (continued)

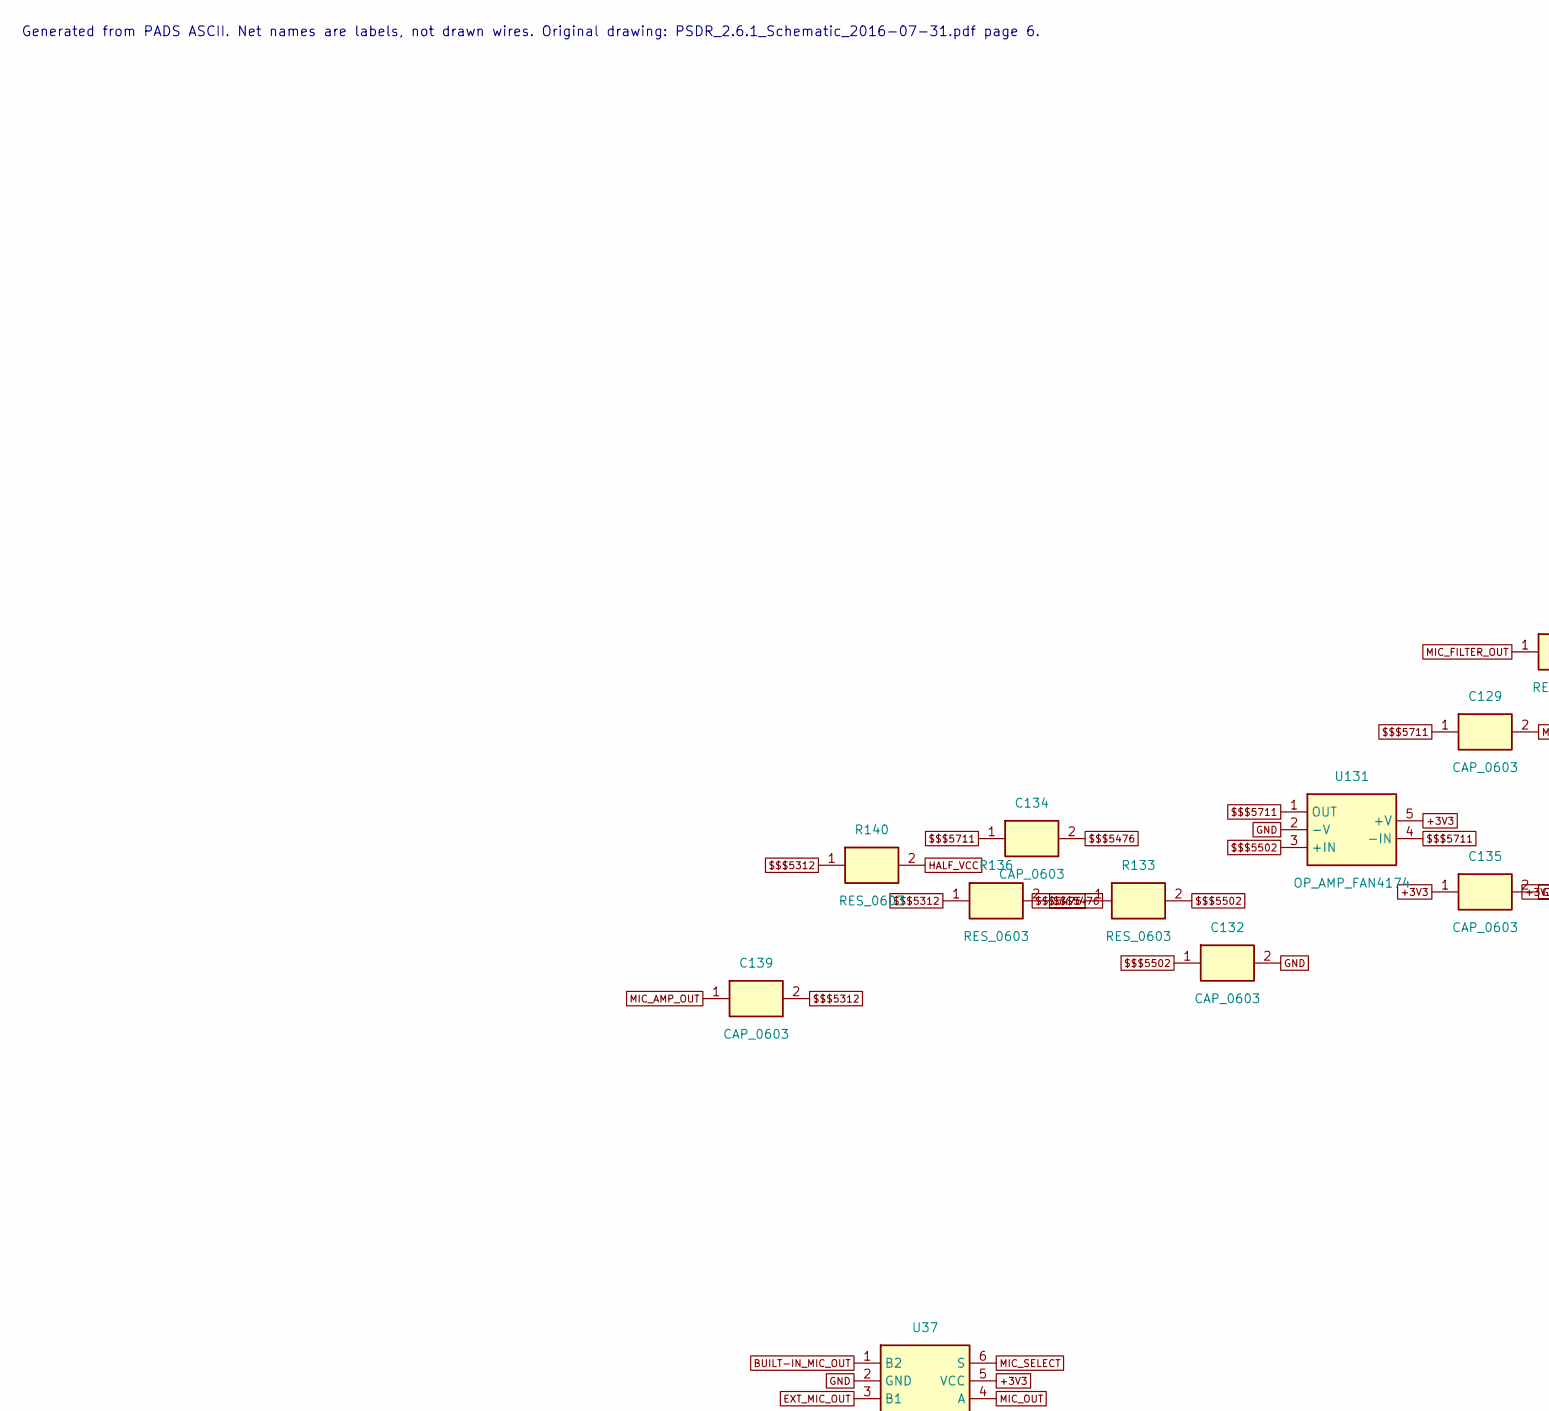
[picture p51: schematic PSDR_2.6.1-p06.kicad_sch, PSDR 2.6.1 - PDF page 6: Audio / microphone, part in row 1, column 1]

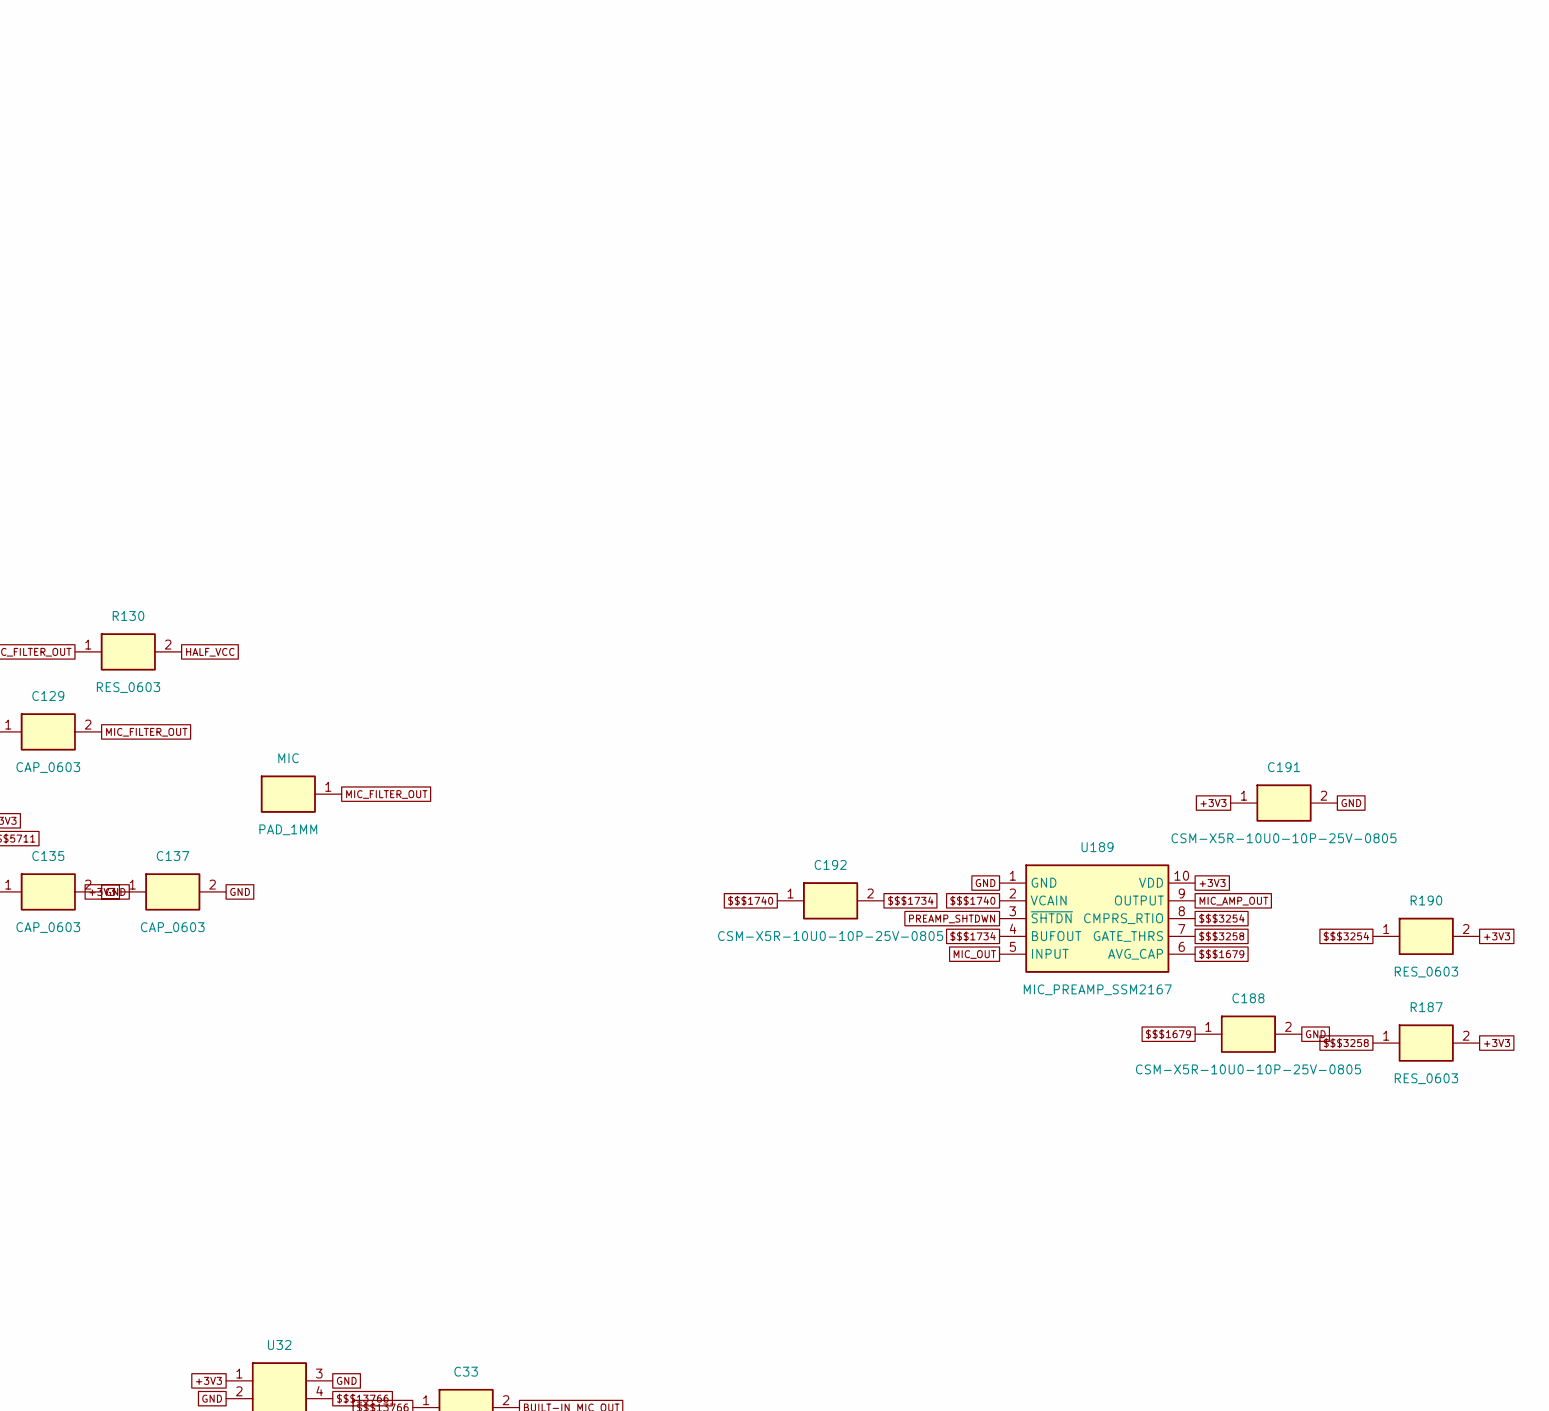
[picture p52: schematic PSDR_2.6.1-p06.kicad_sch, PSDR 2.6.1 - PDF page 6: Audio / microphone, part in row 1, column 2]

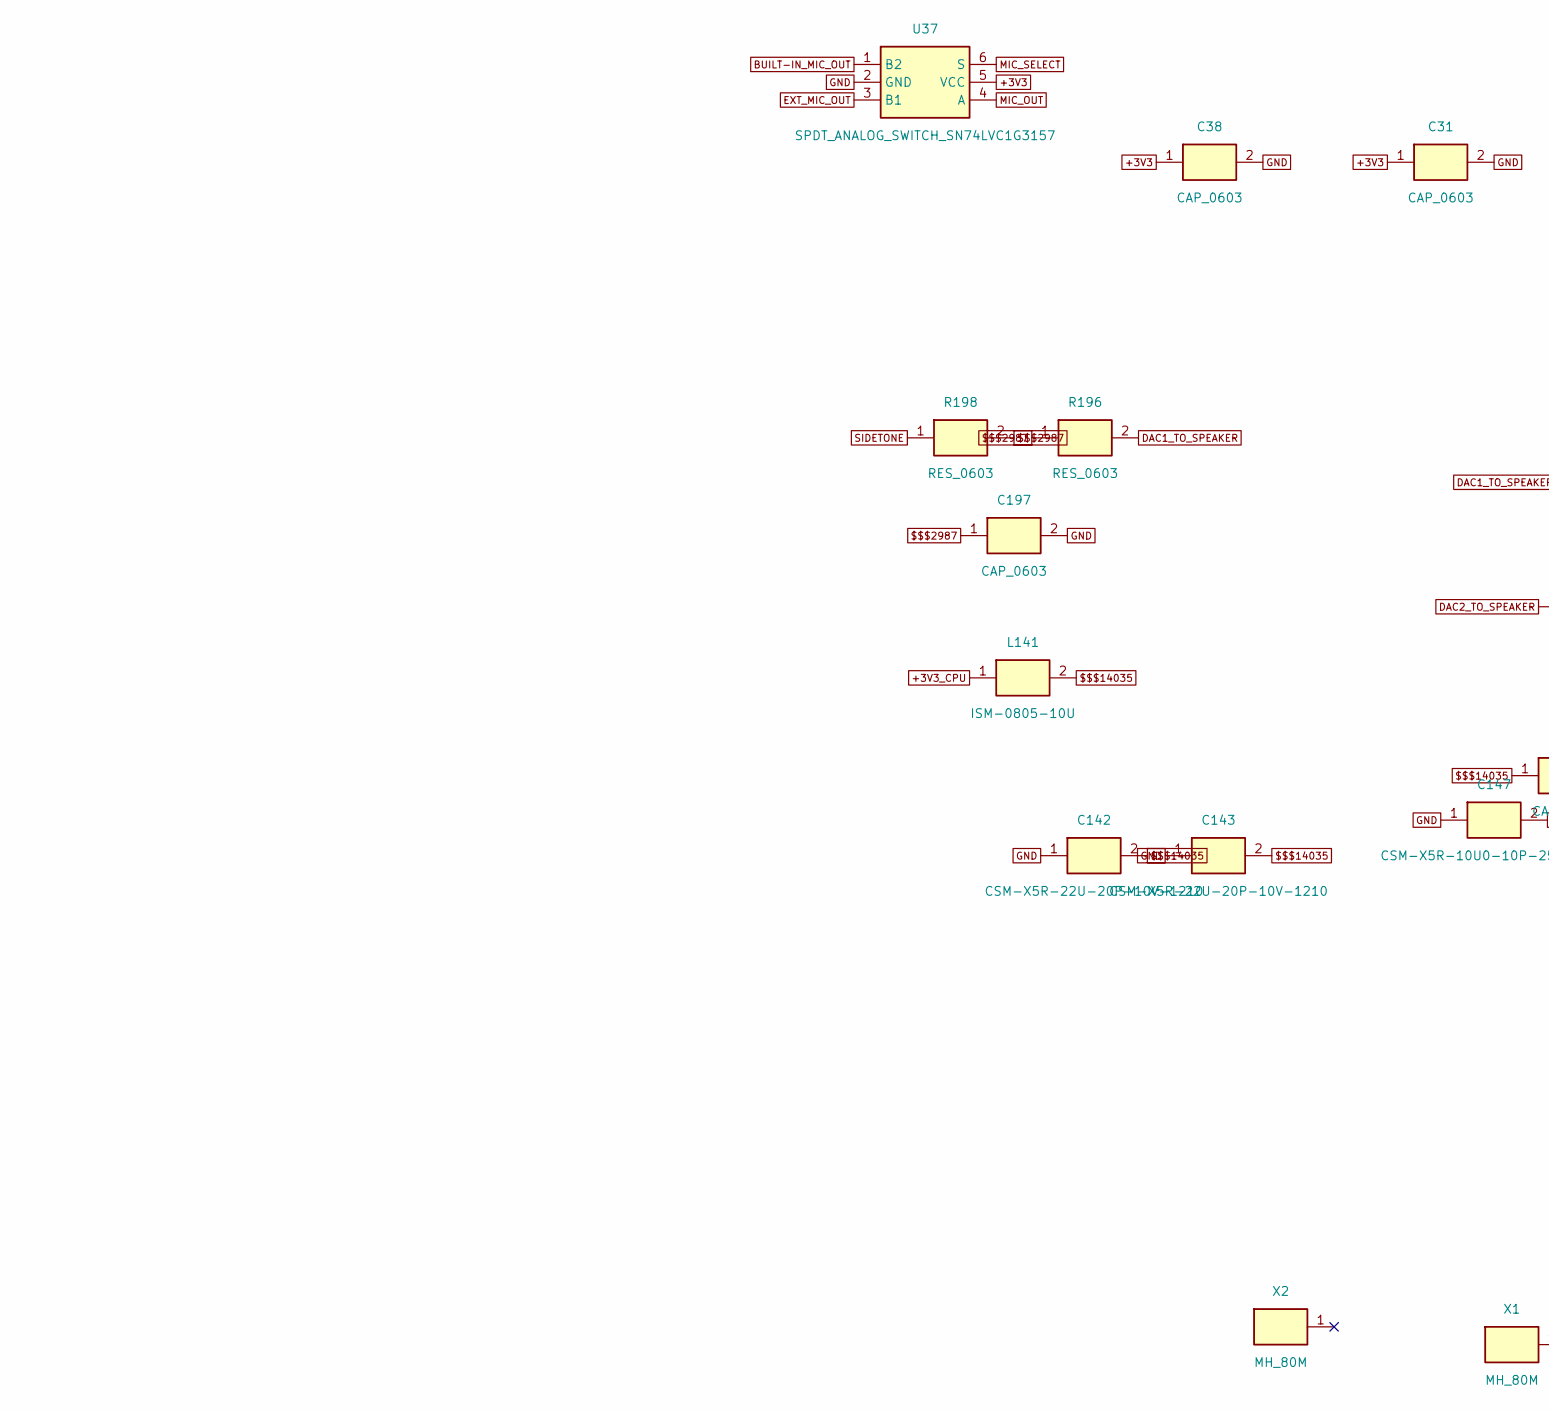
[picture p53: schematic PSDR_2.6.1-p06.kicad_sch, PSDR 2.6.1 - PDF page 6: Audio / microphone, part in row 2, column 1]

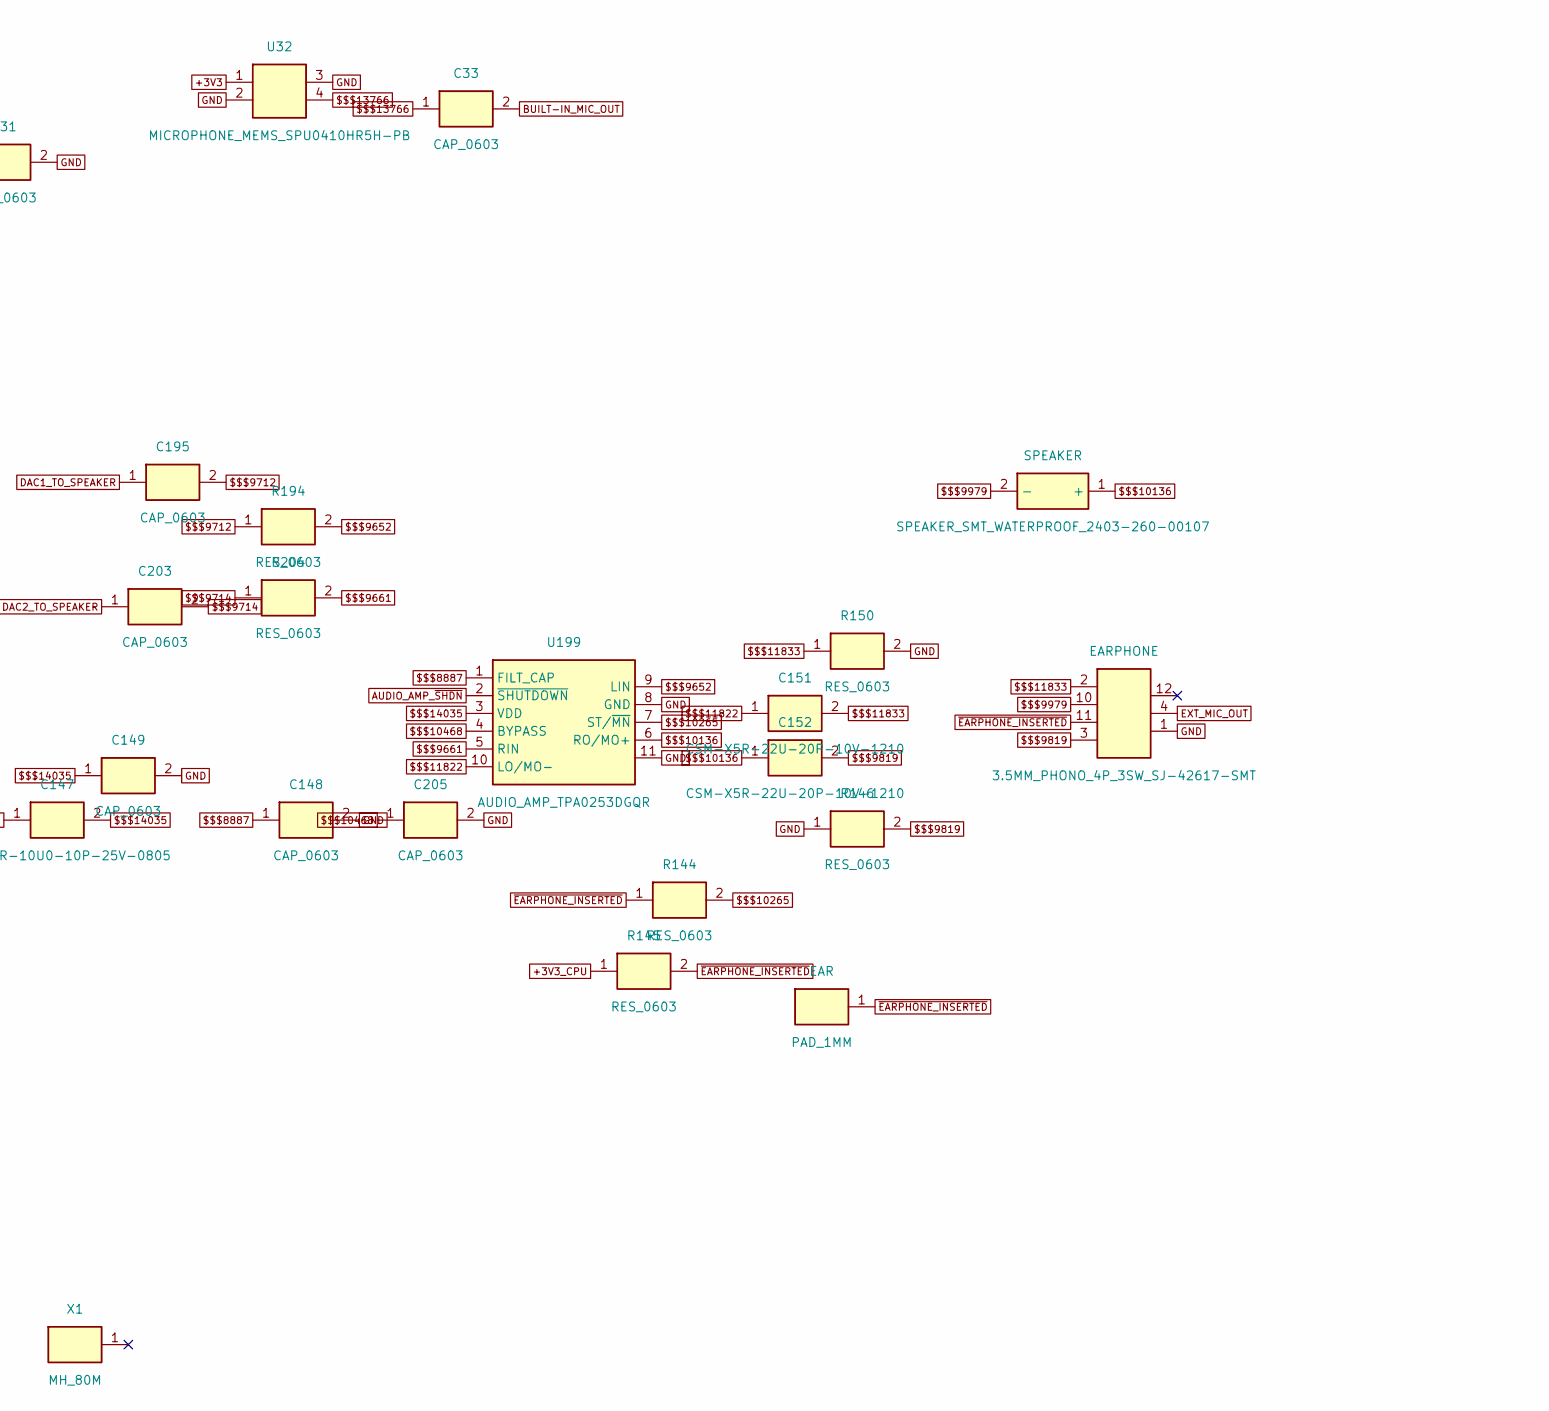
[picture p54: schematic PSDR_2.6.1-p06.kicad_sch, PSDR 2.6.1 - PDF page 6: Audio / microphone, part in row 2, column 2]

Parts:
C31, C33, C38, C129, C132, C134, C135, C137, C139, C148, C149, C195, C197, C203, C205: CAP_0603
C142, C143, C151, C152: CSM-X5R-22U-20P-10V-1210
C147, C188, C191, C192: CSM-X5R-10U0-10P-25V-0805
EAR: PAD_1MM
EARPHONE: 3.5MM_PHONO_4P_3SW_SJ-42617-SMT; 3_5MM_PHONO_4P_3SW_SJ-42617-SMT
L141: ISM-0805-10U
MIC: PAD_1MM
R130, R133, R136, R140, R144, R145, R146, R150, R187, R190, R194, R196, R198, R204: RES_0603
SPEAKER: SPEAKER_SMT_WATERPROOF_2403-260-00107
U32: MICROPHONE_MEMS_SPU0410HR5H-PB
U37: SPDT_ANALOG_SWITCH_SN74LVC1G3157
U131: OP_AMP_FAN4174
U189: MIC_PREAMP_SSM2167
U199: AUDIO_AMP_TPA0253DGQR
X1, X2: MH_80M

Connections:
$$$1679: C188.1, U189.6 (AVG_CAP)
$$$1734: C192.2, U189.4 (BUFOUT)
$$$1740: C192.1, U189.2 (VCAIN)
$$$2987: C197.1, R196.1, R198.2
$$$3254: R190.1, U189.8 (CMPRS_RTIO)
$$$3258: R187.1, U189.7 (GATE_THRS)
$$$5312: C139.2, R136.1, R140.1
$$$5476: C134.2, R133.1, R136.2
$$$5502: C132.1, R133.2, U131.3 (+IN)
$$$5711: C129.1, C134.1, U131.1 (OUT), U131.4 (-IN)
$$$8887: C148.1, U199.1 (FILT_CAP)
$$$9652: R194.2, U199.9 (LIN)
$$$9661: R204.2, U199.5 (RIN)
$$$9712: C195.2, R194.1
$$$9714: C203.2, R204.1
$$$9819: C152.2, EARPHONE.3, R146.2
$$$9979: EARPHONE.10, SPEAKER.2 (-)
$$$10136: C152.1, SPEAKER.1 (+), U199.6 (RO/MO+)
$$$10265: R144.2, U199.7 (ST/~MN)
$$$10468: C205.1, U199.4 (BYPASS)
$$$11822: C151.1, U199.10 (LO/MO-)
$$$11833: C151.2, EARPHONE.2, R150.1
$$$13766: C33.1, U32.4
$$$14035: C142.2, C143.2, C147.2, C149.1, L141.2, U199.3 (VDD)
+3V3: C31.1, C38.1, C135.1, C137.1, C191.1, R187.2, R190.2, U32.1, U37.5 (VCC), U131.5 (+V), U189.10 (VDD); also elsewhere on the board
+3V3_CPU: L141.1, R145.1; also elsewhere on the board
AUDIO_AMP_SHDN: U199.2 (~SHUTDOWN); also elsewhere on the board
BUILT-IN_MIC_OUT: C33.2, U37.1 (B2)
DAC1_TO_SPEAKER: C195.1, R196.2; also elsewhere on the board
DAC2_TO_SPEAKER: C203.1; also elsewhere on the board
EARPHONE_INSERTED: EAR.1, EARPHONE.11, R144.1, R145.2; also elsewhere on the board
EXT_MIC_OUT: EARPHONE.4, U37.3 (B1); also elsewhere on the board
GND: C31.2, C38.2, C132.2, C135.2, C137.2, C142.1, C143.1, C147.1, C148.2, C149.2, C188.2, C191.2, C197.2, C205.2, EARPHONE.1, R146.1, R150.2, U32.2, U32.3, U37.2 (GND), U131.2 (-V), U189.1 (GND), U199.8 (GND), U199.11; also elsewhere on the board
HALF_VCC: R130.2, R140.2; also elsewhere on the board
MIC_AMP_OUT: C139.1, U189.9 (OUTPUT)
MIC_FILTER_OUT: C129.2, MIC.1, R130.1; also elsewhere on the board
MIC_OUT: U37.4 (A), U189.5 (INPUT)
MIC_SELECT: U37.6 (S); also elsewhere on the board
PREAMP_SHTDWN: U189.3 (~SHTDN); also elsewhere on the board
SIDETONE: R198.1; also elsewhere on the board

Notes on the sheet:
Generated from PADS ASCII. Net names are labels, not drawn wires. Original drawing: PSDR_2.6.1_Schematic_2016-07-31.pdf page 6.

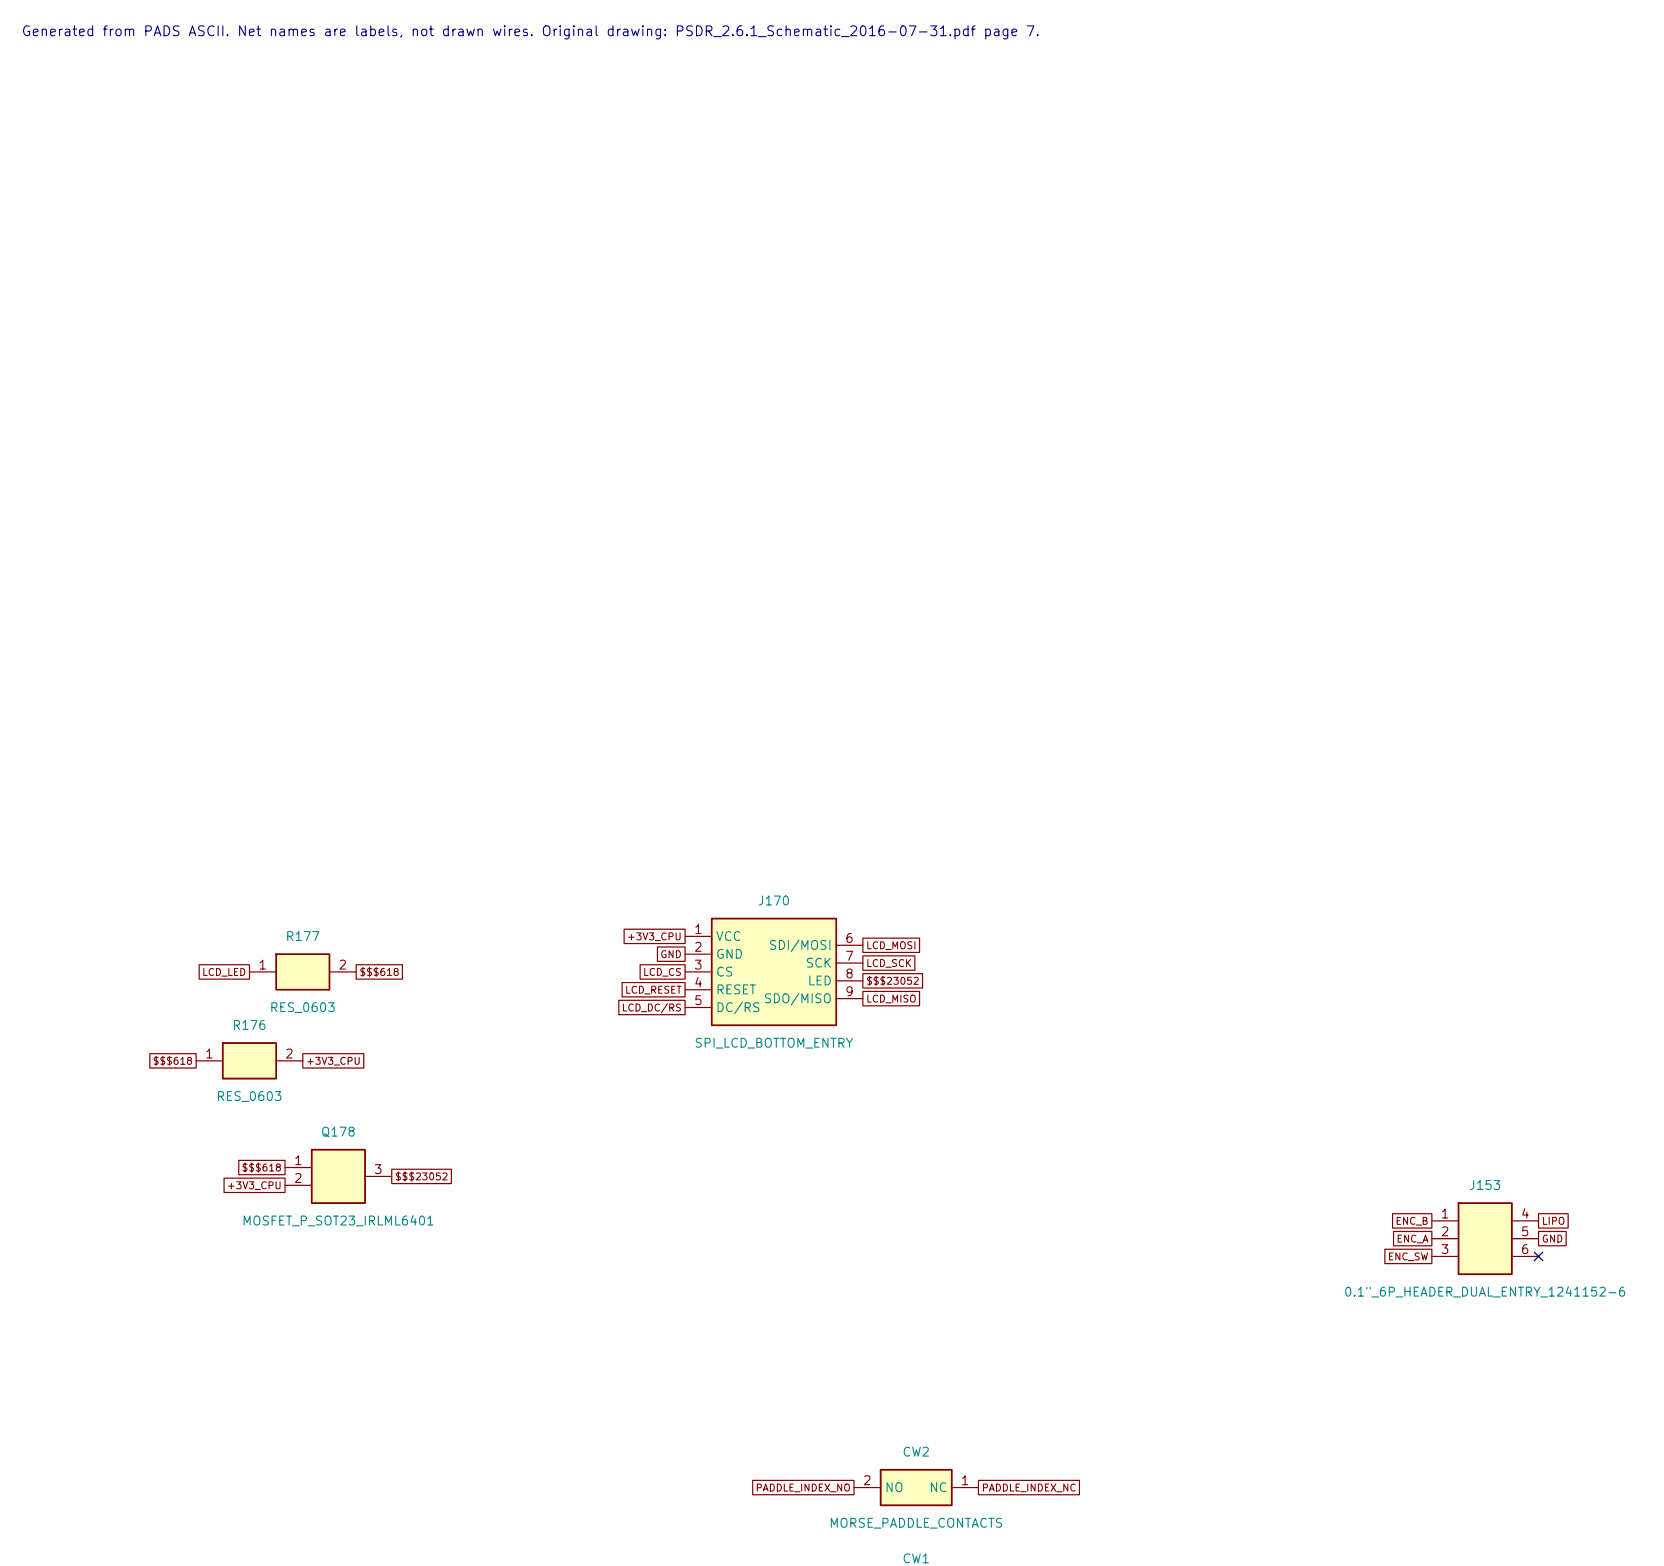
[picture p55: schematic PSDR_2.6.1-p07.kicad_sch, PSDR 2.6.1 - PDF page 7: UI: paddles / LEDs / LCD, part in row 1, column 1]

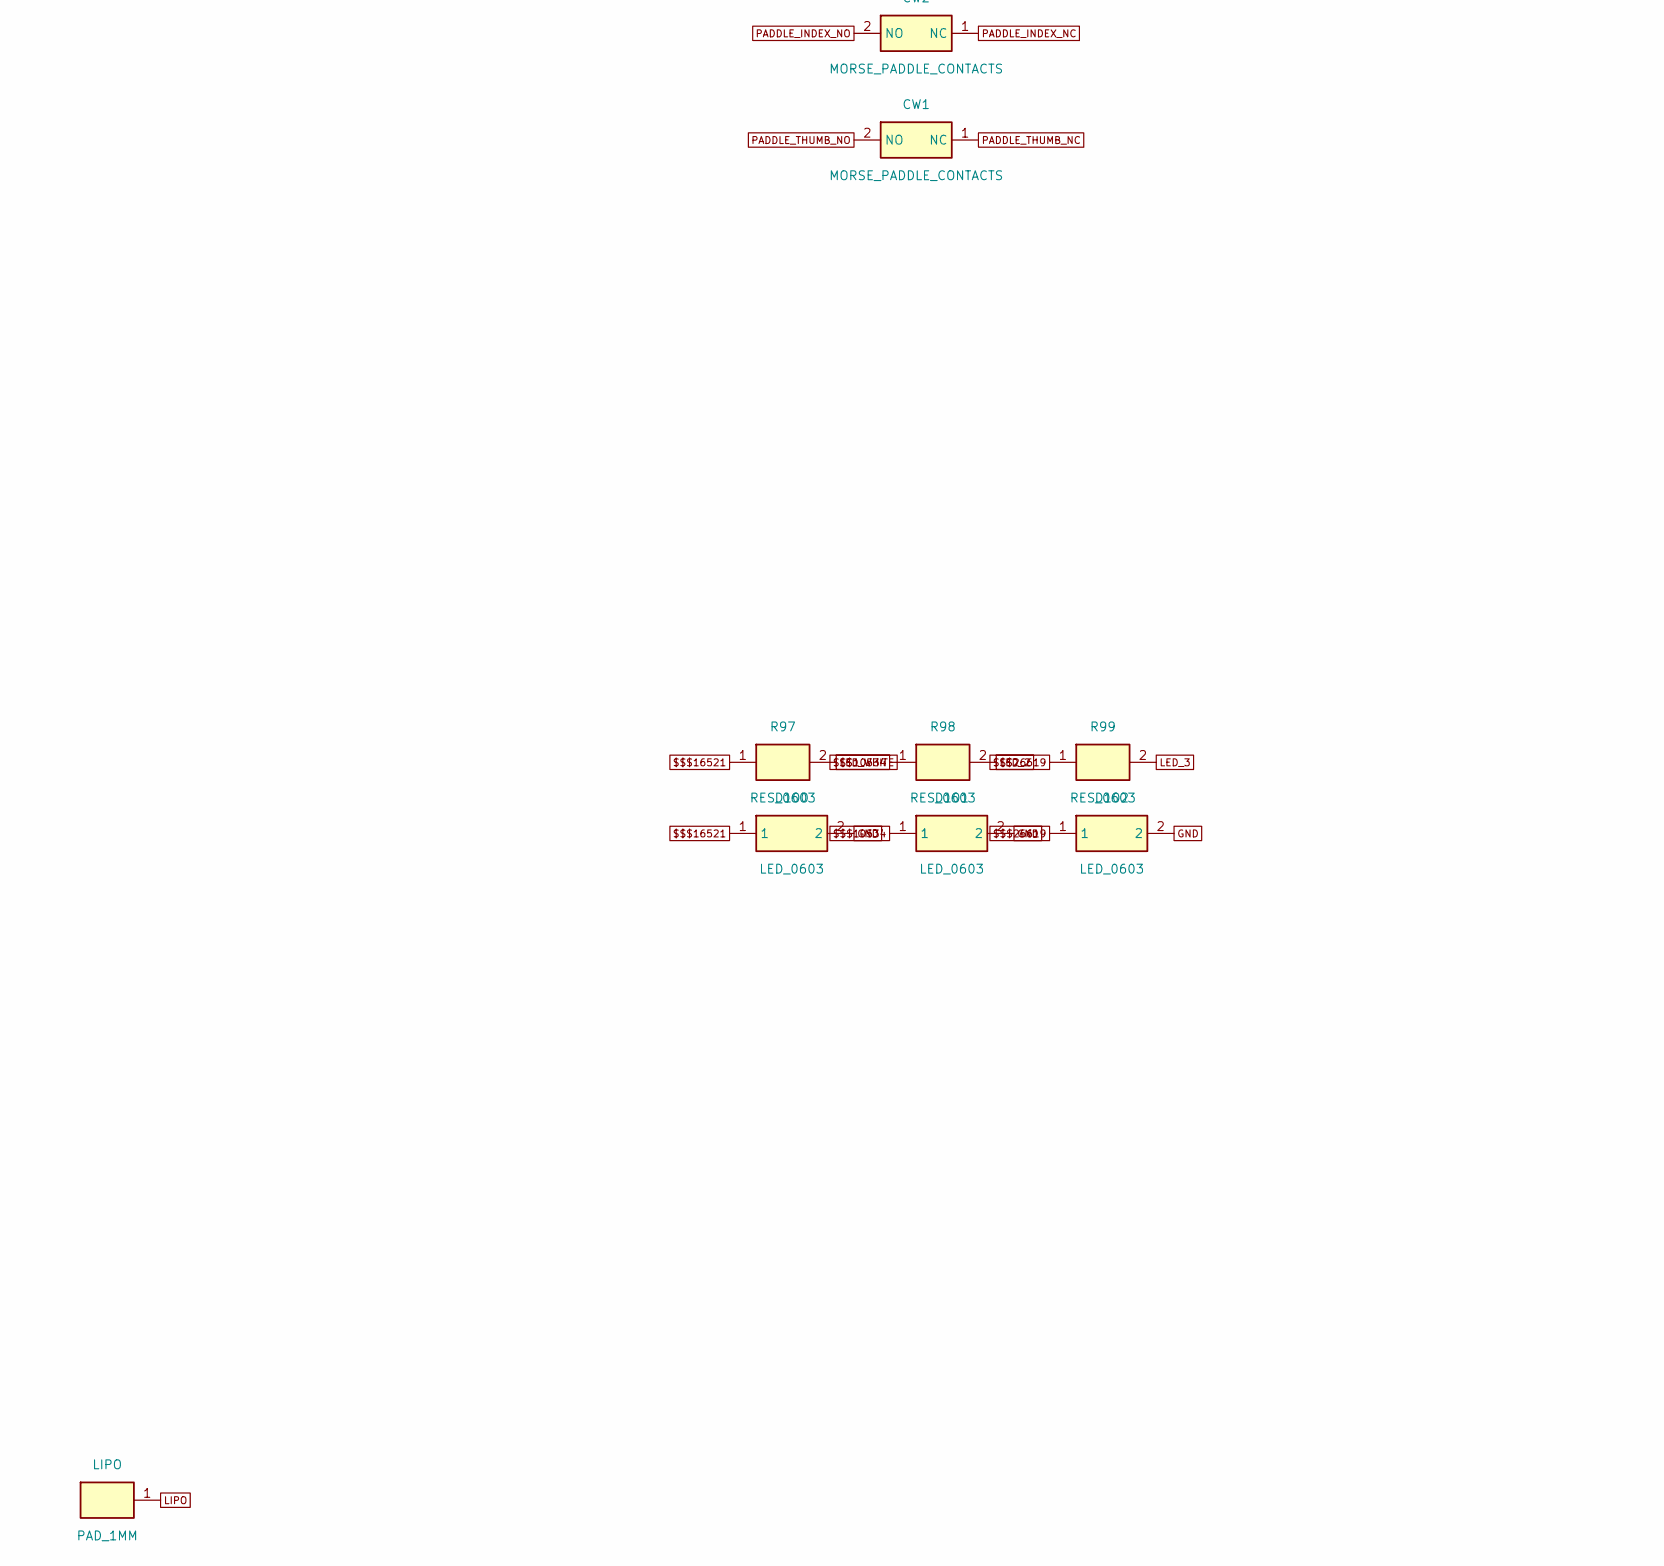
[picture p56: schematic PSDR_2.6.1-p07.kicad_sch, PSDR 2.6.1 - PDF page 7: UI: paddles / LEDs / LCD, part in row 2, column 1]

Parts:
CW1, CW2: MORSE_PADDLE_CONTACTS
D100, D101, D102: LED_0603
J153: 0.1"_6P_HEADER_DUAL_ENTRY_1241152-6; 0_1__6P_HEADER_DUAL_ENTRY_1241152-6
J170: SPI_LCD_BOTTOM_ENTRY
LIPO: PAD_1MM
Q178: MOSFET_P_SOT23_IRLML6401
R97, R98, R99, R176, R177: RES_0603

Connections:
$$$618: Q178.1, R176.1, R177.2
$$$10534: D101.1, R98.1
$$$16521: D100.1, R97.1
$$$23052: J170.8 (LED), Q178.3
$$$26619: D102.1, R99.1
+3V3_CPU: J170.1 (VCC), Q178.2, R176.2; also elsewhere on the board
ENC_A: J153.2; also elsewhere on the board
ENC_B: J153.1; also elsewhere on the board
ENC_SW: J153.3; also elsewhere on the board
GND: D100.2, D101.2, D102.2, J153.5, J170.2 (GND); also elsewhere on the board
LCD_CS: J170.3 (CS); also elsewhere on the board
LCD_DC/RS: J170.5 (DC/RS); also elsewhere on the board
LCD_LED: R177.1; also elsewhere on the board
LCD_MISO: J170.9 (SDO/MISO); also elsewhere on the board
LCD_MOSI: J170.6 (SDI/MOSI); also elsewhere on the board
LCD_RESET: J170.4 (RESET); also elsewhere on the board
LCD_SCK: J170.7 (SCK); also elsewhere on the board
LED_2: R98.2; also elsewhere on the board
LED_3: R99.2; also elsewhere on the board
LED_WHITE: R97.2; also elsewhere on the board
LIPO: J153.4, LIPO.1; also elsewhere on the board
PADDLE_INDEX_NC: CW2.1 (NC); also elsewhere on the board
PADDLE_INDEX_NO: CW2.2 (NO); also elsewhere on the board
PADDLE_THUMB_NC: CW1.1 (NC); also elsewhere on the board
PADDLE_THUMB_NO: CW1.2 (NO); also elsewhere on the board

Notes on the sheet:
Generated from PADS ASCII. Net names are labels, not drawn wires. Original drawing: PSDR_2.6.1_Schematic_2016-07-31.pdf page 7.
