fe1iscurc0r/PSDR/dist/kicad/PSDR_2.6.1_revB.kicad_pcb

## KiCad design dist/kicad/PSDR_2.6.1_revB.kicad_pcb (continued)

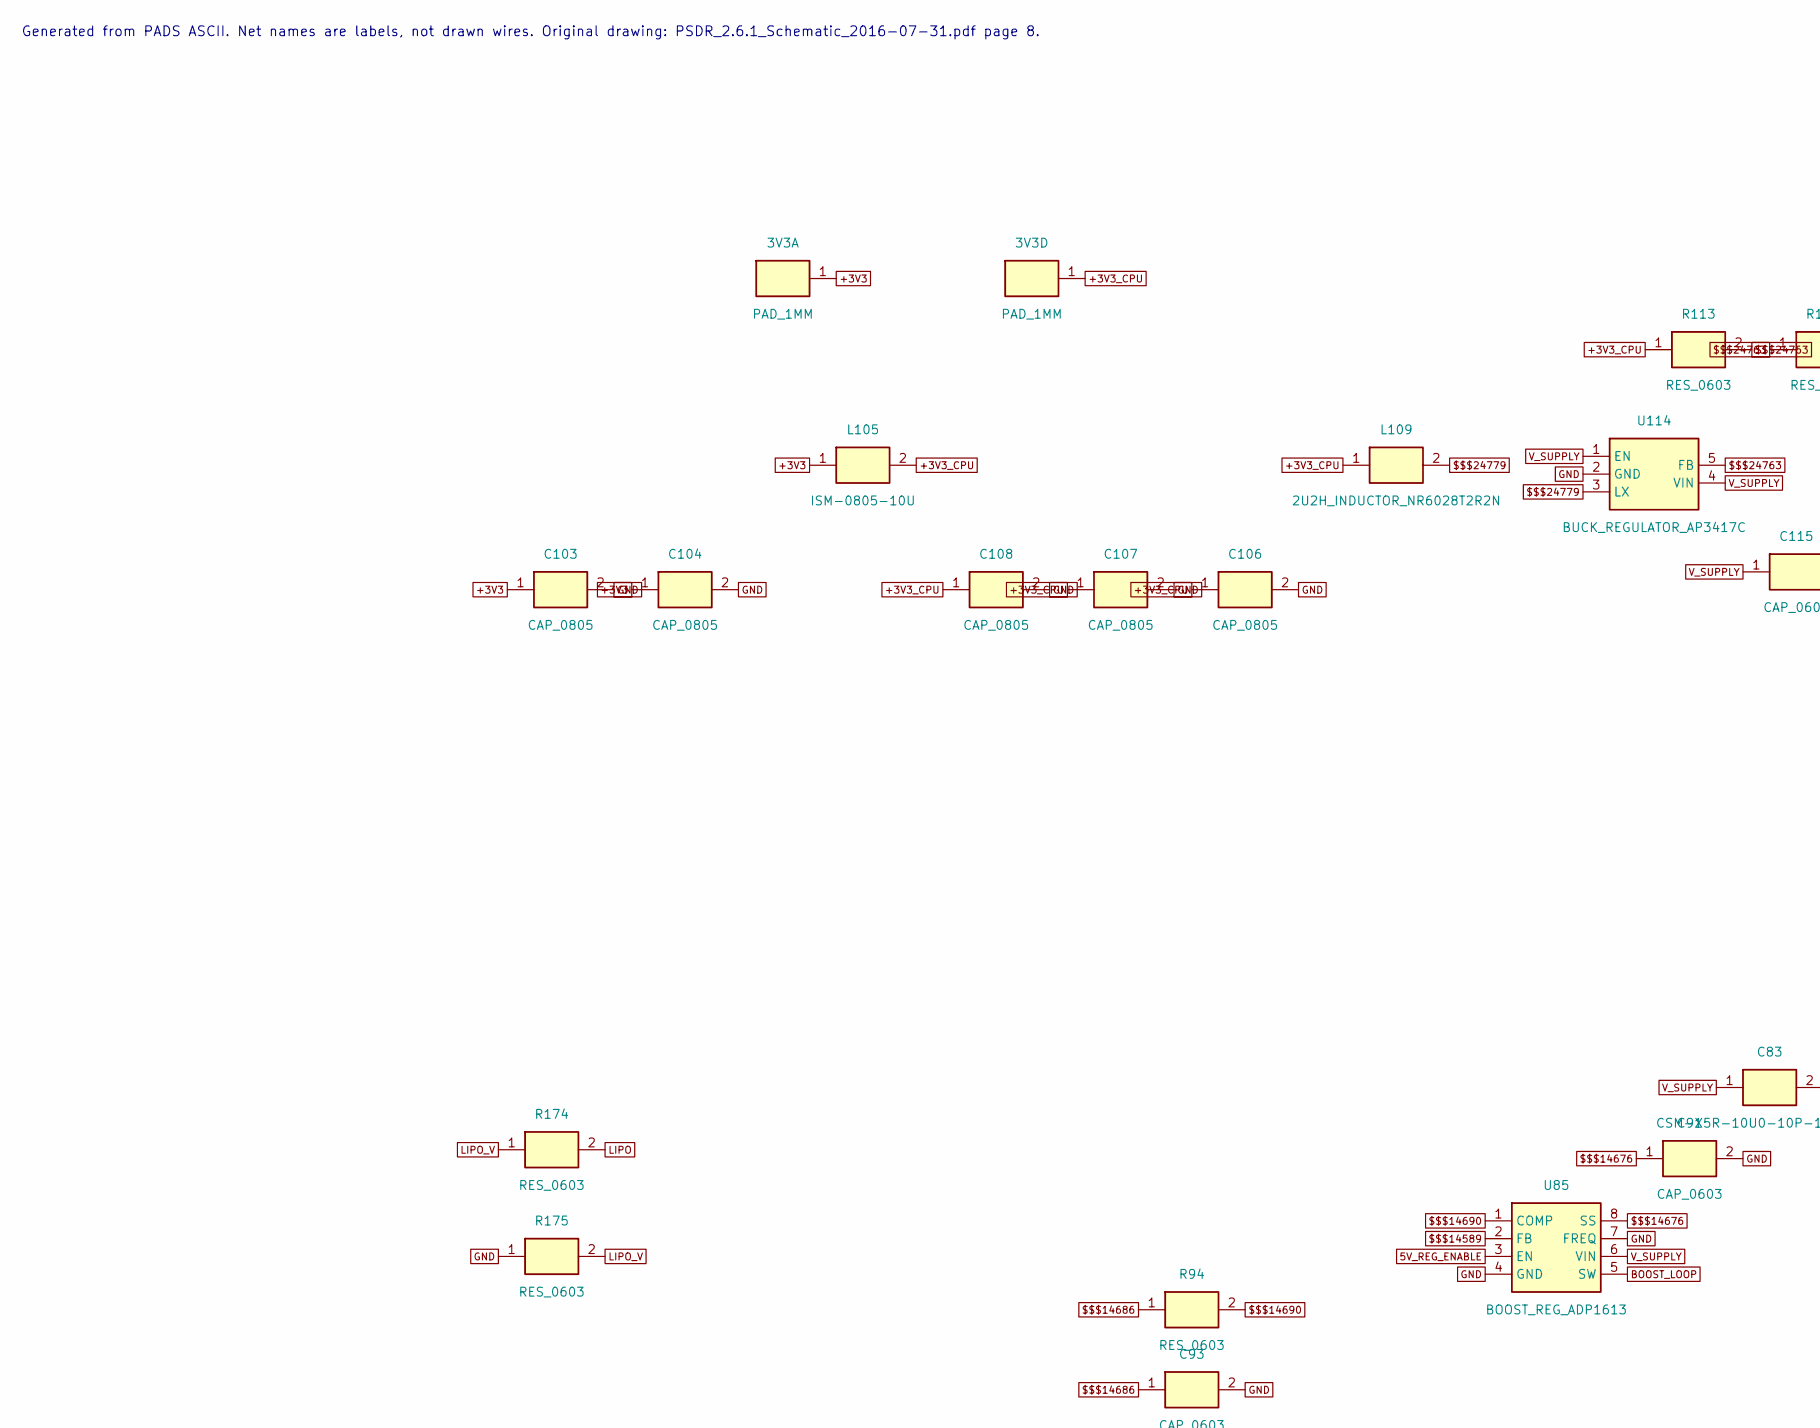
[picture p57: schematic PSDR_2.6.1-p08.kicad_sch, PSDR 2.6.1 - PDF page 8: Power, part in row 1, column 1]

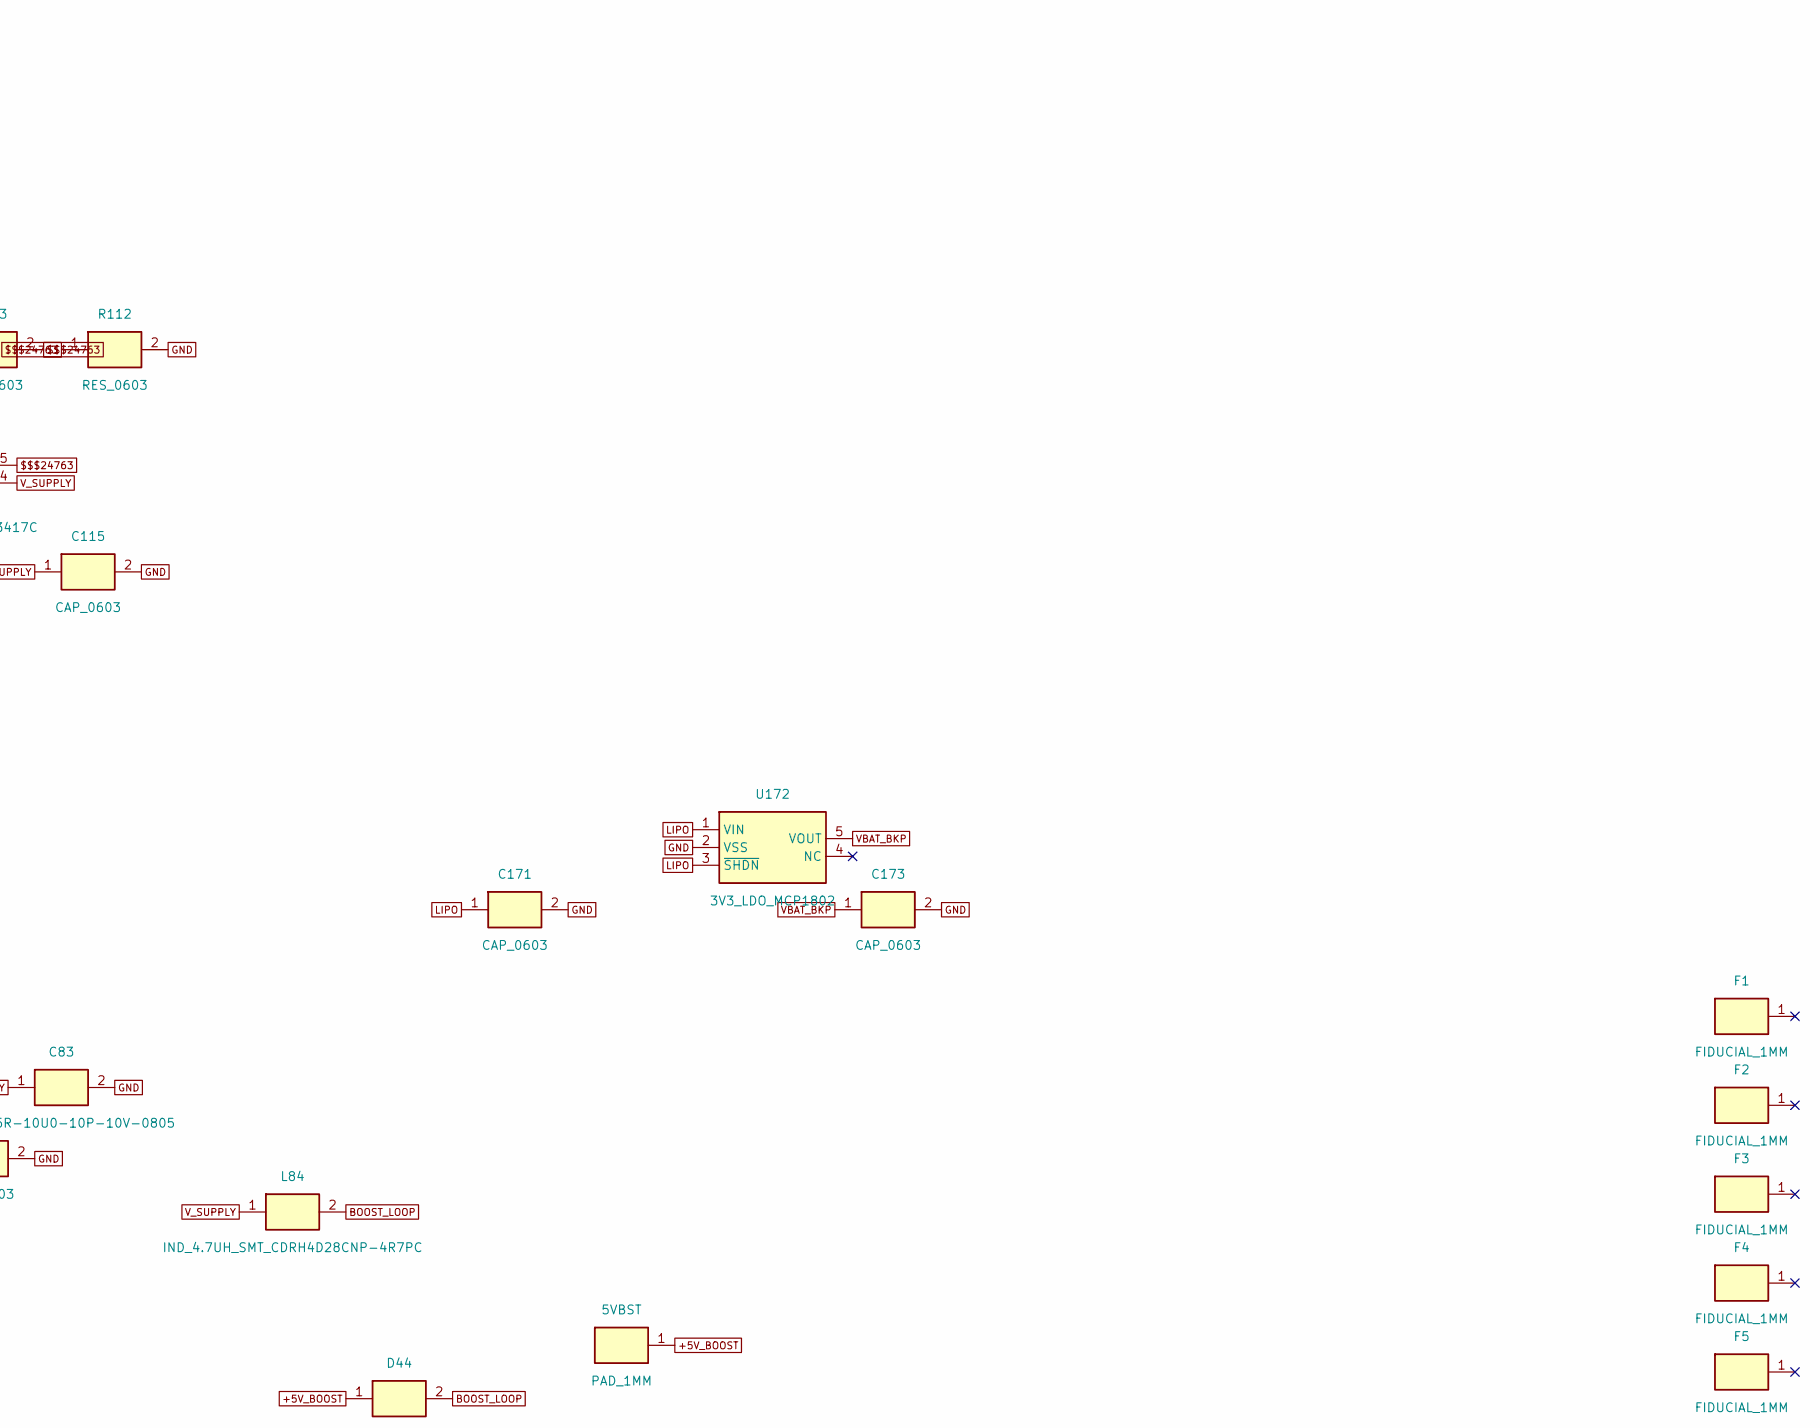
[picture p58: schematic PSDR_2.6.1-p08.kicad_sch, PSDR 2.6.1 - PDF page 8: Power, part in row 1, column 2]

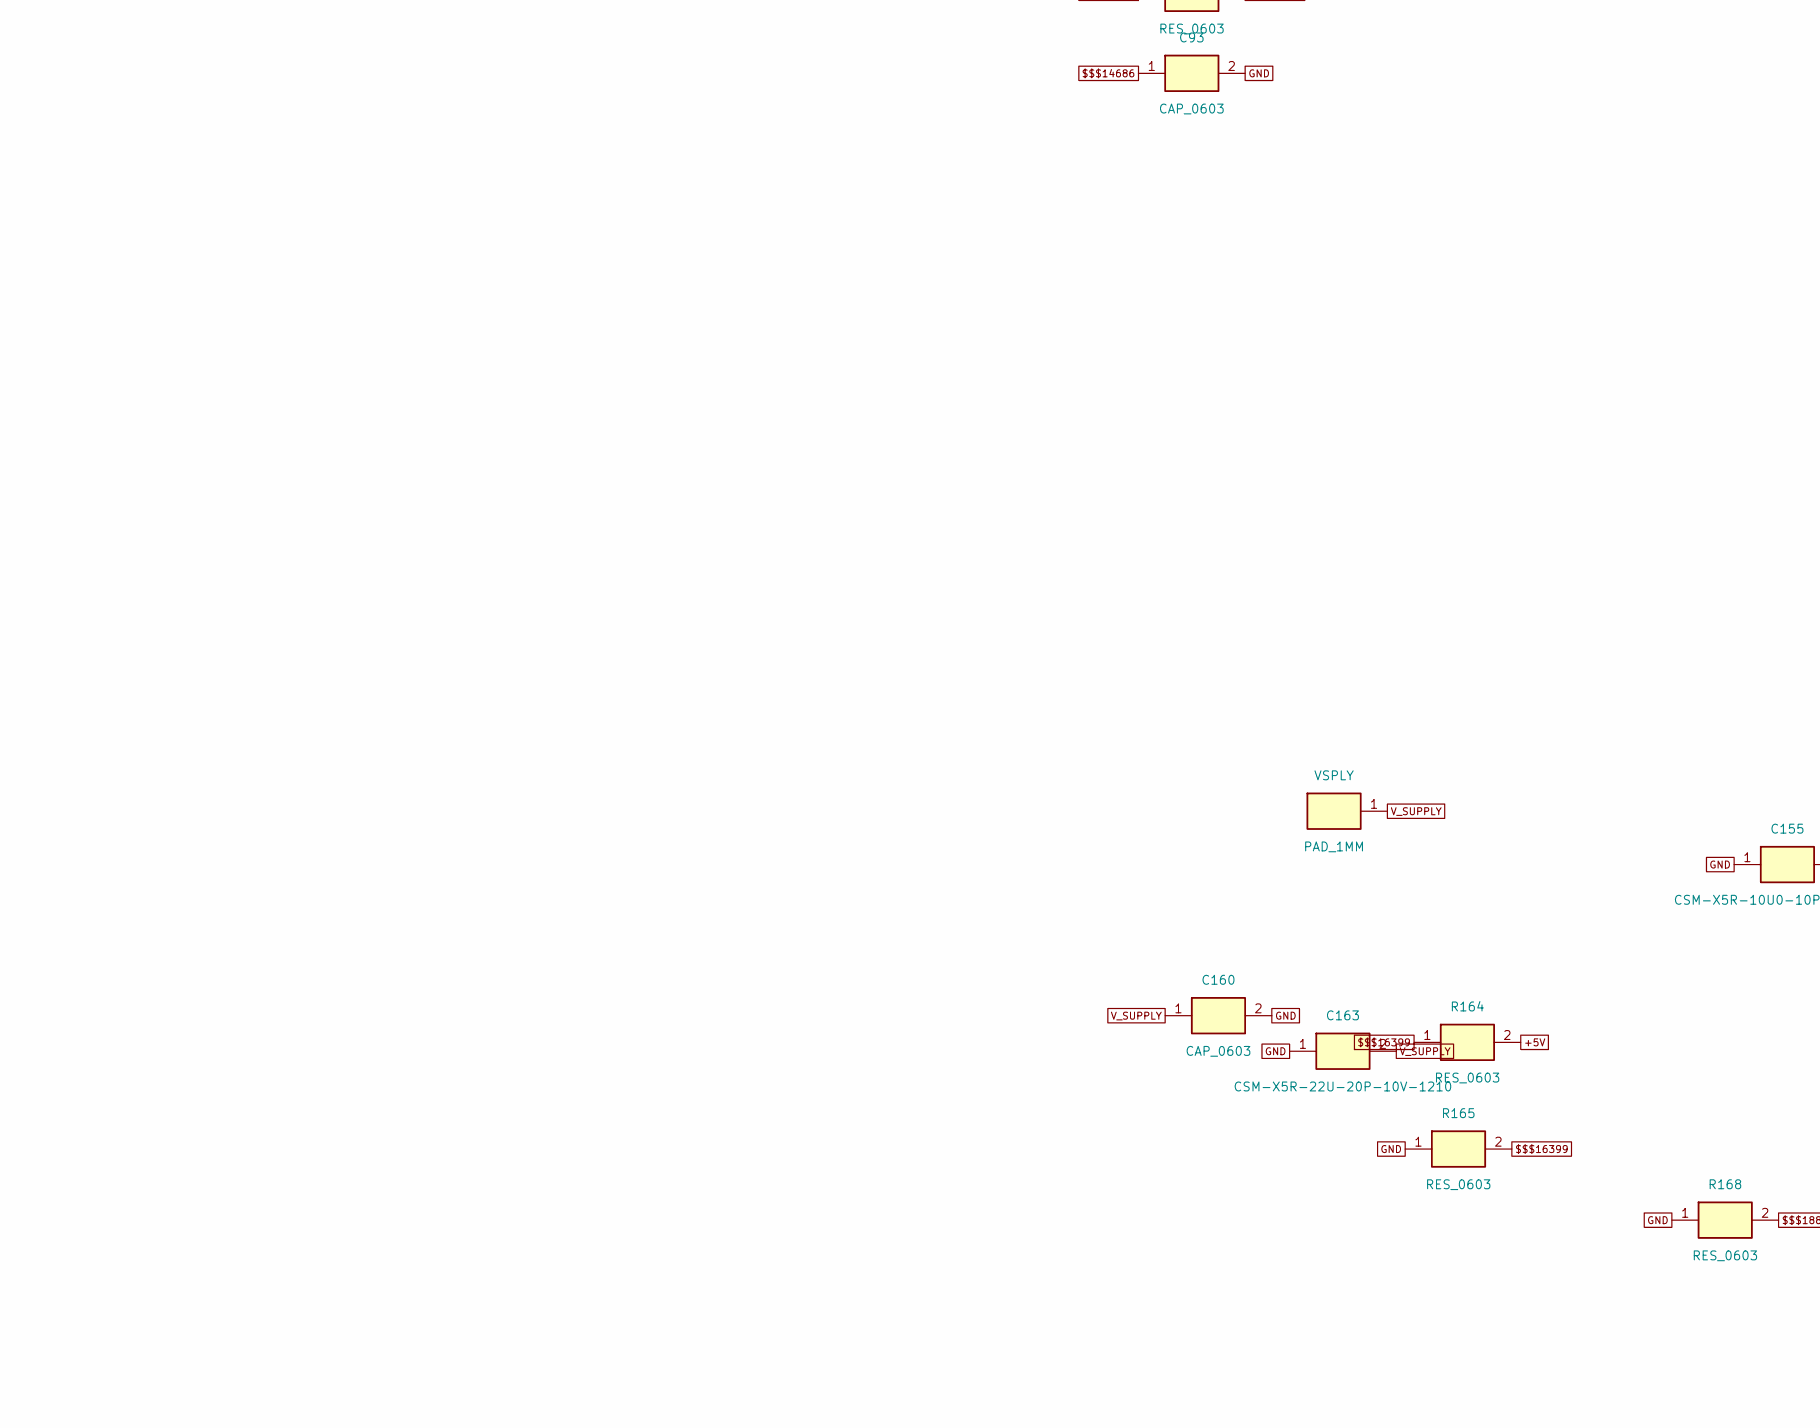
[picture p59: schematic PSDR_2.6.1-p08.kicad_sch, PSDR 2.6.1 - PDF page 8: Power, part in row 2, column 1]

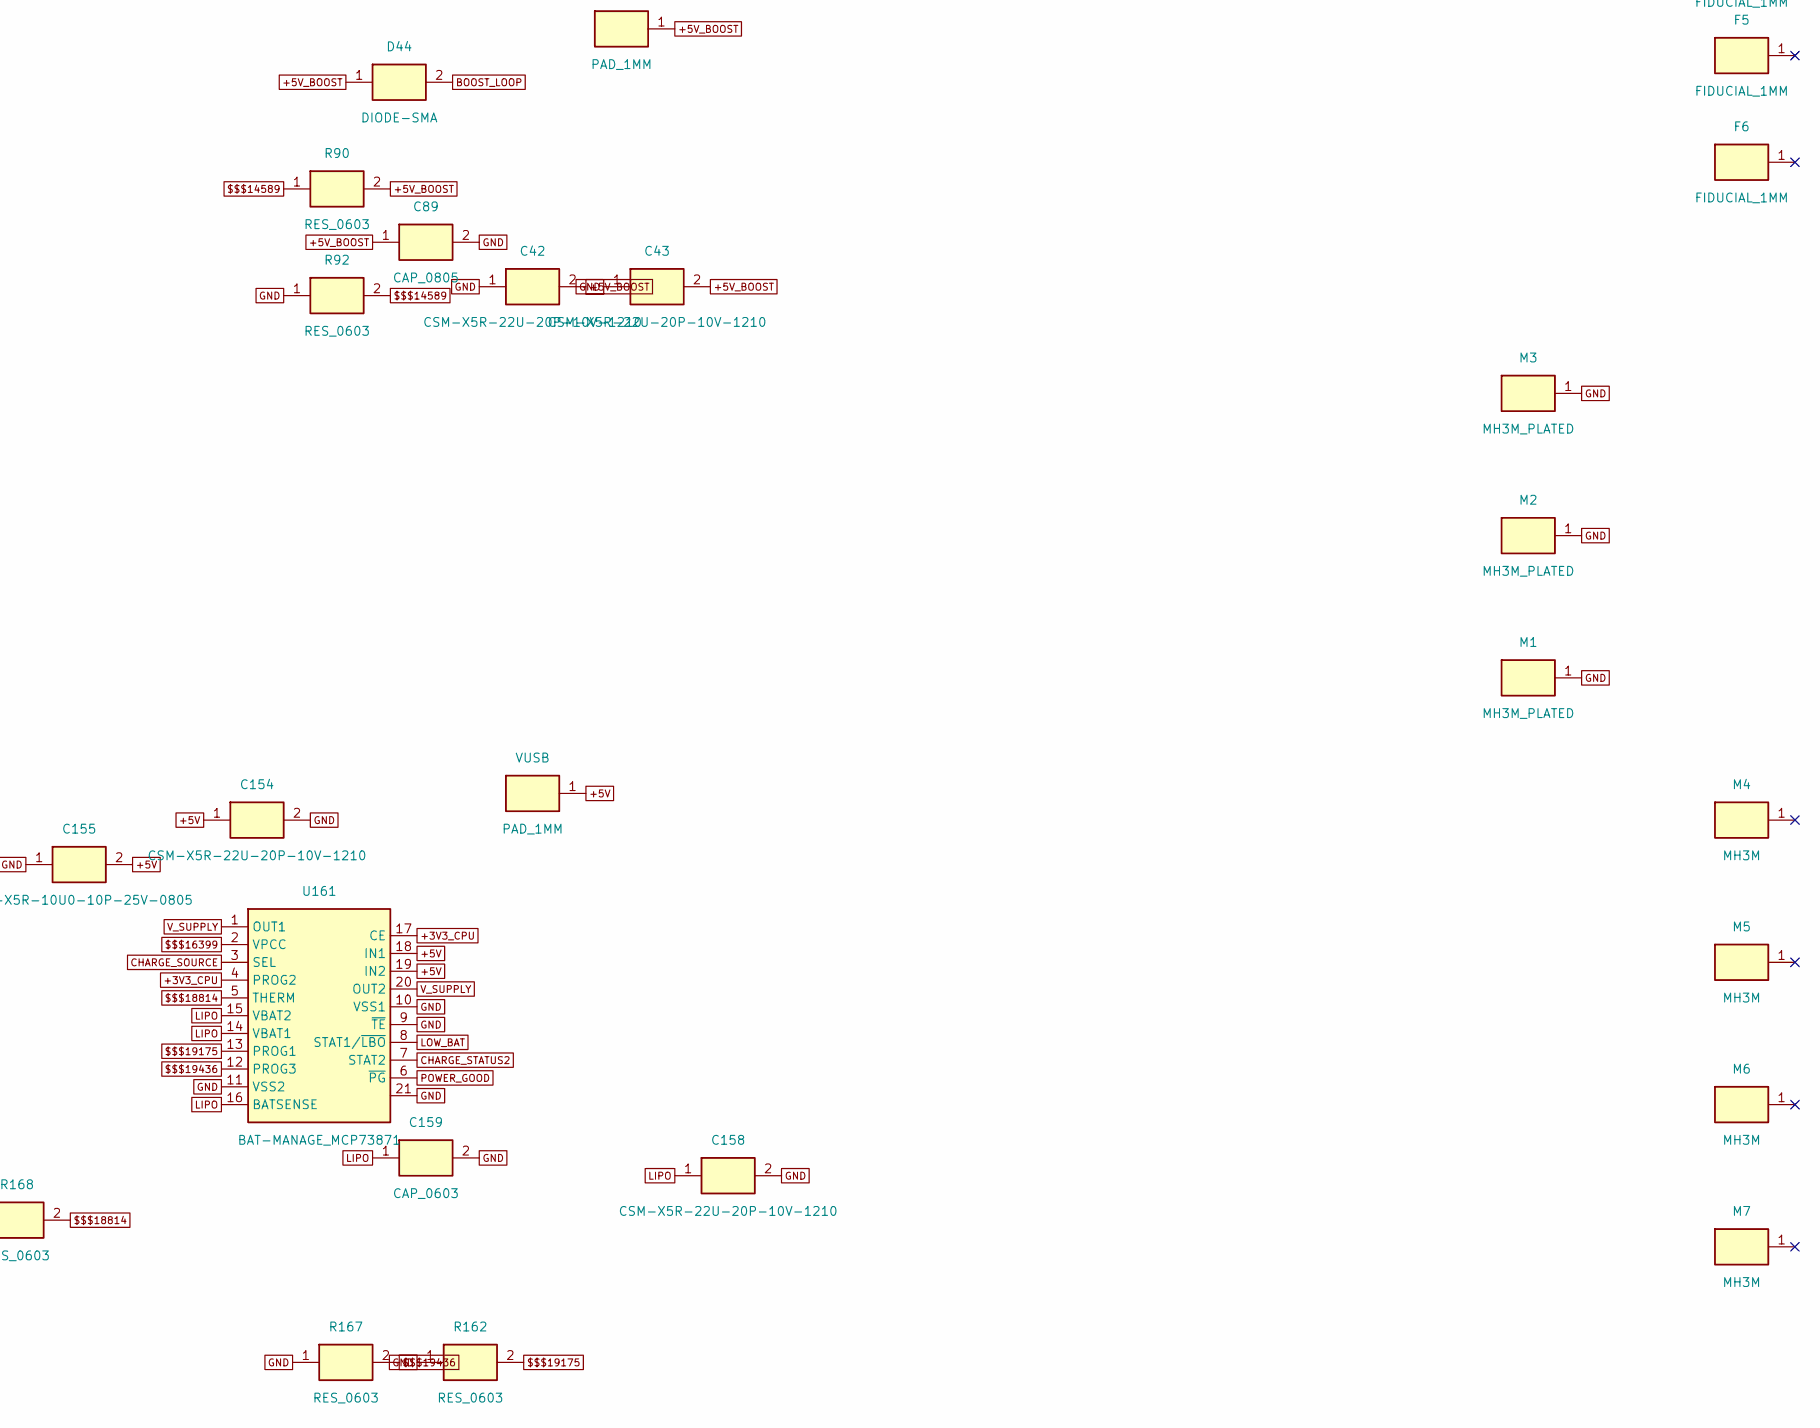
[picture p60: schematic PSDR_2.6.1-p08.kicad_sch, PSDR 2.6.1 - PDF page 8: Power, part in row 2, column 2]

Parts:
3V3A, 3V3D, 5VBST: PAD_1MM
C42, C43, C154, C158, C163: CSM-X5R-22U-20P-10V-1210
C83: CSM-X5R-10U0-10P-10V-0805
C89, C103, C104, C106, C107, C108: CAP_0805
C91, C93, C115, C159, C160, C171, C173: CAP_0603
C155: CSM-X5R-10U0-10P-25V-0805
D44: DIODE-SMA
F1, F2, F3, F4, F5, F6: FIDUCIAL_1MM
L84: IND_4.7UH_SMT_CDRH4D28CNP-4R7PC; IND_4_7UH_SMT_CDRH4D28CNP-4R7PC
L105: ISM-0805-10U
L109: 2U2H_INDUCTOR_NR6028T2R2N
M1, M2, M3: MH3M_PLATED
M4, M5, M6, M7: MH3M
R90, R92, R94, R112, R113, R162, R164, R165, R167, R168, R174, R175: RES_0603
U85: BOOST_REG_ADP1613
U114: BUCK_REGULATOR_AP3417C
U161: BAT-MANAGE_MCP73871
U172: 3V3_LDO_MCP1802
VSPLY: PAD_1MM
VUSB: PAD_1MM

Connections:
5V_REG_ENABLE: U85.3 (EN); also elsewhere on the board
$$$14589: R90.1, R92.2, U85.2 (FB)
$$$14676: C91.1, U85.8 (SS)
$$$14686: C93.1, R94.1
$$$14690: R94.2, U85.1 (COMP)
$$$16399: R164.1, R165.2, U161.2 (VPCC)
$$$18814: R168.2, U161.5 (THERM)
$$$19175: R162.2, U161.13 (PROG1)
$$$19436: R167.2, U161.12 (PROG3)
$$$24763: R112.1, R113.2, U114.5 (FB)
$$$24779: L109.2, U114.3 (LX)
+3V3: 3V3A.1, C103.1, C104.1, L105.1; also elsewhere on the board
+3V3_CPU: 3V3D.1, C106.1, C107.1, C108.1, L105.2, L109.1, R113.1, U161.4 (PROG2), U161.17 (CE); also elsewhere on the board
+5V: C154.1, C155.2, R164.2, U161.18 (IN1), U161.19 (IN2), VUSB.1; also elsewhere on the board
+5V_BOOST: 5VBST.1, C42.2, C43.2, C89.1, D44.1, R90.2; also elsewhere on the board
BOOST_LOOP: D44.2, L84.2, U85.5 (SW)
CHARGE_SOURCE: U161.3 (SEL); also elsewhere on the board
CHARGE_STATUS2: U161.7 (STAT2); also elsewhere on the board
GND: C42.1, C43.1, C83.2, C89.2, C91.2, C93.2, C103.2, C104.2, C106.2, C107.2, C108.2, C115.2, C154.2, C155.1, C158.2, C159.2, C160.2, C163.1, C171.2, C173.2, M1.1, M2.1, M3.1, R92.1, R112.2, R162.1, R165.1, R167.1, R168.1, R175.1, U85.4 (GND), U85.7 (FREQ), U114.2 (GND), U161.9 (~TE), U161.10 (VSS1), U161.11 (VSS2), U161.21, U172.2 (VSS); also elsewhere on the board
LIPO: C158.1, C159.1, C171.1, R174.2, U161.14 (VBAT1), U161.15 (VBAT2), U161.16 (BATSENSE), U172.1 (VIN), U172.3 (~SHDN); also elsewhere on the board
LIPO_V: R174.1, R175.2; also elsewhere on the board
LOW_BAT: U161.8 (STAT1/~LBO); also elsewhere on the board
POWER_GOOD: U161.6 (~PG); also elsewhere on the board
VBAT_BKP: C173.1, U172.5 (VOUT); also elsewhere on the board
V_SUPPLY: C83.1, C115.1, C160.1, C163.2, L84.1, U85.6 (VIN), U114.1 (EN), U114.4 (VIN), U161.1 (OUT1), U161.20 (OUT2), VSPLY.1

Notes on the sheet:
Generated from PADS ASCII. Net names are labels, not drawn wires. Original drawing: PSDR_2.6.1_Schematic_2016-07-31.pdf page 8.
