fe1iscurc0r/PSDR/dist/kicad/PSDR_2.6.1_revB.kicad_pcb

## KiCad design dist/kicad/PSDR_2.6.1_revB.kicad_pcb (continued)

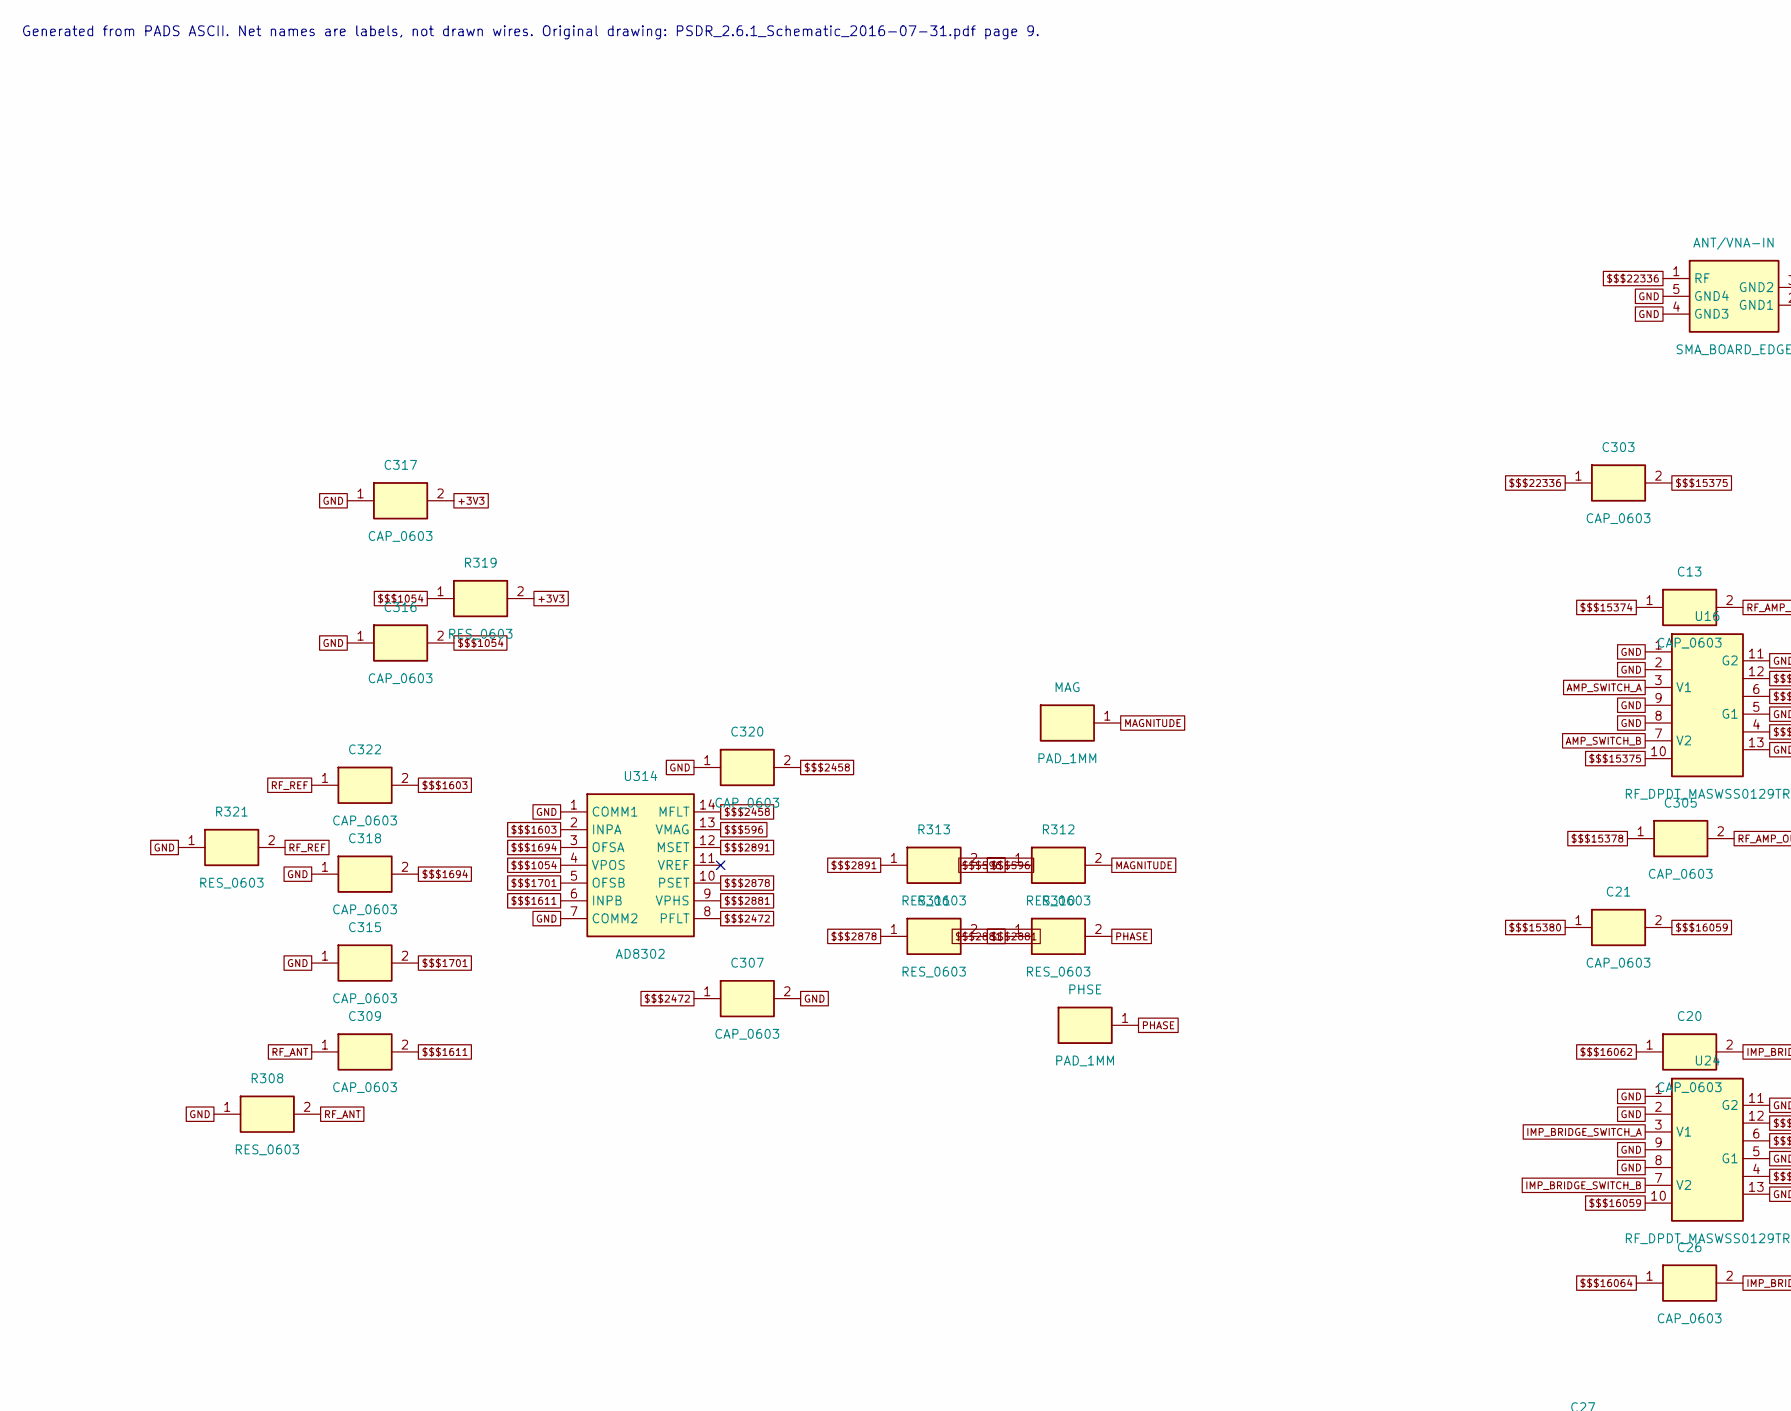
[picture p61: schematic PSDR_2.6.1-p09.kicad_sch, PSDR 2.6.1 - PDF page 9: RF front end, part in row 1, column 1]

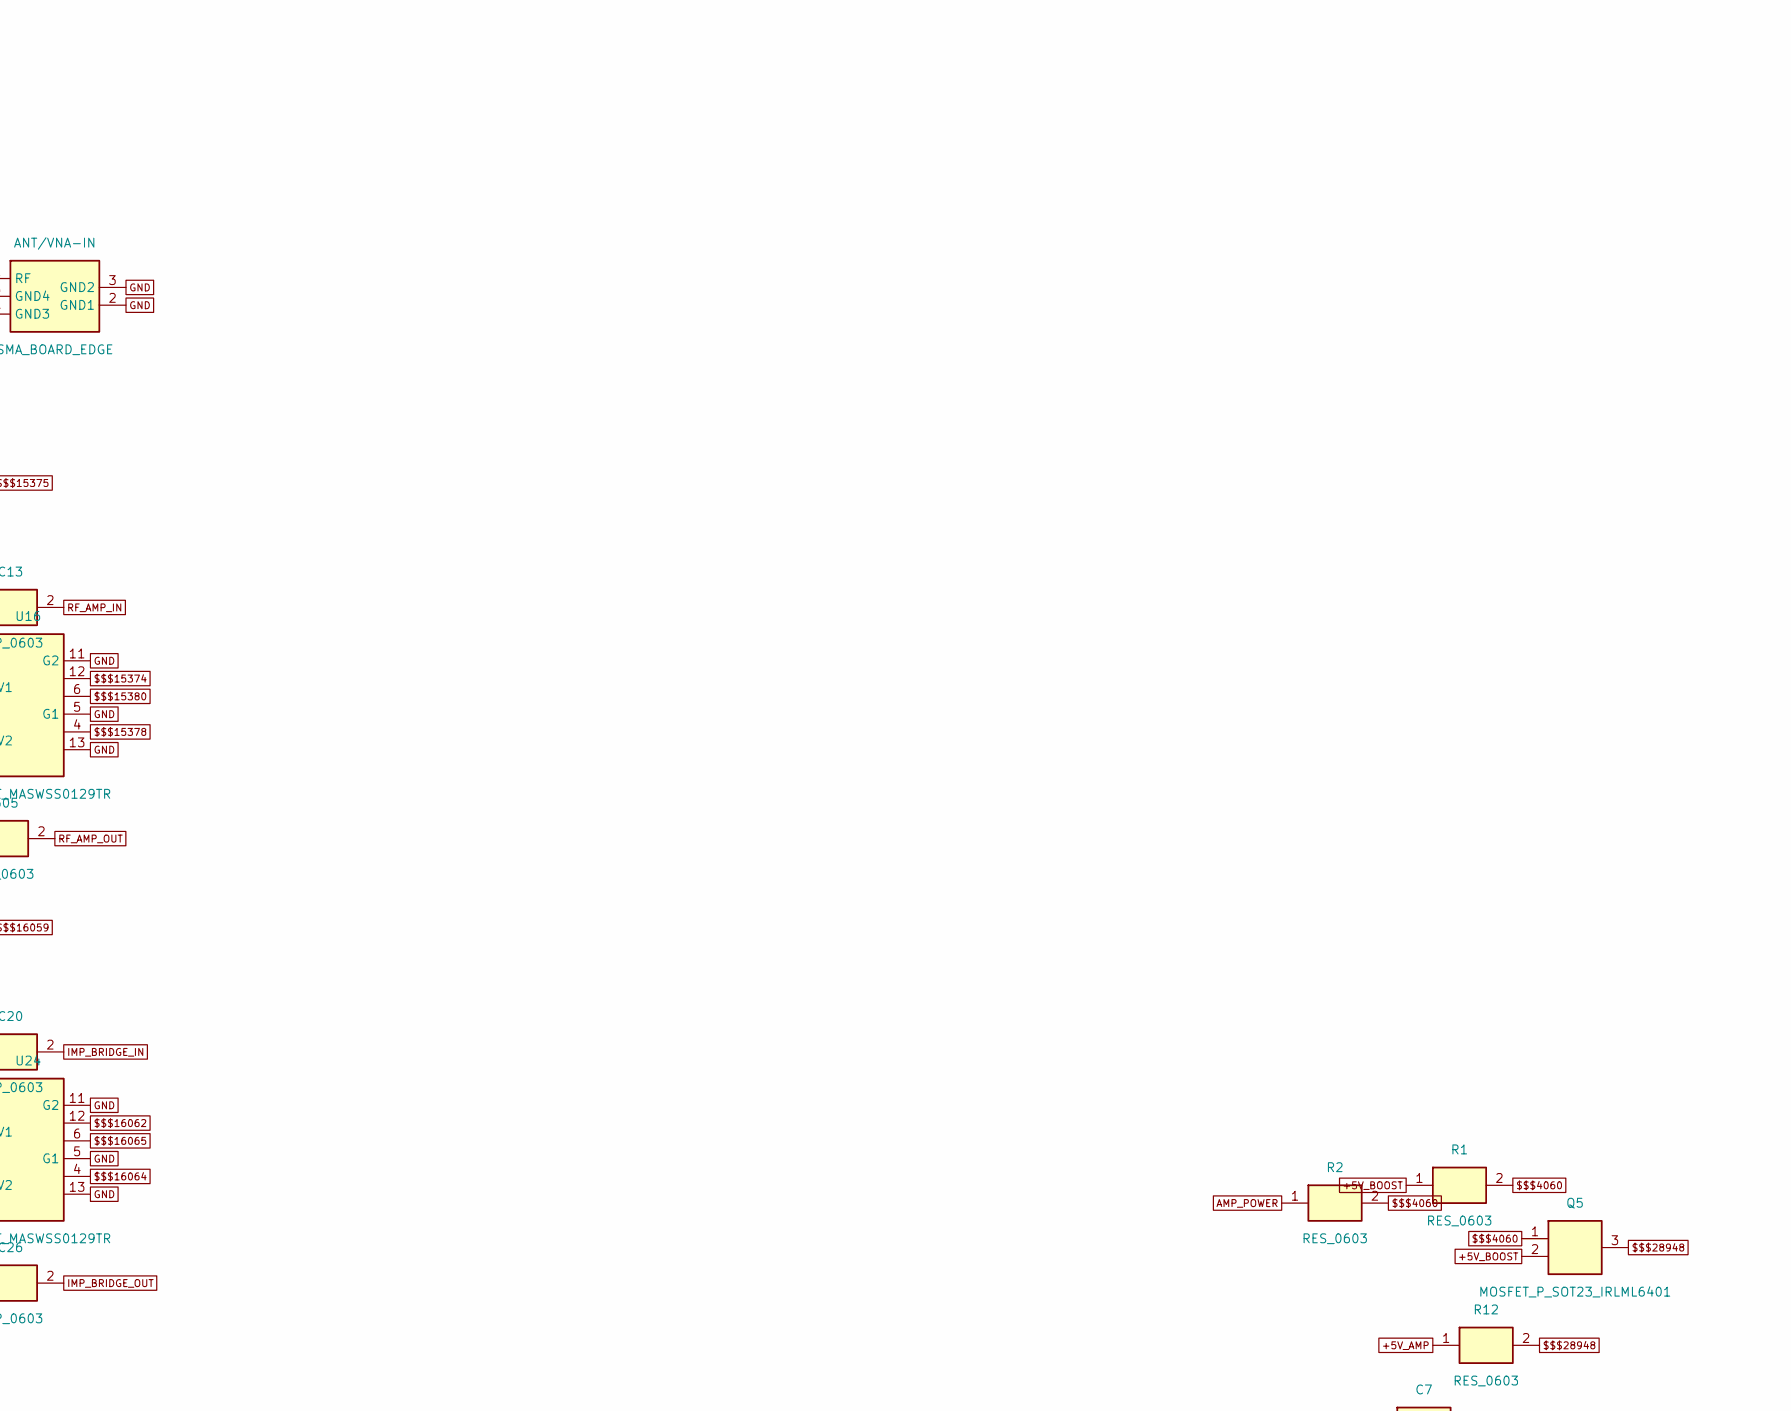
[picture p62: schematic PSDR_2.6.1-p09.kicad_sch, PSDR 2.6.1 - PDF page 9: RF front end, part in row 1, column 2]

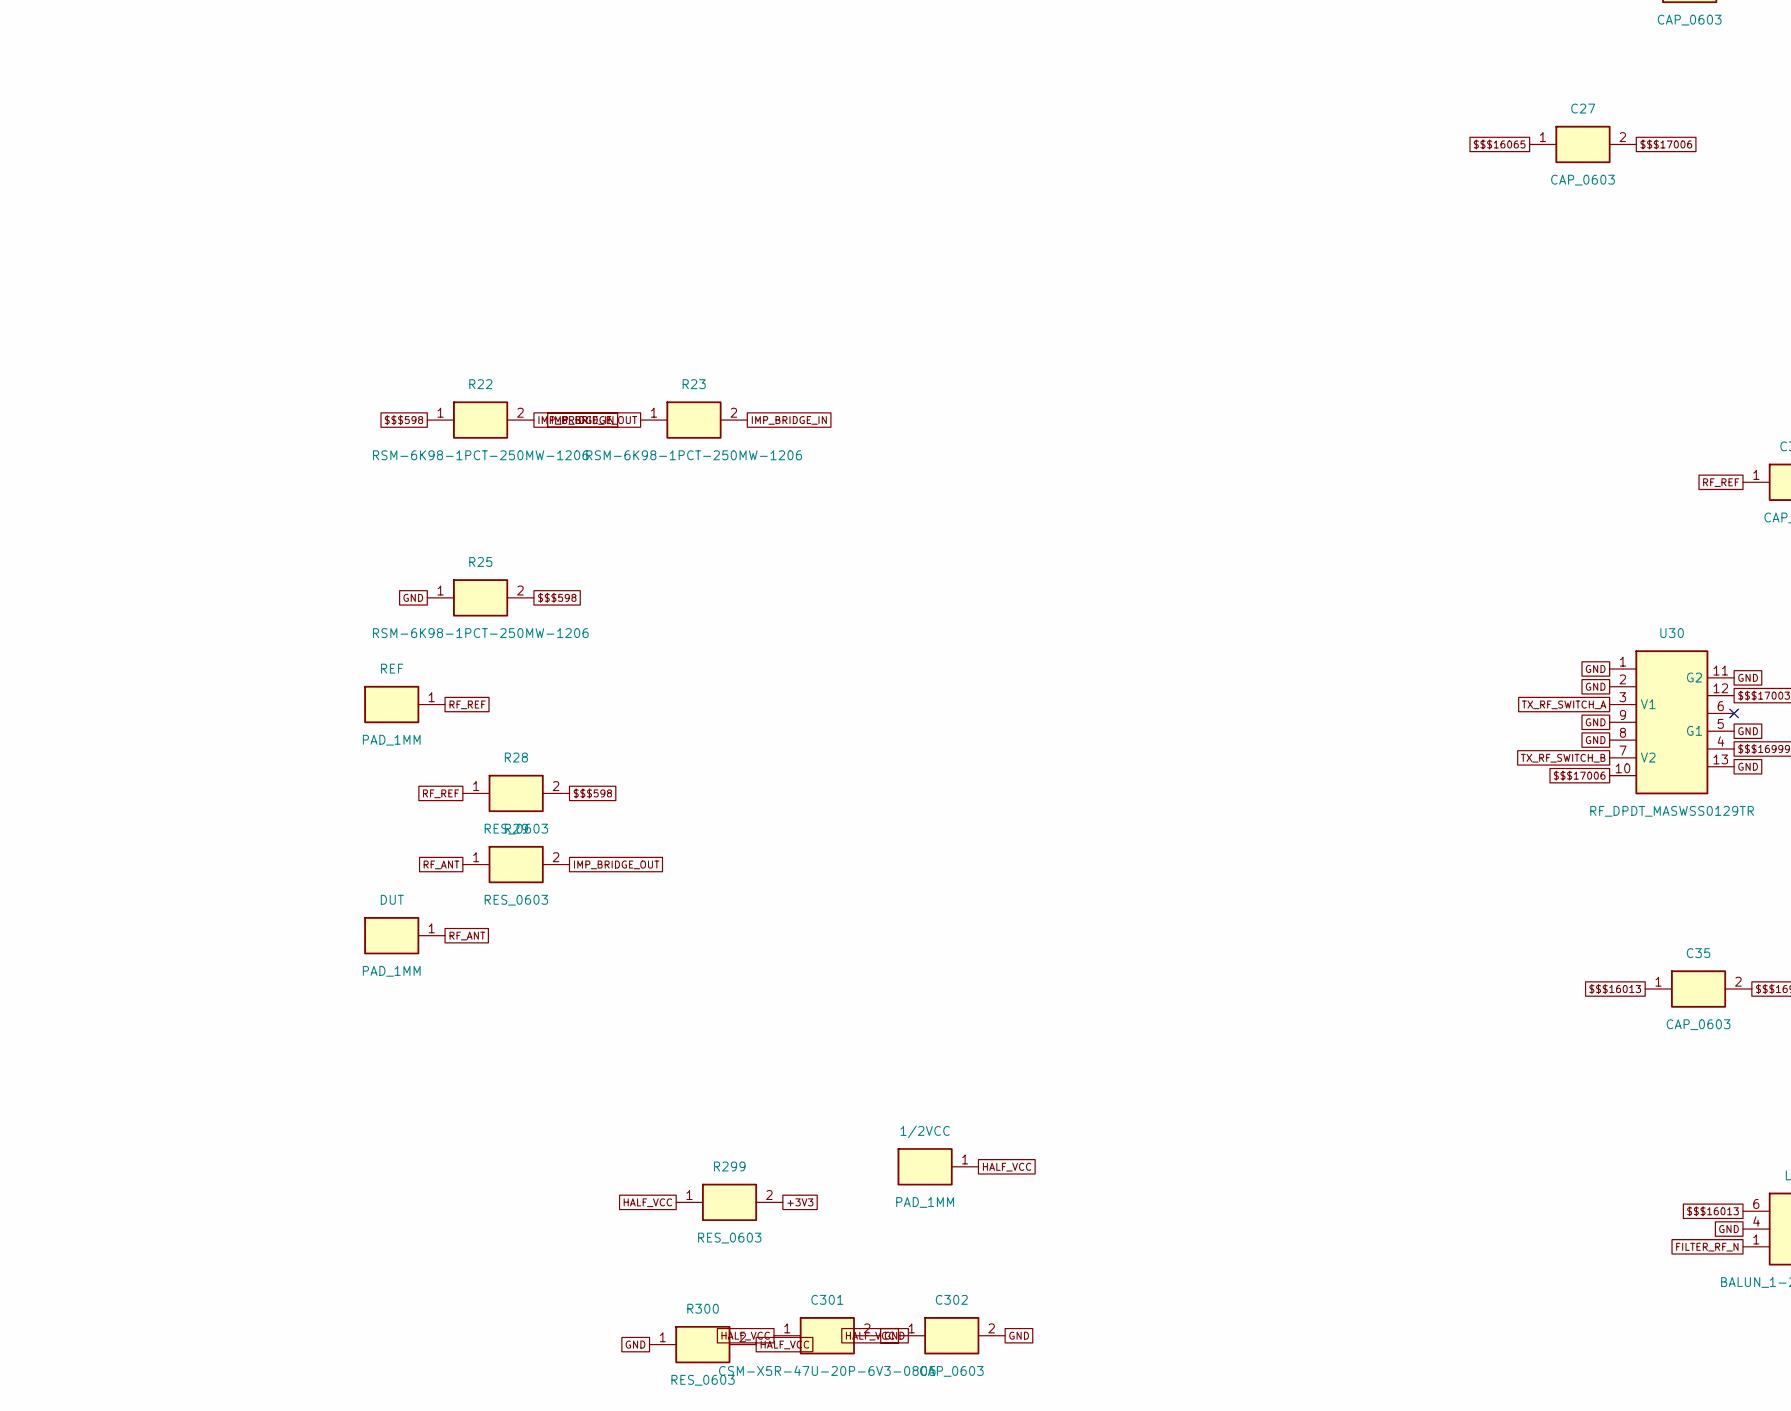
[picture p63: schematic PSDR_2.6.1-p09.kicad_sch, PSDR 2.6.1 - PDF page 9: RF front end, part in row 2, column 1]

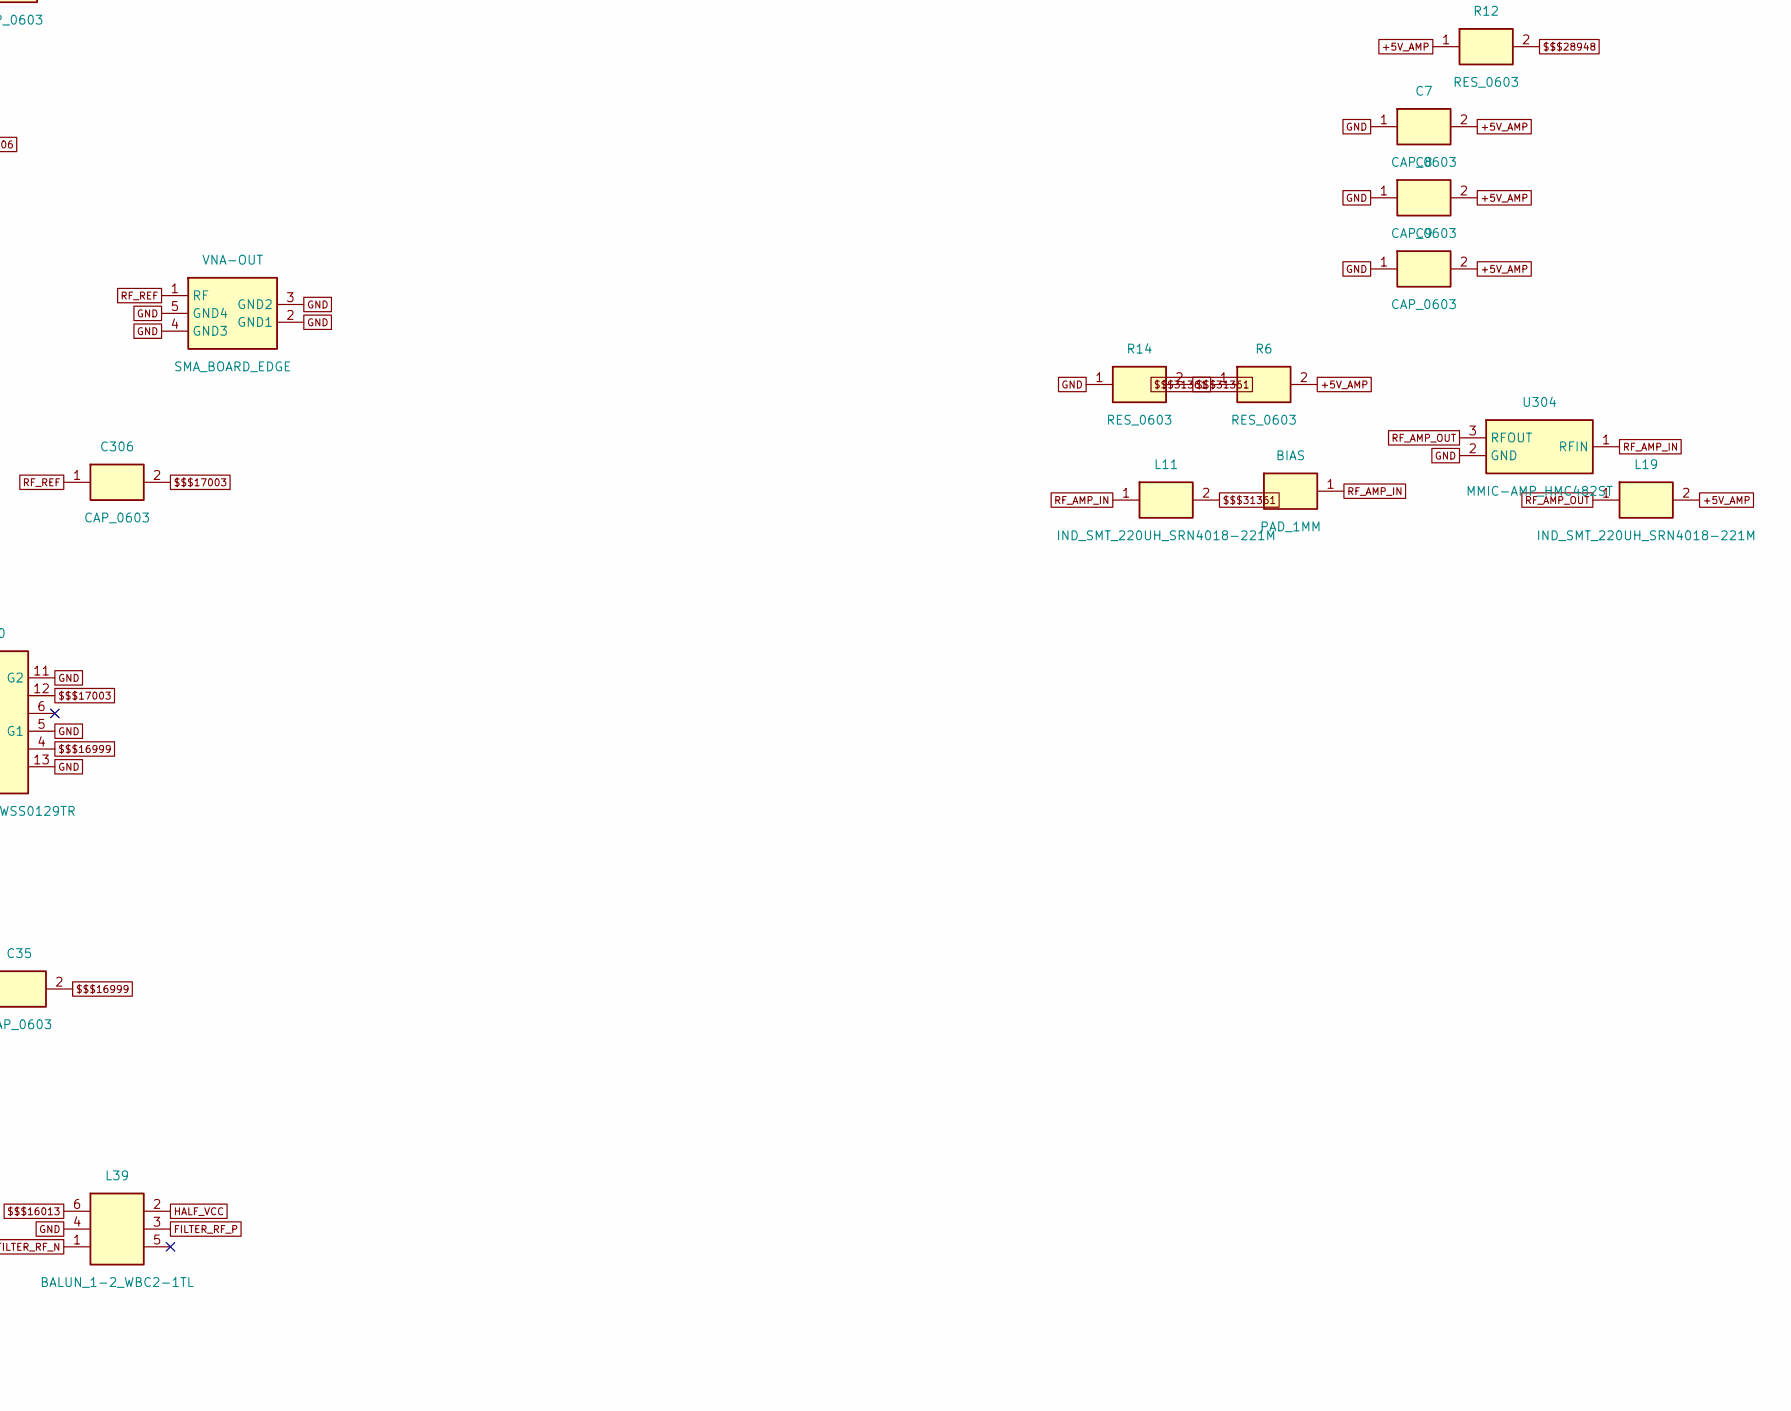
[picture p64: schematic PSDR_2.6.1-p09.kicad_sch, PSDR 2.6.1 - PDF page 9: RF front end, part in row 2, column 2]

Parts:
1/2VCC: PAD_1MM
ANT/VNA-IN: SMA_BOARD_EDGE
BIAS: PAD_1MM
C7, C8, C9, C13, C20, C21, C26, C27, C35, C302, C303, C305, C306, C307, C309, C315, C316, C317, C318, C320, C322: CAP_0603
C301: CSM-X5R-47U-20P-6V3-0805
DUT: PAD_1MM
L11, L19: IND_SMT_220UH_SRN4018-221M
L39: BALUN_1-2_WBC2-1TL
MAG: PAD_1MM
PHSE: PAD_1MM
Q5: MOSFET_P_SOT23_IRLML6401
R1, R2, R6, R12, R14, R28, R29, R299, R300, R308, R310, R311, R312, R313, R319, R321: RES_0603
R22, R23, R25: RSM-6K98-1PCT-250MW-1206
REF: PAD_1MM
U16, U24, U30: RF_DPDT_MASWSS0129TR
U304: MMIC-AMP_HMC482ST
U314: AD8302
VNA-OUT: SMA_BOARD_EDGE

Connections:
$$$596: R312.1, R313.2, U314.13 (VMAG)
$$$598: R22.1, R25.2, R28.2
$$$1054: C316.2, R319.1, U314.4 (VPOS)
$$$1603: C322.2, U314.2 (INPA)
$$$1611: C309.2, U314.6 (INPB)
$$$1694: C318.2, U314.3 (OFSA)
$$$1701: C315.2, U314.5 (OFSB)
$$$2458: C320.2, U314.14 (MFLT)
$$$2472: C307.1, U314.8 (PFLT)
$$$2878: R311.1, U314.10 (PSET)
$$$2881: R310.1, R311.2, U314.9 (VPHS)
$$$2891: R313.1, U314.12 (MSET)
$$$4060: Q5.1, R1.2, R2.2
$$$15374: C13.1, U16.12
$$$15375: C303.2, U16.10
$$$15378: C305.1, U16.4
$$$15380: C21.1, U16.6
$$$16013: C35.1, L39.6
$$$16059: C21.2, U24.10
$$$16062: C20.1, U24.12
$$$16064: C26.1, U24.4
$$$16065: C27.1, U24.6
$$$16999: C35.2, U30.4
$$$17003: C306.2, U30.12
$$$17006: C27.2, U30.10
$$$22336: ANT/VNA-IN.1 (RF), C303.1
$$$28948: Q5.3, R12.2
$$$31361: L11.2, R6.1, R14.2
+3V3: C317.2, R299.2, R319.2; also elsewhere on the board
+5V_AMP: C7.2, C8.2, C9.2, L19.2, R6.2, R12.1
+5V_BOOST: Q5.2, R1.1; also elsewhere on the board
AMP_POWER: R2.1; also elsewhere on the board
AMP_SWITCH_A: U16.3 (V1); also elsewhere on the board
AMP_SWITCH_B: U16.7 (V2); also elsewhere on the board
FILTER_RF_N: L39.1; also elsewhere on the board
FILTER_RF_P: L39.3; also elsewhere on the board
GND: ANT/VNA-IN.2 (GND1), ANT/VNA-IN.3 (GND2), ANT/VNA-IN.4 (GND3), ANT/VNA-IN.5 (GND4), C7.1, C8.1, C9.1, C301.2, C302.2, C307.2, C315.1, C316.1, C317.1, C318.1, C320.1, L39.4, R14.1, R25.1, R300.1, R308.1, R321.1, U16.1, U16.2, U16.5 (G1), U16.8, U16.9, U16.11 (G2), U16.13, U24.1, U24.2, U24.5 (G1), U24.8, U24.9, U24.11 (G2), U24.13, U30.1, U30.2, U30.5 (G1), U30.8, U30.9, U30.11 (G2), U30.13, U304.2 (GND), U314.1 (COMM1), U314.7 (COMM2), VNA-OUT.2 (GND1), VNA-OUT.3 (GND2), VNA-OUT.4 (GND3), VNA-OUT.5 (GND4); also elsewhere on the board
HALF_VCC: 1/2VCC.1, C301.1, C302.1, L39.2, R299.1, R300.2; also elsewhere on the board
IMP_BRIDGE_IN: C20.2, R22.2, R23.2
IMP_BRIDGE_OUT: C26.2, R23.1, R29.2
IMP_BRIDGE_SWITCH_A: U24.3 (V1); also elsewhere on the board
IMP_BRIDGE_SWITCH_B: U24.7 (V2); also elsewhere on the board
MAGNITUDE: MAG.1, R312.2; also elsewhere on the board
PHASE: PHSE.1, R310.2; also elsewhere on the board
RF_AMP_IN: BIAS.1, C13.2, L11.1, U304.1 (RFIN)
RF_AMP_OUT: C305.2, L19.1, U304.3 (RFOUT)
RF_ANT: C309.1, DUT.1, R29.1, R308.2
RF_REF: C306.1, C322.1, R28.1, R321.2, REF.1, VNA-OUT.1 (RF)
TX_RF_SWITCH_A: U30.3 (V1); also elsewhere on the board
TX_RF_SWITCH_B: U30.7 (V2); also elsewhere on the board

Notes on the sheet:
Generated from PADS ASCII. Net names are labels, not drawn wires. Original drawing: PSDR_2.6.1_Schematic_2016-07-31.pdf page 9.

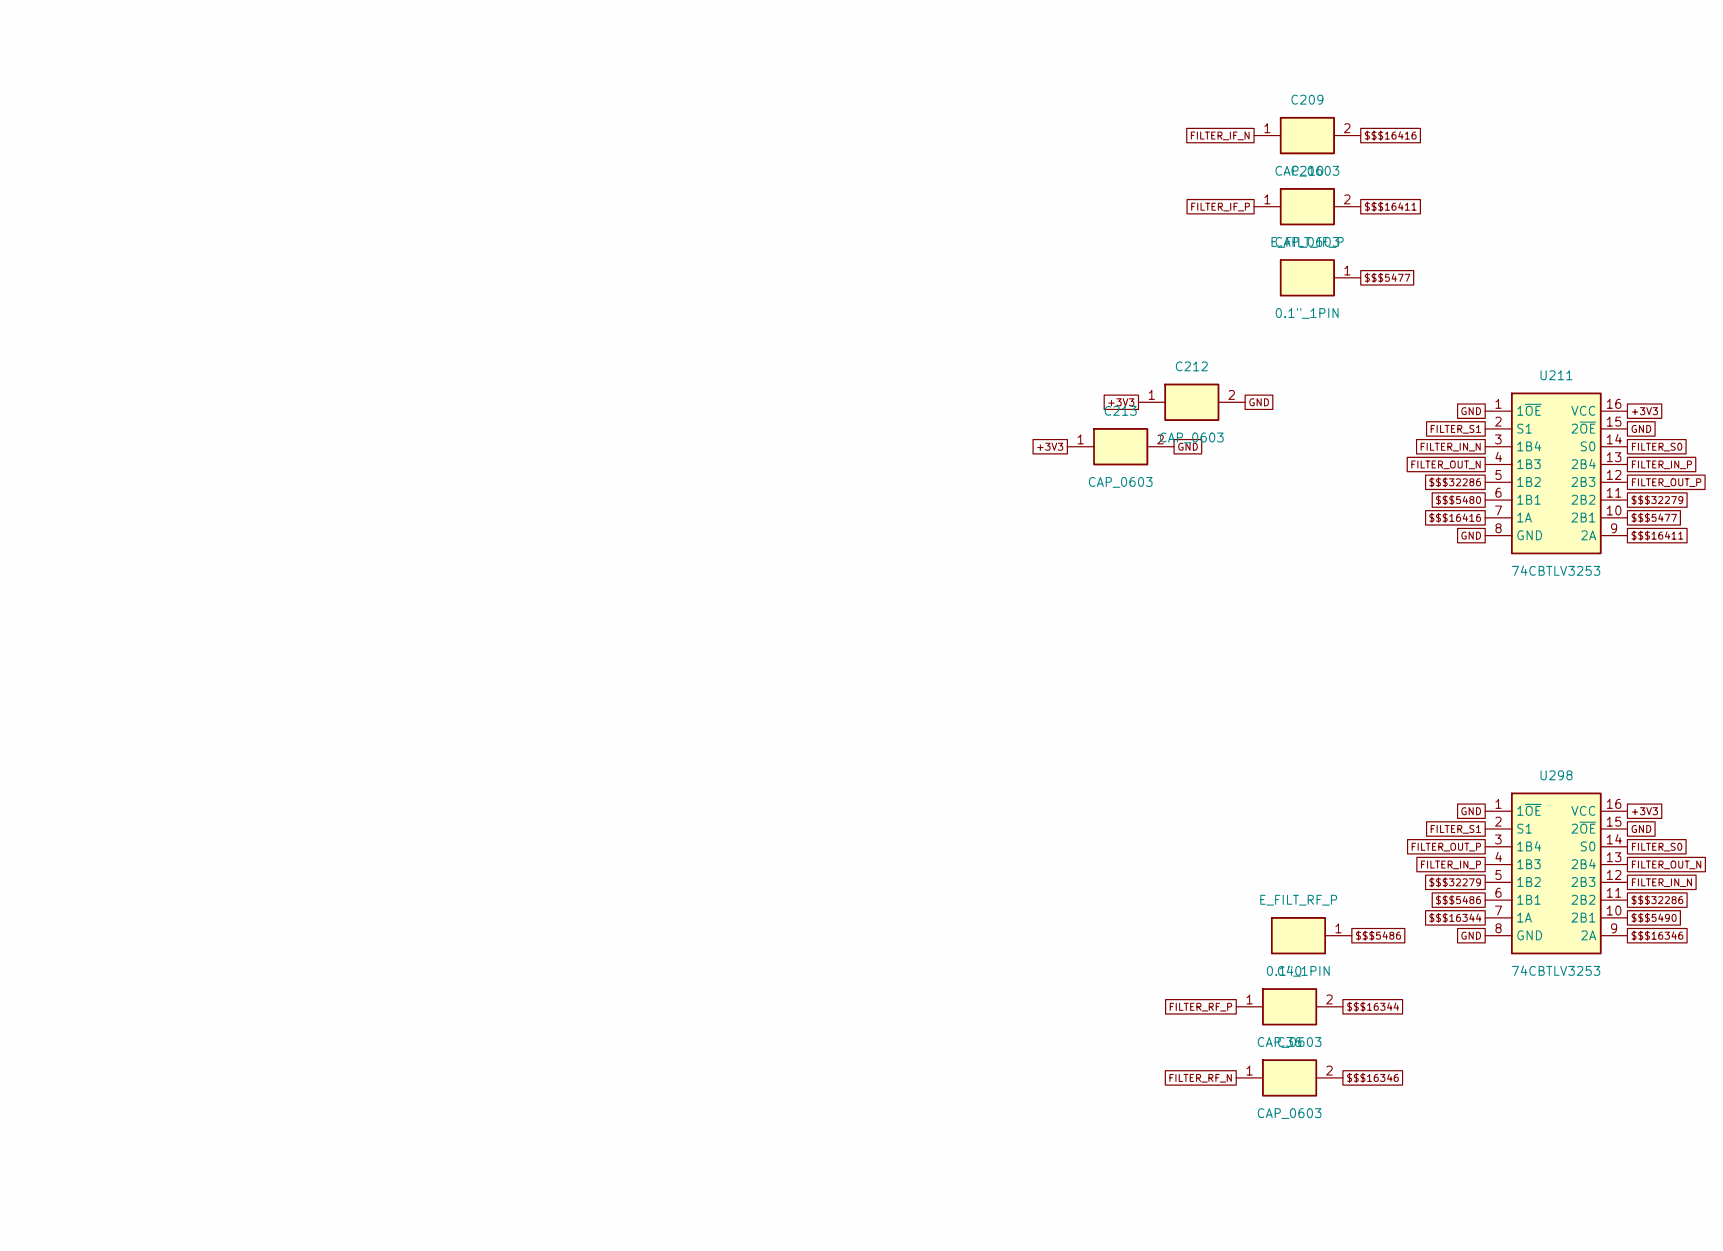
[picture p65: schematic PSDR_2.6.1-p10.kicad_sch, PSDR 2.6.1 - PDF page 10: Variable filter, part in row 2, column 1]

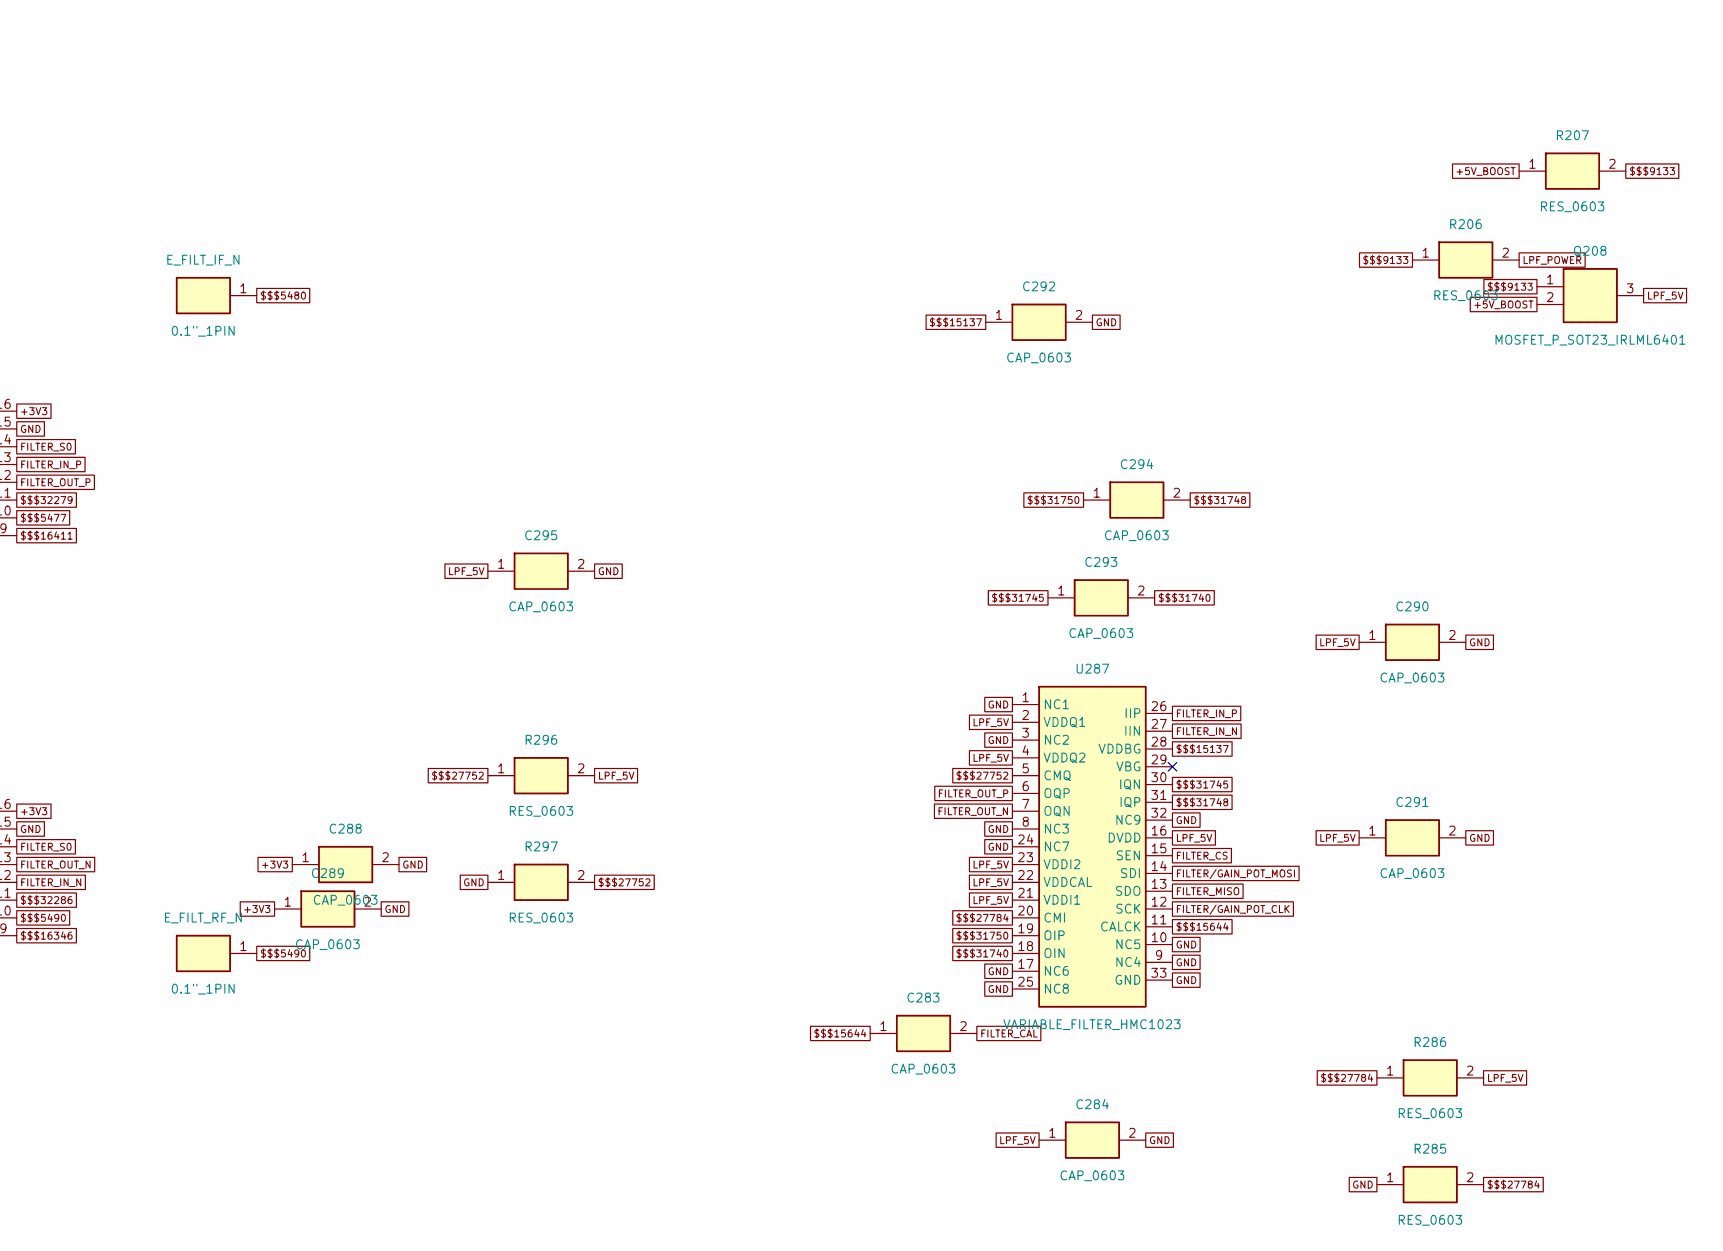
[picture p66: schematic PSDR_2.6.1-p10.kicad_sch, PSDR 2.6.1 - PDF page 10: Variable filter, part in row 2, column 2]

Parts:
C36, C40, C209, C210, C212, C213, C283, C284, C288, C289, C290, C291, C292, C293, C294, C295: CAP_0603
E_FILT_IF_N: 0.1"_1PIN; 0_1__1PIN
E_FILT_IF_P: 0.1"_1PIN; 0_1__1PIN
E_FILT_RF_N: 0.1"_1PIN; 0_1__1PIN
E_FILT_RF_P: 0.1"_1PIN; 0_1__1PIN
Q208: MOSFET_P_SOT23_IRLML6401
R206, R207, R285, R286, R296, R297: RES_0603
U211, U298: 74CBTLV3253
U287: VARIABLE_FILTER_HMC1023

Connections:
$$$5477: E_FILT_IF_P.1, U211.10 (2B1)
$$$5480: E_FILT_IF_N.1, U211.6 (1B1)
$$$5486: E_FILT_RF_P.1, U298.6 (1B1)
$$$5490: E_FILT_RF_N.1, U298.10 (2B1)
$$$9133: Q208.1, R206.1, R207.2
$$$15644: C283.1, U287.11 (CALCK)
$$$16344: C40.2, U298.7 (1A)
$$$16346: C36.2, U298.9 (2A)
$$$16411: C210.2, U211.9 (2A)
$$$16416: C209.2, U211.7 (1A)
$$$27752: R296.1, R297.2, U287.5 (CMQ)
$$$27784: R285.2, R286.1, U287.20 (CMI)
$$$31740: C293.2, U287.18 (OIN)
$$$31745: C293.1, U287.30 (IQN)
$$$31748: C294.2, U287.31 (IQP)
$$$31750: C294.1, U287.19 (OIP)
$$$32279: U211.11 (2B2), U298.5 (1B2)
$$$32286: U211.5 (1B2), U298.11 (2B2)
+3V3: C212.1, C213.1, C288.1, C289.1, U211.16 (VCC), U298.16 (VCC); also elsewhere on the board
+5V_BOOST: Q208.2, R207.1; also elsewhere on the board
FILTER/GAIN_POT_CLK: U287.12 (SCK); also elsewhere on the board
FILTER/GAIN_POT_MOSI: U287.14 (SDI); also elsewhere on the board
FILTER_CAL: C283.2; also elsewhere on the board
FILTER_CS: U287.15 (SEN); also elsewhere on the board
FILTER_IF_N: C209.1; also elsewhere on the board
FILTER_IF_P: C210.1; also elsewhere on the board
FILTER_IN_N: U211.3 (1B4), U287.27 (IIN), U298.12 (2B3)
FILTER_IN_P: U211.13 (2B4), U287.26 (IIP), U298.4 (1B3)
FILTER_MISO: U287.13 (SDO); also elsewhere on the board
FILTER_OUT_N: U211.4 (1B3), U287.7 (OQN), U298.13 (2B4)
FILTER_OUT_P: U211.12 (2B3), U287.6 (OQP), U298.3 (1B4)
FILTER_RF_N: C36.1; also elsewhere on the board
FILTER_RF_P: C40.1; also elsewhere on the board
FILTER_S0: U211.14 (S0), U298.14 (S0); also elsewhere on the board
FILTER_S1: U211.2 (S1), U298.2 (S1); also elsewhere on the board
GND: C212.2, C213.2, C284.2, C288.2, C289.2, C290.2, C291.2, C292.2, C295.2, R285.1, R297.1, U211.1 (1~OE), U211.8 (GND), U211.15 (2~OE), U287.1 (NC1), U287.3 (NC2), U287.8 (NC3), U287.9 (NC4), U287.10 (NC5), U287.17 (NC6), U287.24 (NC7), U287.25 (NC8), U287.32 (NC9), U287.33 (GND), U298.1 (1~OE), U298.8 (GND), U298.15 (2~OE); also elsewhere on the board
LPF_POWER: R206.2; also elsewhere on the board

Notes on the sheet:
Generated from PADS ASCII. Net names are labels, not drawn wires. Original drawing: PSDR_2.6.1_Schematic_2016-07-31.pdf page 10.

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
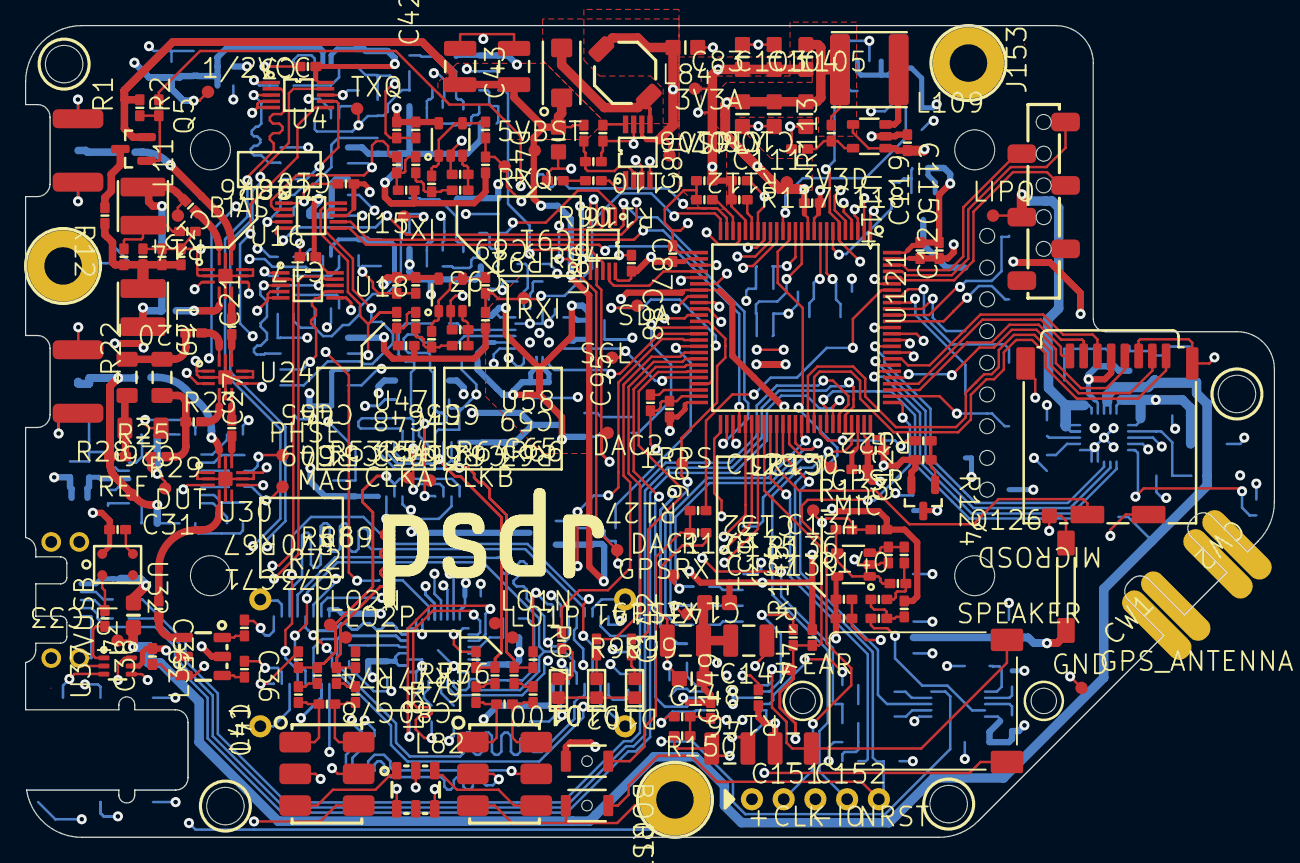
[picture p67: board PSDR_2.6.1_revB.kicad_pcb from above]

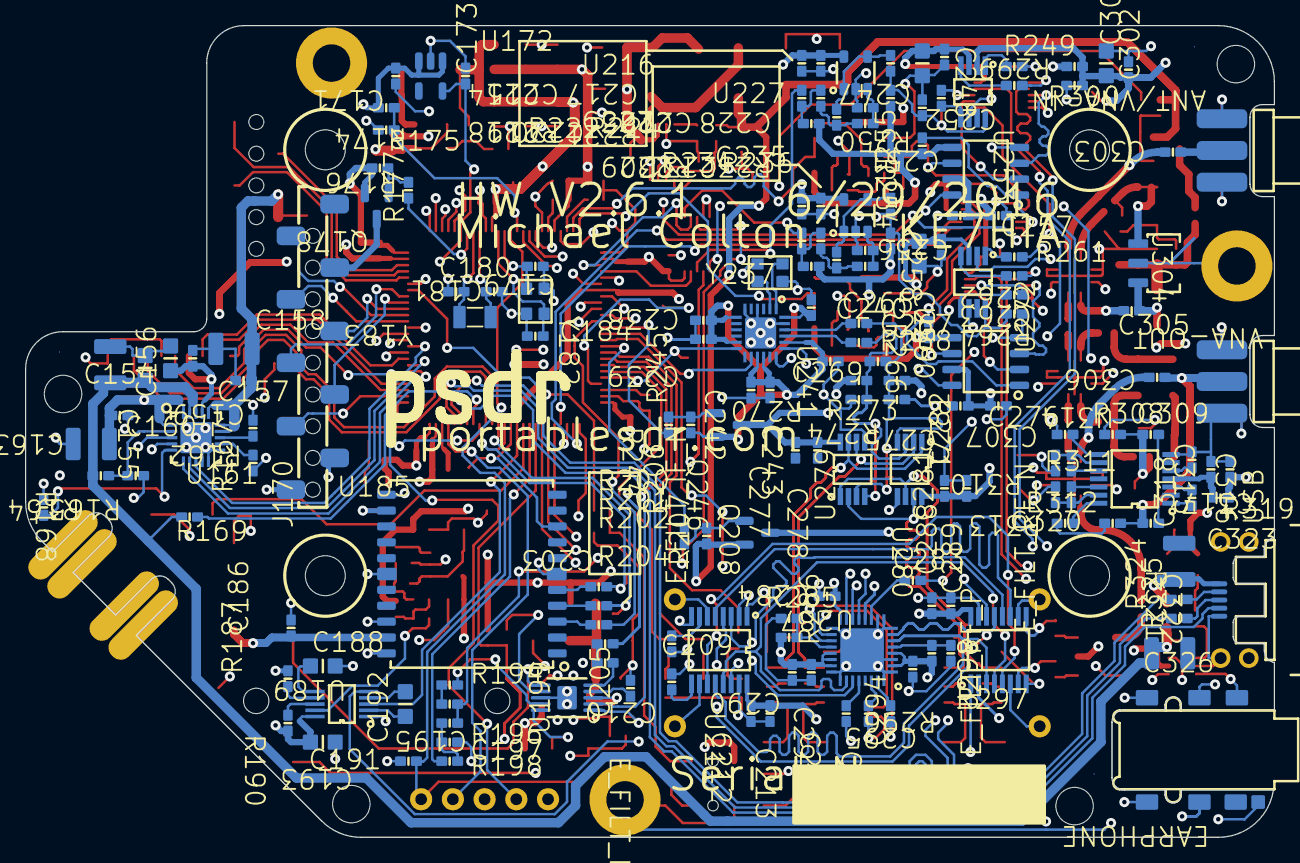
[picture p68: board PSDR_2.6.1_revB.kicad_pcb from below]

Board: 4 copper layers, 100.0 x 65.0 mm, 391 parts (182 on the bottom side), 277 nets.
