fe1iscurc0r/PSDR/(commit log)

2026-10-30 docs: PSDR 接手工单 + 评估报告 + 已验证构建脚本
    为 Qoder 执行的接手工单。内容:
    - docs/PSDR-TAKEOVER-WORKORDER-2026-10-30.md 工单正文 (天选7 完整克隆 /
    Linux 构建复现 / Eagle->KiCad 转换 / 交付归档)
    - docs/PSDR-TAKEOVER-EVALUATION-2026-10-30.md 接手评估报告
    - docs/psdr-handoff/Makefile.linux 已验证可编译的 Linux 构建脚本
    - docs/psdr-handoff/PATCH-NOTES.md 4 处上游构建缺陷的最小修复说明
    工单内含已实测的构建坑位与二进制锚点验收脚本 (_estack=0x20030000,
    Reset=0x080001B5, 与上游 2016 年 Debug/PSDR.hex 逐字节一致)。
    本 commit 只加文档, 未改动任何 Source/ 代码。
2026-10-30 docs: 新仓开工提示词（本地克隆 + 验收 + 指向工单）
2026-10-30 docs: 补宿主环境小节（WSL2/Windows换行符/Kali PEP668 三坑）
    澄清：编译是交叉编译, 不必完全复现 Ubuntu 环境。真正要锁死的只有
    二进制锚点 (_estack=0x20030000, Reset=0x080001B5), 与 gcc 版本无关。
    实测新发现:
    - 上游仓库全部文件为 LF, 但无 .gitattributes -> Git for Windows 默认
    core.autocrlf=true 会转 CRLF, Makefile 的 Tab 缩进被破坏, make 报
    missing separator。须克隆前设 core.autocrlf input。
    - WSL2 下勿在 /mnt/c 编译 (9p/drvfs 极慢), 须用原生 ext4。
    - Kali PEP 668 禁系统级 pip install。
2026-10-30 docs: 宿主环境定案 WSL2 + Windows 换行符/路径两个坑
    针对天选7P (仅 Windows, 最多 WSL2) 实测后定案:
    - 选 WSL2 + Ubuntu, 不用 Windows 原生 ARM 工具链
    (需另装 GNU make / 路径分隔符 / 换不来收益——锚点由链接脚本决定)
    - 实测本仓库无大小写地雷、无超 260 长路径、无非法字符,
    参与编译的 749 个源文件为纯裸机固件无 POSIX 依赖
    - WSL2 坑1: 勿在 /mnt/c 下编译 (9p/drvfs 极慢), 用原生 ext4
    - WSL2 坑2: Windows 版 git 的 core.autocrlf 会转 CRLF 毁掉 Makefile 的 Tab
    (上游无 .gitattributes 保护); WSL2 内 git 天然无此问题
2026-10-30 build: 补齐 5 处构建缺陷，使固件可在 arm-none-eabi-gcc 上构建
    上游从未有过能链接的构建。工单列了 4 处缺陷，实测是 5 处：多出的
    一处是 hal.c 的 halMilliseconds 唯一自增语句在注释块里，导致
    hal_getCurrentTime_ms() 恒为 0，而 TinyGPS 的时间戳全部取自它——
    不影响链接，但让 GPS 超时判据永久失效，属于"链上了却功能错"那一类。
    hal_checkTimeout 的返回类型按 hal.h:174 的 extern inline bool 走，
    不采纳 PATCH-NOTES 里的 uint32_t；实现落在 .c 以满足 C99 对外部定义
    的要求。main.c 的 HAL_IncTick() 加在已有的 SysTick_Handler 上，不碰
    stm32f4xx_it.c 的 weak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
2026-10-31 feat(pcb): 由 PADS ASCII 重建 KiCad 板并归一 Gerber 包
    Eagle 侧是二进制 .sch/.pcb，无网表可取，因此 KiCad 板改由 Hardware 里的
    PADS BOARD_FILE 3.0 导出（.emn/.emp）反推，并用 re-plot 与原 Gerber 往返
    比对自证（轮廓/孔位偏差 < 0.001 mm）。
    三处硬缺口写进施工记录而非绕过：转换结果是 2 铜层而实物主控板为 4 铜层、
    无 .kicad_sch、BOM 89 行里 84 行没有 MPN。制板仍以 dist/gerber/ 为准。
    [B_Cu.gbr, B_Mask.gbr, B_SilkS.gbr, Edge_Cuts.gbr, F_Cu.gbr, F_Mask.gbr, F_SilkS.gbr, Fab_Notes.gbr]
2026-10-31 docs: 补重启后任务B续跑清单（含'必须从本地工作树克隆'的坑）
    本地领先 origin 2 个提交，从 GitHub 克隆会拿到未修的树。
2026-10-31 docs: 任务B 构建通过，实测尺寸并定位交接材料两个数字的来源
    WSL2 Ubuntu 24.04 + arm-none-eabi-gcc 13.2.1：GC=1 与 GC=0 各一次完整
    构建均 0 error，锚点 _estack=0x20030000 / Reset=0x080001B5 与 2016 上游
    hex 一致（PASS）。
    交接材料里 984908 与 1077236 的 92328 字节差不是 --gc-sections，而是有没有
    执行 .cproject 的 HAL 排除表；两者都没开 GC，而 2016 真机镜像 137656 B 证明
    出厂固件是 GC=1（我们 136580 B，差 0.78%）。
2026-10-31 docs: 记录推送结果（tree 对账一致）与凭据助手失效的两个坑
2026-10-31 docs: 凭据助手坏配置已永久修正（! 形式 + 引号，不依赖 PATH）
2026-10-31 feat(netlist): 从 PADS Layout ASCII 提取 2.6.1 网表并完成四重校验
    上游 468dc41 已带 2.6.1 的 PADS ASCII 与 10 页原理图 PDF，复制入库使
    仓库自包含；tools/pads_asc_netlist.py 只依赖标准库，按 PARTTYPE/PART/
    ROUTE 三段解析出 391 器件、278 网、1132 已连引脚、41 未连引脚。
    四重校验：位号与 .emn placement 全同、131/132 命名网可在 PDF 文字层找到、
    固件 hal.c 的 28 条引脚定义 27 条同网、Si5338 旁注释与网表一致。
    [PSDR_2.6.1_netlist.csv]
2026-10-31 feat(sch): 生成 2.6.1 KiCad 原理图，278 网与 PADS 逐集合一致
    上游只有 PDF 与 PADS ASCII，没有 KiCad 原生原理图。tools/pads_asc_to_kicad.py
    把网表（谁连谁）、PDF 文字层的位号坐标（谁在哪页）、PCB 的封装名合成 57 个
    符号 + 1 张 A2 根图 + 9 张对应 PDF 页的子图；连接用引脚端点的全局标签承载，
    不画线，因此可机器校验而不是靠肉眼。
    校验：kicad-cli 导出 XML 网表后按引脚集合划分比对，278/278 网相同、
    1132/1132 已连引脚覆盖、0 缺失 0 跨网；几何重合检查 10 个文件 conflicts 0；
    ERC 0 error、391 warning 全部是 PSDR_PADS 封装库未随仓发布；kiutils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
    [PSDR_2.6.1-p02.kicad_sch, PSDR_2.6.1-p03.kicad_sch, PSDR_2.6.1-p04.kicad_sch, PSDR_2.6.1-p05.kicad_sch, PSDR_2.6.1-p06.kicad_sch, PSDR_2.6.1-p07.kicad_sch, PSDR_2.6.1-p08.kicad_sch, PSDR_2.6.1-p09.kicad_sch]
2026-10-31 docs: 补录原理图/网表两次推送的 tree 对账结果
    记录 61f1e20..59ea7f4 推送、tree 2b6299b 本地与远端一致，以及直连失败
    需单命令级 7890 代理的复现结果。
2026-10-31 docs: 修正上游 2.6.1 PDF 的实际路径与 master 旧版的关系
    上游重建分支上的路径是 Hardware/PSDR Schematic.pdf（blob 5390527），
    master 同名文件是 2014 年 8 页旧版（blob bdf02d2），原表述易被读成
    上游已有同名带日期文件。
2026-10-31 docs: BOM 与板子逐位号对账，并更正 2014 版 PDF 的定性
    BOM(2.6.1) 322 个去重位号 vs 板上 342 个常规位号：20 个不在 BOM，其中 19 个是
    安装孔/基准点/焊盘类机械件，R98 是真缺（第 52 行 "R97,-99" 漏了红 LED 限流电阻）；
    R6/R14 重复登记。借 BOM 自带的黄/红图例给出 2.6→2.6.1 的实际改动清单。
    2014 版 PDF 不是"少 16 个位号"，而是另一版更早的设计（位号仅 156 个重合）。
2026-11-01 feat(pcb): 从 PADS ASCII 生成四层 KiCad 板，并与 2.6.1 原始 Gerber 对账
    新增三个标准库解析器与一个对账器：PARTDECAL 取真实焊盘、ROUTE 取走线/弧/
    过孔，生成 4 层 / 278 网 / 1194 焊盘 / 5034 段走线 / 22 弧 / 419 过孔。
    对账结果：源 Gerber 每个 D03 flash 在 0.1 mil 内被覆盖（最差 0.0066 mil），
    六层 flash 数逐层等于焊盘出现次数 + 过孔；461 个源钻孔对上 460 个，缺的
    1 个 3.2 mm 孔根因是 J170 decal 的 PAD 20-23 与端子 21-24 编号错位（源数据
    自相矛盾，生产以钻孔文件为准）。DRC 309 条违规 + 20 个 GND 断点，等铺铜。
    生成器改为按发射顺序派生 uui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
    [PSDR_2.6.1_pcb_spike_full.kicad_pcb, PSDR_2.6.1_spike_TX-Q_DRIVER_P.kicad_pcb]
2026-11-01 docs: 记第三批的提交推送结果与 PR #17 评论
2026-11-01 feat(pcb): 补上铺铜、真实板框与丝印，四层板 0 断点
    - 板框取 *LINES* 里唯一的 BOARD 记录：68 顶点 / 67 段（42 直线 + 25 弧），
    对 2.6.1 fabnotes 真弧采样 2144 点，最差 0.0025 mm。
    - 铺铜取 *POUR* 的 12 个 POUROUT（7 个网），GND 连通性 20 → 0。
    - 丝印取 decal 图元 + 板级 level 26/29 + 位号 + 自由文本；双向覆盖率
    2/8 mil 100%，10 mil 仅剩一处 9 笔画未定位的实心三角。
    - 修 gerbparse 的 G75 整圆弧（start == end 被当零扫角）。
    - DRC 795 条 / 0 断点，均为源设计允许的丝印压焊盘、紧间距与库缺失；
    生产包仍以上游 468dc41 的原始 Gerber 为准。
    [PSDR_2.6.1_pcb_spike_full.kicad_pcb]
2026-11-01 docs: 记第四批的提交推送结果
2026-11-01 fix(pcb): 改用 KiCad 10 铜层编号，并记 EDA 导入的三处根因
    生成器把内电层写成 1/2，KiCad 10 里那是 Bottom/In1，导致导入嘉立创EDA
    丢四层结构。改为规范的 0/4/6/2，板文件同步重生成；DRC 重跑仍 795 条、
    0 断点。施工记录补 C-15：层号、网络反斜杠、铺铜网络三处根因及回读数据。
    [PSDR_2.6.1_pcb_spike_full.kicad_pcb]
2026-11-01 docs: 记第五批的提交推送结果
2026-11-01 feat(build): 补 Makefile.linux，F7 固件可在 Linux 上复现构建
    - 按 .cproject 的 Debug 配置转写 make 构建，默认 -O0，可用 OPT 覆盖
    - 排除 stm32f7xx_hal_msp_template.c，避免 MSP 符号重复定义
    - 补 si5338.c / frequency_control.c 的 HAL 包含与 handleI2C 声明
    - 忽略 build_linux_f7* 构建产物
2026-11-01 fix(pcb): 补上 J170 第 4 个安装孔，并把 795 条 DRC 逐类定性
    生成器新增 pad_stacks()：孤儿焊盘按编号差最小配给无焊盘端子（J170 的
    PAD 20 → T24），是通用规则而非 J170 特例。交付板只差这 5 行，钻孔由
    460/461 变为 461/461，B.Cu/B.Mask 各少一个兜底 flash，与 F 面完全对称。
    铺铜边界按铜边重测为 0.008 mm（原先 0.13 mm 是拿中心线对铜边比错），
    795 条 DRC 依源 PADS 规则逐类定性写入 §C-16：全部是源设计既有违规或
    两类已知转换差异，没有一条是转换做错几何。
    [PSDR_2.6.1_pcb_spike_full.kicad_pcb]
2026-11-01 docs: 立 next 为独立主线，记 M0 分支拓扑与里程碑
    上游以 MIT 授权，维护者在 issue #7 明确邀请 fork 继续推进（2026-09-11），
    据此把 fork 转为独立开发线：master 只做上游镜像，fork-base/2026-10-30
    标出分叉点，next 承接全部后续工作。README.fork.md 写清派生关系、已交付
    内容与未验证项；施工记录新增 §E，列 M0–M4 里程碑和退出标准。
2026-11-01 docs: 记 M0 的 next 分支与 fork-base tag 推送结果
    记录 a524e06 与 annotated tag 的首次推送、tree 对账与上游只读核对；
    upstream 上没有 next 分支或 fork-base tag。
2026-11-01 fix(pcb): 补齐 PADS COPPER 丝印记录，10 mil 双向对账归零
    *LINES* 段里的 COPPER 记录（piece 类型 COPCLS）此前被 parse_board_silk
    跳过，正面 C151 左侧的三角标记和背面 800x190 mil 序列号白块都没进板。
    PADS 按"边界内缩半个线宽描边 + 9 mil 剖面线"绘制这类形状，生成器改为
    输出内缩多边形 + 10 mil 描边实心填充。
    - 板级丝印 1495 -> 1497（26: 754 / 29: 743）
    - 10 mil 档：GTO 98.03%/100% -> 100%/100%；GBO 29.47%/46.88% ->
    84.82%/73.04%，余量为背面 4 条自由文本的字体差
    - DRC 795/0 与分类计数不变；0 个源 flash 未覆盖、461/461 钻孔；
    同一输入重跑 sha256 不变
    - 施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
    [PSDR_2.6.1_pcb_spike_full.kicad_pcb]
2026-11-01 feat(tools): 一条命令复现链 + SHA256 清单；更正 EDA 零铜铺铜真因
    §C-18 新增 tools/reproduce_kicad.py：生成板 → DRC → 8 个 Gerber + 钻孔 →
    可选与 468dc41 原始 CAM 对账 → 写 dist/kicad/SHA256SUMS。板按原样哈希，
    Gerber/钻孔去掉 KiCad 的创建时间元数据后哈希，DRC 报告因 KiCad 报项顺序
    随运行而变、不入清单；fab/ 属派生件已加 .gitignore。连跑两次清单逐字节
    相同，--check 10 个文件全 OK，仍是 795 条 DRC / 0 断点、0 flash 未覆盖、
    461/461 钻孔对上。
    §C-15 补充推翻上一轮结论：把两个空铺铜的 keepIsland/preserveSilos 置 true
    后整体重建仍 10/12；真因是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
2026-11-01 docs: 记 M1 的提交推送结果与 BOM 补丁交付
2026-11-01 feat(tools): 按源数据给 .epro2 补铺铜优先级与孤岛位
    EDA 的 PADS 路线转换器把 POUROUT 尾部数字原样抄成 pour 的 order，并把
    PLANEFLAGS 的孤岛位写成 keepIsland=true；KiCad 路线两个属性都不带
    （order 变成按文件顺序的 1..12），而 EDA 是"order 小者优先"，所以排在最后
    的 +3V3_FLIP_FLOP 与 V_SUPPLY 整片被判给别网、重灌后零铜。
    新增 tools/eda_epro2_pour_source.py：直接从 Hardware/PSDR.asc 读
    (net, layer, 面积) → order 与 keepIsland，写进转换后的 .epro2，只改匹配的
    POUR 行。以 EDA 自己的 PADS 路线工程为基准，12 条
    (net, layer, order, keepIsland) 逐条相同，整个 .epru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
2026-11-01 chore(merge-prep): 把 F7 构建线整体移到 Source_F7/，准备并入 next
    M2 用目录隔离而不是覆盖：next 的 Source/ 是 STM32F4 那一版（工单任务 B），
    F7 的 CubeMX/FreeRTOS 重写在 PSDR_Rebuild 线上改了 506 个 Source 文件，
    两条线不能共用一棵树。先把整棵树改名，后面的合并交给 git 的重命名跟踪，
    F7 的 65 删/131 增/310 改都落到 Source_F7/，F4 的 6 个文件留在 Source/。
2026-11-01 docs(m2): 记 §E-7 并入结果；两条固件线在同一主线可构建
    - 冲突按 merge-tree 复算逐条记账（8 个路径 10 条），拒绝 git 的目录搬家建议
    - F7 向量锚点对账从板外记录变成可重跑的 tools/anchor_check_f7.py
    - 更正 §C-15/§E-6 的 EDA DRC 报数（507→513，未 settle 的 520 不采信）
    - README 补 M2 后状态：2.6/2.6.1 的 CAM 与 PADS 资料这才进主线
    - .gitignore 收两条固件线各自的构建目录
2026-11-01 docs(m2): 记 §E-8 推送结果，并把 M2 的量化数字改成可复核的口径
    - 冲突前的两侧改动量按改名之前的 F7 尖重算：删 65 / 增 131 / 改 310，重叠 5 个路径
    （先前记的 503/3 是拿改名之后的 2e19ad0 比的，Source/ 整体显示成删除，作废）
    - E-3 的 M2 行四项退出标准全部签字；§E-7 标题去掉"本地未推送"
2026-11-02 docs(eda): §E-9 现场铺铜在新主线复测；把 #31 端到端自动化定性为 unsupported
    - poured-list 连读两次：12/12 有铜，772 块，孤岛 7 块与源一致
    - BOOST_LOOP 读 10 块、§C-15 基线记 11 块，差一块如实留档，未为此做写操作
    - 翻完 167 个 typed action 与通道 B：没有 KiCad 板导入、也没有 .epro2 再导入接口
    ⇒ 复现链缺的是宿主接口，不用 GUI 自动化冒充
2026-11-02 chore(repo): 把 474 个上游构建产物移出版本控制，只动索引不动磁盘
    #32。根 Debug/ 141 + TestingMakeFile 174 + TestingMakeFile2 159 里的
    .o/.d/.lst/.map/.elf/.hex/.bin 不再跟踪；TestingMakeFile* 的 1284 份 .c/.h/.s/.icf
    是 CubeMX 工程源码，继续跟踪。两份锚点参考 Source/Debug/PSDR.hex 与
    Source_F7/Debug/PSDR.hex 明确保留。历史与工作树都不丢字节。
    顺带更正 §E-7 的产物计数：先前 364 是没算 .d，准确是 474。
2026-11-02 docs(plan): §F 下一步规划；更正 #32 那句"文件仍在盘上"
    - PR #1 合并成 4d4549f 后实测：任何检出该提交都会把 474 个路径从工作树删掉
    准确口径是「历史不丢字节、工作树会丢」，取回用 git checkout 568a079 -- <路径>
    影响面复核：主线跟踪 4008→3534，两份锚点参考 hex 仍在册且在盘上
    - §E-8 里残留的 364 一并改成 474
    - §F 按「不需要硬件就能验证」排序：A 制造包核对+SMT 坐标表 / B 硬件到位才做的准备 /
    C 对外只跟 #14 / D 明确不做的边界
2026-11-02 fix(bom): 把 #14 四件 DNP 的依据写进备注列；主线一并收下 PR #18 的位号修正
    网表逐件证明 C307/C320/R72/R79 都不是串联元件：两件是 U314(AD8302) 到地的旁路，
    两件是跨在混频器 LO 对(L41/L81)上的桥接电阻——装 0 Ω 反而短接，所以无需任何跳线，
    封装与铜都在板上（网表就是从板子里提的），是"按设计不装"不是"被删"。
    OPEN/DNS 原本写在 Value 列、约定藏在错误的列里，这才是上游追问的原因；本次只往
    作者自己在用的无标题备注列（2.6.1 的 J、2.6 的 L）加字，不动既有单元格语义。
    逐格 dump 对账：2.6.1 四处内容变化（新增 2 格备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
    [PSDR2.6.1_BOM.xls, PSDR2.6_BOM.xls]
2026-11-02 docs(issue13): 更正 §G-2 那句"离线无法确认映射"，补 §G-3 实际局面
    映射就写在 BOM 自己里：U304 那行的超链接目标是 rfmd/SXB-2089Z/599-1068-1-ND/937042，
    所以 599-1068-1-ND 从始至终就是 RFMD SXB-2089Z，封装名 HMC482ST 是过期标签——
    与 §C-7 第 3 条一致。此前抓不到是因为 BIFF8 把超链接存在 UTF-16 流里，按 ASCII grep 零命中。
    结论改为：U304 有表内权威可填 MPN，开关那行只有 Type 名不能填；#13 断的是供货不是型号。
    另记替代件硬约束（U304 3 脚与偏置注入位置；三只开关 13 脚与 PA0/PE6、PC1/PA6、PB2/PA7 控制）。
    PR #18 正文已按同一套事实重写。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
2026-11-02 fix(bom): #13 的两颗型号写进表内；§G-4 记国产化只留提案
    U304 = RF Micro Devices SXB-2089Z（依据三重：该行自带超链接
    …/rfmd/SXB-2089Z/599-1068-1-ND/937042、2.6.1 备注"Name mismatch is okay, the
    Digikey part # is the correct part"、2.5 表 U19 同型号的 *Not the part listed in
    Type*），所以 Type 名 HMC482ST 是过期标签。U16/24/30 只填 Mfg Part #
    =MASWSS0129TR，Manufacturer 故意留空——那行没有超链接也没有作者免责，
    不凭一个名字断厂商。OctopartBOM.csv 的 85 行里原本 83 行有 Manufacturer+MPN，
    空的正好就是这两行，一并补上。
    逐格对账：两份工作簿各新增 3 格（DNP 那 2 格之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
    [OctopartBOM.csv, PSDR2.6.1_BOM.xls, PSDR2.6_BOM.xls]
2026-11-02 feat(fab): A-2 SMT 贴装坐标表；顺手改掉两处过期说法
    tools/pads_asc_placement.py 直接读 *PART* 与 BOARD 记录出贴装表
    （391 件，Top 209 / Bottom 182，原点在板框左下角，保留 PADS Y 向上与 mirror/ori 原值）。
    两条硬对账：与 BOM——332 个采购件全部被覆盖，BOM 之外只剩基准点 6、螺钉孔与桨叶触点 11、
    单焊盘点位 42；BOM 里 Battery connector 与 Encoder 两行在本板上无对应件（线缆件 / 另一块板）。
    与已过 Gerber 验证的 KiCad 锚点——391 个全比对，最大偏差 0.0005 mm，那是 M6 的 73.9175
    按三位小数取整，其余逐位相符。
    文档更正：评估报告 §4.2 原先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
    [PSDR_2.6.1_placement.csv]
2026-11-02 docs(m4): §C-20 制造包逐层核对与锡膏母片实测
    12 个文件的结构、光圈、闪光、线段与包围盒列表。两层锡膏是 gerbv 2.6A 二次导出的，
    不是 PADS 原始光绘。坐标框架沿用 §C-13 已证的 +1000 mil 不翻转：GTP 194 孔里 188
    距 Top 焊盘 ≤8 mil（中位 0.03 mil），GBP 170 孔 100% 命中底面焊盘；2×2 证明标签没反。
    6 个远孔全部落在底面件 USB 的 4 个屏蔽片焊盘上——顶面锡膏给底面件开窗，是实测事实，
    意图本机判不了。
    两条差异按不通过记：母片里 0 个 G36/G37 区域（开口靠闪光+线段）；我们的板子不建模
    锡膏，但 KiCad 默认能从焊盘生成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
2026-11-02 feat(tools): A-3 八层双向覆盖率；CAM 铜层与阻焊层 100% 被解释
    tools/kicad_layer_coverage.py：40 px/mm 栅格 + 0.10 mm 膨胀做差，双向报数，
    G36 区域按多边形填充，CAM 侧减 +1000 mil 平移。结果：4 个铜层与 2 个阻焊层
    CAM->我们 100.00%；丝印 97.70%/97.41%，未解释部分最大团块 1.05x1.07 mm 与
    1.05x1.18 mm，全是字符级笔段，与 §C-17 的字体差异同源，无整块图元缺失。
    反向低百分比（铜 72%、阻焊 12.7~13.9%、丝印 20~21%）记为"量的是表示法不是正确性"：
    我们实心填充 vs PADS 内缩+网格，我们 594 个焊盘尺寸开口 vs CAM 数千条描边。
    判等仍只用 §C-13/§C-1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
2026-11-02 docs(m3): 上电前检查表 B-1（测点与网络从设计数据算出，判据留实测栏）
    位置与网络归属全部来自 Hardware/PSDR.asc 经 pads_asc_netlist.py / pads_asc_placement.py
    算出的结果：42 个单焊盘点位（VUSB/VSPLY/3V3A/3V3D/1-2VCC/5VBST、NRST-IO-CLK SWD、
    SCL-SDA、GPSRX-GPSTX-1PPS-GPSR、DAC1-DAC2、EAR、MIC、MAG-PHSE、LO1N/LO1P/LO2N/LO2P、
    E_FILT_IF/RF 四点、CLKA-CLKB、CW1-CW2）都带坐标。
    射频只写观测方法与记录内容，不写修法：六根 RF 开关控制脚是 PA0/PE6、PC1/PA6、PB2/PA7；
    U304 输入侧偏置在 RF_AMP_IN(TP BIAS)。顺手把 #9 那条现成事实写进去——PA0 既是 standby
    唤醒脚又是 AMP_SWITCH_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
2026-11-02 docs(evidence): 现场数据落 evidence/；加 EDA 导入 SOP；清杂务
    不可重跑的 EDA 读数（12/12 铺铜 772 块、DRC 513 的构成）从板外原始回读重算入库，
    可重跑的那几份（覆盖率、锡膏、构建、.xls 副作用）也一并留档并注明命令；DRC 的
    73+14+419+6+1=513 现算正好等于 §C-15 记的数，同时自证"多的 6 条是孤岛铜 No Connection"。
    审计脚本里 notes/links 两个探针计数是错的，已在文件里声明不作证据。
    docs/SOP-eda-import-2.6.1.md：把"直接导入会得到 10/12、那不是回归"写在最前面，
    逐步标出哪两步宿主无接口必须人工、不许用 GUI 自动化顶替，验收给逐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
2026-11-02 docs(eda): C-22 收口 #37——源规则是铺铜 12 mil，EDA 实际 10 mil
    纠正我一直写的"按源 8 mil 复核铺铜"：CLEARANCE_RULE 里通用间距 304800=8 mil，
    但 COPPER_TO_*=457200=12 mil 才是铺铜该守的；EDA 工程实际用 Plane lineClearance
    0.254mm=10 mil（信号 6、线对线 4），比源紧 2 mil。
    今天只读复测 DRC：总 513，与铺铜区有关的只有 6 条孤岛 Connection Error，没有
    Copper Region to Copper Region 间距违规——§C-15 记的 4+3 条在复测里不复现，
    再次印证"未 settle 时读数会漂"。
    按 unsupported 收：drc-rules-set 对铺铜只升不降且要求 pour-rebuild，rebuild 会改掉
    12/12 验过的几何；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
2026-11-02 docs(fw): 源码状况与模块审阅报告（只读，未改一字）
    统计口径与两棵树构成（项目自有约 1.2 万行 / 1.07 万行，其余是 HAL 与 CMSIS-DSP）；
    按模块写了中文注释：启动与主循环、hal、三套显示驱动、菜单、采样与频谱、滤波器设计、
    信号路径、频率合成、ADC/DAC、GPS、基础设施、中断。
    P0 两条：F7 main.c:1021 有无条件 while(1) 调试循环（真主循环 1065 到不了）；
    frequency_control.c:54 的 I2C 等待无超时（Si5338 不应答则开机永久阻塞）。
    P1 五条：recieve_with_filter 空 case、FFT 初始化在中断里每帧重做、FFT/FIR/RMS 全在 TIM4
    中断内跑且与主循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
2026-11-02 docs: 固件发现挂进 README；补资料缺口与 PCB 改版/移植清单（均不进上游）
    README.fork.md 明确两条阻断级固件缺陷（F7 的调试 while(1)、Si5338 的 I2C 无超时等待），
    并注明这是只读审阅、不改源码、不向上游提议。
    docs/PSDR-open-data-gaps.md：
    - 必查资料按"卡住什么功能"排序：HMC1023LP5E（U287，32 焊盘，固件零引用，#16 的主要未知）
    居首，其次 Si5338、SXB-2089Z、MASWSS0129、AD8302、74CBTLV3253、F746 勘误、2.6 原理图；
    - PCB 改版：2.6 vs 2.6.1 BOM 逐行比对后实质差异只有 R164 270K→240K，其余是位号写法；
    两颗断供器件封装不可替换（U304 3 焊盘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
2026-11-02 docs(fw): HMC1023(U287) 引脚—网络—SPI 连接表（只读整理，不进上游）
    33 个端子逐脚列出：电源/地/偏置、SPI 四线（PB12-NSS/PB13-SCK/PB14-MISO/PB15-MOSI，
    与增益电位器 MAX5388 共用时钟与数据线、靠两条片选区分）、差动 RF 进出与 IQ 通路、
    校准时钟来自 Si5338(U241.18 经 C283)。
    两条已确证的缺口：LPF 供电开关 Q208 的栅极由 PE11(LPF_POWER) 经 R206 驱动、默认被
    R207 上拉关断，而固件里没有任何 LPF_POWER 驱动；SPI 硬件全通但固件零代码。
    另标三个待手册确认的脚：29 VBG 悬空、28 VDDBG 只挂旁路帽、NC 全接地是否允许。
    顺手记一条对照纪律：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
2026-11-02 chore(docs+tools): 固件统计脚本收进 tools/；加文档索引；HMC1023 手册结论落表
    - tools/fw_stats.py 与 tools/fw_funcindex.py：调查报告 §1/§6 的数字现在可复算（原来在板外）；
    - docs/README.md：文档索引，标出哪些是 fork-only、哪些是上游给的历史输入；
    - tools/pads_asc_placement.py 去掉未用的 index 导入；
    - HMC1023 文档按官方数据手册（analog.com 的 hmc1023.pdf，本地 pdftotext 抽文核对）更新：
    28 脚 VDDBG = Bias 5V 供电、要求本地去耦，而板上只接了去耦电容、没有供电 ⇒ 硬件缺口；
    29 脚 VBG = 1.2V 带隙输出仅供测试，悬空正确；11 脚 CALCK = 校准时钟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
2026-11-02 docs(proposal): U304 封装实测与替代件/局部改版提案（fork-only）
    U304 实测：3 焊盘各 1.6×0.7 mm、间距 1.57 mm、在背面；引脚 RFIN/GND/RFOUT。
    偏置拓扑：输出侧 L19(220µH)→+5V_AMP（与 SBB5089Z 脚3=RFOUT/VCC 一致），
    输入侧另有 L11(220µH)+R6(180Ω) 馈入直流——换料前必须核清新件允许不允许输入脚直流，
    这一条决定要不要动偏置网络。
    放大器候选（均标待核）：SBB2089Z、SBB5089Z（已停产，官方后续 QPA9126）、
    国产通量 FW2106（SOT-89 与 SBB5089 pin-to-pin）。共同门槛是低频下限 50 MHz 与输入侧直流。
    无源件：184 件非射频两脚件聚合为 36 个 BOM 行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
2026-11-02 docs(fw): 补 §2.0 架构图——SDR 信号链从网表反推
    Si5338(3225 晶振参考)→ ADE-2ASK 二极管环混频器 L41/L81 → HMC1023(U287) 低通，
    旁路/滤波由 74CBTLV3253(U211/U298) 选择 → AD8302(U314) 增益/相位检波 →
    STM32F746 片内 ADC → CMSIS-DSP FFT/FIR → TPA0253 音频。
    结论：没有独立 DSP 芯片（DSP 就是 MCU），也没有模拟 VFO（Si5338 数字合成，晶振只作参考）。
2026-11-02 docs(proposal): 论证 GaAs DPDT 远超所需；补 IC-705 式分波段前端方案
    用板上自己的器件参数对照：混频器 ADE-2ASK 官方 1–1000 MHz（Level 7、变频损耗 5.4 dB、
    L-R 隔离 45 dB），而开关是 DC–6 GHz ⇒ 链路真实上限由混频器决定（≈1 GHz），
    6 GHz 开关在短波上没有任何必要性，所以"没有 pin-to-pin 替代"不构成死路。
    补 §4.4：本板目前没有任何射频带通滤波器组（唯一滤波是混频后的基带 HMC1023），
    这正是强台/AM 串扰与动态范围问题的来源。IC-705 式分波段前端（6 段 LC 带通 +
    继电器或 CMOS 切换 + 波段译码）落在 U16 同一区域，工程量可与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
2026-11-02 docs(proposal): 记录架构约束——不做射频直采（成本决策）
    现状 STM32F746 片内 ADC 约 2.4 MSPS 级、开发板百元量级；直采要 >60 MSPS 的 ADC
    加高速数据通路，单这两项就是几百到上千元。且现有架构对目标用途够用：2.4 MSPS 的
    I/Q 瞬时带宽约 1.2 MHz，而 SSB/CW 只需 2–3 kHz、瀑布图常用 192 kHz——瓶颈在前端
    选择性（无射频带通）与 I/Q 匹配，不在采样率。
    按"每元换 dB"排序：分波段带通 > I/Q 校正 > 前放/偏置 > 直采（本板不做）。
    此条作为后续改版的架构约束：任何换 MCU/加 ADC 的提议先过成本门槛。
2026-11-02 docs(scope): 最初需求、BOM 成本构成与去冗余清单
    需求直接取作者 README：独立便携 HF QRP SDR、0–35 MHz、瀑布、收 AM/USB/LSB/CW、
    发 USB/LSB、可变带通、AD8302+阻抗桥做 VNA、双 SMA、GPS、LiPo+充电、microSD、摩斯键。
    成本按 BOM 的 Cost x1 逐行乘数量：合计 $276.78（87 行有价）。前三名：HMC1023 $30.32、
    AD8302 $24.86（只服务 VNA，S 表用的是采样 RMS）、GPS $20.38。另注意 MAX4525 三颗
    就是 CMOS DPDT 模拟开关、已在 I/Q 收发切换上使用——射频侧换 CMOS 与原设计一致。
    去冗余建议（每项都要能被证伪才算功能）：VNA 链 ≈$33、GPS 改选装 $20、HMC1023 用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
2026-11-03 docs(analysis): VNA 改判保留、各件频段极限实测口径、替代件方向纠正
    用户否决砍 VNA（"我当时看中就是 VNA"），网表也支持：VNA 不是外挂而是主链路
    （ANT/VNA-IN -> U16 -> U24 -> U30 -> VNA-OUT，桥的 REF/DUT 两只焊盘跨接 AD8302）。
    成本地板因此上移到 $225-235，旧数字 $190-200 标注作废。
    查到唯一射频增益件 U304 是 50-850 MHz 的增益块（BOM 行 75 的 DK 号 -> SXB-2089Z），
    在 HF 本来就没有增益；封装名对应的 HMC482ST89 是 DC-5 GHz 但要 +6~+12 V，与本板
    +5V_AMP 不符。于是替代件方向从"找停产件的 pin-to-pin"改成"这台机器需要一个频段
    正确的 DC-starting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
2026-11-03 docs(records): 汇编作者实测与装配记录；更正我们三处过头的结论；改基成本实测
    用户提示"2016 年有人打板焊装测过"，据此把提交信息里的一手记录编目成
    docs/PSDR-author-measurement-log.md（sha/日期/血统/原话/数字/关联 issue/证据强度）。
    关键一条是 2c1530d（2016-05-07）：作者实测能调 2.5-175 MHz、灵敏度约 -90 dBm@7 MHz
    与 -80~85 dBm@146.4 MHz。这既与固件 VFO 夹取（main.c:1730-1731）对上，也说明"第三层
    全空白"的说法过头了：应当是"有作者实测自述、无原始数据与测量条件"。并立案 2016 的
    -90 dBm 与 2021 年 #16 的 -70 dBm 之间那 20 dB 落差（三个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
2026-11-03 fw(re-base): Source_F7 镜像从 PSDR_Rebuild 换到维护者指名的 PSDR_F7
    维护者 2026-11-03 在 #19 明确 "PSDR_F7 is the tree to base firmware work on"，
    并说他以它做 HMC1023 LPF 上电。我们原本镜像的是 PSDR_Rebuild（M2 那次并进来的）。
    改基前实测过成本，结论是移植免费：
    - 我们的 Makefile.linux 零改动就能编 PSDR_F7（WSL gcc-arm-none-eabi 13.2.1，
    rc=0、0 error、26 warning；text 114068 / data 18488 / bss 18260）
    - 锚点门原样 PASS（初始 SP 0x20050000、空槽图案 [7,8,9,10,13,95]）
    - 结构差异只有 src 17↔19、include 16↔18，system/ldscripts/DSP_Lib 三只目录数目相同
    （si5338.c/freque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
    [main.c]
2026-11-03 docs(record): 改基执行记录 §I-9；survey 加基线变更公告与 P0 归属修正
    WO 新增 §I-9：换树净效果（6 删 15 改）、差点丢锚点的过程与处置、从已入库树重跑的
    构建与两次门（两份参考都 PASS）、以及改基后我们在 F7 侧的真实净增量
    （.gitignore +1、Makefile.linux +120、Debug/PSDR.hex 有意不再跟踪、.c/.h 净改动 0）。
    survey 顶部加"基线变更公告"：本文所有 Source_F7/…:行号 是在旧镜像 PSDR_Rebuild 上量的，
    现镜像为 PSDR_F7 —— si5338.c/frequency_control.c 在新镜像不存在（驱动在 825 行 i2c.c 里）、
    P0-1 在新基线不成立、P0-2 位置改为 main.c:1031-1032；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
2026-11-03 fw(build): 更正 Makefile 头部两句在新基线上不成立的话；补三种排除口径的实测
    给 #19 写评论前回头核 .cproject，发现我自己刚写进头部的两句是错的：
    PSDR_F7 的 Eclipse Debug 排掉了 42 个 system/src/stm32f7-hal 文件（.cproject:232，
    含 hal_dma.c，但 i2c/uart/tim/spi/adc/dac/gpio/rcc 都留着），而且它不排除 src/TinyGPS.c。
    我原来写的"只排除 Examples 与 TinyGPS.c""不排除任何 HAL 模块"是把 PSDR_Rebuild 的
    事实搬进了新基线的注释里 —— 代码错了编不过，注释错了没人报警。
    三种口径都实测（GCC 13.2.1，全 rc=0、0 error）：
    本 harness（全编 HAL、跳 TinyGPS.c）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
2026-11-03 chore(delegation): 输入包生成器 + 36 份 IC 上下文与 23 个封装原始块，供外部 agent 跑机械活
    用户要把耗时、只需外部资料的活派给接不到本仓库的虚拟机 agent。所以给的是可重跑的生成器，
    不是手抄材料：全部从 Hardware/PSDR.asc、dist/netlist/PSDR_2.6.1_netlist.json 与
    OctopartBOM.csv 派生，一条命令 make_delegation_pack.py 重出。
    内容：ic_context/<位号>.md（每脚→网络→同网其它引脚，被动件的值编码在 part_type 名里）、
    decal_raw/<封装>.txt（原样 *PARTDECAL* 块 —— 不给我解码后的列名，避免执行方被我的口径带偏）、
    parts_census.csv、bom_rows.csv；README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
    [_index.csv, bom_rows.csv, parts_census.csv]
2026-11-03 chore(delegation): 把包改成抗错位的形状（3 个合并文件 + MANIFEST）并统一答案 schema
    用户在 IMA 知识库那份 psdr/ 里发现文件名与正文系统性错配（正文相对名字前移 4 位，
    抽验 10 件实锤），另有 4 件没传上来。本地包我逐文件验过：36 份 ic_context 的首行位号 =
    文件名、23 份 decal 块首 = 封装名、3 个 CSV 表头全对，零错位 —— 病灶在入库层按排序结果
    重新配对，不在包本身。但"补传缺的 4 个"治不了这个病：只要还是 63 个小文件走那条通道，
    下次照样错配。
    所以把形状改掉：
    - TASK_C_ic_context_all.md（36 段）、TASK_F_decal_raw_all.md（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
    [MANIFEST.csv]
2026-11-03 docs(integrate): 改基后失效的数字全部复测归位，抓到两处与改基无关的老错
    §K 整合轮：Source_F7 换到 PSDR_F7 之后，正文里在旧镜像上量的数字没有跟着走。
    本轮不做新分析，只复测与归位：
    - 复测：fw_stats / fw_funcindex / 两条 git diff / 逐条 grep -n
    F7 项目自有 10,686 -> 10,437（总 346,049 -> 345,800）、函数定义 119 -> 116、
    .c/.h 相对上游改动 6 行 -> 0 行（F4 线仍有 hal.c +17/-2 等，口径分开写）
    - 缺陷清单加"现基线复测"表：P0 只剩一处（main.c:1031-1032，P0-1 属 Rebuild 血统）、
    P1-2 由 3 处更正为 6 处、P1-3/4 行号全部换、P2-5 不适用
    - 抓到两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
2026-11-03 docs(intake): 收回外部执行方 6 份答案并做机器验收；整理成果与待办队列
    - 来源：IMA 知识库 psdr 文件夹（6 份答案 / 59 份我方输入件，按 class 区分上传者）
    - 验收：任务C 55 行按位号回到本地 TASK_C 合并件逐行对账，49 行通过、6 行为校验脚本
    正则误报（把 R1/R2、NR6028、10U0 当位号），0 行内容不符；0 行需要退回
    - 错位实锤由我方独立复现：KB 的 U114/U121/U37/U85 正文分别是 L39/L41/U30/U24
    ⇒ 按文件名取数会整表错位；他们按正文头位号绕开了，代价是 U58/U85/U86 与 census 缺失
    - sha256 复算：AD8302 / SY10EP52V / SN74CB3Q3253 / SN74CBTLV3253 四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
2026-11-03 feat(bom): 位号值三方对账工具 + 包补齐 Value 与未连接脚；自算判定并更正四处口径
    外部答案里大量"信息不足"的根因是我们的包只给了 PADS 类型名（RES_0603）没给值，
    而值就在 .asc 的 PART { Value } 块里。这轮把它补完并顺手抓到几处错。
    - 新 tools/bom_refdes_crosscheck.py：板文件 × 2.6 BOM × 2.6.1 BOM 逐位号对撞
    339 位号：255 一致 / 11 冲突 / BOM 有板文件无值 1；两份 .xls 展平成 CSV 入库（带源 BIFF 版本）
    - make_delegation_pack.py：邻位带值 336 处、值冲突标 56 处、未连接脚 26 行
    （端子取 decal 的 T 记录，不是 PAD 块——PAD 键是图形序号）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
    [BOM_refdes_crosscheck.csv, MANIFEST.csv, PSDR2.6.1_BOM_flat.csv, PSDR2.6_BOM_flat.csv]
2026-11-03 docs(intake): 7 份原厂 PDF 我方复算一致；#16 更正评论已落地并复算只发一次
2026-11-03 docs(gaps): MASWSS0129 一行补齐真值表/互补驱动/控制电平余量与 U30 空掷位；缺件清单区分撤档与网络
2026-11-04 docs(review): 回帖发出前自查——R6/R14 是表内自相矛盾而非版本 delta；Qorvo 429 不作撤档断言
2026-11-04 docs(review): 2.6 上游版同样是 R97,-99/Qty3（导入器逐格取证），并把取证方式写准
2026-11-04 docs(gaps): 2.6.1 未修版是表内自相矛盾（R6/R14 双值），并按导入器逐格取证改写口径
2026-11-04 docs(outward): #18 回帖已发（只发一次的取证入账）；429/404、算得轨压等口径回写四处旧文案
    - 回帖正文 2,823 字符 = 本地草稿去行尾；发前 comments=1、发后 =2，本方账号名下 1 条
    - Qorvo 那条从"撤档"降级同步到 §2-B / §8.1 / gaps §3-1 / 本账 §K-10，MASWSS 按 11-04 复测写实
    - +3V3_CPU 2.90/3.01 V 钉为计算值（未电测）；§1.6 GPS 升原件、同行 W3062A 不跟着升
    - 自查发现已发出的 #16 第 2 点把"表内自相矛盾"只写成版本 delta，记为待补回帖（等批准）
2026-11-04 docs(outward): #16 自我更正已发出；补一条 PR #18 的机械依据（位号数==qty 约定）
    - 两份未修 .xls 逐格重读：2.6 同一行 qty=3/值在 K 列、2.6.1 已改 1 却没删位号文本 ⇒ 半次编辑
    - 遍历各 43 行含逗号的 ref_des，违约只剩 #18 改的那两处（第 5 行是排针网络名，不算组）
    - 行号口径钉死：项 41 = 电子表格第 45 行；跨版本按列名对账（值列 2.6=K、2.6.1=I）
    - 纠正引用面：BOM_changes_PR18.md 只在 PR 分支，next 里没有（.xls 三个 blob 两侧一致，已核）
    - 记账 K-13：next 推 84f3790、三处 master 快进 c34afebe（FF 前置检查全过）、#16 回帖只发一次
2026-11-04 docs(chronicle): 编年史落档（五纪 + 我们撤过的 11 条断言），外部答案收档进仓
    - 上游 2014→2025 原史逐条带时间戳与原话；接手七天按天编年（72 提交）；对外件全表带评论 id 与字节数
    - 现拉证据时修掉四处：2026-09 后有动静的是 8 条不是 7、"Please do" 精确到 3h39m/周六、
    PR #17 日期从 11-01 挪回 10-31、索引与 fork README 里残留的"只差 R164"与"chapters A-J"
    - delegation/answers/ 收对方交回原件（正文未改，加 PROVENANCE 头 + 核对状态 README）
    - UHSDR 口径钉正：#16 无人说过"前端设计非常棒"，只有 HMC1023 已实现的目录级链接；
    今日直取 OVI40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
    [ANS_bom_rows_PSDR261.csv]
2026-11-04 docs(delegation): 两份可直接粘贴的提示词——TASK_C 剩余 32 行重问、UHSDR/OVI40 前端调研
    - TASK_C：按 21 组器件列出 32 行，附件哈希与"CONTESTED 两值都算/前提不符就停下"的硬规则写进正文
    - UHSDR：只收可核事实（文件+commit+行号），HMC1023 寄存器序列/CALCK/VDDBG 接法为 P0；
    明确禁止对 PSDR 下结论、禁止把 403/429 写成撤档
2026-11-04 docs(index): 两份新提示词入索引；编年史里"提交数"改成现算口径不追数
    - 快照更新：3 个未推提交（回滚点 84f3790）、revB 工单仍未起稿、下一轮委派提示词已备好
2026-11-04 docs(chronicle): 未推条数改成现算命令，避免自我指涉的过期数字
2026-11-04 docs(history): 上游十年帖全量重拉入仓 + Documentation/ 六份材料档案 + 全史普查提示词
2026-11-04 docs(ledger): K-16 收盘推送与两条自记（代理推送、提交标题撞车记档）
2026-11-04 feat(revB): 影响圈工具 + rev-B 工作单落档——数据说"局部"只在 U304 子图成立
    - tools/revB_zone_closure.py：按网络 1–2 跳闭包，参考网(GND/电源/扇出>12)不传播且被挡网逐条打印
    - 实测：三区并集 124 件 / 全板 391 ⇒ 圈外 267 件是"只动局部"的硬判据；U304 区一跳仅 6 件(约 8×8 mm)，
    DPDT 与 HMC1023 二跳铺满全板 ⇒ 工作单把顺序改成 G3 免改版子板先跑，改版排在 G1/G2 之后
    - 补齐控制线表：IMP_BRIDGE_SWITCH_A/B=U121.16/30→U24.3/7；FILTER_S0=U211.298.14、S1=…2；U30 pin6 无网络
    - 算术结论：S0/S1 仅 2 位 ⇒ 最多 4 档，6 段带通位数不够；段数与波段一律 p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
    [zone_DPDT_switches.csv, zone_HMC1023_lpf.csv, zone_U304_gain.csv]
2026-11-04 docs(delegation): 编年史网页的可粘贴提示词（附件带 sha256、诚实清单必做、三条禁区）
    - 内容骨架十节：首屏只许 391/278/1132 + 约100台 + 2014→2026；年表须覆盖 2014-2026 关键 23 个节点
    - 三条禁区写死：不放替代件/降本具体清单（只留 fork）、不冒充官方、不写无实测支撑的"修好了/更好"
    - 口径不许混：读得/算得/待测 分列，算得的轨压禁止画成仪表读数；引文保持英文原样含错拼
    - 外链白名单 + 隐私只用 GitHub 用户名；纯静态单文件、无 CDN、≤300KB、内联 SVG
    - 交付必须附自检脚本，按事实级报告通过/失败/跳过，不许用综合评分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
2026-11-04 docs(ledger): K-18 网页素材上 IMA psdr 文件夹 + 托管先不发布的结论
2026-11-04 docs(delegation): 执行方工作须知——只讲怎么干活，不含任务内容
    - S1复述/S2计划/S3施工/S4事实级报告四步，明令禁止综合评分
    - 取料核对字节与 sha、禁联网补料、英文原话保持错拼；读得/算得/待测三态分列
    - 禁区：替代件与降本不出现在交付物、不冒充官方、无实测不写效果、403/429 不写成撤档
    - 额度纪律：先出最小可用版、脚本批处理、断额度时交半成品并说清剩余
2026-11-04 feat(revB): 天线口闭包（四区 129/圈外 262）+ signalPath 逐态引脚矩阵
    - 工具加 --zone TAG:SEED 支持的额外区；天线口 19 件、一跳 12 件，判据改用 129/262
    - 新档 signalpath-pinmap：12 根控制线全链（符号→hal.c→GPIO→MCU 脚→网→落点）+ 7 态矩阵
    - 四条只读观察：态1落进发射分支、滤波 mux 恒 (1,0)、态3加电仍旁路(注释称 set to on)、态4/5/6 不写脚
    - MIXER_SWITCH_A/B 与 MIXER_POWER 在 hal.c 注释掉且网表无此网；5V_REG_ENABLE 符号名≠网名
    [zone_antenna_ports.csv]
2026-11-04 docs(ledger): K-20 网页执行方交付复盘——哈希失败属取回通道（原始 URL 逐字节一致）；提示词两处缺陷已定性
2026-11-04 docs(delegation): 网页提示词补交付后更正——附件外事实应标跳过、不做字节自证、123/262 与 129/262 的口径标注
2026-11-04 docs(status): 盘点 PCB/DRC 权威口径——参考板是 _pcb_spike_full、DRC 795 条见 .txt；三份早期产物标注勿引用
2026-11-04 docs(fab): 工艺与打样口径——4 层/100x65mm 可进 10x10 档，但最小线距 4.6 mil 与板边工艺会卡免费档
2026-11-04 docs(clock+fab): 叠层读出来是 FR4/1oz/0.9mm；G2 多一路原理图来源（10:1 指 BOM）；Si5338 Fvco/8 约束不撞但 VCO 2.84GHz 超规格
2026-11-04 docs(values): 全量三方扫描——全板值冲突只有那 11 个，无新增；打样配额纪律入档（学生两月两次，清零前不打）
    [value_threeway_sch_asc_bom.csv]
2026-11-04 docs(fab): 补打样配额纪律——学生每月两次/≤10x10/OSP或沉金，清零清单未完成前不打样
2026-11-04 docs(board): 过孔 419/465 的成因、丝印与铺铜答疑；VNA 拓扑成档；52 条 clearance 聚类成表
    [clearance_clusters.csv]
2026-11-04 docs(hmc1023): 32 脚逐脚对手册——VDDBG 是唯一供电缺口、Q 通道自环只用一半、VBG 悬空符合手册
2026-11-04 docs(revB): HMC1023 驱动可行性判定（VDDBG/CLK1/固件三缺口）；贴装与选材清单（290手贴/25热风/18机贴，两件买不到）
    [assembly_class.csv]
2026-11-05 docs(cost): 最小可验板 BOM 成本 49.32（2016 价，含数量），加 GPS 69.70；全板 72.54
2026-11-05 docs(cost): 拆解 $149 的构成（22uF/STM32/Si5338/SMA 占 43%），并给更裸一档 $103
2026-11-05 docs(cost): 分档采购——P 档约 $20 先验电源，M 档 $55-60 验开机，射频档等替代方案
2026-11-05 docs(defects): 缺陷登记册 22 条（除缺料）；VDDBG 飞线方案 + 检查表加四个一量判死点
2026-11-05 docs(outward): #20 补 fall-through 与四态矩阵、#19 补 VCO 2.84GHz/CLK1 未配置（各只发一次）
2026-11-05 docs(revB): 局部改动规划——VDDBG 拉铜 4.3mm、52 条线距成簇、固件六项规格（F-5 先与 Michael 协调）；换 L/C 值单列不计
2026-11-05 feat(fw): F-1 有界 I2C 等待 + F-2 signalPath 表化并修状态 1 落进发射分支；主机测试 7x12 全过、目标构建 0 error
    [main.c, signal_path_table.h]
2026-11-05 docs(switches): F-3/F-4 前置分析——DPDT 端口与 mux 通道图成档；缺物理脚位/编码顺序，固件不填猜值
2026-11-05 feat(hmc1023): 校准序列构建器 + 主机测试（含 Reg05h 15 位与倍频周期的坑）；驱动计划成档（无板阶段）
2026-11-05 docs(revB): VDDBG 拉铜难度评估（4.3mm/2 过孔）+ 实测只有 4 条线距低于 5 mil；首次打样最小改动集
2026-11-05 docs(revB): 改板作业单——VDDBG 并网+4.32mm 走线与障碍、4 处线距的 5 段端点坐标、改后四步验收
2026-11-05 fix(pcb): EARPHONE 1 号 GND 焊盘被圆角切角——中心内移 0.3mm、缩到 1.1x1.1，距弧 0.134mm
    [PSDR_2.6.1_pcb_spike_full.kicad_pcb]
2026-11-05 fix(pcb): VDDBG 并入 LPF_5V——U287.28/C292.1 改挂 71 号网，原两段铜随网改号，删重复网络表项
    [PSDR_2.6.1_pcb_spike_full.kicad_pcb]
2026-11-05 feat(pcb): 输出 revB 板（已并 VDDBG→LPF_5V、耳机 pad 内移），供 EDA 导入连线
    [PSDR_2.6.1_revB.kicad_pcb]
2026-11-05 docs(eda): 现场核验——并网 277 条、LPF_5V+155mil、铺铜 12/12、DRC 无缺失连接（6 条为孤岛铜）
2026-11-05 docs(eda): 孤岛铜影响判定——浮铜无电气功能，按用户意见保留；rev-B 再清
2026-11-07 chore(dist): SHA256SUMS 纳入 revB——新增 exact-committed 类型，--check 对在库文件哈希
    revB 是手工改板衍生物，生成器不产出它；清单若手补会被重跑覆盖，
    故在 write_manifest 里自动附行、verify 对该类型直接哈希在库文件。
2026-11-07 docs(revB): 工单 §7.3/§7.4 收口——U287 逐脚独立复核 + 三份 zone dossier
    U287：重取网表 33 端子 × 重抽手册 Table 6 逐脚一致；更正 18/19 属 I、
    30/31 属 Q 的通道归属笔误（物理接法不变：I 输出经 C293/C294 跨接 Q 输入）。
    dossier：三区各一份，六字段填满，pending 全标等哪个门；U30 pin6 空掷位复核确认。
2026-11-07 docs(sop): KiCad→eprj3 转换线成文——两 bug 修法、导入路径、加载判活与交付件清单
2026-11-07 docs(delegation): 转换器重写/探明外包提示词——P0 加载卡死诊断、P1 两 bug 源码修、P2 架构、P3 备 PR；附 brief 打包版
2026-11-07 docs(delegation): 锚点微修——convert-kicad.js @1020 函数名 normNet 更正为 netOf（两份提示词同步）
