fe1iscurc0r/PSDR/(notices)

Notices in the files:
delegation/answers/ANS_开源SDR硬件调研_PSDR261对照.md:
OVI40 | [amateurfunk-sulingen OVI40](https://www.amateurfunk-sulingen.de/wiki/doku.php?id=en:ovi40what:description)（UI 板 CERN OHL 1.2） | DDC/DUC 目标、2200m–2m、50W
